Sylphiette666/stm32-rfid-smart-bin/README.md

# STM32与RFID积分式智能移动垃圾桶

嵌入式与RFID双课设的设计和实施资料。当前制作路线为**A1：单台低成本、复用已购模块和直插件，100×100mm裸PCB自行焊接**。主控为STM32F103C8T6，MCP23017成品扩展模块继续外置；一块PCB替代原PWR与IO两块洞洞板，模块按信号名接线。

## 从这里开始

1. [下载图解增强版Word手册](docs/manual/STM32%E4%B8%8ERFID%E6%99%BA%E8%83%BD%E7%A7%BB%E5%8A%A8%E5%9E%83%E5%9C%BE%E6%A1%B6_%E9%80%90%E6%AD%A5%E7%BB%84%E8%A3%85%E4%B8%8E%E8%B0%83%E8%AF%95%E5%AE%9E%E6%96%BD%E6%89%8B%E5%86%8C_%E5%9B%BE%E8%A7%A3%E5%A2%9E%E5%BC%BA%E7%89%88.docx)：保留330个步骤、33项功能；第62章为木板/PVC裁剪图，第63章和图45—49为当前A1 PCB、板外供电、模块接口及条件适配补充。第64章新增四套技能审查结论与接地加强后的调试要求。SG90与历史洞洞板图仍保留。[原版手册](docs/manual/STM32%E4%B8%8ERFID%E6%99%BA%E8%83%BD%E7%A7%BB%E5%8A%A8%E5%9E%83%E5%9C%BE%E6%A1%B6_%E9%80%90%E6%AD%A5%E7%BB%84%E8%A3%85%E4%B8%8E%E8%B0%83%E8%AF%95%E5%AE%9E%E6%96%BD%E6%89%8B%E5%86%8C.docx)保留。
2. [在线阅读全部步骤](docs/manual/ASSEMBLY.md)：按顺序检查、装配和调试，原330步不重编；图解以同名Word最新版为准。
3. [查看当前A1 PCB资料](hardware/current-low-cost/pcb-a/README.md)、[接线说明](hardware/current-low-cost/WIRING.md)、[逐针接口表](hardware/current-low-cost/pcb-a/connector-map.csv)、[BOM](hardware/current-low-cost/pcb-a/manufacturing/bom.csv)和[33项功能验收清单](docs/ACCEPTANCE.md)。裸板制造文件为[Gerber_RS274X.zip](hardware/current-low-cost/pcb-a/manufacturing/Gerber_RS274X.zip)，原理图及工程在[kicad目录](hardware/current-low-cost/pcb-a/kicad/)。
4. [查看SG90等图解与说明](docs/manual/illustrated-additions-20261010/)和[木板与PVC裁剪图解](docs/manual/cutting-diagrams-20261010/)；[旧PWR/IO洞洞板正反面与逐根焊线表](hardware/current-low-cost/perfboard/)仅作归档参考，不再作为A1 PCB施工接口。
5. [打开A1固件与调试说明](firmware/a1/README.md)：开发环境已确定为Keil，编译、下载及调试均在Keil完成，无需安装CubeMX、CubeIDE或CubeProgrammer。已提供工程和烧录文件；先按[实验室集中检查清单](firmware/a1/LAB_CHECKLIST.md)核对硬件，再逐模块上电调试。Word中旧软件路线以此说明和在线手册第37章为准。
6. 当前1号P2S继续昨天第二盘的上平台、舵机支架和喇叭圈。其余四台使用[底座带模块标牌版](hardware/mechanical/print-backup/labeled-bases-20261101/README.md)：两片底板仍可沿用，4/5号两盘精细附件更新为带标牌版，约5小时17分/5小时34分；新增任务同时开打约5小时34分完成，共387g PLA。11个待打印底座加名称，上盖和活动件保持；同名Word66.9节及图解63为当前说明。已切片，未实物试装。

本次接地加强版新增55个GND过孔，不增加元件采购或手焊任务；裸板制造检查通过，仍保留EMC及实物验证边界。详见[四套技能联合审查报告](hardware/current-low-cost/pcb-a/review/four-skills/四套技能联合审查报告.md)。

## 目录

[查看成品外观概念图](docs/appearance/README.md)（合盖与开盖两种状态，非实物照片）。

| 目录 | 内容 |
| --- | --- |
| `docs/manual/` | 原版及最新同名图解增强版Word、330步阅读版、内容源与图解生成源 |
| `docs/manual/illustrated-additions-20261010/` | 本轮SG90等新增图解及整合说明 |
| `docs/manual/cutting-diagrams-20261010/` | 木板/PVC五幅裁剪图、图源、孔位说明及检查记录 |
| `docs/planning/` | 功能成本选型、33项功能机械设计及功能数据 |
| `docs/appearance/` | 成品外观概念图及生成说明 |
| `hardware/mechanical/print-backup/` | PLA整片轻量模型、原5mm厚板备选、P2S打印方向、STEP源和几何检查 |
| `hardware/current-low-cost/` | 当前A1方案的边界、接线说明与归档入口 |
| `hardware/current-low-cost/pcb-a/` | 100×100mm裸PCB、原理图、制造Gerber、BOM和逐针接口表 |
| `hardware/current-low-cost/perfboard/` | 归档：原PWR与IO两块洞洞板正反面、孔位、逐根焊线表及外接说明 |
| `hardware/archive/pcb-v2.1/` | 旧PCF8574方案的嘉立创工程、KiCad、Gerber、BOM和贴片坐标 |
| `firmware/a1/` | A1应用固件、Keil工程、四组主机C测试、发布文件和集中调试说明 |
| `firmware/legacy/` | 保留的STM32/CMSIS基础文件 |
| `archive/` | 较早手册、采购表及折叠内胆参考图 |

## 当前状态与版本边界

- 已整理设计、采购、装配、接线、软件实施步骤和验收方法；文档步骤不代表已完成实物验证。
- 2026-10-13已实现A1应用固件，并通过编译与主机模拟测试；**没有完成实物烧录、标定和整机验收**。默认关闭电机/舵机动作，硬件型号与极性须确认；使用方式见`firmware/a1/README.md`。
- A1继续使用MCP23017成品模块与原MCU功能映射，复用已购器件；AO3400A裸管仍须焊转接板。新PCB只有JP3—JP10共8组跳帽，没有JP1/JP2。旧洞洞板接口及PCF8574 V2.1 PCB均不能混用。
- 当前电气制作基线为2026年10月12日A1 PCB补充；原330步的功能、机械装配和验收顺序保留。PCB的设计检查及制造文件不等于实物焊接、通电或33项功能验收已完成。
- 仓库内没有上传账户凭据、订单截图、渲染缓存、临时锁文件或工具依赖目录。

## 更新方式

后续每次增加图解，都加入同名图解增强版Word，更新目录并渲染检查排版，再替换本地与仓库中的同名版本；同步相关接线说明、图片和校验清单后，提交并推送到本仓库。原330个步骤保持编号。实测记录请写日期、硬件版本、固件提交号、测试条件和结果；未完成检查或实测的项目不能写成已完成。

初始归档日期：2026-10-10。文件校验值见[MANIFEST.sha256](MANIFEST.sha256)。第三方资料说明见[THIRD_PARTY.md](THIRD_PARTY.md)。
