Sylphiette666/stm32-rfid-smart-bin/hardware/current-low-cost/pcb-a/electrical-design.md

# SmartBin 方案 A：低成本直插 PCB 电气设计规范

版本：2026-10-12 A1。用户选择裸 PCB、复用已购直插件、自行焊接。本文仅定义电气连接和装配条件；原理图、PCB 的 ERC/DRC、制造文件和实物通电验收由相应阶段记录，不以本说明代替。

## 1. 架构与交付边界

将原 PWR、IO 两块 7×9 cm 独立焊盘板合并为一块目标 100×100 mm、双层、1.6 mm、1 oz 铜板。保留当前 MCP23017 成品扩展模块方案的全部 33 项功能和 29 个 STM32 GPIO 分配。不是历史 PCF8574 V2.1 PCB 的修改版。

板上保留原 44 件电气器件：32 电阻、8 电容、3 只 2N3904、1 只 SN74AHCT125N；增加 MODE、BACK、编码器 SW、蜂鸣复位偏置所需的 5 个 10 kΩ 焊位。R36/R37 互斥，最多新增实装 4 只电阻。共有 49 个电气焊位、33 组外接接口（6 组电源端子、27 组信号排针）、8 组选择/测试排针、4 个 M3 安装孔，共 94 个位号。它们都是板端自定义接口，不是任何商品模块的直插插座。

AHCT 第 3 通道改为输入永久接 PB9、使能永久接地，JP3 选择直驱 PB9 或 5 V 缓冲输出；原洞洞板的五拆六增不适用于本新 PCB。第 4 通道仍按输入接地、使能接 5 V、输出悬空处理。JP1/JP2 位号保留空缺，避免后续接口重编号。

核心板、MCP23017、RC522、FLASH、MPU6050、OLED、TB6612、DC/DC、3.3 V 稳压模块、HC05、DFPlayer、各传感器仍外置。AO3400A 是已购裸管，须先焊到转接板、核对 G/S/D 并检查无连锡，再经 J28 接入；已采购不表示已焊接完成。条件 5 V 数字输入适配和 DHT 的 BSS138 成品转换模块仍外置，不扩大本板为新的模块集成设计。

100×100 mm 是可行的布局目标：省掉两板之间的排线，较大的 5 V 数字适配电路不在本板。仍须在布局中验证 12.5 mm 电解外廓、端子操作空间、排针标签、安装孔和走线；未完成布局检查前不把板框目标写成已完成制造尺寸。

## 2. 电源、线径与电流边界

电源树：带保护 2S 18650 电池组 → 板外 5×20 保险座（3 A 初选）→ 板外总开关 → J1 BAT_SW → J2 外置降压输入；降压输出调到 5.00 V 后由 J3 回板，分别直接分到 J4 MOTOR、J5 SERVO、J6 LOGIC。J4/J5/J6 的正极同属 5V_BUS，物理上分支，不通过别的负载接口串供。地共用，但电机和舵机的大电流回流不能串经核心或信号地线。

1. 电池满电 8.4 V；正常控制在低电阈值以上使用，≤7.0 V 持续 3 s 提醒，≤6.6 V 持续 1 s 锁停，≤6.0 V 在当前有效 ADC 采样确认后立即停。恢复到 ≥7.0 V、人工确认并收到新命令才可运动。
2. 电池组持续能力至少 5 A；5 V 降压须在实际 6.6–8.4 V 输入、实际散热条件下达到 3 A 持续、至少 4 A 短时峰值。不能把广告峰值当持续能力。
3. 两只电机在 5 V 下各自堵转电流必须 ≤1 A，合计预算 2 A；SG90 瞬态预算 2 A。电机运动与开盖动作分时互锁，不能把双轮堵转和舵机卡死作为正常并发工况。逻辑、红外、照明及受控音量语音总预算 0.5 A（5 V 等效）。最重正常模式约 2.5 A，留 20% 裕量得到 3 A。若实测逻辑/音频超过预算，降低音量、限制并发或升级电源，不能只加电容。
4. 外置 3.3 V 模块按原清单至少 200 mA，但这是最低选型值而非全系统已验证值。按实物模块逐项量电流，含 ≥20% 余量必须小于其可持续能力；不够时用合格的 ≥300 mA 模块。3V3_EXT 只供外设和相应上拉，3V3_CORE 是核心自身稳压输出，只作核心参考及规定的上拉。两者不能直接并联。
5. 电池、降压主线用 20 AWG 短线；电机、舵机支路 22 AWG 短线，较长或压降偏大时用 20 AWG。电池/降压主干、电机 VM 与电机输出、舵机电源和地、喇叭电流均不能走普通杜邦线。DFPlayer 电源从 J6 用适当线径独立引出，J31 只走信号。
6. 电路板主干初始约束 3 mm、支路 2 mm 铜宽由布局设计实现，并须校核整条电流路径、过孔、热焊盘及铜厚；不要把走线宽度单一数值当无限流额定值。端子电流能力、焊接孔与接触质量同时限制能力。

J7 是外置 3.3 V 稳压模块的低电流接口：1=5V_BUS 输入给模块，2=GND，3=模块 3.3 V 输出回板。J8 的核心 5 V 从本板获得。完整装配正常使用禁止插核心 USB；若要做独立 USB 台架，先断本板电源并移除核心与本板相连的全部线束。USB 转串口仅接 J18 的 GND/RX/TX，不接转换器供电脚。SWD 直接接核心 PA13/PA14/GND；仅当调试器明确有独立 VTref 输入时按说明接核心 3V3，不并接调试器的电源输出。

## 3. 保护、默认状态和已知边界

### 3.1 三管急停

Q1/Q2/Q3 均按 2N3904 的 1=E、2=B、3=C 定义。两 NC 接点上端取总开关后的 VBAT_SW，各自通过 4.7 kΩ 驱动 Q1、Q3 基极，下拉均 100 kΩ。6.0 V 时接点闭合电流估计 (6.0−0.7)/4.7k≈1.13 mA，8.4 V 时约 1.64 mA；应核实所购接点的最小适用负载确实覆盖该电压、电流，不能把所有工业急停按钮都视为适用微电流。

正常 NC1 闭合，Q1 导通拉低 KILL_BASE，使 Q2 截止；PB5 经 R21=1 kΩ 驱动 STBY_OUT，R23=10 kΩ 下拉，理想未计驱动输入负载时 STBY≈3.0 V。按下急停或 NC1 断线后，Q1 截止，R19 从 3V3_EXT 给 Q2 基极偏置，Q2 拉低 STBY。PB13 则由 Q3 和独立 NC2 检测：正常低、按下或断线高，PB13 只上拉到 3V3_CORE。

必须保留 R21 限流和 PB5/STBY 的各自 10 kΩ 下拉，禁止另跨线 PB5→STBY。硬件验收包括强制 PB5 为高同时保持急停按下，STBY_OUT 仍小于 0.3 V；正常释放且 PB5=1 时大于 2.7 V；PB5=0 时小于 0.3 V。先架空电机进行，急停释放不得自动重启。

这套复用三管电路的 Q2 偏置依赖 3V3_EXT。若 EXT 失电、核心却仍有电并继续输出高，不能宣称具有完整的电源故障失效安全；驱动逻辑端也存在反向供电风险。正常整机供电必须同启同停，EXT 未建立或丢失时不得驱动外设信号高，整机异常使用总开关切电。本板保留现有课设接口的边界，没有把它描述成认证工业安全回路。

### 3.2 ADC、ECHO、电平与复位

电池 ADC：R1=33 kΩ、R2=10 kΩ（均1%）、C7=100 nF；BAT_ADC_DIV 经 JP9 接 PA1。8.4 V 对应约 1.953 V，输入等效电阻约 7.67 kΩ，C7 形成约 0.77 ms 时间常数。使用较长 ADC 采样时间并按实际 Vref 校准。若电池仍接通而要单独关闭/拔掉核心电源，先拔 JP9，避免从 ADC 向掉电核心注入；本电路不保证任意上电时序下完全无注入。

HC-SR04：U1 通道 2 将 PB15 TRIG 转为 5 V；ECHO_RAW 经 R25=12 kΩ 上臂、R26=20 kΩ 下臂到 PB1，5.00 V 输入约 3.125 V。PB1 不是原始 5 V ECHO，不能另跨线直连。建议两只均用 1%；5.15 V 电源且1%极端分压误差时约3.243 V，应结合实际核心VDD核查。

MCP RESET 经 R10 拉到 3V3_EXT，JP10 短接地用于临时复位，正常开路，不与核心 NRST 相连。MCU 每次启动都重新初始化 MCP 寄存器。MCP23017 当前数据手册规定 GPA7/GPB7 仅输出，本板不引出这两脚，软件设输出低。其他脚复位默认输入；启动期间 PB5 下拉和 STBY 下拉保持电机禁用，先写输出锁存器再配置方向，最后才允许运动。

## 4. 接口适配与跳帽规则

每个三针选择端子只能放一只跳帽，禁止同时短 1–2 和 2–3。初次通电先不接模块，测中心脚电压再连线。标签中的 5V_BUS 与3V3_EXT 是不同供电网；连接模块时按功能逐线对应，不能按某张商品照片直接整排套接。

| 位置 | 默认/条件 | 规则 |
|---|---|---|
| JP3 蜂鸣信号 | 默认开 | 模块兼容3.3V控制用1–2，确需5V控制用2–3；U1通道3同相，不改变有效极性。 |
| JP4 蜂鸣供电 | 默认开 | 1–2为3V3_EXT；2–3为5V_BUS，按模块额定电源。 |
| JP5 MPU供电 | 默认开 | 1–2为3V3，2–3为5V。模块VIN带稳压时可能要5V，但I2C仍必须3.3V。 |
| JP6 HC05供电 | 默认开 | 带稳压底板与裸模块不同；串口逻辑必须3.3V。 |
| JP7 DHT供电 | 默认开 | 1–2为3.3V，2–3为5V。 |
| JP8 DHT直连 | 默认开 | 仅3.3V且DATA安全分支闭合；5V分支始终开并装J23外置BSS138。 |
| JP9 ADC连接 | 默认闭合 | 正常使用闭合；核心单独断电前拔开。 |
| JP10 MCP复位 | 默认开 | 只作临时复位短接，不能长期留帽。 |

R36 默认安装为 PB9 的10 kΩ 下拉，R37 默认不装。高有效蜂鸣保留此配置；低有效蜂鸣先拆 R36 再装 R37，拉到 3V3_CORE。即便不接蜂鸣模块，也保留其中一只偏置，防 AHCT 的第3通道输入浮空。裸两脚蜂鸣器不能直接接 J30 当成带驱动三线模块。

### 4.1 I2C、SPI与编码器

I2C 同时连 MCP、OLED、MPU；地址必须实际扫描，MCP模块A0/A1/A2接地预期0x20。R8/R9为可选4.7 kΩ上拉位，默认 DNP 不代表允许总线无上拉：若所有模块均无上拉，必须装；若模块已有上拉，要核算并联等效值、总线电容和上升时间。任何上拉只到3V3_EXT，不得保留5V上拉。起步100 kHz。MPU侧INT等未使用脚按实际模块资料处理。

RC522与FLASH共享PA5/PA6/PA7，PA4与PA15分别片选，并各有10 kΩ上拉。RC522的SDA丝印在SPI工作模式表示CS；不能接PB7。FLASH的WP/HOLD仅在实际外露且缺少同轨上拉时装R13/R14。核选中/未选中时MISO释放；有始终驱动MISO的模块不能直接共总线。SPI线先控制在20 cm以内并从低速调通。所有这些模块均按确认的3.3V版本使用。

编码器CLK/DT有两种互斥配置：移除模块原上拉后安装R27/R28拉CORE；或保留模块已确认拉EXT的上拉、R27/R28 DNP。不得让同一信号同时由两个稳压轨的电阻上拉。SW由R33或模块同轨上拉/已验证MCP内部上拉提供确定高电平。MODE/BACK默认装R34/R35，各接地按下，均低有效。碰撞用两NC串联；闭盖用NO接点，只占其规定GPIO。

### 4.2 六路红外、DF BUSY和光敏

J33 的六路数字输入分别为循迹左/中/右、靠近、前方障碍、投放对射。接口没有板载5V容限转换。允许的三种情况：

1. 已验证0/3.3V推挽输出：直接接目标输入和共地。
2. 无任何5V上拉的开集/开漏：外加10 kΩ到3V3_EXT，接目标输入。
3. 5V推挽或板内已有5V上拉：外置适配，DO→10 kΩ→2N3904 B，B→100 kΩ→GND，E→GND，C→目标输入，C→10 kΩ→3V3_EXT。输出反相，软件标定有效电平必须同步。每个不满足电平的通道各自适配，不能把多个DO相互并接。

DFPlayer BUSY接MCP GPA6，也要按相同原则测量和适配。已有单路寻迹模块只能作备用或逐个台架验证，不能与成品三路DO并接。光敏默认用3.3V模拟AO接PB0；若采用5V AO，须另行设计与校准模拟分压，不能套NPN开关电路。热敏模块仅作为断开光敏后的替换实验，不额外并占PB0。

### 4.3 DHT、LED与声频

DHT3.3V直接分支：JP7=1–2、JP8闭合；PB11开漏，R29或模块已有同轨上拉有效。DHT5V分支：JP7=2–3、JP8开路，J23分别连BSS138的LV=EXT、HV=5V、GND、低压通道=PB11、高压通道=DHT_DATA_RAW。不能用单向NPN替代双向DHT数据线，也不能把5V DATA经跳帽直接接PB11。

LED支路：MCP GPA5→R3=100Ω→J28.G，R4=100kΩ将栅极拉地；J28.S接GND，J28.D接LED_NEG；5V→R5=220Ω→LED正极，LED负极→LED_NEG。按AO3400A实际G/S/D追踪转接板，不按其排针外观猜；仅驱动单颗小功率白LED，不接电机或舵机。

DFPlayer RX由PB10经R30=1kΩ输入，模块TX不接；PB11已用于DHT，固件USART3只开TX。DFPlayer的SPK1/SPK2直接接扬声器，不接地。模块旁仍需100μF+100nF本地去耦；MCP模块旁确认100nF；两只电机两端分别确认100nF抑制电容。这些远端就地件没有因为PCB已有电容而取消。

## 5. 封装与采购复用

所有R用已购1/4W轴向件，板上10.16 mm脚距，目标本体不大于6.3×2.5 mm；R1/R2/R25/R26用1%。Q1–Q3按onsemi当前资料的1E2B3C逻辑匹配TO-92宽脚距封装；其它品牌2N3904仍必须核对脚序，不能按“平面对自己”的口诀替代数据手册。

U1是SN74AHCT125N及7.62 mm DIP14座，不用74HC125。电解统一预留最大直径12.5 mm和5 mm脚距；实物脚距不符可短绝缘飞线并独立机械固定，不能让电容悬挂摇晃。5个100nF位采用径向瓷片5 mm脚距，实际弯脚不得损伤根部。

六组端子为2P、5.08 mm，目标外壳包络11.5×10.5 mm；采用可用的Phoenix同脚距库封装是几何模板，不承诺所有KF301外壳/引脚都一致。根布局需核实际孔径、脚型与外壳，端子朝板外留接线和螺丝刀空间。27组信号排针加8组跳帽排针共169针，可按长度裁切已有2.54 mm排针，留备品；杜邦线按每根功能标签接。8组选择/测试排针不等于全部装8只帽，JP10正常不留帽。

4个M3孔直径3.2 mm，中心(5,5)、(95,5)、(5,95)、(95,95)，以100×100 mm板左上为布局基准。安装柱和螺钉与铜箔保持净距，板底有绝缘与足够间隙。

## 6. 装配与分段验收

1. 不插U1、不接模块；按位号装固定电阻、二极性无关的小电容、芯片座、三极管、端子排针，最后装较高电解。逐只确认值、极性、脚序和DNP。
2. 万用表查5V/GND、VBAT/GND、EXT/GND无持续短路；CORE/EXT无直接导通；电解充电瞬间提示与持续短路区分。检查JP3–JP8当前开路、JP9闭合、JP10开路；R36装、R37空。
3. 外置降压离板调5.00V，限流接J3，先只看板上静态电流和各电源口。连接3.3V模块确认EXT在3.20–3.40V且无异常升温。
4. 插U1前核座14脚5V、7脚地。插芯片后用3.3V逻辑信号逐路检查U1输入/输出：PA0与PB15低/高转换，PB9复位偏置确定；输出不得被错误跳帽接回别的输出。
5. 核心从教学底板拆下；按照J8/J9表逐线连。完整系统核心USB禁用，仅SWD及J18三线串口调试。先固件将PB5/PWM置低，再初始化MCP输出锁存器和方向。MCP位7明确输出0，不当输入。
6. 按模块数据实测供电、DO高电平、上拉和接口脚名；完成DNP/跳帽记录后一次接一个模块。所有输入上拉、电平转换和复位元件未满足时，不因PCB有插座就通电插上。
7. 分别在6.0、7.4、8.4V电池偏置条件测双NC和PB13；强制PB5高并按急停，STBY<0.3V；正常释放PB5高时STBY>2.7V；断NC1、断NC2分别记录。急停释放后软件不得恢复旧命令。
8. 从台架5V信号经ECHO端验证PB1≈3.125V；从8.4V验证PA1≈1.95V；只给电池不断核心供电的操作前先拔JP9。未经测量不能将这些计算值写成实测。
9. 先架空单轮低PWM验证两电机方向、停机、两NC碰撞、失联和倾斜；舵机拆杆空载50Hz/1500μs定位，确认独立供电。最后才上连杆、放地。电机和舵机动作互锁。
10. 按原330步骤功能测试表逐项验证，记录最低5V、各负载电流、温升、复位/误积分、无线超时与故障恢复。3V3掉电的边界不能只靠正常急停测试就宣布消失。

## 7. 冻结数据使用方式

`circuit.json` 的 `parts` 包括所有电气件、连接器、跳帽和机械孔；`pins` 是唯一用于绘图的编号→网络映射，未接的U1.11为null；机械孔pins为空。`pin_names`用于丝印/说明，可显示PB6而实际网络为I2C_SCL；不能据文字标签重新产生孤立PB6网。`original_ref`保留旧PWR/IO电气件对应关系。所有PCB位号唯一。

`connector-map.csv`按板端自定义针号列出目标模块信号。原理图和PCB应从同一份JSON生成并比较网络；不允许一边仍是旧44件位号、另一边拿新的R序号按记忆连线。DNP是装配选择，不代表删除铜连接；互斥选项必须在采购/装配记录中明确。

下表是当前电气件清单（含可选焊位）；芯片座、跳帽、外置模块、保险和线材另计。

| 类别/值 | 焊位数 | 位号 |
|---|---:|---|
| electrolytic / 470uF/16V | 1 | C1 |
| electrolytic / 1000uF/16V | 1 | C2 |
| electrolytic / 100uF/16V | 1 | C3 |
| capacitor / 100nF | 5 | C4, C5, C6, C7, C8 |
| resistor / 33k | 1 | R1 |
| resistor / 10k | 20 | R2, R6, R7, R10, R11, R12, R13, R14, R22, R23, R24, R27, R28, R31, R32, R33, R34, R35, R36, R37 |
| resistor / 100 | 1 | R3 |
| resistor / 100k | 4 | R4, R16, R18, R20 |
| resistor / 220 | 1 | R5 |
| logic / SN74AHCT125N | 1 | U1 |
| resistor / 4.7k | 6 | R8, R9, R15, R17, R19, R29 |
| resistor / 1k | 2 | R21, R30 |
| resistor / 12k | 1 | R25 |
| resistor / 20k | 1 | R26 |
| npn / 2N3904 | 3 | Q1, Q2, Q3 |

默认DNP：R8, R9, R13, R14, R27, R28, R29, R33, R37。这些位置须按上文条件决定安装；特别是I2C、DHT不能省掉所需有效上拉。

## 8. MCU功能映射

| GPIO | 功能 | 资源/约束 |
|---|---|---|
| PA0 | 舵机PWM | TIM2_CH1；AHCT通道1 |
| PA1 | 电池电压 | ADC1_IN1；JP9可隔离 |
| PA2 | 蓝牙TX | USART2 TX→HC05 RX |
| PA3 | 蓝牙RX | USART2 RX←HC05 TX |
| PA4 | RC522片选 | SPI1 CS，模块SDA即CS |
| PA5 | 共享SCK | SPI1 SCK |
| PA6 | 共享MISO | SPI1 MISO |
| PA7 | 共享MOSI | SPI1 MOSI |
| PA8 | 左电机PWM | TIM1_CH1，20kHz |
| PA9 | 调试串口TX | USART1 TX→转换器RXD |
| PA10 | 调试串口RX | USART1 RX←转换器TXD |
| PA11 | 右电机PWM | TIM1_CH4，20kHz；禁USB |
| PA12 | 投放光束输入 | 1ms轮询；不可用EXTI12；禁USB并核核心板USB上拉 |
| PA15 | FLASH片选 | 禁JTAG保留SWD后作GPIO |
| PB0 | 光敏AO/DO | ADC1_IN8或数字输入二选一 |
| PB1 | 超声ECHO | EXTI1双边沿，12k/20k分压后 |
| PB3 | 编码器CLK | 禁JTAG保留SWD；轮询/EXTI3 |
| PB4 | 编码器DT | 禁JTAG保留SWD；轮询/EXTI4 |
| PB5 | 电机使能请求 | 经R21和Q2门控；不能直连STBY |
| PB6 | I2C SCL | I2C1默认映射、开漏 |
| PB7 | I2C SDA | I2C1默认映射、开漏 |
| PB8 | 前方避障 | 外置条件电平适配 |
| PB9 | 蜂鸣器 | GPIO/TIM4_CH4，按模块不响电平偏置 |
| PB10 | 语音TX | USART3 TX，经1k；禁USART3 RX |
| PB11 | DHT数据 | 开漏+EXT上拉；EXTI11可用 |
| PB12 | 碰撞回路 | EXTI12，两NC串联，正常低 |
| PB13 | 急停反馈 | EXTI13，正常低，按下/断线高 |
| PB14 | 闭盖反馈 | NO微动，闭盖低 |
| PB15 | 超声TRIG | 普通GPIO→AHCT通道2 |

PA13/PA14保留SWD，PB2保留BOOT1，PC13/PC14/PC15及NRST不新分配；PA15/PB3/PB4需关闭JTAG并保留SWD。TIM1两通道同频电机PWM，TIM2_CH1独立50Hz舵机；TIM4_CH4用于无源模块蜂鸣时，不占I2C所用PB6/PB7。PA12采用轮询，EXTI12仅PB12。

## 9. 功能覆盖与证据

- A1：RC522/STM32 UID识别。
- A2：RC522+FLASH 注册/删除/挂失。
- A3：RC522+对射+FLASH有效投放积分。
- A4：FLASH持久化。
- A5：RC522+OLED积分查询。
- A6：RC522 RFID读写实验。
- A7：管理员卡+菜单。
- A8：FLASH日志/排名+串口导出。
- A9：FLASH虚拟兑换。
- B1：RC522+SG90刷卡开盖。
- B2：对射投放检测。
- B3：对射+状态机防重复积分。
- B4：靠近红外+SG90便民开盖。
- B5：HC-SR04满桶检测。
- B8：菜单维护清理模式。
- C1：TB6612+双减速电机差速。
- C2：前红外避障。
- C3：三路循迹。
- C4：循迹站点识别。
- C6：HC05蓝牙手动。
- C8：MPU6050倾斜保护。
- C9：双NC碰撞停车。
- D1：OLED人机显示。
- D2：蜂鸣器提醒。
- D3：MODE/BACK按键。
- D4：编码器旋转/按下。
- D5：双NC急停。
- D6：上电自检。
- D7：ADC电量监测。
- D8：USB串口日志/配置。
- E1：DHT温湿度。
- E2：光敏+LED自动照明。
- E4：DFPlayer语音。

上述为功能所需硬件覆盖，不表示固件已经实现。记录基于当前WIRING、原两板layout.json和330步骤ASSEMBLY；已有44件保留、29IO分配、33功能、唯一位号、位7不引出和I2C别名连通已作结构检查。封装适配、ERC、PCB DRC、制造性、实物及软件测试分别记录，不相互代替。

- 当前低成本 WIRING.md：D:\Work\嵌入式课设\stm32-rfid-smart-bin\hardware\current-low-cost\WIRING.md
- 原两板结构化布局：D:\Work\嵌入式课设\stm32-rfid-smart-bin\hardware\current-low-cost\perfboard\layout.json
- 330步骤手册源：D:\Work\嵌入式课设\stm32-rfid-smart-bin\docs\manual\ASSEMBLY.md
- TI SN74AHCT125 datasheet：https://www.ti.com/lit/ds/symlink/sn74ahct125.pdf
- onsemi 2N3904 Rev3 / TO92 1E2B3C：https://www.onsemi.com/pdf/datasheet/2n3904-d.pdf
- Microchip MCP23017 DS20001952D（GPA7/GPB7仅输出）：https://ww1.microchip.com/downloads/aemDocuments/documents/APID/ProductDocuments/DataSheets/MCP23017-Data-Sheet-DS20001952.pdf
