Sylphiette666/stm32-rfid-smart-bin/hardware/current-low-cost/pcb-a/manufacturing/drill-report.txt

Drill report for SmartBin_A.kicad_pcb
Created on 2026-10-12T19:15:20

Copper Layer Stackup:
    =============================================================
    L1 :  F.Cu                      front
    L2 :  B.Cu                      back

Drill file 'SmartBin_A-PTH.drl' contains
    plated through holes:
    =============================================================
    T1  0.400mm  0.0157"  (117 holes))
    T2  0.800mm  0.0315"  (107 holes))
    T3  1.000mm  0.0394"  (169 holes))
    T4  1.200mm  0.0472"  (6 holes))
    T5  1.300mm  0.0512"  (12 holes))

    Total plated holes count 411

Drill file 'SmartBin_A-NPTH.drl' contains
    unplated through holes:
    =============================================================
    T1  3.200mm  0.1260"  (4 holes))

    Total unplated holes count 4
