Sylphiette666/stm32-rfid-smart-bin/hardware/mechanical/print-backup/mounted-20261031/checks/HARDWARE_REVIEW.md

# 新增模块固定件硬件清单

本表只计算本次新增模块夹具，不含原车架立柱、舵机及其余原装螺丝。螺钉长度均为头下长度，M3 使用普通粗牙 0.5mm 螺距。喇叭两耳的紧固方案仍需实物耳高确认。

所有M3螺钉均按ISO7380低圆头最大外径5.7mm、头高1.65mm审核，特别是9根铰链轴、22根座脚及2根降压载座螺钉，不可换成头高约3mm的圆柱头。铰链R3.4避空按此头型轴向长度设计，任意M3头型不保证能翻动。

| 规格 | 数量 | 用途 |
|---|---:|---|
| M3×6 | 4 | A1 PCB 上方固定到10mm绝缘双通柱 |
| M3×10 | 4 | 从底板下方固定 A1 绝缘柱 |
| M3×12，ISO7380低圆头，高1.65mm | 22 | 9个模块座18颗、电池座4颗 |
| M3×16，ISO7380低圆头，高1.65mm | 2 | 降压模块独立载座固定到底板 |
| M3×25 | 10 | M03/M04/M07/M08/M09，各1根拨片轴和1根簧片锚钉 |
| M3×30，ISO7380低圆头 | 13 | 9个铰链、M05轴和锚各1根、喇叭2根暂定 |
| M3×40 | 10 | M01/M02/M06、电池左锁和右锁，各轴和锚1根 |
| M2.5×8 | 2 | 5V降压模块两个真正安装孔，不加垫圈 |
| M3普通六角螺母，高2.4mm | 24 | 22个座脚、电池座脚；另2个喇叭耳下调高 |
| M3 DIN985锁紧螺母，高4mm | 35 | 9铰链、22轴/锚、2降压座、2喇叭耳上 |
| M2.5普通六角螺母，对边5mm、高2mm | 2 | 降压载座底部预埋六角窝 |
| M3平垫圈，内径3.2、外径≤6、厚约0.5mm | 124 | 配套数量，未计备用 |
| M3绝缘双通柱，柱身10mm | 4 | A1 PCB四个90×90mm孔距 |

名义合计67根螺钉，其中M3为65根；喇叭相关2根暂定。垫圈按座脚44、铰链18、轴/锚44、降压座4、A1上下8、喇叭6计算。使用0.55mm厚小垫圈时，轴/锚选定标准长度仍适用；M3×40最高轴组的余量较小，遇高于4mm的锁母应重新核算长度。

## 装配方向

- 22个座脚：低圆头在座脚上方，座脚厚2.4mm；头下1片垫圈，底板下1片垫圈和普通六角螺母。M3×12按普通高2.4mm螺母计算，不能直接换高4mm锁母。头高1.65加0.5垫圈，总凸出2.15mm，低座压框下名义仍留0.25mm。
- 降压载座两颗M3×16：低圆头在3.2mm载座上方，锁母在5mm底板下面。高圆柱头或把锁母放到载座上方会侵入PCB下方间隙。
- 11根拨片轴、11根簧片锚：头和一片垫圈在5mm底板下面，另一片垫圈和锁母在上方。轴顶部留约0.1–0.2mm转动间隙；簧片锚钉固定6×6mm方头，不能压住12mm自由弹臂。
- 簧片头上必须用外径不超过6mm的小垫圈。不要在拨片与轴座之间另加普通圆垫圈，它会盖住半径2.8mm处的定位凸点。
- 9根铰链：中央三节耳总跨23mm，两端各一片小垫圈，M3×30配锁母。只消除多余轴向窜动，保持压框自由翻动。盖已为螺头和锁母做R3.4包络避空。
- M2.5螺母先放入降压座底部六角窝，再把载座固定到底板。M2.5×8不加垫圈，名义有效吃牙约1.8–2mm；换10mm会顶到底板，不能强拧。
- A1柱下M3×10名义入柱4.5mm，柱上M3×6经1.6mm PCB和垫圈后入柱3.9mm。先确认所用双通柱两端孔深。

## 必须用实物核对的项目

数字检查使用ISO7380头Ø5.7×1.65、垫圈Ø6×0.5、锁母Ø6.4×4包络，结果见同目录 hardware_review.json；它不能替代实物试装。

1. 0.8mm角点压边是否碰到实际排针塑壳、焊点或元件；USB线尾、SWD插头、TF弹出行程、插好杜邦线后的弯线空间尚未量到。背针尖距底板的名义余量：MCU/MCP 11mm、DFPlayer 12mm、稳压模块5mm。
2. A1已知含正反面总高度28mm，但未给正反面高度分配；10mm绝缘柱是否让开全部底面焊脚仍需实物核对。
3. 喇叭耳下表面距底板顶面的高度记作E、耳厚记作t。选定垫圈和锁母下，M3×30须满足E+t≤19mm；先让耳下螺母刚好接触耳片，再锁上方，不能压弯耳片。若为垫下螺母而抬高壳体并脱离2mm高定位唇，应停止强装并测耳高。
4. 电池名义76×40×20，托槽77.2×41.2，2mm EVA后顶面距底板顶面24.4，拨片底面24.6，留0.2限位余量。拨片只挡硬塑壳端边，不能压电芯。实际外皮误差、EVA压缩和端边形状需试合。
5. 电池右端导线从中央12mm开口偏负Y半边引出；建议线束位于电池中心局部Y=-5..+1mm走廊，避开右拨片整个旋转范围。开关两拨片时全程不接触导线后再固定走线。

尚未完成实物打印、承重、振动或耐久试验。夹具几何及紧固件包络通过，只表示数字装配检查通过。

标准外形核对来源：[ISO7380 M3低圆头尺寸](https://www.accu.co.uk/socket-button-screws/8104-SSB-M3-12-A2)、[DIN985 M3锁母尺寸](https://www.accu.co.uk/hexagon-nylon-locking-nuts/495536-HNN-M3-0-5-C8-Z)、[ISO7092 M3小外径垫圈](https://www.accu.co.uk/metric-flat-washers/629061-HRDW-M3-6-0-A4-BL)。以上用于尺寸核对，不是购买或库存推荐。
