Sylphiette666/stm32-rfid-smart-bin/hardware/current-low-cost/pcb-a/review/schematic/REVIEW.md

# SmartBin A 原理图审查

日期：2026-10-12。工具：KiCad CLI 10.0.6；项目独立的 kicad-tool 扩展；固定版本 mash/kiutils 结构化对象。

## 交付内容

- 顶层索引与 5 个功能子页，共 6 页 A3 原理图。
- 94 个真实位号，包含 4 个机械孔及 DNP 条件电阻。多单元 U1 共 5 个符号实例、1 个物料位号。
- 自包含 `SmartBin_A.kicad_sym` 与相对路径 `sym-lib-table`；标准器件使用电阻、电容、BJT、缓冲门等实际符号。
- 每个元件的稳定层级 UUID 路径记录在 `schematic_paths.json`，供 PCB 关联。

## 电气一致性

- 原理图由 `circuit.json` 创建，但验证对象是 KiCad 实际导出的 XML 网表。
- 逐一比对 293 个连接引脚与 1 个明确 NC 引脚，通过；94 位号完整。
- U1.11 的显式 NC 在 XML 中仍有 KiCad 自动生成的独立 `unconnected-...` 网络，不应接任何走线。
- ERC：0 错误、0 警告。没有通过排除具体违规项来清零。
- ERC 原有默认忽略项记录在 JSON：单次全局标签、四向交点、SPICE 模型、封装过滤器。未把 ERC 当成器件参数验证、软件验证或实物验证。

## 图面检查

- 已逐页渲染并查看 PDF，放大核对 AHCT 门图形、型号与位号、连接器针号、电容极性、顶层页框标题。
- 调整了旋转电容/电阻的文字方向、AHCT 标题高度、顶层页框标题左对齐。
- 上游 `sch inspect` 在全部 6 页的文字冲突数均为 0，没有斜线。
- 自动评分仍报告 22 个 symbol-wire conflict（电源页 13、三极管页 3、AHCT 页 6）。这些是符号框估算将电容引脚端点、BJT 引脚、AHCT 多单元合并包围框计为交叠；已按实际渲染复核，并未为了评分移动/断开真实引脚连接。此项不作为 ERC 错误。
- 6 页采用同名全局网络连接；这些标签在整个工程内电气相连，不是仅作注释的文字。

## 边界

此审查覆盖原理图与输入连接表的一致性和图面。PCB 布线、铜厚载流、制造 Gerber、实际模块针序与上电测试仍由相应阶段独立验证。
