Sylphiette666/stm32-rfid-smart-bin/firmware/a1/LAB_CHECKLIST.md

# 集中借用万用表：A1固件调试记录

固件：A1-0.1.0。以下是待执行清单，空格必须由实物操作者填写；不能以软件模拟代替。

## 出发前

- [ ] 带电脑、整个固件目录、下载器、USB串口、可传数据USB线。
- [ ] 带焊好的A1板、所有外置模块、标好两端的线束、电源模块、电池、保险和开关。
- [ ] 带焊接返修工具、小螺丝刀、跳帽；打印/保存当前逐针表与本表。
- [ ] Keil打开`MDK/SmartBin_A1.uvprojx`并Rebuild成功；无需安装Cube系列工具。提前安装实际下载器驱动，按[说明](README.md#keil-下载与源码调试)设置Debug与Flash Download。
- [ ] 准备好串口终端，115200、8N1、换行。断点调试时保持DISARM并断开动力，CPU暂停不等于定时器停输出。
- [ ] 查清OLED控制器、FLASH丝印、晶振、每种模块电源和引脚资料。
- [ ] 第一次检查时电机、舵机功率支路保持断开。

## 第一次：电气和逻辑模块

断电：拔电池、所有USB及其他电源后测通断/电阻。带电只用直流电压档；红表笔应在VΩ孔，不能把电流档并接电源。

| 项目 | 记录 |
|---|---|
| VBAT/5V/3V3_EXT对地无持续短路；电容充电短响不等同短路 | ____ |
| CORE与EXT不直接短接，GND共地，线束逐针一致 | ____ |
| AO3400A转接板G/S/D、急停两组NC、碰撞与闭盖触点 | ____ |
| 降压离板调5.00V；J4/J5/J6对地；外围及核心3.3V | ____ |
| 串口TX空闲、I²C上拉、各数字输入适配后的电平 | ____ |
| 上电不动作；SWD能识别；STATUS/RAW有输出 | ____ |
| 空白FLASH初始化、管理员注册、重启后保留 | ____ |
| 每个传感器触发前后RAW值；修改config.h极性并重编译 | ____ |
| OLED显示、读卡、蓝牙文本、温湿度、光敏分别检查 | ____ |
| 电池万用表值与显示值、ADC比例校正 | ____ |
| 保存版本、照片、跳帽位置、测点读数 | ____ |

纯逻辑测试不需要ARM。逻辑电源单独供电且PA1未接有效电池分压时，低电故障是预期的，不能绕过低电互锁去跑电机。

## 两次之间

已验证且接线不变的逻辑模块可继续软件测试：注册、挂失、查询、兑换、串口导出、屏幕与蓝牙。第二次之前把机构安装到便于操作的位置，保持线束可检查。

需要改变焊点、供电、模块电平或跳帽时，先断电，回实验室复查受影响部分。不要把上次测量当成改线后的结果。

## 第二次：执行器与整机

借万用表及可调限流电源；有电子负载时一起验证降压持续带载能力。没有示波器时，电源瞬态和精确PWM时序保留“未实测”。

1. 断电复查装入外壳后的线路、焊接面、螺钉、绝缘。
2. 先读RAW，确认急停释放PB13=0、碰撞正常PB12=0、闭盖极性正确。
3. 已有管理员查询认证；清除可恢复故障。`ARM CONFIRM`只使能测试许可，不自动动作。
4. **拆舵机连杆**，`SERVO 1500`，每次±20 µs试探，再按机械步骤标定。记录安全闭盖/开盖脉宽，不先扫全范围。
5. `SET CLOSE 实测值`、`CONFIRM`，同理设置OPEN。SET会停止舵机脉冲；需要扶住盖。标定过程中LID_HELD可保存参数。
6. 平放MPU读取RAW，保存安装偏置；设置实测判满/清满距离、ADC比例。
7. 核实全部输入极性、舵机安全范围、供电后，`SET CALIBRATED 1`、`CONFIRM`。该标志是人工确认，未自动测量任何内容。
8. 架空轮子，盖闭合、超声正常、无故障，进入MANUAL；先用10%短测，再逐步标定。每100 ms发MOVE，停发后应在300 ms超时窗口停车。
9. 测试急停/碰撞/障碍/倾斜/遥控断连。恢复触发源后，CLEAR，不发新MOVE时仍应停止。
10. 校准最高PWM，使地面实测最高速度≤0.15 m/s；不从占空比推断实际速度。
11. 做刷卡投放：一次有效经过仅+1；持续挡光不结算、不强关；查询不动作；便捷模式不计分。
12. 保存账本、日志、电压、视频及未完成项。

| 实测参数 | 结果 |
|---|---|
| P_CLOSE / P_OPEN，µs | ____ / ____ |
| ADC_SCALE，千分比 | ____ |
| ROLL_ZERO / PITCH_ZERO，0.1度 | ____ / ____ |
| FULL / CLEAR，mm | ____ / ____ |
| LIGHT_ON / LIGHT_OFF，ADC原始值 | ____ / ____ |
| PWM上限 / 1m实测时间 | ____ / ____ |
| 电机动作5V / 舵机动作5V（万用表读数） | ____ / ____ |
| 瞬态波形 / PWM频率是否实测 | ____ |
| 最终固件散列 / 日期 | ____ / ____ |

不保证两次能解决所有接线或模块问题，另留一次返修机动时间。
