Sylphiette666/stm32-rfid-smart-bin/firmware/README.md

# 固件开发状态

2026-10-13已基于原STM32F103设备基础文件完成 [A1应用固件](a1/README.md)，含 [Keil工程](a1/MDK/SmartBin_A1.uvprojx)、模块驱动、积分事务/恢复、投放和运动状态机、菜单、串口及标定入口。

已实际进行编译、Keil Rebuild和四组主机C测试。源码、HEX/BIN/AXF和验证记录见 `a1/`；首次实物调试见 [实验室集中检查清单](a1/LAB_CHECKLIST.md)。**尚未烧录或验证用户实物，不能把代码完成等同于整机验收通过。**

本次交付使用已有Keil/Arm Compiler和CMSIS寄存器工程，而非手册原规划的CubeMX/HAL路线；引脚及硬件A1接口保持。软件使用方法、配置差异和已知限制以 [A1固件说明](a1/README.md)为准，物理接线仍按最新A1逐针表。旧PCF8574 V2.1引脚配置不能套用。

**开发工具确定为Keil。** 在Keil内完成编辑、编译、下载及源码调试，不要求安装CubeMX、CubeIDE或CubeProgrammer。VS Code可作为可选源码编辑器；当前已验证的工程入口是µVision，首次下载器设置见[A1固件说明](a1/README.md#keil-下载与源码调试)。

`legacy/`保留原基础文件；`a1/vendor/`保留编译所需CMSIS5子集和许可。工具运行依赖及构建缓存不提交。每次修改模块极性或硬件配置后重新编译并验证相应实物。
