Sylphiette666/stm32-rfid-smart-bin/docs/ACCEPTANCE.md

# 33项功能验收清单

以下为计划测试。请在完成真实操作后记录日期、固件版本、结果和证据。

| 编号/功能 | 最少执行步骤 | 通过判据/需保存的证据 |
| --- | --- | --- |
| A1 刷卡识别 | 有效、陌生、挂失各刷10次；连续贴卡10 s | 完整UID正确；持续卡只触发一次；串口日志 |
| A2 注册/注销/挂失 | 注册→重启→挂失→注销；容量满测试 | 状态持久且权限正确；操作前后导出表 |
| A3 投放加分 | 空会话、一次经过、一次会话多次晃动 | 仅有效会话+1；DEPOSIT日志 |
| A4 掉电保存 | 提交与快照的6检查点各断电3次 | 恢复为上次或本次完整状态；恢复对照表 |
| A5 查询 | 查询已有/陌生用户各3次 | 不开盖不改余额；前后账本一致 |
| A6 卡片读写 | 专用卡块4写/读；移卡失败 | 16字节回读一致；失败不影响账本；数据截图 |
| A7 管理权限 | 普通卡管理、管理员超时、最后管理员注销 | 非法操作被拒；恢复流程保留普通余额 |
| A8 记录/排行 | 至少3用户不同及同分，日志滚动覆盖 | 最近记录/排序与CSV一致；覆盖不改余额 |
| A9 兑换 | 余额4、5、10；连按；提交中断电 | 余额不足拒绝；一动作一次扣分；事务日志 |
| B1 刷卡开盖 | 合装后连续开关20次 | 无卡滞、复位；闭盖开关有效；视频 |
| B2 投放检测 | 浅/深物各10次、持续挡光 | 有效经过事件正确；记录颜色/手遮局限 |
| B3 去重超时 | 不投放10 s、长挡光、连刷/连投 | 单会话≤1事务；挡光不贸然关盖 |
| B4 靠近开盖 | 停车靠近/移开；移动中靠近 | 只便捷模式响应，不积分；视频 |
| B5 满桶 | 真实袋口下15 mm纸板、空/半/满、无回波 | 新阈值在袋口下判满；保留尺量/读数 |
| B8 清桶维护 | 进入维护发移动/投放请求，断电取内胆再装回 | 不运动不积分；快拆可行、恢复有检查 |
| C1 移动转向 | 架空正反，地面1 m计时，满载 | 前后左右正确，≤0.15 m/s，无复位 |
| C2 遇障停车 | 白/黑/斜目标，5次停止距离 | 可检测目标能停；漏检范围有记录 |
| C3 循迹 | 直线→缓弯→5圈→断线 | 稳定完成、丢线锁停；视频 |
| C4 定点停靠 | 起点选择1/2站；慢速跨标记 | 同标记只计一次；到目标停稳才允许开盖 |
| C6 蓝牙遥控 | 正常、松手、关闭蓝牙、错误命令 | 300 ms有效命令超时停车；重连不续跑 |
| C8 倾角报警 | 慢倾>18°，恢复<10°，数据过期 | 锁停，需确认；不把陀螺当定位 |
| C9 碰撞停车 | 左右/中部按压与断线 | 触发停，持续压住不得起步 |
| D1 OLED | 最大积分、长故障、快速切页 | 无覆盖闪烁，故障信息清楚 |
| D2 蜂鸣 | 刷卡/成功/故障/静音期间急停 | 节奏区分，停车不受阻塞 |
| D3 按键 | 短按20次、长按、按住确认 | 无重复提交，退出运动立即停 |
| D4 旋钮 | 正反各20格、快速转与按压 | 菜单不越界、不误确认 |
| D5 停止按钮 | 所有主模式及总线繁忙时按下 | 硬件撤使能、软件锁存；释放不自起 |
| D6 自检 | 断电逐一拆模块再上电 | 故障明确，关键与非关键降级正确 |
| D7 电池电压 | 万用表3点比对；电源降压模拟 | 校准合格，阈值/回差/延时有效 |
| D8 PC导出 | 导出用户和日志、取消/断线 | CSV可读，与屏幕一致，不阻塞 |
| E1 温湿度 | 连续读取、短时失效/断开 | 校验正确或明确未知；不阻塞 |
| E2 光感照明 | 遮光/恢复10次、阈值附近停留 | 2 s延时与回差有效，无反复闪烁 |
| E4 语音 | 6音轨、无卡/BUSY超时、故障打断 | 音义一致，失败不阻塞停止与记账 |
