Sylphiette666/stm32-rfid-smart-bin/archive/earlier-plans/基于STM32的RFID积分式智能移动垃圾桶_全过程实施手册_中型扩容版.docx

嵌入式系统课程设计 · 实施手册

基于STM32的RFID积分式

智能移动垃圾桶（中型扩容版）

从方案设计、SolidWorks建模到硬件搭建、固件联调与答辩交付

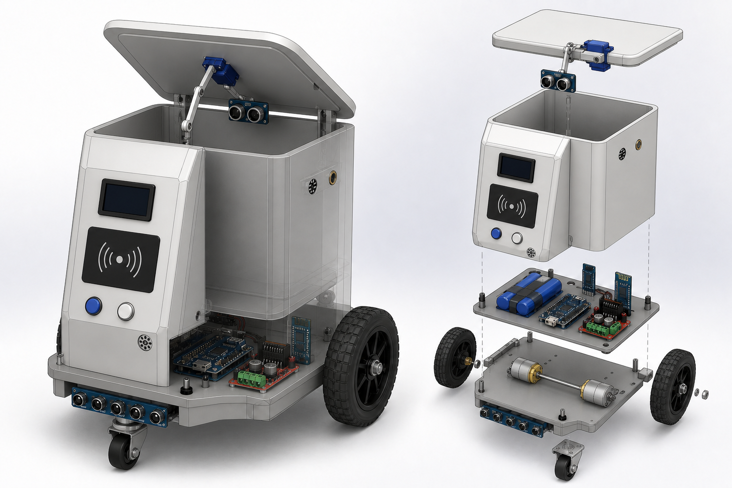
[picture p8: figure]
智能移动垃圾桶SolidWorks风格装配体概念图

中型扩容版装配体概念演示图（用于结构规划，实际尺寸以实物测量为准）

版本 V1.1 | 中型扩容尺寸基线 | 编制日期 2026年9月2日

姓名：____________ 学号：____________ 专业班级：____________

# 目录

使用提示：若目录页码未自动刷新，在Word中按 Ctrl+A 后按 F9，即可更新全部域。

# 使用说明

推荐实施路线：先做“不会移动的智能垃圾桶”，再做“可遥控的小车”，最后接入循迹、满载返回和火情优先级。每增加一个模块都必须先单独验收，再进入总系统。

本手册不是单纯的报告提纲，而是一份按执行顺序编排的工程操作指南。每个阶段均给出输入、操作、验收标准和常见故障。建议打印阶段验收表，完成一项即记录一项，避免后期无法定位问题。

- 主线功能：用户刷卡、显示积分、按键开盖、检测投放、固定积分累加。
- 移动功能：管理员蓝牙遥控；满载后切换自动循迹，抵达回收点停车。
- 安全功能：火焰与温度联合判断；发生火情立即停车、关盖并报警。
- 硬性覆盖：不少于三类传感器、两类输出控制、外部中断、串口通信、OLED显示和RFID。

序号 | 检查项目 | 记录
1 | 已明确题目、功能边界与演示流程。 | 未检/通过/整改
2 | 已完成总体框图、引脚表、电源树和BOM。 | 未检/通过/整改
3 | 已完成SolidWorks装配体、干涉检查和主要加工图。 | 未检/通过/整改
4 | 所有模块均有独立测试记录。 | 未检/通过/整改
5 | 总系统已通过异常、断电、连续运行测试。 | 未检/通过/整改
6 | 报告、源程序、视频和答辩PPT均已归档。 | 未检/通过/整改

# 1 项目任务、范围与验收目标

## 1.1 把任务书转换成工程要求

先把自然语言要求转换为可以测量和演示的验收项。后续选型、建模、接线和代码结构都围绕这些验收项展开，避免出现“功能很多但核心要求没覆盖”的情况。

任务要求 | 本方案实现 | 验收口径
STM32主控 | STM32F103C8T6；I/O不足时升级F103RCT6 | 上电稳定运行，保留SWD下载口
满载监测 | 桶盖下方HC-SR04测距并滤波 | 连续3秒低于阈值才判满
火情监测 | 火焰传感器+DS18B20温度 | 预警与正式报警分级
桶盖控制 | 按键EXTI+舵机PWM | 按键可开/关；超时自动关闭
自动循迹 | 五路红外阵列+双电机差速 | 满载后到回收点宽黑线停车
无线遥控 | HC-05通过USART1接收指令 | 管理员卡授权后才接受运动命令
RFID与积分 | RC522读取UID，Flash保存用户表 | 投放确认后每周期只加一次积分
OLED显示 | I2C OLED显示模式、容量、温度、积分 | 关键状态不依赖串口查看
输出控制 | 舵机、电机、蜂鸣器/LED | 至少两类且可独立演示
中断功能 | 按键EXTI、串口接收中断、超声波捕获 | 中断中只置标志或收数据

## 1.2 冻结第一版功能边界

范围控制：第一版不加入摄像头识别、云平台、自动充电和多桶复杂分类。这些功能会显著增加机械与软件风险，只有主线全部稳定后才作为加分项考虑。

- 必须完成：满载、火情、按键桶盖、OLED、蓝牙遥控、循迹、RFID用户/管理员、积分保存。
- 可选增强：投放口红外检测、电池电压显示、简单速度闭环、管理员清空积分。
- 明确不做：真实灭火、自动充电、视觉分类、互联网云端监控。

## 1.3 设计成功的量化标准

验收对象 | 最低通过标准
开机 | 5秒内完成自检并进入待机，OLED无乱码
刷卡 | 连续刷卡20次识别成功率不低于95%
桶盖 | 开合不卡滞，单次动作不导致主控复位
满载 | 稳定判满，不因单次手遮挡立即触发
积分 | 一次有效投放只加一次；断电重启后仍保留
蓝牙 | 10米内稳定控制；通信中断1秒内停车
循迹 | 完整路线连续运行3圈不丢线；丢线后停车
火情 | 触发后立即停止电机、关盖并持续声光报警
耐久 | 连续运行30分钟无死机、异常发热或复位

# 2 总体方案设计与系统逻辑

## 2.1 系统分层

层级 | 组成 | 输出
机械层 | 桶体、桶盖、舵机连杆、底盘、轮组、电子仓、传感器支架 | SolidWorks模型及实物结构
供电层 | 2S电池、总开关、保险/保护板、5V降压、3.3V稳压、滤波 | 稳定供电与共地
输入层 | 超声波、火焰、温度、投放红外、循迹阵列、按键、RFID | 传感器原始数据
控制层 | STM32驱动、滤波、状态机、故障处理、积分存储 | 控制决策
执行层 | 舵机、双电机、蜂鸣器、状态LED | 物理动作
交互层 | OLED、蓝牙串口、用户卡、管理员卡 | 显示、授权和人工控制

## 2.2 核心业务流程

上电自检 -> 待机显示 -> 刷用户卡 -> 显示积分 -> 按键开盖
-> 检测垃圾经过投放口 -> 关盖 -> 积分+1并保存
-> 监测满载/火情 -> 正常则返回待机
-> 满载则禁止投放并自动循迹回收
-> 火情则无条件停车、关盖、报警

管理员卡具有更高权限：刷卡后进入管理员模式，可通过蓝牙控制前进、后退、转向、停止、开关盖、切换自动循迹和清除满载标志。运动命令必须带超时保护。

## 2.3 状态机设计

状态 | 主要动作 | 退出条件
BOOT | 上电、自检、读取用户数据 | 自检通过进入IDLE；失败进入ERROR
IDLE | 周期监测、显示容量和温度 | 刷卡、满载、火情或按键触发
USER_AUTH | 显示用户积分并开放投放 | 按键开盖或超时返回
LID_OPEN | 舵机打开，等待投放脉冲 | 检测投放、关闭按键或超时
ADMIN_REMOTE | 接受蓝牙运动和维护指令 | 管理员退出、通信超时、火情
FULL | 锁定投放并提示满载 | 切换AUTO_RETURN
AUTO_RETURN | 循迹前往回收点 | 宽黑线停车或丢线报警
FIRE | 停车、关盖、声光报警 | 仅管理员确认后退出
ERROR | 安全停车并显示故障码 | 复位或排除故障

优先级：FIRE/急停 > ERROR > FULL/AUTO_RETURN > ADMIN_REMOTE > USER_AUTH > IDLE。任何状态只要检测到火情，都必须立即转入FIRE。

## 2.4 软件任务周期

周期 | 任务 | 实现要求
1 ms | 系统时基、软件计时器 | 禁止执行耗时外设访问
10 ms | 按键消抖、循迹采样、电机安全超时 | 运动控制高优先级
50 ms | 投放红外、火焰采样、状态机 | 传感器去抖
100 ms | 超声波测距、温度状态读取 | 分阶段执行，避免阻塞
200 ms | RFID轮询、蓝牙协议解析 | 不在中断中处理业务
500 ms | OLED刷新、LED心跳 | 仅内容变化或到期时刷新
事件触发 | 积分写入、报警、状态切换 | 写Flash前确认电机电源稳定

# 3 物料、工具与采购准备

## 3.1 核心BOM

类别 | 器件 | 数量 | 接口/电压 | 关键注意事项
主控 | STM32F103C8T6最小系统板 | 1 | 3.3V | 保留SWD；接口紧张可换RCT6
下载 | ST-Link V2 | 1 | SWD | 下载与在线调试
显示 | 0.96英寸OLED | 1 | I2C | 优先选3.3V兼容模块
身份 | RC522+M1卡 | 1套 | SPI | RC522只能3.3V
通信 | HC-05 | 1 | USART | 管理员遥控
满载 | HC-SR04 | 1 | Trig/Echo | Echo必须分压
火情 | 火焰传感器 | 1 | ADC | 保留模拟输出
温度 | DS18B20 | 1 | 1-Wire | 数据线加4.7k上拉
投放 | 红外对射/避障模块 | 1 | GPIO | 确认垃圾经过投放口
循迹 | 五路TCRT5000阵列 | 1 | 5路GPIO | 带可调阈值更方便
桶盖 | DS3218或MG996R大扭矩舵机 | 1 | PWM | 独立5V/5A供电，金属支架固定
驱动 | TB6612FNG | 1 | 2PWM+4方向 | 效率优于L298N
运动 | N20高扭矩减速电机，80~120rpm | 2 | 电机 | 轻质样机总质量建议不超过4kg
底盘 | 100mm轮+40~50mm万向轮+320×280mm底板 | 1套 | 机械 | 优先定制轻质底盘并实测孔位
报警 | 有源蜂鸣器+红色LED | 各1 | GPIO | 蜂鸣器经三极管驱动
输入 | 轻触按键 | 2~3 | EXTI/GPIO | 开盖、模式、急停
电源 | 2S高倍率18650电池+BMS | 1套 | 7.4V | 电芯持续放电≥10A，BMS额定10A
降压 | 5V/5A舵机电源+5V/3A逻辑电源 | 各1 | 电源 | 两路分开供电并共地
安装 | 铜柱、螺钉、端子、排针、线材 | 若干 | 机械/电气 | 使用可拆接插件
载体 | 亚克力/3D打印桶体与支架 | 按图 | 机械 | 先纸板样机再加工

## 3.2 必备工具和软件

类别 | 工具 | 用途
机械测量 | 游标卡尺、直尺、角尺 | 测量模块孔距和安装空间
装配加工 | 螺丝刀、手钻/激光切割/3D打印、锉刀 | 制作支架与开孔
焊接 | 恒温烙铁、焊锡、助焊剂、热缩管 | 制作可靠线束
测量 | 数字万用表 | 每次上电前检查短路与电压
调试 | USB-TTL、串口助手 | 查看日志和测试HC-05
开发 | STM32CubeMX+Keil MDK或STM32CubeIDE | 工程生成和编译
建模 | SolidWorks | 零件、装配体、工程图、爆炸图
可选仪器 | 示波器/逻辑分析仪/可调电源 | 定位PWM、串口和电源干扰

## 3.3 采购前必须完成的操作

1. 冻结模块型号。特别是电机、轮子、舵机、OLED、RC522和电池尺寸，避免模型与实物不一致。
2. 下载模块尺寸图。若商家没有准确图纸，先购买关键件并用卡尺实测。
3. 完成引脚预算。确认主控引脚、定时器、SPI、I2C、USART和ADC无冲突。
4. 完成电源预算。估算电机堵转和舵机峰值电流，5V降压至少留30%余量。
5. 分批采购。第一批买主控和传感器；第二批在静态功能通过后再确定机械加工件。

# 4 SolidWorks结构设计与实物装配

## 4.1 建模前的尺寸基线

尺寸原则：下表为中型扩容版布局基线，桶体标称约20L。所有安装孔、接口位置和外壳开孔必须以实际器件卡尺测量结果为准；整机采用轻质板材，总测试质量建议不超过4kg。

对象 | 建议初始尺寸 | 设计说明
整机外廓 | 约360×340×500 mm | 含轮组与闭合桶盖，仍可由一人搬运
底盘 | 320×280×5 mm | 四角圆角10~15 mm，主承力区不大面积镂空
电子安装板 | 270×220×3 mm | 与底盘间用20~25 mm铜柱
桶体外廓 | 280×230×360 mm | 壁厚约2.5~3 mm，标称容量约20L
桶盖 | 300×250×8 mm | 轻质材料，连杆与盖总质量建议≤600g
轮子 | 直径约100 mm，宽约30 mm | 与桶体保持至少10 mm间隙
前面板 | 约170×220 mm | 容纳OLED、RFID、按键、蜂鸣孔及维护空间
循迹高度 | 传感器距地5~10 mm | 设计长圆孔便于调高
电子仓净高 | 不低于45 mm | 避免电池、降压模块和接插件顶碰桶体

图4-1 中型扩容版装配体及爆炸视图概念参考

## 4.2 建立SolidWorks项目

1. 建立项目目录。创建01_Parts、02_Assembly、03_Drawings、04_STEP_STL、05_Render五个文件夹。
2. 设置单位。统一使用MMGS（毫米、克、秒），文档属性中设置尺寸精度0.1 mm。
3. 建立全局参数。用方程式统一管理底盘长宽、桶体长宽高、壁厚、孔距和间隙。
4. 确定原点。底盘中心作为总装配原点，车头方向设为X正方向，向上为Z正方向。
5. 建立命名规则。零件使用P01_Chassis、P02_Bin、P03_Lid；装配体使用A00_SmartBin。

## 4.3 逐个建立主要零件

零件 | 主要建模操作 | 完成检查
P01 底盘 | 中心矩形草图→拉伸5 mm→圆角→电机/铜柱/万向轮孔→局部减重孔 | 孔位对称，主承力区完整，轮胎不碰桶体
P02 电子板 | 矩形拉伸3 mm→主控/驱动/电池长圆孔→理线孔 | 模块可拆，不用胶永久固定
P03 桶体 | 外轮廓拉伸→抽壳2.5~3 mm→桶口圆角→前面板安装面 | 内部无尖角卡垃圾袋，侧壁增加加强筋
P04 前面板 | 斜面或竖直面→OLED窗→RFID平面→按键孔→蜂鸣器阵列孔 | RFID背后远离金属和电池
P05 桶盖 | 矩形圆角→拉伸→下沿定位边→铰链耳 | 关闭时不过度压迫舵机
P06 舵机架 | 按实测舵机尺寸建槽→耳板孔→连杆转轴孔 | 保留拆装螺钉空间
P07 超声波架 | 双圆孔→定位凸台→盖下安装孔 | 声波路径不被盖板遮挡
P08 循迹架 | 横梁→五路板固定孔→上下可调长圆孔 | 传感器面与地面平行
P09 轮/轴简模 | 按直径和轴孔简化建模 | 用于干涉和离地间隙检查
P10 电池托架 | 电池外廓+0.5~1 mm间隙→束带槽 | 可取出充电并防止滑动

## 4.4 建立装配体和运动关系

1. 固定底盘。将P01_Chassis插入A00_SmartBin并固定在装配体原点。
2. 装配电机与轮组。轴线同心、端面重合；左右轮距保持对称。
3. 装配万向轮。检查三点接地，保证整机在水平面不摇晃。
4. 装配电子板和桶体。使用距离配合模拟铜柱，检查螺丝刀操作空间。
5. 装配桶盖铰链。用同心配合和角度限位，限定关闭0°、打开约75°。
6. 装配舵机连杆。建立销轴配合并拖动验证，不得出现死点或过约束。
7. 装配外部面板。检查OLED视角、刷卡手势、按键间距和线束弯曲半径。
8. 装配传感器。超声波朝向垃圾，循迹阵列朝地，火焰/温度孔无遮挡。
9. 执行干涉检查。重点检查轮胎、桶体、舵机连杆、桶盖和线束通道。
10. 建立爆炸视图。按桶盖→桶体→电子板→底盘→轮组顺序展开，用于报告和答辩。

## 4.5 输出工程文件

- 零件工程图：标注外形、孔径、孔距、板厚、圆角和材料。
- 装配工程图：包含主视图、俯视图、轴测图、爆炸图和序号气泡。
- 加工文件：激光切割输出DXF；3D打印输出STL；跨软件交换输出STEP。
- 版本归档：每次结构变更提升版本号，不覆盖已用于加工的文件。

序号 | 检查项目 | 记录
1 | 总装配无红色报错、无欠定义的关键安装件。 | 未检/通过/整改
2 | 桶盖可在限定角度内运动且不穿模。 | 未检/通过/整改
3 | 轮胎、桶体、电子板和线束通道无干涉。 | 未检/通过/整改
4 | 所有真实器件均有可拆卸固定方式。 | 未检/通过/整改
5 | 电池、开关、下载口和USB/串口接口可在装配后访问。 | 未检/通过/整改
6 | 已导出爆炸图、关键尺寸工程图和加工文件。 | 未检/通过/整改

## 4.6 实物装配顺序

1. 先做纸板/泡沫板样机。验证总体体积、桶盖运动和刷卡位置，不急于最终加工。
2. 安装底盘运动件。装电机、轮子和万向轮，手推检查是否顺畅。
3. 安装电源与总开关。先不接主控，独立测量7.4V、5V和3.3V。
4. 安装电子板。主控与驱动之间留散热和插拔空间，线束分动力与信号两组。
5. 安装桶体和面板。确认重心不偏、RFID无遮挡、显示屏面向观察者。
6. 安装舵机与桶盖。断电手动检查连杆，再低速上电调角度。
7. 安装传感器并调位置。最后固定超声波、火焰、温度、投放和循迹模块。

# 5 电气设计、引脚分配与接线

## 5.1 电源树

2S锂电池(约7.4V，持续放电≥10A)
|-- TB6612 VM -> 左右N20高扭矩减速电机
|-- 独立5V/5A降压 -> DS3218/MG996R桶盖舵机
|-- 5V/3A逻辑降压 -> HC-SR04、开发板5V输入、HC-05
|-- 开发板3.3V -> RC522、OLED、低压传感器
所有模块GND必须共地；电机线与传感器线分开走线。

严禁：不要用STM32的3.3V引脚给舵机或电机供电；不要把HC-SR04的5V Echo直接接入STM32；不要在没有测量短路的情况下直接接电池。

- 电机侧：TB6612 VM接电池，VM附近放置470 μF电解电容和0.1 μF陶瓷电容。
- 5V侧：舵机使用独立5V/5A降压，逻辑使用5V/3A降压；舵机附近加1000 μF低ESR电容。
- 3.3V侧：RC522和OLED靠近主控，电源脚附近放0.1 μF去耦。
- 接地：优先星形接地，电机大电流回路不要经过传感器地线。
- 开关：总开关串在电池输出端；建议增加保险丝或自恢复保险。

## 5.2 推荐引脚分配（STM32F103C8T6）

模块/信号 | 引脚 | 外设 | 备注
OLED SCL/SDA | PB10/PB11 | I2C2 | 400 kHz或100 kHz
RC522 NSS/SCK/MISO/MOSI | PA4/PA5/PA6/PA7 | SPI1 | 仅3.3V
RC522 RST | PB0 | GPIO | 上电复位
HC-05 TX/RX | PA10/PA9 | USART1 | STM32 RX/TX交叉连接
舵机信号 | PA0 | TIM2_CH1 PWM | 50 Hz，1~2 ms脉宽
超声波 Echo | PA1 | TIM2_CH2输入捕获 | Echo分压至3.3V
超声波 Trig | PA2 | GPIO输出 | 10 μs脉冲
DS18B20 | PA3 | 1-Wire GPIO | 4.7k上拉至3.3V
火焰模拟量 | PB1 | ADC1_IN9 | 先确认输出不超过3.3V
投放红外 | PB5 | GPIO/EXTI | 按模块电平调整
电机PWMA/PWMB | PB6/PB7 | TIM4_CH1/CH2 | 建议20 kHz
电机方向 | PB12~PB15 | GPIO输出 | AIN1/2、BIN1/2
TB6612 STBY | PA8 | GPIO输出 | 低电平强制停机
五路循迹 | PA11/PA12/PA15/PB3/PB4 | GPIO输入 | 禁用JTAG但保留SWD
开盖/模式键 | PC13 | EXTI13 | 输入上拉
急停键 | PC14 | EXTI14 | 输入上拉
蜂鸣器 | PC15 | GPIO+三极管 | PC15不直接带负载
下载调试 | PA13/PA14 | SWDIO/SWCLK | 必须保留

调试口配置：CubeMX中将SYS Debug设置为Serial Wire，释放PA15、PB3和PB4作为循迹输入，同时保留PA13/PA14用于SWD下载。

## 5.3 各模块接线操作

1. 先接主控最小系统。只连接ST-Link、5V和GND，下载LED闪烁程序并稳定运行10分钟。
2. 接OLED。确认VCC电压和I2C地址；只显示固定字符，不接其他模块。
3. 接RC522。严格使用3.3V；SPI线尽量短，读取版本寄存器和卡UID。
4. 接HC-05。TX/RX交叉，先用串口助手确认波特率，再连接STM32。
5. 接超声波。Echo使用10k/20k分压；先测固定平面距离。
6. 接火焰和温度。单独观察原始ADC和温度值，暂不启用报警。
7. 接投放红外与按键。确认空闲电平，加入消抖和一次事件锁。
8. 接舵机。舵机单独5V供电、与主控共地；先卸下连杆调中位。
9. 接TB6612和电机。架空轮子测试方向；确认STBY默认拉低，防止上电乱跑。
10. 接循迹模块。逐路查看黑/白电平，调整每路电位器并记录极性。

## 5.4 首次上电检查

序号 | 检查项目 | 记录
1 | 断电状态下，电池正负端与GND之间不存在明显短路。 | 未检/通过/整改
2 | 降压模块空载输出为5.0V左右，极性正确。 | 未检/通过/整改
3 | 主控3.3V稳定，无异常发热。 | 未检/通过/整改
4 | RC522和OLED供电为3.3V。 | 未检/通过/整改
5 | HC-SR04 Echo已通过分压接入。 | 未检/通过/整改
6 | 舵机、电机和主控共地，但动力线与信号线分开。 | 未检/通过/整改
7 | STBY上电默认低电平，电机不会突然转动。 | 未检/通过/整改
8 | 急停按键可直接使STBY拉低或由软件立即拉低。 | 未检/通过/整改

# 6 固件工程建立与底层配置

## 6.1 CubeMX/IDE工程建立

1. 新建MCU工程。选择STM32F103C8Tx，工程名建议SmartBin_F103。
2. 配置调试。SYS Debug选择Serial Wire；RCC按开发板晶振配置HSE。
3. 配置时钟。系统时钟设为72 MHz，确认APB1外设时钟限制。
4. 配置GPIO。输出脚设置初始安全电平，尤其STBY、舵机和蜂鸣器。
5. 配置TIM2。计数分辨率1 μs、周期20 ms；CH1输出50 Hz舵机PWM，CH2输入捕获超声波Echo。
6. 配置TIM4。CH1/CH2输出约20 kHz电机PWM，初始占空比为0。
7. 配置SPI1。主机、8位、Mode 0，初始速度不宜过高。
8. 配置I2C2。连接OLED，先用100 kHz保证稳定，再视情况升到400 kHz。
9. 配置USART1。与HC-05保持一致，常用9600 8N1，开启接收中断。
10. 配置ADC1。PB1模拟输入，采样时间适当加长并做多次平均。
11. 配置EXTI。PC13、PC14及可选PB5开启外部中断，设置合理优先级。
12. 生成工程。选择仅复制必要库，勾选保留用户代码区，立即建立Git或版本备份。

## 6.2 推荐代码目录

SmartBin_F103/
Core/Inc, Core/Src CubeMX初始化与main
BSP/ board、delay、timebase
Drivers/OLED 显示驱动
Drivers/RC522 RFID驱动
Drivers/HC_SR04 超声波驱动
Drivers/DS18B20 温度驱动
Drivers/Motor TB6612与电机控制
Drivers/Servo 舵机控制
Drivers/LineSensor 循迹采样
App/app_state.c 状态机
App/app_user.c 用户和积分
App/app_safety.c 满载、火情、急停
App/app_protocol.c 蓝牙协议
Storage/user_store.c Flash数据保存
README.md 编译、接线和演示说明

## 6.3 编程原则

- 非阻塞：除上电短延时外，不使用长HAL_Delay；用毫秒时基判断任务到期。
- 中断简短：串口中断只收字节，按键中断只置事件标志，输入捕获只记录时间。
- 安全默认：任何复位、错误或通信超时都把电机PWM置0并拉低STBY。
- 模块解耦：驱动层不直接切换业务状态，状态机只通过接口读取数据和下发动作。
- 数据滤波：满载、火焰、投放和循迹都必须做去抖或连续样本确认。
- 可观察性：保留状态码、传感器原始值和故障码，OLED或串口至少能看到一种。

while (1) {
Scheduler_Run(); // 到期任务
Sensor_Service(); // 更新经过滤波的传感器状态
Safety_Service(); // 急停、火情、通信超时
AppState_Run(); // 状态机
Display_Service(); // 限频刷新OLED
}

# 7 各功能模块的开发步骤

## 7.1 OLED显示

1. 完成I2C扫描或固定地址测试。常见地址为0x3C，但必须以实物为准。
2. 显示ASCII和中文测试页面。确认字库、坐标、清屏和刷新无乱码。
3. 定义固定页面布局。第一行模式，第二行容量，第三行温度/火情，第四行UID或积分。
4. 建立脏标志。仅当内容变化或500 ms到期时刷新，避免占用大量总线时间。

验收：连续刷新10分钟不死机；传感器数值变化时显示不闪烁、不重叠。

## 7.2 按键与外部中断

1. 读取空闲电平。输入上拉时按下为低，先用LED验证。
2. 中断中记录时间和事件。不在回调函数中直接驱动舵机或刷新OLED。
3. 加入20~50 ms消抖。消抖结束后再次读取引脚确认。
4. 定义短按和长按。短按开/关盖；长按可作为退出管理员或复位满载。
5. 急停单独处理。急停事件优先拉低STBY，并写入紧急状态。

## 7.3 舵机与桶盖

1. 舵机脱离连杆上电。先输出1.5 ms中位，防止突然转动撞坏机构。
2. 测量安全端点。从中位逐步调整，记录关闭脉宽和打开脉宽。
3. 安装连杆。关闭位置不顶死，打开位置不超过机械限位。
4. 实现缓动。目标脉宽分10~20步变化，每步间隔10~20 ms，减小冲击。
5. 实现超时关闭。用户开盖后若无操作，5~8秒自动关闭。

验收：连续开合50次无卡滞、无异常发热、无主控复位。

## 7.4 超声波满载检测

1. 发送10 μs Trig。两次测量间隔建议不低于60 ms。
2. 使用TIM2输入捕获测Echo高电平。上升沿记录开始，下降沿记录结束。
3. 换算距离。距离厘米约等于高电平微秒数/58。
4. 进行异常剔除。超范围、零值和跳变过大的样本不进入平均。
5. 建立滑动平均。保留最近5~10次有效距离。
6. 设定满载条件。平均距离低于实测阈值并持续3秒才置full标志。
7. 设置解除条件。管理员清空后，距离高于解除阈值持续3秒才复位。

if (distance_avg < FULL_CM) full_counter++;
else full_counter = 0;
if (full_counter >= FULL_CONFIRM_COUNT) full_flag = true;

## 7.5 火焰与温度联合判断

1. 记录正常环境基线。分别记录室内灯光、阳光和无火源条件下的ADC。
2. 安全模拟火焰信号。使用老师允许的低风险方式，传感器与火源保持距离并准备灭火措施。
3. 读取DS18B20。检查85°C上电默认值和断线错误，不把无效值当火情。
4. 设置两级判断。单一传感器异常进入预警；持续火焰或火焰+高温进入正式报警。
5. 加入滞回。报警阈值与解除阈值分开，防止状态来回跳变。
6. 锁存正式火情。只有管理员确认且传感器恢复正常后才能解除。

安全限制：课程演示只做检测、停车、关盖和声光报警，不在装有电池的模型上进行真实燃烧或喷水灭火实验。

## 7.6 RC522身份与积分

1. 读取版本寄存器。确认SPI通信后再进行寻卡。
2. 读取并规范化UID。使用十六进制字符串记录，避免字节顺序混乱。
3. 建立卡片角色表。至少准备1张管理员卡和2张用户卡。
4. 用户刷卡。显示UID后四位和当前积分，打开30秒授权窗口。
5. 确认投放。必须检测到投放红外脉冲并完成关盖，才允许加分。
6. 一次周期只加一次。用deposit_scored锁防止物体抖动重复计分。
7. 保存数据。仅积分变化时写入Flash；保存版本号、条目数和校验值。
8. 管理员功能。可进入遥控、清除满载、查看用户列表，清零积分需二次确认。

typedef struct {
uint8_t uid[4];
uint16_t points;
uint8_t role; // 0=user, 1=admin
uint8_t valid;
} UserRecord;

## 7.7 Flash积分保存

- 存储位置：选择程序末端的独立Flash页，并在链接和代码中固定地址。
- 写入策略：整页擦除前先把当前用户表读入RAM；修改后整体写回。
- 完整性：保存magic、版本号、记录数和CRC/校验和。
- 寿命：只在积分真正变化时写入，不在主循环反复写。
- 恢复：校验失败时载入默认用户表并显示存储故障码。

## 7.8 蓝牙协议

命令 | 动作 | 安全条件
F | 前进 | 仅管理员；刷新通信超时
B | 后退 | 仅管理员；刷新通信超时
L | 左转 | 仅管理员；刷新通信超时
R | 右转 | 仅管理员；刷新通信超时
S | 停车 | 任意模式均允许
O | 打开桶盖 | 管理员或有效用户授权
C | 关闭桶盖 | 任意模式均允许
A | 切换自动循迹 | 管理员且无火情
Q | 查询状态 | 返回模式、容量、温度、积分
X | 退出管理员 | 立即停车并返回IDLE

- 接收：USART中断逐字节放入环形缓冲区，主循环解析完整命令。
- 超时：运动中超过1000 ms未收到合法命令，立即停止电机。
- 回执：每条命令返回OK、DENY、BUSY或ERROR，便于演示与调试。
- 调试：先用USB-TTL替代HC-05验证协议，再接手机蓝牙终端。

## 7.9 TB6612电机控制

1. 架空底盘。首次测试让轮子离地，STBY保持低电平。
2. 单独测试左电机。逐个验证正转、反转、刹车和停止。
3. 单独测试右电机。若方向相反，只修改方向映射，不随意交叉代码。
4. 建立统一接口。Motor_Set(left_speed, right_speed)，速度范围建议-1000~1000。
5. 加入斜坡。每10 ms限制占空比变化，降低电流冲击。
6. 测试通信超时。发送前进后停止发送，确认1秒内停车。
7. 落地低速测试。先空载使用30%占空比，确认直行方向和底盘无干涉；再逐步增加载荷但总质量不超过4kg。

## 7.10 五路循迹

1. 制作测试路线。黑色胶带宽约18~25 mm，白色底板，转弯半径不宜过小。
2. 调整传感器高度。保持5~10 mm，阵列与地面平行。
3. 逐路标定。记录黑线和白底电平，确认极性一致。
4. 先做离散控制。中心直行、左偏左修正、右偏右修正。
5. 再做加权误差。五路权重设为-2、-1、0、1、2，按误差差速。
6. 识别回收点。五路全黑持续约300 ms视为宽黑线终点。
7. 处理丢线。五路全白超过500 ms立即停车并报警，不盲目继续前进。
8. 连续三圈测试。通过后再接入满载自动切换。

# 8 应用逻辑、模式切换与安全策略

## 8.1 用户投放完整流程

1. 系统处于IDLE。若满载或火情存在，拒绝用户投放并说明原因。
2. 用户刷卡。匹配UID，OLED显示用户号和积分，进入USER_AUTH。
3. 用户按开盖键。舵机缓慢打开，清零本次投放计分锁。
4. 检测投放。红外出现有效遮挡脉冲，记录deposit_detected。
5. 关闭桶盖。用户按键或超时自动关闭。
6. 完成计分。只有已检测投放且本周期未计分时，积分+1并写入存储。
7. 显示结果。OLED显示“积分+1”和新积分2秒，再返回IDLE。

## 8.2 管理员流程

1. 管理员刷卡。识别role=admin，进入ADMIN_REMOTE并显示蓝牙状态。
2. 建立蓝牙连接。未连接时电机保持停止。
3. 遥控运动。每条运动命令刷新超时计时器。
4. 维护操作。可开盖、关盖、查看原始传感器、清除满载标志。
5. 退出。收到X、管理员再次刷卡或超时后停车并返回IDLE。

## 8.3 满载自动返回流程

1. 确认满载。超声波平均距离持续低于阈值，进入FULL。
2. 锁定投放。用户刷卡只显示“垃圾桶已满”，不打开桶盖。
3. 检查安全条件。无火情、急停释放、循迹传感器有效、电池电压正常。
4. 进入AUTO_RETURN。电机低速启动，循迹前往回收点。
5. 检测宽黑线。五路全黑持续确认后停车并拉低STBY。
6. 等待管理员。管理员刷卡，清空垃圾并确认距离恢复。
7. 复位满载。距离高于解除阈值持续确认后返回IDLE。

## 8.4 火情与故障处理

异常 | 立即动作 | 恢复条件
火情 | 立即停止、STBY低、关盖、蜂鸣器连续报警、OLED红色语义提示 | 管理员确认且传感器恢复
急停 | 立即停止、忽略运动命令 | 松开按键后管理员确认
蓝牙超时 | 1秒内停止电机 | 收到新合法命令
循迹丢线 | 停止并间歇报警 | 管理员遥控找回或复位
超声波失效 | 不自动判满，显示传感器故障 | 连续有效测量恢复
温度断线 | 进入预警，火焰传感器仍独立有效 | 温度恢复正常
Flash校验失败 | 载入默认用户表，禁止错误积分覆盖 | 重新初始化存储
低压/复位 | 上电默认停车，记录复位原因 | 排查电源后重启

# 9 分阶段联调与里程碑

联调原则：每个阶段只能引入一类新风险。若阶段验收失败，必须回退到上一个稳定版本，不在故障状态下继续叠加功能。

里程碑 | 包含内容 | 退出标准
M0 主控基线 | 主控、下载、时钟、日志、OLED | 连续运行30分钟；可重复下载
M1 静态垃圾桶 | 按键、舵机、超声波、火焰、温度、蜂鸣器 | 满载和火情逻辑独立通过
M2 RFID积分 | RC522、用户表、投放红外、Flash | 两用户一管理员；断电保持
M3 遥控底盘 | TB6612、电机、HC-05、急停 | 前后左右停止；超时停车
M4 自动循迹 | 五路阵列、终点检测、丢线保护 | 连续3圈稳定
M5 总状态机 | 用户/管理员/满载/火情优先级 | 所有状态切换符合表格
M6 完整机械 | 桶体、盖、面板、线束、重心 | 连续开合50次、移动不松动
M7 最终验收 | 异常测试、30分钟耐久、演示脚本 | 问题清单归零或有说明

## 9.1 每次联调的固定操作

1. 拍照记录接线。变更前后各拍一张，防止无法恢复。
2. 测量电压。确认7.4V、5V和3.3V正确后再插模块。
3. 加载上一个稳定固件。先确认基线仍正常。
4. 只加入一个新模块。先运行独立测试页面或测试命令。
5. 记录原始数据。保留阈值、波形、串口日志和复现步骤。
6. 通过后提交版本。文件名或Git标签标记M1、M2等里程碑。
7. 失败则隔离。拔下新模块，确认旧系统恢复，再定位供电、引脚或软件问题。

## 9.2 推荐演示路线

- 起点：待机位置，垃圾桶未满，用户卡和管理员卡准备好。
- 用户演示：刷用户卡→显示积分→按键开盖→模拟投放→积分增加。
- 管理员演示：刷管理员卡→手机蓝牙前后左右控制→通信停止后自动停车。
- 满载演示：用可移除挡板靠近超声波→持续判满→自动循迹→宽黑线停车。
- 火情演示：使用安全模拟信号→电机停止→桶盖关闭→声光报警。
- 恢复演示：管理员确认、清除模拟条件并恢复待机。

# 10 标定、测试与故障排查

## 10.1 标定项目

对象 | 标定操作 | 最终记录
超声波 | 空桶、半桶、接近满载各测20次 | FULL_CM、解除阈值、无效范围
火焰ADC | 正常灯光、阳光、模拟火源 | 预警阈值、报警阈值、持续时间
DS18B20 | 室温与参考温度计比较 | 偏差修正、高温阈值
投放红外 | 不同大小物体经过20次 | 有效脉宽、去抖时间
舵机 | 脱载调中位，再装连杆 | 关闭/打开脉宽、缓动速度
循迹 | 黑线/白底逐路读取 | 极性、权重、终点确认时间
电机 | 架空及落地直行 | 左右基础占空比、斜坡步长
蓝牙 | 不同距离及断连 | 通信超时、最大可靠距离

## 10.2 功能测试矩阵

编号 | 测试项 | 操作/输入 | 预期结果
T01 | 上电自检 | 正常供电 | 5秒内进入IDLE，电机不动
T02 | 用户刷卡 | 合法用户卡 | 显示积分并允许开盖
T03 | 非法卡 | 未登记卡 | 拒绝并提示
T04 | 重复计分 | 一次开盖多次遮挡红外 | 最多增加1分
T05 | 断电保持 | 计分后断电重启 | 积分保持
T06 | 满载抗抖 | 短暂遮挡超声波 | 不立即判满
T07 | 正式满载 | 持续遮挡超过确认时间 | 锁定投放并自动返回
T08 | 回收点 | 五路持续全黑 | 停车并进入等待管理员
T09 | 循迹丢线 | 五路全白 | 500 ms后停车报警
T10 | 管理员卡 | 合法管理员卡 | 进入蓝牙模式
T11 | 蓝牙超时 | 前进后停止发送 | 1秒内停车
T12 | 急停 | 运动中按急停 | 立即停车且命令无效
T13 | 火焰预警 | 单传感器短时异常 | 预警但不误动作或按策略处理
T14 | 正式火情 | 持续火焰/高温 | 停车、关盖、报警
T15 | 火情优先 | 蓝牙运动时触发火情 | 覆盖管理员命令
T16 | 舵机耐久 | 连续开合50次 | 不卡滞、不复位
T17 | 电机干扰 | 高频启停20次 | 主控不复位、OLED不乱
T18 | 连续运行 | 完整系统运行30分钟 | 无死机和异常发热

## 10.3 常见故障快速定位

现象 | 优先检查 | 处理方法
电机一启动主控复位 | 5V压降、共地不良、电机噪声 | 分离供电回路；加大电容；缩短电源线；降低加速斜率
RC522偶发读不到卡 | 3.3V不稳、SPI线过长、靠近金属 | 缩短信号线；增加去耦；远离电池/金属
OLED乱码或死机 | I2C时序、地址、供电干扰 | 降到100 kHz；检查上拉和刷新频率
超声波距离跳变 | 桶壁反射、安装倾斜、测量过快 | 调整朝向；增加滤波；间隔≥60 ms
火焰传感器误报 | 阳光、灯光、阈值过敏 | 遮光；重新标定；增加持续时间和温度佐证
舵机抖动 | 电源不足、PWM不稳、机构顶死 | 独立5V；加电容；重新设端点；减小连杆阻力
小车向一侧偏 | 电机差异、轮胎阻力、结构偏心 | 校正基础占空比；检查轮组；调整重心
循迹频繁丢线 | 高度不对、阈值不一、速度过快 | 逐路标定；调高度；降低速度；优化路线
Flash数据损坏 | 写入时掉电、地址错误 | 增加校验；写前停车；确认存储页与程序不重叠
蓝牙有显示但不动作 | 权限状态不对、TX/RX接反、协议不一致 | 看回执；确认管理员状态和波特率

# 11 17周实施进度安排

使用方法：下表以任务书的17周节奏编排，计划完成日期不晚于2026年12月31日。若教学周日期不同，可整体平移，但里程碑顺序不要改变。

周期 | 主要工作 | 必须产出
第1周 | 确认题目、阅读任务书、冻结主线功能 | 需求表、演示流程
第2周 | 查资料、画总体框图、确定状态机 | 方案设计稿
第3周 | 完成BOM、引脚表、电源预算和采购 | 选型表、采购单
第4周 | 主控、OLED、按键和日志基线 | M0通过
第5周 | 超声波、火焰、温度独立驱动 | 传感器原始数据
第6周 | 舵机桶盖、投放红外、蜂鸣器 | 静态桶功能
第7周 | RC522用户/管理员识别 | 卡片角色表
第8周 | 积分规则与Flash保存 | M2通过
第9周 | SolidWorks零件和第一版装配体 | 零件、装配体、爆炸图
第10周 | TB6612、电机、底盘与急停 | M3通过
第11周 | HC-05协议与管理员遥控 | 遥控和超时停车
第12周 | 五路循迹、终点和丢线处理 | M4通过
第13周 | 满载自动返回和总状态机 | M5通过
第14周 | 完整结构装配、线束整理 | M6通过
第15周 | 标定、异常测试、30分钟耐久 | 测试记录和问题清单
第16周 | 撰写报告、录制视频、制作PPT | 提交包初版
第17周 | 最终检查、演练答辩、备份提交 | M7通过并提交

## 11.1 每周固定复盘

序号 | 检查项目 | 记录
1 | 本周计划功能是否有可重复演示的视频或测试记录。 | 未检/通过/整改
2 | 接线图、引脚表和代码是否随变更同步更新。 | 未检/通过/整改
3 | 是否出现范围膨胀；新增功能是否影响主线进度。 | 未检/通过/整改
4 | 是否保留一个可运行的稳定版本。 | 未检/通过/整改
5 | 下周所需物料、加工件和场地是否已经准备。 | 未检/通过/整改
6 | 当前最大风险是否有负责人、截止时间和备选方案。 | 未检/通过/整改

# 12 报告、视频、PPT与最终提交

## 12.1 课程设计报告建议目录

1. 绪论。项目背景、需求和设计意义。
2. 总体方案。系统框图、功能划分、方案比较与最终选择。
3. 机械结构设计。SolidWorks零件、装配体、爆炸图、关键尺寸和干涉检查。
4. 硬件设计。电源、主控、传感器、驱动、显示、通信和引脚分配。
5. 软件设计。工程结构、任务调度、状态机、各模块流程图与关键代码。
6. 系统调试。模块测试、联调过程、标定数据、问题及解决方法。
7. 结果与分析。验收矩阵、实物照片、演示结果和不足。
8. 总结与展望。完成情况、个人收获和可选升级方向。
9. 附录。完整接线表、BOM、蓝牙协议、关键源代码和测试记录。

## 12.2 成果视频脚本（约4分钟）

时间 | 内容 | 画面重点
0:00~0:15 | 标题、姓名、项目目标 | 正面整机
0:15~0:45 | 展示主控、传感器、底盘和结构 | 爆炸图+实物特写
0:45~1:30 | 用户刷卡、开盖、投放、积分增加 | OLED清晰入镜
1:30~2:10 | 管理员刷卡和蓝牙遥控 | 手机命令与小车同框
2:10~2:50 | 模拟满载后自动循迹到回收点 | 完整路线连续镜头
2:50~3:25 | 模拟火情：停车、关盖、报警 | 强调安全模拟
3:25~4:00 | 总结要求覆盖、创新点和不足 | 整机与测试表

## 12.3 答辩PPT建议结构

- 第1页：题目、成员、指导教师。
- 第2页：任务要求和完成情况总览。
- 第3页：总体方案框图与状态机。
- 第4页：SolidWorks结构与爆炸图。
- 第5页：硬件框图、电源树和实物接线。
- 第6页：软件架构和调度周期。
- 第7页：RFID积分与用户/管理员流程。
- 第8页：循迹、满载返回和安全策略。
- 第9页：测试数据、故障解决和成果视频。
- 第10页：创新点、不足和改进方向。

## 12.4 最终目录与文件命名

提交包/
01_课程设计报告_学号_姓名.docx
02_源程序_SmartBin_F103.zip
03_成果视频_学号_姓名.mp4
04_答辩PPT_学号_姓名.pptx
05_SolidWorks模型与工程图.zip
06_BOM_接线表_测试记录.xlsx或pdf
README.txt

## 12.5 最终提交前检查

序号 | 检查项目 | 记录
1 | 报告中的题目、姓名、学号、专业班级信息完整且一致。 | 未检/通过/整改
2 | 报告图片清晰，图号、表号和引用对应。 | 未检/通过/整改
3 | 源程序可以在另一台电脑重新编译，没有绝对路径依赖。 | 未检/通过/整改
4 | README写明开发环境、接线、编译和演示步骤。 | 未检/通过/整改
5 | 视频声音清晰，关键OLED状态和小车动作可见。 | 未检/通过/整改
6 | PPT控制在规定时长内，已完成至少两次答辩演练。 | 未检/通过/整改
7 | SolidWorks文件包含零件、装配体、爆炸图和工程图。 | 未检/通过/整改
8 | 所有文件按老师要求命名，并在本地和网盘各备份一份。 | 未检/通过/整改

# 13 风险清单与每日执行模板

## 13.1 主要风险与预案

风险 | 等级 | 表现 | 预防 | 备选
电源不足 | 高 | 电机/舵机动作时复位 | 独立降压、加电容、斜坡控制 | 先完成电源压力测试
I/O或定时器冲突 | 高 | 模块无法同时运行 | 严格按引脚表和CubeMX检查 | 必要时升级F103RCT6
机械连杆卡死 | 中高 | 舵机堵转、烧毁 | SolidWorks限位+实物脱载调试 | 调整支点、缩短连杆或改用DS3218
循迹不稳定 | 中高 | 答辩演示失败 | 降低速度、放宽路线、逐路标定 | 保留管理员遥控兜底
RFID靠近金属失效 | 中 | 刷卡距离短 | 前面板塑料隔离、远离电池 | 调整读卡区位置
范围膨胀 | 高 | 主线未完成 | 冻结第一版功能 | 可选功能延后
数据未保存 | 中 | 断电后积分丢失 | Flash校验和断电测试 | 演示前导出默认数据
演示火源不安全 | 高 | 人员和设备风险 | 只做安全模拟和声光报警 | 使用测试按钮注入火情
文件丢失 | 中 | 无法提交或回退 | 每日备份、里程碑压缩包 | 本地+云端双备份

## 13.2 每日调试记录模板

字段 | 记录内容
日期/版本 | ____________________________
今日目标 | ____________________________________________________________
硬件变更 | ____________________________________________________________
软件变更 | ____________________________________________________________
测试条件 | ____________________________________________________________
实际结果 | ____________________________________________________________
问题复现步骤 | ____________________________________________________________
原因判断 | ____________________________________________________________
处理与验证 | ____________________________________________________________
下一步 | ____________________________________________________________

## 13.3 今天即可开始的第一批操作

1. 建立项目文件夹和版本库。把任务书、模型图、资料、代码和报告分目录保存。
2. 按BOM确认已有器件。标记已有、待购和型号不确定三类。
3. 下载模块规格资料。优先RC522、TB6612、OLED、DS3218舵机和N20电机尺寸。
4. 在CubeMX建立主控基线。完成72 MHz、SWD、LED/OLED和安全GPIO初始值。
5. 用卡尺测量关键器件。建立SolidWorks第一版底盘和桶体参数。
6. 打印本手册的M0~M2检查项。按里程碑执行，不同时连接全部模块。

完成定义：当M7验收通过，报告、源程序、视频、PPT和SolidWorks文件均可独立打开，并且整机能按演示脚本连续完成用户投放、管理员遥控、满载返回和火情保护时，本课程设计才算真正落地。

编制依据：24级嵌入式系统课程设计任务书（发出日期：2026年8月21日）。

STM32智能移动垃圾桶 全过程实施手册
