Sylphiette666/stm32-rfid-smart-bin/archive/README.md

# 历史资料

`earlier-plans/`保存较早的课设手册和中型方案采购表；`folded-pp-liner/`保存之前的折叠内胆图。它们用于追溯方案变化。

当前制作请优先阅读 `docs/manual/`。旧采购价格、旧尺寸及旧内胆方案不自动适用于2026年10月10日装配版。
