Sylphiette666/stm32-rfid-smart-bin/archive/earlier-plans/基于STM32的RFID积分式智能移动垃圾桶_全过程实施手册_双课设修订版.docx

嵌入式系统与RFID课程设计实施手册

# 基于STM32的RFID积分式

# 智能移动垃圾桶

用户积分 标签读写 移动回收 结构装配 分阶段验收

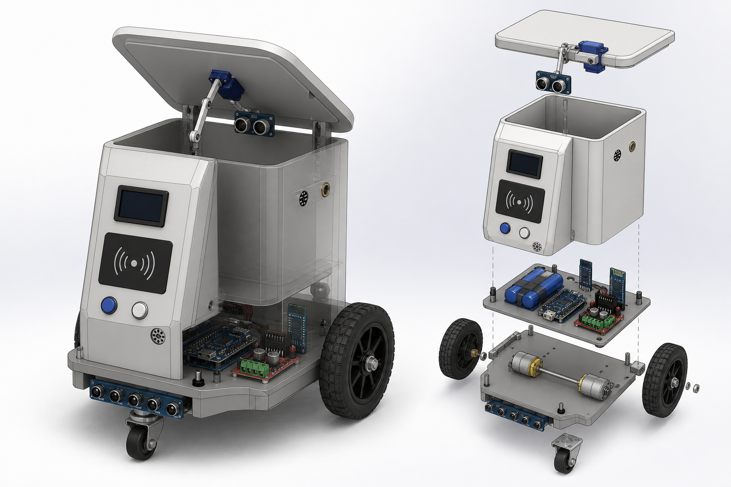
[picture p9: figure]
智能移动垃圾桶SolidWorks风格装配体概念图

装配体概念演示图（用于结构规划，实际尺寸以实物测量为准）

版本 V2.0　修订日期 2026年9月23日

姓名：____________ 学号：____________ 专业班级：____________

# 使用说明

实施顺序：先完成静态投放与积分，再调通管理员遥控，最后接入限定路线上的满载循迹回收。每个模块先独立测试，达到本章验收标准后再接入总系统。

本手册用于搭建和验证一台单桶教学样机。RFID识别投放者并关联积分；红外对射确认通道内物体经过；主控负责桶盖、报警、底盘和数据保存。积分按一次有效投放周期增加1分，不根据垃圾类别或重量计算。

- 投放主线：验证用户卡与应用数据 → 显示积分 → 按键开盖 → 确认物体通过 → 关盖到位 → 提交积分 → 显示结果。
- 移动主线：管理员授权后进行蓝牙遥控；垃圾桶满载且已在指定起点就位、路线有效时，沿预设黑线驶往回收点。离线时停留等待管理员处理。
- 故障处理：急停优先切断执行器动力，火情告警优先禁能底盘；任何关盖动作均遵守夹口检测与机构联锁。报警用于教学验证，不作为消防设备使用。
- 课程覆盖：超声波、温度、火焰和红外等传感器采集；舵机、电机和声光输出；外部中断、串口、OLED及RFID。两门课分别保留报告和实验记录，共享系统实物与基础代码。

本版将投放对射、关盖到位与夹口检测纳入基础硬件；调整舵机和超声波的定时器分配；积分使用双页提交；自动返回采用明确起点与终点。原装配概念图只表达布局，接线和尺寸以本版表格及实测结果为准。

序号 | 检查项目 | 记录
1 | 已明确题目、功能边界与演示流程。 | 未检/通过/整改
2 | 已完成总体框图、引脚表、电源树和BOM。 | 未检/通过/整改
3 | 已完成SolidWorks装配体、干涉检查和主要加工图。 | 未检/通过/整改
4 | 所有模块均有独立测试记录。 | 未检/通过/整改
5 | 总系统已通过异常、断电、连续运行测试。 | 未检/通过/整改
6 | 报告、源程序、视频和答辩PPT均已归档。 | 未检/通过/整改

# 1 项目任务 范围与验收目标

## 1.1 把任务书转换成工程要求

先把两门课程的任务要求写入验收矩阵。嵌入式部分依据同目录的《24级嵌入式系统课程设计任务书》；RFID部分按卡片协议、认证读写、身份管理和读写性能实验组织，并在开题时对照实际RFID课程任务逐项落实。

任务要求 | 本方案实现 | 验收口径
STM32主控 | STM32F103C8T6与板级可用引脚核对 | 保留SWD，程序不覆盖2 KiB账本区
满载监测 | 闭盖后超声测距与有效性判断 | 连续3秒确认；开盖和无回波不误判
火情监测 | 火焰ADC与DS18B20联合分级 | 预警、锁存、断线分开；仅安全注入演示
桶盖控制 | 按键、舵机、闭盖开关和夹口检测 | 到位后方可移动；受阻不强制关闭
自动循迹 | 五路阵列与双电机差速 | 限定起点和路线，到回收点停车
无线遥控 | HC-05与USART1 | 管理员授权，失联≤1秒禁能
RFID与积分 | 认证、应用块读写、绑定及双页账本 | 一周期最多+1；成功提交后断电保留
传感器采集 | 超声、火焰、温度、红外 | 至少三类有原始数据和标定记录
OLED与输出 | OLED、舵机、电机、声光提示 | 模式、积分、满载及故障清晰可见
中断与串口 | 按键/对射EXTI、串口接收、回波捕获 | ISR短，任务执行时间有记录

## 1.2 冻结第一版功能边界

第一版采用单桶、刷用户卡和固定积分规则，保留管理员遥控与满载循迹回收。卡片不用于识别垃圾材料；自动返回限于预先铺设且已标定的路线。

- 必做功能：满载检测、火情告警、按键开关盖、关盖到位和夹口检测、投放对射、OLED、管理员蓝牙遥控、限定路线循迹、RFID卡片认证读写、用户与管理员管理、积分掉电保存。
- 可选增强：电池电压采样、编码器速度闭环、外部日志存储、管理员导出数据或清零积分。增加前同步更新BOM、引脚表、数据格式和测试项。
- 范围外：真实灭火、自动充电、视觉分类、任意位置自主导航、云平台和真实支付。基础版采用经测试的手机蓝牙终端，不开发手机App。

## 1.3 设计成功的量化标准

验收对象 | 设计目标与通过标准
开机 | 5秒内完成自检；无有效账本进入明确维护/故障界面，执行器不误动
RFID | 在标定距离内连续20次读取至少19次成功；认证读写、未登记和注销测试通过
桶盖 | 连续开合50次；遮挡、不到位和断线可识别；未关到位不移动
满载 | 有效低距离持续3秒才确认；短遮挡、开盖、过期样本不触发返回
积分 | 空投+0；同周期最多+1；用户归属固定；提交成功后掉电保持
蓝牙 | 实测可靠距离并记录手机型号；400 ms保持超时，≤1秒禁能；Q不能维持运动
循迹 | 指定起点到回收点连续成功3次，均能停车；离线满载保持等待
火情与急停 | 测试注入告警并禁能；硬件急停独立切断动力；受阻时不强制关盖
耐久与电源 | 连续运行30分钟无死机、复位、异常温升；测量峰值及停车距离
掉电提交 | 擦备用页、数据、CRC、commit前后各至少5次故障注入，恢复完整旧/新账本

## 1.4 两门课的成果分工

课程 | 报告建议题名 | 独立验收证据
嵌入式 | 基于STM32的RFID积分式智能移动垃圾桶设计 | 传感器原始数据、定时器配置、联锁状态机、遥控与循迹、结构图和综合测试
RFID | 基于HF RFID的智能垃圾投放身份与积分管理系统设计 | 寻卡选卡、认证读写、卡片编码、登记注销、距离姿态测试和积分一致性实验

两份报告分别解释各自的设计与实验，共用硬件框图和必要接口资料。任务书要求、项目自定目标及实际测试结果分开记录；RFID实验数据不能用读取UID的截图代替。

# 2 总体方案设计与系统逻辑

## 2.1 系统分层

层级 | 组成 | 输出
机械层 | 桶体、桶盖、舵机连杆、底盘、轮组、电子仓、传感器支架 | SolidWorks模型及实物结构
供电层 | 2S保护电池、匹配充电器、逻辑与执行器分支、硬件急停、稳压与滤波 | 额定范围和实测电源记录
输入层 | 超声、火焰、温度、投放对射、夹口检测、到位开关、循迹、按键、RFID | 原始数据、有效性与时间戳
控制层 | 驱动、限时调度、联锁、身份验证、双页账本 | 状态决策和持久化结果
执行层 | 舵机、双电机、蜂鸣器、状态LED | 物理动作
交互层 | OLED、蓝牙串口、用户卡、管理员卡 | 显示、授权和人工控制

## 2.2 核心业务流程

上电自检与账本恢复 → 待机 → 用户卡验证 → 30秒开盖授权 → 按键开盖 → 有效投放 → 夹口清空 → 关盖到位 → 积分提交成功 → 显示积分并退出会话。
满载：停止接收新投放；已开始的周期先完成闭盖和结算，再检查路线条件。未就位则FULL_WAIT等待；允许返回则AUTO_RETURN，终点停车后AT_STATION等待清空。
故障：急停、火情或关盖故障均禁止底盘启动；积分存储故障禁止继续计分和建立管理员运动会话。

管理员由主控有效白名单授予权限，不能仅凭卡内自报角色。进入管理员会话时先停车并清空旧指令；允许查询、维护和满足联锁条件的遥控。退出、超时、故障或复位后撤销授权。

## 2.3 状态机设计

状态 | 主要动作 | 退出条件
BOOT | 默认禁能，自检与读取账本 | 正常→IDLE；空白→维护；损坏→STORAGE_ERROR
IDLE | 监测与显示，等待有效刷卡 | 用户→USER_AUTH；管理员→ADMIN_REMOTE
USER_AUTH | 固定用户与事务号，30秒窗口 | 按键→LID_OPENING；超时取消
LID_OPENING | 限速开盖，清空本周期检测 | 标定动作完成→LID_OPEN；异常→LID_FAULT
LID_OPEN | 等待完整通过事件，最多记一次 | 关闭请求→LID_CLOSING
LID_CLOSING | 夹口清空后闭盖，检查到位 | 有效投放→POINT_COMMIT；空投→IDLE
POINT_COMMIT | 冻结前后值，提交并验证快照 | 成功显示结果；失败→STORAGE_ERROR
ROUTE_CONFIRM | K请求后的10秒本机确认窗口 | 长按确认起点，超时/故障/运动取消
ADMIN_REMOTE | 有效会话内维护或遥控 | 退出/超时撤销授权；返回需新会话
FULL_WAIT | 禁止新投放，等待路线就绪 | 确认起点与联锁→AUTO_RETURN
AUTO_RETURN | 低速循迹，监测线路和终点 | 终点→AT_STATION；丢线→ERROR
AT_STATION | 停车锁定，等待清空 | 管理员确认且测距恢复→IDLE
FIRE | 锁存报警，底盘禁能，关盖受联锁 | 恢复条件全部满足且管理员确认
ESTOP | 硬件切断动力，不启动任何动作 | 释放并确认；重新授权才可运动
LID_FAULT | 机构或反馈异常，禁止运动与结算 | 排除问题后本地维护确认
STORAGE_ERROR | 停止业务写入和运动授权 | 导出/修复/明确重新初始化
ERROR | 禁能并显示故障原因 | 排除后确认，回IDLE且不续旧命令

急停、火情、夹口遮挡和故障采用独立标志，可同时存在。运动许可由统一函数计算，任何一个禁止条件都能关闭电机输出。满载只阻止新投放和普通移动；用户周期内先置full_pending，禁止直接从开盖状态启动循迹。FULL_WAIT保留经授权的低速找回路线操作。

统一运动许可示意：motor_enable = mode_allows_motion && lid_closed && throat_clear && !estop && !fire && !critical_fault && !point_commit。AUTO_RETURN另需route_ready与有效循迹；REMOTE另需管理员会话和新鲜方向命令。硬件急停无需等待该表达式执行。

FIRE、ESTOP和LID_FAULT仍可读取有效管理员卡用于本地维护确认，但不授予运动权限。故障恢复与运动启动是两个操作，确认后仍保持停车。

## 2.4 软件任务周期

触发或周期 | 任务 | 实现要求
硬件即时 | 急停断开执行器动力 | 独立于主循环与Flash忙状态
边沿中断 | 投放、夹口、到位、按键、回波 | 记录时间戳/电平或置标志
1 ms | 时基和软件计时 | 无耗时外设操作
≤10 ms | 安全联锁、运动看门狗、协议解析、循迹 | 限量处理；不被整屏刷新阻塞
20～50 ms | 按键消抖、火焰滤波、业务状态 | 最终周期通过最坏耗时测量确认
100 ms发起 | 超声测距 | 输入捕获；30 ms超时；仅闭盖后判满
约1 s更新 | 温度转换与读取 | 分步等待，12位最多750 ms，校验CRC
100～200 ms | RFID服务 | 每次调用有超时；忙时不更换当前用户
200～500 ms | 完成一次OLED画面更新 | 分块或异步发送，显示故障与无效值
事务事件 | 双页Flash提交 | 停止执行器且闭盖后执行，成功才提示加分

# 3 物料 工具与采购准备

## 3.1 核心BOM

类别 | 器件 | 数量 | 接口或电源 | 选型要求
主控 | STM32F103C8T6板 | 1 | 3.3 V逻辑 | 核对PC13～15板图，64 KiB Flash
下载 | ST-Link | 1 | SWD | 保留PA13/14，核对供电路径
显示 | 0.96英寸OLED | 1 | I2C 3.3 V | 上拉至3.3 V，按实物地址
RFID | RC522 | 1 | SPI 3.3 V | 兼容指定卡型，远离金属
卡片 | MIFARE Classic 1K教学卡 | ≥4 | 13.56 MHz | 2用户、1管理员、1实验备用
通信 | HC-05底板 | 1 | USART | 核对底板供电、IO及手机兼容性
满载 | HC-SR04 | 1 | 5 V Trig/Echo | Echo分压，采购件资料归档
火情 | 火焰模块 | 1 | ADC | 模拟输出不得超过VDDA
温度 | DS18B20 | 1 | 3线外部供电 | DQ上拉约4.7 kΩ至3.3 V
投放 | 红外对射 | 1组 | GPIO EXTI | 必选；通道保证物体经过
夹口 | 独立障碍检测模块 | 1组 | GPIO | 覆盖夹口，核对输出电平
盖反馈 | 关盖到位开关 | 1 | GPIO | 未到位或断线禁止移动
循迹 | 五路红外阵列 | 1 | 5路GPIO | 可逐路标定，输出兼容3.3 V
桶盖 | 与实际盖重匹配的舵机 | 1 | 独立5 V或额定电源 | 按最差力矩选择，SG90/MG90S不作默认保证
驱动 | TB6612FNG板 | 1 | VCC 3.3 V与独立VM | 核对堵转电流、散热、STBY下拉
运动 | 同规格直流减速电机 | 2 | 匹配额定电压 | 记录堵转电流与轮径
底盘 | 轮组 万向轮 底板 | 1套 | 机械 | 匹配质量、重心与路线
报警 | 有源蜂鸣器 红LED 驱动管 | 各1 | PB8控制 | LED限流，GPIO不直带大负载
按键 | 开盖/模式按键 | 1 | PC13输入 | 长短按区分，核对板载LED
急停 | 动力触点及独立辅助触点 | 1套 | 切断执行器支路 | 额定DC电压电流满足启动峰值
电池 | 匹配保护板的2S电池组与充电器 | 1套 | 满充8.4 V | 封装固定，逻辑与动力分支
稳压 | 逻辑与舵机降压模块 | 按电源树 | 5 V等 | 按连续负载和峰值核验；电机必要时另降压
电平与滤波 | 电阻 电容 保险 接插件 | 若干 | 电气 | 含Echo分压、STBY下拉与去耦
结构 | 轻质桶盖 桶体 支架 | 按图 | 机械 | 先纸板/薄壁样机，再加工

## 3.2 必备工具和软件

类别 | 工具 | 用途
机械测量 | 游标卡尺、直尺、角尺 | 测量模块孔距和安装空间
装配加工 | 螺丝刀、手钻/激光切割/3D打印、锉刀 | 制作支架与开孔
焊接 | 恒温烙铁、焊锡、助焊剂、热缩管 | 制作可靠线束
测量 | 数字万用表 | 每次上电前检查短路与电压
调试 | USB-TTL、串口助手 | 查看日志和测试HC-05
开发 | STM32CubeMX+Keil MDK或STM32CubeIDE | 工程生成和编译
建模 | SolidWorks | 零件、装配体、工程图、爆炸图
可选仪器 | 示波器/逻辑分析仪/可调电源 | 定位PWM、串口和电源干扰

## 3.3 采购前必须完成的操作

1. 先确认开发板板图与实际焊接情况，再冻结电机、驱动、舵机、卡片和电源。按第5.2节核对PC13板载LED及PC14/PC15的LSE晶振占用；不满足时先更换板型或重新分配，不能仅改CubeMX设置后照接。
2. 下载模块尺寸图。若商家没有准确图纸，先购买关键件并用卡尺实测。
3. 完成引脚与存储预算：保留SWD；舵机、回波计时、电机PWM使用独立定时器；C8按64 KiB Flash配置，最后两页留给积分账本。先生成工程、编译并核查map文件，再制作固定线束。
4. 完成电源预算：记录2S电池满充8.4 V、每路电机堵转电流、舵机动作峰值、逻辑负载及各模块额定值。DC-DC连续和峰值能力均须覆盖实测工况并留余量；不能用峰值宣传值替代持续能力。
5. 分批采购。第一批买主控和传感器；第二批在静态功能通过后再确定机械加工件。

# 4 SolidWorks结构设计与实物装配

## 4.1 建模前的尺寸基线

下表是原型布局起点，不是加工定稿。先做轻质样机、称量桶盖、测模块孔位，再冻结材料与尺寸。整机只装干燥轻质演示物，保持电池和电子仓与投放仓隔离。

舵机选型先计算盖体关于铰链的最大重力矩τ=m·g·l，再考虑连杆全行程传动比、摩擦与余量。薄壁盖必须称重验证；不能根据桶盖外形或“金属齿”名称直接指定SG90/MG90S。

对象 | 建议初始尺寸 | 设计说明
整机外廓 | 约260×220×380 mm | 控制在桌面演示可搬运范围
底盘 | 260×220×4 mm | 四角圆角8~12 mm
电子安装板 | 215×170×3 mm | 与底盘间用20 mm铜柱
桶体外廓 | 210×170×255 mm | 壁厚约2~3 mm
桶盖 | 外廓约225×185 mm 薄壁 | 厚度按材料与加强筋确定，称重后选舵机
轮子 | 直径约85 mm，宽约25 mm | 与桶体保持至少8 mm间隙
前面板 | 约130×155 mm | 容纳OLED、RFID、按键和蜂鸣孔
循迹高度 | 传感器距地5~10 mm | 设计长圆孔便于调高
电子仓净高 | 不低于35 mm | 避免电池和模块顶碰桶体

图4-1 装配体及爆炸视图概念参考

## 4.2 建立SolidWorks项目

1. 建立项目目录。创建01_Parts、02_Assembly、03_Drawings、04_STEP_STL、05_Render五个文件夹。
2. 设置单位。统一使用MMGS（毫米、克、秒），文档属性中设置尺寸精度0.1 mm。
3. 建立全局参数。用方程式统一管理底盘长宽、桶体长宽高、壁厚、孔距和间隙。
4. 确定原点。底盘中心作为总装配原点，车头方向设为X正方向，向上为Z正方向。
5. 建立命名规则。零件使用P01_Chassis、P02_Bin、P03_Lid；装配体使用A00_SmartBin。

## 4.3 逐个建立主要零件

零件 | 主要建模操作 | 完成检查
P01 底盘 | 中心矩形草图→拉伸4 mm→圆角→电机/铜柱/万向轮孔→减重孔 | 孔位对称，轮胎不碰桶体
P02 电子板 | 矩形拉伸3 mm→主控/驱动/电池长圆孔→理线孔 | 模块可拆，不用胶永久固定
P03 桶体 | 外轮廓拉伸→抽壳2~3 mm→桶口圆角→前面板安装面 | 内部无尖角卡垃圾袋
P04 前面板 | 斜面或竖直面→OLED窗→RFID平面→按键孔→蜂鸣器阵列孔 | RFID背后远离金属和电池
P05 桶盖 | 薄壁或轻质板→局部加强→定位边→铰链耳 | 有止挡/防落，质量与舵机力矩匹配
P06 舵机架 | 按实测舵机尺寸建槽→耳板孔→连杆转轴孔 | 保留拆装螺钉空间
P07 超声与反馈支架 | 定位孔→固定面→关盖开关和夹口支架 | 闭盖后声路正确，夹口检测不受桶袋遮挡
P08 循迹架 | 横梁→五路板固定孔→上下可调长圆孔 | 传感器面与地面平行
P09 轮/轴简模 | 按直径和轴孔简化建模 | 用于干涉和离地间隙检查
P10 电池托架 | 电池外廓+0.5~1 mm间隙→束带槽 | 可取出充电并防止滑动

## 4.4 建立装配体和运动关系

1. 固定底盘。将P01_Chassis插入A00_SmartBin并固定在装配体原点。
2. 装配电机与轮组。轴线同心、端面重合；左右轮距保持对称。
3. 装配万向轮。检查三点接地，保证整机在水平面不摇晃。
4. 装配电子板和桶体。使用距离配合模拟铜柱，检查螺丝刀操作空间。
5. 装配桶盖铰链。设置关闭与打开角度限位，打开约75°仅作初值；检查断电时盖体不会突然砸落，必要时使用弹簧平衡或阻尼。
6. 装配舵机连杆。计算全行程最差位置的负载力矩，避开死点；选型余量同时覆盖盖重、摩擦和连杆传动损失。舵机金属齿不等于输出力矩足够。
7. 装配外部面板。检查OLED视角、刷卡手势、按键间距和线束弯曲半径。
8. 装配传感器。超声波固定在闭盖时朝向桶内的位置；投放对射布置在受控通道，夹口检测覆盖闭合危险区域，关盖开关能被可靠触发。循迹阵列朝地，温度与火焰模块留出观测位置。
9. 执行干涉检查。重点检查轮胎、桶体、舵机连杆、桶盖和线束通道。
10. 建立爆炸视图。按桶盖→桶体→电子板→底盘→轮组顺序展开，用于报告和答辩。

## 4.5 输出工程文件

- 零件工程图：标注外形、孔径、孔距、板厚、圆角和材料。
- 装配工程图：包含主视图、俯视图、轴测图、爆炸图和序号气泡。
- 加工文件：激光切割输出DXF；3D打印输出STL；跨软件交换输出STEP。
- 版本归档：每次结构变更提升版本号，不覆盖已用于加工的文件。

序号 | 检查项目 | 记录
1 | 总装配无红色报错、无欠定义的关键安装件。 | 未检/通过/整改
2 | 桶盖可在限定角度内运动且不穿模。 | 未检/通过/整改
3 | 轮胎、桶体、电子板和线束通道无干涉。 | 未检/通过/整改
4 | 所有真实器件均有可拆卸固定方式。 | 未检/通过/整改
5 | 电池、开关、下载口和USB/串口接口可在装配后访问。 | 未检/通过/整改
6 | 已导出爆炸图、关键尺寸工程图和加工文件。 | 未检/通过/整改

## 4.6 实物装配顺序

1. 先做纸板/泡沫板样机。验证总体体积、桶盖运动和刷卡位置，不急于最终加工。
2. 安装底盘运动件。装电机、轮子和万向轮，手推检查是否顺畅。
3. 安装电源与总开关。先断开负载，测电池端电压、各降压输出和极性；电机支路按实际额定电压设置，2S满充端可能达到8.4 V。
4. 安装电子板。主控与驱动之间留散热和插拔空间，线束分动力与信号两组。
5. 安装桶体和面板。确认重心不偏、RFID无遮挡、显示屏面向观察者。
6. 安装舵机与桶盖。断电手动检查连杆，再低速上电调角度。
7. 安装传感器并调位置。最后固定超声波、火焰、温度、投放和循迹模块。

# 5 电气设计 引脚分配与接线

## 5.1 电源树

2S保护电池组（标称7.4 V，满充8.4 V）→ 总开关与匹配保险
逻辑支路 → 稳压5 V → 开发板5 V输入、HC-SR04、允许5 V输入的HC-05底板
逻辑3.3 V → STM32、RC522、OLED、TB6612 VCC及兼容低压传感器
执行器支路 → 额定合适的硬件急停开关 → 电机匹配电源 → TB6612 VM
执行器支路 → 硬件急停开关 → 独立5 V降压 → 舵机
各信号地共地，动力回流独立布线。低压电机增加匹配降压，不能默认2S直供。

接线限制：电机与舵机不从主控3.3 V引脚取电；5 V输出先做电平转换再接入不兼容的IO；USB与外部5 V是否可同时接入以开发板电源路径为准。BMS提供保护，不替代匹配的2S充电器。

- TB6612：VCC接3.3 V逻辑电源，VM接匹配电机的动力电源；在芯片供电脚附近按参考电路布置小容量去耦，驱动入口增加约470 μF储能电容。选驱动时核对堵转电流、散热和短脉冲限制。[6]
- 舵机与逻辑分别供电或至少分支布线。5 V/3 A仅为初选，需验证实际峰值和降压温升；舵机附近可加470～1000 μF电容，电容不能补偿电源长期过载。
- 3.3 V侧：核对板载稳压器余量；RC522和OLED电源附近去耦，I2C上拉到3.3 V。火焰ADC、对射、循迹阵列及HC-05信号电平逐项测量，不根据供电标注推断IO电平。
- 接地：优先星形接地，电机大电流回路不要经过传感器地线。
- 急停采用能承受执行器工作与启动电流的硬件断开方案，切断电机和舵机动力支路，保留逻辑供电以显示故障；独立辅助触点接PC14。只有GPIO按键的台架版本应称“软件停止”。急停后仍可能因惯性移动，必须测停车距离。

## 5.2 推荐引脚分配 STM32F103C8T6

模块或信号 | STM32引脚 | 外设 | 接线与条件
OLED SCL/SDA | PB10/PB11 | I2C2 | 上拉3.3 V，先100 kHz
RC522 NSS/SCK/MISO/MOSI | PA4/PA5/PA6/PA7 | SPI1 | 3.3 V供电及逻辑
RC522 RST | PB0 | GPIO输出 | 有效复位后再寻卡
HC-05 TX/RX | PA10/PA9 | USART1 RX/TX | 交叉连接，8N1
舵机信号 | PA8 | TIM1_CH1 PWM | 50 Hz，脉宽实测标定
超声波Echo | PA1 | TIM2_CH2捕获 | 10 kΩ/15 kΩ分压到约3 V
超声波Trig | PA2 | GPIO输出 | 高脉冲至少10 μs
DS18B20 DQ | PA3 | 1-Wire GPIO | 4.7 kΩ上拉3.3 V
火焰模拟量 | PB1 | ADC1_IN9 | 输出不超过VDDA
投放对射 | PB5 | EXTI5双边沿 | 记录通过脉冲，必选
电机PWMA/PWMB | PB6/PB7 | TIM4_CH1/CH2 | 20 kHz，占空比默认0
电机方向 | PB12～PB15 | GPIO输出 | AIN1/2、BIN1/2
TB6612 STBY | PA0 | GPIO输出 | 外部下拉，默认禁能
五路循迹 | PA11/PA12/PA15/PB3/PB4 | GPIO输入 | 不启USB，关闭JTAG保留SWD
蜂鸣器与报警LED | PB8 | GPIO输出 | 经驱动管与LED限流
闭盖到位 | PB9 | GPIO/EXTI9 | 断线按未到位处理
开盖/模式键 | PC13 | GPIO/EXTI13 | 输入，先核对板载LED
急停辅助触点 | PC14 | GPIO/EXTI14 | 输入，板上不得占用LSE
独立夹口检测 | PC15 | GPIO/EXTI15 | 输入，板上不得占用LSE
下载调试 | PA13/PA14 | SWDIO/SWCLK | 始终保留

板级前提：PA15/PB3/PB4需关闭JTAG、保留SWD；PA11/PA12作循迹输入时不启用USB。PC14/PC15不得连接LSE晶振及负载，PC13须核对板载LED影响；它们在本表均只作输入。表中引脚在实板不可用时，采购阶段更换更多引脚开发板并重做分配。

信号基线：STBY另加约10 kΩ下拉，上电及复位默认禁能。PB8通过合适三极管或MOSFET驱动蜂鸣器和LED；LED串限流电阻。PC13～PC15不承担驱动电流。[1]

急停接法：额定合适的常闭动力触点串入执行器正电源支路，辅助触点接PC14与GND并上拉到3.3 V，断开时锁存故障。禁止把推挽输出为高的STBY控制脚直接短路到地。若采用STBY门控，须另画门控电路并验证失效状态。

闭盖开关接PB9并上拉到3.3 V，仅到位时产生确认电平，断线按未到位处理。PC15夹口模块应在正常时持续输出有效电平，并配外部偏置，使开路或失电进入遮挡/无效状态；无效时禁止关闭和移动。逐项测试上电、断线和失电，不满足此逻辑的模块更换型号。

## 5.3 各模块接线操作

1. 先接主控最小系统。ST-Link仅连接SWD、地和正确的目标电压参考；供电只使用已核对的一路电源。下载基础程序并稳定运行10分钟，避免ST-Link、USB和外部5 V未经确认并联。
2. 接OLED。确认VCC电压和I2C地址；只显示固定字符，不接其他模块。
3. 接RC522。使用3.3 V电源和逻辑，SPI线短且有完整地线；先读版本寄存器，再验证完整UID、卡类型及应用块认证读写。[4][5]
4. 接HC-05。模块TX→PA10、模块RX←PA9；先确认所购底板供电范围、IO电平、数据模式波特率及手机终端兼容性。
5. 接超声波。Echo→10 kΩ→PA1，PA1→15 kΩ→GND；5 V输入时分压约3.0 V。用万用表或示波器确认实际高电平在PA1允许范围内，随后测固定平面距离。
6. 接火焰和温度。单独观察原始ADC和温度值，暂不启用报警。
7. 接投放对射、独立夹口检测、关盖到位和按键。确认各自正常/触发电平；优先把到位与急停辅助触点设计成断线可检测的闭合回路，并验证断线后的故障动作。
8. 接舵机。舵机单独5V供电、与主控共地；先卸下连杆调中位。
9. 接TB6612和电机。STBY由PA0控制并加外部下拉；先切断动力、验证逻辑，再架空测试轮组。STBY低表示驱动高阻禁能，不能把它等同于机械瞬时刹停。
10. 接循迹模块。逐路查看黑/白电平，调整每路电位器并记录极性。

## 5.4 首次上电检查

序号 | 检查项目 | 记录
1 | 电池正负与各电源轨无明显短路；电机电压兼容2S满充或已有降压 | 未检/通过/整改
2 | 逻辑、舵机和电机各支路电压与极性正确，峰值能力有依据 | 未检/通过/整改
3 | RC522、OLED和TB6612 VCC为3.3 V；所有输入已核对电平 | 未检/通过/整改
4 | Echo分压方向正确；模拟输入不超过VDDA | 未检/通过/整改
5 | PC13板载负载、PC14/15晶振占用已按实板检查 | 未检/通过/整改
6 | STBY外部下拉，开机/复位/下载时执行器不会误动 | 未检/通过/整改
7 | 硬件急停能独立切断执行器动力；辅助输入可锁存故障 | 未检/通过/整改
8 | 关盖到位和夹口信号已验证正常、触发与断线情况 | 未检/通过/整改
9 | USB、ST-Link与外部供电的并联路径已经确认 | 未检/通过/整改

# 6 固件工程建立与底层配置

## 6.1 CubeMX/IDE工程建立

1. 新建MCU工程。选择STM32F103C8Tx，工程名建议SmartBin_F103。
2. 配置调试。SYS Debug选择Serial Wire；RCC按开发板晶振配置HSE。
3. 配置时钟。系统72 MHz，APB1=36 MHz；当APB预分频不为1时，核对该总线定时器倍频。以下PSC/ARR仅适用于TIM1、TIM2、TIM4计数时钟均为72 MHz的配置。[1][2]
4. 配置GPIO。输出脚设置初始安全电平，尤其STBY、舵机和蜂鸣器。
5. 配置TIM1与TIM2。PA8/TIM1_CH1输出舵机PWM，PSC=71、ARR=19999；TIM2设PSC=71、ARR=65535，PA1/CH2独立捕获Echo。回波超时设为30 ms，跨回绕用无符号16位差值，超时样本标为无效。
6. 配置TIM4。PB6/PB7为CH1/CH2，PSC=0、ARR=3599，频率20 kHz；初始CCR=0且STBY保持低。TIM3预留。
7. 配置SPI1。主机、8位、Mode 0，初始速度不宜过高。
8. 配置I2C2。连接OLED，先用100 kHz保证稳定，再视情况升到400 kHz。
9. 配置USART1。与HC-05保持一致，常用9600 8N1，开启接收中断。
10. 配置ADC1。PB1模拟输入，采样时间适当加长并做多次平均。
11. 配置EXTI。PC13开盖键、PC14急停辅助输入、PB5投放对射、PB9关盖到位、PC15夹口输入按用途设置边沿；PB5双边沿记录时间戳。急停靠硬件切断动力，ISR只采集状态和置标志。
12. 生成工程。选择仅复制必要库，勾选保留用户代码区，立即建立Git或版本备份。

编译检查：保留2 KiB账本区；OLED只带本项目必要字模，避免大字库占满64 KiB。记录Flash与RAM占用和栈余量。启用独立看门狗前先测量Flash最长擦写与正常任务周期，避免写入途中被无条件复位。

## 6.2 推荐代码目录

SmartBin_F103/
Core/Inc, Core/Src CubeMX初始化与main
BSP/ board、delay、timebase
Drivers/OLED 显示驱动
Drivers/RC522 RFID驱动
Drivers/HC_SR04 超声波驱动
Drivers/DS18B20 温度驱动
Drivers/Motor TB6612与电机控制
Drivers/Servo 舵机控制
Drivers/LineSensor 循迹采样
App/app_state.c 状态机
App/app_user.c 用户和积分
App/app_safety.c 满载、火情、急停
App/app_protocol.c 蓝牙协议
Storage/user_store.c Flash数据保存
README.md 编译、接线和演示说明

## 6.3 编程原则

- 主循环采用非阻塞状态机，各服务有执行时间上限。DS18B20转换等待、OLED整屏传输、RFID超时及Flash擦写不可随意阻塞运动控制。Flash仅在执行器停稳后提交。
- 中断简短：串口中断只收字节，按键中断只置事件标志，输入捕获只记录时间。
- 安全默认：复位、故障及运动授权失效时，PWM置0、STBY低，清空运动队列和用户会话。急停释放或蓝牙重连后不自动恢复旧速度。
- 模块解耦：驱动层不直接切换业务状态，状态机只通过接口读取数据和下发动作。
- 输入有效性：每个传感器记录value、valid和last_update_ms。滤波仅使用新鲜有效样本；超声无回波、温度CRC错误、盖未关到位均不能当成正常数据。
- 可观察性：保留状态码、传感器原始值和故障码，OLED或串口至少能看到一种。

while (1) {
Safety_Service(); // 硬件状态、联锁与运动看门狗
Protocol_Service(); // 限量解析，禁止查询维持运动
Sensor_Service(); // 分步处理；不阻塞等待转换
AppState_Run(); // 用户、管理员、满载与结算
Storage_Service(); // 只在停车且盖已关到位时提交
Display_Service(); // 分块刷新，限定单次时间
}

# 7 各功能模块的开发步骤

## 7.1 OLED显示

1. 完成I2C扫描或固定地址测试。常见地址为0x3C，但必须以实物为准。
2. 显示ASCII和中文测试页面。确认字库、坐标、清屏和刷新无乱码。
3. 定义固定页面：模式与故障、满载状态或距离、有效温度、当前用户与积分。单色OLED用文字或反白提示报警，配合独立红色LED；无效读数显示“--/故障”。
4. 采用脏区域或分块刷新，100 kHz下整帧阻塞传输可能拖慢控制。每次服务仅发送小块并设置超时，记录最坏循环耗时；200～500 ms内完成一轮画面更新。

验收：连续刷新10分钟不死机；传感器数值变化时显示不闪烁、不重叠。

## 7.2 按键与外部中断

1. 读取空闲电平。输入上拉时按下为低，先用LED验证。
2. 中断中记录时间和事件。不在回调函数中直接驱动舵机或刷新OLED。
3. 加入20~50 ms消抖。消抖结束后再次读取引脚确认。
4. 按键动作按上下文解释：收到K后进入10秒ROUTE_CONFIRM提示，该状态长按只确认起点；其他普通会话中长按用于退出。短按在当前授权允许时请求开/关盖。超时、运动、故障或退出会话取消待确认请求。满载解除仍需管理员确认及有效测距恢复。
5. 使用带保持机构的硬件急停。触发后切断执行器动力，辅助输入锁存ESTOP，同时清旧电机命令、取消舵机目标并关闭PWM输出。恢复动力前先确认逻辑已进入停机状态；若主控不响应，只能保持断电检修。释放后重新核对盖状态，新授权与明确新操作才能恢复动作，必须实测无旧动作重启。

## 7.3 舵机与桶盖

1. 舵机脱离连杆上电。先输出1.5 ms中位，防止突然转动撞坏机构。
2. 测量安全端点。从中位逐步调整，记录关闭脉宽和打开脉宽。
3. 安装连杆。关闭位置不顶死，打开位置不超过机械限位。
4. 实现缓动。目标脉宽分10~20步变化，每步间隔10~20 ms，减小冲击。
5. 自动关闭只是关闭请求：等待夹口持续清空后才执行缓动；遮挡时暂停并受控退让，重新等待。超过闭盖时限仍未触发到位开关则进入LID_FAULT，禁止计分结算与移动。

验收：空载与实际盖重下连续开合50次，无卡滞、异常发热或主控复位；测试夹口遮挡、到位开关断线、动力断开及超时。仅关闭方向有到位反馈，打开位置按实测时序估计。

桶盖子状态为CLOSED、OPENING、OPEN、CLOSING、LID_FAULT。移动许可必须读取真实closed_limit，不能依据舵机目标角度。普通舵机停止PWM后的行为需验证，不能把停发脉冲当作可靠的制动。

## 7.4 超声波满载检测

1. 每100 ms发起一次测距，Trig保持高电平至少10 μs；只在闭盖到位、舵机停稳且样本有效时更新满载判定。传感器随盖运动时，开盖期间读数不代表桶内高度。
2. 使用独立TIM2输入捕获Echo上升/下降沿。上升沿保存t0，下降沿按16位模运算求差；发起后30 ms无完整回波则结束本次测量，不在while中无限等待。
3. 换算距离。距离厘米约等于高电平微秒数/58。
4. 剔除零值、超出物理测量范围和超时样本；不永久拒绝相对上次距离的大跳变，因为放入大件可能造成真实高度阶跃。
5. 使用最近5个新鲜有效样本的中值滤波。突变后的连续新样本可以建立新距离，随后按持续时间判满；记录样本时间，不将陈旧值重复计为新测量。
6. 中值距离低于FULL_CM且持续3秒时置full_pending。无效或过期样本中止连续确认，不能沿用上次距离继续累计。FULL_CM与CLEAR_CM按桶深和传感器盲区实测标定。
7. 设置解除滞回：CLEAR_CM > FULL_CM。清空后需要闭盖到位、有效距离高于CLEAR_CM持续3秒，再由管理员确认解除；等待清空状态不重复启动返回。

if (!lid_closed || !distance_valid || sample_stale) {
full_since_ms = INVALID_TIME;
} else if (distance_filtered < FULL_CM) {
if (full_since_ms == INVALID_TIME) full_since_ms = now_ms;
if (elapsed(now_ms, full_since_ms) >= 3000) full_pending = true;
} else {
full_since_ms = INVALID_TIME;
}
// 仅在收到新有效样本时更新；elapsed使用可处理时基回绕的差值。

## 7.5 火焰与温度联合判断

1. 记录正常环境基线。分别记录室内灯光、阳光和无火源条件下的ADC。
2. 用标有TEST的测试模式注入火焰ADC和温度数值，分别测试预警、持续告警和故障。测试模式默认关闭，界面全程标识；不在样机上使用明火、燃烧物、加热电池或喷水。
3. DS18B20采用三线外部供电、DQ上拉至3.3 V。启动转换后返回调度，完成后读scratchpad并校验CRC；12位转换最长750 ms。首次有效转换前的默认值不参与报警，但转换完成且CRC正确的85°C不能一概丢弃。[7]
4. 统一分级：短时火焰异常或高温进入预警；持续火焰超过T_FLAME、有效温度超过T_HIGH持续T_TEMP，或两者同时超过联合确认时间时，锁存FIRE。各阈值是模型标定参数，应在测试表中记录，不宣称消防级检测。
5. 加入滞回。报警阈值与解除阈值分开，防止状态来回跳变。
6. FIRE锁存后立即禁能底盘并撤销会话。盖关闭仍受夹口和机构状态限制，遮挡时不强行关盖；恢复需传感器连续正常、急停释放、故障排除及管理员本地确认。

传感器断线与火情分开编码。温度CRC失败或火焰输入异常需提示故障并禁止新的投放和运动，火情告警逻辑仍使用其他有效信号。已经提交的积分不回滚，未提交周期不自动补分。

## 7.6 RFID卡片认证与身份管理

1. 先验证RC522版本寄存器与SPI，再依次实现REQA/WUPA、完整防冲突选择、卡类型核对、扇区认证、数据块读写及结束本次通信。驱动必须有超时和错误码。[4][5]
2. 保存完整UID和长度。选用MIFARE Classic 1K教学卡，支持范围明确为4字节或7字节UID；库不支持的类型直接拒绝，不截取后四位作为身份。界面可显示UID末尾，但比较必须使用完整数据。
3. 准备至少2张用户卡、1张管理员卡和1张可擦写测试卡。主控绑定user_id、完整UID、发卡版本、role和enabled；权限及积分以主控账本为准，卡内声明不能直接提升权限。
4. 日常刷卡流程：选卡 → 扇区认证 → 读取块4 → 检查magic、格式、CRC与发卡版本 → 匹配主控有效绑定。通过后显示积分并建立30秒用户授权；忙碌时拒绝替换当前用户。
5. 登记流程：停车、闭盖并进入本地维护授权 → 读取UID → 使用匹配密钥认证扇区1 → 写入块4 → 读回逐字节核对 → 持久化主控绑定。卡写成功但主控保存失败时仍按未登记处理，重新登记不能直接覆盖其他用户积分。
6. 注销在主控账本中禁用绑定；补发卡更新issue_version并绑定新UID，使旧卡失效。新建用户可从0分开始，补发应保留既有积分。所有变更都经同一持久化提交流程。
7. 卡片仅保存应用身份字段，不保存权威积分。CRC用于发现数据错误，不提供防伪；普通教学卡与UID识别不应描述为不可复制或达到真实支付安全等级。
8. 首次开机确认两页均为全擦除态时进入初始化维护界面，要求本机长按确认并由操作者明确登记首张管理员卡。损坏账本进入恢复流程，禁止静默创建默认管理员或清零用户。维护过程保持执行器禁能。

typedef struct {
uint8_t uid_len; // 4或7，完整保存
uint8_t uid[7];
uint16_t user_id;
uint32_t issue_version;
uint8_t role; // 主控授权，0用户，1管理员
uint8_t enabled;
uint32_t points;
} UserRecord;
// 结构体用于RAM；存储按固定字节序逐字段编码，不能直接写sizeof结构体。

### 7.6.1 卡片应用块格式

指定MIFARE Classic 1K卡的扇区1数据块4，访问前完成该扇区认证。避开块0及扇区尾块7；密钥和访问位实验使用备用卡，先验证编码再修改，生产资料与实际卡型须一致。[5]

字节偏移 | 长度 | 字段 | 约定
0～3 | 4 | magic | ASCII SBIN
4 | 1 | format_version | 初版为1
5 | 1 | reserved | 0
6～7 | 2 | user_id | 小端 无符号整数
8～11 | 4 | issue_version | 补发递增 与主控一致
12～13 | 2 | reserved | 0
14～15 | 2 | CRC16 | 对0～13计算CRC16 CCITT-FALSE 小端存放

CRC16约定：多项式0x1021，初值0xFFFF，不反射，结果异或0x0000。使用字符串123456789时结果应为0x29B1；这是应用层校验，与卡片协议自身CRC分开。

保留错误码：无卡、选择失败、不支持卡型、认证失败、读写失败、格式错误、未登记、已注销、版本不匹配。错误密钥和坏CRC实验必须记录“拒绝访问或拒绝业务”的实际结果。

## 7.7 双页Flash积分账本

- C8按官方64 KiB Flash配置，页大小1 KiB。保留A页0x0800F800与B页0x0800FC00；程序链接范围为0x08000000～0x0800F7FF，长度62 KiB。Keil IROM长度设0xF800；GCC链接脚本FLASH LENGTH设62K。每次检查map及最终镜像边界，更换芯片必须重新计算。[1][3]
- 使用两页轮换的完整快照：保留当前有效页，擦除备用页，写页头和全部用户数据，写CRC并回读验证，最后单独写16位commit标记。commit验证成功后才切换当前页；旧页保留到下一次提交。任何时刻都不先擦唯一有效页。
- 快照记录magic、格式版本、有效负载长度、generation、last_tx_id、操作类型、目标user_id、变更前后积分、用户数量、用户表、CRC32与commit。初版最多32个用户，序列化格式见下表。积分、事务号和generation均检查溢出，溢出时拒绝提交并进入维护。
- 仅积分、登记、注销或明确管理变更才写入。写Flash前PWM=0、STBY低，盖已关到位且机构停稳。单Bank擦写可能暂停Flash取指，不能承诺软件中断在此期间即时响应；硬件急停始终独立有效。记录累计擦除次数，长期应用再设计页内日志。[3]
- 启动时分别检查两页的格式、范围、CRC和commit，只加载完整有效且generation较新的一页。不完整新页被忽略；两页无效则进入STORAGE_ERROR，不自动恢复默认积分或管理员。单页损坏时可用另一有效页恢复并提示降级，最近记录需核对。

### 7.7.1 固定页布局与提交边界

页内偏移 | 内容 | 实现约定
0～31 | 32字节页头 | magic SBK2、版本、有效长度、generation、tx_id、操作类型、user_id、前后积分、用户数
32起 | 最多32条用户记录 | 每条24字节；其余未使用位置填0xFF
1016～1019 | CRC32 | 覆盖页内0～1015；IEEE CRC32，软件读写使用同一算法
1020～1021 | 保留 | 0xFFFF
1022～1023 | commit | 擦除态0xFFFF；最终单独写0xA55A

32字节页头依次为magic[4]、schema_u16、payload_len_u16、generation_u32、last_tx_id_u32、operation_u16、user_id_u16、points_before_u32、points_after_u32、user_count_u16、reserved_u16。所有多字节字段小端存放，payload_len=user_count×24。

24字节用户记录依次为uid_len[1]、uid[7]、user_id_u16、issue_version_u32、role[1]、enabled[1]、points_u32、reserved[4]；不用的UID字节和reserved置0。CRC32采用IEEE反射多项式0xEDB88320，初值与最终异或均为0xFFFFFFFF，123456789校验结果0xCBF43926；不可直接套用参数不同的硬件CRC结果。

提交顺序：冻结新账本 → 擦备用页 → 半字对齐写0～1021的有效内容 → 回读与CRC检查 → 最后写commit → 再校验 → 切换当前页 → 显示成功。失败时保留旧账本；发现同一tx_id已提交则返回已有结果，不再次累加。

掉电验收边界：已显示成功的积分在正常介质上重启后必须保留；提交中掉电允许恢复完整旧值或完整新值，但不能出现半条记录、其他用户丢失或自动重复计分。提交前的物理投放可能尚未入账，重启不依据传感器当前状态自动补分。两页均损坏需本地维护恢复，并保留故障说明。

首次初始化只在明确的本机维护操作后建立账本和首张管理员卡；运行中损坏不得自动执行同一初始化。下载固件时避免误用全片擦除；若必须全片擦除，先导出用户数据并明确执行重新登记。

启动时next_tx_id=last_tx_id+1；每个新用户周期或管理事务取用后立即递增，取消也不重用，同一事务重试保留原号。事件必须匹配当前会话与事务号，已结束会话的迟到事件丢弃；复位清空待处理队列，不恢复未提交投放，计数器溢出进入维护。只有两页全为擦除态才按全新设备处理；非空且无有效快照按损坏账本处理。

## 7.8 蓝牙协议

命令 | 动作 | 执行条件与保持规则
F | 前进 | 有效管理员REMOTE会话，闭盖且联锁通过；刷新运动保持
B | 后退 | 同F；仅围定区域低速人工监护
L | 左转 | 同F
R | 右转 | 同F
S | 停车 | 任何移动状态都接受，取消旧速度
O | 请求开盖 | 先停车；有效授权且允许投放或维护
C | 请求关盖 | 始终经过夹口与机构联锁，不强制关盖
K | 请求标记路线就绪 | 管理员把车放到指定起点并本机长按确认；仅看见黑线不够
A | 启动循迹测试或回收 | 管理员、route_ready、闭盖且无故障
Q | 查询状态 | 返回模式、满载、有效温度与当前积分，不刷新运动保持
X | 退出管理员 | 立即禁能、清队列、撤销授权

- 接收中断只将字节写入有界环形缓冲区；主循环每10 ms以内限量解析。基础版采用单字符命令，收到异常长度或溢出时清空并停车；模式切换时丢弃旧运动字符。
- 运动保持时限初设400 ms，安全检查周期≤10 ms；手机按住方向时每100 ms重发，松开立即发S。只有当前有效会话中被接受的F/B/L/R刷新保持计时，Q、乱码和拒绝命令不刷新；实测停止输出延迟须≤1秒。
- 每条命令返回OK、DENY、BUSY或ERROR，并附状态码。通信超时后撤销运动授权并停车，再运动需要重新刷管理员卡；开盖及结算期间拒绝运动。
- 调试：先用USB-TTL替代HC-05验证协议，再接手机蓝牙终端。

## 7.9 TB6612电机控制

1. 架空底盘。首次测试让轮子离地，STBY保持低电平。
2. 单独测试左电机。逐个验证正转、反转、刹车和停止。
3. 单独测试右电机。若方向相反，只修改方向映射，不随意交叉代码。
4. 接口使用Motor_SetDuty(left, right)，输入为-1000～1000的有符号占空比指令。无编码器基础版不把该值称作已测转速；方向映射与占空比分别处理。
5. 加入斜坡。每10 ms限制占空比变化，降低电流冲击。
6. 测试看门狗：发送运动后停止重发；持续发送Q也必须超时禁能。关闭蓝牙、切换模式、触发急停后，恢复连接不得重放旧速度。记录禁能延迟和实际停车距离。
7. 在围定的低速测试区域落地调试，用最低可稳定行驶占空比起步并限制加速。原地转向和电机堵转电流需实测，基础版不具备自主避障能力。

## 7.10 五路循迹

1. 采用无交叉的单向黑线，从明确的投放起点通往回收点。胶带宽约18～25 mm仅为初值；设置宽黑终点标记，保持路线无同型横条，并在最低稳定速度下验证。
2. 调整传感器高度。保持5~10 mm，阵列与地面平行。
3. 逐路标定。记录黑线和白底电平，确认极性一致。
4. 先做离散控制。中心直行、左偏左修正、右偏右修正。
5. 再做加权误差。五路权重设为-2、-1、0、1、2，按误差差速。
6. 终点仅在AUTO_RETURN已离开起点并达到最短行驶时间后使能。全黑确认时间初设100～200 ms；黑区长度须覆盖最高演示速度乘确认时间及制动余量，最终由实测确定。
7. 全白表示丢线候选，初设100 ms连续确认后禁能并报警；确认期间限制低速。实测驶出距离，按路线宽度和速度调整阈值；不采用无边界盲目搜线。
8. 验收按同一起点到回收点连续成功3次，每次均停车、由管理员复位并重新放回起点；同时验证离线、终点误触发和丢线保护。

## 7.11 投放检测与盖状态联锁

PB5双边沿中断仅记录时间戳和电平，主循环完成状态转换。开盖后先清空稳定50 ms，再接受一次遮挡至少5 ms且恢复清空的事件；这些是标定起点，最终以演示物20次通过实验确定，需覆盖快通过与小物件。

PB9确认关盖到位，PC15确认夹口清空。闭盖与运动的许可分开判断：无到位则禁止移动；夹口遮挡则禁止继续关闭，超时进入故障。连续抖动不得产生多次积分，开盖前已遮挡或持续遮挡不视为完成投放。

# 8 应用逻辑 模式切换与安全策略

## 8.1 用户投放完整流程

1. 只有IDLE、未满载、盖已关到位、关键传感器有效且无锁存故障时，才接受用户刷卡。主控为本次授权绑定user_id和transaction_id；一个授权只能开始一次投放周期。
2. 卡片认证和绑定校验通过后进入USER_AUTH，显示当前积分。30秒内未请求开盖则退出；其他用户刷卡不能改变正在进行的积分归属。
3. 用户按键后进入LID_OPENING，再进入LID_OPEN。只在创建新周期时清零检测标志；同周期的重复按键、再次刷卡或重复开盖请求不能重置计分锁。
4. 开盖后先确认光束清空，再接受“未遮挡 → 有效遮挡 → 恢复未遮挡”的完整事件。初始已遮挡、持续堵塞和短噪声均不计；一个周期多次通过仍最多+1。该检测仅表示物体通过，不能验证材质、重量或防止人为刷分。
5. 收到关闭请求后进入LID_CLOSING，等待夹口清空、执行缓动并检查PB9到位。受阻则退让等待；到位超时进入LID_FAULT，保持底盘禁能。投放红外与夹口检测用途不同。
6. 只有检测到有效投放且关盖到位才进入POINT_COMMIT。冻结tx_id、user_id、points_before和points_after，写一次新快照。成功需commit及CRC回读通过；失败不显示成功、不接收新投放。重试先核对tx_id是否已提交，不再次执行points++。
7. 提交成功后显示“积分+1”和新积分；无投放时显示“未检测到投放”且+0。结束时清除会话，要求卡片离场后再刷。移卡判断不能只依赖HALT后的REQA无响应，应采用经验证的WUPA存在检测与连续无卡去抖。

## 8.2 管理员流程

1. 管理员卡同样需完成卡认证、应用数据检查和有效主控白名单匹配。进入ADMIN_REMOTE前结束或取消用户周期，确认闭盖，停车并清空旧蓝牙队列。
2. 蓝牙连接不等于运动授权。管理员会话空闲超时初设60秒；运动保持超时另按400 ms处理。必须在当前会话、REMOTE模式和运动联锁全部满足时接受方向命令。
3. 手机按住方向时周期发送F/B/L/R，松开发S；只有合法运动命令刷新保持时间。Q查询、非法字符、越权命令不得维持旧速度。S随时请求停车，C仍需经过防夹判断。
4. 维护只在停车状态进行：查看传感器、登记注销卡片、开关盖及清空后复位满载。清零积分是可选功能，需本机二次确认并作为管理事务持久化。
5. X退出、运动超时、会话超时、故障或复位均停车、清空接收队列并撤销授权。重新连接和急停释放不会恢复上次命令；恢复运动要重新刷管理员卡。

## 8.3 满载自动返回流程

1. 使用关盖后新鲜有效距离确认满载。若正在用户周期，置full_pending并禁止新的授权，先完成安全闭盖和本次合法结算；遇关键故障则中止待提交周期。
2. 在FULL_WAIT锁定用户投放。路线未准备好时显示“满载 请管理员就位”，保持停车；管理员仍可在联锁满足时低速遥控到指定起点。
3. 返回许可：路线已由管理员在指定起点确认就绪、循迹输入有效、已关盖到位、夹口清空、无急停/火情/关键传感器故障。基础版不含电池电压采样，软件不得宣称已经验证电量正常。
4. 条件满足后低速进入AUTO_RETURN，合法进入转换保留route_ready供本次运行使用。人工遥控、取消返回、离开AUTO_RETURN、丢线、急停、故障或复位均清除该许可；满载但未就绪则FULL_WAIT等待管理员摆回并重新确认。
5. 在终点判定使能后识别宽黑标记，PWM归零、STBY低，进入AT_STATION。到站保持停车，不因full仍为真再次出发。
6. 管理员刷卡后在停车状态下开盖清空。清空结束确认夹口清空并闭盖，再等待有效测距恢复；维护开盖不产生用户积分。
7. 管理员确认且距离高于解除阈值持续3秒后解除满载，返回IDLE并保持route_ready=false。再次自动返回前重新设置起点；不宣称自动返程回到投放点。

## 8.4 火情与故障处理

异常 | 立即动作 | 恢复条件
火情 | 禁能底盘、锁存声光报警；关盖不绕过夹口 | 信号持续恢复且故障清除，管理员本地确认
急停 | 硬件切断动力，软件锁存，不发起舵机动作 | 释放、检查、确认；新授权与新指令
蓝牙超时 | PWM=0、STBY低、清队列、撤销会话 | 重新刷管理员卡；不自动续跑
循迹丢线 | 禁能并报警，route_ready清零 | 管理员遥控或人工回起点并重新确认
超声波失效 | 提示故障，禁止新投放和自动返回 | 连续有效新样本恢复后本地确认
温度/火焰失效 | 故障提示，禁止新动作；其他有效信号继续监测 | 数据有效且稳定后确认
夹口遮挡或盖不到位 | 停止继续关闭/受控退让，禁止移动和结算 | 障碍排除、反馈正常；超时需维护
账本校验失败 | 选择另一有效页并提示降级；两页坏则锁定业务 | 导出核对，明确维护恢复；不默认归零
低压或复位 | 复位后默认禁能，清旧会话，显示原因 | 检查电源；基础版无电量自动判断
测试模式 | 屏幕持续显示TEST，禁止真实火源实验 | 退出测试并重启，确认正式阈值与状态

# 9 分阶段联调与里程碑

每个里程碑保留接线照片、固件版本、测试输入和实际结果。阶段失败先定位并修复，只有通过条件达到后才接入下一模块；所有数值标准均为设计目标，需填写实测结果。

里程碑 | 包含内容 | 退出标准
M0 主控基线 | 时钟、GPIO默认值、日志、OLED、Flash边界 | 30分钟稳定；资源与map记录完整
M1 静态桶 | 传感器、桶盖、对射、夹口、到位、报警 | 满载/火情模拟与开盖联锁通过
M2 RFID积分 | 认证读写、登记注销、一次投放、双页保存 | 2用户1管理员；错误卡、留卡、防重复和掉电通过
M3 遥控底盘 | 电机、电源、HC-05、急停、运动看门狗 | 方向正确，失联和Q流量下仍及时禁能
M4 限定循迹 | 起点标记、五路阵列、终点、丢线 | 起点到终点连续成功3次
M5 总状态机 | 用户/管理员/满载/故障联锁 | 开盖不移动，投放中满载不抢跑，到站不重启
M6 完整结构 | 桶体、轻盖、线束、重心、反馈安装 | 开合50次，移动不松动，断电盖体不砸落
M7 最终验收 | 两门课测试、30分钟耐久、演示与归档 | 实际结果、问题说明与源文件一致

## 9.1 每次联调的固定操作

1. 拍照记录接线。变更前后各拍一张，防止无法恢复。
2. 测量实际电池端电压与各稳压支路，确认在对应额定范围内；2S满充可为8.4 V，电机与舵机支路按实际选型值检查。
3. 加载上一个稳定固件。先确认基线仍正常。
4. 只加入一个新模块。先运行独立测试页面或测试命令。
5. 记录原始数据。保留阈值、波形、串口日志和复现步骤。
6. 通过后提交版本。文件名或Git标签标记M1、M2等里程碑。
7. 失败则隔离。拔下新模块，确认旧系统恢复，再定位供电、引脚或软件问题。

## 9.2 推荐演示路线

- 将整机放在指定循迹起点，检查朝向、线路、夹口与关盖到位，保持执行器禁能后再上电自检。
- 用户演示：刷用户卡→显示积分→按键开盖→模拟投放→积分增加。
- 管理员演示：刷管理员卡→手机蓝牙前后左右控制→通信停止后自动停车。
- 回收演示：管理员将车摆回指定起点并确认路线就绪，在桶内固定可移除挡板模拟满载，确认夹口清空并闭盖；有效距离持续判满后循迹到站停车。
- 通过TEST模式注入火情信号，演示底盘禁能、锁存报警，以及夹口遮挡时不强制关盖。
- 恢复演示：管理员确认、清除模拟条件并恢复待机。

# 10 标定 测试与故障排查

## 10.1 标定项目

对象 | 标定操作 | 最终记录
超声波 | 空桶、半桶、接近满载各测20次 | FULL_CM、解除阈值、无效范围
火焰ADC | 环境光基线与TEST注入 | 预警/正式阈值、确认时间、解除滞回
DS18B20 | 室温与参考温度计比较 | 偏差修正、高温阈值
投放对射 | 不同大小模型各经过并记录脉宽 | 空闲稳定时间、最短脉宽、有效率
桶盖与反馈 | 脱载标定，再装实际盖重及到位/夹口传感器 | 脉宽、动作时限、退让距离与质量
循迹 | 黑线/白底逐路读取 | 极性、权重、终点确认时间
电机 | 架空及落地直行 | 左右基础占空比、斜坡步长
蓝牙 | 指定手机距离、断连和持续Q查询 | 重发周期、保持时限、实测禁能延迟
RFID | 固定电源，距离/角度分组，各20次 | 卡型、完整UID长度、成功率、读写耗时与错误码

## 10.2 功能测试矩阵

编号 | 测试项目 | 操作或输入 | 通过标准
T01 | 开机 | 正常启动/复位/下载 | 5秒内进入明确状态，电机不误动
T02 | 合法卡 | 2用户1管理员分别刷卡 | 正确角色与积分，无用户串账
T03 | 认证读写 | 登记块4后回读；再用错误密钥 | 正常逐字节一致；错误认证拒绝
T04 | 错误卡 | 未登记、注销、坏CRC、旧版本 | 拒绝建立业务或管理员会话
T05 | UID完整性 | 不同完整UID及支持的4/7字节卡 | 不截断、不混淆；不支持类型明确拒绝
T06 | 留卡与重复事件 | 卡停留30秒；同周期开关请求和通过抖动 | 一个周期最多+1，不自动再次授权
T07 | 空投/堵塞 | 空开关盖、初始遮挡、持续遮挡 | 均+0；堵塞提示，未通过不结算
T08 | 正常通过 | 演示物20次完整通过 | 至少19次有效检测，记录原始脉宽
T09 | 用户归属 | A投放期间刷B | 不把A周期积分记给B
T10 | 关盖联锁 | 盖未到位时发送方向命令 | 拒绝运动，超时进入盖故障
T11 | 防夹 | 关盖中遮挡，包括火情注入时 | 不强制关闭，底盘保持禁能
T12 | 提交成功后掉电 | 显示成功后断电，重复10次 | 积分均保留，无重复入账
T13 | 提交中掉电 | 擦备用页、负载、CRC、commit前后各≥5次 | 仅恢复完整旧/新快照，无其他用户损坏
T14 | 存储故障 | 破坏一页或两页测试副本 | 单页可降级；双页故障不默认归零/授权
T15 | 重复事务 | 重复同tx_id及关盖完成事件 | 账本只变更一次
T16 | 满载抗抖 | 短遮挡、开盖、无回波、过期样本 | 不错误确认满载/自动启动
T17 | 满载确认 | 闭盖后有效低距离持续3秒 | 停止新投放；周期内先闭盖和结算
T18 | 离线满载 | 不在指定起点触发满载 | 保持FULL_WAIT，不盲目搜线
T19 | 循迹与终点 | 相同起点到终点重复3次 | 3次到站停车，满载未清不再次出发
T20 | 丢线 | 移开黑线或注入全白 | 按标定时限禁能，记录驶出距离
T21 | 管理员权限 | 未授权、注销、过期和重连旧命令 | 电机不启动，须重新有效授权
T22 | 运动看门狗 | 停止方向重发并持续发送Q | ≤1秒禁能，Q不维持旧速度
T23 | 硬件急停 | 运动与Flash忙期间按急停 | 独立切断动力；释放后不自动续跑
T24 | 火情分级 | TEST短异常、持续火焰、独立高温、组合 | 符合统一判定，故障与FIRE分开
T25 | 报警恢复 | 信号未恢复/急停未释放时请求清除 | 拒绝；全部条件满足后本地确认
T26 | 调度延迟 | 温度转换、OLED刷新、RFID失败同时发生 | 看门狗仍达标，记录最坏循环时间
T27 | 电源压力 | 满充条件、舵机动作、电机启停组合 | 主控无复位，电压电流温升有记录
T28 | 机械耐久 | 实际盖重连续开合50次 | 无卡滞、松动或异常温升
T29 | RFID性能 | 距离与角度分组，每组20次 | 记录成功次数和响应时间，不虚填指标
T30 | 连续运行 | 完整流程连续30分钟 | 无死机/意外复位，故障均可追溯

## 10.3 常见故障快速定位

现象 | 优先检查 | 处理方法
电机一启动主控复位 | 5V压降、共地不良、电机噪声 | 分离供电回路；加大电容；缩短电源线；降低加速斜率
RC522偶发读不到卡 | 3.3V不稳、SPI线过长、靠近金属 | 缩短信号线；增加去耦；远离电池/金属
OLED乱码或死机 | I2C时序、地址、供电干扰 | 降到100 kHz；检查上拉和刷新频率
超声波距离跳变 | 桶壁反射、安装倾斜、测量过快 | 调整朝向；增加滤波；间隔≥60 ms
火焰传感器误报 | 阳光、灯光、阈值过敏 | 遮光；重新标定；增加持续时间和温度佐证
舵机抖动 | 电源不足、PWM不稳、机构顶死 | 独立5V；加电容；重新设端点；减小连杆阻力
小车向一侧偏 | 电机差异、轮胎阻力、结构偏心 | 校正基础占空比；检查轮组；调整重心
循迹频繁丢线 | 高度不对、阈值不一、速度过快 | 逐路标定；调高度；降低速度；优化路线
Flash数据异常 | 链接边界、双页有效性、commit与CRC | 保留有效页；两页无效进入维护；不默认清零
蓝牙有显示但不动作 | 权限状态不对、TX/RX接反、协议不一致 | 看回执；确认管理员状态和波特率

# 11 17周实施进度安排

使用方法：下表以任务书的17周节奏编排，计划完成日期不晚于2026年12月31日。若教学周日期不同，可整体平移，但里程碑顺序不要改变。

课程周次 | 主要工作 | 必须产出
第1周 | 核对两门任务要求与单桶功能范围 | 需求矩阵、主线流程、实际日期表
第2周 | 总体方案、身份数据与状态机 | 系统框图、卡片/账本草案
第3周 | 电源、实板IO、盖重与BOM冻结 | 选型依据、接线图、分批采购单
第4周 | 主控、OLED、EXTI、日志与Flash边界 | M0与编译资源记录
第5周 | 超声、火焰、DS18B20分步驱动 | 原始数据与有效性记录
第6周 | 舵机、投放对射、到位、防夹、告警 | M1联锁和静态桶测试
第7周 | RFID寻卡认证、应用块读写、登记注销 | 卡格式、错误码、读写实验
第8周 | 一次投放事务、双页账本、掉电注入 | M2与一致性测试记录
第9周 | SolidWorks轻盖与反馈支架装配 | 零件、装配、爆炸图和干涉检查
第10周 | 电机、电源压力、底盘、硬件急停 | 驱动测试、峰值与停车距离
第11周 | HC-05协议、会话、保持超时 | M3及断连/Q流量测试
第12周 | 限定路线、起点与终点、丢线 | M4连续3次测试
第13周 | 满载返回与总状态机 | M5异常组合测试
第14周 | 完整结构、线束、反馈安装复核 | M6开合与移动耐久
第15周 | RFID性能、掉电、30分钟运行 | 两门课原始测试数据
第16周 | 分别撰写报告，录视频、制作PPT | 提交包初版与实际结果
第17周 | 复核任务矩阵、演练答辩、归档 | M7与最终提交包

## 11.1 每周固定复盘

序号 | 检查项目 | 记录
1 | 本周计划功能是否有可重复演示的视频或测试记录。 | 未检/通过/整改
2 | 接线图、引脚表和代码是否随变更同步更新。 | 未检/通过/整改
3 | 是否出现范围膨胀；新增功能是否影响主线进度。 | 未检/通过/整改
4 | 是否保留一个可运行的稳定版本。 | 未检/通过/整改
5 | 下周所需物料、加工件和场地是否已经准备。 | 未检/通过/整改
6 | 当前最大风险是否有负责人、截止时间和备选方案。 | 未检/通过/整改

# 12 报告 视频 PPT与最终提交

## 12.1 课程设计报告建议目录

1. 嵌入式报告题目建议为《基于STM32的RFID积分式智能移动垃圾桶设计》。绪论说明任务要求、应用流程与教学样机边界。
2. 总体方案。系统框图、功能划分、方案比较与最终选择。
3. 机械结构设计。SolidWorks零件、装配体、爆炸图、关键尺寸和干涉检查。
4. 硬件设计。电源、主控、传感器、驱动、显示、通信和引脚分配。
5. 软件设计。工程结构、任务调度、状态机、各模块流程图与关键代码。
6. 系统调试。模块测试、联调过程、标定数据、问题及解决方法。
7. 结果与分析。逐项填写实际成功次数、时间、距离和故障表现，附原始记录；未通过或尚未测试的项目如实标记，不用设计目标替代实测结果。
8. 总结与展望。完成情况、个人收获和可选升级方向。
9. 附录。接线表、物料表、协议、存储格式、测试记录与关键代码。RFID报告单独组织标签认证读写、卡片编码、身份管理和读写性能实验。

### 12.1.1 RFID报告与实验材料

RFID报告建议按需求与卡型选择、射频系统组成、寻卡选卡与认证流程、应用块编码、发卡注销、身份与积分关联、读写实验、异常处理和结论组织。解释13.56 MHz近场应用边界，不把防冲突协议等同于已实现多标签批量盘点。

保存每张测试卡的类型与匿名编号、测试距离、角度、读写次数、成功次数、响应时间、错误码和供电条件。截图仅作辅助，原始数据表与重复实验是主要证据。个人实际卡片密钥不写入公开报告。

## 12.2 成果视频脚本 约4分钟

时间 | 内容 | 画面重点
0:00~0:15 | 标题、姓名、项目目标 | 正面整机
0:15~0:45 | 展示主控、传感器、底盘和结构 | 爆炸图+实物特写
0:45～1:30 | 卡片认证、按键投放、提交后积分增加 | OLED与有效投放同框
1:30~2:10 | 管理员刷卡和蓝牙遥控 | 手机命令与小车同框
2:10～2:50 | 在指定起点模拟满载，循迹到站 | 起点确认、连续路线和停车
2:50～3:25 | TEST注入火情和夹口遮挡 | 禁能与报警，受阻不强关盖
3:25~4:00 | 总结要求覆盖、创新点和不足 | 整机与测试表

## 12.3 答辩PPT建议结构

- 第1页：题目、成员、指导教师。
- 第2页：任务要求和完成情况总览。
- 第3页：总体方案框图与状态机。
- 第4页：SolidWorks结构与爆炸图。
- 第5页：硬件框图、电源树和实物接线。
- 第6页：软件架构和调度周期。
- 第7页：卡片应用块、主控积分账本和一次投放提交流程。
- 第8页：循迹、满载返回和安全策略。
- 第9页：测试数据、故障解决和成果视频。
- 第10页：创新点、不足和改进方向。

## 12.4 最终目录与文件命名

提交包/
01_嵌入式课程设计报告_学号_姓名.docx
02_RFID课程设计报告_学号_姓名.docx
03_源程序_SmartBin_F103.zip
04_成果视频_学号_姓名.mp4
05_答辩PPT_学号_姓名.pptx
06_SolidWorks模型与工程图.zip
07_BOM_接线表_两门课测试记录/
README.txt

## 12.5 最终提交前检查

序号 | 检查项目 | 记录
1 | 两门报告题目、姓名、学号和任务要求逐项对应。 | 未检/通过/整改
2 | 报告图片清晰，图号、表号和引用对应。 | 未检/通过/整改
3 | 源程序可以在另一台电脑重新编译，没有绝对路径依赖。 | 未检/通过/整改
4 | README写明开发环境、接线、编译和演示步骤。 | 未检/通过/整改
5 | 视频声音清晰，关键OLED状态和小车动作可见。 | 未检/通过/整改
6 | PPT控制在规定时长内，已完成至少两次答辩演练。 | 未检/通过/整改
7 | SolidWorks文件包含零件、装配体、爆炸图和工程图。 | 未检/通过/整改
8 | 文件按两门课程各自要求归档，备份并核查可打开。 | 未检/通过/整改

# 13 风险清单与每日执行模板

## 13.1 主要风险与预案

风险 | 等级 | 表现 | 预防 | 备选
电源不足 | 高 | 电机/舵机动作时复位 | 独立降压、加电容、斜坡控制 | 先完成电源压力测试
IO或板级占用 | 高 | PC14/15接晶振或外设冲突 | 购前核对板图、独立定时器与map | 换更多引脚板并重做分配
桶盖负载或夹口 | 高 | 舵机过载、不到位、受阻 | 轻盖、力矩计算、到位与夹口联锁 | 重做盖/连杆并重新验收
循迹或路线条件 | 中高 | 离线无法返回、终点误触发 | 限定起点、低速、无交叉路线 | FULL_WAIT管理员就位
RFID靠近金属失效 | 中 | 刷卡距离短 | 前面板塑料隔离、远离电池 | 调整读卡区位置
范围膨胀 | 高 | 主线未完成 | 冻结第一版功能 | 可选功能延后
积分与存储 | 高 | 重复计分、掉电损坏 | 事务号、双页commit、分点掉电测试 | 保留有效页，明确维护恢复
火情演示方式 | 高 | 真实火源损坏设备 | TEST数值注入，无明火与喷水 | 退出TEST后验证正式模式
文件丢失 | 中 | 无法提交或回退 | 每日备份、里程碑压缩包 | 本地+云端双备份

## 13.2 每日调试记录模板

字段 | 记录内容
日期/版本 | ____________________________
今日目标 | ____________________________________________________________
硬件变更 | ____________________________________________________________
软件变更 | ____________________________________________________________
测试条件 | ____________________________________________________________
实际结果 | ____________________________________________________________
问题复现步骤 | ____________________________________________________________
原因判断 | ____________________________________________________________
处理与验证 | ____________________________________________________________
下一步 | ____________________________________________________________

## 13.3 今天即可开始的第一批操作

1. 建立项目文件夹和版本库。把任务书、模型图、资料、代码和报告分目录保存。
2. 按BOM确认已有器件。标记已有、待购和型号不确定三类。
3. 下载模块规格资料。优先RC522、TB6612、OLED、舵机和电机尺寸。
4. 在CubeMX建立主控基线。完成72 MHz、SWD、LED/OLED和安全GPIO初始值。
5. 用卡尺测量关键器件。建立SolidWorks第一版底盘和桶体参数。
6. 打印本手册的M0~M2检查项。按里程碑执行，不同时连接全部模块。

完成标准：M0～M7均有可复现的验收记录，两门课要求已分别映射到报告章节和证据；源程序可重建，模型与接线一致，整机能够完成投放积分、管理员遥控、限定路线回收及模拟故障处理。

课程依据：《24级嵌入式系统课程设计任务书》，2026年8月21日发出，计划完成日期2026年12月31日。第11章17周安排按课程周次执行，具体日期以课程安排为准。器件依据见第14章。

# 14 器件资料与参数依据

课程任务书决定功能范围，以下官方资料用于核对接口、存储、时序和电气边界。模块底板、接插件及采购件参数另存到项目Datasheets目录；通用模块名称不代表所有商家版本一致。

[1] STMicroelectronics STM32F103x8 STM32F103xB Datasheet。用于核对封装引脚、PC13～PC15限制、存储容量和电压。https://www.st.com/resource/en/datasheet/stm32f103c8.pdf

[2] STMicroelectronics RM0008 Reference Manual。用于核对AFIO、定时器时钟、PWM和输入捕获。https://www.st.com/resource/en/reference_manual/rm0008-stm32f103xx-advanced-armbased-32bit-mcus-stmicroelectronics.pdf

[3] STMicroelectronics PM0075 Flash Programming Manual。用于核对页擦除、半字写入及忙状态；双页事务流程为本项目设计。https://www.st.com/resource/en/programming_manual/pm0075-stm32f10xxx-flash-memory-microcontrollers-stmicroelectronics.pdf

[4] NXP MFRC522 Data Sheet。用于核对13.56 MHz、协议支持、SPI与电源。https://www.nxp.com/docs/en/data-sheet/MFRC522.pdf

[5] NXP MIFARE Classic EV1 1K Data Sheet。用于核对UID、扇区认证、16字节数据块和访问条件。https://www.nxp.com/docs/en/data-sheet/MF1S50YYX_V1.pdf

[6] Toshiba TB6612FNG Data Sheet。用于核对逻辑/动力电源、驱动真值表和电流限制。https://toshiba.semicon-storage.com/info/TB6612FNG_datasheet_en_20141001.pdf?did=10660&prodName=TB6612FNG

[7] Analog Devices DS18B20 Data Sheet。用于核对外部供电、转换时间和scratchpad CRC。https://www.analog.com/media/en/technical-documentation/data-sheets/ds18b20.pdf

资料核对日期：2026年9月23日。报告中的测试结果以实物记录为准，手册中的频率、阈值和验收次数均应在实现时复核。

STM32智能移动垃圾桶 全过程实施手册
