Sylphiette666/stm32-rfid-smart-bin/hardware/current-low-cost/pcb-a/review/schematic/index-detail.png

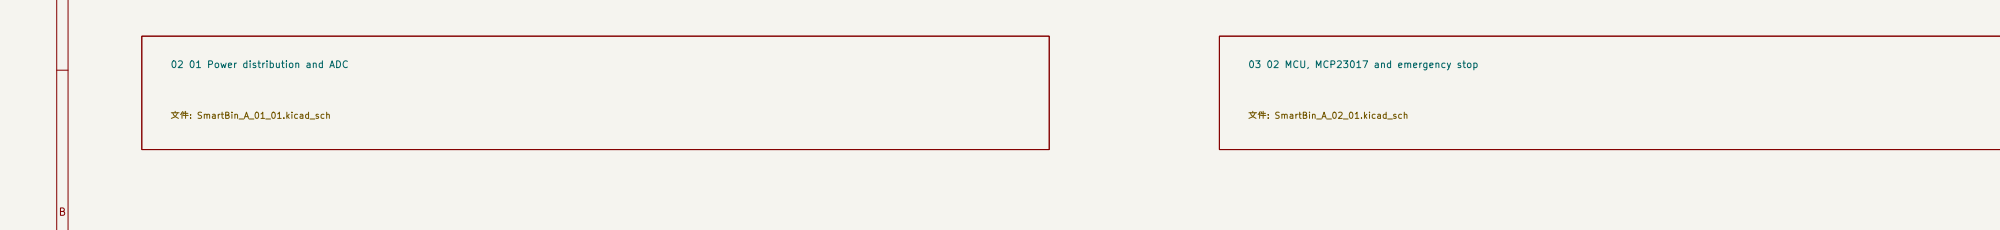
hardware/current-low-cost/pcb-a/review/schematic/index-detail.png
