Sylphiette666/stm32-rfid-smart-bin/hardware/current-low-cost/pcb-a/review/schematic/page-2.png

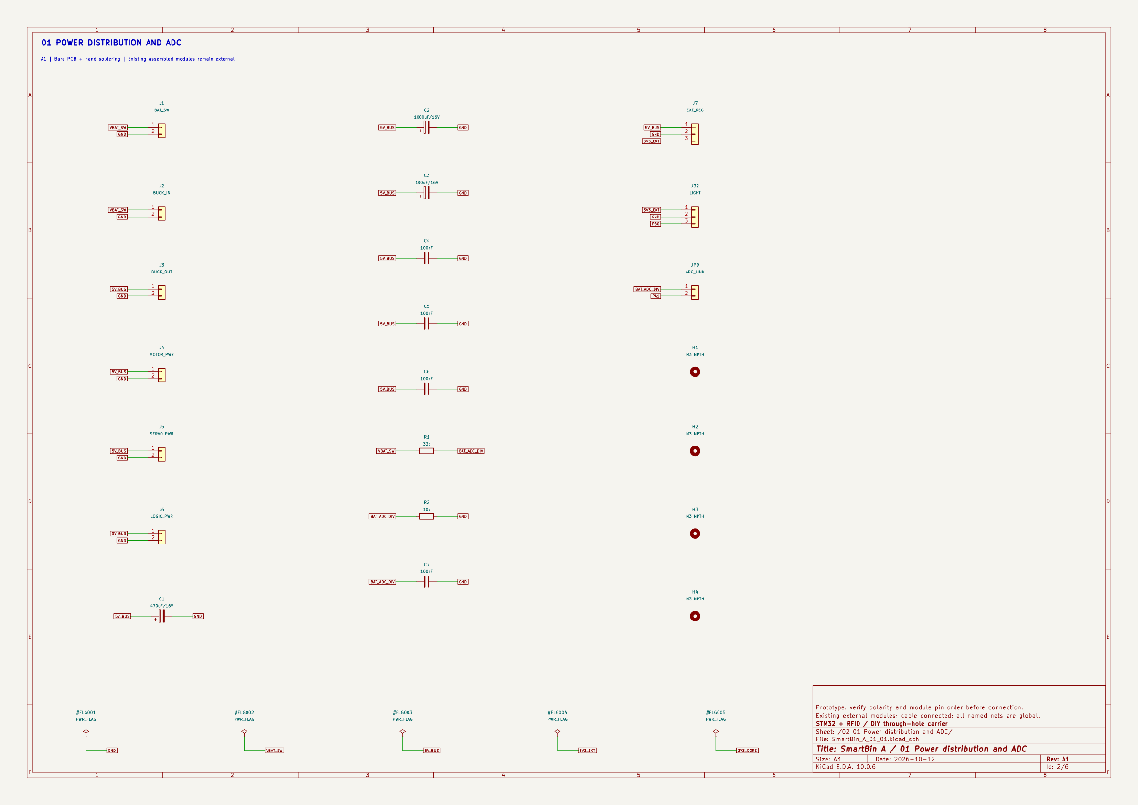
hardware/current-low-cost/pcb-a/review/schematic/page-2.png
