Sylphiette666/stm32-rfid-smart-bin/hardware/current-low-cost/pcb-a/review/schematic/page-3.png

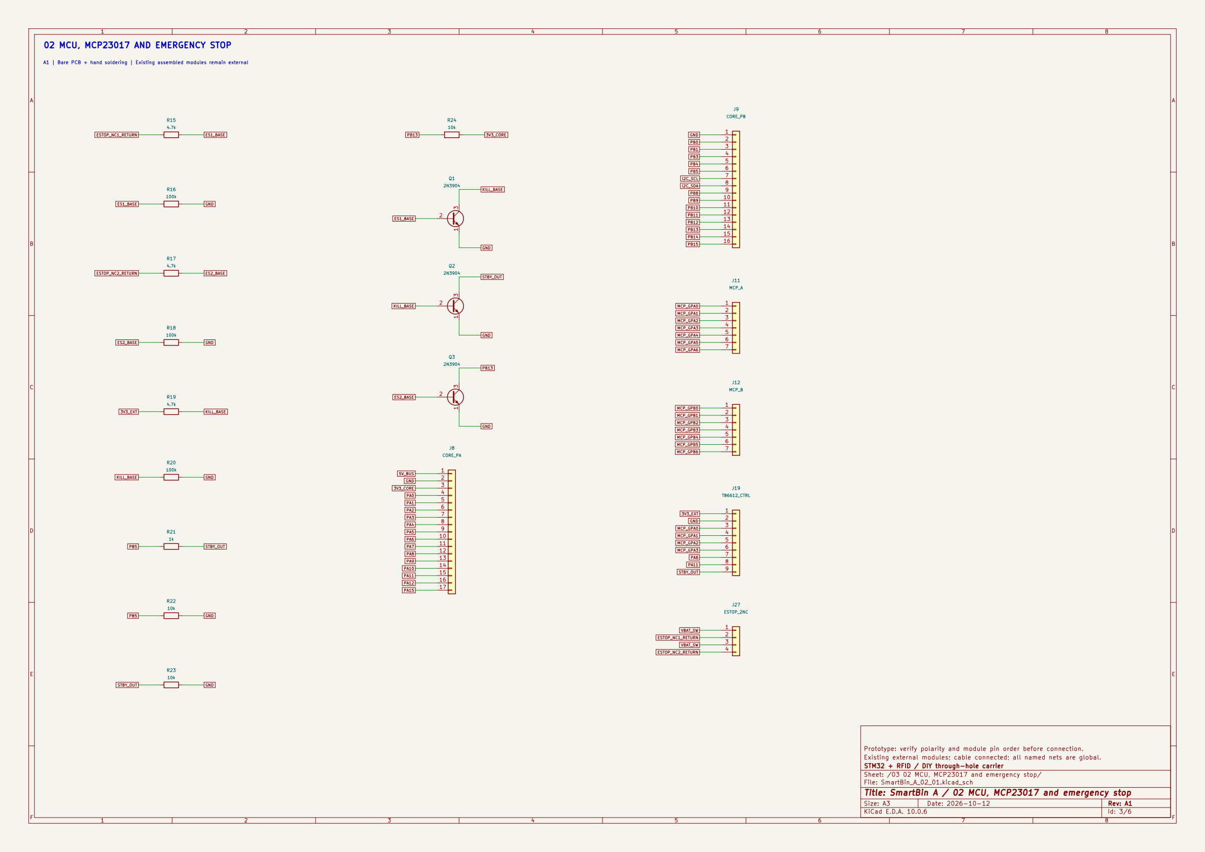
hardware/current-low-cost/pcb-a/review/schematic/page-3.png
