Sylphiette666/stm32-rfid-smart-bin/hardware/current-low-cost/pcb-b/renders/schematic-contact.png

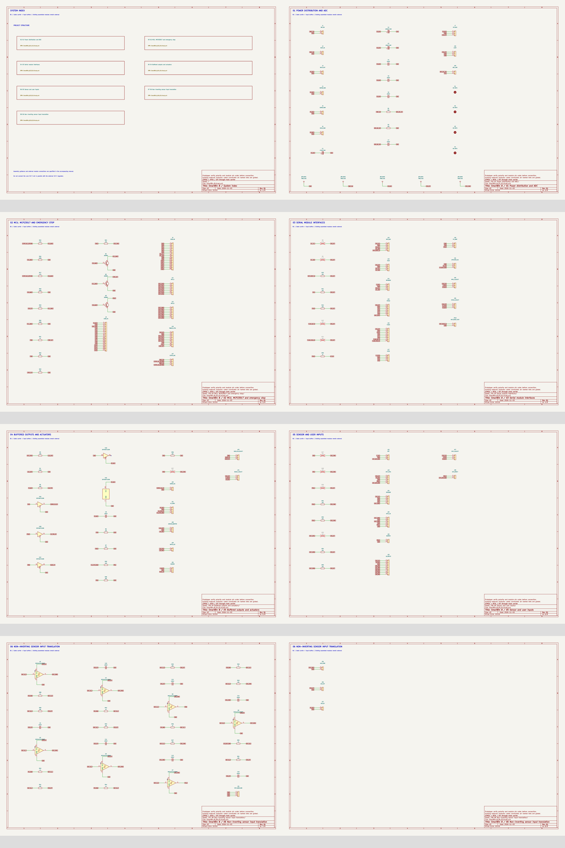
hardware/current-low-cost/pcb-b/renders/schematic-contact.png
