Sylphiette666/stm32-rfid-smart-bin/hardware/current-low-cost/pcb-b/renders/schematic-page-7.png

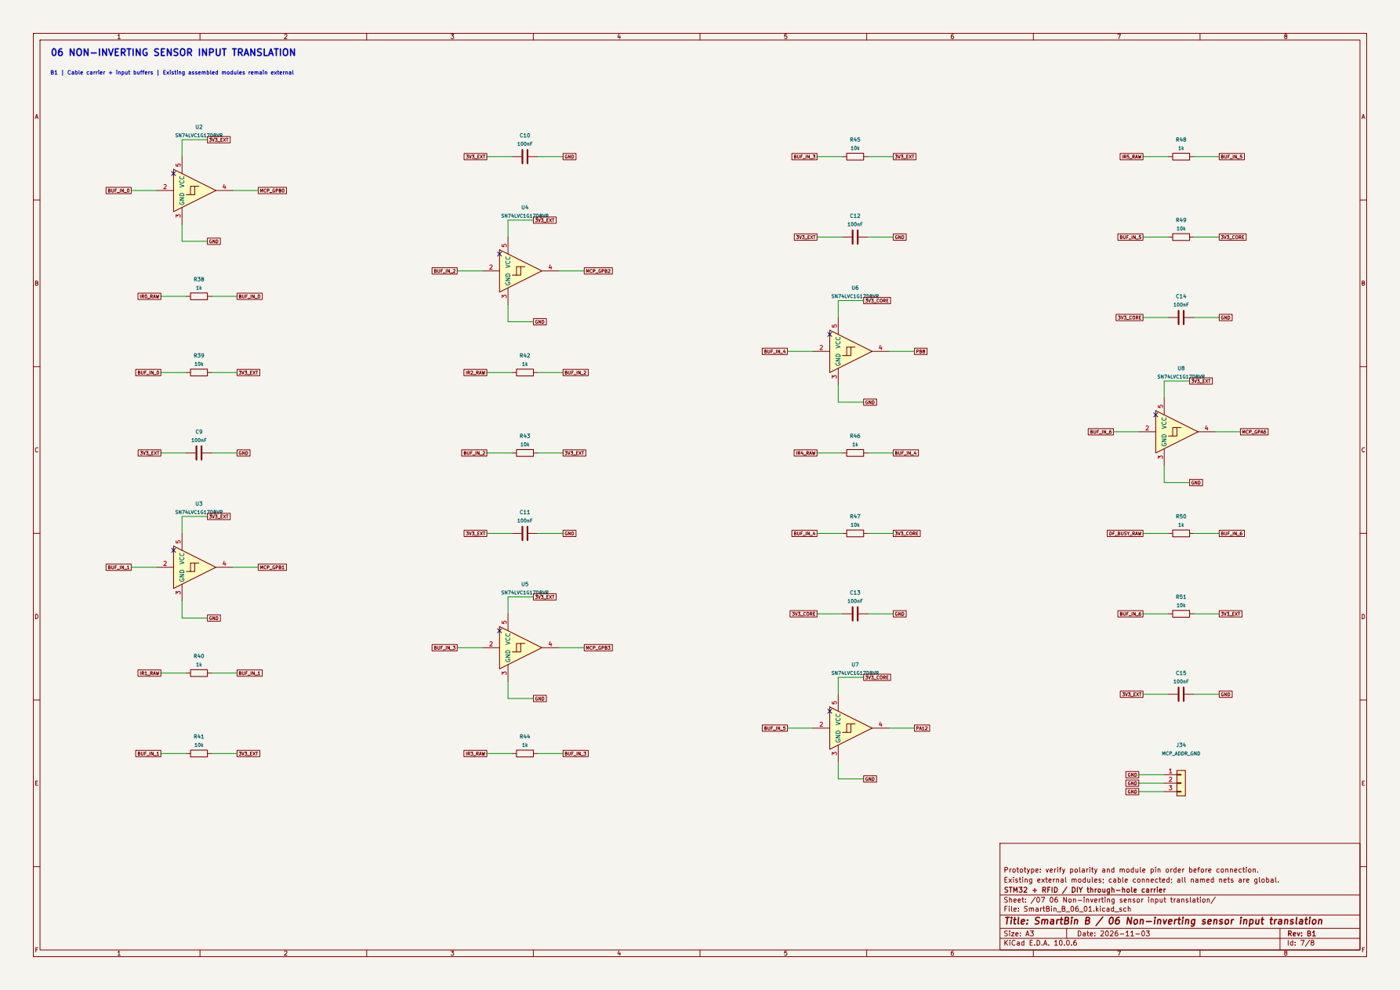
hardware/current-low-cost/pcb-b/renders/schematic-page-7.png
