Sylphiette666/stm32-rfid-smart-bin/hardware/current-low-cost/pcb-a/README.md

# SmartBin A1：复用模块的低成本手焊底板

2026-10-12。当前实施方案 A：只订裸 PCB，自己焊直插件；复用 STM32 核心板、MCP23017 成品模块、降压/稳压模块及传感器。模块按信号名用杜邦线连接，动力电源使用螺丝端子和足够线径。此板替代旧 PWR、IO 两块洞洞板，不是旧 PCF8574 V2.1 底板。

## 四套技能复查更新

本次接地加强版新增55个GND过孔，无新增BOM元件或手焊任务。制造检查通过；EMC回流/去耦仍有待实测项，不能理解为四套工具全部零告警。图解增强版新增第64章。完整证据见[四套技能联合审查报告](review/four-skills/四套技能联合审查报告.md)。

## 先使用哪些文件

| 用途 | 文件 |
| --- | --- |
| 嘉立创裸板生产上传 | `manufacturing/Gerber_RS274X.zip` |
| 下单、焊接与实物核对 | `manufacturing/order-and-assembly.md` |
| 板上器件与条件选装 | `manufacturing/bom.csv` |
| 181 个板端接口针脚定义 | `connector-map.csv` |
| 原理图阅读 | `kicad/SmartBin_A_schematic.pdf`（6 页） |
| 可编辑 KiCad 10 工程 | `kicad/SmartBin_A.kicad_pro` |
| 顶面装配/底面焊接 | `diagrams/45_pcb_top.png`、`46_pcb_bottom.png` |
| 电源、模块、条件适配 | `diagrams/47_power.png` 至 `49_conditions.png` |
| 电气解释和调试条件 | `electrical-design.md` |
| 最终数字检查 | `checks/pcb-drc.json`、`kicad/schematic-erc.json`、`review/` |

同名图解增强版 Word 已同步本方案第 63 章，并保留原 330 步编号。旧洞洞板图标记为历史参照，连接本 PCB 时以 A1 的 J/JP 位号和逐针表为准。成品模块物理针序必须按实物核对，不能照抄本板的针序。

板边“PIN 1 = SQUARE PAD”用于 J/JP 接口；电解电容按“＋”标记识别正脚，不能仅凭丝印轮廓判断极性。库文件归属 KiCad 社区，许可和设计例外见 `kicad/KICAD_LIBRARY_LICENSE.md`；本地收录的库集合保持该许可。

## 裸板下单参数

- 100 × 100 mm，2 层 FR-4，厚 1.6 mm，外层 1 oz 铜，绿色阻焊、白色丝印；常规喷锡表面即可。
- 普通过孔 0.8 mm 焊盘 / 0.4 mm 钻孔；4 个 M3 安装孔为 3.2 mm 非金属化孔，孔中心距 90 × 90 mm。
- 原理图与 PCB 检查：ERC 0 错误、0 警告；PCB DRC 0 违规、0 未连接、0 原理图一致性差异（按随包规则和报告列出的检查项）。
- 生产包为 7 个 RS-274X 图层文件＋PTH/NPTH 两个 Excellon 钻孔文件，不含其他旧版 Gerber。
- 本次不用 SMT、钢网或贴片坐标文件。只装 1 台；裸 PCB 的最小订购片数、运费、优惠及报价以实际下单界面为准，不能套用此前的“SMT 至少 2 片”。多出的裸板保留作备件。

已购模块、工具不再计入新增成本；新增裸板、运费及少量耗材预算可先按约 **20–60 元**预留。这是预算范围，不是实时工厂报价，是否享有打板券、需补哪些排针和端子会改变实付金额。

## 本版设计边界

- 电池受保护的 2S 电源先经过外部保险丝和总开关，再进 J1；J3 仅接调好的 5 V 降压输出。J1/J2 的电池电压不能接入 J3/J4/J5/J6。
- 5 V 主干与地回路 3 mm、主要电机/舵机分支 2 mm。电机、舵机动作按原设计分时执行；导线、电池、降压模块和散热仍须按手册实測验收，不能把线宽视为整机连续带载认证。
- 低压信号区采用 0.20 mm 最小铜间距；常规信号 0.30 mm，少量局部信号 0.25 mm；铜到板边规则 0.50 mm。这一组合用于压缩到常规 100 mm 板幅，所有最终连通和间距以随包 DRC 为证据。
- 3V3_CORE 与 3V3_EXT 分开；组装接线后不得再并接核心板 USB 电源。模块供电与逻辑电平按条件表配置，5 V 数字输出不能直接进入未适配的 3.3 V 接口。
- U1 用 SN74AHCT125N 的 DIP-14 插座，芯片插入插座；裸 AO3400A 仍需在外部转接板上焊接。MCP23017、AO3400A 和 BSS138 模块不集成在本板上。
- DNP 是“按模块条件选择安装”，不是把所有功能取消。R36/R37 等偏置不可同时装；各跳帽用第 63 章条件表确认。
- J1–J6 库封装是 Phoenix MKDS 5.08 mm；购买通用 KF301 前必须核对脚距、引脚厚度、外形及进线方向。C1–C3 预留直径 12.5 mm、脚距 5.0 mm；已购实物不匹配时应按手册处理，不能硬压装配。
- 紧急停机接口保留原方案的驱动禁止和软件锁存功能；它不切断所有电源，不能作为机械或人身安全装置。

这是已完成数字检查的首版教学原型，尚未实际焊接、通电或运行测试。

## 编辑与复导出

直接打开 KiCad 工程即可编辑，所有使用的封装已复制到工程本地 `footprints/`；3D 模型使用 KiCad 标准安装库。`source/` 是设计辅助脚本，不是需要烧入 STM32 的固件；脚本依赖 KiCad 10 Python/CLI、kicad-tool/kiutils 等工具，路径需按本机调整，运行环境不随包分发。

源 PCB 是最终版本。重新运行 `build` 会覆盖现有布线，仅供在副本中重建设计使用。任何电气/封装/走线修改后都应重新进行 ERC、DRC、原理图一致性和图像检查，并重新导出整个制造包，不能混用不同版本图层。

工艺参数参考：[嘉立创工艺能力](https://www.jlc.com/portal/vtechnology.html)、[嘉立创文件服务说明](https://www.jlc.com/portal/1/serviceGuide)。KiCad 导出使用[官方 CLI](https://docs.kicad.org/10.0/en/cli/cli.html)。
