Sylphiette666/stm32-rfid-smart-bin/hardware/current-low-cost/perfboard/IO_元件孔位及接口表.csv

位号 | 规格/用途 | 引脚 | 孔位 | 网络 | 装配说明
JCORE | 核心板信号入口 | 1 | A2 | GND | 本图自定义17针排针，不是核心板整排针序。逐根按GPIO名连接。
JCORE | 核心板信号入口 | 2 | A3 | 3V3_CORE | 本图自定义17针排针，不是核心板整排针序。逐根按GPIO名连接。
JCORE | 核心板信号入口 | 3 | A4 | PA0 | 本图自定义17针排针，不是核心板整排针序。逐根按GPIO名连接。
JCORE | 核心板信号入口 | 4 | A5 | PB15 | 本图自定义17针排针，不是核心板整排针序。逐根按GPIO名连接。
JCORE | 核心板信号入口 | 5 | A6 | PB5 | 本图自定义17针排针，不是核心板整排针序。逐根按GPIO名连接。
JCORE | 核心板信号入口 | 6 | A7 | PB13 | 本图自定义17针排针，不是核心板整排针序。逐根按GPIO名连接。
JCORE | 核心板信号入口 | 7 | A8 | SCL | 本图自定义17针排针，不是核心板整排针序。逐根按GPIO名连接。
JCORE | 核心板信号入口 | 8 | A9 | SDA | 本图自定义17针排针，不是核心板整排针序。逐根按GPIO名连接。
JCORE | 核心板信号入口 | 9 | A10 | PA4 | 本图自定义17针排针，不是核心板整排针序。逐根按GPIO名连接。
JCORE | 核心板信号入口 | 10 | A11 | PA15 | 本图自定义17针排针，不是核心板整排针序。逐根按GPIO名连接。
JCORE | 核心板信号入口 | 11 | A12 | PB10 | 本图自定义17针排针，不是核心板整排针序。逐根按GPIO名连接。
JCORE | 核心板信号入口 | 12 | A13 | PB11 | 本图自定义17针排针，不是核心板整排针序。逐根按GPIO名连接。
JCORE | 核心板信号入口 | 13 | A14 | PB3 | 本图自定义17针排针，不是核心板整排针序。逐根按GPIO名连接。
JCORE | 核心板信号入口 | 14 | A15 | PB4 | 本图自定义17针排针，不是核心板整排针序。逐根按GPIO名连接。
JCORE | 核心板信号入口 | 15 | A16 | PB1 | 本图自定义17针排针，不是核心板整排针序。逐根按GPIO名连接。
JCORE | 核心板信号入口 | 16 | A17 | PB12 | 本图自定义17针排针，不是核心板整排针序。逐根按GPIO名连接。
JCORE | 核心板信号入口 | 17 | A18 | PB14 | 本图自定义17针排针，不是核心板整排针序。逐根按GPIO名连接。
JPWR | 接 PWR JP8 | 1 | A21 | 5V_LOGIC
JPWR | 接 PWR JP8 | 2 | A22 | 3V3_EXT
JPWR | 接 PWR JP8 | 3 | A23 | VBAT_SW
JPWR | 接 PWR JP8 | 4 | A24 | GND
JSW | 碰撞 / 闭盖开关 | 1 | A27 | PB12
JSW | 碰撞 / 闭盖开关 | 2 | A28 | GND
JSW | 碰撞 / 闭盖开关 | 3 | A29 | PB14
JSW | 碰撞 / 闭盖开关 | 4 | A30 | GND
JMCP | MCP23017 模块 | 1 | X2 | 3V3_EXT | 模块外置。按丝印连接；地址A0/A1/A2在模块侧接GND，模块已有复位上拉可不装R5。
JMCP | MCP23017 模块 | 2 | X3 | GND | 模块外置。按丝印连接；地址A0/A1/A2在模块侧接GND，模块已有复位上拉可不装R5。
JMCP | MCP23017 模块 | 3 | X4 | SCL | 模块外置。按丝印连接；地址A0/A1/A2在模块侧接GND，模块已有复位上拉可不装R5。
JMCP | MCP23017 模块 | 4 | X5 | SDA | 模块外置。按丝印连接；地址A0/A1/A2在模块侧接GND，模块已有复位上拉可不装R5。
JMCP | MCP23017 模块 | 5 | X6 | MCP_RESET | 模块外置。按丝印连接；地址A0/A1/A2在模块侧接GND，模块已有复位上拉可不装R5。
JACT | 舵机 / 超声 / 驱动 | 1 | X9 | SERVO_SIG_5V | 此口只走信号和参考地；电机和舵机功率地不经此口回流。
JACT | 舵机 / 超声 / 驱动 | 2 | X10 | GND | 此口只走信号和参考地；电机和舵机功率地不经此口回流。
JACT | 舵机 / 超声 / 驱动 | 3 | X11 | US_TRIG_5V | 此口只走信号和参考地；电机和舵机功率地不经此口回流。
JACT | 舵机 / 超声 / 驱动 | 4 | X12 | ECHO_RAW | 此口只走信号和参考地；电机和舵机功率地不经此口回流。
JACT | 舵机 / 超声 / 驱动 | 5 | X13 | STBY_OUT | 此口只走信号和参考地；电机和舵机功率地不经此口回流。
JES | 急停双 NC 触点 | 1 | X16 | VBAT_SW | 第1-2针去NC1两个端子；第3-4针去NC2两个端子。不能接GPIO或LED触点。
JES | 急停双 NC 触点 | 2 | X17 | NC1_RETURN | 第1-2针去NC1两个端子；第3-4针去NC2两个端子。不能接GPIO或LED触点。
JES | 急停双 NC 触点 | 3 | X18 | VBAT_SW | 第1-2针去NC1两个端子；第3-4针去NC2两个端子。不能接GPIO或LED触点。
JES | 急停双 NC 触点 | 4 | X19 | NC2_RETURN | 第1-2针去NC1两个端子；第3-4针去NC2两个端子。不能接GPIO或LED触点。
JAUX | 外设信号出口 | 1 | X22 | DF_RX | 每个针按名称接对应模块，不是同一个模块的8针接口。
JAUX | 外设信号出口 | 2 | X23 | PB11 | 每个针按名称接对应模块，不是同一个模块的8针接口。
JAUX | 外设信号出口 | 3 | X24 | PB3 | 每个针按名称接对应模块，不是同一个模块的8针接口。
JAUX | 外设信号出口 | 4 | X25 | PB4 | 每个针按名称接对应模块，不是同一个模块的8针接口。
JAUX | 外设信号出口 | 5 | X26 | PA4 | 每个针按名称接对应模块，不是同一个模块的8针接口。
JAUX | 外设信号出口 | 6 | X27 | PA15 | 每个针按名称接对应模块，不是同一个模块的8针接口。
JAUX | 外设信号出口 | 7 | X28 | WP_N | 每个针按名称接对应模块，不是同一个模块的8针接口。
JAUX | 外设信号出口 | 8 | X29 | HOLD_N | 每个针按名称接对应模块，不是同一个模块的8针接口。
U1 | SN74AHCT125N | 1 | D4 | GND | DIP14座；缺口朝第1行。不要换成74HC125。8、11脚输出留空。
U1 | SN74AHCT125N | 2 | D5 | PA0 | DIP14座；缺口朝第1行。不要换成74HC125。8、11脚输出留空。
U1 | SN74AHCT125N | 3 | D6 | SERVO_SIG_5V | DIP14座；缺口朝第1行。不要换成74HC125。8、11脚输出留空。
U1 | SN74AHCT125N | 4 | D7 | GND | DIP14座；缺口朝第1行。不要换成74HC125。8、11脚输出留空。
U1 | SN74AHCT125N | 5 | D8 | PB15 | DIP14座；缺口朝第1行。不要换成74HC125。8、11脚输出留空。
U1 | SN74AHCT125N | 6 | D9 | US_TRIG_5V | DIP14座；缺口朝第1行。不要换成74HC125。8、11脚输出留空。
U1 | SN74AHCT125N | 7 | D10 | GND | DIP14座；缺口朝第1行。不要换成74HC125。8、11脚输出留空。
U1 | SN74AHCT125N | 8 | G10 | NC_U1_8 | DIP14座；缺口朝第1行。不要换成74HC125。8、11脚输出留空。
U1 | SN74AHCT125N | 9 | G9 | GND | DIP14座；缺口朝第1行。不要换成74HC125。8、11脚输出留空。
U1 | SN74AHCT125N | 10 | G8 | 5V_LOGIC | DIP14座；缺口朝第1行。不要换成74HC125。8、11脚输出留空。
U1 | SN74AHCT125N | 11 | G7 | NC_U1_11 | DIP14座；缺口朝第1行。不要换成74HC125。8、11脚输出留空。
U1 | SN74AHCT125N | 12 | G6 | GND | DIP14座；缺口朝第1行。不要换成74HC125。8、11脚输出留空。
U1 | SN74AHCT125N | 13 | G5 | 5V_LOGIC | DIP14座；缺口朝第1行。不要换成74HC125。8、11脚输出留空。
U1 | SN74AHCT125N | 14 | G4 | 5V_LOGIC | DIP14座；缺口朝第1行。不要换成74HC125。8、11脚输出留空。
C1 | 100nF | 1 | I3 | 5V_LOGIC
C1 | 100nF | 2 | I5 | GND
R1 | 10k | 1 | C12 | PA0
R1 | 10k | 2 | G12 | GND
R2 | 10k | 1 | C14 | PB15
R2 | 10k | 2 | G14 | GND
Q1 | 2N3904 | E | K5 | GND | 本图定义左E/中B/右C；实际厂家脚序必须核对。引脚套管弯折到孔位，不能仅按平面朝向猜。
Q1 | 2N3904 | B | L5 | ES1_BASE | 本图定义左E/中B/右C；实际厂家脚序必须核对。引脚套管弯折到孔位，不能仅按平面朝向猜。
Q1 | 2N3904 | C | M5 | KILL_BASE | 本图定义左E/中B/右C；实际厂家脚序必须核对。引脚套管弯折到孔位，不能仅按平面朝向猜。
Q2 | 2N3904 | E | K9 | GND | 本图定义左E/中B/右C；实际厂家脚序必须核对。引脚套管弯折到孔位，不能仅按平面朝向猜。
Q2 | 2N3904 | B | L9 | KILL_BASE | 本图定义左E/中B/右C；实际厂家脚序必须核对。引脚套管弯折到孔位，不能仅按平面朝向猜。
Q2 | 2N3904 | C | M9 | STBY_OUT | 本图定义左E/中B/右C；实际厂家脚序必须核对。引脚套管弯折到孔位，不能仅按平面朝向猜。
Q3 | 2N3904 | E | K13 | GND | 本图定义左E/中B/右C；实际厂家脚序必须核对。引脚套管弯折到孔位，不能仅按平面朝向猜。
Q3 | 2N3904 | B | L13 | ES2_BASE | 本图定义左E/中B/右C；实际厂家脚序必须核对。引脚套管弯折到孔位，不能仅按平面朝向猜。
Q3 | 2N3904 | C | M13 | PB13 | 本图定义左E/中B/右C；实际厂家脚序必须核对。引脚套管弯折到孔位，不能仅按平面朝向猜。
R3 | 4.7k | 1 | C17 | SCL | 条件装：总线只保留一组适合的等效上拉，模块自带上拉须计入。
R3 | 4.7k | 2 | G17 | 3V3_EXT | 条件装：总线只保留一组适合的等效上拉，模块自带上拉须计入。
R4 | 4.7k | 1 | C19 | SDA | 条件装：总线只保留一组适合的等效上拉，模块自带上拉须计入。
R4 | 4.7k | 2 | G19 | 3V3_EXT | 条件装：总线只保留一组适合的等效上拉，模块自带上拉须计入。
R5 | 10k | 1 | C21 | MCP_RESET | 条件装：MCP模块已有RESET上拉则核对后可不重复。
R5 | 10k | 2 | G21 | 3V3_EXT | 条件装：MCP模块已有RESET上拉则核对后可不重复。
R6 | 10k | 1 | C23 | PA4
R6 | 10k | 2 | G23 | 3V3_EXT
R7 | 10k | 1 | C25 | PA15
R7 | 10k | 2 | G25 | 3V3_EXT
R8 | 10k | 1 | C27 | WP_N | 条件装：仅FLASH有引出WP#/HOLD#且缺少适当上拉时装；否则针和电阻都留空。
R8 | 10k | 2 | G27 | 3V3_EXT | 条件装：仅FLASH有引出WP#/HOLD#且缺少适当上拉时装；否则针和电阻都留空。
R9 | 10k | 1 | C29 | HOLD_N | 条件装：仅FLASH有引出WP#/HOLD#且缺少适当上拉时装；否则针和电阻都留空。
R9 | 10k | 2 | G29 | 3V3_EXT | 条件装：仅FLASH有引出WP#/HOLD#且缺少适当上拉时装；否则针和电阻都留空。
R10 | 4.7k | 1 | K3 | NC1_RETURN
R10 | 4.7k | 2 | O3 | ES1_BASE
R11 | 100k | 1 | K7 | ES1_BASE
R11 | 100k | 2 | O7 | GND
R12 | 4.7k | 1 | K11 | NC2_RETURN
R12 | 4.7k | 2 | O11 | ES2_BASE
R13 | 100k | 1 | K15 | ES2_BASE
R13 | 100k | 2 | O15 | GND
R14 | 4.7k | 1 | Q5 | 3V3_EXT
R14 | 4.7k | 2 | U5 | KILL_BASE
R15 | 100k | 1 | Q9 | KILL_BASE
R15 | 100k | 2 | U9 | GND
R16 | 1k | 1 | Q13 | PB5
R16 | 1k | 2 | U13 | STBY_OUT
R17 | 10k | 1 | Q17 | PB5
R17 | 10k | 2 | U17 | GND
R18 | 10k | 1 | Q21 | STBY_OUT
R18 | 10k | 2 | U21 | GND
R19 | 10k | 1 | K19 | 3V3_CORE
R19 | 10k | 2 | O19 | PB13
R20 | 12k | 1 | K17 | ECHO_RAW
R20 | 12k | 2 | O17 | PB1
R21 | 20k | 1 | K21 | PB1
R21 | 20k | 2 | O21 | GND
R22 | 10k | 1 | K23 | PB3 | 编码器CLK/DT已有到EXT上拉时，不得再与CORE上拉混接；先取消模块该上拉或不装本电阻并验证。
R22 | 10k | 2 | O23 | 3V3_CORE | 编码器CLK/DT已有到EXT上拉时，不得再与CORE上拉混接；先取消模块该上拉或不装本电阻并验证。
R23 | 10k | 1 | K25 | PB4 | 编码器CLK/DT已有到EXT上拉时，不得再与CORE上拉混接；先取消模块该上拉或不装本电阻并验证。
R23 | 10k | 2 | O25 | 3V3_CORE | 编码器CLK/DT已有到EXT上拉时，不得再与CORE上拉混接；先取消模块该上拉或不装本电阻并验证。
R24 | 4.7k | 1 | K27 | PB11 | 3.3V DHT分支；5V DHT使用外置BSS138双向模块。已有上拉须计入。
R24 | 4.7k | 2 | O27 | 3V3_EXT | 3.3V DHT分支；5V DHT使用外置BSS138双向模块。已有上拉须计入。
R25 | 1k | 1 | K29 | PB10
R25 | 1k | 2 | O29 | DF_RX
R26 | 10k | 1 | Q25 | PB12
R26 | 10k | 2 | U25 | 3V3_CORE
R27 | 10k | 1 | Q29 | PB14
R27 | 10k | 2 | U29 | 3V3_CORE
