Sylphiette666/stm32-rfid-smart-bin/hardware/current-low-cost/perfboard/IO_逐根焊线表.csv

焊线编号 | 网络 | 起点孔 | 起点元件脚 | 终点孔 | 终点元件脚 | 线规 | 勾选
IO-W001 | GND | A2 | JCORE.1 | D4 | U1.1 | 26AWG
IO-W002 | GND | A24 | JPWR.4 | A28 | JSW.2 | 26AWG
IO-W003 | GND | A24 | JPWR.4 | G14 | R2.2 | 26AWG
IO-W004 | GND | A28 | JSW.2 | A30 | JSW.4 | 26AWG
IO-W005 | GND | D10 | U1.7 | G9 | U1.9 | 26AWG
IO-W006 | GND | D4 | U1.1 | D7 | U1.4 | 26AWG
IO-W007 | GND | D7 | U1.4 | D10 | U1.7 | 26AWG
IO-W008 | GND | G12 | R1.2 | G14 | R2.2 | 26AWG
IO-W009 | GND | G6 | U1.12 | I5 | C1.2 | 26AWG
IO-W010 | GND | G9 | U1.9 | G12 | R1.2 | 26AWG
IO-W011 | GND | G9 | U1.9 | G6 | U1.12 | 26AWG
IO-W012 | GND | I5 | C1.2 | K5 | Q1.E | 26AWG
IO-W013 | GND | K13 | Q3.E | O15 | R13.2 | 26AWG
IO-W014 | GND | K5 | Q1.E | K9 | Q2.E | 26AWG
IO-W015 | GND | K5 | Q1.E | O7 | R11.2 | 26AWG
IO-W016 | GND | K9 | Q2.E | K13 | Q3.E | 26AWG
IO-W017 | GND | O15 | R13.2 | O21 | R21.2 | 26AWG
IO-W018 | GND | O7 | R11.2 | U9 | R15.2 | 26AWG
IO-W019 | GND | U17 | R17.2 | U21 | R18.2 | 26AWG
IO-W020 | GND | U21 | R18.2 | O21 | R21.2 | 26AWG
IO-W021 | GND | X10 | JACT.2 | U9 | R15.2 | 26AWG
IO-W022 | GND | X3 | JMCP.2 | X10 | JACT.2 | 26AWG
IO-W023 | 3V3_CORE | A3 | JCORE.2 | K19 | R19.1 | 26AWG
IO-W024 | 3V3_CORE | K19 | R19.1 | O23 | R22.2 | 26AWG
IO-W025 | 3V3_CORE | O23 | R22.2 | O25 | R23.2 | 26AWG
IO-W026 | 3V3_CORE | O25 | R23.2 | U25 | R26.2 | 26AWG
IO-W027 | 3V3_CORE | U25 | R26.2 | U29 | R27.2 | 26AWG
IO-W028 | 3V3_EXT | A22 | JPWR.2 | G21 | R5.2 | 26AWG
IO-W029 | 3V3_EXT | G17 | R3.2 | G19 | R4.2 | 26AWG
IO-W030 | 3V3_EXT | G17 | R3.2 | Q5 | R14.1 | 26AWG
IO-W031 | 3V3_EXT | G19 | R4.2 | G21 | R5.2 | 26AWG
IO-W032 | 3V3_EXT | G21 | R5.2 | G23 | R6.2 | 26AWG
IO-W033 | 3V3_EXT | G23 | R6.2 | G25 | R7.2 | 26AWG
IO-W034 | 3V3_EXT | G25 | R7.2 | G27 | R8.2 | 26AWG
IO-W035 | 3V3_EXT | G27 | R8.2 | G29 | R9.2 | 26AWG
IO-W036 | 3V3_EXT | G27 | R8.2 | O27 | R24.2 | 26AWG
IO-W037 | 3V3_EXT | X2 | JMCP.1 | Q5 | R14.1 | 26AWG
IO-W038 | 5V_LOGIC | A21 | JPWR.1 | G8 | U1.10 | 26AWG
IO-W039 | 5V_LOGIC | G4 | U1.14 | I3 | C1.1 | 26AWG
IO-W040 | 5V_LOGIC | G5 | U1.13 | G4 | U1.14 | 26AWG
IO-W041 | 5V_LOGIC | G8 | U1.10 | G5 | U1.13 | 26AWG
IO-W042 | VBAT_SW | A23 | JPWR.3 | X18 | JES.3 | 26AWG
IO-W043 | VBAT_SW | X16 | JES.1 | X18 | JES.3 | 26AWG
IO-W044 | DF_RX | X22 | JAUX.1 | O29 | R25.2 | 26AWG
IO-W045 | ECHO_RAW | X12 | JACT.4 | K17 | R20.1 | 26AWG
IO-W046 | ES1_BASE | L5 | Q1.B | K7 | R11.1 | 26AWG
IO-W047 | ES1_BASE | L5 | Q1.B | O3 | R10.2 | 26AWG
IO-W048 | ES2_BASE | L13 | Q3.B | K15 | R13.1 | 26AWG
IO-W049 | ES2_BASE | L13 | Q3.B | O11 | R12.2 | 26AWG
IO-W050 | HOLD_N | X29 | JAUX.8 | C29 | R9.1 | 26AWG
IO-W051 | KILL_BASE | L9 | Q2.B | Q9 | R15.1 | 26AWG
IO-W052 | KILL_BASE | M5 | Q1.C | L9 | Q2.B | 26AWG
IO-W053 | KILL_BASE | M5 | Q1.C | U5 | R14.2 | 26AWG
IO-W054 | MCP_RESET | X6 | JMCP.5 | C21 | R5.1 | 26AWG
IO-W055 | NC1_RETURN | X17 | JES.2 | K3 | R10.1 | 26AWG
IO-W056 | NC2_RETURN | X19 | JES.4 | K11 | R12.1 | 26AWG
IO-W057 | PA0 | A4 | JCORE.3 | D5 | U1.2 | 26AWG
IO-W058 | PA0 | D5 | U1.2 | C12 | R1.1 | 26AWG
IO-W059 | PA15 | A11 | JCORE.10 | C25 | R7.1 | 26AWG
IO-W060 | PA15 | X27 | JAUX.6 | C25 | R7.1 | 26AWG
IO-W061 | PA4 | A10 | JCORE.9 | C23 | R6.1 | 26AWG
IO-W062 | PA4 | X26 | JAUX.5 | C23 | R6.1 | 26AWG
IO-W063 | PB1 | A16 | JCORE.15 | K21 | R21.1 | 26AWG
IO-W064 | PB1 | O17 | R20.2 | K21 | R21.1 | 26AWG
IO-W065 | PB10 | A12 | JCORE.11 | K29 | R25.1 | 26AWG
IO-W066 | PB11 | A13 | JCORE.12 | K27 | R24.1 | 26AWG
IO-W067 | PB11 | X23 | JAUX.2 | K27 | R24.1 | 26AWG
IO-W068 | PB12 | A17 | JCORE.16 | A27 | JSW.1 | 26AWG
IO-W069 | PB12 | A27 | JSW.1 | Q25 | R26.1 | 26AWG
IO-W070 | PB13 | A7 | JCORE.6 | M13 | Q3.C | 26AWG
IO-W071 | PB13 | M13 | Q3.C | O19 | R19.2 | 26AWG
IO-W072 | PB14 | A18 | JCORE.17 | A29 | JSW.3 | 26AWG
IO-W073 | PB14 | A29 | JSW.3 | Q29 | R27.1 | 26AWG
IO-W074 | PB15 | A5 | JCORE.4 | D8 | U1.5 | 26AWG
IO-W075 | PB15 | D8 | U1.5 | C14 | R2.1 | 26AWG
IO-W076 | PB3 | A14 | JCORE.13 | K23 | R22.1 | 26AWG
IO-W077 | PB3 | X24 | JAUX.3 | K23 | R22.1 | 26AWG
IO-W078 | PB4 | A15 | JCORE.14 | K25 | R23.1 | 26AWG
IO-W079 | PB4 | X25 | JAUX.4 | K25 | R23.1 | 26AWG
IO-W080 | PB5 | A6 | JCORE.5 | Q13 | R16.1 | 26AWG
IO-W081 | PB5 | Q13 | R16.1 | Q17 | R17.1 | 26AWG
IO-W082 | SCL | A8 | JCORE.7 | C17 | R3.1 | 26AWG
IO-W083 | SCL | A8 | JCORE.7 | X4 | JMCP.3 | 26AWG
IO-W084 | SDA | A9 | JCORE.8 | C19 | R4.1 | 26AWG
IO-W085 | SDA | A9 | JCORE.8 | X5 | JMCP.4 | 26AWG
IO-W086 | SERVO_SIG_5V | X9 | JACT.1 | D6 | U1.3 | 26AWG
IO-W087 | STBY_OUT | M9 | Q2.C | U13 | R16.2 | 26AWG
IO-W088 | STBY_OUT | U13 | R16.2 | Q21 | R18.1 | 26AWG
IO-W089 | STBY_OUT | X13 | JACT.5 | U13 | R16.2 | 26AWG
IO-W090 | US_TRIG_5V | X11 | JACT.3 | D9 | U1.6 | 26AWG
IO-W091 | WP_N | X28 | JAUX.7 | C27 | R8.1 | 26AWG
