Sylphiette666/stm32-rfid-smart-bin/hardware/current-low-cost/perfboard/PWR_元件孔位及接口表.csv

位号 | 规格/用途 | 引脚 | 孔位 | 网络 | 装配说明
JP1 | 开关后电池输入 | + | B3 | VBAT_SW | KF301-2P，脚距5.08mm。仅适用实际引脚可穿孔的器件；功率线焊在端子针脚上并做机械固定。
JP1 | 开关后电池输入 | - | D3 | GND | KF301-2P，脚距5.08mm。仅适用实际引脚可穿孔的器件；功率线焊在端子针脚上并做机械固定。
JP2 | 去降压 IN | + | J3 | VBAT_SW | KF301-2P，脚距5.08mm。仅适用实际引脚可穿孔的器件；功率线焊在端子针脚上并做机械固定。
JP2 | 去降压 IN | - | L3 | GND | KF301-2P，脚距5.08mm。仅适用实际引脚可穿孔的器件；功率线焊在端子针脚上并做机械固定。
JP3 | 接降压 OUT | + | R3 | 5V_BUS | KF301-2P，脚距5.08mm。仅适用实际引脚可穿孔的器件；功率线焊在端子针脚上并做机械固定。
JP3 | 接降压 OUT | - | T3 | GND | KF301-2P，脚距5.08mm。仅适用实际引脚可穿孔的器件；功率线焊在端子针脚上并做机械固定。
JP4 | 电机 5V 支路 | + | B12 | 5V_BUS | KF301-2P，脚距5.08mm。仅适用实际引脚可穿孔的器件；功率线焊在端子针脚上并做机械固定。
JP4 | 电机 5V 支路 | - | D12 | GND | KF301-2P，脚距5.08mm。仅适用实际引脚可穿孔的器件；功率线焊在端子针脚上并做机械固定。
JP5 | 舵机 5V 支路 | + | J12 | 5V_BUS | KF301-2P，脚距5.08mm。仅适用实际引脚可穿孔的器件；功率线焊在端子针脚上并做机械固定。
JP5 | 舵机 5V 支路 | - | L12 | GND | KF301-2P，脚距5.08mm。仅适用实际引脚可穿孔的器件；功率线焊在端子针脚上并做机械固定。
JP6 | 逻辑 5V 支路 | + | R12 | 5V_BUS | KF301-2P，脚距5.08mm。仅适用实际引脚可穿孔的器件；功率线焊在端子针脚上并做机械固定。
JP6 | 逻辑 5V 支路 | - | T12 | GND | KF301-2P，脚距5.08mm。仅适用实际引脚可穿孔的器件；功率线焊在端子针脚上并做机械固定。
CP1 | 470uF/16V | + | B17 | 5V_BUS | 正极接5V，带负号条纹的负极接GND；图示脚距5.08mm，实际不符时在邻近空孔调位并同步更新连线。直径不超过10mm。
CP1 | 470uF/16V | - | D17 | GND | 正极接5V，带负号条纹的负极接GND；图示脚距5.08mm，实际不符时在邻近空孔调位并同步更新连线。直径不超过10mm。
CP4 | 100nF | 1 | B21 | 5V_BUS
CP4 | 100nF | 2 | D21 | GND
CP2 | 1000uF/16V | + | J17 | 5V_BUS | 正极接5V，带负号条纹的负极接GND；图示脚距5.08mm，实际不符时在邻近空孔调位并同步更新连线。直径不超过10mm。
CP2 | 1000uF/16V | - | L17 | GND | 正极接5V，带负号条纹的负极接GND；图示脚距5.08mm，实际不符时在邻近空孔调位并同步更新连线。直径不超过10mm。
CP5 | 100nF | 1 | J21 | 5V_BUS
CP5 | 100nF | 2 | L21 | GND
CP3 | 100uF/16V | + | R17 | 5V_BUS | 正极接5V，带负号条纹的负极接GND；图示脚距5.08mm，实际不符时在邻近空孔调位并同步更新连线。直径不超过10mm。
CP3 | 100uF/16V | - | T17 | GND | 正极接5V，带负号条纹的负极接GND；图示脚距5.08mm，实际不符时在邻近空孔调位并同步更新连线。直径不超过10mm。
CP6 | 100nF | 1 | R21 | 5V_BUS
CP6 | 100nF | 2 | T21 | GND
BUS+ | 0.8mm 铜线汇流排 | 1 | V3 | 5V_BUS | 焊接面用一根连续直径约0.8mm镀锡实心铜线覆盖V3至V9，仅V3/V5/V7/V9固定焊接；支路线搭焊在铜线上，不与元件腿挤入同孔。完工绝缘罩住。
BUS+ | 0.8mm 铜线汇流排 | 2 | V5 | 5V_BUS | 焊接面用一根连续直径约0.8mm镀锡实心铜线覆盖V3至V9，仅V3/V5/V7/V9固定焊接；支路线搭焊在铜线上，不与元件腿挤入同孔。完工绝缘罩住。
BUS+ | 0.8mm 铜线汇流排 | 3 | V7 | 5V_BUS | 焊接面用一根连续直径约0.8mm镀锡实心铜线覆盖V3至V9，仅V3/V5/V7/V9固定焊接；支路线搭焊在铜线上，不与元件腿挤入同孔。完工绝缘罩住。
BUS+ | 0.8mm 铜线汇流排 | 4 | V9 | 5V_BUS | 焊接面用一根连续直径约0.8mm镀锡实心铜线覆盖V3至V9，仅V3/V5/V7/V9固定焊接；支路线搭焊在铜线上，不与元件腿挤入同孔。完工绝缘罩住。
BUS- | 0.8mm 铜线汇流排 | 1 | X3 | GND | 焊接面用一根连续直径约0.8mm镀锡实心铜线覆盖X3至X11，仅列出节点固定焊接；与V列汇流排保持绝缘间隔，线交叉处必须有绝缘层。
BUS- | 0.8mm 铜线汇流排 | 2 | X5 | GND | 焊接面用一根连续直径约0.8mm镀锡实心铜线覆盖X3至X11，仅列出节点固定焊接；与V列汇流排保持绝缘间隔，线交叉处必须有绝缘层。
BUS- | 0.8mm 铜线汇流排 | 3 | X7 | GND | 焊接面用一根连续直径约0.8mm镀锡实心铜线覆盖X3至X11，仅列出节点固定焊接；与V列汇流排保持绝缘间隔，线交叉处必须有绝缘层。
BUS- | 0.8mm 铜线汇流排 | 4 | X9 | GND | 焊接面用一根连续直径约0.8mm镀锡实心铜线覆盖X3至X11，仅列出节点固定焊接；与V列汇流排保持绝缘间隔，线交叉处必须有绝缘层。
BUS- | 0.8mm 铜线汇流排 | 5 | X11 | GND | 焊接面用一根连续直径约0.8mm镀锡实心铜线覆盖X3至X11，仅列出节点固定焊接；与V列汇流排保持绝缘间隔，线交叉处必须有绝缘层。
JP7 | 外置3.3V模块 OUT | 1 | R7 | 3V3_EXT | 不是稳压器；这里接外置稳压模块输出。其输入接JP6。
JP7 | 外置3.3V模块 OUT | 2 | S7 | GND | 不是稳压器；这里接外置稳压模块输出。其输入接JP6。
JP8 | 去 IO JPWR | 1 | X23 | 5V_BUS
JP8 | 去 IO JPWR | 2 | X24 | 3V3_EXT
JP8 | 去 IO JPWR | 3 | X25 | VBAT_SW
JP8 | 去 IO JPWR | 4 | X26 | GND
JP9 | 去核心 PA1 / GND | 1 | R28 | BAT_ADC
JP9 | 去核心 PA1 / GND | 2 | R29 | GND
JP10 | 灯控制输入 | 1 | B24 | MCP_GPA5
JP10 | 灯控制输入 | 2 | B25 | GND
JP11 | AO3400A 的 G / S / D | 1 | J27 | LED_GATE | 这是自定义线束端子，不是任意SOT23转接板的直插脚位；万用表追踪后接G、S、D。
JP11 | AO3400A 的 G / S / D | 2 | J28 | GND | 这是自定义线束端子，不是任意SOT23转接板的直插脚位；万用表追踪后接G、S、D。
JP11 | AO3400A 的 G / S / D | 3 | J29 | LED_NEG | 这是自定义线束端子，不是任意SOT23转接板的直插脚位；万用表追踪后接G、S、D。
JP12 | 白色LED A / K | 1 | B28 | LED_POS
JP12 | 白色LED A / K | 2 | B29 | LED_NEG
RP1 | 33k 1% | 1 | L23 | VBAT_SW
RP1 | 33k 1% | 2 | P23 | BAT_ADC
RP2 | 10k 1% | 1 | L26 | BAT_ADC
RP2 | 10k 1% | 2 | P26 | GND
CP7 | 100nF | 1 | L28 | BAT_ADC
CP7 | 100nF | 2 | N28 | GND
RP3 | 100R | 1 | D24 | MCP_GPA5
RP3 | 100R | 2 | H24 | LED_GATE
RP4 | 100k | 1 | F26 | LED_GATE
RP4 | 100k | 2 | F30 | GND
RP5 | 220R | 1 | L30 | 5V_BUS
RP5 | 220R | 2 | P30 | LED_POS
