Sylphiette666/stm32-rfid-smart-bin/hardware/current-low-cost/perfboard/PWR_逐根焊线表.csv

焊线编号 | 网络 | 起点孔 | 起点元件脚 | 终点孔 | 终点元件脚 | 线规 | 勾选
PWR-W001 | 5V_BUS | V3 | BUS+.1 | V5 | BUS+.2 | 0.8mm汇流铜线
PWR-W002 | 5V_BUS | V5 | BUS+.2 | V7 | BUS+.3 | 0.8mm汇流铜线
PWR-W003 | 5V_BUS | V7 | BUS+.3 | V9 | BUS+.4 | 0.8mm汇流铜线
PWR-W004 | GND | X3 | BUS-.1 | X5 | BUS-.2 | 0.8mm汇流铜线
PWR-W005 | GND | X5 | BUS-.2 | X7 | BUS-.3 | 0.8mm汇流铜线
PWR-W006 | GND | X7 | BUS-.3 | X9 | BUS-.4 | 0.8mm汇流铜线
PWR-W007 | GND | X9 | BUS-.4 | X11 | BUS-.5 | 0.8mm汇流铜线
PWR-W008 | 5V_BUS | R3 | JP3.+ | V3 | BUS+.1 | 20AWG
PWR-W009 | 5V_BUS | V5 | BUS+.2 | B12 | JP4.+ | 20AWG
PWR-W010 | 5V_BUS | V7 | BUS+.3 | J12 | JP5.+ | 20AWG
PWR-W011 | 5V_BUS | V9 | BUS+.4 | R12 | JP6.+ | 20AWG
PWR-W012 | GND | D3 | JP1.- | L3 | JP2.- | 20AWG
PWR-W013 | GND | T3 | JP3.- | X3 | BUS-.1 | 20AWG
PWR-W014 | GND | X11 | BUS-.5 | D3 | JP1.- | 20AWG
PWR-W015 | GND | X5 | BUS-.2 | D12 | JP4.- | 20AWG
PWR-W016 | GND | X7 | BUS-.3 | L12 | JP5.- | 20AWG
PWR-W017 | GND | X9 | BUS-.4 | T12 | JP6.- | 20AWG
PWR-W018 | VBAT_SW | B3 | JP1.+ | J3 | JP2.+ | 20AWG
PWR-W019 | GND | B25 | JP10.2 | F30 | RP4.2 | 26AWG
PWR-W020 | GND | D12 | JP4.- | D17 | CP1.- | 22AWG
PWR-W021 | GND | D17 | CP1.- | D21 | CP4.2 | 26AWG
PWR-W022 | GND | J28 | JP11.2 | F30 | RP4.2 | 26AWG
PWR-W023 | GND | J28 | JP11.2 | N28 | CP7.2 | 26AWG
PWR-W024 | GND | L12 | JP5.- | L17 | CP2.- | 22AWG
PWR-W025 | GND | L17 | CP2.- | L21 | CP5.2 | 26AWG
PWR-W026 | GND | P26 | RP2.2 | N28 | CP7.2 | 26AWG
PWR-W027 | GND | R29 | JP9.2 | N28 | CP7.2 | 26AWG
PWR-W028 | GND | T12 | JP6.- | S7 | JP7.2 | 26AWG
PWR-W029 | GND | T12 | JP6.- | T17 | CP3.- | 22AWG
PWR-W030 | GND | T17 | CP3.- | T21 | CP6.2 | 26AWG
PWR-W031 | GND | T21 | CP6.2 | P26 | RP2.2 | 26AWG
PWR-W032 | GND | X26 | JP8.4 | P26 | RP2.2 | 26AWG
PWR-W033 | 3V3_EXT | R7 | JP7.1 | X24 | JP8.2 | 26AWG
PWR-W034 | 5V_BUS | B12 | JP4.+ | B17 | CP1.+ | 22AWG
PWR-W035 | 5V_BUS | B17 | CP1.+ | B21 | CP4.1 | 26AWG
PWR-W036 | 5V_BUS | J12 | JP5.+ | J17 | CP2.+ | 22AWG
PWR-W037 | 5V_BUS | J17 | CP2.+ | J21 | CP5.1 | 26AWG
PWR-W038 | 5V_BUS | R12 | JP6.+ | R17 | CP3.+ | 22AWG
PWR-W039 | 5V_BUS | R17 | CP3.+ | R21 | CP6.1 | 26AWG
PWR-W040 | 5V_BUS | R21 | CP6.1 | L30 | RP5.1 | 26AWG
PWR-W041 | 5V_BUS | R21 | CP6.1 | X23 | JP8.1 | 26AWG
PWR-W042 | VBAT_SW | J3 | JP2.+ | L23 | RP1.1 | 26AWG
PWR-W043 | VBAT_SW | X25 | JP8.3 | L23 | RP1.1 | 26AWG
PWR-W044 | BAT_ADC | L26 | RP2.1 | L28 | CP7.1 | 26AWG
PWR-W045 | BAT_ADC | P23 | RP1.2 | L26 | RP2.1 | 26AWG
PWR-W046 | BAT_ADC | R28 | JP9.1 | L28 | CP7.1 | 26AWG
PWR-W047 | LED_GATE | H24 | RP3.2 | F26 | RP4.1 | 26AWG
PWR-W048 | LED_GATE | J27 | JP11.1 | F26 | RP4.1 | 26AWG
PWR-W049 | LED_NEG | J29 | JP11.3 | B29 | JP12.2 | 26AWG
PWR-W050 | LED_POS | B28 | JP12.1 | P30 | RP5.2 | 26AWG
PWR-W051 | MCP_GPA5 | B24 | JP10.1 | D24 | RP3.1 | 26AWG
