Sylphiette666/stm32-rfid-smart-bin/hardware/current-low-cost/pcb-a/review/bom-lint-normalized.csv

Designator | Quantity | Value | Footprint | MPN | Manufacturer | Supplier | Supplier_PN | DNP | Notes
C1 | 1 | 470uF/16V | Capacitor_THT:CP_Radial_D12.5mm_P5.00mm |  |  | 复用已购器件 |  | NO | 靠近J4；若驱动距板较远，驱动VM端仍补就地电容。 安装包络D12.5mm、P5.00mm；1正2负；已有件小于包络可整形，超出需重新确认。
C2 | 1 | 1000uF/16V | Capacitor_THT:CP_Radial_D12.5mm_P5.00mm |  |  | 复用已购器件 |  | NO | 靠近J5；尺寸暂按直径12.5mm、脚距5mm预留，实物不匹配时短绝缘飞线并机械固定。 安装包络D12.5mm、P5.00mm；1正2负；已有件小于包络可整形，超出需重新确认。
C3 | 1 | 100uF/16V | Capacitor_THT:CP_Radial_D12.5mm_P5.00mm |  |  | 复用已购器件 |  | NO | 靠近J6逻辑支路；DFPlayer模块附近仍需其本地100uF。 安装包络D12.5mm、P5.00mm；1正2负；已有件小于包络可整形，超出需重新确认。
C4 | 1 | 100nF | Capacitor_THT:C_Disc_D5.0mm_W2.5mm_P5.00mm |  |  | 复用已购器件 |  | NO | 对应J4支路去耦；实物瓷片脚距按实测核对。 复用100nF瓷片，耐压至少16V，核5mm脚距及本体尺寸。
C5 | 1 | 100nF | Capacitor_THT:C_Disc_D5.0mm_W2.5mm_P5.00mm |  |  | 复用已购器件 |  | NO | 对应J5支路去耦；实物瓷片脚距按实测核对。 复用100nF瓷片，耐压至少16V，核5mm脚距及本体尺寸。
C6 | 1 | 100nF | Capacitor_THT:C_Disc_D5.0mm_W2.5mm_P5.00mm |  |  | 复用已购器件 |  | NO | 对应J6支路去耦；实物瓷片脚距按实测核对。 复用100nF瓷片，耐压至少16V，核5mm脚距及本体尺寸。
C7 | 1 | 100nF | Capacitor_THT:C_Disc_D5.0mm_W2.5mm_P5.00mm |  |  | 复用已购器件 |  | NO | 靠近R1/R2与JP9；ADC慢信号滤波。 复用100nF瓷片，耐压至少16V，核5mm脚距及本体尺寸。
C8 | 1 | 100nF | Capacitor_THT:C_Disc_D5.0mm_W2.5mm_P5.00mm |  |  | 复用已购器件 |  | NO | 紧邻U1第14/7脚，尽量短回路。 复用100nF瓷片，耐压至少16V，核5mm脚距及本体尺寸。
H1 | 1 | M3 NPTH | MountingHole:MountingHole_3.2mm_M3 |  |  | 复用已购器件 |  | YES | 3.2mm非金属化安装孔，不采购孔件；M3绝缘立柱、螺钉和垫圈另按结构备齐。
J1 | 1 | BAT_SW | TerminalBlock_Phoenix:TerminalBlock_Phoenix_MKDS-1,5-2-5.08_1x02_P5.08mm_Horizontal |  |  | 复用已购器件 |  | NO | 电池保护板输出正极经外置保险座和总开关后进入1脚；2脚为电池负极。禁止接未经保险的裸电池。 板孔距5.08mm、钻孔1.3mm；Phoenix库几何包络约11.22×11.125mm。已有KF301必须另核外壳、脚形、进线朝向，不能仅凭名称认定兼容。
J2 | 1 | BUCK_IN | TerminalBlock_Phoenix:TerminalBlock_Phoenix_MKDS-1,5-2-5.08_1x02_P5.08mm_Horizontal |  |  | 复用已购器件 |  | NO | 外置非隔离5V降压输入；20AWG短线。 板孔距5.08mm、钻孔1.3mm；Phoenix库几何包络约11.22×11.125mm。已有KF301必须另核外壳、脚形、进线朝向，不能仅凭名称认定兼容。
J3 | 1 | BUCK_OUT | TerminalBlock_Phoenix:TerminalBlock_Phoenix_MKDS-1,5-2-5.08_1x02_P5.08mm_Horizontal |  |  | 复用已购器件 |  | NO | 外置降压输出，接入板上星形中心。电池满电8.4V不能接此口。 板孔距5.08mm、钻孔1.3mm；Phoenix库几何包络约11.22×11.125mm。已有KF301必须另核外壳、脚形、进线朝向，不能仅凭名称认定兼容。
J4 | 1 | MOTOR_PWR | TerminalBlock_Phoenix:TerminalBlock_Phoenix_MKDS-1,5-2-5.08_1x02_P5.08mm_Horizontal |  |  | 复用已购器件 |  | NO | 电机主电流支路；22AWG短线，长线/偏大电流用20AWG。 板孔距5.08mm、钻孔1.3mm；Phoenix库几何包络约11.22×11.125mm。已有KF301必须另核外壳、脚形、进线朝向，不能仅凭名称认定兼容。
J5 | 1 | SERVO_PWR | TerminalBlock_Phoenix:TerminalBlock_Phoenix_MKDS-1,5-2-5.08_1x02_P5.08mm_Horizontal |  |  | 复用已购器件 |  | NO | 舵机主电流仅走本支路；原3芯舵机延长线在配电处分离电源与信号。 板孔距5.08mm、钻孔1.3mm；Phoenix库几何包络约11.22×11.125mm。已有KF301必须另核外壳、脚形、进线朝向，不能仅凭名称认定兼容。
J6 | 1 | LOGIC_PWR | TerminalBlock_Phoenix:TerminalBlock_Phoenix_MKDS-1,5-2-5.08_1x02_P5.08mm_Horizontal |  |  | 复用已购器件 |  | NO | 逻辑5V支路；可给DFPlayer和3.3V稳压输入等可靠分线，不把多根线强塞一只端子。 板孔距5.08mm、钻孔1.3mm；Phoenix库几何包络约11.22×11.125mm。已有KF301必须另核外壳、脚形、进线朝向，不能仅凭名称认定兼容。
J7 | 1 | EXT_REG | Connector_PinHeader_2.54mm:PinHeader_1x03_P2.54mm_Vertical |  |  | 复用已购器件 |  | NO | 外置3.3V稳压模块低电流接口；确认额定输出及GND；本口3脚是模块输出进入本板，不是核心3V3。
J8 | 1 | CORE_PA | Connector_PinHeader_2.54mm:PinHeader_1x17_P2.54mm_Vertical |  |  | 复用已购器件 |  | NO | 自定义17针线束；按核心丝印逐线连接，不能整排直插；正常系统核心由本板1脚供5V，禁止同时插核心USB；若做独立USB台架，先断本板电源并拔下与核心相连的全部线束，再另行测试。
J9 | 1 | CORE_PB | Connector_PinHeader_2.54mm:PinHeader_1x16_P2.54mm_Vertical |  |  | 复用已购器件 |  | NO | 自定义16针线束；PB2/BOOT1不接；PA13/PA14在核心直接接SWD并始终保留。
J10 | 1 | MCP_BUS | Connector_PinHeader_2.54mm:PinHeader_1x05_P2.54mm_Vertical |  |  | 复用已购器件 |  | NO | 成品MCP23017模块五线；A0/A1/A2在模块侧接地；INTA/INTB不用；RESET不接核心NRST。
J11 | 1 | MCP_A | Connector_PinHeader_2.54mm:PinHeader_1x07_P2.54mm_Vertical |  |  | 复用已购器件 |  | NO | 逐线接模块GPA0至GPA6；GPA7不外接、软件设输出0。
J12 | 1 | MCP_B | Connector_PinHeader_2.54mm:PinHeader_1x07_P2.54mm_Vertical |  |  | 复用已购器件 |  | NO | 逐线接模块GPB0至GPB6；GPB7不外接、软件设输出0。
J13 | 1 | OLED | Connector_PinHeader_2.54mm:PinHeader_1x04_P2.54mm_Vertical |  |  | 复用已购器件 |  | NO | 仅用于已确认3.3V供电I2C OLED；I2C拉3V3_EXT。
J14 | 1 | MPU6050 | Connector_PinHeader_2.54mm:PinHeader_1x04_P2.54mm_Vertical |  |  | 复用已购器件 |  | NO | JP5选择模块实际VIN电压；不能因芯片3.3V就默认板VIN也3.3V；任何模块内5V总线上拉必须处理。
J15 | 1 | RC522 | Connector_PinHeader_2.54mm:PinHeader_1x07_P2.54mm_Vertical |  |  | 复用已购器件 |  | NO | RC522仅3.3V；商品排针SDA在SPI模式为CS，不接I2C；IRQ不接。
J16 | 1 | FLASH | Connector_PinHeader_2.54mm:PinHeader_1x08_P2.54mm_Vertical |  |  | 复用已购器件 |  | NO | 按实际3.3V SPI NOR芯片核对；不存在的WP/HOLD外露脚不接，不能套商品针序。
J17 | 1 | HC05 | Connector_PinHeader_2.54mm:PinHeader_1x04_P2.54mm_Vertical |  |  | 复用已购器件 |  | NO | JP6供电选择按模块规格；UART输入输出均须3.3V逻辑。
J18 | 1 | PC_UART | Connector_PinHeader_2.54mm:PinHeader_1x03_P2.54mm_Vertical |  |  | 复用已购器件 |  | NO | 3.3V逻辑USB转串口；本接口不提供电源，转换器VCC/5V/3V3脚不接。
J19 | 1 | TB6612_CTRL | Connector_PinHeader_2.54mm:PinHeader_1x09_P2.54mm_Vertical |  |  | 复用已购器件 |  | NO | 本口仅逻辑；VM和动力地走J4；AO1/AO2/BO1/BO2在驱动模块直接接电机粗线。
J20 | 1 | SERVO_SIG | Connector_PinHeader_2.54mm:PinHeader_1x02_P2.54mm_Vertical |  |  | 复用已购器件 |  | NO | 1脚是PWM逻辑输出，不是舵机正电源；SG90主电源走J5，主地也直接回J5。
J21 | 1 | HC_SR04 | Connector_PinHeader_2.54mm:PinHeader_1x04_P2.54mm_Vertical |  |  | 复用已购器件 |  | NO | ECHO已经由板上12k/20k分压至PB1；不得从模块ECHO再另跨线到核心。
J22 | 1 | DHT | Connector_PinHeader_2.54mm:PinHeader_1x03_P2.54mm_Vertical |  |  | 复用已购器件 |  | NO | 3.3V分支JP7=1-2且JP8闭合；5V分支JP7=2-3、JP8断开，外置BSS138经J23转换；严禁5V分支短接JP8。
J23 | 1 | DHT_LEVEL | Connector_PinHeader_2.54mm:PinHeader_1x05_P2.54mm_Vertical |  |  | 复用已购器件 |  | NO | 仅5V DHT分支使用外置BSS138双向开漏转换；3.3V分支保持空。转换模块GND全部共地。
J24 | 1 | ENCODER | Connector_PinHeader_2.54mm:PinHeader_1x05_P2.54mm_Vertical |  |  | 复用已购器件 |  | NO | 仅3.3V编码器模块；CLK/DT的CORE上拉与模块EXT上拉二选一；SW上拉同样核对。
J25 | 1 | KEYS_LID | Connector_PinHeader_2.54mm:PinHeader_1x06_P2.54mm_Vertical |  |  | 复用已购器件 |  | NO | 三组接地开关：MODE、BACK轻触NO；闭盖用NO微动。轻触4脚同组导通须实测。
J26 | 1 | BUMPER | Connector_PinHeader_2.54mm:PinHeader_1x02_P2.54mm_Vertical |  |  | 复用已购器件 |  | NO | 外置左右微动NC串联，任一个碰撞或断线为高；不用NO端。
J27 | 1 | ESTOP_2NC | Connector_PinHeader_2.54mm:PinHeader_1x04_P2.54mm_Vertical |  |  | 复用已购器件 |  | NO | 急停必须两组独立NC；开关闭合正常通，按下断。此口含最高8.4V，不能插传感器/MCU；禁止插跳帽伪装急停。
J28 | 1 | AO3400_ADAPTER | Connector_PinHeader_2.54mm:PinHeader_1x03_P2.54mm_Vertical |  |  | 复用已购器件 |  | NO | AO3400A是已购裸管，先焊到转接板并核对G/S/D，再外接本接口；不能照商品排针顺序。
J29 | 1 | WHITE_LED | Connector_PinHeader_2.54mm:PinHeader_1x02_P2.54mm_Vertical |  |  | 复用已购器件 |  | NO | 单颗小功率白LED正负端，板上220Ω串联限流；不能换成灯带。
J30 | 1 | BUZZER | Connector_PinHeader_2.54mm:PinHeader_1x03_P2.54mm_Vertical |  |  | 复用已购器件 |  | NO | 仅带驱动三线蜂鸣模块；核供电和有效电平再选JP3/4与R36/37。
J31 | 1 | DFPLAYER_SIG | Connector_PinHeader_2.54mm:PinHeader_1x03_P2.54mm_Vertical |  |  | 复用已购器件 |  | NO | 仅信号口。DFPlayer VCC和电源GND以独立适当线径从J6引；喇叭接模块SPK1/2而非GND；模块TX不接。BUSY必须为<=3.3V或先外置适配。
J32 | 1 | LIGHT | Connector_PinHeader_2.54mm:PinHeader_1x03_P2.54mm_Vertical |  |  | 复用已购器件 |  | NO | 默认3.3V光敏AO。若仅DO改软件模式；若5V模拟AO需外置分压校准，禁止用NPN代替模拟采样。热敏为台架替换，不能与光敏并接。
J33 | 1 | IR_INPUTS | Connector_PinHeader_2.54mm:PinHeader_1x09_P2.54mm_Vertical |  |  | 复用已购器件 |  | NO | 自定义供电/信号汇集口；六路输入必须经外置条件适配后<=3.3V。3V3与5V是两根可用电源，绝不能同时接模块同一VCC。
JP3 | 1 | BUZZ_SIG_SELECT | Connector_PinHeader_2.54mm:PinHeader_1x03_P2.54mm_Vertical |  |  | 复用已购器件 |  | NO | 3.3V可驱动模块选1-2；仅确需5V控制时2-3；通道3始终使能；两输出不可并接。 排针应焊接；DNP不表示跳帽状态。JP3—JP8默认不加帽，JP9加帽，JP10不加帽。
JP4 | 1 | BUZZ_V_SELECT | Connector_PinHeader_2.54mm:PinHeader_1x03_P2.54mm_Vertical |  |  | 复用已购器件 |  | NO | 按模块VCC选3.3V或5V，只能一帽；未确认前保持开路。 排针应焊接；DNP不表示跳帽状态。JP3—JP8默认不加帽，JP9加帽，JP10不加帽。
JP5 | 1 | MPU_V_SELECT | Connector_PinHeader_2.54mm:PinHeader_1x03_P2.54mm_Vertical |  |  | 复用已购器件 |  | NO | 核模块VIN/稳压压差后选择；无论VIN如何SCL/SDA均只拉EXT3.3V。 排针应焊接；DNP不表示跳帽状态。JP3—JP8默认不加帽，JP9加帽，JP10不加帽。
JP6 | 1 | HC05_V_SELECT | Connector_PinHeader_2.54mm:PinHeader_1x03_P2.54mm_Vertical |  |  | 复用已购器件 |  | NO | 带稳压底板通常VIN5V，裸核心通常3.3V；必须核对实物。 排针应焊接；DNP不表示跳帽状态。JP3—JP8默认不加帽，JP9加帽，JP10不加帽。
JP7 | 1 | DHT_V_SELECT | Connector_PinHeader_2.54mm:PinHeader_1x03_P2.54mm_Vertical |  |  | 复用已购器件 |  | NO | 3.3V模块1-2；5V模块2-3，同时JP8必须开路并装外置BSS138。 排针应焊接；DNP不表示跳帽状态。JP3—JP8默认不加帽，JP9加帽，JP10不加帽。
JP8 | 1 | DHT_DIRECT | Connector_PinHeader_2.54mm:PinHeader_1x02_P2.54mm_Vertical |  |  | 复用已购器件 |  | NO | 仅3.3V供电且已确认DATA安全时闭合；与5V DHT分支互斥。 排针应焊接；DNP不表示跳帽状态。JP3—JP8默认不加帽，JP9加帽，JP10不加帽。
JP9 | 1 | ADC_LINK | Connector_PinHeader_2.54mm:PinHeader_1x02_P2.54mm_Vertical |  |  | 复用已购器件 |  | NO | 正常装帽；电池仍接通而单独关闭/拔掉核心电源前拔帽，防ADC向掉电核心注入。 排针应焊接；DNP不表示跳帽状态。JP3—JP8默认不加帽，JP9加帽，JP10不加帽。
JP10 | 1 | MCP_RESET_TEST | Connector_PinHeader_2.54mm:PinHeader_1x02_P2.54mm_Vertical |  |  | 复用已购器件 |  | NO | 复位测试短接点，正常禁止长期留帽；不是核心NRST。 排针应焊接；DNP不表示跳帽状态。JP3—JP8默认不加帽，JP9加帽，JP10不加帽。
Q1 | 1 | 2N3904 | Package_TO_SOT_THT:TO-92_Inline_Wide | 2N3904 | 脚序依据onsemi；已有品牌待核 | 复用已购器件 |  | NO | 按onsemi 2N3904 Rev3 TO-92资料定义1=E,2=B,3=C；已购其它品牌必须核数据手册/实测，不按外壳平面猜脚。
R1 | 1 | 33k | Resistor_THT:R_Axial_DIN0207_L6.3mm_D2.5mm_P10.16mm_Horizontal |  |  | 复用已购器件 |  | NO | 1%；与R2构成分压，8.4V约1.953V。 复用1/4W轴向件；R1/R2/R25/R26采用1%，其余按原清单。
R2 | 1 | 10k | Resistor_THT:R_Axial_DIN0207_L6.3mm_D2.5mm_P10.16mm_Horizontal |  |  | 复用已购器件 |  | NO | 1%；ADC分压下臂。 复用1/4W轴向件；R1/R2/R25/R26采用1%，其余按原清单。
R3 | 1 | 100 | Resistor_THT:R_Axial_DIN0207_L6.3mm_D2.5mm_P10.16mm_Horizontal |  |  | 复用已购器件 |  | NO | 栅极串联，不可拿来作为LED限流。 复用1/4W轴向件；R1/R2/R25/R26采用1%，其余按原清单。
R4 | 1 | 100k | Resistor_THT:R_Axial_DIN0207_L6.3mm_D2.5mm_P10.16mm_Horizontal |  |  | 复用已购器件 |  | NO | G-S默认下拉，复位关灯。 复用1/4W轴向件；R1/R2/R25/R26采用1%，其余按原清单。
R5 | 1 | 220 | Resistor_THT:R_Axial_DIN0207_L6.3mm_D2.5mm_P10.16mm_Horizontal |  |  | 复用已购器件 |  | NO | 仅适用本方案单颗小功率白LED，目标几mA至约10mA。 复用1/4W轴向件；R1/R2/R25/R26采用1%，其余按原清单。
R6 | 1 | 10k | Resistor_THT:R_Axial_DIN0207_L6.3mm_D2.5mm_P10.16mm_Horizontal |  |  | 复用已购器件 |  | NO | 上电PWM输入下拉。 复用1/4W轴向件；R1/R2/R25/R26采用1%，其余按原清单。
R7 | 1 | 10k | Resistor_THT:R_Axial_DIN0207_L6.3mm_D2.5mm_P10.16mm_Horizontal |  |  | 复用已购器件 |  | NO | 上电TRIG输入下拉。 复用1/4W轴向件；R1/R2/R25/R26采用1%，其余按原清单。
R8 | 1 | 4.7k | Resistor_THT:R_Axial_DIN0207_L6.3mm_D2.5mm_P10.16mm_Horizontal |  |  | 复用已购器件 |  | YES | 条件上拉：只保留合适的等效上拉；模块已带上拉时核算并可DNP。 复用1/4W轴向件；R1/R2/R25/R26采用1%，其余按原清单。
R9 | 1 | 4.7k | Resistor_THT:R_Axial_DIN0207_L6.3mm_D2.5mm_P10.16mm_Horizontal |  |  | 复用已购器件 |  | YES | 条件上拉：两总线空闲电压只能为3V3_EXT，不允许5V上拉。 复用1/4W轴向件；R1/R2/R25/R26采用1%，其余按原清单。
R10 | 1 | 10k | Resistor_THT:R_Axial_DIN0207_L6.3mm_D2.5mm_P10.16mm_Horizontal |  |  | 复用已购器件 |  | NO | 模块已有复位上拉时可以DNP；不可连接核心NRST。 复用1/4W轴向件；R1/R2/R25/R26采用1%，其余按原清单。
R11 | 1 | 10k | Resistor_THT:R_Axial_DIN0207_L6.3mm_D2.5mm_P10.16mm_Horizontal |  |  | 复用已购器件 |  | NO | RC522 CS默认高；同轨已有适宜上拉时可以DNP。 复用1/4W轴向件；R1/R2/R25/R26采用1%，其余按原清单。
R12 | 1 | 10k | Resistor_THT:R_Axial_DIN0207_L6.3mm_D2.5mm_P10.16mm_Horizontal |  |  | 复用已购器件 |  | NO | FLASH CS默认高；同轨已有适宜上拉时可以DNP。 复用1/4W轴向件；R1/R2/R25/R26采用1%，其余按原清单。
R13 | 1 | 10k | Resistor_THT:R_Axial_DIN0207_L6.3mm_D2.5mm_P10.16mm_Horizontal |  |  | 复用已购器件 |  | YES | 仅FLASH有对应外露脚且模块没有同轨上拉时安装；4/6针模块可以不接该引脚。 复用1/4W轴向件；R1/R2/R25/R26采用1%，其余按原清单。
R14 | 1 | 10k | Resistor_THT:R_Axial_DIN0207_L6.3mm_D2.5mm_P10.16mm_Horizontal |  |  | 复用已购器件 |  | YES | 仅FLASH有对应外露脚且模块没有同轨上拉时安装；具体/WP、/HOLD或IO2/IO3按芯片资料。 复用1/4W轴向件；R1/R2/R25/R26采用1%，其余按原清单。
R15 | 1 | 4.7k | Resistor_THT:R_Axial_DIN0207_L6.3mm_D2.5mm_P10.16mm_Horizontal |  |  | 复用已购器件 |  | NO | 原3管急停；6.0V时接点电流约1.13mA。 复用1/4W轴向件；R1/R2/R25/R26采用1%，其余按原清单。
R16 | 1 | 100k | Resistor_THT:R_Axial_DIN0207_L6.3mm_D2.5mm_P10.16mm_Horizontal |  |  | 复用已购器件 |  | NO | 复用1/4W轴向件；R1/R2/R25/R26采用1%，其余按原清单。
R17 | 1 | 4.7k | Resistor_THT:R_Axial_DIN0207_L6.3mm_D2.5mm_P10.16mm_Horizontal |  |  | 复用已购器件 |  | NO | 双NC彼此独立，一路门控，一路状态。 复用1/4W轴向件；R1/R2/R25/R26采用1%，其余按原清单。
R19 | 1 | 4.7k | Resistor_THT:R_Axial_DIN0207_L6.3mm_D2.5mm_P10.16mm_Horizontal |  |  | 复用已购器件 |  | NO | EXT有效且NC1断开时使Q2导通；EXT掉电时不能声称仍有完整硬件急停保证。 复用1/4W轴向件；R1/R2/R25/R26采用1%，其余按原清单。
R21 | 1 | 1k | Resistor_THT:R_Axial_DIN0207_L6.3mm_D2.5mm_P10.16mm_Horizontal |  |  | 复用已购器件 |  | NO | 限制PB5高而Q2钳低时电流；不得再以导线跨过该电阻。 复用1/4W轴向件；R1/R2/R25/R26采用1%，其余按原清单。
R22 | 1 | 10k | Resistor_THT:R_Axial_DIN0207_L6.3mm_D2.5mm_P10.16mm_Horizontal |  |  | 复用已购器件 |  | NO | 复用1/4W轴向件；R1/R2/R25/R26采用1%，其余按原清单。
R24 | 1 | 10k | Resistor_THT:R_Axial_DIN0207_L6.3mm_D2.5mm_P10.16mm_Horizontal |  |  | 复用已购器件 |  | NO | 急停反馈上拉只用CORE；正常0，按下或NC2断线1。 复用1/4W轴向件；R1/R2/R25/R26采用1%，其余按原清单。
R25 | 1 | 12k | Resistor_THT:R_Axial_DIN0207_L6.3mm_D2.5mm_P10.16mm_Horizontal |  |  | 复用已购器件 |  | NO | ECHO分压上臂，建议1%；不是12k到地。 复用1/4W轴向件；R1/R2/R25/R26采用1%，其余按原清单。
R26 | 1 | 20k | Resistor_THT:R_Axial_DIN0207_L6.3mm_D2.5mm_P10.16mm_Horizontal |  |  | 复用已购器件 |  | NO | ECHO分压下臂，建议1%；5.0V输入约3.125V。 复用1/4W轴向件；R1/R2/R25/R26采用1%，其余按原清单。
R27 | 1 | 10k | Resistor_THT:R_Axial_DIN0207_L6.3mm_D2.5mm_P10.16mm_Horizontal |  |  | 复用已购器件 |  | YES | 与模块已有EXT上拉二选一；若保留EXT上拉，本电阻DNP，避免两稳压轨经两上拉相连。 复用1/4W轴向件；R1/R2/R25/R26采用1%，其余按原清单。
R28 | 1 | 10k | Resistor_THT:R_Axial_DIN0207_L6.3mm_D2.5mm_P10.16mm_Horizontal |  |  | 复用已购器件 |  | YES | 与R27相同；不能只改其中一根编码相。 复用1/4W轴向件；R1/R2/R25/R26采用1%，其余按原清单。
R29 | 1 | 4.7k | Resistor_THT:R_Axial_DIN0207_L6.3mm_D2.5mm_P10.16mm_Horizontal |  |  | 复用已购器件 |  | YES | DHT低压侧开漏上拉；模块/BSS138已有合适同轨上拉时DNP。 复用1/4W轴向件；R1/R2/R25/R26采用1%，其余按原清单。
R30 | 1 | 1k | Resistor_THT:R_Axial_DIN0207_L6.3mm_D2.5mm_P10.16mm_Horizontal |  |  | 复用已购器件 |  | NO | 仅USART3 TX，模块TX不接PB11。 复用1/4W轴向件；R1/R2/R25/R26采用1%，其余按原清单。
R31 | 1 | 10k | Resistor_THT:R_Axial_DIN0207_L6.3mm_D2.5mm_P10.16mm_Horizontal |  |  | 复用已购器件 |  | NO | 碰撞两NC串联接地；任一个断开为高。 复用1/4W轴向件；R1/R2/R25/R26采用1%，其余按原清单。
R32 | 1 | 10k | Resistor_THT:R_Axial_DIN0207_L6.3mm_D2.5mm_P10.16mm_Horizontal |  |  | 复用已购器件 |  | NO | 闭盖NO接地，闭盖=0；未闭合/断线=1。 复用1/4W轴向件；R1/R2/R25/R26采用1%，其余按原清单。
R33 | 1 | 10k | Resistor_THT:R_Axial_DIN0207_L6.3mm_D2.5mm_P10.16mm_Horizontal |  |  | 复用已购器件 |  | YES | 编码器SW外部上拉；模块已有同轨上拉或已验证MCP内部上拉时DNP。 复用1/4W轴向件；R1/R2/R25/R26采用1%，其余按原清单。
R34 | 1 | 10k | Resistor_THT:R_Axial_DIN0207_L6.3mm_D2.5mm_P10.16mm_Horizontal |  |  | 复用已购器件 |  | NO | MODE低有效；推荐安装，已验证内部上拉时可DNP。 复用1/4W轴向件；R1/R2/R25/R26采用1%，其余按原清单。
R35 | 1 | 10k | Resistor_THT:R_Axial_DIN0207_L6.3mm_D2.5mm_P10.16mm_Horizontal |  |  | 复用已购器件 |  | NO | BACK低有效；推荐安装，已验证内部上拉时可DNP。 复用1/4W轴向件；R1/R2/R25/R26采用1%，其余按原清单。
R36 | 1 | 10k | Resistor_THT:R_Axial_DIN0207_L6.3mm_D2.5mm_P10.16mm_Horizontal |  |  | 复用已购器件 |  | NO | 默认安装使AHCT输入确定；高有效蜂鸣保留。低有效模块先拆R36再装R37，不能两者均不装后运行。 复用1/4W轴向件；R1/R2/R25/R26采用1%，其余按原清单。
R37 | 1 | 10k | Resistor_THT:R_Axial_DIN0207_L6.3mm_D2.5mm_P10.16mm_Horizontal |  |  | 复用已购器件 |  | YES | 低有效蜂鸣模块选择本上拉，R36必须DNP；绝不可上拉5V。 复用1/4W轴向件；R1/R2/R25/R26采用1%，其余按原清单。
U1 | 1 | SN74AHCT125N | Package_DIP:DIP-14_W7.62mm_Socket | SN74AHCT125N | Texas Instruments（核实物） | 复用已购器件 |  | NO | DIP14+7.62mm芯片座；N为PDIP。第3通道永久使能，输入PB9有默认偏置，输出通过JP3选择；第4通道固定禁用，11脚不接。不得替换成74HC125。 本行只计1颗芯片。先焊下列U1_SOCKET插座，再插本芯片，不能把座与芯片作为两颗AHCT。
U1_SOCKET | 1 | DIP14插座 7.62mm | 与U1共用14孔；本项不是独立PCB位号 |  |  | 复用已购插座 |  | NO | 采购补充项：只需1只DIP14座，行距7.62mm、针距2.54mm。U1芯片另在U1行计1颗。不要生成第二个芯片贴装位。
