Sylphiette666/stm32-rfid-smart-bin/hardware/mechanical/print-backup/wall-panels-20261102/source/parts_by_plate.csv

plate | part | quantity | stl | step
1 | W01_FRONT | 1 | parts/W01_FRONT.stl | step/W01_FRONT.step
1 | PANEL_COVER | 1 | parts/PANEL_COVER.stl | step/PANEL_COVER.step
1 | ENCODER_PIN_HOOD | 1 | parts/ENCODER_PIN_HOOD.stl | step/ENCODER_PIN_HOOD.step
1 | BUTTON_CARRIER | 2 | parts/BUTTON_CARRIER.stl | step/BUTTON_CARRIER.step
1 | RFID_EDGE_RAIL | 2 | parts/RFID_EDGE_RAIL.stl | step/RFID_EDGE_RAIL.step
1 | RFID_RETAINER | 2 | parts/RFID_RETAINER.stl | step/RFID_RETAINER.step
1 | SHIM_1 | 3 | parts/SHIM_1.stl | step/SHIM_1.step
1 | SHIM_2 | 3 | parts/SHIM_2.stl | step/SHIM_2.step
2 | W02_REAR | 1 | parts/W02_REAR.stl | step/W02_REAR.step
2 | CORNER_ANGLE | 4 | parts/CORNER_ANGLE.stl | step/CORNER_ANGLE.step
2 | ULTRASONIC_BEAM | 1 | parts/ULTRASONIC_BEAM.stl | step/ULTRASONIC_BEAM.step
2 | POWER_POD | 1 | parts/POWER_POD.stl | step/POWER_POD.step
2 | POWER_INSERT | 1 | parts/POWER_INSERT.stl | step/POWER_INSERT.step
2 | LIGHT_CRADLE | 1 | parts/LIGHT_CRADLE.stl | step/LIGHT_CRADLE.step
2 | LID_SWITCH_PLATE | 1 | parts/LID_SWITCH_PLATE.stl | step/LID_SWITCH_PLATE.step
2 | BEAM_SEAT | 2 | parts/BEAM_SEAT.stl | step/BEAM_SEAT.step
2 | DHT_SEAT | 1 | parts/DHT_SEAT.stl | step/DHT_SEAT.step
2 | DHT_GUARD | 1 | parts/DHT_GUARD.stl | step/DHT_GUARD.step
2 | BUTTON_RETAINER | 1 | parts/BUTTON_RETAINER.stl | step/BUTTON_RETAINER.step
2 | LED_INSERT | 1 | parts/LED_INSERT.stl | step/LED_INSERT.step
2 | LID_TOUCH_TAB | 1 | parts/LID_TOUCH_TAB.stl | step/LID_TOUCH_TAB.step
2 | BUTTON_SPACER | 2 | parts/BUTTON_SPACER.stl | step/BUTTON_SPACER.step
3 | W03_LEFT | 1 | parts/W03_LEFT.stl | step/W03_LEFT.step
3 | CORNER_ANGLE | 2 | parts/CORNER_ANGLE.stl | step/CORNER_ANGLE.step
3 | BEAM_LEDGE | 2 | parts/BEAM_LEDGE.stl | step/BEAM_LEDGE.step
3 | BUTTON_RETAINER | 1 | parts/BUTTON_RETAINER.stl | step/BUTTON_RETAINER.step
3 | LID_SOFTSTOP_SEAT | 2 | parts/LID_SOFTSTOP_SEAT.stl | step/LID_SOFTSTOP_SEAT.step
3 | APPROACH_EDGE_BAR | 2 | parts/APPROACH_EDGE_BAR.stl | step/APPROACH_EDGE_BAR.step
3 | LIGHT_EDGE_BAR | 2 | parts/LIGHT_EDGE_BAR.stl | step/LIGHT_EDGE_BAR.step
3 | ULTRASONIC_RETAINER | 2 | parts/ULTRASONIC_RETAINER.stl | step/ULTRASONIC_RETAINER.step
3 | CABLE_SADDLE | 4 | parts/CABLE_SADDLE.stl | step/CABLE_SADDLE.step
3 | CABLE_CAP | 4 | parts/CABLE_CAP.stl | step/CABLE_CAP.step
3 | BEAM_RETAINER | 2 | parts/BEAM_RETAINER.stl | step/BEAM_RETAINER.step
3 | BUTTON_SPACER | 2 | parts/BUTTON_SPACER.stl | step/BUTTON_SPACER.step
4 | W04_RIGHT | 1 | parts/W04_RIGHT.stl | step/W04_RIGHT.step
4 | CORNER_ANGLE | 2 | parts/CORNER_ANGLE.stl | step/CORNER_ANGLE.step
4 | APPROACH_SHELF | 1 | parts/APPROACH_SHELF.stl | step/APPROACH_SHELF.step
