Sylphiette666/stm32-rfid-smart-bin/hardware/mechanical/print-backup/fasteners-20261105/fasteners.csv

分类 | 规格 | 头型/类型 | 数量 | 用途/位置 | 依据 | 状态
A 主体与结构
 | M3×6 | 低圆头/内六角 | 4 | 四根60 mm立柱上端拧入上平台 | 手册68章2393段 | 待定：按柱孔深，可用M3×6~×10
 | M3×10 | 低圆头 | 4 | 四根60 mm立柱下端（底板下方） | 手册68章2393段 + 旧采购清单 | 按图
 | M3×35 | 通螺栓/低圆头 | 4 | B1 PCB 四孔(115,65)/(205,65)/(115,155)/(205,155)，一体20 mm柱 | 手册68章2400段 | 按图：先确认螺柱贯通孔深
 | M2.5×16 | 机螺钉 | 2 | 5V降压模块两真实安装孔，底板下方配M2.5螺母 | 手册68章2401段 | 候选长度，装配核对突出量
 | M3×30 | 螺柱/机螺钉 | 2 | 喇叭两安装耳（可调螺母托住） | 手册68章2401段 | 耳高未实测，按实物定垫圈
B 模块压框、拨片与电池锁（9个模块沿用原套件）
 | M3×30 | M3 低圆头（ISO7380，头Ø5.7×1.65） | 9 | 9个模块翻盖铰链金属轴 | HARDWARE_REVIEW + 手册68章2400段 | 按图：铰链避空只认低圆头
 | M3×25 | M3 低圆头（ISO7380，头Ø5.7×1.65） | 10 | M03/M04/M07/M08/M09 各1根拨片轴+1根簧片锚钉 | HARDWARE_REVIEW | 按图
 | M3×40 | M3 低圆头（ISO7380，头Ø5.7×1.65） | 6 | M01/M02/M06 各1根拨片轴+1根簧片锚钉 | HARDWARE_REVIEW | 按图：锁母≤4 mm 高
 | M3×30 | M3 低圆头（ISO7380，头Ø5.7×1.65） | 2 | M05（3.3V稳压）拨片轴+簧片锚钉 | HARDWARE_REVIEW | 按图
 | M3×40 | M3 低圆头（ISO7380，头Ø5.7×1.65） | 4 | 电池左/右锁片各1轴+1锚 | HARDWARE_REVIEW | 按图
 | M3×12 | M3 低圆头（ISO7380，头Ø5.7×1.65） | 4 | 电池托脚（一体版托架已并入底板，可能不再需要） | HARDWARE_REVIEW（旧版） | 待定：一体版可取消
C 走行与底盘
 | M3×60 | 通螺栓/低圆头 | 2 | 万向轮 (240,90)/(240,130) 贯穿；一体座41 mm + H4垫块4 mm | 手册68章2402段(M3×55) + caster-spacer-20261105 | 候选：无垫块时M3×55，装后核对露牙
 | M3×55 | 通螺栓/低圆头 | 2 | 循迹模块 (185,80.25)/(185,139.75) 贯穿，安装面Z=−43.4 | 手册68章2402段 | 候选：按金属片厚+1.6 mm板核对
 | 原配电机横栓 | 原厂 | 4 | 两侧电机固定（原配T形片+原配横向螺栓） | 手册68章2399段 | 复用，不新增
D 可拆附件
 | M3×16 | M3 低圆头（ISO7380，头Ø5.7×1.65） | 3 | 筒壁压脚 C1/C2/C3 固定端（三个原立柱孔） | wall-clamps-fine-20261103 | 按图
 | M3×20 | M3 低圆头（ISO7380，头Ø5.7×1.65） | 1 | 筒壁压脚 C4 共用P04舵机托片孔 | wall-clamp-preview-20261103 | 按图
 | M3×8 | 机螺钉 | 4 | 四只压脚调压螺丝（头必须悬空） | wall-clamps-fine-20261103 | 按图
 | M3×20 | M3 低圆头（ISO7380，头Ø5.7×1.65） | 2 | 光敏L压条两根（双槽10×3.4） | sensor-retainers-fix-20261103 | 按图：槽可调29.4~42.6
 | M3×25 | M3 低圆头（ISO7380，头Ø5.7×1.65） | 4 | 两端红外对射IR压盖，每端2颗 | sensor-retainers-fix-20261103 | 按图
 | M3×10~12 | 机螺钉 | 4 | 可拆操作面板原四颗 | 手册68章图68-1 | 待核对原面板孔与旧螺丝长度
 | M2.5×8~12 | 机螺钉 | 10 | 活动盖：铰链连接座4、连杆臂2、开关支脚2、触片2 | lid-fine-20261103 | 8~12 mm按叠层试配
 | M2×8 | 沉头（头径≤4 mm） | 4 | 铰链连接座底部沉头槽，头不得凸出底面 | lid-fine-20261103 | 普通圆头不能替代
 | M2 球头 | 原配 | 0 | 航模M2双球头可调拉杆 | lid-fine-20261103 | 复用原配，长度按实物
螺母/垫圈/柱 | M3 DIN985 防松锁母（高约4 mm） |  | 41 | 模块铰链9+拨片轴/锚20? → 见明细：铰链9、轴/锚18、电池锁4、B1 4、万向轮2、循迹2、喇叭上2 |  | 按图
螺母/垫圈/柱 | M3 普通六角螺母（高2.4 mm、对边5.5） |  | 20 | 电池托脚4、喇叭耳下2、压脚4、光敏2、红外4、面板4 |  | 按图/待定
螺母/垫圈/柱 | M2.5 普通螺母（对边5、高2） |  | 12 | 降压模块2、活动盖10 |  | 按图
螺母/垫圈/柱 | M2 螺母 + 平垫 |  | 8 | 活动盖连杆、触片、球头 |  | 按图
螺母/垫圈/柱 | M3 平垫，内径3.2/外径≤6/厚0.5 |  | 90 | 模块座、铰链、轴/锚、B1上下、万向轮/循迹、喇叭 |  | 含备用
螺母/垫圈/柱 | M2.2×5×0.3 平垫 |  | 20 | M2 连杆与小支架 |  | 含备用
螺母/垫圈/柱 | M3 双通尼龙柱 60 mm |  | 4 | 上下平台四角连接（整根，不拼接两根30） |  | 按图
