Sylphiette666/stm32-rfid-smart-bin/archive/earlier-plans/方案一_中型扩容版_STM32_RFID积分式智能移动垃圾桶_硬件采购BOM清单_最终交付.docx

嵌入式系统课程设计 · 采购与装配资料

方案一硬件采购 BOM 清单

基于 STM32 的 RFID 积分式智能移动垃圾桶（中型扩容版）

适用阶段：方案设计、采购、装配、联调和答辩交付

主控基线：STM32F103C8T6；资源不足时升级 STM32F103RCT6

尺寸基线：桶体约280×230×360mm；整机约360×340×500mm

BOM版本：V1.1

编制日期：2026年9月2日

填写信息：姓名：____________ 学号：____________ 专业班级：____________

清单范围：共收录 132 条采购项目，覆盖整机安装物料、备件、线材耗材、机械结构和不装车的制作工具。数量栏为课程样机的推荐采购量，已对部分易损模块预留备件。

优先原则：先购买主控、传感器、显示和下载工具，完成静态垃圾桶；再购买底盘、电机和循迹部件；最后加工扩容桶体与支架。整机总测试质量建议不超过4kg，型号未实测前不要批量加工孔位。

安全红线：2S电池只能使用8.4V CC/CV充电器和2S保护板；HC-SR04 Echo必须降到约3.3V；RC522只能使用3.3V；大扭矩舵机必须由独立5V/5A降压供电，电机和舵机均不得由STM32引脚供电。

目录

使用方法：在采购前逐行确认型号和接口；到货后按第13章验收，不合格模块不要直接接入整机。

# 1 采购使用说明与等级定义

本清单按照“先独立模块、后静态整机、再移动底盘、最后总联调”的实施路线编制。表中数量是推荐采购量，不等同于最终装车数量；标注两件的模块通常包含一件备用。

## 1.1 采购等级

- 必需：第一版样机实现任务书要求不可缺少的器件。
- 推荐：明显提高稳定性、安全性或维护效率，建议一并采购。
- 可选：不影响基本功能，可在主线稳定后增加。
- 升级：当负载、接口或资源超过基础型号能力时替换使用。
- 备件：容易损坏、运输或调试风险较高，建议随项目保留。

## 1.2 下单前必须确认

1. 电机额定电压、减速比、输出轴直径和轮子接口必须匹配。
2. 扩容桶盖使用DS3218或MG996R大扭矩舵机，桶盖和连杆总重量建议不超过600g。
3. 所有5V传感器输出都要确认是否可直接进入STM32；不确定时使用分压或电平转换。
4. 同一2S电池组内只使用同品牌、同容量、同批次且状态一致的电芯。
5. SolidWorks开孔和支架尺寸以收到的实物卡尺测量值为准。

# 2 主控、下载与笔记本调试硬件

完成程序开发、下载、串口日志与笔记本蓝牙调试所需的基础硬件。

编号 | 硬件/材料 | 推荐规格或型号 | 数量 | 级别 | 用途与采购注意事项
A01 | STM32主控板 | STM32F103C8T6最小系统板，带SWD接口 | 2块 | 必需 | 1块装车、1块备用；购买后先做LED和串口最小系统测试。
A02 | 备用升级主控 | STM32F103RCT6核心板 | 1块 | 升级 | 仅当C8T6的GPIO、定时器或Flash不足时启用，不必与C8T6同时装车。
A03 | 下载器 | ST-Link V2，支持SWD | 1个 | 必需 | 用于程序下载和在线调试；确认有3.3V、GND、SWDIO、SWCLK。
A04 | SWD连接线 | 4芯杜邦线或SWD专用线 | 1套 | 必需 | 线长尽量小于20cm，避免下载不稳定。
A05 | USB数据线 | 与ST-Link、主控板接口匹配，可传数据 | 2根 | 必需 | 不要购买只能充电的线；建议一根备用。
A06 | USB转串口 | CP2102、CH340或FT232，3.3V/5V可选 | 1个 | 推荐 | 用于有线日志、蓝牙模块AT配置和串口故障隔离。
A07 | USB蓝牙适配器 | 支持经典蓝牙与SPP虚拟串口 | 1个 | 可选 | 笔记本无蓝牙或内置蓝牙无法生成COM端口时使用；不要买BLE-only适配器。

# 3 显示、RFID身份识别与蓝牙通信

用户刷卡、积分显示、管理员授权和无线遥控所需模块。

编号 | 硬件/材料 | 推荐规格或型号 | 数量 | 级别 | 用途与采购注意事项
B01 | OLED显示屏 | 0.96英寸，128×64，SSD1306，I2C | 2块 | 必需 | 1块使用、1块备用；优先选3.3V兼容版本，先确认I2C地址。
B02 | RFID读卡器 | MFRC522模块，13.56MHz | 2块 | 必需 | 严格使用3.3V供电；SPI线尽量短，并远离电机和电池。
B03 | 管理员卡 | M1/S50，13.56MHz | 2张 | 必需 | 登记为管理员角色；第二张作为遗失备用。
B04 | 用户卡 | M1/S50，13.56MHz | 3~5张 | 必需 | 模拟多个积分用户，卡片编号和UID应建立登记表。
B05 | 蓝牙模块 | HC-05，带ZS-040底板 | 2块 | 必需 | 1块使用、1块备用；经典蓝牙SPP，常用9600 8N1。
B06 | 蓝牙排针/插座 | 2.54mm排针排母或4P插接端子 | 2套 | 推荐 | 使HC-05可拆卸，便于AT配置和替换。

# 4 满载、火情、投放与循迹传感器

传感器先独立采集原始值，再进行去抖、滤波和状态机联调。

编号 | 硬件/材料 | 推荐规格或型号 | 数量 | 级别 | 用途与采购注意事项
C01 | 超声波模块 | HC-SR04 | 2个 | 必需 | 用于测量桶内剩余距离；Echo为5V，必须分压到约3.3V。
C02 | 火焰传感器 | 带AO/DO的红外火焰检测模块 | 2个 | 必需 | 建议读取AO并保留DO；演示只做安全模拟，不在电池模型上点火。
C03 | 温度传感器 | DS18B20，普通或防水探头版 | 2个 | 必需 | 数据线接4.7kΩ上拉；用于与火焰信号联合判断。
C04 | 投放检测 | 红外对射/遮挡传感器，一发一收 | 2套 | 必需 | 安装于投放口，检测垃圾经过；优先于易受颜色影响的反射式模块。
C05 | 五路循迹模块 | 五路TCRT5000阵列，阈值可调 | 2块 | 必需 | 确认可在3.3V逻辑下稳定输出；安装高度约5~10mm。
C06 | 电池电压检测 | 0~25V采样模块或自制电阻分压 | 1套 | 推荐 | 用于低电量提示；分压最大输出不得超过3.3V。
C07 | 碰撞微动开关 | 常开/常闭微动限位开关 | 2个 | 可选 | 安装在车头两侧，作为循迹和蓝牙遥控的物理碰撞保护。
C08 | 传感器延长线 | 3P/4P JST-XH线束，20~40cm | 6套 | 推荐 | 提前统一接口定义，避免VCC与GND插反。

# 5 电机、底盘与运动机构

中型扩容版按轻质空载/轻载样机设计，总测试质量建议不超过4kg；运动部分应先架空测试，再以低占空比落地。

编号 | 硬件/材料 | 推荐规格或型号 | 数量 | 级别 | 用途与采购注意事项
D01 | 直流减速电机 | N20高扭矩金属减速电机，6~7.4V，80~120rpm | 2个 | 必需 | 左右驱动；总质量超过4kg或实测电流超限时改用25GA电机及大电流驱动。
D02 | 备用减速电机 | 与D01完全相同 | 1个 | 备件 | 防止齿轮、电刷或减速箱损坏后无法继续联调。
D03 | 电机驱动板 | TB6612FNG双路驱动模块 | 2块 | 必需 | 1块使用、1块备用；必须先实测运行与堵转电流，单路持续电流不得超过模块能力。
D04 | 主驱动轮 | 直径80~100mm、宽25~35mm，与电机轴匹配 | 2个 | 必需 | 扩容版优先100mm橡胶轮；左右轮直径、轮宽和材质一致。
D05 | 万向轮 | 40~50mm承重万向轮 | 1~2个 | 必需 | 推荐前方一个，与两个驱动轮形成三点支撑并保证约25mm离地间隙。
D06 | 电机固定架 | 与N20电机匹配的金属支架 | 2套 | 必需 | 孔位应与底盘匹配，防止电机松动造成循迹偏差。
D07 | 轮毂/联轴器 | 匹配电机D轴或圆轴 | 2个 | 必需 | 轮子不能仅靠摩擦松配，必须有可靠锁紧。
D08 | 物理急停 | 自锁蘑菇头开关，DC 10A以上 | 1个 | 推荐 | 建议串联在电机VM支路，同时由软件拉低TB6612 STBY。
D09 | 循迹路线胶带 | 哑光黑色，宽18~25mm | 2卷 | 必需 | 亮面胶带可能反光；预留一卷用于重铺路线。
D10 | 循迹白色底板 | PVC、KT板或白色亚克力 | 1块 | 必需 | 建议演示区域不少于1.5m×1.5m，表面平整无反光。
D11 | 电机抑制电容 | 0.1µF陶瓷电容，50V | 6个 | 推荐 | 每个电机端子附近并联，降低电刷噪声和主控复位概率。

# 6 桶盖执行、报警与人工输入

扩容桶盖必须使用大扭矩金属齿轮舵机，舵机5V电源与逻辑5V分路并共地。

编号 | 硬件/材料 | 推荐规格或型号 | 数量 | 级别 | 用途与采购注意事项
E01 | 大扭矩桶盖舵机 | DS3218（推荐）或MG996R，金属齿轮 | 2个 | 必需 | 1个使用、1个备用；安装连杆前先空载调中位和安全端点。
E02 | 轻型调试舵机 | MG90S金属齿轮舵机 | 1个 | 可选 | 仅用于桌面验证PWM程序，不作为扩容版桶盖的最终执行器。
E03 | 舵机摇臂 | 与所选舵机花键匹配 | 2套 | 必需 | 通常随舵机附送，备用螺钉不得缺失。
E04 | 舵机连杆 | M2推拉杆、钢丝连杆或球头连杆 | 1套 | 必需 | 应可调长度，运动中不得顶死或过约束。
E05 | 桶盖合页 | 50~70mm金属合页 | 2个 | 必需 | 两只合页轴线同心，安装后桶盖不得侧向窜动。
E06 | 有源蜂鸣器 | 5V有源蜂鸣器 | 2个 | 必需 | 使用三极管驱动，不能让STM32引脚直接承担负载电流。
E07 | 红色LED | 5mm高亮红色 | 5个 | 必需 | 报警、火情和故障指示；每只串联330Ω~1kΩ。
E08 | 绿色LED | 5mm绿色 | 3个 | 推荐 | 正常运行、待机和电源状态指示。
E09 | 面板按钮 | 大号瞬时按钮，常开 | 2个 | 必需 | 分别用于开盖/确认和模式操作。
E10 | 轻触按键 | 6×6mm或12×12mm | 10个 | 推荐 | 用于复位、调试、模式和备用输入。
E11 | 按键帽 | 与面板按键匹配 | 4~6个 | 推荐 | 用颜色或文字区分开盖、模式和急停。

# 7 电池、充电与分路供电

电池、电机、舵机和逻辑电源是整机稳定性的核心，建议一次性按下表配齐。

编号 | 硬件/材料 | 推荐规格或型号 | 数量 | 级别 | 用途与采购注意事项
F01 | 18650锂电池 | 同品牌同批次，3000mAh以上，持续放电≥10A | 2节 | 必需 | 组成2S1P约7.4V；禁止混用新旧、不同容量或破损电芯。
F02 | 备用电池组 | 参数与主电池组一致 | 1组 | 可选 | 长时间演示时替换使用，不与主电池并联。
F03 | 2S电池盒 | 带引线并可机械固定 | 1个 | 必需 | 不建议直接在裸电芯正负极长时间焊接。
F04 | 2S保护板/BMS | 2S 10A，带均衡 | 2块 | 必需 | 1块使用、1块备用；负责过充、过放、过流和短路保护。
F05 | 2S锂电充电器 | 8.4V CC/CV，1~2A | 1个 | 必需 | 不能使用单节TP4056给2S电池充电。
F06 | 逻辑5V降压模块 | 输入7.4V，输出5V，持续3A以上 | 2个 | 必需 | 给开发板5V输入、HC-05和5V传感器供电；1个使用、1个备用。
F07 | 舵机独立5V降压 | 5V/5A，带散热 | 1个 | 必需 | 专供DS3218或MG996R；与逻辑电源共地，但不得由开发板5V脚反向供电。
F08 | 电机降压模块 | 可调6V，持续3A以上 | 1个 | 推荐 | 电机额定6V时使用；若电机支持7.4V可直接接VM支路。
F09 | 3.3V稳压模块 | 3.3V/1A低纹波降压或LDO | 1个 | 可选 | RC522、OLED较多或板载稳压发热时使用。
F10 | 1000µF电解电容 | 10V或16V，低ESR | 2个 | 必需 | 放在舵机5V电源附近，缓解启动压降。
F11 | 470µF电解电容 | 16V | 4个 | 必需 | 安装在TB6612 VM和5V降压输出附近。
F12 | 100µF电解电容 | 16V | 5个 | 推荐 | 各电源分支和模块组附近滤波。
F13 | 0.1µF陶瓷电容 | 50V | 20个 | 必需 | 电源去耦、电机抑制和模块旁路。
F14 | 主保险丝 | 5~8A片式或管式 | 3个 | 必需 | 串联在电池输出端，最终额定值仍须结合实测堵转电流确定。
F15 | 保险丝座 | 与F14匹配 | 1个 | 必需 | 安装在电池和总开关之间，便于更换。
F16 | 总电源开关 | DC 10A以上 | 1个 | 必需 | 安装在外壳可快速触及的位置。
F17 | 充电插座 | DC 5.5×2.1mm或XT30 | 1套 | 必需 | 机械防呆并清楚标识极性。
F18 | 电源分配板 | 洞洞板、铜排或接线端子板 | 1块 | 必需 | 分出电池、VM、5V、3.3V和GND母线。
F19 | 防火充电袋 | 锂电池防火袋 | 1个 | 推荐 | 电池组充电、运输和暂存时使用。

# 8 电平转换与基础电子元件

以下元件用于5V/3.3V兼容、报警驱动、上拉、分压和滤波。

编号 | 硬件/材料 | 推荐规格或型号 | 数量 | 级别 | 用途与采购注意事项
G01 | 1kΩ电阻 | 1/4W，1%或5% | 20个 | 必需 | 三极管基极、限流及与2kΩ组成超声波Echo分压。
G02 | 2kΩ/2.2kΩ电阻 | 1/4W | 20个 | 必需 | HC-SR04 Echo分压的下臂电阻。
G03 | 4.7kΩ电阻 | 1/4W | 10个 | 必需 | DS18B20数据线上拉，也可用于I2C上拉。
G04 | 10kΩ电阻 | 1/4W | 20个 | 必需 | 按键、三极管和MOSFET的上拉/下拉及电压采样。
G05 | 330Ω电阻 | 1/4W | 20个 | 必需 | LED限流。
G06 | 常用电阻包 | 10Ω~1MΩ多阻值套装 | 1盒 | 推荐 | 调试阈值、分压和接口时备用。
G07 | NPN三极管 | S8050、SS8050或2N2222 | 10个 | 必需 | 驱动蜂鸣器和较大电流LED。
G08 | 逻辑级MOSFET模块 | 3.3V门极可完全导通 | 2个 | 可选 | 用于升级大电流蜂鸣器、灯带或其他负载。
G09 | 肖特基二极管 | 1N5819 | 10个 | 推荐 | 反接、隔离和瞬态保护。
G10 | 普通二极管 | 1N4148、1N4007 | 各10个 | 推荐 | 信号保护和感性负载续流。
G11 | 双向电平转换 | 4路，3.3V/5V | 2块 | 推荐 | 处理不确定的5V数字输出，尤其循迹和红外模块。
G12 | 面包板 | 830孔 | 1块 | 推荐 | 只用于前期独立模块测试，不建议作为最终装车连接。
G13 | 洞洞板 | 7×9cm或更大 | 3~5块 | 必需 | 制作稳定电源分配和接口板。
G14 | 排针排母 | 2.54mm直针、弯针和母座 | 各5排 | 必需 | 使模块、主控和调试接口可拆卸。
G15 | 螺钉接线端子 | 2P、3P，5.08mm | 各10个 | 推荐 | 电源、电机和大电流线使用。

# 9 线材、插接件与焊接耗材

正式装车后应把松散杜邦线替换为焊接或带锁扣的插接端子。

编号 | 硬件/材料 | 推荐规格或型号 | 数量 | 级别 | 用途与采购注意事项
H01 | 杜邦线 | 公公、公母、母母 | 各1盒 | 必需 | 用于桌面联调；信号线尽量短。
H02 | 信号软线 | 24~26AWG多股线 | 5~10m | 必需 | 传感器、按键、I2C、SPI和串口。
H03 | 电源硅胶线 | 18~20AWG，红黑各一卷 | 各3~5m | 必需 | 电池、电机、舵机和电源母线。
H04 | JST-XH插头 | 2P、3P、4P、5P公母套装 | 若干 | 必需 | 模块可拆卸连接；统一VCC/GND针序并贴标签。
H05 | XT30插头 | 公母成套 | 2~3套 | 推荐 | 电池主电源和可拆卸高电流连接。
H06 | 压线端子 | 冷压端头/线鼻子 | 1盒 | 推荐 | 接线端子中的多股线先压接，避免散丝短路。
H07 | 热缩管 | 多直径套装 | 1盒 | 必需 | 焊点、端子和线束绝缘。
H08 | 尼龙扎带 | 100mm、150mm | 各1包 | 必需 | 动力线和信号线分组固定。
H09 | 编织网管/缠绕管 | 直径6~12mm | 2~3m | 推荐 | 保护电机线和跨机构活动线束。
H10 | 焊锡丝 | 0.6~0.8mm | 1卷 | 必需 | 推荐使用质量稳定的含松香焊锡。
H11 | 助焊剂 | 中性免洗型 | 1盒 | 推荐 | 提高洞洞板和端子焊接可靠性。
H12 | 绝缘胶带 | 阻燃PVC | 2卷 | 必需 | 临时绝缘；不可替代热缩管处理长期焊点。
H13 | 铜箔胶带 | 带导电胶 | 1卷 | 可选 | 局部屏蔽、接地和电磁干扰定位。
H14 | 线缆标签 | 可书写或打印式 | 1包 | 推荐 | 标记端口、线束方向和电压等级。
H15 | 电缆固定座 | 自粘扎带座 | 20个 | 推荐 | 避免运动时线束接触车轮和舵机连杆。
H16 | 橡胶护线圈 | 匹配外壳过线孔 | 10个 | 推荐 | 防止亚克力或金属孔边割伤导线。
H17 | 备用保险丝 | 与主保险丝同规格 | 2个 | 备件 | 单独标记并随车携带。

# 10 桶体、安装板与紧固结构

中型扩容版桶体约20L；尺寸以实物测量为准，先做纸板或泡沫板样机，再加工最终结构。

编号 | 硬件/材料 | 推荐规格或型号 | 数量 | 级别 | 用途与采购注意事项
I01 | 底盘板 | 约320×280×5mm，亚克力/铝板/夹板 | 1块 | 必需 | 为电机、万向轮和电子安装板预留孔位，主承力区不得开大减重孔。
I02 | 电子安装板 | 约270×220×3mm | 1块 | 必需 | 与底盘间使用20~25mm铜柱，留出插拔、散热和走线空间。
I03 | 垃圾桶体 | 约280×230×360mm，轻质PVC/亚克力/3D打印 | 1套 | 必需 | 标称容量约20L；内壁无尖角，能够放置垃圾袋并方便拆卸。
I04 | 桶盖 | 约300×250×8mm，轻质夹芯/PVC材料 | 1块 | 必需 | 配DS3218或MG996R；含连杆后的总重量建议不超过600g。
I05 | 前面板 | 约170×220mm | 1块 | 必需 | 容纳OLED、RFID、按钮、蜂鸣器和状态灯，并保留维护拆装空间。
I06 | 超声波支架 | 双圆孔，角度可调 | 1个 | 必需 | 安装在桶盖下方，声路不得被边框遮挡。
I07 | 循迹支架 | 五路阵列匹配，长圆孔可调高 | 1个 | 必需 | 保证传感器面与地面平行。
I08 | 火焰/温度支架 | 隔热、可拆卸 | 1套 | 推荐 | 远离电机和降压模块热源，避免误判。
I09 | 舵机支架 | 与DS3218或MG996R匹配的金属支架 | 1套 | 必需 | 安装后仍可拆卸舵机和调整中位，支架不得依赖热熔胶承力。
I10 | 电池固定架 | 与2S电池盒匹配 | 1套 | 必需 | 允许取出充电，并防止运动时滑动。
I11 | M3铜柱 | 10/15/20mm混合 | 20~30个 | 必需 | 安装主控、电源板和电子安装板。
I12 | M3螺钉螺母 | M3×6、M3×10、M3×16 | 各20套 | 必需 | 搭配平垫和弹垫使用。
I13 | M2螺钉螺母 | 适配舵机和小模块 | 20套 | 推荐 | 避免用热熔胶永久固定需要维护的模块。
I14 | 平垫/弹垫 | M2、M3 | 各20个 | 推荐 | 保护亚克力并减少运动松动。
I15 | 磁吸或卡扣 | 小型 | 1~2套 | 可选 | 桶盖或维护盖的定位和闭合。
I16 | 橡胶减震垫 | M3或自粘式 | 8~12个 | 推荐 | 降低电机振动传递到传感器和桶体。
I17 | 螺纹防松胶 | 中低强度 | 1瓶 | 推荐 | 只用于金属螺纹，避免高强度胶导致无法维护。
I18 | 垃圾袋 | 20L左右，与桶体容积匹配 | 1包 | 必需 | 检查袋口不会遮挡超声波和投放红外。

# 11 制作、测量与安全工具（不装车）

以下工具用于加工、焊接、测量和故障定位，已有实验室设备可不重复购买。

编号 | 硬件/材料 | 推荐规格或型号 | 数量 | 级别 | 用途与采购注意事项
J01 | 数字万用表 | 具备直流电压、电阻、通断和电流档 | 1台 | 必需 | 每次上电前检查短路和各路电压。
J02 | 可调直流电源 | 0~30V，3~5A，限流可调 | 1台 | 推荐 | 模块独立调试和堵转电流测试。
J03 | 恒温焊台 | 温度可调，细烙铁头 | 1套 | 必需 | 洞洞板、端子和线束焊接。
J04 | 吸锡器/吸锡带 | 手动吸锡器和铜编织带 | 1套 | 推荐 | 返修焊点和更换模块。
J05 | 斜口钳/尖嘴钳 | 电子制作规格 | 各1把 | 必需 | 剪线、折弯引脚和夹持小件。
J06 | 剥线钳 | 适配18~26AWG | 1把 | 必需 | 避免刀具划伤多股线。
J07 | 端子压线钳 | 适配JST和冷压端头 | 1把 | 推荐 | 制作可靠插接线束。
J08 | 螺丝刀套装 | 十字、一字、内六角 | 1套 | 必需 | 覆盖M2/M3和端子螺钉。
J09 | 游标卡尺 | 0~150mm，0.1mm或更高精度 | 1把 | 必需 | 建模前测量模块、轴径、孔距和板厚。
J10 | 热风枪 | 低温档可控 | 1把 | 推荐 | 收缩热缩管；避免直吹电池。
J11 | 热熔胶枪 | 小型 | 1把 | 推荐 | 用于应力释放和临时固定，不用于主承力连接。
J12 | 手电钻 | 可调速 | 1把 | 推荐 | 底盘、支架和前面板开孔。
J13 | 钻头套装 | 2~6mm | 1套 | 推荐 | 匹配M2/M3螺钉和传感器孔位。
J14 | 锉刀/砂纸/美工刀 | 小型锉、400~1000目砂纸 | 1套 | 必需 | 修孔、倒角和样板加工。
J15 | 逻辑分析仪 | 8路24MHz或以上 | 1个 | 可选 | 检查SPI、I2C、UART、PWM和超声波Echo。
J16 | 示波器 | 20MHz以上 | 1台 | 可选 | 定位电源跌落、PWM和电机干扰。
J17 | 3D打印/激光切割 | 自有设备或委托加工 | 1项 | 推荐 | 制作桶体、安装板和传感器支架。
J18 | 防静电手环 | 带接地线 | 1条 | 推荐 | 焊接和插拔STM32、RC522时使用。
J19 | 护目镜 | 透明防冲击 | 1副 | 必需 | 钻孔、切割和焊接时佩戴。
J20 | 小型灭火器 | 适合实验室的合规灭火器 | 1具 | 推荐 | 仅作为场地安全设备；模型演示不得进行真实燃烧。

# 12 建议下单批次

为降低返工风险，建议将采购拆成四批。上一批完成独立验收后再决定下一批的最终型号。

批次 | 目标 | 主要采购内容 | 进入下一批的条件
第1批 | 主控与静态功能 | STM32、ST-Link、USB-TTL、OLED、RC522与卡片、HC-05、超声波、火焰、温度、投放红外、按键、蜂鸣器 | 完成M0~M2独立模块测试
第2批 | 供电与移动底盘 | 2S电池/BMS/充电器、降压模块、TB6612、电机、轮子、万向轮、急停、五路循迹 | 完成架空电机、蓝牙停车和循迹三圈
第3批 | 机械结构 | 底盘板、桶体、桶盖、前面板、舵机、连杆、合页、支架、铜柱和紧固件 | 完成干涉检查和连续开合50次
第4批 | 稳定性与备份 | 备用主控/模块、电容、电平转换、线束、插接件、防护材料和测量工具 | 完成异常测试和30分钟耐久

# 13 到货验收与首次上电检查

每件关键器件到货后立即拍照、记录型号并独立测试。不要等全部装车后才发现单个模块损坏或电压不兼容。

1. 核对外包装、型号、数量、接口、电压和配套线材。
2. 用万用表检查电池、充电器和降压模块极性，空载调整输出电压。
3. 主控只连接ST-Link，下载LED闪烁程序并稳定运行10分钟。
4. OLED只显示固定文字；RC522读取版本寄存器和至少三张卡UID。
5. USB-TTL先回环测试，再测试HC-05的波特率与双向收发。
6. 超声波、火焰、温度、投放红外和循迹模块分别记录原始值与阈值。
7. 舵机脱离连杆，以1.5ms中位上电，再测量安全开闭端点。
8. TB6612先保持STBY低，架空轮子后逐个测试左右电机正反转。
9. 堵转或快速换向时监测5V、3.3V和主控是否复位。
10. 确认保险丝、总开关和急停能够真实切断电机支路。
11. 所有模块通过独立测试后再固定到桶体，并更新接线表和BOM状态。

通过标准：所有必需项目型号明确、供电极性正确、可独立运行且有测试记录；任何发热、异味、异常压降或接口电压不明的模块都不得进入整机联调。

# 14 关键兼容性与安全红线

电池：2S电池使用8.4V CC/CV充电器和2S BMS，不混用新旧电芯，不在无人看守时充电。

逻辑电平：STM32 GPIO为3.3V逻辑。HC-SR04 Echo及任何5V数字输出必须先分压或转换。

大电流负载：电机、舵机、蜂鸣器等负载使用独立电源或驱动器，所有模块共地但动力线与信号线分开布置。

机械安全：首次电机测试架空车轮；首次舵机测试断开连杆；装配后急停开关必须在一伸手即可触及的位置。

火情演示：只使用测试按钮、受控红外信号或教师批准的低风险方式注入火情状态，不在装有锂电池的模型上进行真实燃烧。

清单结束 · 实际采购型号与机械尺寸均以到货实物测量和教师要求为准。

STM32 智能移动垃圾桶 硬件采购 BOM
