Sylphiette666/stm32-rfid-smart-bin/docs/manual/illustrated-source/figures/s01_debug_order.png

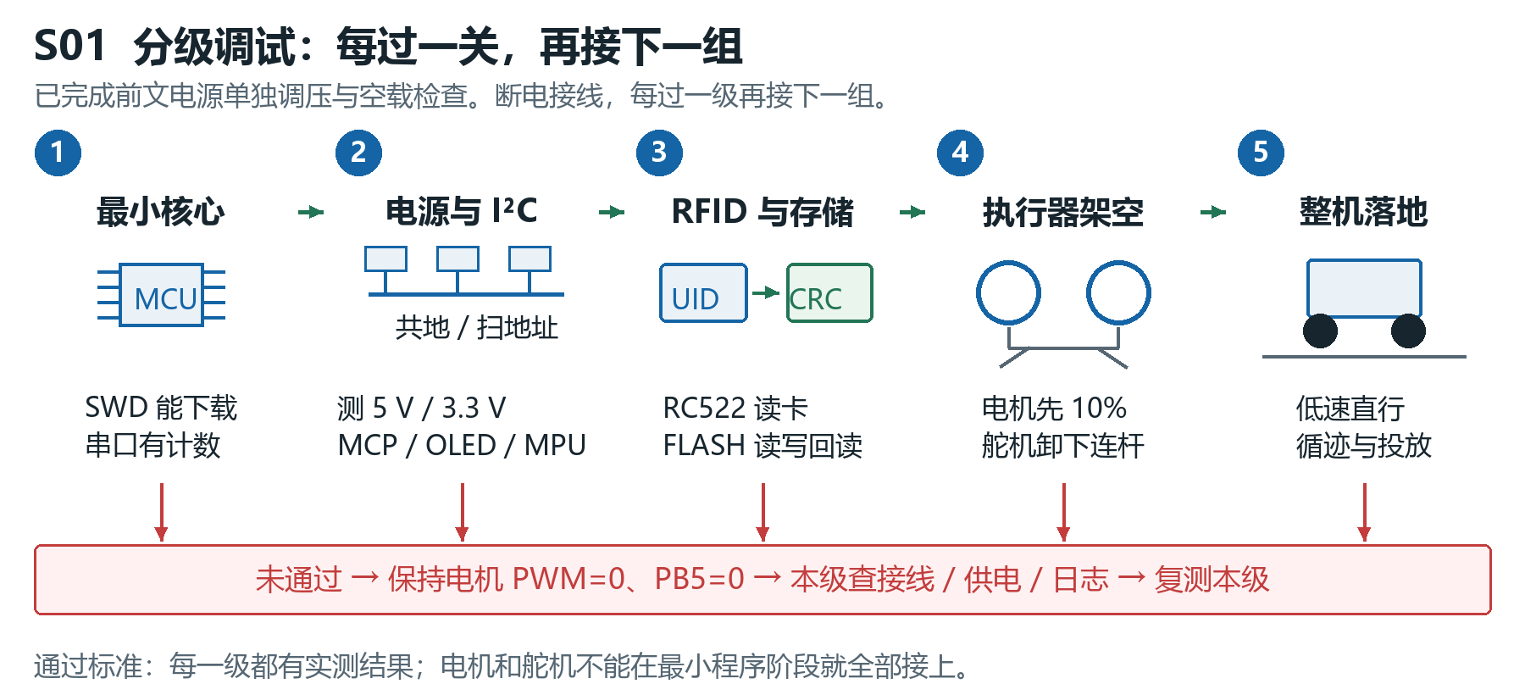
docs/manual/illustrated-source/figures/s01_debug_order.png
