Sylphiette666/stm32-rfid-smart-bin/hardware/current-low-cost/pcb-a/diagrams/45_pcb_top.png

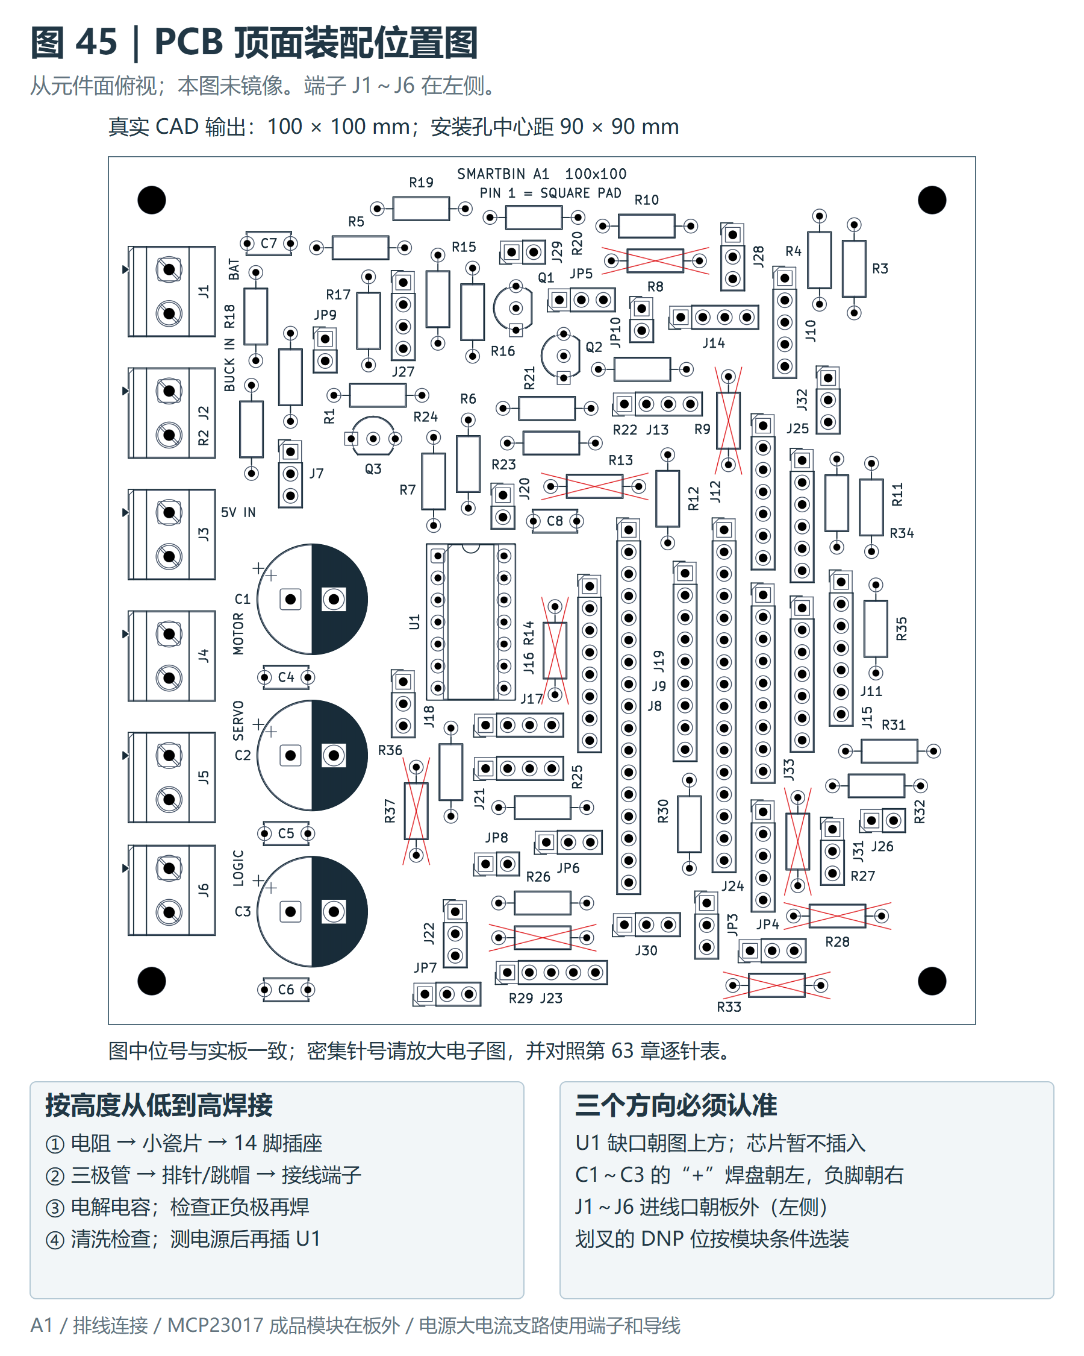
hardware/current-low-cost/pcb-a/diagrams/45_pcb_top.png
