Sylphiette666/stm32-rfid-smart-bin/hardware/current-low-cost/pcb-a/diagrams/46_pcb_bottom.png

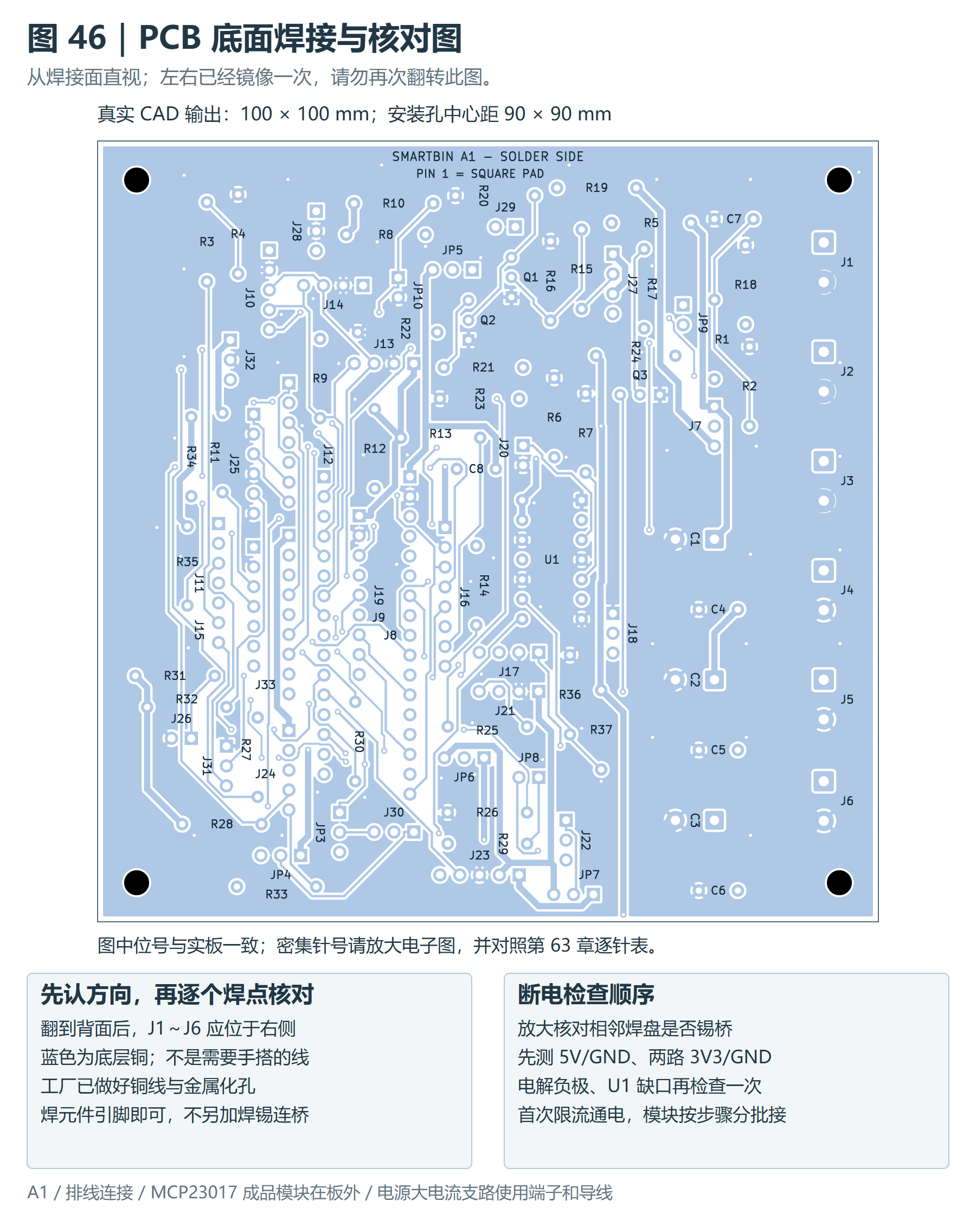
hardware/current-low-cost/pcb-a/diagrams/46_pcb_bottom.png
