Sylphiette666/stm32-rfid-smart-bin/hardware/current-low-cost/pcb-a/diagrams/47_power.png

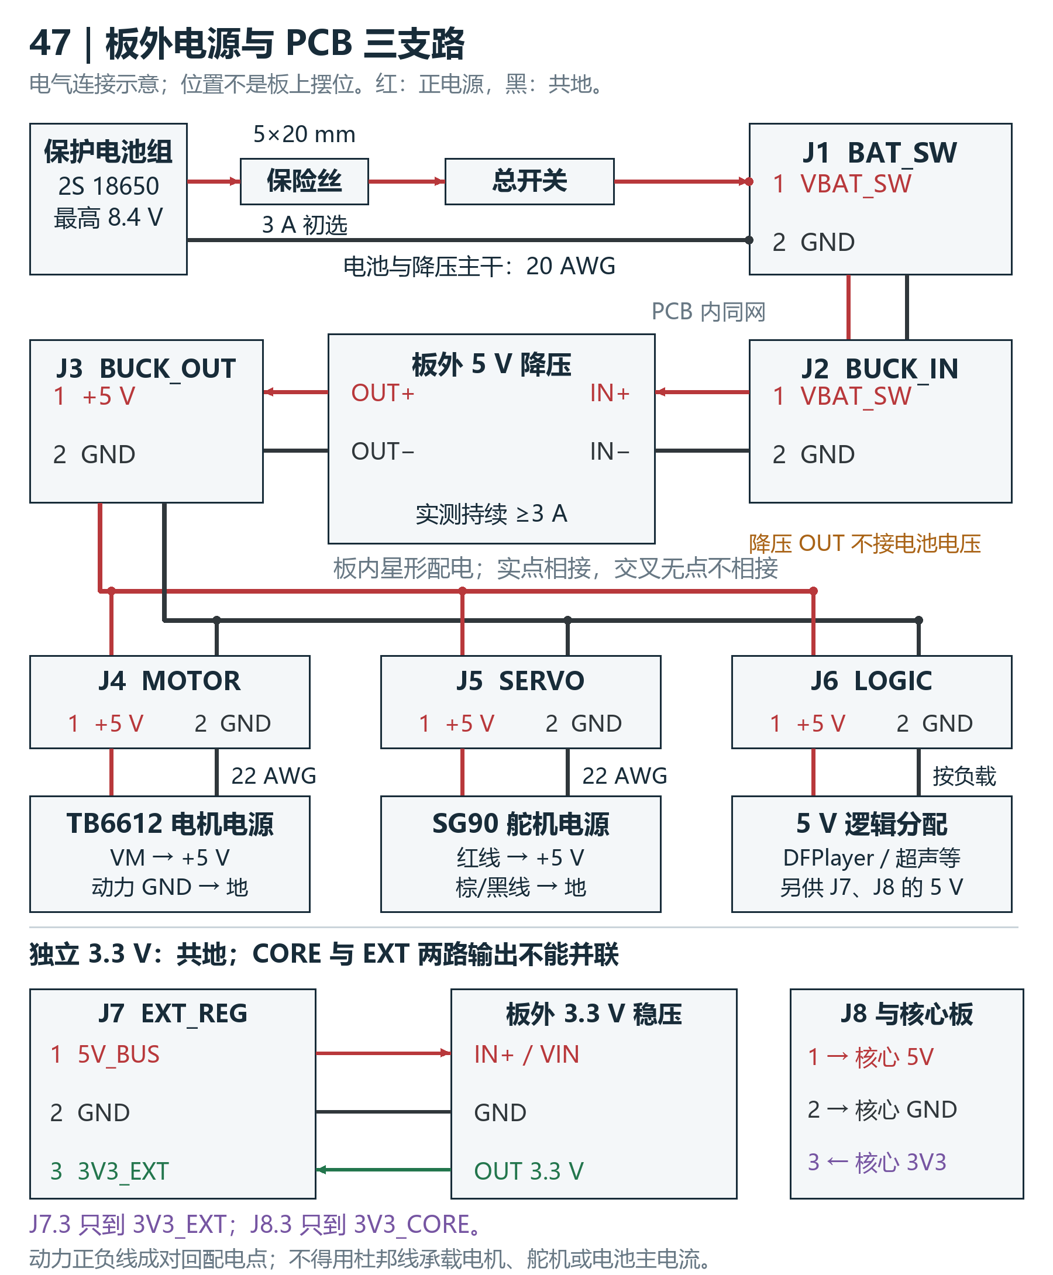
hardware/current-low-cost/pcb-a/diagrams/47_power.png
