Sylphiette666/stm32-rfid-smart-bin/hardware/current-low-cost/pcb-a/diagrams/48_modules.png

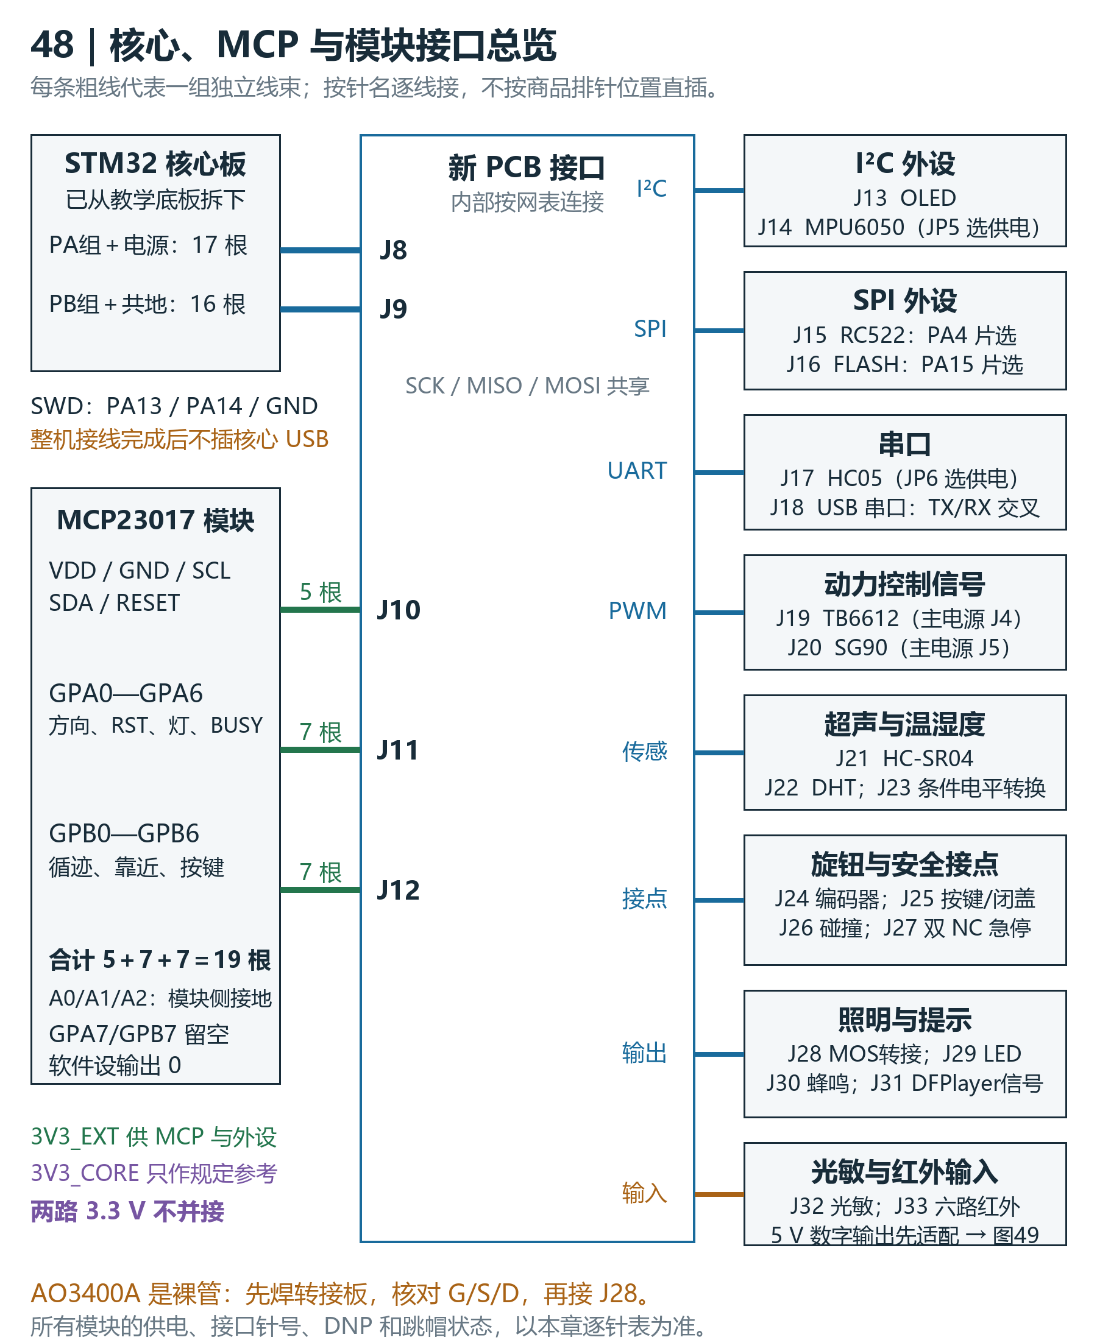
hardware/current-low-cost/pcb-a/diagrams/48_modules.png
