Sylphiette666/stm32-rfid-smart-bin/hardware/current-low-cost/pcb-a/diagrams/49_conditions.png

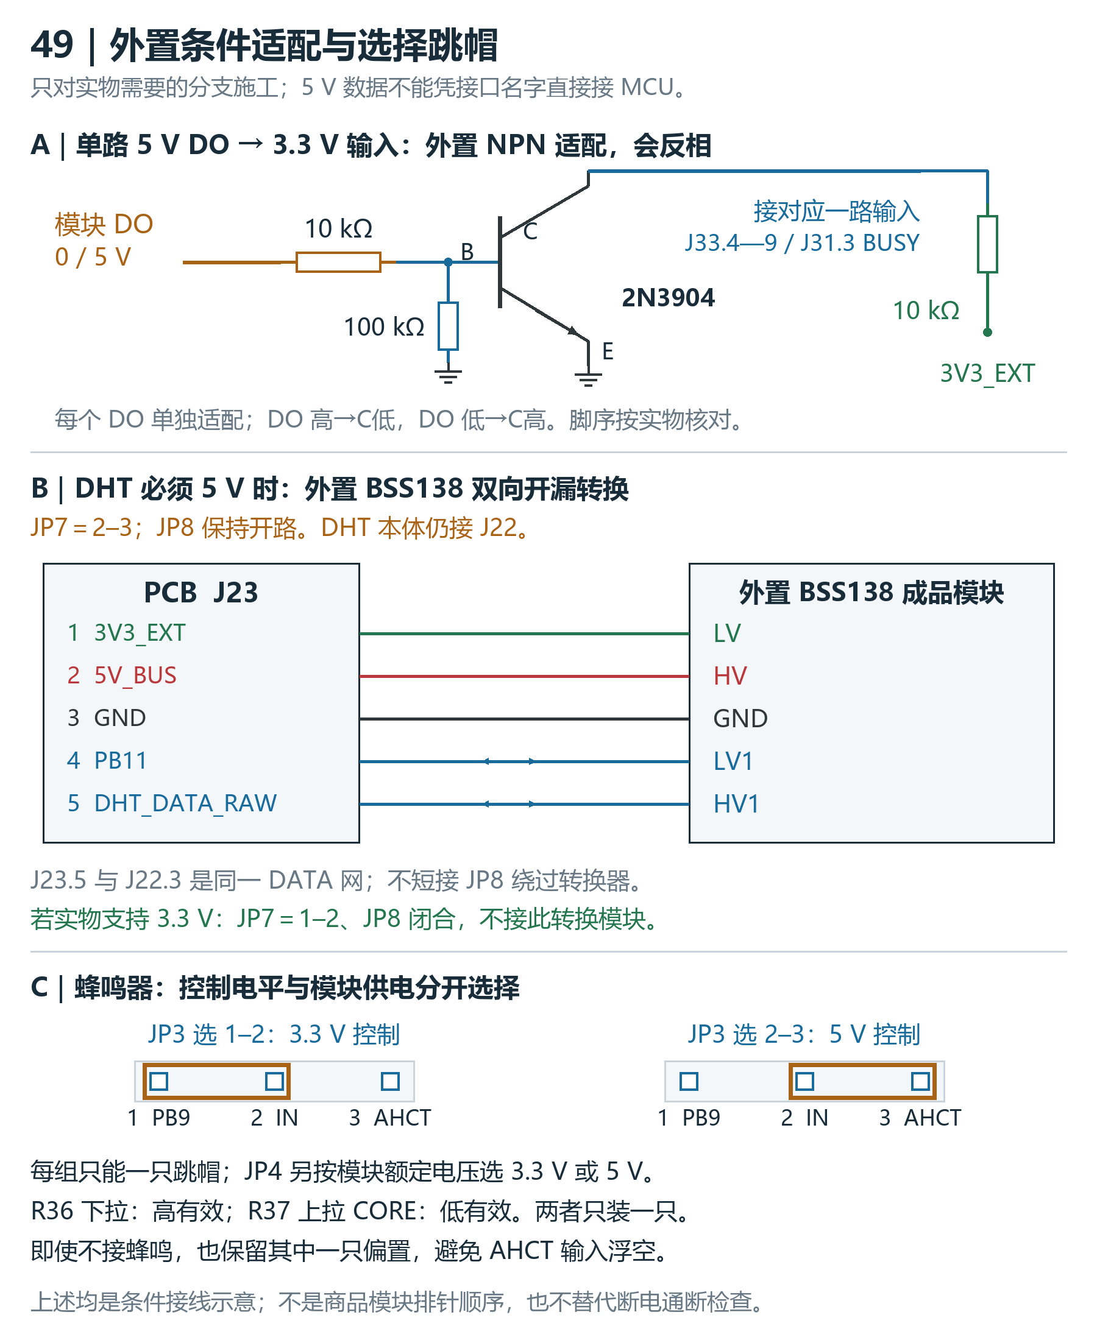
hardware/current-low-cost/pcb-a/diagrams/49_conditions.png
