Sylphiette666/stm32-rfid-smart-bin/hardware/current-low-cost/pcb-a/review/bom-preview.png

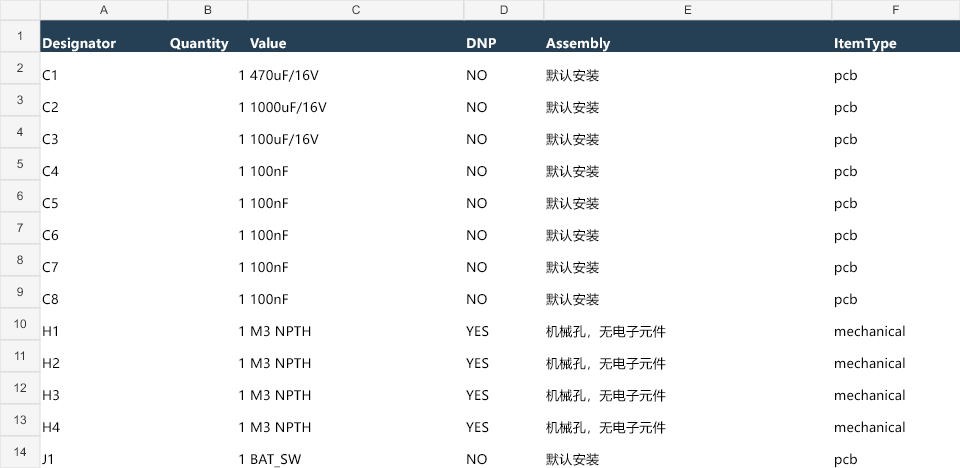
hardware/current-low-cost/pcb-a/review/bom-preview.png
