Sylphiette666/stm32-rfid-smart-bin/hardware/current-low-cost/pcb-a/review/cam-bottom.png

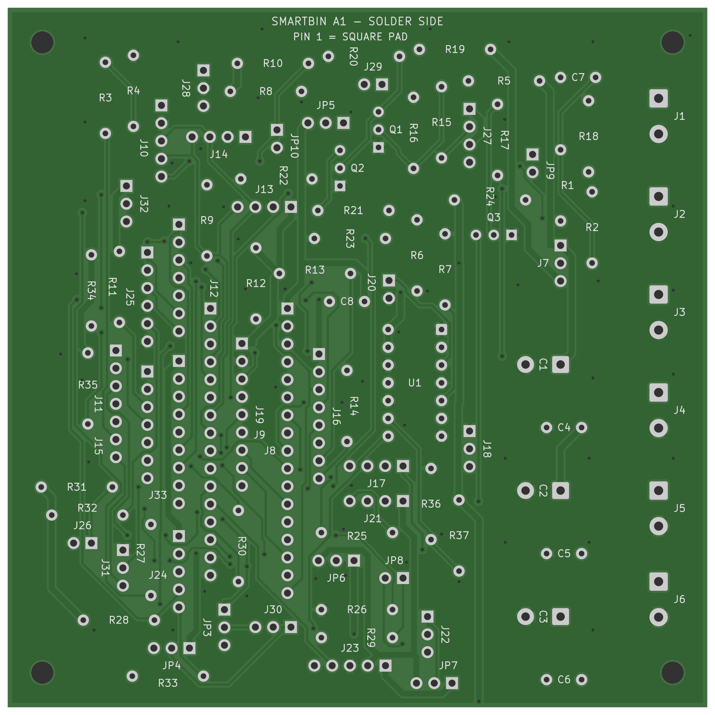
hardware/current-low-cost/pcb-a/review/cam-bottom.png
