Sylphiette666/stm32-rfid-smart-bin/hardware/current-low-cost/pcb-a/review/cam-top.png

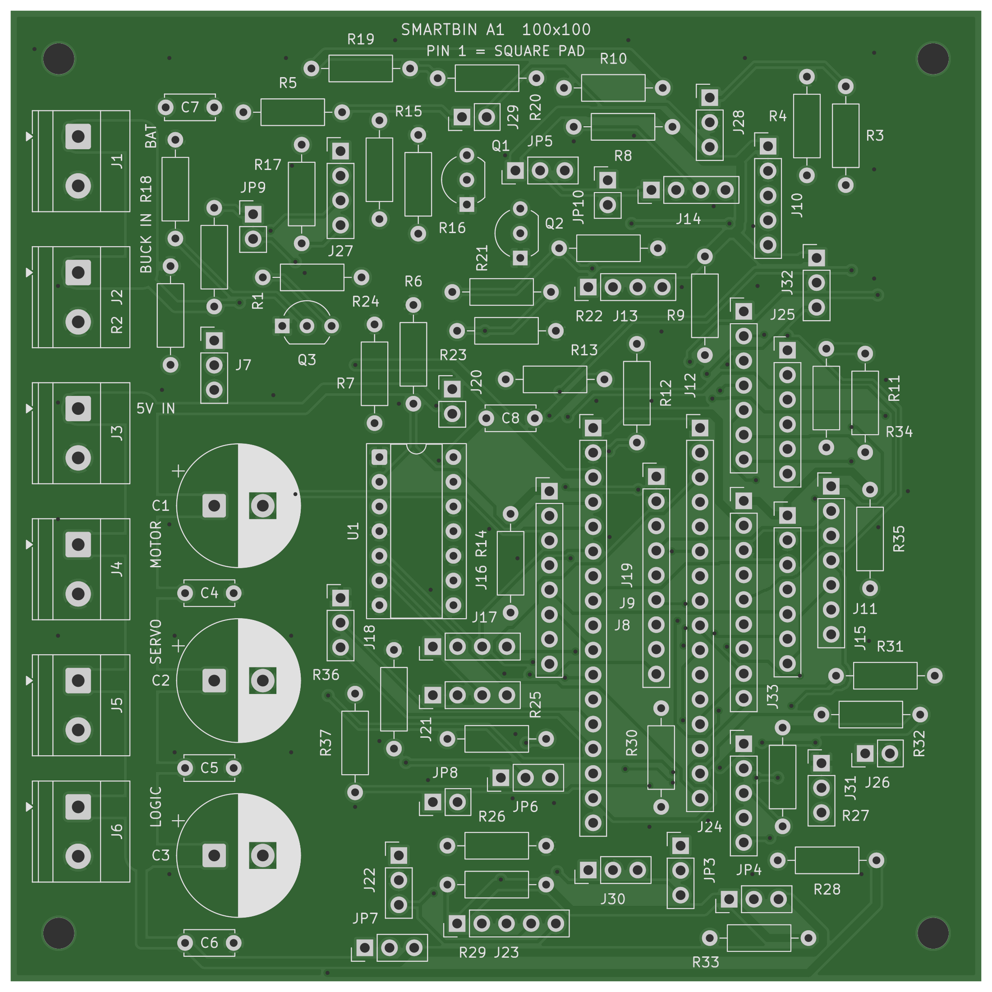
hardware/current-low-cost/pcb-a/review/cam-top.png
