Sylphiette666/stm32-rfid-smart-bin/hardware/current-low-cost/perfboard/IO_front.png

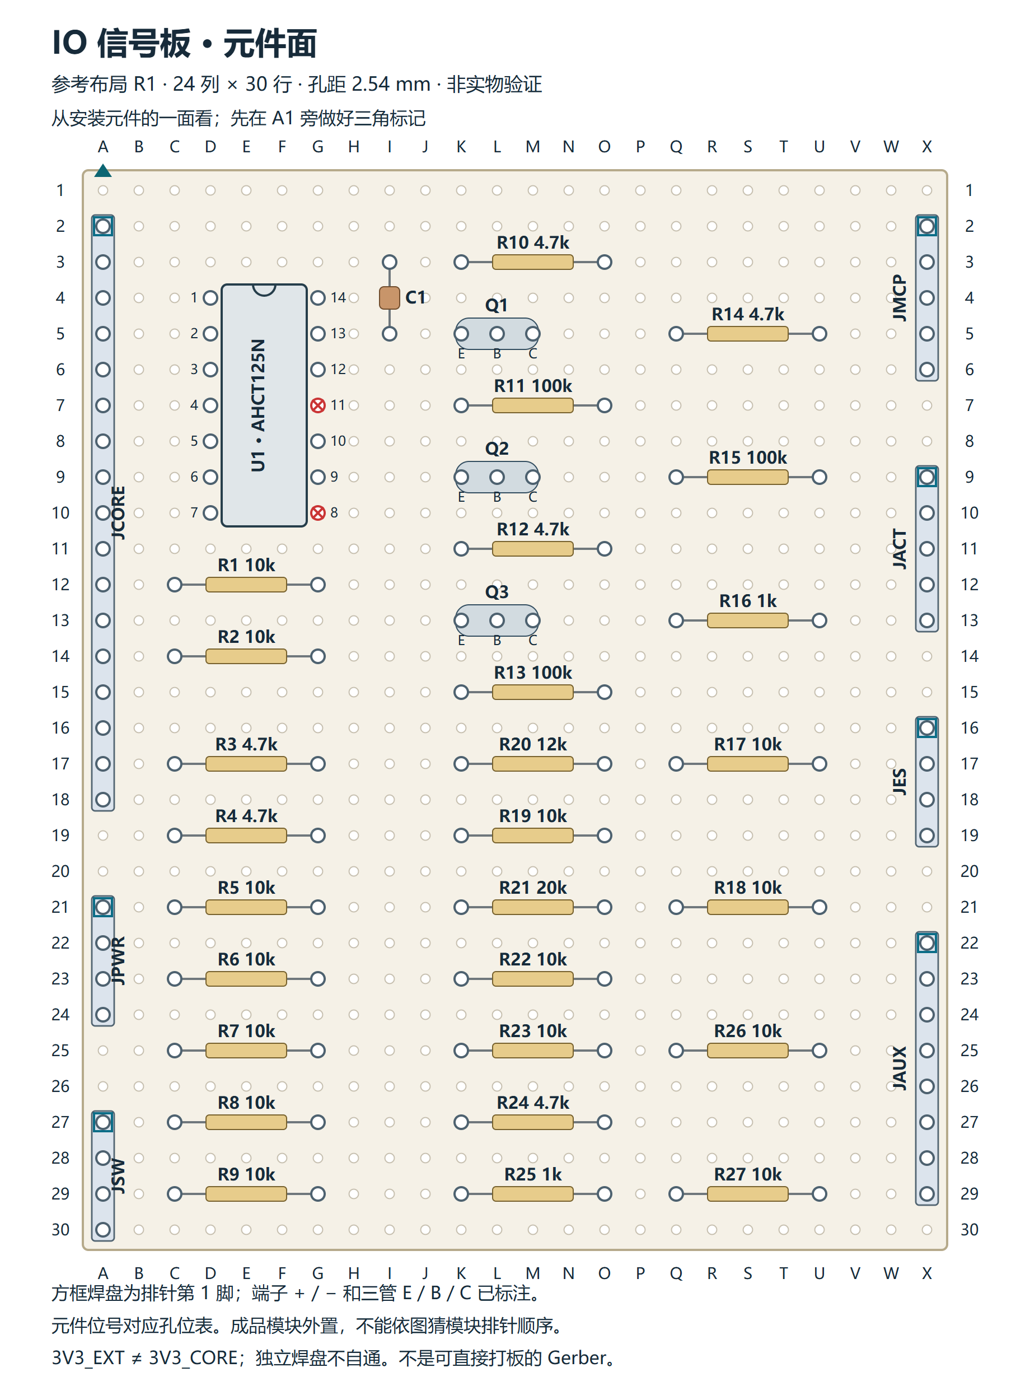
hardware/current-low-cost/perfboard/IO_front.png
