Sylphiette666/stm32-rfid-smart-bin/hardware/current-low-cost/perfboard/PWR_back.png

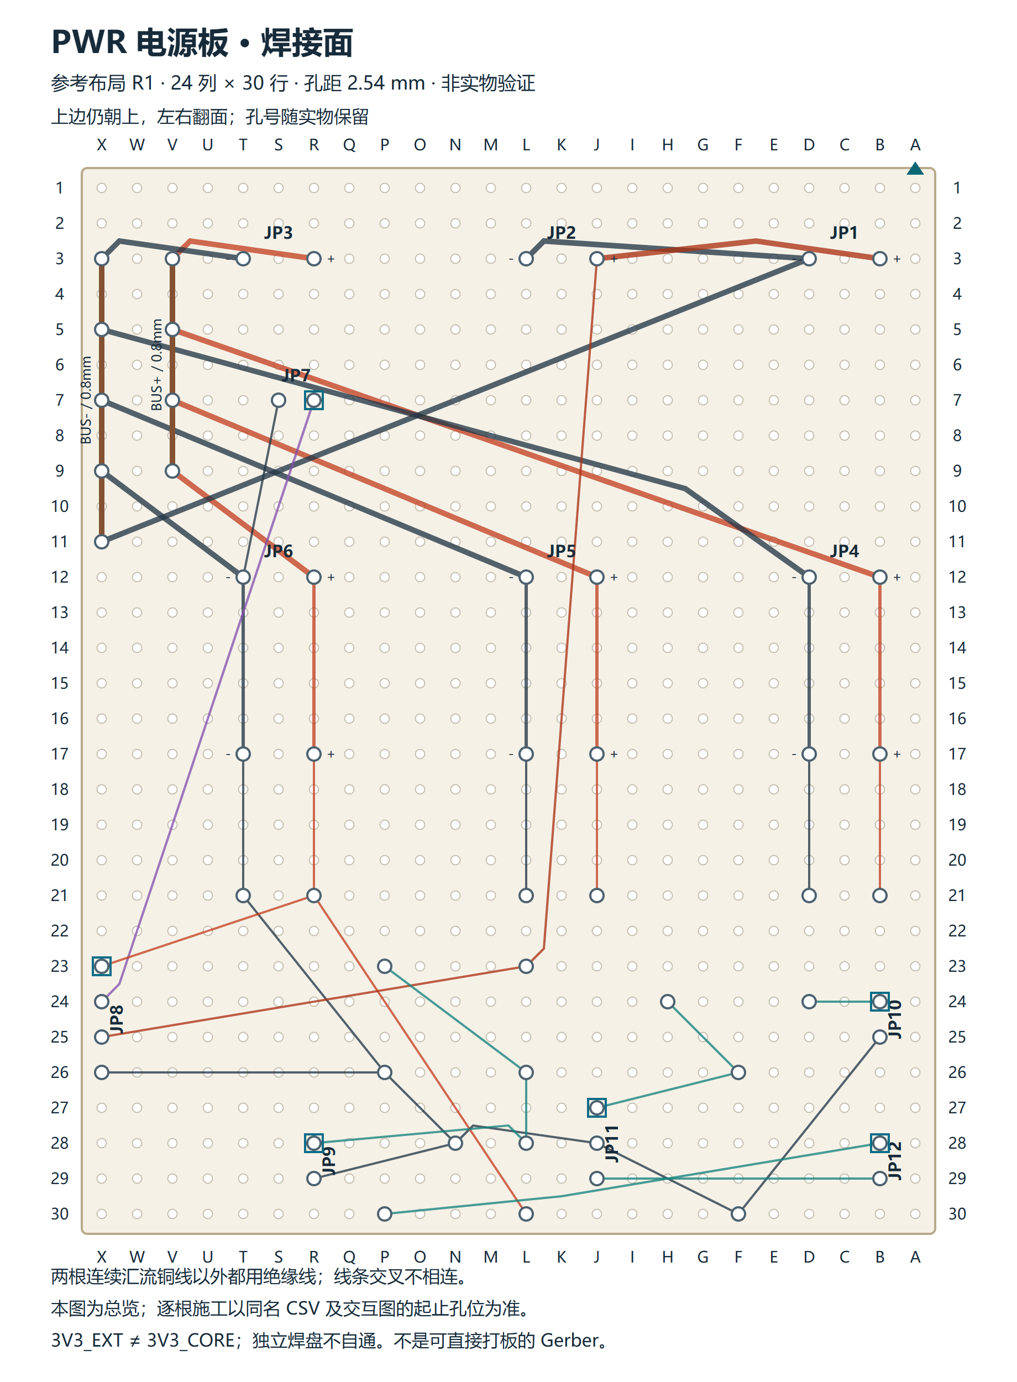
hardware/current-low-cost/perfboard/PWR_back.png
