Sylphiette666/stm32-rfid-smart-bin/hardware/mechanical/print-backup/lid-fine-20261103/preview/02_lid_parts.png

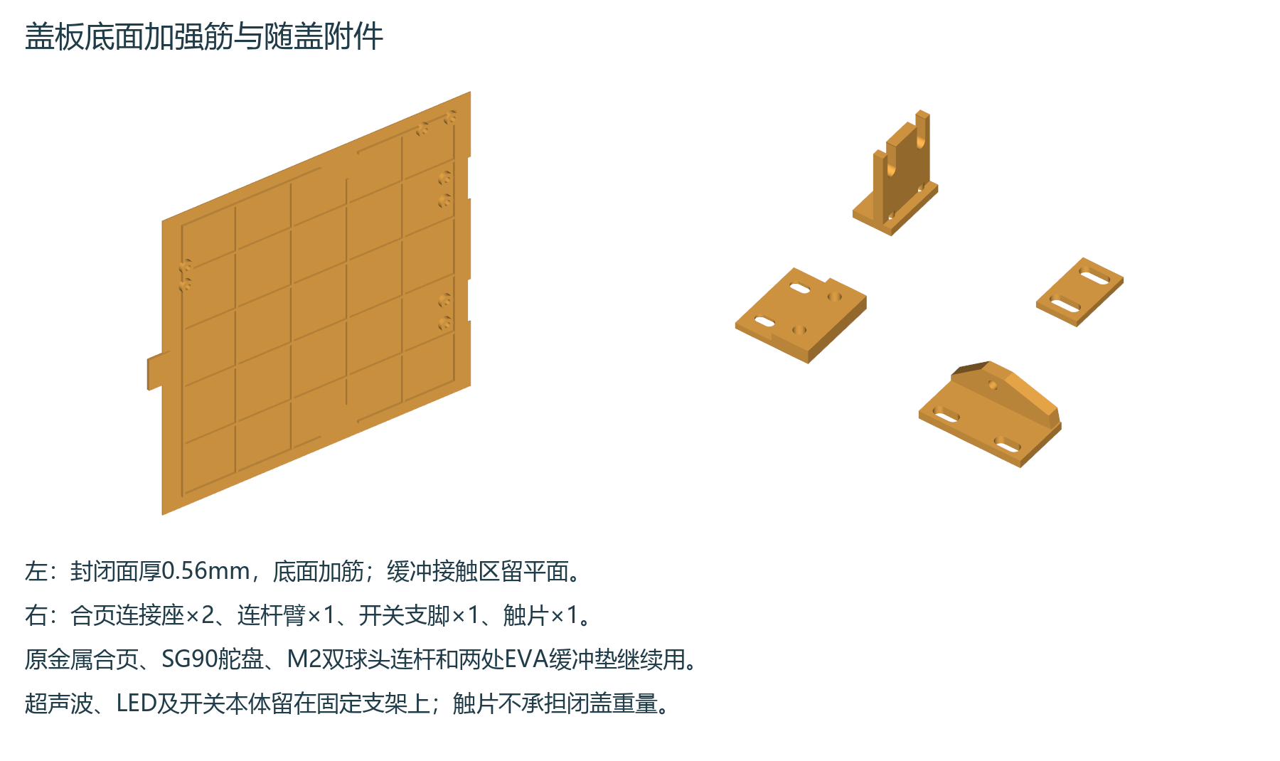
hardware/mechanical/print-backup/lid-fine-20261103/preview/02_lid_parts.png
