Sylphiette666/stm32-rfid-smart-bin/hardware/mechanical/print-backup/caster-riser-20261103/step/CASTER_FRAME_ASSEMBLY.step

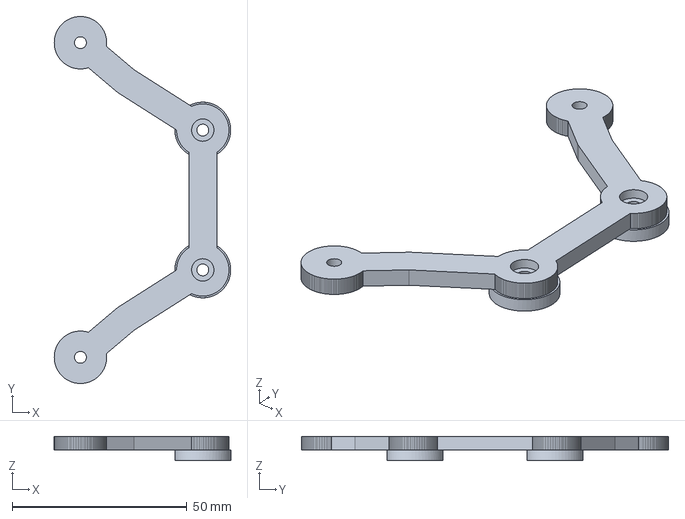
[picture p44: CAD file, 2026-11-03]
hardware/mechanical/print-backup/caster-riser-20261103/step/CASTER_FRAME_ASSEMBLY.step
50.5 x 105.0 x 7.00 mm
