Sylphiette666/stm32-rfid-smart-bin/hardware/mechanical/print-backup/flat-split-20261101/source/assembly_bridge1.stl

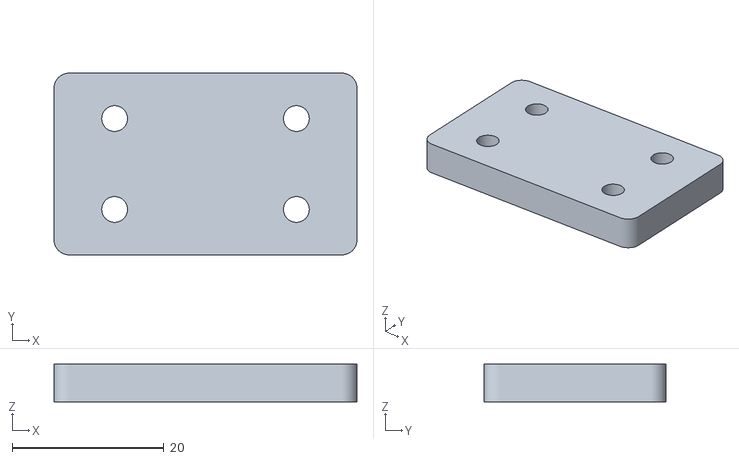
[picture p45: CAD file, 2026-11-01]
hardware/mechanical/print-backup/flat-split-20261101/source/assembly_bridge1.stl
40.0 x 24.0 x 5.00
