Sylphiette666/stm32-rfid-smart-bin/hardware/mechanical/print-backup/lid-fine-20261103/step/T01_HINGE_FIT_COUPON_ASSEMBLY.step

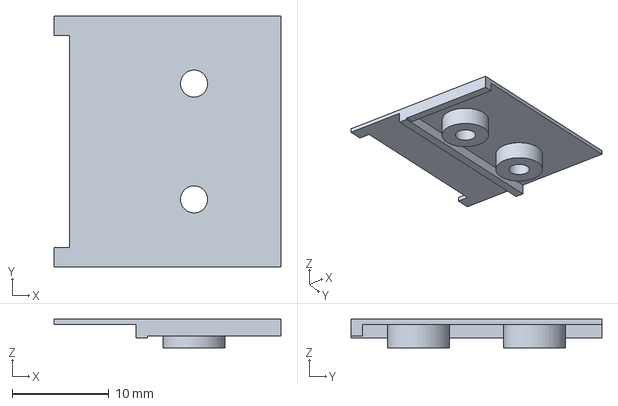
[picture p46: CAD file, 2026-11-03]
hardware/mechanical/print-backup/lid-fine-20261103/step/T01_HINGE_FIT_COUPON_ASSEMBLY.step
23.5 x 26.0 x 2.96 mm
