Sylphiette666/stm32-rfid-smart-bin/hardware/mechanical/print-backup/motor-existing-holes-light-20261103/step/D06_CARRIER_LEFT_ASSEMBLY.step

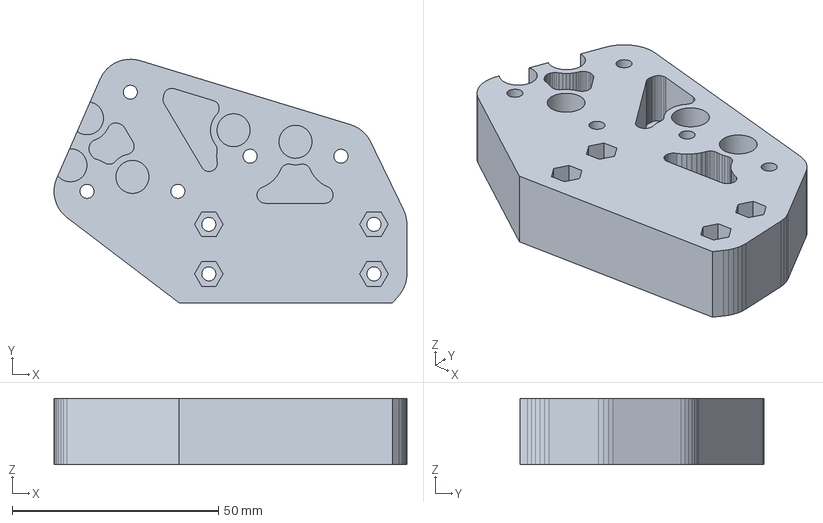
[picture p47: CAD file, 2026-11-02]
hardware/mechanical/print-backup/motor-existing-holes-light-20261103/step/D06_CARRIER_LEFT_ASSEMBLY.step
85.5 x 59.0 x 16.0 mm
