Sylphiette666/stm32-rfid-smart-bin/hardware/mechanical/print-backup/sensor-retainers-fix-20261103/step/LIGHT_REPAIR_ASSEMBLY.step

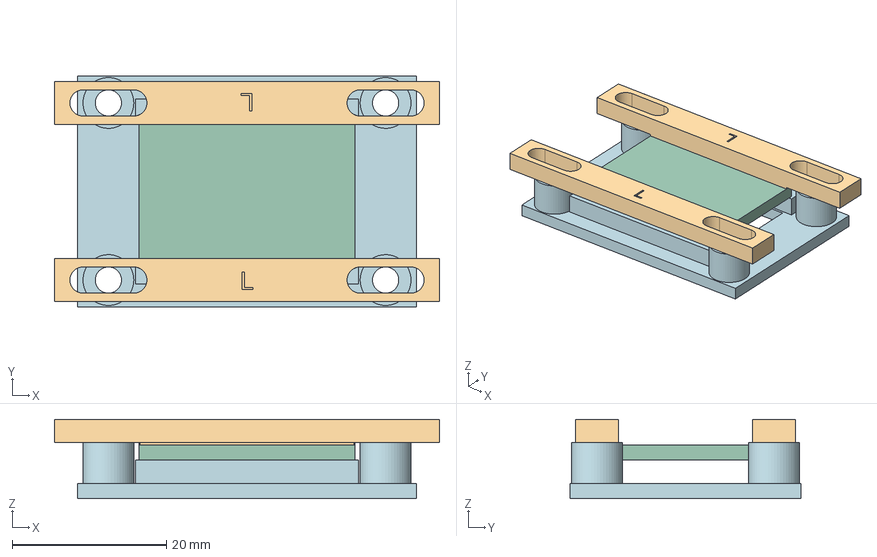
[picture p48: CAD file, 2026-11-03]
hardware/mechanical/print-backup/sensor-retainers-fix-20261103/step/LIGHT_REPAIR_ASSEMBLY.step
50.0 x 30.0 x 10.3 mm
RETAIN_OLD_LIGHT_CRADLE
NEW_LOWER_BAR
NEW_UPPER_BAR
PCB_ENVELOPE_ONLY
