Sylphiette666/stm32-rfid-smart-bin/hardware/mechanical/print-backup/step/ASSEMBLY_VIEW_ONLY.step

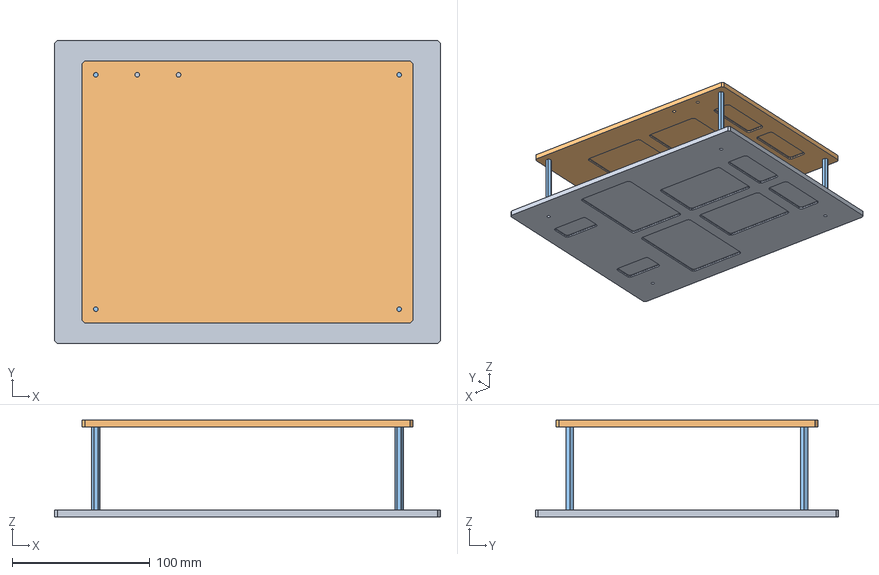
[picture p49: CAD file, 2026-10-30]
hardware/mechanical/print-backup/step/ASSEMBLY_VIEW_ONLY.step
280.0 x 220.0 x 70.0 mm
