Sylphiette666/stm32-rfid-smart-bin/hardware/mechanical/print-backup/stl/full/P02_full.stl

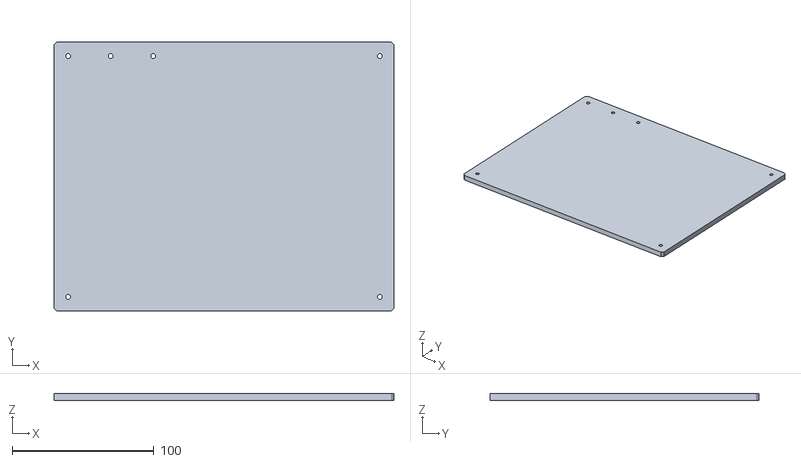
[picture p50: CAD file, 2026-10-30]
hardware/mechanical/print-backup/stl/full/P02_full.stl
240.0 x 190.0 x 5.00
