Sylphiette666/stm32-rfid-smart-bin/hardware/mechanical/print-backup/tracker-mount-20261103/step/TRACKER_FRAME_ASSEMBLY.step

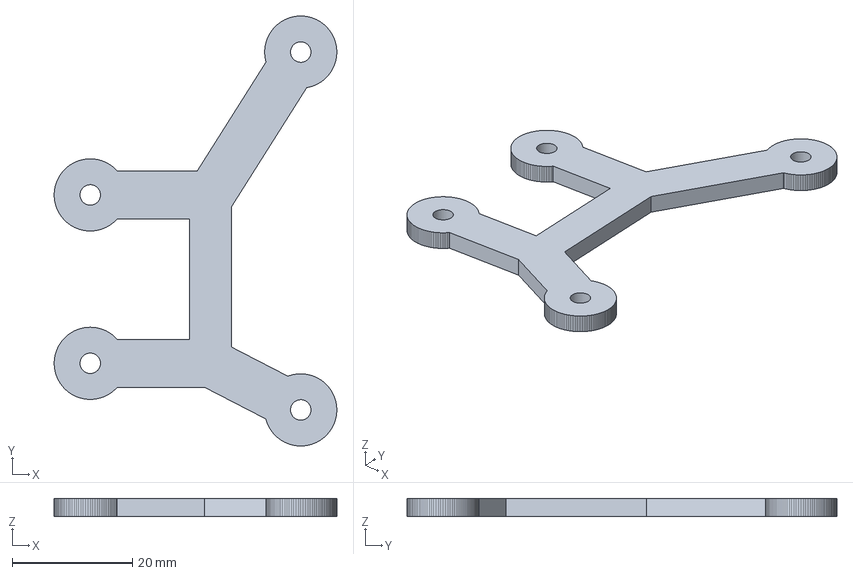
[picture p51: CAD file, 2026-11-03]
hardware/mechanical/print-backup/tracker-mount-20261103/step/TRACKER_FRAME_ASSEMBLY.step
47.0 x 71.5 x 3.00 mm
