Sylphiette666/stm32-rfid-smart-bin/hardware/mechanical/print-backup/wall-clamps-fine-20261103/step/C3_RIGHT_FRONT_ASSEMBLY.step

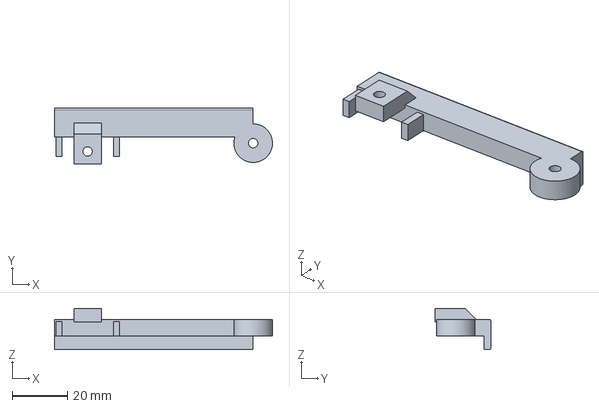
[picture p52: CAD file, 2026-11-03]
hardware/mechanical/print-backup/wall-clamps-fine-20261103/step/C3_RIGHT_FRONT_ASSEMBLY.step
79.0 x 20.2 x 15.0 mm
