Sylphiette666/stm32-rfid-smart-bin/hardware/mechanical/print-backup/flat-split-20261101/source/assembly_rear.stl

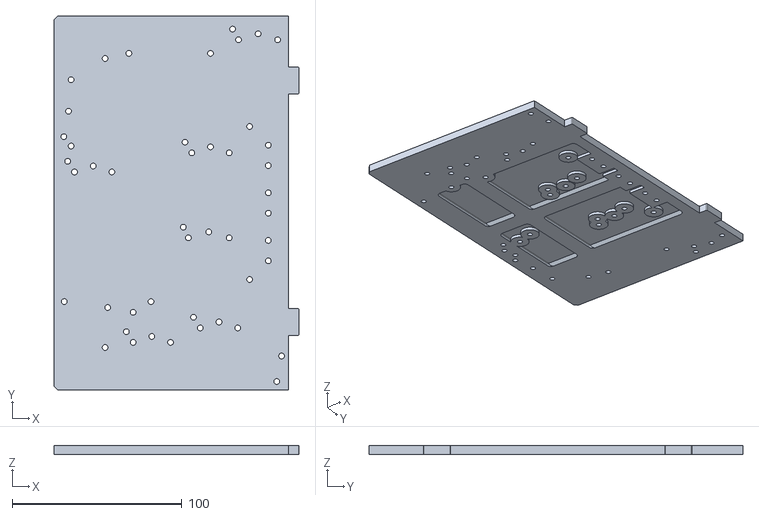
[picture p53: CAD file, 2026-11-01]
hardware/mechanical/print-backup/flat-split-20261101/source/assembly_rear.stl
144.0 x 220.0 x 5.00
