Sylphiette666/stm32-rfid-smart-bin/hardware/mechanical/print-backup/motor-existing-holes-20261102/step/D06_SEAT_LEFT_ASSEMBLY.step

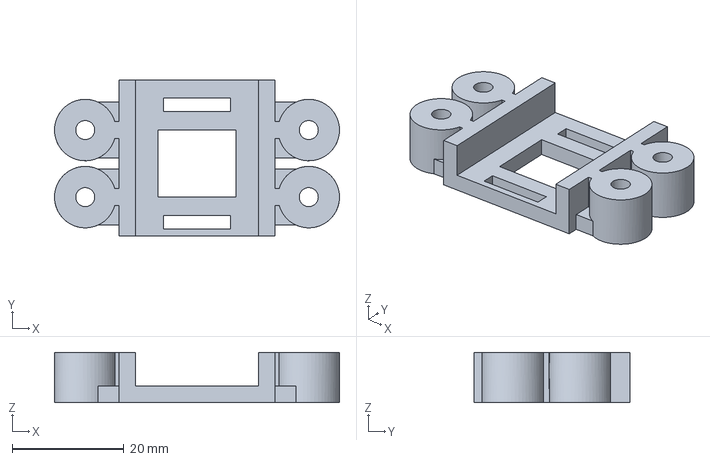
[picture p54: CAD file, 2026-11-02]
hardware/mechanical/print-backup/motor-existing-holes-20261102/step/D06_SEAT_LEFT_ASSEMBLY.step
51.0 x 28.0 x 9.00 mm
