Sylphiette666/stm32-rfid-smart-bin/hardware/mechanical/print-backup/sensor-retainers-fix-20261103/step/BEAM_CUP_V2_ASSEMBLY.step

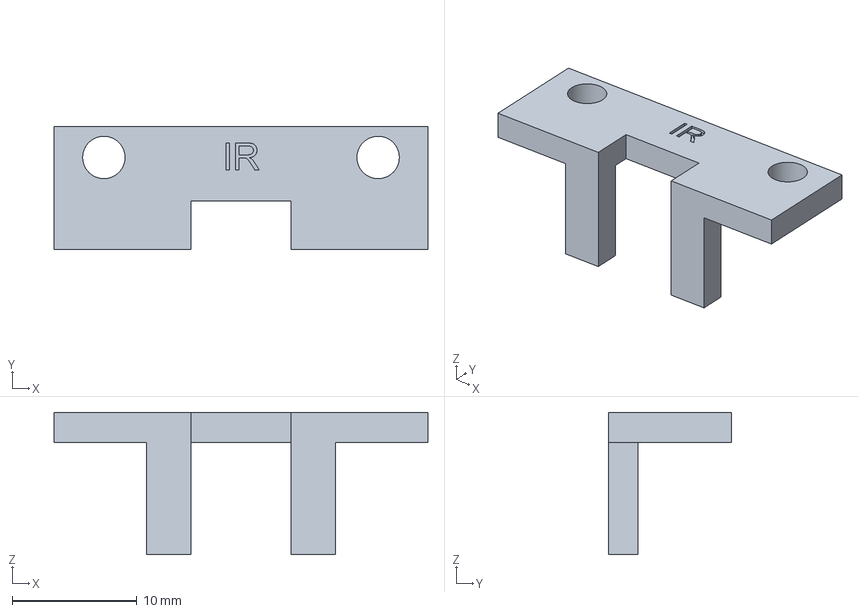
[picture p56: CAD file, 2026-11-03]
hardware/mechanical/print-backup/sensor-retainers-fix-20261103/step/BEAM_CUP_V2_ASSEMBLY.step
30.0 x 9.90 x 11.4 mm
