Sylphiette666/stm32-rfid-smart-bin/hardware/mechanical/print-backup/stl/full/P01_full.stl

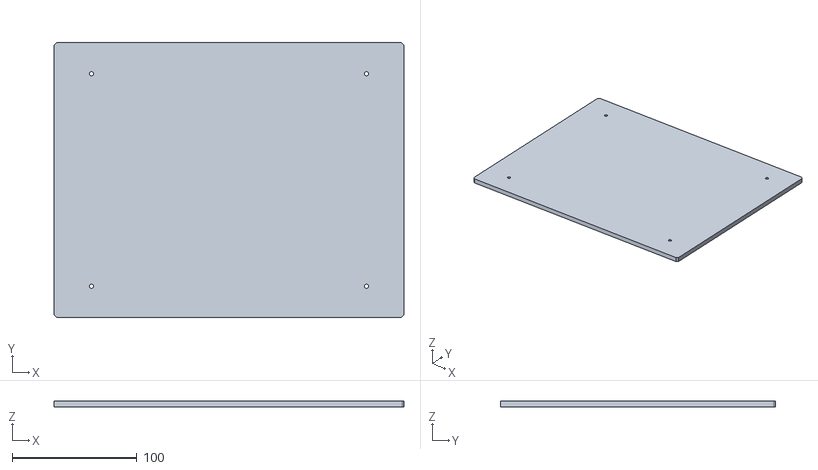
[picture p57: CAD file, 2026-10-30]
hardware/mechanical/print-backup/stl/full/P01_full.stl
280.0 x 220.0 x 5.00
