Sylphiette666/stm32-rfid-smart-bin/hardware/mechanical/print-backup/integrated-pla-20261104/step/ASSEMBLY_REFERENCE.step

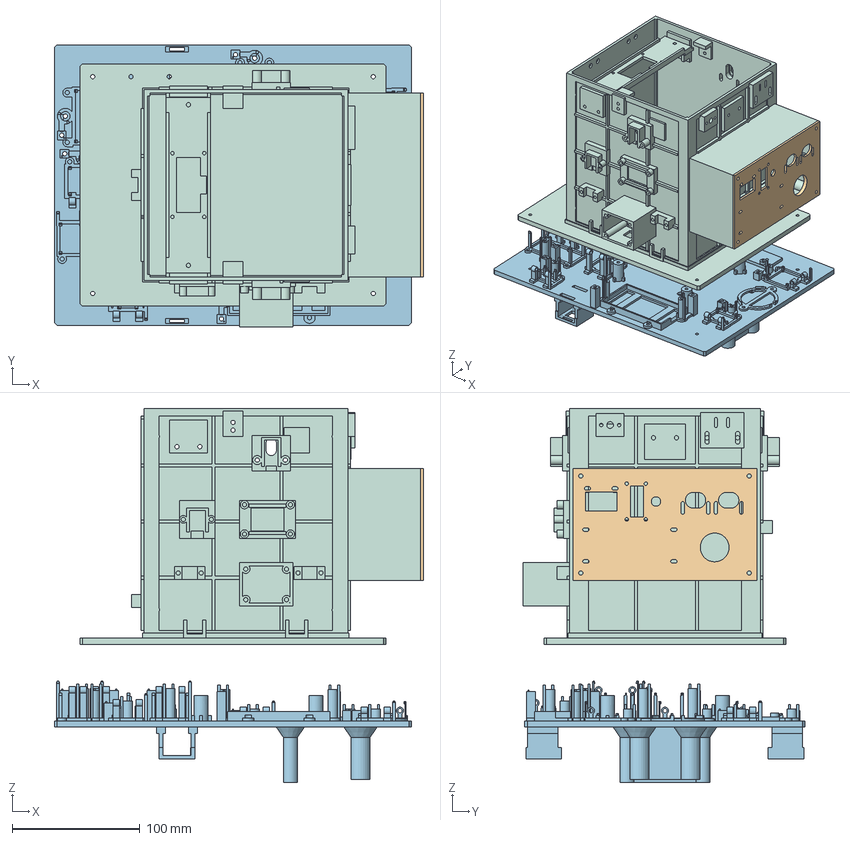
[picture p58: CAD file, 2026-11-03]
hardware/mechanical/print-backup/integrated-pla-20261104/step/ASSEMBLY_REFERENCE.step
289.4 x 221.5 x 293.4 mm
LOWER_H41_B1
UPPER_INTEGRATED
PANEL_REMOVABLE_REFERENCE
