Sylphiette666/stm32-rfid-smart-bin/hardware/mechanical/print-backup/lid-fine-20261103/step/L03_LINK_ARM_ASSEMBLY.step

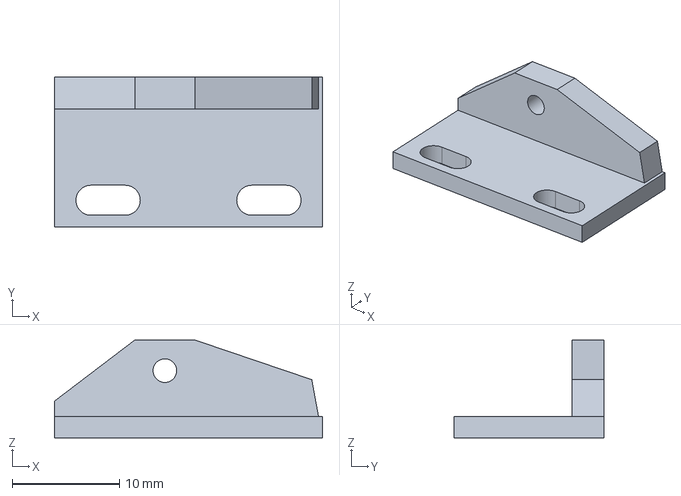
[picture p59: CAD file, 2026-11-03]
hardware/mechanical/print-backup/lid-fine-20261103/step/L03_LINK_ARM_ASSEMBLY.step
25.0 x 14.0 x 9.14 mm
