Sylphiette666/stm32-rfid-smart-bin/hardware/mechanical/print-backup/motor-existing-holes-20261102/step/D06_SEAT_RIGHT_ASSEMBLY.step

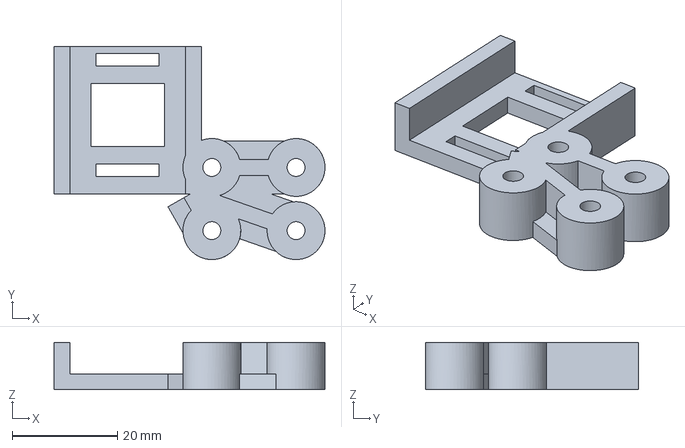
[picture p60: CAD file, 2026-11-02]
hardware/mechanical/print-backup/motor-existing-holes-20261102/step/D06_SEAT_RIGHT_ASSEMBLY.step
51.5 x 40.5 x 9.00 mm
