Sylphiette666/stm32-rfid-smart-bin/hardware/mechanical/print-backup/motor-existing-holes-light-20261103/step/D06_CARRIER_RIGHT_ASSEMBLY.step

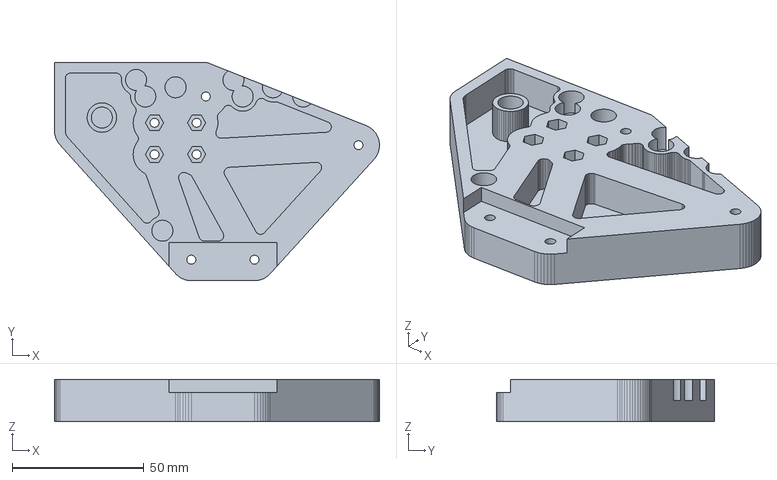
[picture p61: CAD file, 2026-11-02]
hardware/mechanical/print-backup/motor-existing-holes-light-20261103/step/D06_CARRIER_RIGHT_ASSEMBLY.step
123.5 x 83.0 x 16.0 mm
