Sylphiette666/stm32-rfid-smart-bin/hardware/mechanical/print-backup/flat-split-20261101/step/P01_ASSEMBLY_VIEW_ONLY.step

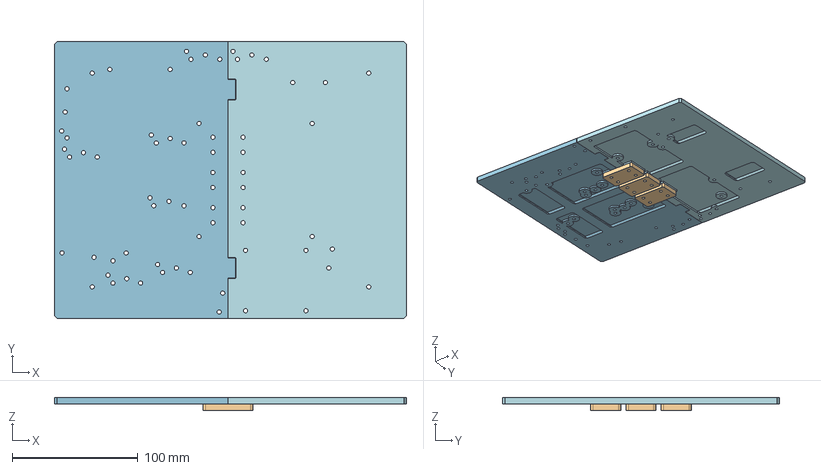
[picture p62: CAD file, 2026-11-01]
hardware/mechanical/print-backup/flat-split-20261101/step/P01_ASSEMBLY_VIEW_ONLY.step
280.0 x 220.0 x 10.0 mm
P01_REAR_HALF
P01_FRONT_HALF
BRIDGE_1
BRIDGE_2
BRIDGE_3
