Sylphiette666/stm32-rfid-smart-bin/hardware/mechanical/print-backup/lid-fine-20261103/step/L04_SWITCH_FOOT_ASSEMBLY.step

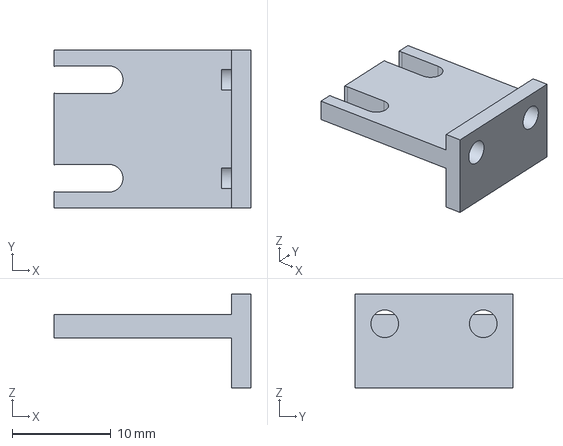
[picture p63: CAD file, 2026-11-03]
hardware/mechanical/print-backup/lid-fine-20261103/step/L04_SWITCH_FOOT_ASSEMBLY.step
20.0 x 16.0 x 9.50 mm
