Sylphiette666/stm32-rfid-smart-bin/hardware/mechanical/print-backup/sensor-retainers-fix-20261103/step/LIGHT_BAR_V2_ASSEMBLY.step

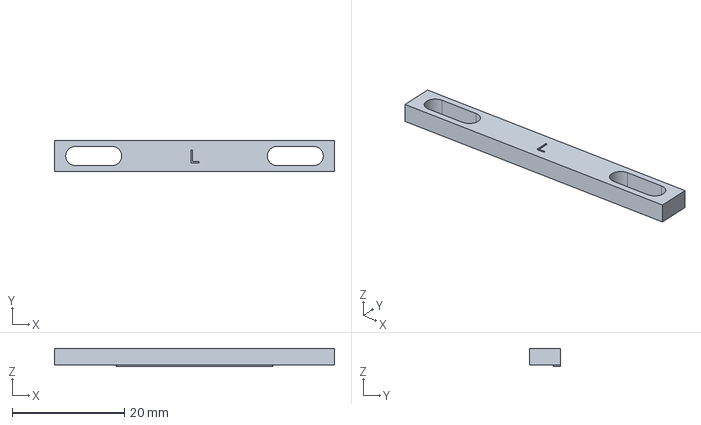
[picture p65: CAD file, 2026-11-03]
hardware/mechanical/print-backup/sensor-retainers-fix-20261103/step/LIGHT_BAR_V2_ASSEMBLY.step
50.0 x 5.60 x 3.30 mm
