Sylphiette666/stm32-rfid-smart-bin/hardware/mechanical/print-backup/sensor-retainers-fix-20261103/step/BEAM_REPAIR_ASSEMBLY.step

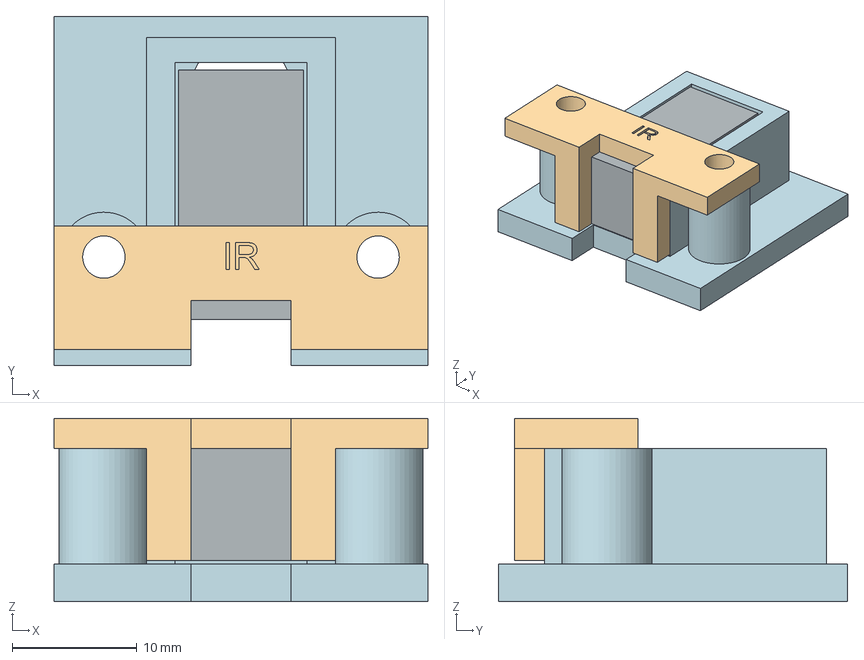
[picture p66: CAD file, 2026-11-03]
hardware/mechanical/print-backup/sensor-retainers-fix-20261103/step/BEAM_REPAIR_ASSEMBLY.step
30.0 x 28.0 x 14.7 mm
RETAIN_OLD_BEAM_SEAT
NEW_FORK_CUP
SENSOR_ENVELOPE_ONLY
