Sylphiette666/stm32-rfid-smart-bin/hardware/mechanical/print-backup/wall-clamp-preview-20261103/step/WALL_CLAMPS_ASSEMBLY_PREVIEW.step

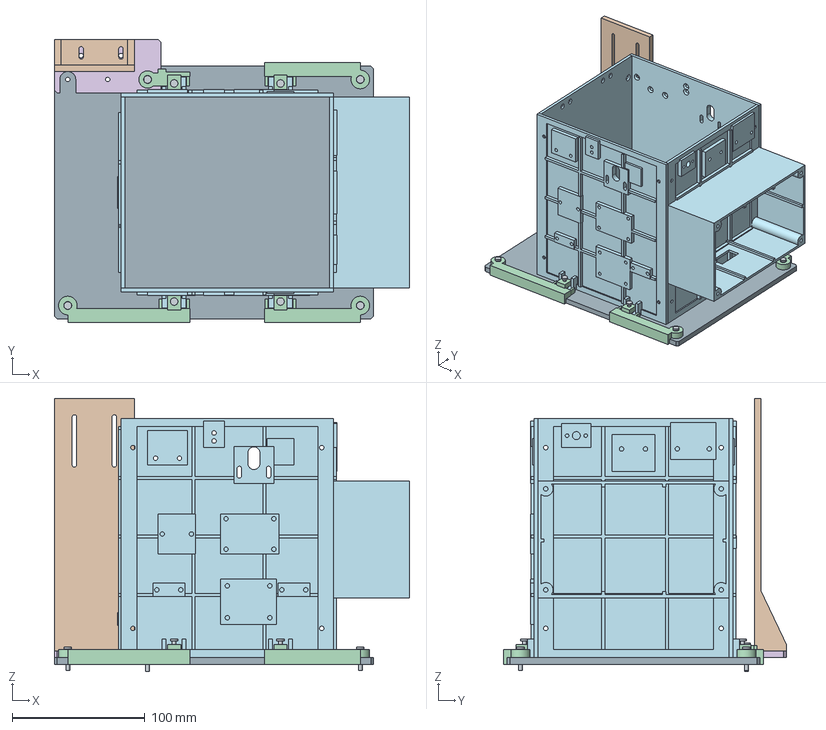
[picture p67: CAD file, 2026-11-03]
hardware/mechanical/print-backup/wall-clamp-preview-20261103/step/WALL_CLAMPS_ASSEMBLY_PREVIEW.step
267.0 x 212.7 x 205.5 mm
EXISTING_P02
EXISTING_P04_TRAY
EXISTING_P03_STAND
W01_FRONT
W02_REAR
W03_LEFT
W04_RIGHT
C1_LEFT_REAR
C1_LEFT_REAR_PRESSURE_PAD
C1_LEFT_REAR_HARDWARE_0
C1_LEFT_REAR_HARDWARE_1
C1_LEFT_REAR_HARDWARE_2
C1_LEFT_REAR_HARDWARE_3
C2_LEFT_FRONT
C2_LEFT_FRONT_PRESSURE_PAD
C2_LEFT_FRONT_HARDWARE_0
C2_LEFT_FRONT_HARDWARE_1
C2_LEFT_FRONT_HARDWARE_2
C2_LEFT_FRONT_HARDWARE_3
C3_RIGHT_FRONT
C3_RIGHT_FRONT_PRESSURE_PAD
C3_RIGHT_FRONT_HARDWARE_0
C3_RIGHT_FRONT_HARDWARE_1
C3_RIGHT_FRONT_HARDWARE_2
C3_RIGHT_FRONT_HARDWARE_3
C4_RIGHT_REAR
C4_RIGHT_REAR_PRESSURE_PAD
C4_RIGHT_REAR_HARDWARE_0
C4_RIGHT_REAR_HARDWARE_1
C4_RIGHT_REAR_HARDWARE_2
C4_RIGHT_REAR_HARDWARE_3
