Sylphiette666/stm32-rfid-smart-bin/hardware/mechanical/print-backup/wall-clamps-fine-20261103/step/C4_RIGHT_REAR_ASSEMBLY.step

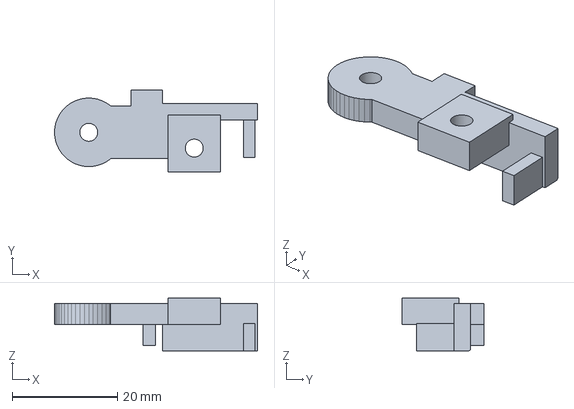
[picture p69: CAD file, 2026-11-03]
hardware/mechanical/print-backup/wall-clamps-fine-20261103/step/C4_RIGHT_REAR_ASSEMBLY.step
38.5 x 15.5 x 10.0 mm
