Sylphiette666/stm32-rfid-smart-bin/hardware/mechanical/print-backup/lid-fine-20261103/step/L02_HINGE_SHOE_ASSEMBLY.step

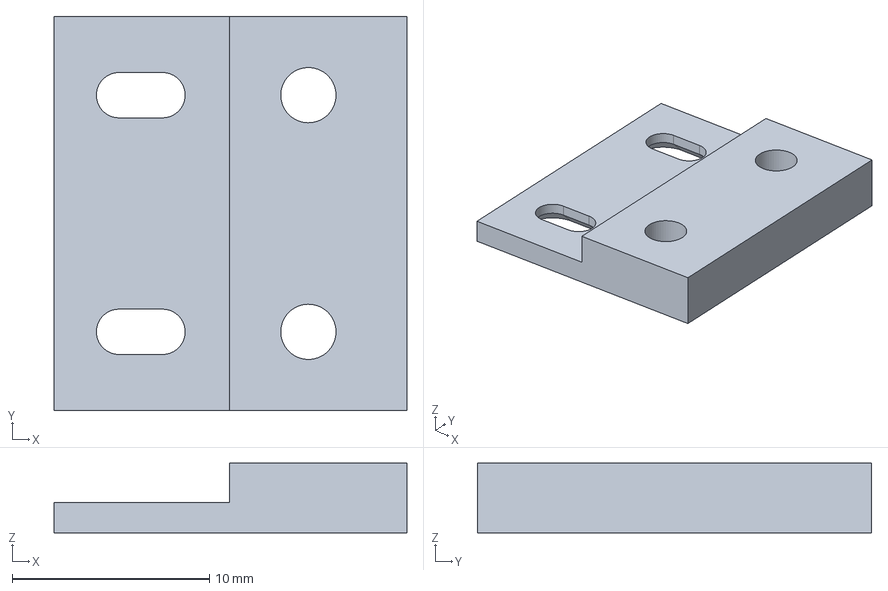
[picture p70: CAD file, 2026-11-03]
hardware/mechanical/print-backup/lid-fine-20261103/step/L02_HINGE_SHOE_ASSEMBLY.step
17.9 x 20.0 x 3.54 mm
