Sylphiette666/stm32-rfid-smart-bin/hardware/mechanical/print-backup/lid-fine-20261103/step/L01_LIGHT_LID_ASSEMBLY.step

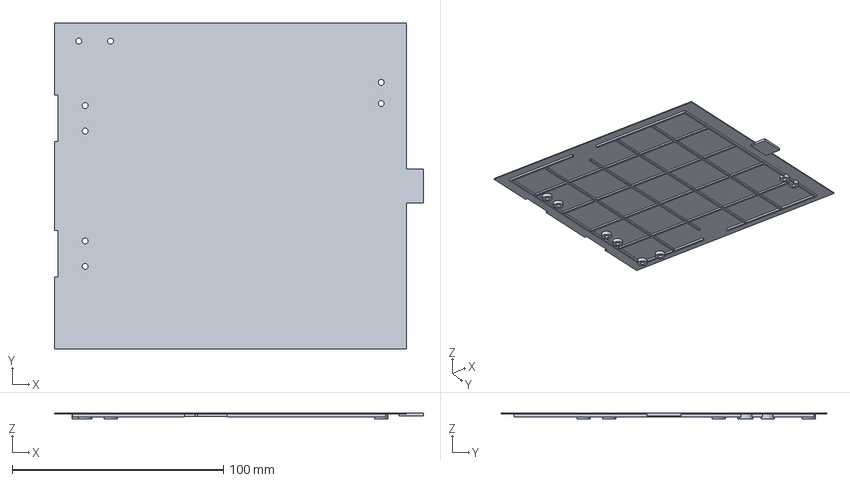
[picture p71: CAD file, 2026-11-03]
hardware/mechanical/print-backup/lid-fine-20261103/step/L01_LIGHT_LID_ASSEMBLY.step
174.5 x 154.0 x 2.96 mm
