Sylphiette666/stm32-rfid-smart-bin/hardware/mechanical/print-backup/wall-clamps-fine-20261103/step/WALL_CLAMPS_PRINT_DESIGN_ASSEMBLY.step

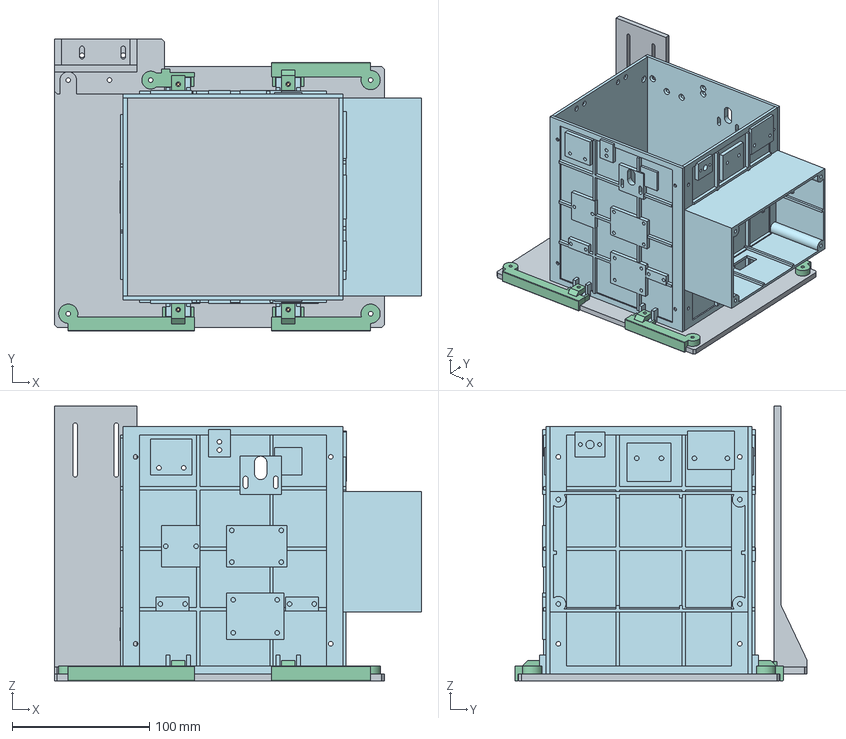
[picture p72: CAD file, 2026-11-03]
hardware/mechanical/print-backup/wall-clamps-fine-20261103/step/WALL_CLAMPS_PRINT_DESIGN_ASSEMBLY.step
267.0 x 212.7 x 200.0 mm
P02
P04
P03
W01_FRONT
W02_REAR
W03_LEFT
W04_RIGHT
C1_LEFT_REAR
C1_LEFT_REAR_PAD
C2_LEFT_FRONT
C2_LEFT_FRONT_PAD
C3_RIGHT_FRONT
C3_RIGHT_FRONT_PAD
C4_RIGHT_REAR
C4_RIGHT_REAR_PAD
