Sylphiette666/stm32-rfid-smart-bin/hardware/mechanical/print-backup/mounted-20261031/step/ASSEMBLY_VIEW_ONLY.step

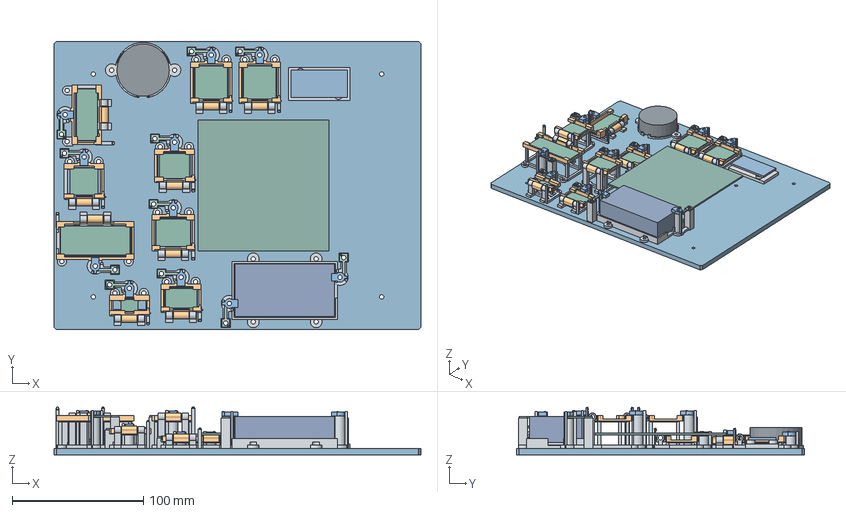
[picture p73: CAD file, 2026-10-31]
hardware/mechanical/print-backup/mounted-20261031/step/ASSEMBLY_VIEW_ONLY.step
280.0 x 220.0 x 36.4 mm
P01_mounted_base
M01_body
M01_lid
M01_keeper
M01_detent
M01_PCB
M02_body
M02_lid
M02_keeper
M02_detent
M02_PCB
M03_body
M03_lid
M03_keeper
M03_detent
M03_PCB
M04_body
M04_lid
M04_keeper
M04_detent
M04_PCB
M05_body
M05_lid
M05_keeper
M05_detent
M05_PCB
M06_body
M06_lid
M06_keeper
M06_detent
M06_PCB
M07_body
M07_lid
M07_keeper
M07_detent
M07_PCB
M08_body
M08_lid
M08_keeper
M08_detent
M08_PCB
M09_body
M09_lid
M09_keeper
M09_detent
M09_PCB
A1_PCB
P06_BUCK_cradle
BUCK_PCB
P07_SPEAKER_cradle
SPK_body
BAT_L_keeper
BAT_L_detent
BAT_R_keeper
BAT_R_detent
P05_BATTERY_cradle
BAT_body
