Sylphiette666/stm32-rfid-smart-bin/hardware/mechanical/print-backup/lid-fine-20261103/step/L05_SWITCH_TONGUE_ASSEMBLY.step

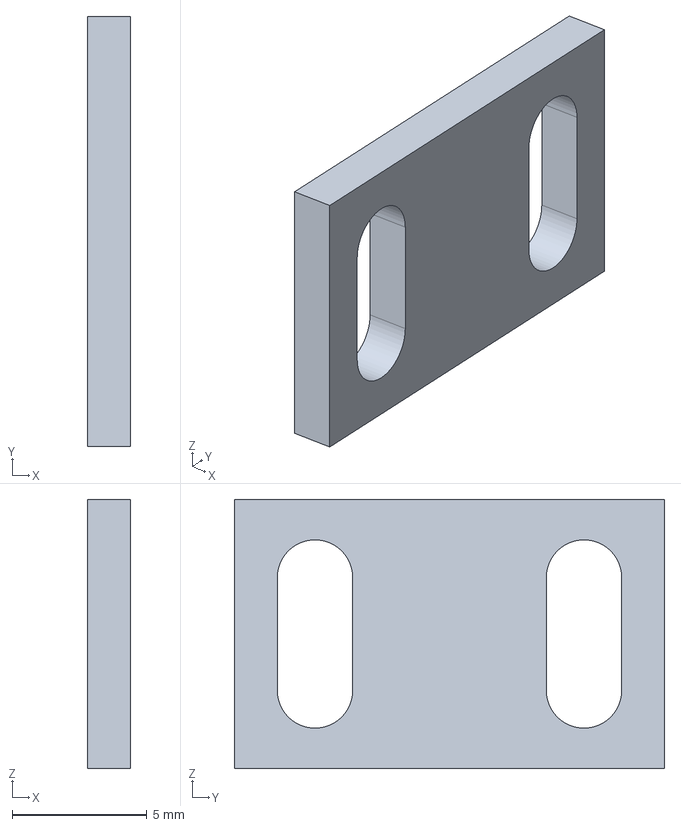
[picture p74: CAD file, 2026-11-03]
hardware/mechanical/print-backup/lid-fine-20261103/step/L05_SWITCH_TONGUE_ASSEMBLY.step
1.60 x 16.0 x 10.0 mm
