Sylphiette666/stm32-rfid-smart-bin/hardware/mechanical/print-backup/lid-fine-20261103/step/LID_CLOSED_REFERENCE_ASSEMBLY.step

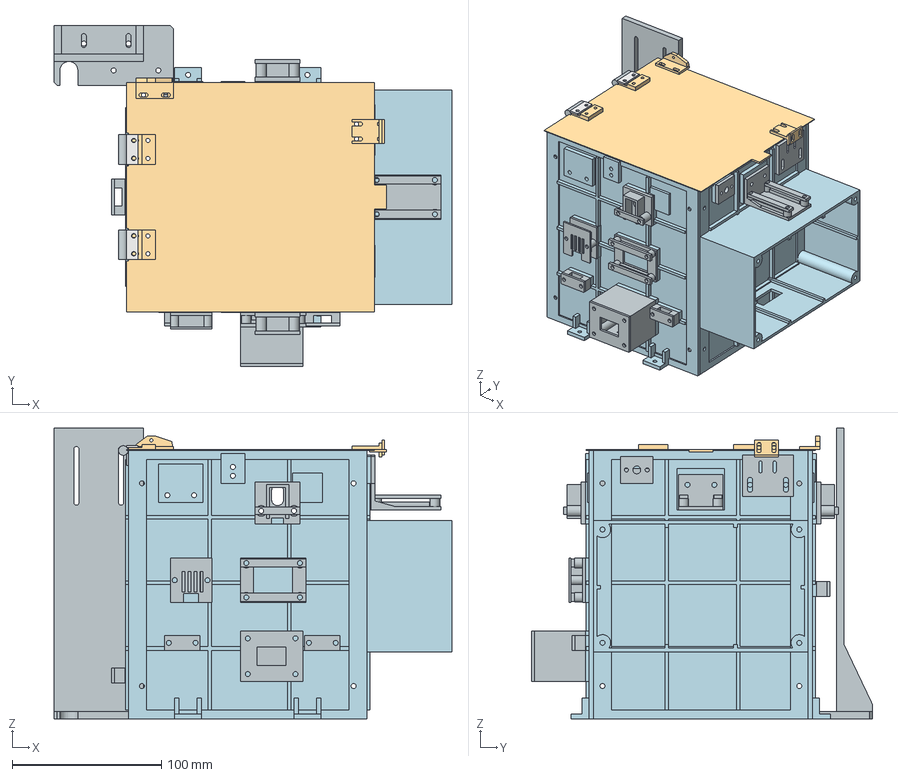
[picture p75: CAD file, 2026-11-03]
hardware/mechanical/print-backup/lid-fine-20261103/step/LID_CLOSED_REFERENCE_ASSEMBLY.step
267.0 x 228.5 x 195.0 mm
W01_FRONT
W02_REAR
W03_LEFT
W04_RIGHT
BEAM_SEAT_0
BEAM_RETAINER_1
BEAM_SEAT_2
BEAM_RETAINER_3
LIGHT_CRADLE_4
LIGHT_EDGE_BAR_5
LIGHT_EDGE_BAR_6
DHT_SEAT_7
DHT_GUARD_8
APPROACH_SHELF_9
APPROACH_EDGE_BAR_10
APPROACH_EDGE_BAR_11
POWER_POD_12
POWER_INSERT_13
BEAM_LEDGE_14
BEAM_LEDGE_15
ULTRASONIC_BEAM_16
ULTRASONIC_RETAINER_17
ULTRASONIC_RETAINER_18
LID_SWITCH_PLATE_19
LID_SOFTSTOP_SEAT_20
LID_SOFTSTOP_SEAT_21
LED_INSERT_22
CABLE_SADDLE_23
CABLE_CAP_24
CABLE_SADDLE_25
CABLE_CAP_26
CABLE_SADDLE_27
CABLE_CAP_28
CABLE_SADDLE_29
CABLE_CAP_30
P03_SERVO_STAND
P04_SERVO_TRAY
NOMINAL_HINGE_FIXED_53
NOMINAL_KNUCKLE_53
NOMINAL_HINGE_FIXED_117
NOMINAL_KNUCKLE_117
REUSE_EVA_23
REUSE_EVA_155
LID
HINGE_SHOE_A
HINGE_SHOE_B
LINK_ARM
SWITCH_FOOT
SWITCH_TONGUE
NOMINAL_MOVING_LEAF_53
NOMINAL_MOVING_LEAF_117
