Sylphiette666/stm32-rfid-smart-bin/hardware/current-low-cost/pcb-b/mechanical/SmartBin_B.step

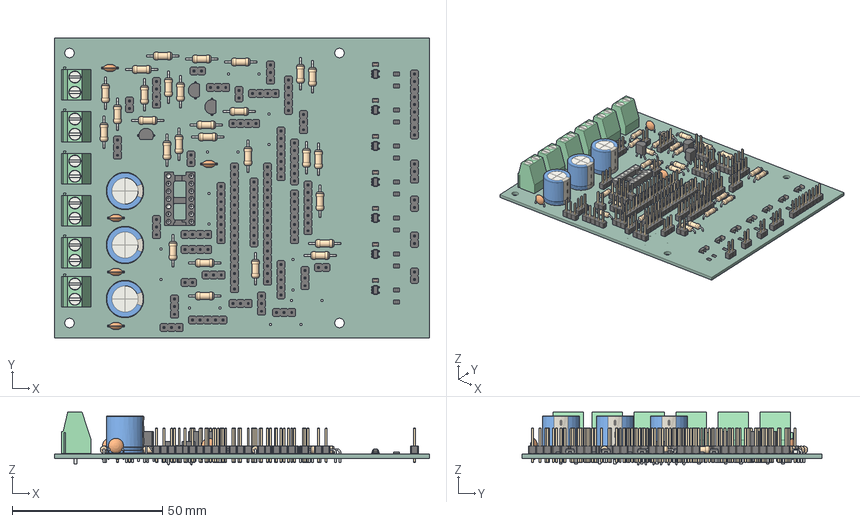
[picture p76: CAD file, 2026-11-03]
hardware/current-low-cost/pcb-b/mechanical/SmartBin_B.step
125.0 x 100.0 x 17.6 mm
PinHeader_1x03_P254mm_Vertical x 13
PinHeader_1x07_P254mm_Vertical x 3
R_0805_2012Metric x 14
C_Disc_D50mm_W25mm_P500mm x 5
C_0805_2012Metric x 7
R_Axial_DIN0207_L63mm_D25mm_P1016mm_Horizontal x 28
PinHeader_1x08_P254mm_Vertical
PinHeader_1x02_P254mm_Vertical x 9
TerminalBlock_Phoenix_MKDS-1,5-2-5.08_1x02_P5.08mm_Horizontal x 6
PinHeader_1x04_P254mm_Vertical x 5
SOT-23-5 x 7
CP_Radial_D125mm_P500mm x 3
PinHeader_1x06_P254mm_Vertical
PinHeader_1x09_P254mm_Vertical x 2
TO-92_Inline_Wide x 3
PinHeader_1x05_P254mm_Vertical x 3
PinHeader_1x17_P254mm_Vertical
PinHeader_1x16_P254mm_Vertical
DIP_14_W762mm_Socket
SmartBin_B_PCB
