Sylphiette666/stm32-rfid-smart-bin/hardware/mechanical/print-backup/3mf/combined/P2S_ALL4_PLA_0p4_READY.3mf

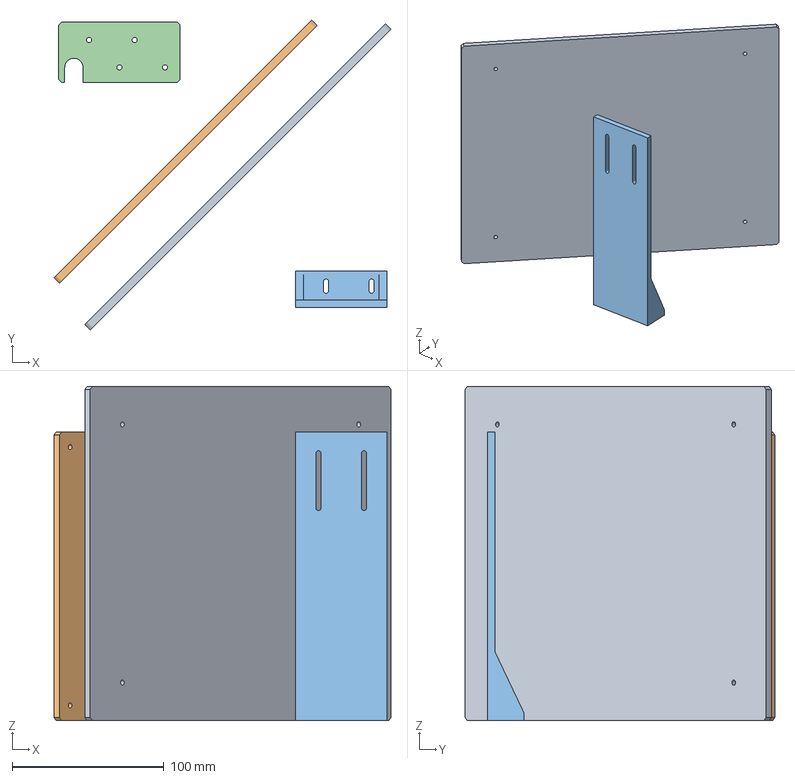
[picture p77: CAD file, 2026-10-30]
hardware/mechanical/print-backup/3mf/combined/P2S_ALL4_PLA_0p4_READY.3mf
221.8 x 203.8 x 220.0 mm
P01_base
P02_upper
P03_stand
P04_tray
