Sylphiette666/stm32-rfid-smart-bin/hardware/mechanical/print-backup/3mf/P2S/C01_upright_hole_test.3mf

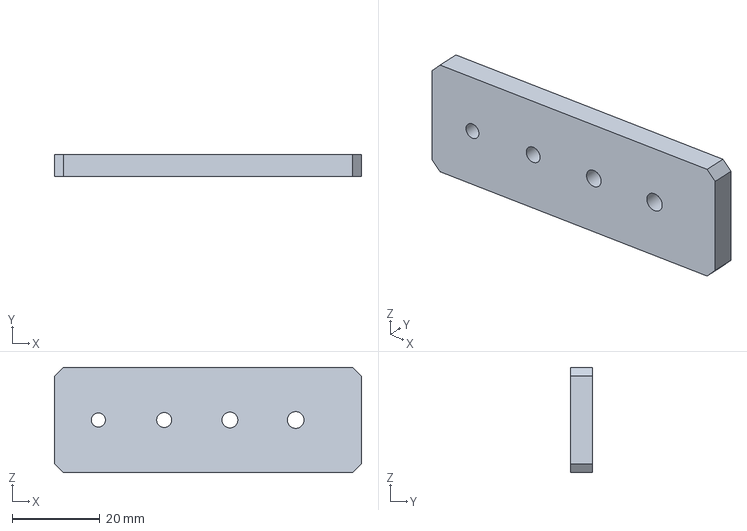
[picture p78: CAD file, 2026-10-30]
hardware/mechanical/print-backup/3mf/P2S/C01_upright_hole_test.3mf
70.0 x 5.00 x 24.0 mm
