Sylphiette666/stm32-rfid-smart-bin/hardware/mechanical/print-backup/3mf/split/P01_front_minusY.3mf

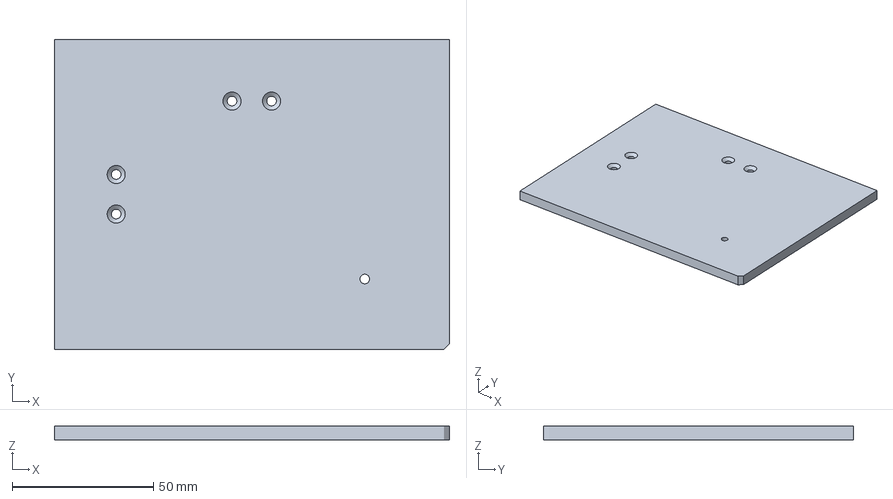
[picture p79: CAD file, 2026-10-30]
hardware/mechanical/print-backup/3mf/split/P01_front_minusY.3mf
139.9 x 109.8 x 5.00 mm
