Sylphiette666/stm32-rfid-smart-bin/hardware/mechanical/print-backup/accessories-fine-20261101/geometry/PLATE_1_GEOMETRY.3mf

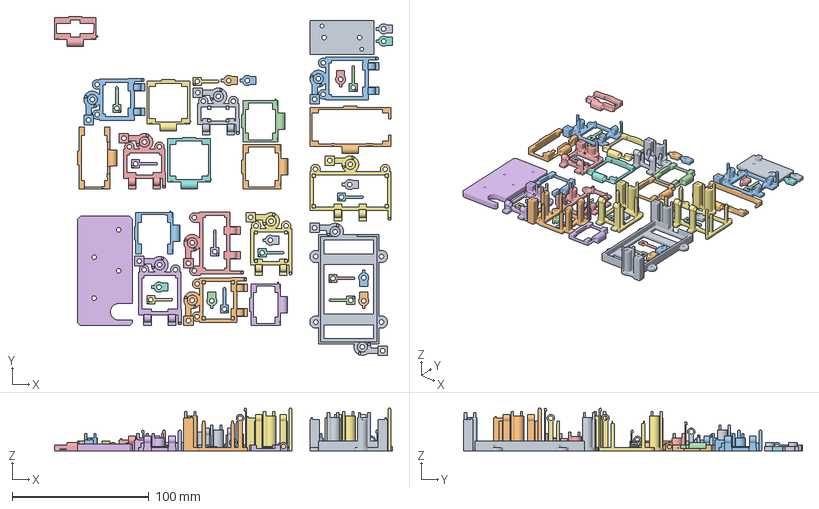
[picture p80: CAD file, 2026-11-01]
hardware/mechanical/print-backup/accessories-fine-20261101/geometry/PLATE_1_GEOMETRY.3mf
247.6 x 248.3 x 31.4 mm
P05_BATTERY_cradle
BAT_L_keeper
BAT_R_keeper
BAT_L_detent
BAT_R_detent
P04_TRAY
M01_body
M01_detent
M01_keeper
M01_lid
M04_body
M04_detent
M04_keeper
M08_body
M08_detent
M08_keeper
P06_BUCK_cradle
M02_body
M02_detent
M02_keeper
M07_body
M07_detent
M06_body
M06_detent
M06_keeper
M07_lid
M03_body
M03_detent
M09_body
M09_detent
M04_lid
M08_lid
M05_body
M02_lid
M06_lid
M03_lid
M05_lid
M09_lid
M05_detent
M03_keeper
M05_keeper
M07_keeper
M09_keeper
