Sylphiette666/stm32-rfid-smart-bin/hardware/mechanical/print-backup/accessories-plate-20261105/geometry/accessories_31.3mf

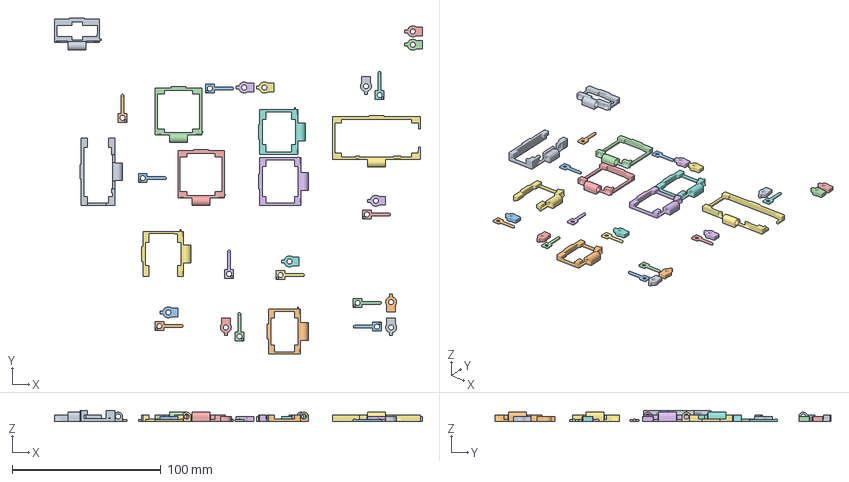
[picture p81: CAD file, 2026-11-05]
hardware/mechanical/print-backup/accessories-plate-20261105/geometry/accessories_31.3mf
247.6 x 226.3 x 7.20 mm
BAT_L_keeper
BAT_R_keeper
BAT_L_detent
BAT_R_detent
M01_detent
M01_keeper
M01_lid
M04_detent
M04_keeper
M08_detent
M08_keeper
M02_detent
M02_keeper
M07_detent
M06_detent
M06_keeper
M07_lid
M03_detent
M09_detent
M04_lid
M08_lid
M02_lid
M06_lid
M03_lid
M05_lid
M09_lid
M05_detent
M03_keeper
M05_keeper
M07_keeper
M09_keeper
