Sylphiette666/stm32-rfid-smart-bin/hardware/mechanical/print-backup/body-after-accessories-20261101/geometry/PLATE_2_GEOMETRY.3mf

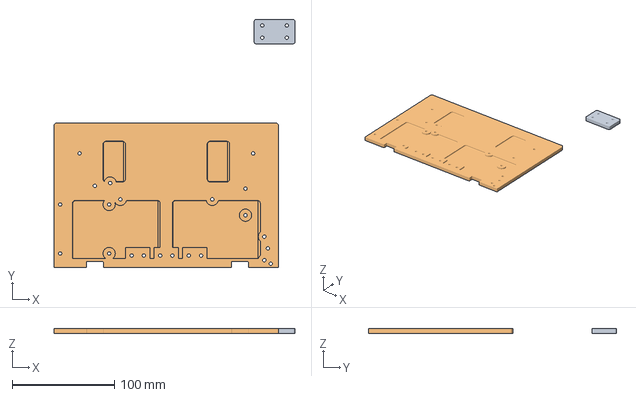
[picture p82: CAD file, 2026-11-01]
hardware/mechanical/print-backup/body-after-accessories-20261101/geometry/PLATE_2_GEOMETRY.3mf
236.0 x 243.1 x 5.00 mm
JOIN_BRIDGE_1
P01_FRONT_HALF
