Sylphiette666/stm32-rfid-smart-bin/hardware/mechanical/print-backup/caster-riser-20261103/parts/CASTER_COLUMN_41_PRINT.stl

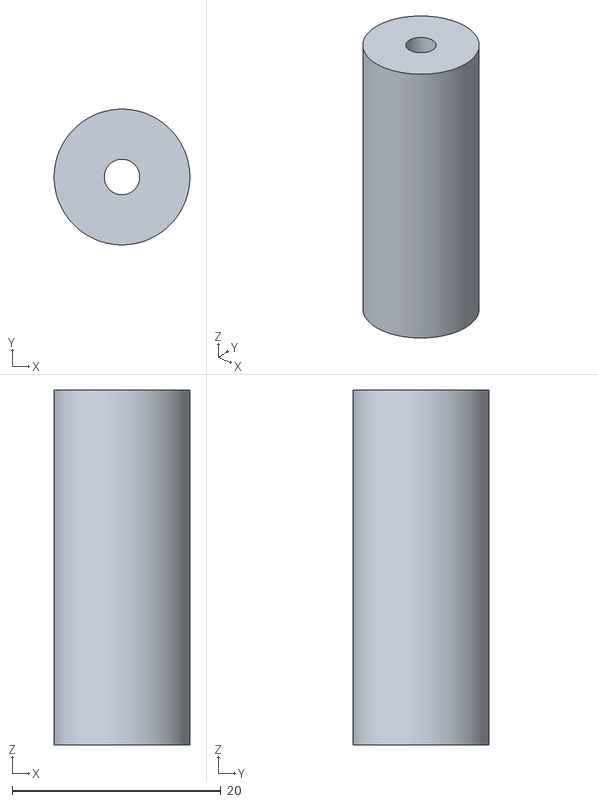
[picture p84: CAD file, 2026-11-03]
hardware/mechanical/print-backup/caster-riser-20261103/parts/CASTER_COLUMN_41_PRINT.stl
13.0 x 13.0 x 34.0
