Sylphiette666/stm32-rfid-smart-bin/hardware/mechanical/print-backup/caster-spacer-20261105/projects/P2S_CASTER_SPACER_H5_PETG.3mf

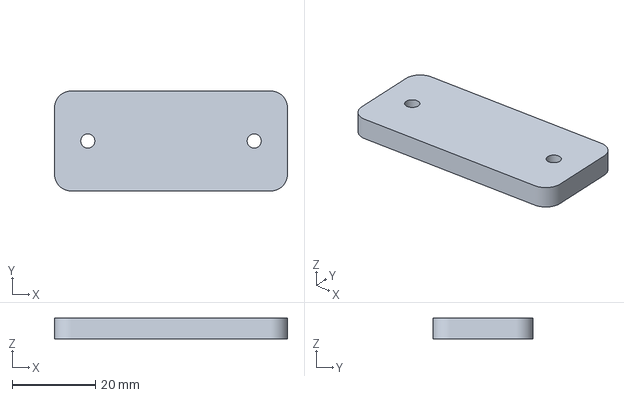
[picture p85: CAD file, 2026-11-05]
hardware/mechanical/print-backup/caster-spacer-20261105/projects/P2S_CASTER_SPACER_H5_PETG.3mf
56.0 x 24.0 x 5.00 mm
