Sylphiette666/stm32-rfid-smart-bin/hardware/mechanical/print-backup/caster-tracker-plate-20261103/CASTER_H41_TRACKER_ALL_GEOMETRY.3mf

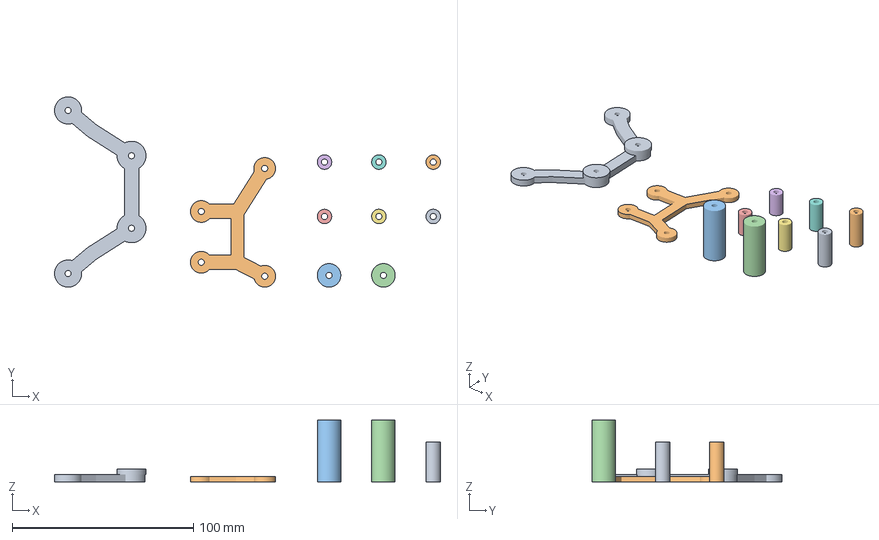
[picture p86: CAD file, 2026-11-03]
hardware/mechanical/print-backup/caster-tracker-plate-20261103/CASTER_H41_TRACKER_ALL_GEOMETRY.3mf
213.0 x 105.0 x 34.0 mm
CASTER_FRAME
TRACKER_FRAME
CASTER_COLUMN_A_H41
CASTER_COLUMN_B_H41
TRACKER_SPACER_14_A
TRACKER_SPACER_14_B
TRACKER_SPACER_18_A
TRACKER_SPACER_18_B
TRACKER_SPACER_22_A
TRACKER_SPACER_22_B
