Sylphiette666/stm32-rfid-smart-bin/hardware/mechanical/print-backup/easy-support-20261104/projects/P2S_PANEL_COVER_PLA_EASYSUPPORT_0.28.3mf

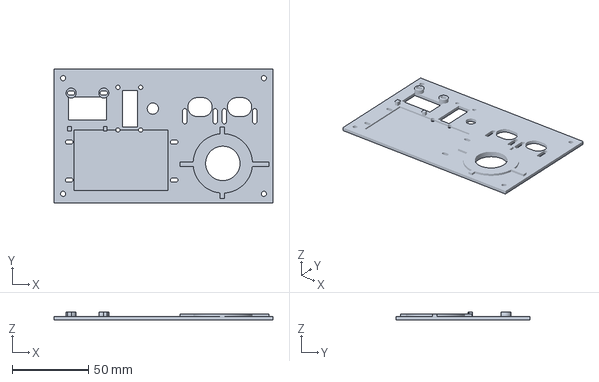
[picture p87: CAD file, 2026-11-04]
hardware/mechanical/print-backup/easy-support-20261104/projects/P2S_PANEL_COVER_PLA_EASYSUPPORT_0.28.3mf
144.0 x 88.0 x 5.40 mm
