Sylphiette666/stm32-rfid-smart-bin/hardware/mechanical/print-backup/flat-split-20261101/geometry/M01_body_bed2.stl

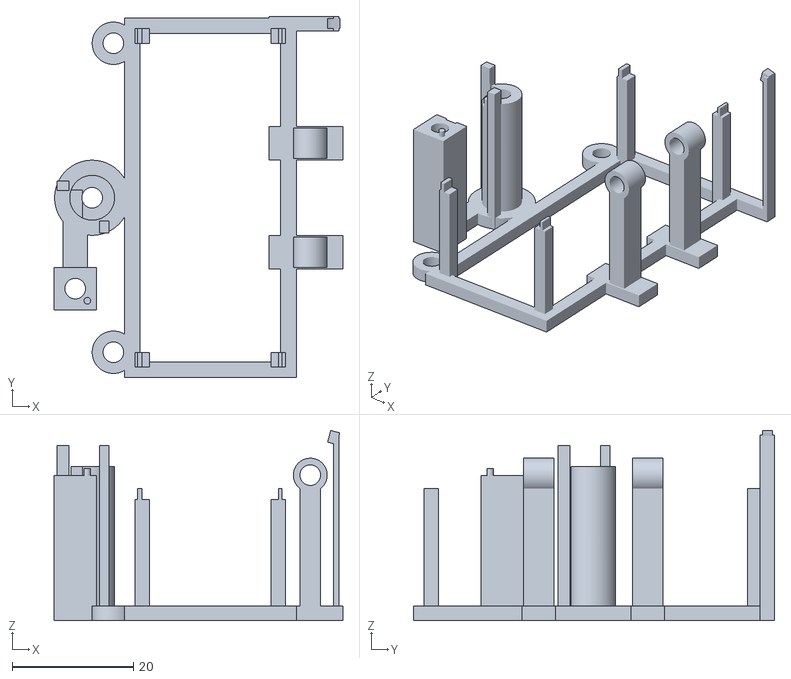
[picture p88: CAD file, 2026-11-01]
hardware/mechanical/print-backup/flat-split-20261101/geometry/M01_body_bed2.stl
47.7 x 59.7 x 31.4
