Sylphiette666/stm32-rfid-smart-bin/hardware/mechanical/print-backup/flat-split-20261101/parts/M09_keeper.stl

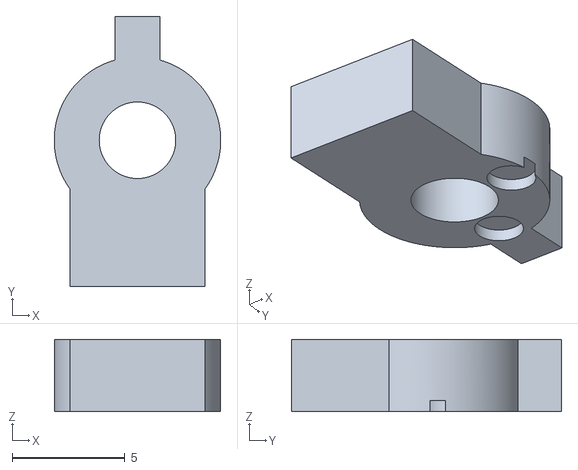
[picture p89: CAD file, 2026-11-01]
hardware/mechanical/print-backup/flat-split-20261101/parts/M09_keeper.stl
7.40 x 12.0 x 3.20
