Sylphiette666/stm32-rfid-smart-bin/hardware/mechanical/print-backup/flat-split-20261101/projects/P2S_FLAT_SPLIT_PLATE_2.3mf

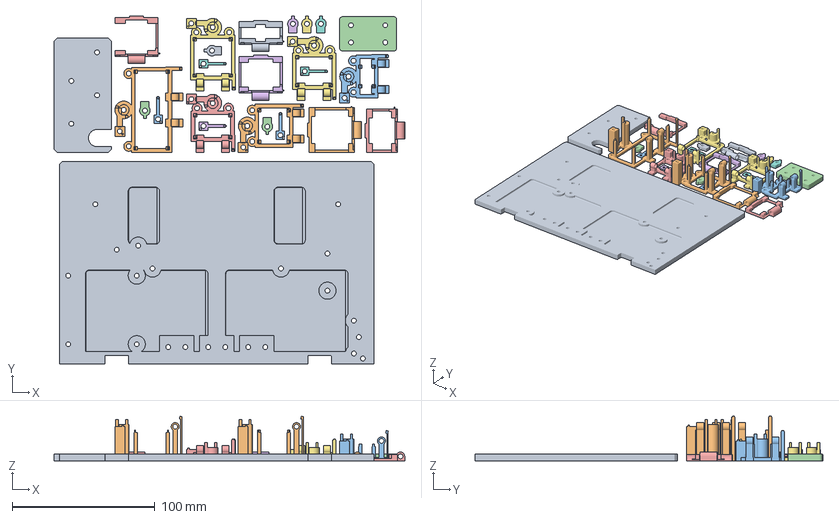
[picture p90: CAD file, 2026-11-01]
hardware/mechanical/print-backup/flat-split-20261101/projects/P2S_FLAT_SPLIT_PLATE_2.3mf
245.5 x 243.6 x 31.4 mm
P04_TRAY
M01_body
M01_detent
M01_keeper
M09_body
M09_detent
M04_body
M04_detent
M04_keeper
M06_body
M06_detent
M06_keeper
M06_lid
M03_lid
M03_body
M03_detent
M05_lid
M04_lid
M05_body
JOIN_BRIDGE_1
M09_lid
M07_keeper
M09_keeper
M03_keeper
P01_FRONT_HALF
