Sylphiette666/stm32-rfid-smart-bin/hardware/mechanical/print-backup/flat-split-20261101/step/P05_BATTERY_cradle.step

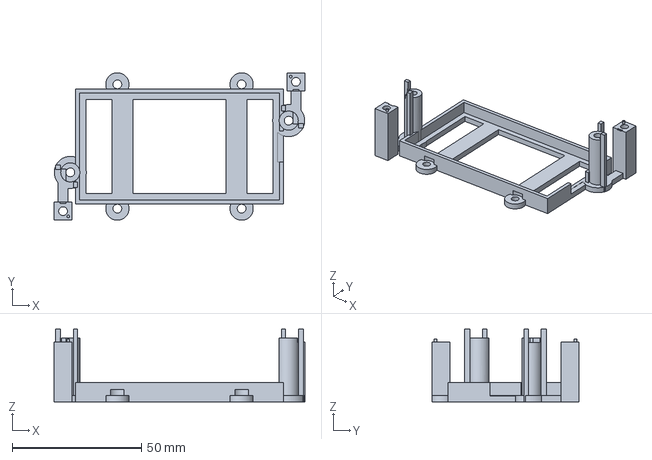
[picture p91: CAD file, 2026-11-01]
hardware/mechanical/print-backup/flat-split-20261101/step/P05_BATTERY_cradle.step
97.0 x 57.0 x 28.1 mm
