Sylphiette666/stm32-rfid-smart-bin/hardware/mechanical/print-backup/integrated-pla-20261104/projects/P2S_UPPER_INTEGRATED_PLA_008.3mf

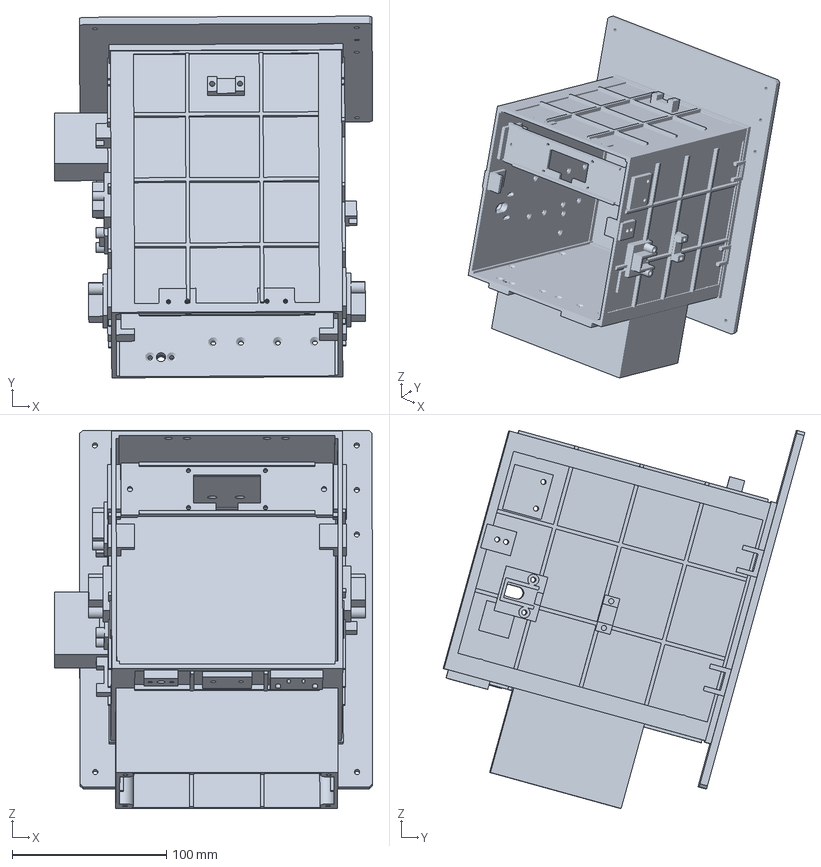
[picture p92: CAD file, 2026-11-03]
hardware/mechanical/print-backup/integrated-pla-20261104/projects/P2S_UPPER_INTEGRATED_PLA_008.3mf
206.5 x 234.9 x 245.4 mm
