Sylphiette666/stm32-rfid-smart-bin/hardware/mechanical/print-backup/integrated-pla-20261104/step/PANEL_REMOVABLE_REFERENCE.step

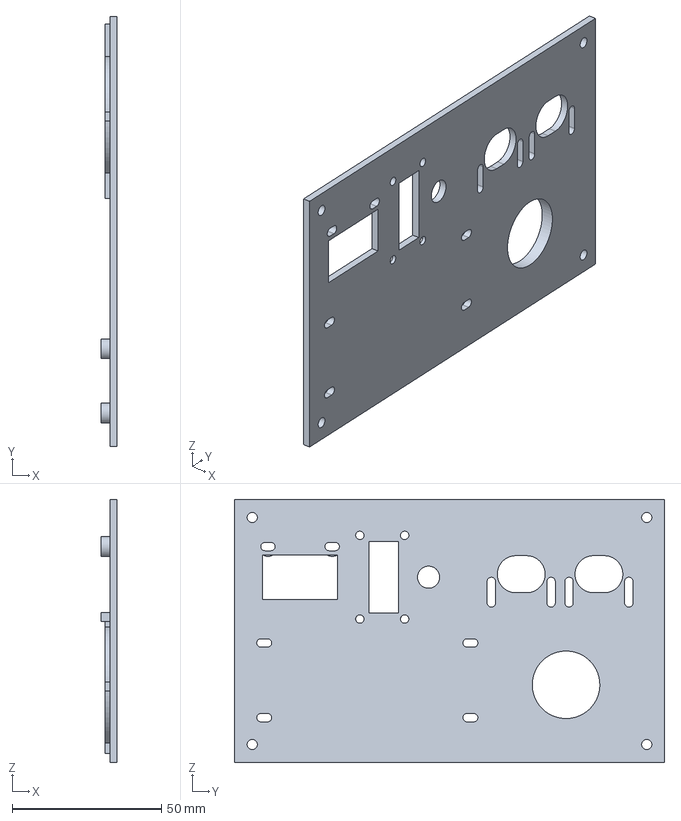
[picture p93: CAD file, 2026-11-03]
hardware/mechanical/print-backup/integrated-pla-20261104/step/PANEL_REMOVABLE_REFERENCE.step
5.40 x 144.0 x 88.0 mm
