Sylphiette666/stm32-rfid-smart-bin/hardware/mechanical/print-backup/integrated-pla-fast-20261104/projects/P2S_LOWER_H41_B1_PLA_FAST_CANDIDATE.3mf

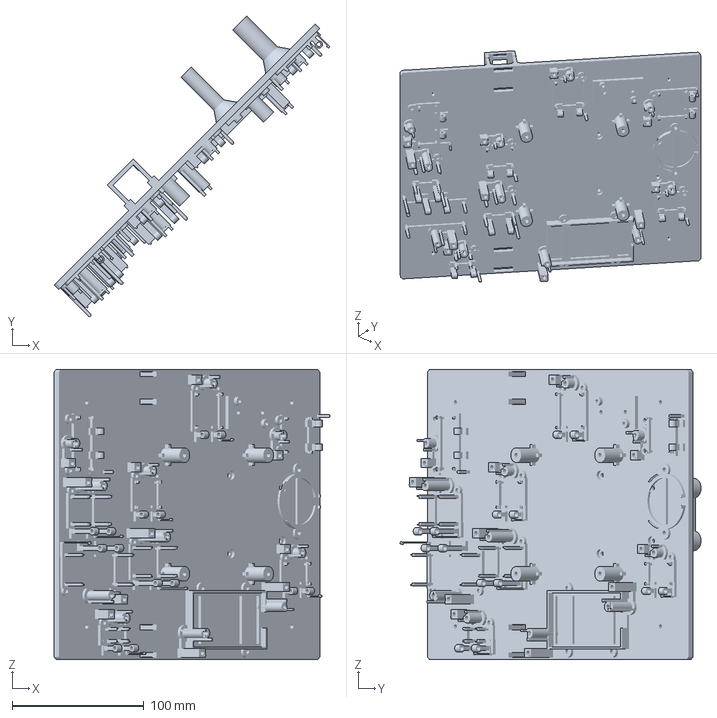
[picture p94: CAD file, 2026-11-03]
hardware/mechanical/print-backup/integrated-pla-fast-20261104/projects/P2S_LOWER_H41_B1_PLA_FAST_CANDIDATE.3mf
209.2 x 228.3 x 220.0 mm
