Sylphiette666/stm32-rfid-smart-bin/hardware/mechanical/print-backup/integrated-pla-fast-20261104/source/r4_geometry/UPPER_INTEGRATED.3mf

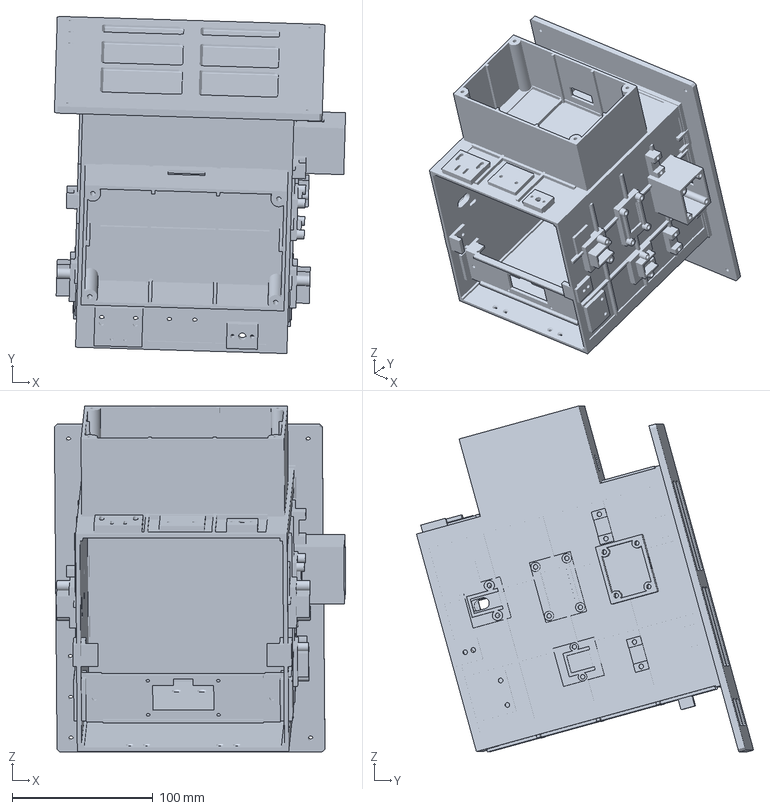
[picture p95: CAD file, 2026-11-03]
hardware/mechanical/print-backup/integrated-pla-fast-20261104/source/r4_geometry/UPPER_INTEGRATED.3mf
206.6 x 239.1 x 245.4 mm
