Sylphiette666/stm32-rfid-smart-bin/hardware/mechanical/print-backup/labeled-bases-20261101/step/M02_body.step

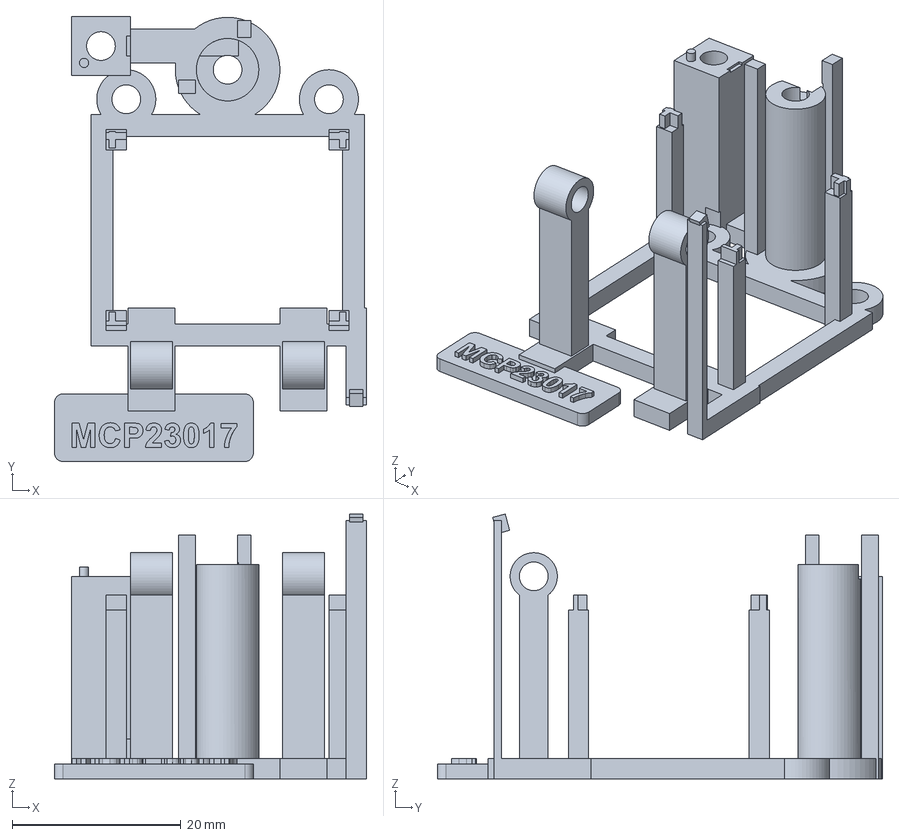
[picture p96: CAD file, 2026-11-01]
hardware/mechanical/print-backup/labeled-bases-20261101/step/M02_body.step
37.0 x 52.7 x 31.4 mm
