Sylphiette666/stm32-rfid-smart-bin/hardware/mechanical/print-backup/lid-fine-20261103/P2S_HINGE_TRIAL_FINE_012.3mf

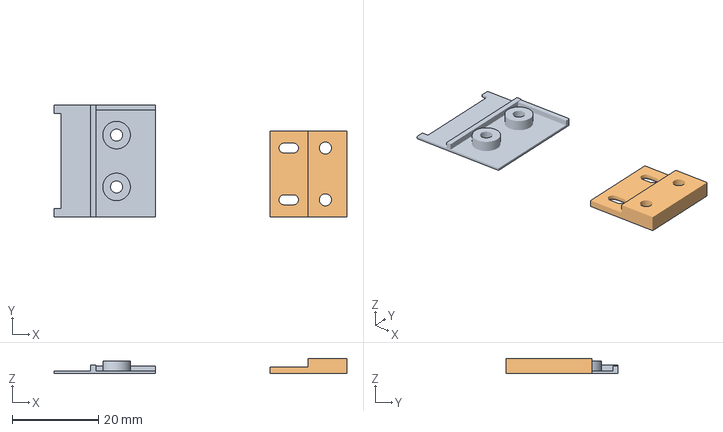
[picture p97: CAD file, 2026-11-03]
hardware/mechanical/print-backup/lid-fine-20261103/P2S_HINGE_TRIAL_FINE_012.3mf
67.9 x 26.0 x 3.54 mm
T01_HINGE_FIT_COUPON_1
L02_HINGE_SHOE_1
