Sylphiette666/stm32-rfid-smart-bin/hardware/mechanical/print-backup/lid-petg-final-20261103/P2S_LID_PETG_FINAL_008.3mf

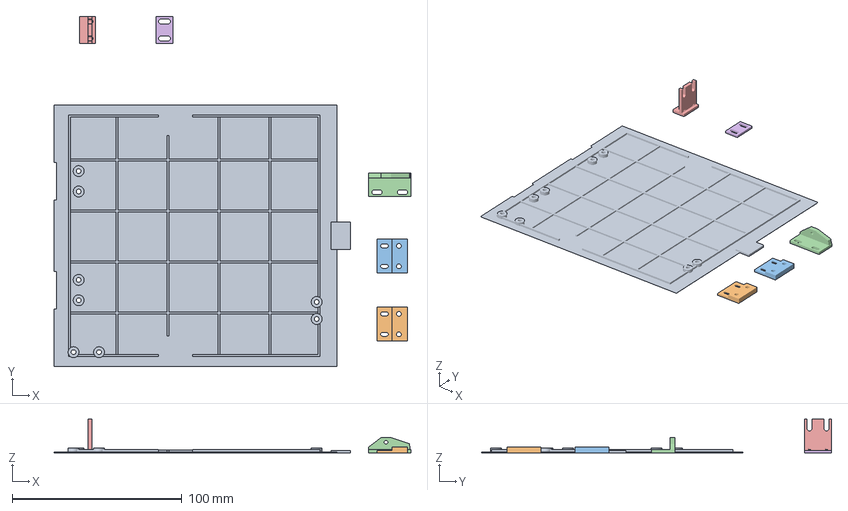
[picture p98: CAD file, 2026-11-03]
hardware/mechanical/print-backup/lid-petg-final-20261103/P2S_LID_PETG_FINAL_008.3mf
210.0 x 206.0 x 20.0 mm
L01_LIGHT_LID_1
L02_HINGE_SHOE_1
L02_HINGE_SHOE_2
L03_LINK_ARM_1
L04_SWITCH_FOOT_1
L05_SWITCH_TONGUE_1
