Sylphiette666/stm32-rfid-smart-bin/hardware/mechanical/print-backup/motor-adapter-20261101/fine-016/P2S_D06_ADAPTER_PAIR_FINE_016.3mf

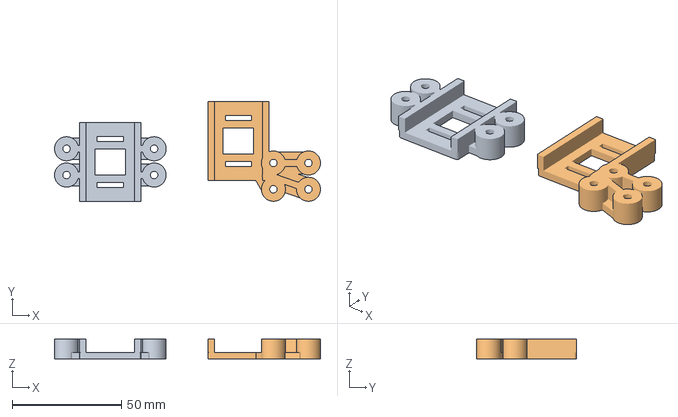
[picture p99: CAD file, 2026-11-01]
hardware/mechanical/print-backup/motor-adapter-20261101/fine-016/P2S_D06_ADAPTER_PAIR_FINE_016.3mf
121.5 x 45.5 x 9.00 mm
D06_ADAPTER_LEFT
D06_ADAPTER_RIGHT
