Sylphiette666/stm32-rfid-smart-bin/hardware/mechanical/print-backup/motor-adapter-clearance-20261102/P2S_D06_CLEARANCE_TRIAL_PAIR_028.3mf

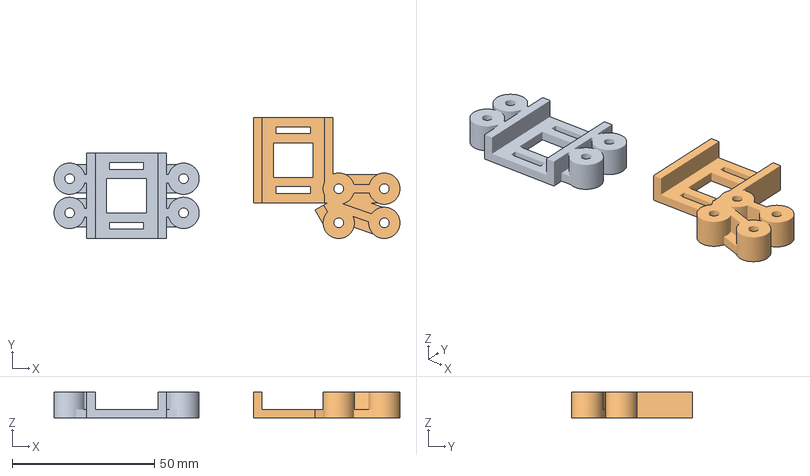
[picture p100: CAD file, 2026-11-02]
hardware/mechanical/print-backup/motor-adapter-clearance-20261102/P2S_D06_CLEARANCE_TRIAL_PAIR_028.3mf
121.5 x 42.5 x 9.00 mm
D06_ADAPTER_LEFT
D06_ADAPTER_RIGHT
