Sylphiette666/stm32-rfid-smart-bin/hardware/mechanical/print-backup/motor-adapter-clearance2-20261102/P2S_D06_CLEARANCE2_QUICK_PAIR_028.3mf

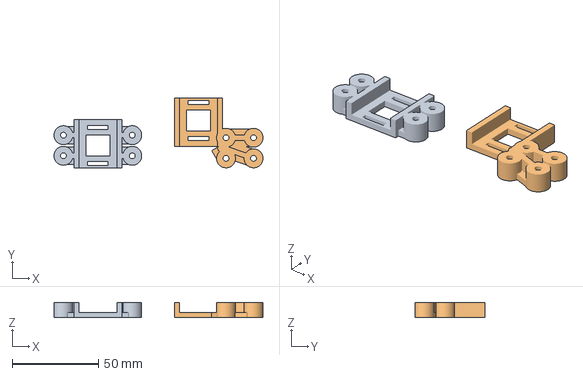
[picture p101: CAD file, 2026-11-02]
hardware/mechanical/print-backup/motor-adapter-clearance2-20261102/P2S_D06_CLEARANCE2_QUICK_PAIR_028.3mf
121.5 x 40.5 x 9.00 mm
D06_ADAPTER_LEFT
D06_ADAPTER_RIGHT
