Sylphiette666/stm32-rfid-smart-bin/hardware/mechanical/print-backup/motor-existing-holes-light-20261103/P2S_D06_EXISTING_HOLES_LIGHT_016.3mf

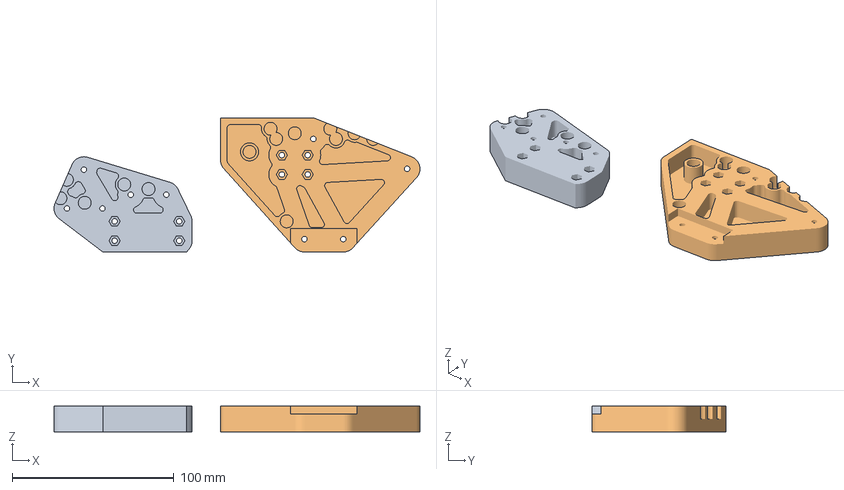
[picture p103: CAD file, 2026-11-02]
hardware/mechanical/print-backup/motor-existing-holes-light-20261103/P2S_D06_EXISTING_HOLES_LIGHT_016.3mf
226.5 x 83.0 x 16.0 mm
D06_CARRIER_LEFT
D06_CARRIER_RIGHT
