Sylphiette666/stm32-rfid-smart-bin/hardware/mechanical/print-backup/motor-fit-20261101/fast/all_three/P2S_D06_FIT_ABC_FAST_028.3mf

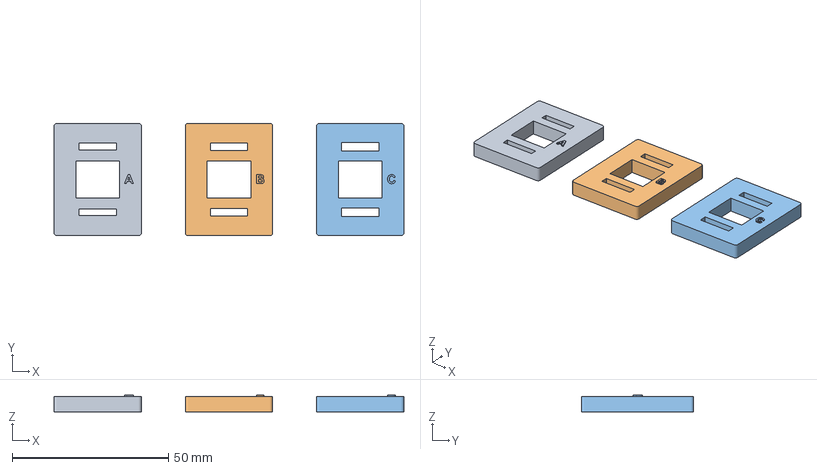
[picture p104: CAD file, 2026-11-01]
hardware/mechanical/print-backup/motor-fit-20261101/fast/all_three/P2S_D06_FIT_ABC_FAST_028.3mf
112.0 x 36.0 x 5.40 mm
FIT_A_slot_12x2.2
FIT_B_slot_12x2.4
FIT_C_slot_12x2.6
