Sylphiette666/stm32-rfid-smart-bin/hardware/mechanical/print-backup/motor-fit-20261101/fast/b_only/thin3/P2S_D06_FIT_B_THICKNESS_3MM_FAST.3mf

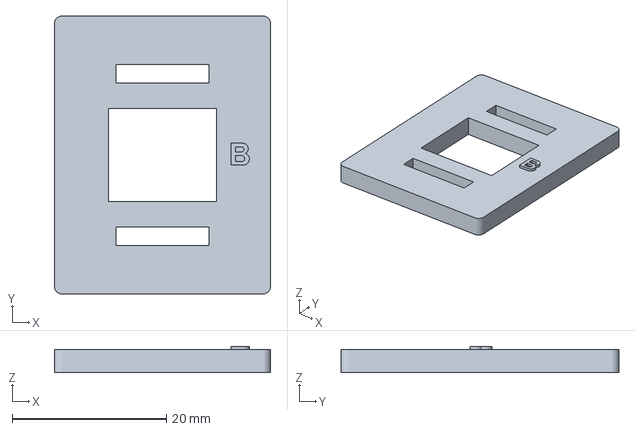
[picture p106: CAD file, 2026-11-01]
hardware/mechanical/print-backup/motor-fit-20261101/fast/b_only/thin3/P2S_D06_FIT_B_THICKNESS_3MM_FAST.3mf
28.0 x 36.0 x 3.40 mm
