Sylphiette666/stm32-rfid-smart-bin/hardware/mechanical/print-backup/mounted-20261031/parts/M08_body.stl

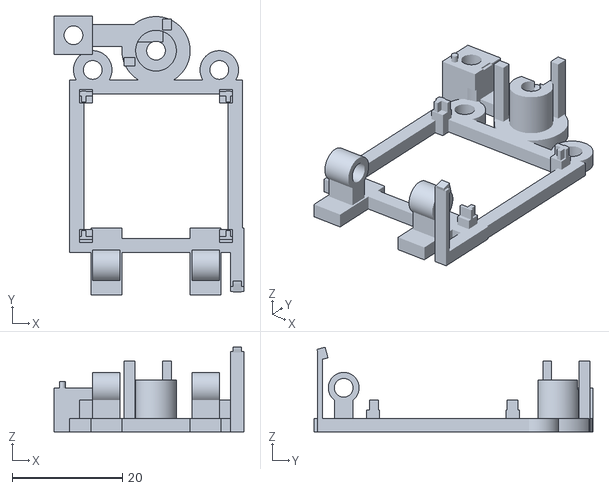
[picture p108: CAD file, 2026-10-31]
hardware/mechanical/print-backup/mounted-20261031/parts/M08_body.stl
34.5 x 50.7 x 15.4
