Sylphiette666/stm32-rfid-smart-bin/hardware/mechanical/print-backup/mounted-20261031/step/M08_detent.step

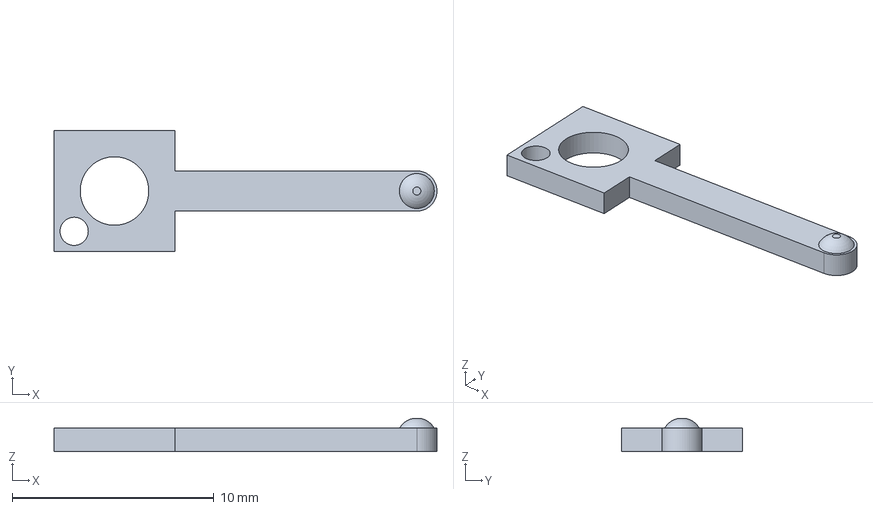
[picture p110: CAD file, 2026-10-31]
hardware/mechanical/print-backup/mounted-20261031/step/M08_detent.step
19.0 x 6.00 x 1.64 mm
