Sylphiette666/stm32-rfid-smart-bin/hardware/mechanical/print-backup/sensor-retainers-fix-20261103/P2S_LIGHT_BARS_IR_CUPS_FIX_FINE_012.3mf

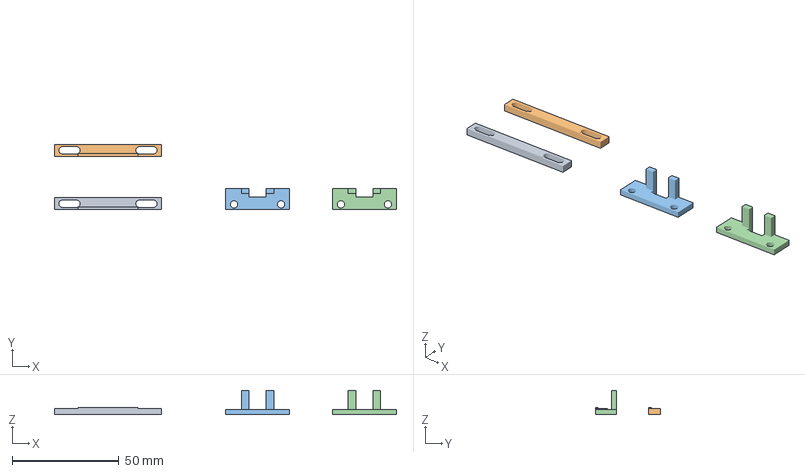
[picture p111: CAD file, 2026-11-03]
hardware/mechanical/print-backup/sensor-retainers-fix-20261103/P2S_LIGHT_BARS_IR_CUPS_FIX_FINE_012.3mf
160.0 x 30.6 x 11.4 mm
LIGHT_BAR_V2_1
LIGHT_BAR_V2_2
BEAM_CUP_V2_1
BEAM_CUP_V2_2
