Sylphiette666/stm32-rfid-smart-bin/hardware/mechanical/print-backup/stl/design/P02_light.stl

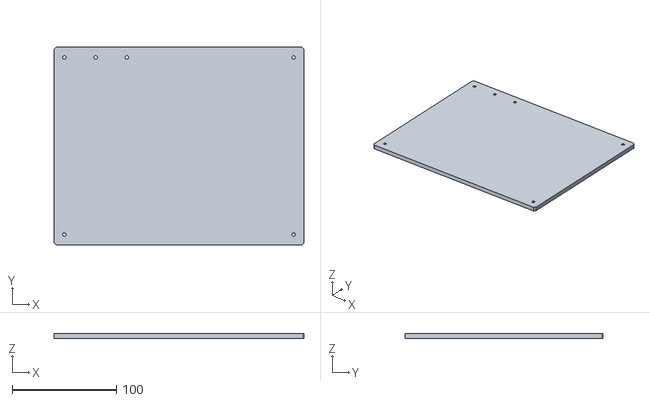
[picture p112: CAD file, 2026-10-30]
hardware/mechanical/print-backup/stl/design/P02_light.stl
240.0 x 190.0 x 5.00
