Sylphiette666/stm32-rfid-smart-bin/hardware/mechanical/print-backup/tracker-mount-20261103/P2S_TRACKER_LIGHT_FINE_012.3mf

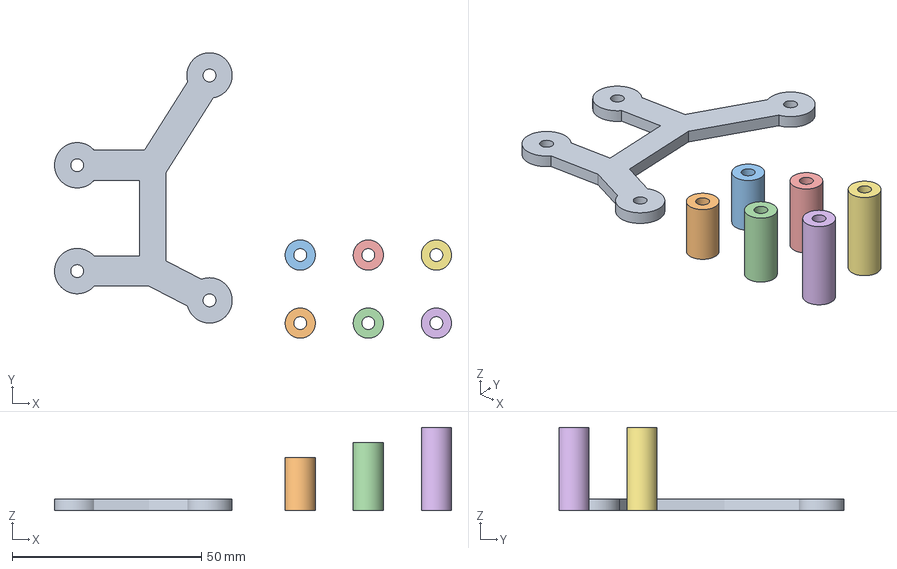
[picture p113: CAD file, 2026-11-03]
hardware/mechanical/print-backup/tracker-mount-20261103/P2S_TRACKER_LIGHT_FINE_012.3mf
105.0 x 75.5 x 22.0 mm
TRACKER_FRAME_PRINT
SPACER_14_PRINT x 2
SPACER_18_PRINT x 2
SPACER_22_PRINT x 2
