Sylphiette666/stm32-rfid-smart-bin/hardware/mechanical/print-backup/tracker-mount-20261103/parts/SPACER_22_PRINT.stl

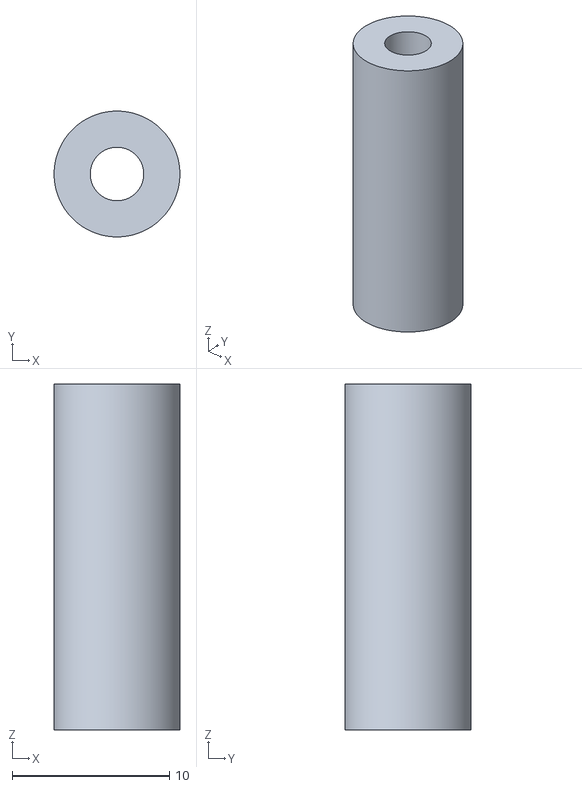
[picture p114: CAD file, 2026-11-03]
hardware/mechanical/print-backup/tracker-mount-20261103/parts/SPACER_22_PRINT.stl
8.00 x 8.00 x 22.0
