Sylphiette666/stm32-rfid-smart-bin/hardware/mechanical/print-backup/wall-clamps-fine-20261103/P2S_WALL_CLAMPS_AND_PADS_FINE_012.3mf

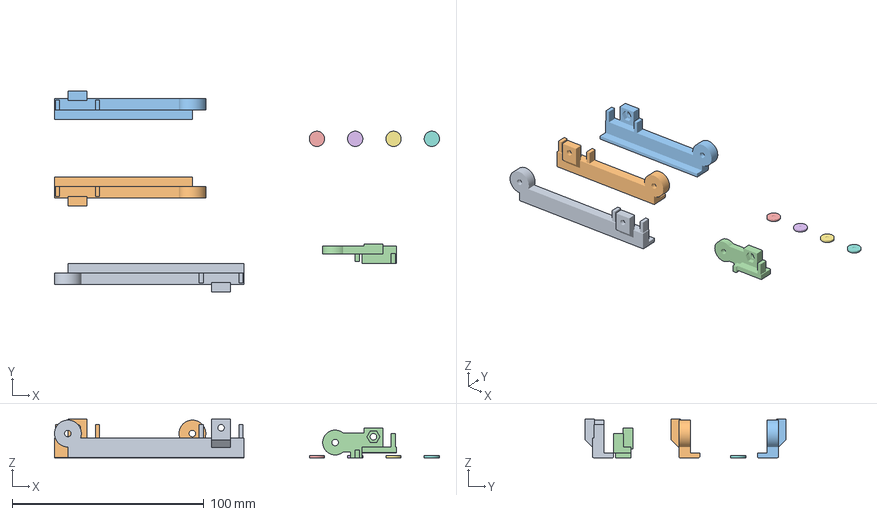
[picture p115: CAD file, 2026-11-03]
hardware/mechanical/print-backup/wall-clamps-fine-20261103/P2S_WALL_CLAMPS_AND_PADS_FINE_012.3mf
201.0 x 105.0 x 20.2 mm
C1_LEFT_REAR
C2_LEFT_FRONT
C3_RIGHT_FRONT
C4_RIGHT_REAR
PRESSURE_PAD_1
PRESSURE_PAD_2
PRESSURE_PAD_3
PRESSURE_PAD_4
