Sylphiette666/stm32-rfid-smart-bin/hardware/mechanical/print-backup/wall-panels-20261102/projects/P2S_WALL_04_RIGHT.3mf

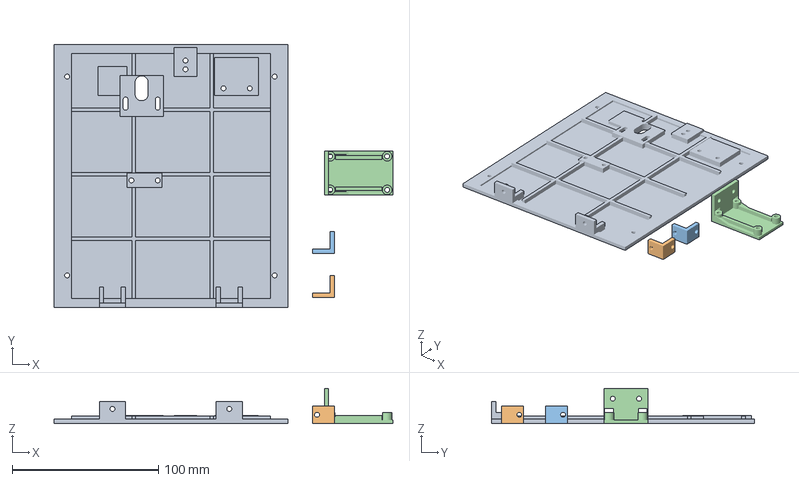
[picture p116: CAD file, 2026-11-02]
hardware/mechanical/print-backup/wall-panels-20261102/projects/P2S_WALL_04_RIGHT.3mf
232.0 x 180.0 x 24.0 mm
W04_RIGHT_1
CORNER_ANGLE_1
CORNER_ANGLE_2
APPROACH_SHELF_1
