Sylphiette666/stm32-rfid-smart-bin/hardware/mechanical/print-backup/wall-panels-20261102/step/W02_REAR.step

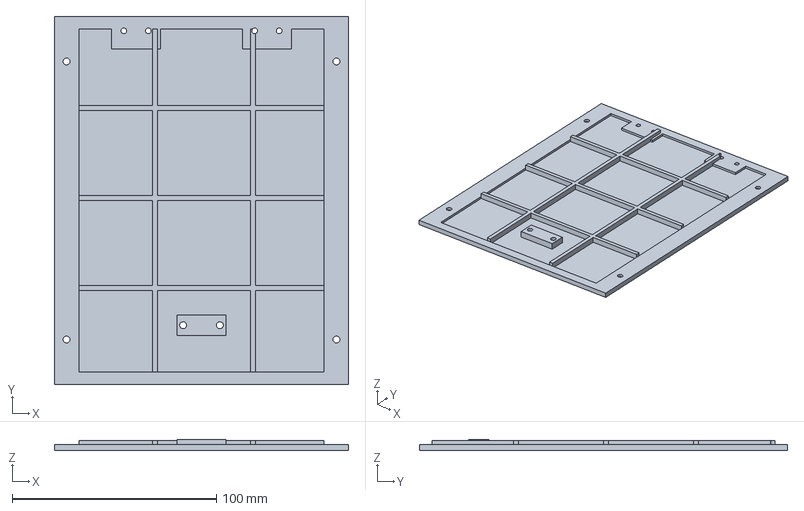
[picture p117: CAD file, 2026-11-02]
hardware/mechanical/print-backup/wall-panels-20261102/step/W02_REAR.step
144.0 x 180.0 x 5.50 mm
