Sylphiette666/stm32-rfid-smart-bin/hardware/mechanical/print-backup/wall-panels-fine-20261102/projects/P2S_WALL_01_FRONT_CONTROLS_FINE_016.3mf

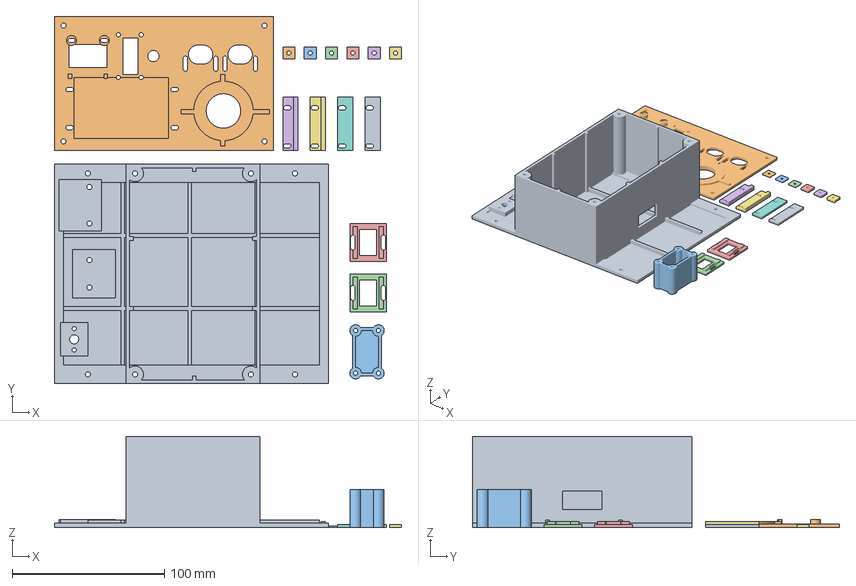
[picture p118: CAD file, 2026-11-02]
hardware/mechanical/print-backup/wall-panels-fine-20261102/projects/P2S_WALL_01_FRONT_CONTROLS_FINE_016.3mf
228.0 x 241.0 x 60.0 mm
W01_FRONT_1
PANEL_COVER_1
ENCODER_PIN_HOOD_1
BUTTON_CARRIER_1
BUTTON_CARRIER_2
RFID_EDGE_RAIL_1
RFID_EDGE_RAIL_2
RFID_RETAINER_3
RFID_RETAINER_4
SHIM_1_1
SHIM_1_2
SHIM_1_3
SHIM_2_4
SHIM_2_5
SHIM_2_6
