Sylphiette666/stm32-rfid-smart-bin/hardware/mechanical/print-backup/3mf/P2S/P03_stand_back_down.3mf

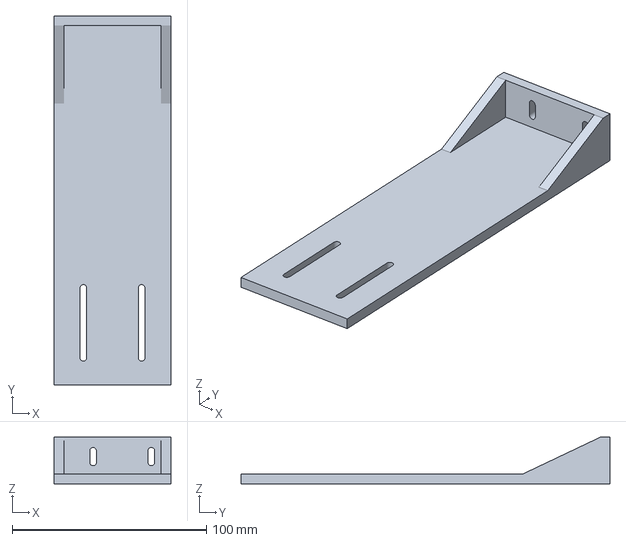
[picture p119: CAD file, 2026-10-30]
hardware/mechanical/print-backup/3mf/P2S/P03_stand_back_down.3mf
60.0 x 190.0 x 24.0 mm
