Sylphiette666/stm32-rfid-smart-bin/hardware/mechanical/print-backup/3mf/reference/P01_solid5_upright45.3mf

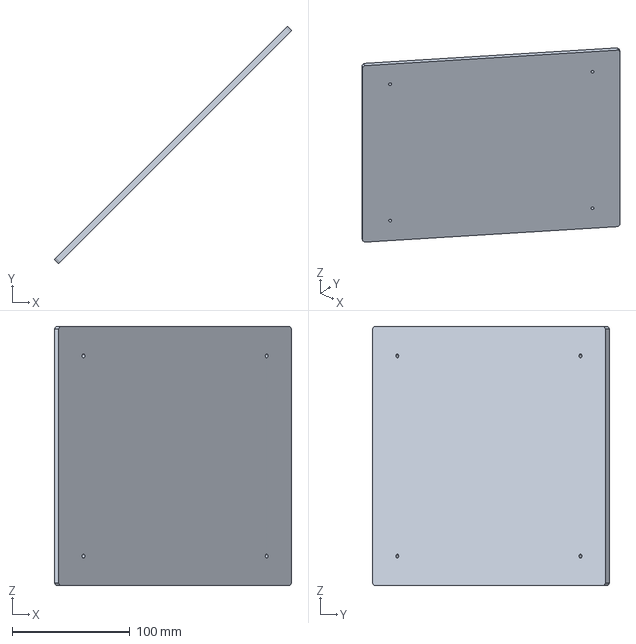
[picture p120: CAD file, 2026-10-30]
hardware/mechanical/print-backup/3mf/reference/P01_solid5_upright45.3mf
201.5 x 201.5 x 220.0 mm
