Sylphiette666/stm32-rfid-smart-bin/hardware/mechanical/print-backup/3mf/split/P02_rear.3mf

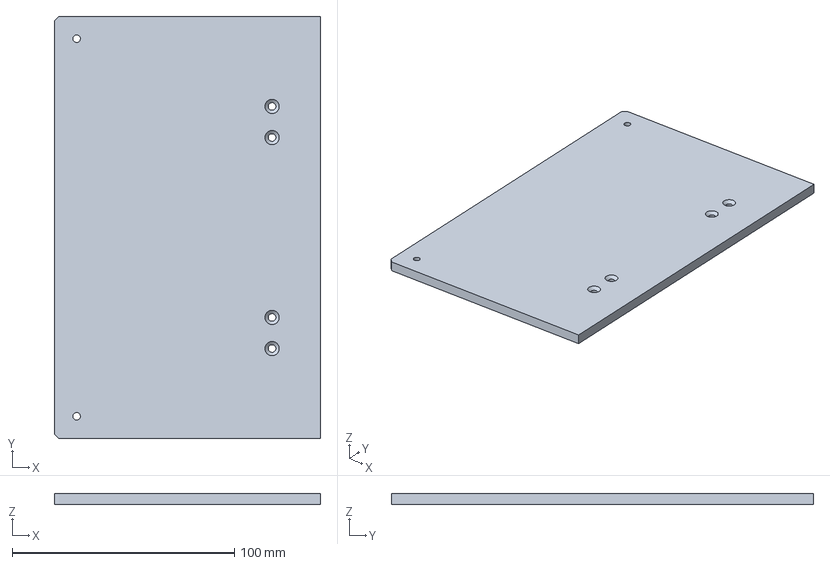
[picture p121: CAD file, 2026-10-30]
hardware/mechanical/print-backup/3mf/split/P02_rear.3mf
119.8 x 190.0 x 5.00 mm
