Sylphiette666/stm32-rfid-smart-bin/hardware/mechanical/print-backup/body-after-accessories-20261101/projects/P2S_BODY_AFTER_ACCESSORIES_PLATE_1.3mf

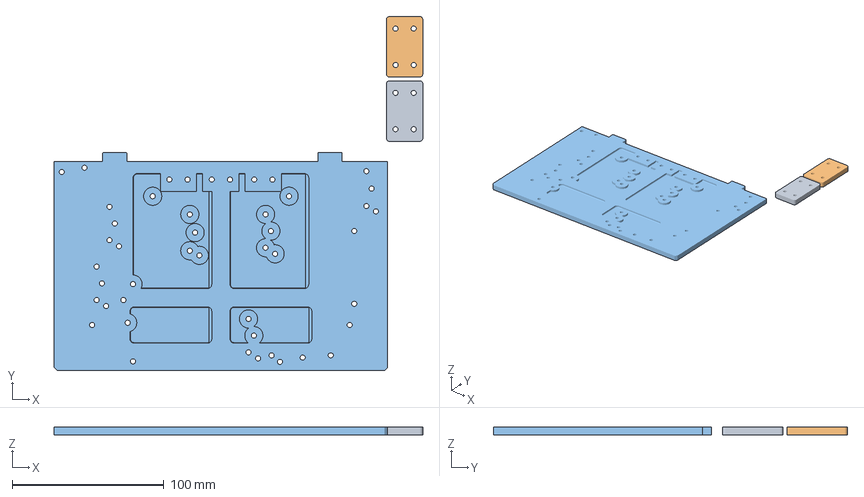
[picture p122: CAD file, 2026-11-01]
hardware/mechanical/print-backup/body-after-accessories-20261101/projects/P2S_BODY_AFTER_ACCESSORIES_PLATE_1.3mf
243.2 x 233.6 x 5.00 mm
JOIN_BRIDGE_2
JOIN_BRIDGE_3
P01_REAR_HALF
