Sylphiette666/stm32-rfid-smart-bin/hardware/mechanical/print-backup/caster-riser-20261103/CASTER_RISER_H41_GEOMETRY.3mf

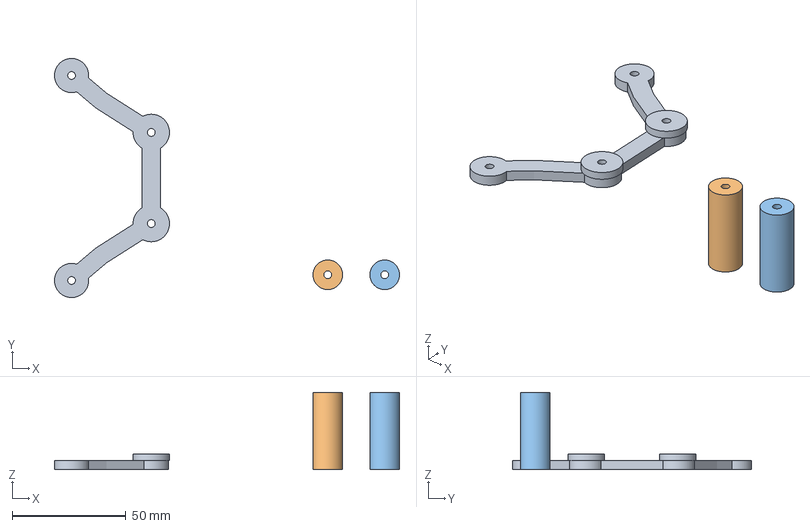
[picture p123: CAD file, 2026-11-03]
hardware/mechanical/print-backup/caster-riser-20261103/CASTER_RISER_H41_GEOMETRY.3mf
151.5 x 105.0 x 34.0 mm
CASTER_FRAME
COLUMN_A
COLUMN_B
