Sylphiette666/stm32-rfid-smart-bin/hardware/mechanical/print-backup/caster-riser-20261103/step/CASTER_COLUMN_40.step

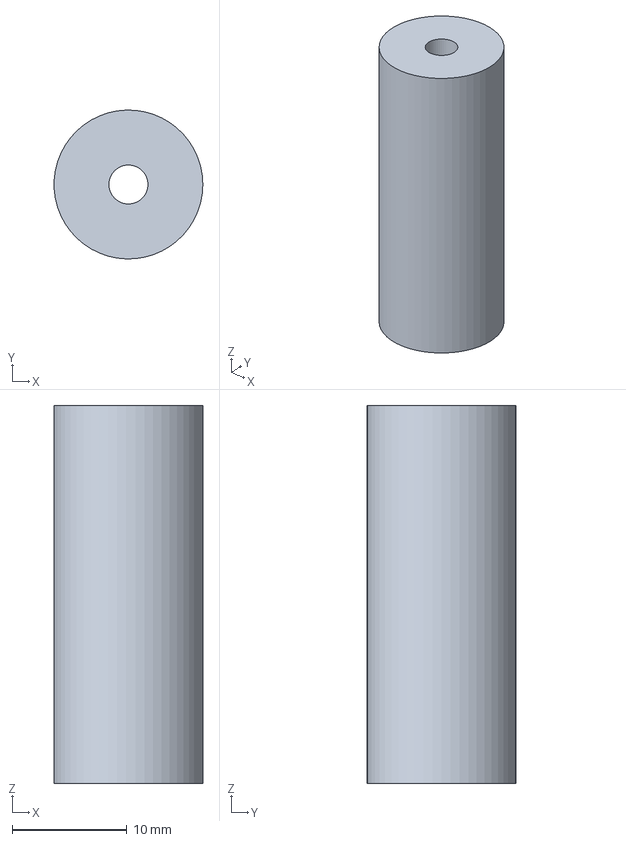
[picture p125: CAD file, 2026-11-03]
hardware/mechanical/print-backup/caster-riser-20261103/step/CASTER_COLUMN_40.step
13.0 x 13.0 x 33.0 mm
