Sylphiette666/stm32-rfid-smart-bin/hardware/mechanical/print-backup/caster-spacer-20261105/projects/P2S_CASTER_SPACER_H4_PETG.3mf

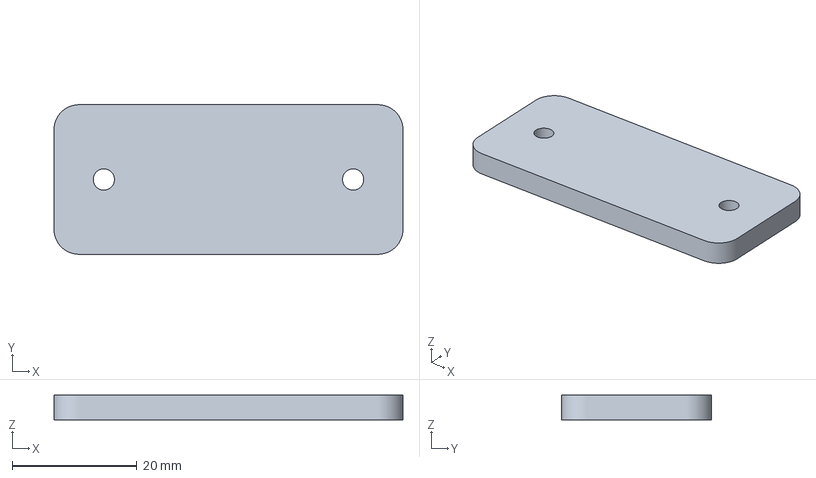
[picture p126: CAD file, 2026-11-05]
hardware/mechanical/print-backup/caster-spacer-20261105/projects/P2S_CASTER_SPACER_H4_PETG.3mf
56.0 x 24.0 x 4.00 mm
