Sylphiette666/stm32-rfid-smart-bin/hardware/mechanical/print-backup/flat-split-20261101/parts/M07_body.stl

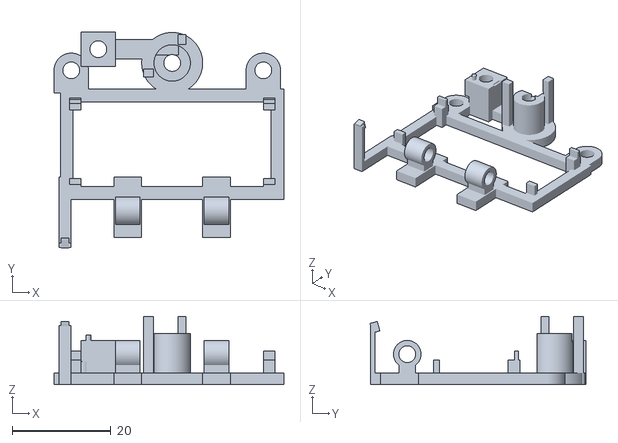
[picture p127: CAD file, 2026-11-01]
hardware/mechanical/print-backup/flat-split-20261101/parts/M07_body.stl
46.7 x 43.9 x 13.9
