Sylphiette666/stm32-rfid-smart-bin/hardware/mechanical/print-backup/flat-split-20261101/projects/P2S_FLAT_SPLIT_PLATE_3.3mf

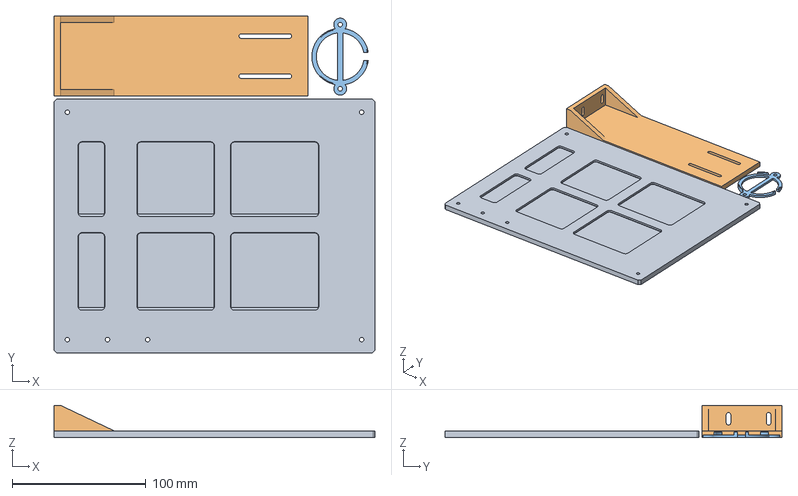
[picture p128: CAD file, 2026-11-01]
hardware/mechanical/print-backup/flat-split-20261101/projects/P2S_FLAT_SPLIT_PLATE_3.3mf
240.0 x 252.0 x 24.0 mm
P02_UPPER
P03_STAND
P07_SPEAKER_cradle
