Sylphiette666/stm32-rfid-smart-bin/hardware/mechanical/print-backup/flat-split-20261101/step/M06_body.step

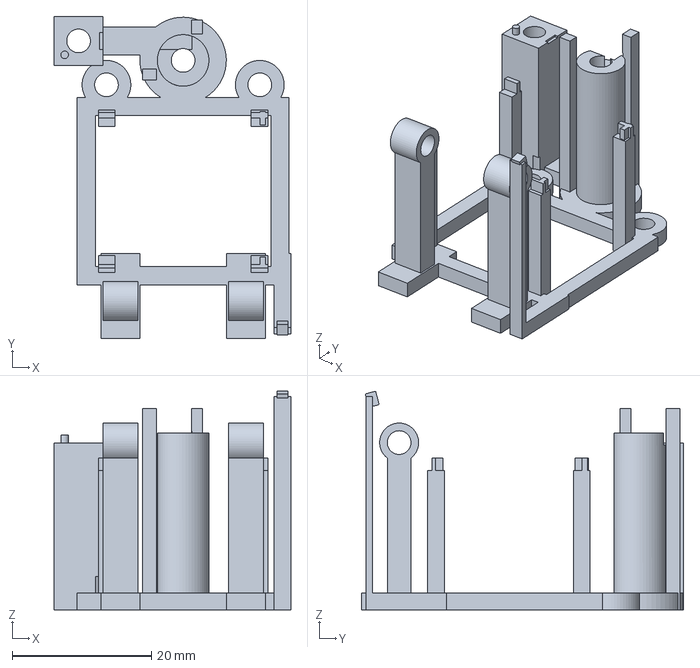
[picture p129: CAD file, 2026-11-01]
hardware/mechanical/print-backup/flat-split-20261101/step/M06_body.step
34.0 x 46.2 x 31.4 mm
