Sylphiette666/stm32-rfid-smart-bin/hardware/mechanical/print-backup/integrated-pla-20261104/step/LOWER_H41_B1.step

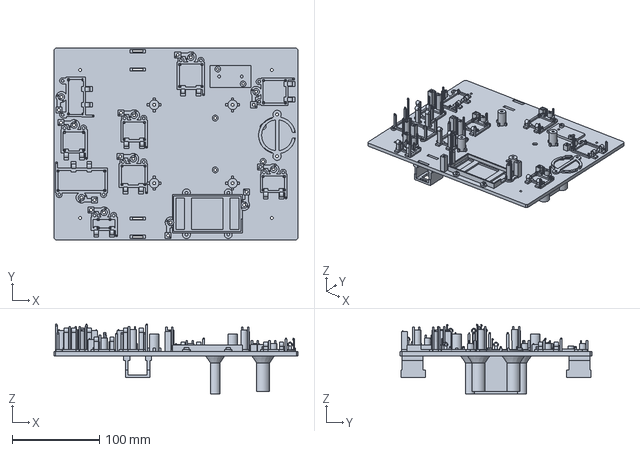
[picture p130: CAD file, 2026-11-03]
hardware/mechanical/print-backup/integrated-pla-20261104/step/LOWER_H41_B1.step
280.0 x 220.0 x 79.8 mm
