Sylphiette666/stm32-rfid-smart-bin/hardware/mechanical/print-backup/labeled-bases-20261101/geometry/PLATE_4_GEOMETRY.3mf

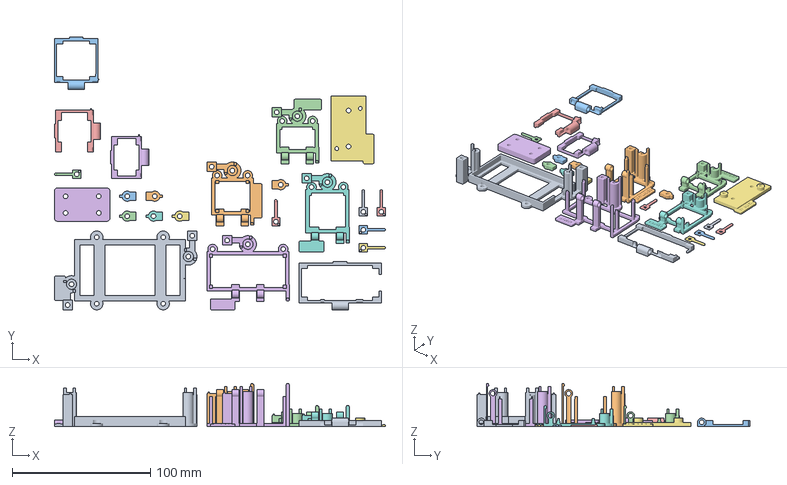
[picture p131: CAD file, 2026-11-01]
hardware/mechanical/print-backup/labeled-bases-20261101/geometry/PLATE_4_GEOMETRY.3mf
239.1 x 197.0 x 31.4 mm
P05_BATTERY_cradle
BAT_L_keeper
BAT_R_keeper
BAT_L_detent
BAT_R_detent
M01_body
M01_detent
M01_keeper
M01_lid
M06_body
M06_detent
M06_keeper
M06_lid
JOIN_BRIDGE_1
P06_BUCK_cradle
M04_body
M04_detent
M04_keeper
M04_lid
M09_body
M09_detent
M09_lid
M09_keeper
