Sylphiette666/stm32-rfid-smart-bin/hardware/mechanical/print-backup/labeled-bases-20261101/step/M05_body.step

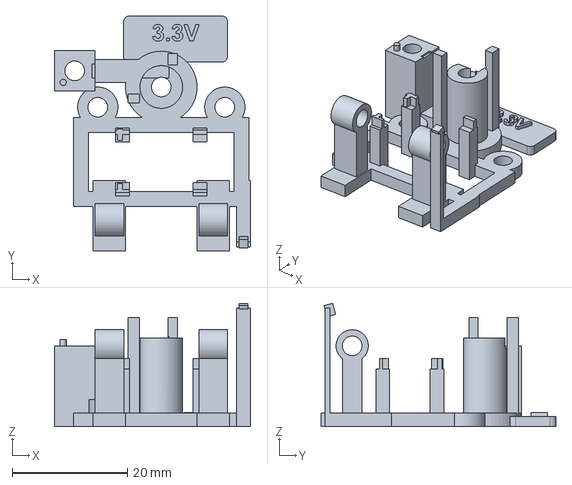
[picture p132: CAD file, 2026-11-01]
hardware/mechanical/print-backup/labeled-bases-20261101/step/M05_body.step
34.0 x 40.7 x 21.4 mm
