Sylphiette666/stm32-rfid-smart-bin/hardware/mechanical/print-backup/motor-adapter-clearance-20261102/quick-fit/P2S_D06_RIGHT_QUICK_FIT_028.3mf

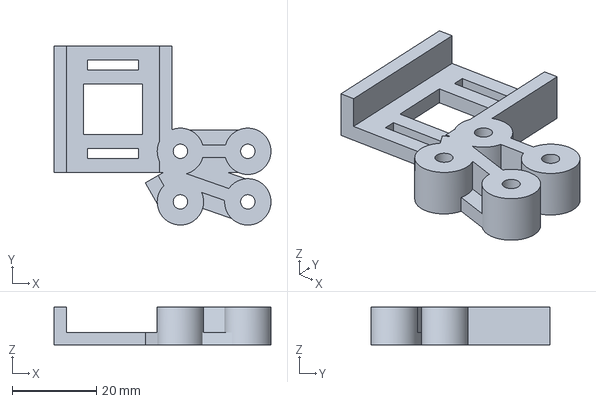
[picture p133: CAD file, 2026-11-02]
hardware/mechanical/print-backup/motor-adapter-clearance-20261102/quick-fit/P2S_D06_RIGHT_QUICK_FIT_028.3mf
51.5 x 42.5 x 9.00 mm
