Sylphiette666/stm32-rfid-smart-bin/hardware/mechanical/print-backup/motor-fit-20261101/fast/all_three/step/FIT_A.step

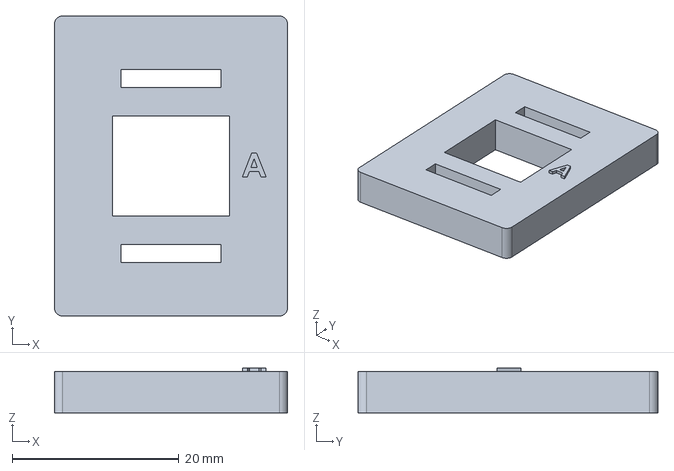
[picture p134: CAD file, 2026-11-01]
hardware/mechanical/print-backup/motor-fit-20261101/fast/all_three/step/FIT_A.step
28.0 x 36.0 x 5.40 mm
