Sylphiette666/stm32-rfid-smart-bin/hardware/mechanical/print-backup/tracker-mount-20261103/step/SPACER_18.step

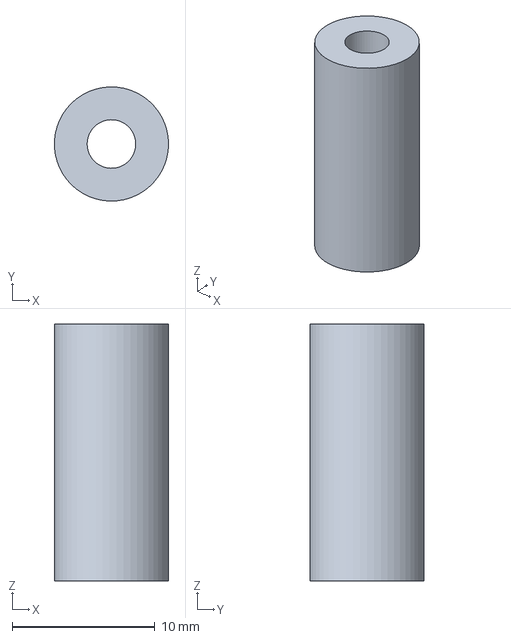
[picture p135: CAD file, 2026-11-03]
hardware/mechanical/print-backup/tracker-mount-20261103/step/SPACER_18.step
7.99 x 8.00 x 18.0 mm
