Sylphiette666/stm32-rfid-smart-bin/hardware/mechanical/print-backup/wall-clamp-preview-20261103/qa_meshes/C1_LEFT_REAR.stl

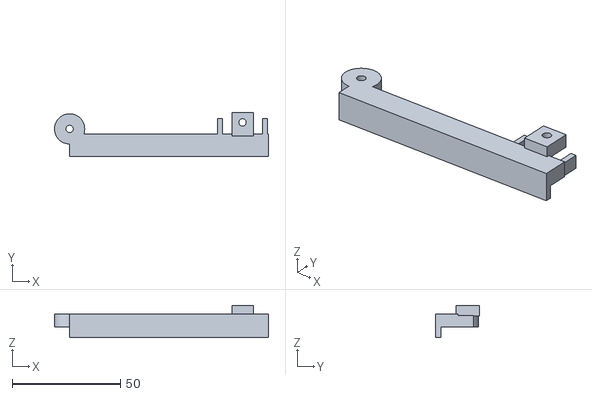
[picture p136: CAD file, 2026-11-03]
hardware/mechanical/print-backup/wall-clamp-preview-20261103/qa_meshes/C1_LEFT_REAR.stl
99.0 x 20.2 x 15.0
