Sylphiette666/stm32-rfid-smart-bin/hardware/mechanical/print-backup/wall-panels-20261102/projects/P2S_WALL_02_REAR.3mf

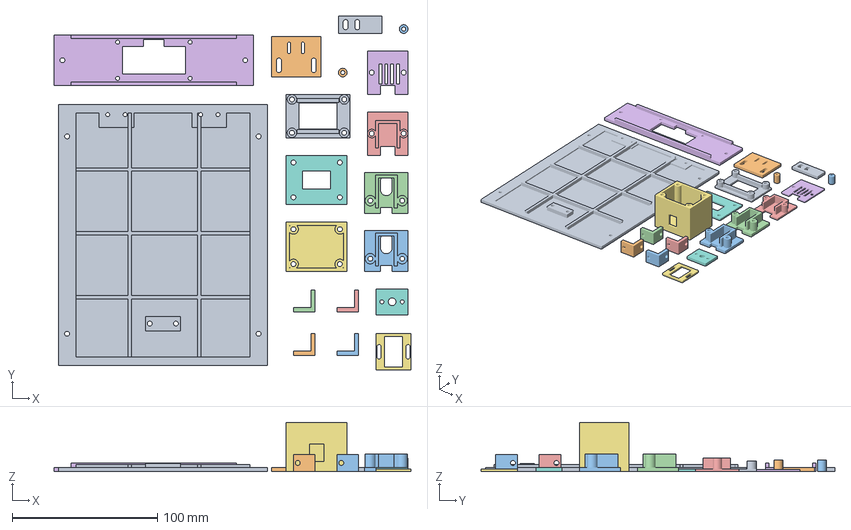
[picture p137: CAD file, 2026-11-02]
hardware/mechanical/print-backup/wall-panels-20261102/projects/P2S_WALL_02_REAR.3mf
246.0 x 244.0 x 34.0 mm
W02_REAR_1
CORNER_ANGLE_1
CORNER_ANGLE_2
CORNER_ANGLE_3
CORNER_ANGLE_4
ULTRASONIC_BEAM_1
POWER_POD_1
POWER_INSERT_1
LIGHT_CRADLE_1
LID_SWITCH_PLATE_1
BEAM_SEAT_1
BEAM_SEAT_2
DHT_SEAT_1
DHT_GUARD_1
BUTTON_RETAINER_1
LED_INSERT_1
LID_TOUCH_TAB_1
BUTTON_SPACER_1
BUTTON_SPACER_2
