Sylphiette666/stm32-rfid-smart-bin/hardware/mechanical/print-backup/wall-panels-20261102/step/CABLE_CAP.step

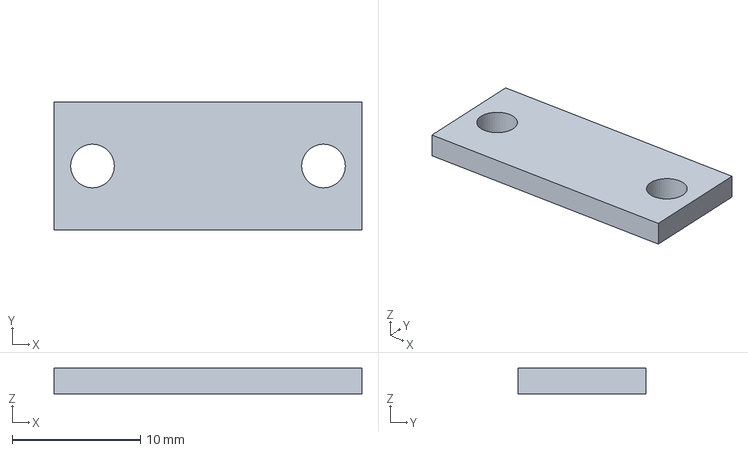
[picture p138: CAD file, 2026-11-02]
hardware/mechanical/print-backup/wall-panels-20261102/step/CABLE_CAP.step
24.0 x 10.0 x 2.00 mm
