Sylphiette666/stm32-rfid-smart-bin/hardware/mechanical/print-backup/wall-panels-fine-20261102/projects/P2S_WALL_03_LEFT_FINE_016.3mf

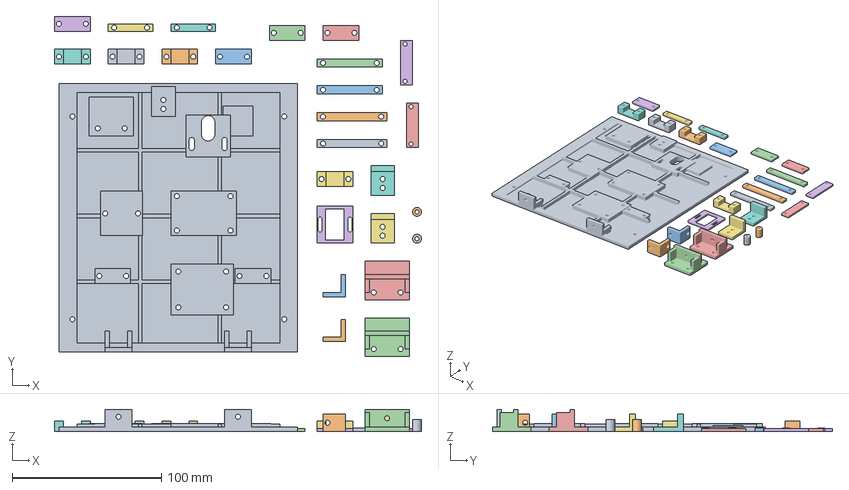
[picture p139: CAD file, 2026-11-02]
hardware/mechanical/print-backup/wall-panels-fine-20261102/projects/P2S_WALL_03_LEFT_FINE_016.3mf
246.0 x 228.0 x 15.0 mm
W03_LEFT_1
CORNER_ANGLE_1
CORNER_ANGLE_2
BEAM_LEDGE_1
BEAM_LEDGE_2
BUTTON_RETAINER_2
LID_SOFTSTOP_SEAT_1
LID_SOFTSTOP_SEAT_2
APPROACH_EDGE_BAR_1
APPROACH_EDGE_BAR_2
LIGHT_EDGE_BAR_1
LIGHT_EDGE_BAR_2
ULTRASONIC_RETAINER_1
ULTRASONIC_RETAINER_2
CABLE_SADDLE_1
CABLE_SADDLE_2
CABLE_SADDLE_3
CABLE_SADDLE_4
CABLE_CAP_1
CABLE_CAP_2
CABLE_CAP_3
CABLE_CAP_4
BEAM_RETAINER_1
BEAM_RETAINER_2
BUTTON_SPACER_3
BUTTON_SPACER_4
