Sylphiette666/stm32-rfid-smart-bin/(list of files, cad)

Other CAD files:
hardware/mechanical/print-backup/wall-clamps-fine-20261103/step/C2_LEFT_FRONT_ASSEMBLY.step
hardware/mechanical/print-backup/flat-split-20261101/source/assembly_bridge2.stl
hardware/mechanical/print-backup/flat-split-20261101/source/assembly_front.stl
hardware/mechanical/print-backup/flat-split-20261101/source/assembly_bridge3.stl
hardware/mechanical/print-backup/step/P01_full.step
hardware/mechanical/print-backup/step/P02_full.step
hardware/mechanical/print-backup/3mf/reference/P02_solid5_flat.3mf
hardware/mechanical/print-backup/accessories-fine-20261101/projects/P2S_ORIGINAL_PLATE1_NO_BASE_FINE_016.3mf
hardware/mechanical/print-backup/accessories-plate-20261105/projects/P2S_MODULE_ACCESSORIES_31PCS_PLA_20261105.3mf
hardware/mechanical/print-backup/body-after-accessories-20261101/projects/P2S_BODY_AFTER_ACCESSORIES_PLATE_2.3mf
hardware/mechanical/print-backup/labeled-bases-20261101/geometry/PLATE_1_GEOMETRY.3mf
hardware/mechanical/print-backup/labeled-bases-20261101/projects/P2S_PRINTER_02_BASE_REAR.3mf
hardware/mechanical/print-backup/lid-petg-final-20261103/parts/L02_HINGE_SHOE_PRINT.stl
hardware/mechanical/print-backup/motor-adapter-20261101/P2S_D06_ADAPTER_PAIR_028.3mf
hardware/mechanical/print-backup/motor-adapter-clearance-20261102/quick-fit/P2S_D06_PAIR_QUICK_FIT_028.3mf
hardware/mechanical/print-backup/motor-adapter-clearance2-20261102/step/D06_ADAPTER_LEFT.step
hardware/mechanical/print-backup/motor-adapter-clearance2-final-20261102/P2S_D06_CLEARANCE2_FINAL_PAIR_016.3mf
hardware/mechanical/print-backup/motor-existing-holes-light-20261103/parts/D06_CARRIER_RIGHT_PRINT.stl
hardware/mechanical/print-backup/motor-fit-20261101/fast/b_only/P2S_D06_FIT_B_ONLY_FAST_028.3mf
hardware/mechanical/print-backup/motor-fit-20261101/fast/b_only/step/FIT_B.step
hardware/mechanical/print-backup/motor-fit-20261101/fast/b_only/thin3/plain/step/FIT_B.step
hardware/mechanical/print-backup/motor-fit-20261101/fast/b_only/thin3/step/FIT_B.step
hardware/mechanical/print-backup/motor-fit-20261101/P2S_D06_FIT_TEST_016.3mf
hardware/mechanical/print-backup/mounted-20261031/geometry/M06_keeper_bed1.stl
hardware/mechanical/print-backup/parallel-four-p2s-20261101/projects/P2S_PRINTER_03_BASE_FRONT.3mf
hardware/mechanical/print-backup/r3d-petg-fast-20261104/projects/P2S_PANEL_COVER_R3D_PETG_FAST_CANDIDATE.3mf
hardware/mechanical/print-backup/wall-clamp-preview-20261103/qa_meshes/C4_RIGHT_REAR.stl
hardware/mechanical/print-backup/wall-clamp-preview-20261103/step/C3_RIGHT_FRONT_CONCEPT.step
hardware/mechanical/print-backup/wall-panels-20261102/parts/PANEL_COVER.stl
hardware/mechanical/print-backup/3mf/combined/P2S_ALL4_BY_LAYER.3mf
hardware/mechanical/print-backup/caster-tracker-plate-20261103/P2S_CASTER_H41_TRACKER_ALL_012.3mf
hardware/mechanical/print-backup/easy-support-20261104/projects/P2S_LOWER_H41_B1_PLA_EASYSUPPORT_0.28.3mf
hardware/mechanical/print-backup/flat-split-20261101/geometry/PLATE_2_GEOMETRY.3mf
hardware/mechanical/print-backup/integrated-pla-20261104/projects/P2S_PANEL_COVER_PLA_008.3mf
hardware/mechanical/print-backup/integrated-pla-fast-20261104/projects/P2S_PANEL_COVER_PLA_FAST_CANDIDATE.3mf
hardware/mechanical/print-backup/labeled-bases-20261101/projects/P2S_PRINTER_05_LABELED_CLAMPS_B.3mf
hardware/mechanical/print-backup/lid-fine-20261103/P2S_LID_FINE_012.3mf
hardware/mechanical/print-backup/lid-fine-20261103/step/T01_HINGE_FIT_COUPON_PRINT.step
hardware/mechanical/print-backup/lid-petg-final-20261103/P2S_HINGE_TRIAL_PETG_FINAL_008.3mf
hardware/mechanical/print-backup/lid-petg-final-20261103/parts/L04_SWITCH_FOOT_PRINT.stl
hardware/mechanical/print-backup/motor-adapter-clearance2-20261102/step/D06_ADAPTER_RIGHT.step
hardware/mechanical/print-backup/motor-existing-holes-light-20261103/parts/D06_CARRIER_LEFT_PRINT.stl
hardware/mechanical/print-backup/mounted-20261031/geometry/M09_detent_bed1.stl
hardware/mechanical/print-backup/mounted-20261031/parts/P01_MOUNTED_BASE_DESIGN.stl
hardware/mechanical/print-backup/mounted-20261031/projects/P2S_MOUNTED_PLATE_2.3mf
hardware/mechanical/print-backup/mounted-20261031/step/M04_keeper.step
hardware/mechanical/print-backup/parallel-four-p2s-20261101/projects/P2S_PRINTER_02_BASE_REAR.3mf
hardware/mechanical/print-backup/r3d-petg-fast-20261104/projects/P2S_LOWER_H41_B1_R3D_PETG_FAST_CANDIDATE.3mf
hardware/mechanical/print-backup/step/P02_light.step
hardware/mechanical/print-backup/stl/combined/P01_base.stl
hardware/mechanical/print-backup/stl/design/P03_servo_adjustable_stand.stl
hardware/mechanical/print-backup/tracker-mount-20261103/parts/TRACKER_FRAME_PRINT.stl
hardware/mechanical/print-backup/tracker-mount-20261103/TRACKER_LIGHT_GEOMETRY.3mf
hardware/mechanical/print-backup/wall-clamp-preview-20261103/step/C1_LEFT_REAR_CONCEPT.step
hardware/mechanical/print-backup/3mf/P2S/P01_light_upright45.3mf
hardware/mechanical/print-backup/3mf/P2S/P01_upright45.3mf
hardware/mechanical/print-backup/3mf/P2S/P02_flat.3mf
hardware/mechanical/print-backup/3mf/P2S/P02_light_face_down.3mf
hardware/mechanical/print-backup/3mf/P2S/P04_tray_flat.3mf
hardware/mechanical/print-backup/3mf/split/C01_hole_test.3mf
hardware/mechanical/print-backup/3mf/split/J01_joiner_print_6.3mf
hardware/mechanical/print-backup/3mf/split/P01_front_plusY.3mf
hardware/mechanical/print-backup/3mf/split/P01_rear_minusY.3mf
hardware/mechanical/print-backup/3mf/split/P01_rear_plusY.3mf
hardware/mechanical/print-backup/3mf/split/P02_front.3mf
hardware/mechanical/print-backup/body-after-accessories-20261101/geometry/PLATE_1_GEOMETRY.3mf
hardware/mechanical/print-backup/body-after-accessories-20261101/geometry/PLATE_3_GEOMETRY.3mf
hardware/mechanical/print-backup/body-after-accessories-20261101/projects/P2S_BODY_AFTER_ACCESSORIES_PLATE_3.3mf
hardware/mechanical/print-backup/caster-riser-20261103/CASTER_RISER_H35_GEOMETRY.3mf
hardware/mechanical/print-backup/caster-riser-20261103/CASTER_RISER_H40_GEOMETRY.3mf
hardware/mechanical/print-backup/caster-riser-20261103/P2S_CASTER_RISER_H35_LIGHT_016.3mf
hardware/mechanical/print-backup/caster-riser-20261103/P2S_CASTER_RISER_H40_LIGHT_016.3mf
hardware/mechanical/print-backup/caster-riser-20261103/P2S_CASTER_RISER_H41_LIGHT_016.3mf
hardware/mechanical/print-backup/caster-riser-20261103/P2S_CASTER_RISER_H45_LIGHT_016.3mf
hardware/mechanical/print-backup/caster-riser-20261103/parts/CASTER_COLUMN_40_PRINT.stl
hardware/mechanical/print-backup/caster-riser-20261103/parts/CASTER_COLUMN_45_PRINT.stl
hardware/mechanical/print-backup/caster-riser-20261103/parts/CASTER_FRAME_PRINT.stl
hardware/mechanical/print-backup/caster-riser-20261103/step/CASTER_COLUMN_35.step
hardware/mechanical/print-backup/caster-riser-20261103/step/CASTER_COLUMN_41.step
hardware/mechanical/print-backup/caster-riser-20261103/step/CASTER_COLUMN_45.step
hardware/mechanical/print-backup/caster-spacer-20261105/projects/P2S_CASTER_SPACER_H3_PETG.3mf
hardware/mechanical/print-backup/easy-support-20261104/projects/P2S_LOWER_H41_B1_R3D_PETG_EASYSUPPORT_0.28.3mf
hardware/mechanical/print-backup/easy-support-20261104/projects/P2S_UPPER_INTEGRATED_PLA_EASYSUPPORT_0.28.3mf
hardware/mechanical/print-backup/easy-support-20261104/projects/P2S_UPPER_INTEGRATED_R3D_PETG_EASYSUPPORT_0.28.3mf
hardware/mechanical/print-backup/flat-split-20261101/geometry/BAT_L_detent_bed1.stl
hardware/mechanical/print-backup/flat-split-20261101/geometry/BAT_L_keeper_bed1.stl
hardware/mechanical/print-backup/flat-split-20261101/geometry/BAT_R_detent_bed1.stl
hardware/mechanical/print-backup/flat-split-20261101/geometry/BAT_R_keeper_bed1.stl
hardware/mechanical/print-backup/flat-split-20261101/geometry/JOIN_BRIDGE_1_bed2.stl
hardware/mechanical/print-backup/flat-split-20261101/geometry/JOIN_BRIDGE_2_bed1.stl
hardware/mechanical/print-backup/flat-split-20261101/geometry/JOIN_BRIDGE_3_bed1.stl
hardware/mechanical/print-backup/flat-split-20261101/geometry/M01_detent_bed2.stl
hardware/mechanical/print-backup/flat-split-20261101/geometry/M01_keeper_bed2.stl
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
