Sylphiette666/stm32-rfid-smart-bin/docs/manual/four-skills-review-20261012/README.md

# 四套技能审查后的同名手册更新

当前手册增加第64章，200页；原330步骤、64张既有表格内容全部保留，替换PCB实际底面图。FINAL_QA.json记录当前同名Word哈希和渲染检查：196页正文与已审版本像素一致，5/179/199/200页逐页查看。首次新增表格超出版心的问题已修正；发布的是修复后版本。

同级pcb-a-update-20261012保存改版前198页手册的历史构建证据。这里的脚本是增量构建方法，需原198页基线，不应对当前200页文件再次执行。

详细电气与制造报告位于hardware/current-low-cost/pcb-a/review/four-skills。未关闭的EMC布局风险和实物验收项目已写入手册，不表示整机验证全部通过。
