Sylphiette666/stm32-rfid-smart-bin/hardware/mechanical/print-backup/accessories-plate-20261105/README.md

# 智能移动垃圾桶 · 模块附件打印盘（31 件，PLA / 0.16 mm）

日期 2026-11-05 · 打印机 Bambu Lab P2S（0.4 mm 喷嘴，纹理 PEI 板）· 切片器 Bambu Studio 02.08.02.61（CLI 02.08.02.61）

## 为什么要有这一盘

一体结构版本里，9 个模块卡座、电池座、降压/喇叭座都已经和上下主体一起打印，**你能在旧盘上找到的

`M01_body … M09_body`、`P01_BASE_WITH_CRADLE`、`P04_TRAY`、`P05_BATTERY_cradle`、`P06_BUCK_cradle` 全部作废**。
真正还需要单独打印的只有 31 件小附件：9 套「压框 + 定位簧片 + 刚性拨片」和电池左右两套「簧片 + 锁片」。
直接打旧的一体盘会白花约 200 g 料和几小时；本盘只含这 31 件。

## 文件

| 文件 | 说明 |
| --- | --- |
| `projects/P2S_MODULE_ACCESSORIES_31PCS_PLA_20261105.3mf` | 可直接送印的工程（31 个对象，已排好，无 gcode） |
| `preview/accessories_31_plate.png` | 盘面预览 |
| `checks/accessories_plate_checks.json` | 切片结果与校验（层数、无支撑、时间、耗材） |
| `checks/plate_parts.json` | 31 件的对象名与中文对应 |
| `checks/accessories_plate_slicing.json` | 切片器原始 result.json 摘要 |
| `checks/SHA256.json` | 全部文件校验值 |
| `source/build_accessory_plate.py` | 生成脚本（从旧盘抽取 31 件 → 0.16 mm 切片 → 导出工程） |
| `geometry/accessories_31.3mf` | 抽件后的中间几何（不含切片设置，供追溯） |

## 打印结果（切片估算，未实物验证）

| 项目 | 数值 |
| --- | --- |
| 预计时间 | **1小时40分44秒**（gcode 头 1h 40m 43s） |
| 耗材 | **16.93 g**（PLA，含 4 mm brim） |
| 层数 | 45 层（首层 0.2 mm + 44×0.16 mm，最高 Z 7.24 mm） |
| 支撑 | 无（全部平放，gcode 内 0 条支撑特征） |
| 墙/填充 | 4 圈墙、顶 6 层 / 底 4 层、30% gyroid |
| 底板附着 | 每件 4 mm 外沿 brim，31 个 brim |

## 打印注意

1. **不要旋转、不要自动摆放**。这些簧片/拨片是 1.64 / 3.2 mm 的薄件，当前姿态是之前在整盘上验证过的平放姿态；改成竖放会显著降低层间强度。
2. 0.16 mm 层高是给薄簧片留的：1.64 mm 的簧片有 10 层左右，弯折时不容易沿层断开；用 0.28 mm 只有 6 层，簧片会更脆。
3. brim 是 4 mm 外沿，拆的时候沿盘面平推，不要向上掰，避免簧片尖端被带起。
4. 这一盘不含铰链轴、螺钉。压框/拨片装好后按装配指南 B 阶段：先试合 → 金属 M3×30 轴穿铰链 → 装簧片与锚钉（M3×25/30/40 按模块高度选）→ 装刚性拨片，锁母留 0.1–0.2 mm 轴向间隙。
5. 定位簧片只负责定位，不要靠它承受开合力；受力件是刚性拨片 + 金属轴。

## 已验证 / 未验证

- 已验证：31 个对象与原始盘上的网格、姿态一致（只删除了 13 个作废对象）；切片 rc=0、无 warning、gcode 45 层、0 条支撑、31 个 brim、16.93 g；工程文件内 layer_height 0.16 / PLA / P2S / 纹理 PEI 均正确，且不含 gcode。
- 未验证：实物打印与装配手感。薄簧片的实际弹性、拆 brim 时的崩边风险，需要打完装一次才能确认；如出现簧片过软/过硬，可在 0.16 mm 基础上改 0.12 mm 或把簧片单独 100% 实心补打。
