Sylphiette666/stm32-rfid-smart-bin/hardware/mechanical/print-backup/caster-spacer-20261105/README.md

# 万向轮增高垫块（R3D PETG，H3 / H4 / H5）

2026-11-05。适用对象：PLA 一体下半主体（`integrated-pla-20261104`，万向轮座安装面 Z=−41）与 D05 万向轮；不是 `caster-riser-20261103` 独立增高支架。打印机拓竹 P2S、0.4 mm 喷嘴、纹理 PEI、R3D PETG。

## 结论：用 H4（4 mm）

- 用户实测：**底板上平面 → 驱动轮/地面接触 ≈ 70 mm**。
- 设计高度链：底板 5 mm + 一体万向轮座 41 mm + D05 万向轮实测总高 20 mm = **名义 66 mm**（原手册记录 66.19 mm，名义取 66）。
- 差值约 4 mm：现在万向轮比驱动轮短约 4 mm，车体前部靠驱动轮支撑而前倾。
- 垫块厚度 **t = 实测上平面高度 − 66 mm**（量底板下表面则 t = 实测下表面高度 − 61 mm）。所以约 70 mm 对应 H4；若精确量到 69 / 71 mm 附近，改用 H3 / H5。
- 若装好后仍有一轮悬空，用 0.2–0.5 mm 平垫叠在垫块与万向轮安装片之间微调；不要靠强行拧螺钉把车架压平。

## 三个版本的切片估计（PETG，0.2 mm 层高）

| 型号 | 净厚度 | 打印工程 | 耗时 | PETG 含支撑 |
|---|---:|---|---:|---:|
| H3 | 3.0 mm | [P2S_CASTER_SPACER_H3_PETG.3mf](projects/P2S_CASTER_SPACER_H3_PETG.3mf) | 19分28秒 | 4.45 g |
| **H4（主选）** | **4.0 mm** | **[P2S_CASTER_SPACER_H4_PETG.3mf](projects/P2S_CASTER_SPACER_H4_PETG.3mf)** | **22分47秒** | **5.44 g** |
| H5 | 5.0 mm | [P2S_CASTER_SPACER_H5_PETG.3mf](projects/P2S_CASTER_SPACER_H5_PETG.3mf) | 26分11秒 | 6.45 g |

打印参数：0.2 mm 层高、首层 0.2、6 墙、45% gyroid、顶/底 5 层、无支撑、5 mm 外侧 brim、外墙 80 / 内墙与填充 150 mm/s，加速度 4000。PETG 温度 250 ℃、纹理 PEI 60 ℃、体积流量上限 12 mm³/s、流量比 0.95（R3D 官网建议值的保守取法；R3D 没有 Bambu Studio 官方配置）。三件都是工程文件，没有预制 G-code。

## 结构与接口

- 外形 **56 × 24 mm，四角 R4**；两个 **Φ3.4** 通孔，孔距 **40 mm**，对应一体座已有一对万向轮孔 (240,90)/(240,130)，孔位不改。
- 安装时长边沿两孔连线方向（车身 Y 向）放好、把孔对正即可；垫块上下两面相同，不区分正反。
- 上表面同时压在两个 **Ø15 承压柱**和中间 3 mm 连接筋的同一平面（Z=−41）；下表面贴 D05 万向轮的安装片上表面。
- 平放打印（厚度方向为 Z），无需支撑；孔为竖直通孔，0.2 mm 层高下 Φ3.4 的 M3 间隙足够。
- 选 PETG 的理由：垫块受螺钉预紧和落地冲击，PETG 韧性好、不易脆裂；但 PETG 在 PEI 板上偏粘，建议薄涂胶水做脱模剂，冷却后再取件。

## 装配步骤

1. 断电、抬车（或侧放），拆下万向轮两颗连接螺钉。
2. 把垫块对正放在万向轮安装片上，孔距 40 mm 对正；也可先把螺钉穿过底板、垫块再对万向轮。
3. 螺钉从底板**上面**沉孔穿下（一体座为 Φ3.4 通孔，顶部 Φ6.8 沉孔）；螺钉要比第68章候选长度再长 t：一体座候选为 M3×55（手册68章2402段，贯穿41 mm座+5 mm底板），加 H4 垫块后约需 M3×60；以试装为准，锁母至少啮合 2–3 扣，螺钉端不得碰滚轮、不得先于轮胎触地。
4. 对角均匀拧到“贴合、不压溃”即可；PETG 有蠕变，不要大力过拧。转动万向轮一整圈，确认不刮垫块、轮胎、线束和循迹架。
5. 平桌检查：两驱动轮 + 万向轮**三点同时着地**、车体基本水平、手推不翘动。仍有一轮悬空就换 H3/H5 或加 0.2–0.5 mm 平垫。
6. 装车后复测循迹探头离地（名义 8 mm）和最低点离地；整车姿态可能因垫块厚度变化。

## 文件与声明

- `projects/`：三个 P2S 工程 3MF（无 G-code，保留参数，可重新切片）。
- `checks/`：每件切片记录与几何检查；`SHA256.json` 为包内文件清单。
- `source/build_spacer.py`：几何、切片与导出脚本（Bambu Studio CLI 离线切片）。
- 高度依据是用户口述“约 70 mm”和已有设计高度链；**未做实物装配、强度或疲劳验证**。装车后必须实测三点着地与水平度。
- 相关：`integrated-pla-20261104`（H41 一体座）、`caster-riser-20261103`（独立 H41 支架，另一个结构）、`r3d-petg-fast-20261104`（R3D PETG 参数来源）。
