Sylphiette666/stm32-rfid-smart-bin/hardware/mechanical/print-backup/r3d-petg-fast-20261104/README.md

# 智能垃圾桶三件套 — R3D PETG 树形支撑 0.28 mm 最快打印候选

日期：2026-11-04　打印机：Bambu Lab P2S（0.4 mm 喷嘴，纹理 PEI 板）　材料：R3D PETG（1.75 mm）

## 结论

- 三件全部使用 **0.28 mm 层高**（0.4 喷嘴可稳定挤出的上限），PETG 参数按 R3D 官方建议区间取保守值。
- 切片估算合计 **约 48小时17分49秒（1195.3 g）**；面板盖与下半主体均在 24 小时内，**上半集成主体约 33小时25分55秒 仍超 24 小时**（几何体量决定，层高无法弥补）。
- 本包只含 PETG 版本；**PLA 版本（0.28 mm，整套约 47 小时 38 分 / 1203.9 g）保持不变**，见 `integrated-pla-fast-20261104`。

## 为什么选 0.28 mm

| 件 | 0.28 mm | 0.24 mm | 0.20 mm |
|---|---|---|---|
| 下半主体 H41/B1 | 13.89 h / 371.3 g | 15.21 h / 375.4 g | 17.99 h / 389.2 g |
| 上半集成主体 | 33.43 h / 797.2 g | 37.15 h / 816.4 g | 44.13 h / 826.7 g |
| 可拆操作面板 | 0.97 h / 26.8 g | 1.00 h / 26.5 g | 1.04 h / 25.1 g |

- 降到 0.24 mm：每件都更慢，全套约多 5小时3分50秒、多约 22.9 g；降到 0.20 mm：全套约多 14小时51分48秒、多约 45.7 g。
- 0.28 mm 是 0.4 喷嘴约 70% 喷嘴直径的上限；再往上（0.32+）层间结合与表面质量明显下降，不建议用于承力结构件。PETG 层间结合本身较好，0.28 mm 可用于结构件；如需最高 Z 向强度可选 0.24/0.20（包内 `checks/r3d_petg_candidates.json` 保留全部候选数据）。
- 与 PLA 版 0.28 mm（折合 47小时37分36秒、1203.9 g）相比：PETG 版约慢 40 分钟、轻约 8.6 g（PETG 流量比 0.95、实际密度更高，重量接近）。

## 采用的参数

| 参数 | 值 |
|---|---|
| 层高 / 首层 | 0.28 mm / 0.20 mm |
| 喷嘴温度（普通/首层） | 250 ℃ / 250 ℃ |
| 热床（纹理 PEI） | 60 ℃ |
| 流量比 / 最大体积流量 | 0.95 / 12 mm³/s（两条保守取值） |
| 风扇（最小/最大/悬垂） | 10 % / 40 % / 40 %（首 3 层关闭） |
| 墙 / 填充 | 3 道 / 10 % gyroid（面板 15 %） |
| 顶底壳层 | 3 / 3 层（0.84 mm） |
| 速度（外墙/内墙） | 120 / 230 mm/s（沿用已验证快速参数） |
| 支撑（两主体） | 树形 auto slim，阈值 35°，枝径 3，Z 间隙 0.28；面板无支撑 |
| 摆放 | 与 PLA 版相同（UPPER 使用 r4 旋转矩阵，几何孔位不变） |
| 干燥 | 60–65 ℃ / 4–8 小时（R3D 官方建议，打印前必须干燥） |

参数来源与假设：R3D 官方 PETG 页面给出喷嘴 230–260 ℃、热床 40–60 ℃、风扇 5–40 %、速度上限 300 mm/s、干燥 60–65 ℃ / 4–8 h；Bambu Studio 没有 R3D 官方配置，本包以 Bambu Generic PETG 为基础、取区间内偏保守值（250 ℃ / 60 ℃ / 12 mm³/s / 风扇 10–40 % / 流量 0.95）。首次实打建议先用小件校准流量与温度。

## 各件结果（0.28 mm）

| 件 | 打印时间（预测） | 耗材（含支撑，g） | 三角面数 |
|---|---|---|---|
| 下半主体 H41/B1 | 13.89 小时（13小时53分40秒） | 371.3 g | 414824 |
| 上半集成主体 | 33.43 小时（33小时25分55秒） | 797.2 g | 308868 |
| 可拆操作面板 | 0.97 小时（58分14秒） | 26.8 g | 25456 |

合计：**48小时17分49秒 / 1195.3 g**。面板盖 0.28 mm 比 0.20 mm 快约 4分2秒、多约 1.7 g——面板是外观件，若更在意外观可单独用 0.24/0.20 mm 打（本包未改）。

## 打印注意（PETG）

1. 打印前干燥：60–65 ℃ / 4–8 h；受潮会明显拉丝、发雾。
2. 纹理 PEI 板 + 60 ℃；PETG 粘板很强，建议薄涂固体胶作脱模剂，冷却后再取件。
3. PETG 冷却要弱（10–40 %），悬垂/桥接可能比 PLA 略差；首件先检查支撑接触面。
4. 0.28 mm + PETG 的层纹较明显；需要表面质量时改用 0.24 mm。
5. 拆支撑时带手套，PETG 支撑接触点较硬，可用剪钳沿枝干剪断。

## 包内文件

- `projects/`：三份可直接打开的 PETG 工程 3MF（Bambu Studio 02.08.02.61）
- `checks/`：三件切片/导出校验（含 3MF 内嵌参数逐项断言）、层高候选、选择与发布记录、决定依据
- `preview/`：各件首层/刀路预览 PNG
- `source/`：候选切片脚本、导出/打包脚本、R3D PETG 材料配置
- `SHA256.json`：全部文件校验和

## 声明

- 时间为 Bambu Studio 切片预测，未实物打印；PETG 附着、支撑手感、强度需实机验证。
- 上半件约 33.4 小时，单件 24 小时目标未达，不得宣称"24 小时达标版"。
- 原模型几何/孔位未改：UPPER 沿用 r4 旋转矩阵，三件 `geometry.3mf` 与 PLA 版逐字节一致（见各 checks 记录）。
