Sylphiette666/stm32-rfid-smart-bin/hardware/mechanical/print-backup/wall-panels-fine-20261102/README.md

> 2026-11-03附件修复：光敏旧底座继续用，改装可调L压条；红外对射旧夹座继续用，直压条改为带下托的IR压盖。[只需重打四件的修复工程](../sensor-retainers-fix-20261103/README.md)。本目录整盘文件保留历史；新打印这两类附件采用修复工程，其他零件保持。

# 筒壁精细版：四盘平放，0.16 mm

这是原四盘筒壁的打印参数升级版。四盘全部改为0.16 mm层高；模型尺寸、孔位、附件数量及摆放与原版逐字节一致。使用P2S、0.4 mm喷嘴、PLA和纹理PEI板。

| 盘号 | 打印工程 | 切片预计时间 | PLA |
|---|---|---|---|
| 1：前壁及操作面板 | [P2S_WALL_01_FRONT_CONTROLS_FINE_016.3mf](projects/P2S_WALL_01_FRONT_CONTROLS_FINE_016.3mf) | 9小时24分26秒 | 201.8 g |
| 2：后壁及附件 | [P2S_WALL_02_REAR_FINE_016.3mf](projects/P2S_WALL_02_REAR_FINE_016.3mf) | 6小时23分29秒 | 129.6 g |
| 3：左壁及附件 | [P2S_WALL_03_LEFT_FINE_016.3mf](projects/P2S_WALL_03_LEFT_FINE_016.3mf) | 5小时28分8秒 | 110.1 g |
| 4：右壁及附件 | [P2S_WALL_04_RIGHT_FINE_016.3mf](projects/P2S_WALL_04_RIGHT_FINE_016.3mf) | 3小时45分38秒 | 87.6 g |

四台同时打印，预计最长约9小时24分，总耗材约529.1 g；原普通版最长约7小时20分。实际时间以本机重新切片结果为准。

## 已保存的参数

- 层高0.16 mm；首层0.20 mm。
- 外墙60 mm/s；顶面80 mm/s；内墙150 mm/s。
- 墙层3；15%螺旋体填充；顶底各6层，避免降低层高时壳体随之变薄。
- 外侧裙边2 mm，间隙0.1 mm；需要处自动树状支撑，支撑上下Z间距0.16 mm。
- 树状支撑其余参数沿用原版GitHub来源，见[原始来源记录](../wall-panels-20261102/source/github_support_source.json)。

在Bambu Studio中将3MF作为工程打开，保留项目参数、100%比例及现有摆放，再点击“切片单盘”。这些文件是可编辑工程，未向打印机发送任务。请按实际PLA选择耗材槽位。

本次主要改善层纹和外表面，不代表所有孔径配合误差都会自动消除。装配方法及孔位沿用[原筒壁说明](../wall-panels-20261102/README.md)和同名图解手册66.11节；精细版的打印参数、耗时以本页为准。旧普通版文件保留。

## 校验范围

四个工程的模型及摆放与原版完全相同；原生工程与实测切片使用的模型一致。实际首层15/19/26/4件齐全，所有层的挤出路径在平台内，四张首层检查图已人工查看。checks/settings_diff.json记录全部参数差异。preview内是切片质量核查图，不是新增装配图；本次没有改动Word装配说明。实物打印、元件配合及整机承载尚未由本次参数修改验证。
