Sylphiette666/stm32-rfid-smart-bin/hardware/mechanical/print-backup/motor-adapter-clearance2-final-20261102/README.md

# 左右电机安装支架连接件：最终精细打印版

打印 [P2S_D06_CLEARANCE2_FINAL_PAIR_016.3mf](P2S_D06_CLEARANCE2_FINAL_PAIR_016.3mf)，一盘含左右各一件。P2S、0.4 mm喷嘴、PLA、纹理PEI板，预计1小时9分25秒，约14.78 g。

本版直接沿用用户已确认尺寸合适的clearance2左右件，原生工程内所有模型与试配版逐字节一致。轮子侧槽外壁保持1.3 mm、内侧3.3 mm、穿槽本体宽28 mm、贴电机承托厚3 mm、槽12×2.4 mm、槽中心距21 mm、宽头腔6 mm，孔位和无字贴合面保持。

## 已保存的打印参数

| 参数 | 最终版 |
|---|---|
| 层高 / 首层 | 0.16 / 0.20 mm |
| 墙层 | 4 |
| 填充 | 40%直线 |
| 顶 / 底壳层数 | 各7层 |
| 外墙 / 内墙速度 | 40 / 80 mm/s |
| 顶面速度 | 60 mm/s |
| 外侧裙边 | 2 mm，间隙0.1 mm |
| 支撑 | 关闭，按现有朝向平放 |

作为工程打开3MF，保留项目参数、100%比例和左右两件的摆放，按实际PLA选槽位，重新切片后打印。不要套用旧快速试配配置。拆除外侧裙边后装配；旧试配版保留。其他零件参数不受本次修改影响。

已完成CLI切片、原生工程与受测切片模型比对、与已试配版模型比对、全部挤出路径床内检查、首层两件齐全检查及首层目视检查。未发送打印任务。用户确认的是尺寸配合；1.3 mm薄边的实物承载、耐久性尚未验证，精细参数不能替代载荷测试。

装配继续沿用原安装方法，本次未新增或修改装配图解，Word装配手册不变。preview为打印路径核查图。
