Sylphiette666/stm32-rfid-smart-bin/hardware/mechanical/print-backup/motor-adapter-clearance2-20261102/README.md

# 电机转接座：轮子侧再退让2mm，快速试配第二版

打印 `P2S_D06_CLEARANCE2_QUICK_PAIR_028.3mf`，内含左、右转接座各一件。P2S、0.4mm、PLA，100%比例，按项目原朝向平放。切片估时31分34秒，约9.78g。作为项目打开，重新切片后打印。

这次只进一步缩减照片中靠轮子的槽外壁：左件负Y边、右件正Y边各退让2mm，轮子侧剩余材料由3.3降为1.3mm；朝桶内的另一侧仍为3.3mm。穿槽本体宽度从30改为28mm。1.3mm是塑料材料宽度，不是已测得的轮胎间隙。

两槽12×2.4mm、槽中心距21mm、贴电机承托厚度3mm、宽头腔6mm和四个螺丝耳保持。贴合面无字。原文件保留，此目录为新版。

配置为0.28mm层高、首层0.20mm、2墙、15%直线填充、顶底3层，无支撑、无防翘边，仅用于尺寸试配。1.3mm薄边尚未进行承载验证，不据此直接确认最终承重结构。若轮子装到正常深度仍摩擦，应改安装位置/避让结构，不能靠少插轮轴解决。

检查包括：左右两件有效单实体及封闭网格；槽空腔、槽周保留区域、完整螺丝耳与上一版STEP布尔对照；CLI切片成功且无警告；原生项目几何与受测切片一致；实际首层两件均存在、全路径在床内，圆弧按0.05mm采样检查。已查看网格及首层检查图。没有做实物试装或载荷试验。

本轮是模型及参数修订，未新增装配图解。其他零件使用原有正常质量配置。
