Sylphiette666/stm32-rfid-smart-bin/hardware/mechanical/print-backup/parallel-four-p2s-20261101/README.md

# 四台空闲P2S并行打印剩余主体

**本方案不适用于当前任务。用户已澄清正在打印昨天第二盘（上平台、舵机支架、喇叭圈），请改用[正确的四台补打清单](../parallel-after-old-plate2-20261101/README.md)。下文仅保留“43件附件盘正在打印”这一不同情形的记录。**

1号机继续当前43件附件精细盘，不用停止。下面四份工程分别给另外四台P2S，每份只打印一次；2至5号是便于分工的标签，不是设备序列号。无需等1号机结束。

| 机器 | 打印文件 | 内容 | 件数 | 预计时间 | PLA |
| --- | --- | --- | ---: | --- | ---: |
| 2号 | [P2S_PRINTER_02_BASE_REAR.3mf](projects/P2S_PRINTER_02_BASE_REAR.3mf) | 底板后半片 | 1 | 4小时32分22秒 | 141.8 g |
| 3号 | [P2S_PRINTER_03_BASE_FRONT.3mf](projects/P2S_PRINTER_03_BASE_FRONT.3mf) | 底板前半片 | 1 | 4小时16分18秒 | 141.3 g |
| 4号 | [P2S_PRINTER_04_UPPER.3mf](projects/P2S_PRINTER_04_UPPER.3mf) | 完整上平台 | 1 | 5小时45分1秒 | 205.5 g |
| 5号 | [P2S_PRINTER_05_STAND_SPEAKER_BRIDGES.3mf](projects/P2S_PRINTER_05_STAND_SPEAKER_BRIDGES.3mf) | 舵机支架＋喇叭圈＋3块连接片 | 5 | 2小时54分4秒 | 80.1 g |

四台同时启动，新增任务约 **5小时45分1秒** 全部完成，不必把四台耗时相加；建议先启动时间最长的上平台。整套何时完成，还要取决于1号机附件盘的剩余时间。四台共约568.7 g PLA。

四份分别作为项目打开，检查所选机器是对应的空闲P2S、0.4 mm喷嘴、PLA和纹理PEI板，然后保持工程参数重新切片，逐台发送。不要把四个文件合并成一盘。保持100%比例、原朝向和排布、逐层打印、标准100%速度；开启调平，检查首层后再离开。

主体保持0.24 mm层高、首层0.20 mm、4墙、30% gyroid、顶底7层/最小1.6 mm、外墙60/内墙100 mm/s。大板居中平放，所有工程的外侧防翘边增为5 mm、间隙0；自动支撑和擦料塔关闭。Generic PLA喷嘴220℃、纹理PEI 60℃，实际耗材和板型必须一致。保留喷嘴缠料检测关闭，相机炒面检测可开。正在打印的附件工程仍是0.16 mm，不能用本版参数覆盖它。

本版只重新分盘和移动XY位置，零件网格形状、尺寸和打印朝向不变。底板仍按已允许的原尺寸拼接方案，用两个平放半片和三块连接片组装；上平台整片平放。四台8件加正在打印的43件正好51件，没有重复附件。后续不要再打印旧body-after-accessories三盘或flat-split全量三盘。

底板连接五金和装配见[原尺寸拼接说明](../flat-split-20261101/README.md#底板如何拼接)：新增12颗M3×16低圆头螺钉、24片外径≤6 mm且厚0.5 mm垫圈、12颗高4 mm M3防松螺母。先拼接，再装PCB；夹具五金另计。

四项实际切片返回0且无警告；原生工程与受测模型一致、不含G-code。已核对8件直接贴床，首层模型和防翘边均在床内，43件附件未重复。尚未实物打印、承重或寿命验证。
