Sylphiette666/stm32-rfid-smart-bin/hardware/mechanical/print-backup/accessories-fine-20261101/README.md

# 现在可打印：原第一盘附件精细版（已去掉底板）

打开 [P2S_ORIGINAL_PLATE1_NO_BASE_FINE_016.3mf](projects/P2S_ORIGINAL_PLATE1_NO_BASE_FINE_016.3mf)，选择作为项目打开，保留原排布、100%比例和逐层打印。

来源为mounted-20261031两盘版的第一盘。只移除了P01_BASE_WITH_CRADLE，即底板及全部相连斜撑；余下43件的网格、摆放和比例与原第一盘一致。保留舵机托片与模块夹具；不含上平台、舵机支架、喇叭圈，以及后来新增的三块底板拼接连接片。

参数已经保存：P2S 0.4 mm，Generic PLA，层高0.16 mm/首层0.20 mm，外墙40/内墙80 mm/s，4墙，30% gyroid，顶底10层/最小1.6 mm。3 mm外侧防翘边、间隙0，自动支撑和擦料塔关闭，逐层打印；保留喷嘴缠料检测关闭，相机炒面检测可开。纹理PEI 60℃、喷嘴220℃；按实际耗材和板型核对，标准100%速度。没有改变孔径、卡座尺寸或XY补偿；更细层高改善层向细节，不保证实际孔径公差。

实际P2S CLI切片：9小时17分42秒，约84.3 g PLA，43件，返回0、无警告。实际首层43件都在床内；原生项目与受测几何一致，不含G-code。尚未进行实物打印验证。

工程只有一盘，重新切片后发送。打印这些附件后，后续底板拼接任务应使用“主体补打”工程，避免把同样的附件再打印一遍。
