Sylphiette666/stm32-rfid-smart-bin/hardware/mechanical/print-backup/motor-adapter-20261101/fine-016/README.md

# 电机座精细打印版

打印 P2S_D06_ADAPTER_PAIR_FINE_016.3mf，作为项目打开，保持100%尺寸和现有朝向，重新切片。两件同盘预计1小时16分6秒，16.93g PLA。层高0.16mm、首层0.20mm，外墙40mm/s、内墙80mm/s、顶面60mm/s；4墙、40%填充、顶底7层。无需支撑。

模型、孔槽、3mm配合面、6mm宽头空间和安装方式与原版完全一致，只调整打印精细度；不代表尺寸精度或强度已实测。原0.28mm版约46分30秒，新版多约30分钟。

安装仍看上级目录README及手册66.10。无需新增电子元件；两座需要8颗M3×20低圆头螺栓、16片外径不超过6mm厚0.5mm垫圈、8颗约4mm高M3锁紧螺母；已有符合规格的可以复用。电机位置和离地高度会改变，需完整轮组试摆确认，再决定底板孔位和万向轮垫高。尚未承重或行驶验证。
