Sylphiette666/stm32-rfid-smart-bin/hardware/current-low-cost/WIRING.md

# 当前低成本方案接线表

对应2026年10月12日A1：复用已购直插件与外置MCP23017成品模块，100×100mm双层裸PCB自行焊接，替代原PWR/IO两块洞洞板。完整图解以[同名Word最新版](../../docs/manual/STM32与RFID智能移动垃圾桶_逐步组装与调试实施手册_图解增强版.docx)第63章、图45—49为准，原330步骤不重编；上电次序见[组装手册](../../docs/manual/ASSEMBLY.md)。

接口的每一针以[A1逐针表](pcb-a/connector-map.csv)和[原理图](pcb-a/kicad/)为准，器件位号以[A1 BOM](pcb-a/manufacturing/bom.csv)为准；下表的MCU功能保持原分配。旧[PWR/IO孔位及142条焊线](perfboard/)仅归档，不在新PCB上照抄。所有商品模块按信号名核线，不能整排按自定义接口盲插。

## A1接口索引与跳帽

| PCB接口 | 用途 | 接线要点 |
| --- | --- | --- |
| J1—J6 | BAT_SW、BUCK_IN、BUCK_OUT、MOTOR、SERVO、LOGIC | 六组大电流端子，1脚正端、2脚GND；保险、总开关、降压在板外。 |
| J7 / J8 / J9 | 外设3.3V稳压 / 核心PA组17针 / 核心PB组16针 | J7为IN/GND/OUT；J8包含核心5V、GND、3V3参考，J9含共地。 |
| J10 / J11 / J12 | MCP总线5针 / GPA0—6 / GPB0—6 | 合计19线；A7/B7不接且软件输出0。 |
| J13—J18 | OLED、MPU、RC522、FLASH、HC-05、电脑串口 | RC522与FLASH共SPI三线但独立片选；USB串口VCC不接。 |
| J19 / J20 / J21 | TB6612控制 / 舵机信号 / HC-SR04 | 动力电源另走J4/J5；J20的地不承担舵机主电流。 |
| J22 / J23 | DHT接口 / 外置双向电平转换 | 5V DHT必须开JP8并经外置BSS138适配。 |
| J24—J27 | 编码器 / MODE、BACK、闭盖 / 碰撞 / 双NC急停 | J27带VBAT_SW，不能作为普通GPIO按钮接口。 |
| J28 / J29 / J30 | AO裸管焊转接后G/S/D / LED / 蜂鸣模块 | AO适配板物理针序须实测；蜂鸣供电与输入分别选择。 |
| J31 / J32 / J33 | DFPlayer信号 / 光敏 / 红外输入汇总 | DFPlayer电源另从J6取；5V DO需模块外电平处理。 |

| 跳帽 | 默认及可选状态 | 禁止情况 |
| --- | --- | --- |
| JP3 BUZZ_SIG | 默认开；1—2=PB9直通，2—3=AHCT的5V缓冲 | 不能同时短两组，也不能外部并联PB9与缓冲输出。 |
| JP4 BUZZ_VCC / JP5 MPU_VCC / JP6 HC05_VCC / JP7 DHT_VCC | 默认开；各自1—2为3V3_EXT、2—3为5V，按实物供电额定选择 | 不知道模块供电额定值时不放帽；不可把两电源短接。 |
| JP8 DHT_DIRECT | 默认开；仅3.3V DHT分支可闭合 | 5V DHT使用J23+BSS138，JP8保持开路。 |
| JP9 ADC_LINK | 正常使用闭合；分离核心电源而电池仍有电时先断开 | 两针是分压输出/PA1，绝不是旧洞洞板ADC/GND接口。 |
| JP10 MCP_RESET | 正常开路；短时接地复位后移走 | 不永久装帽，不接核心NRST。 |

只有以上8组JP3—JP10，没有JP1/JP2。DNP表示此位置先不装；R8/R9、R13/R14、R27/R28、R29、R33按模块已有上拉选择，避免重复或跨两路3.3V互馈。蜂鸣偏置R36默认装、R37默认不装，实际高/低有效只能保留其中一只。

## 电气装配总则：先做可测的小系统

| 线束/支路 | 推荐线材 | 落地要求 |
| --- | --- | --- |
| 电池→保险→总开关→降压输入；5 V 主干 | 20 AWG 多股铜线，短距离；已有 18 AWG 可用 | 不走面包板或细杜邦线；正负成对走线；尽量靠近底板。 |
| 单电机、舵机支路 | 22 AWG 短线；较长或电流偏大用 20 AWG | 电源和地一起从配电点分出，不串经核心板。 |
| 传感器和逻辑信号 | 26 AWG 或套装杜邦线 | 首版 I²C/SPI 线尽量 ≤20 cm，固定后留维修余量，不拉紧。 |
| SG90 延长线 | JR 3P 2.54 mm 公对母 30 cm，22 AWG | 通断测试确认三根线直通，电源/地/信号不交叉。 |
| 端子 | KF301-2P，5.08 mm 孔距，侧面进线 | 先确认已购端子脚距与A1封装及壳体外形相容；螺丝一字或十字不改变电气功能。 |

## A1 PCB电源区：电池、保险、开关、降压与去耦

| 节点 | 接到哪里 | 实测目标/备注 |
| --- | --- | --- |
| BAT+ | 电池正极→5×20 保险座→总开关输入 | 保险座尽量靠近电池。F1 先装 3 A；最终需结合启动电流及保险曲线确认。 |
| VBAT_SW | 总开关输出→降压 IN+；另引细线到电压采样和急停接点偏置 | 总开关闭合时等于电池电压；关闭时消失。 |
| BAT−/GND | 电池负极→降压 IN−、OUT−和地汇流端 | 使用常见非隔离降压板时为共地；先按模块资料核对。 |
| 5V_BUS | 降压 OUT+→三条独立 5 V 支路 | 空载调 5.00 V；本项目带载验收目标 4.85–5.15 V。 |
| 5V_MOTOR | 5V_BUS→TB6612 VM | 驱动附近 470 μF/16 V 低阻电解＋100 nF。 |
| 5V_SERVO | 5V_BUS→SG90 红线 | 接口附近 1000 μF/16 V 低阻电解＋100 nF。 |
| 5V_LOGIC | 5V_BUS→核心板 5V、语音/超声等 | 入口 100 μF/16 V＋100 nF，分配给独立 3.3 V 稳压模块。 |
| 3V3_EXT | 3.3 V 模块输出→外设 3.3 V 母线 | 目标 3.20–3.40 V；能力至少 200 mA；实际总负载另测。 |
| 3V3_CORE | 核心板自带稳压输出 | 只作核心板参考和少数 MCU 输入上拉；不与 3V3_EXT 直接相连。 |

A1用J1 BAT_SW、J2 BUCK_IN、J3 BUCK_OUT、J4 MOTOR_PWR、J5 SERVO_PWR、J6 LOGIC_PWR六组5.08mm大电流端子。电池正极经板外保险和总开关进入J1，J2接板外降压输入；已调好5.00V的降压输出接J3，J4/J5/J6分别去电机、舵机、逻辑支路。每组1脚为标识正端、2脚为GND，接线前仍核PCB丝印及新CSV。J7仅接外置3.3V稳压模块IN/GND/OUT，不能承担动力电流。PCB铜箔已完成配电，不再焊旧洞洞板V3/X3等汇流线。板外电池和降压主干用20AWG，电机/舵机短支路用22AWG，较长或电流偏大用20AWG；不得使用细杜邦线或面包板承担电池、电机、舵机主电流。

5V_MOTOR、5V_SERVO、5V_LOGIC是5V_BUS的三条用途分支，电气同网；动力回流直接回配电区。3V3_EXT和3V3_CORE为不同稳压输出，不并联。PCB设计采用0.20mm间距、0.30mm常规/局部0.25mm信号、0.8/0.4mm过孔、3mm主干和2mm电源分支；实物仍须做分级带载、压降及温升验收。

## STM32 核心板、SWD 与电脑串口：建立最小系统

| MCU 端口 | 本版连接 | 配置/保留条件 |
| --- | --- | --- |
| PA0 / PA1 | SG90 信号经 AHCT 缓冲 / 电池 ADC | TIM2_CH1；ADC1_IN1，模拟输入。 |
| PA2 / PA3 | HC-05 RX / TX | USART2；本机 TX 接对方 RX。 |
| PA4 / PA5 / PA6 / PA7 | RC522 CS / SPI SCK / MISO / MOSI | SPI1 默认映射；FLASH 共享后三根。 |
| PA8 / PA11 | TB6612 PWMA / PWMB | TIM1_CH1/CH4，20 kHz；禁止 USB。 |
| PA9 / PA10 | 电脑串口 RX / TX | USART1，115200；不用硬件流控。 |
| PA12 / PA15 | 对射输出 / FLASH CS | PA12 每 1 ms 轮询，不能占 EXTI12；PA15 释放 JTAG。 |
| PA13 / PA14 | SWDIO / SWCLK | 永远保留下载。 |
| PB0 / PB1 | 光敏 AO/DO / 超声 ECHO 分压 | ADC1_IN8 或普通输入；PB1 EXTI1 双边沿。 |
| PB2 / PB3 / PB4 | BOOT1 保留 / 编码器 CLK / DT | PB3/4 释放 JTAG，GPIO 轮询或 EXTI3/4。 |
| PB5 / PB6 / PB7 | 电机使能请求 / I²C SCL / SDA | PB5 经本章急停门控；I²C1 默认脚。 |
| PB8 / PB9 | 前方障碍 DO / 蜂鸣器 IN | PB8 输入；PB9 GPIO 或 TIM4_CH4。 |
| PB10 / PB11 | DFPlayer RX / DHT11 DATA | USART3 只开 TX；不得启用 USART3 RX。 |
| PB12 / PB13 / PB14 / PB15 | 碰撞回路 / 急停反馈 / 闭盖 / 超声 TRIG | PB12 EXTI12；PB13 EXTI13；PB14 输入；PB15 普通推挽经 AHCT。 |
| PC13 / PC14 / PC15 / NRST | 保留 LED/晶振/复位 | 不再分配外设，NRST 不从另一路 3.3 V 强上拉。 |

A1 PCB的J8（CORE_PA，17针）与J9（CORE_PB，16针）是本项目自定义线束接口，不是核心板商品排针次序，不能整排直插。J8.1接核心5V、J8.2接GND、J8.3接核心3V3参考；J9.1也接GND，其他针逐项按新connector-map.csv接同名MCU端口。PA1已由PCB采样电路经JP9接到J8.5，SPI三线也已纳入J8；SWD仍直接接核心PA13、PA14和GND。J8.3的3V3_CORE不得与3V3_EXT相连。整机正常运行禁止插核心USB；要做核心独立USB台架测试，先断电并拆掉本PCB与核心之间的全部线束。旧洞洞板JCORE无5V的说明不适用于A1。

## A1信号区：MCP23017、I²C 上拉与 OLED

本次继续复用已焊好的MCP23017成品模块，模块外置。A1的J10五线接3V3_EXT、GND、SCL、SDA、RESET；J11七线分别接GPA0—GPA6，J12七线分别接GPB0—GPB6，共19根线。必须按商品模块信号名逐根接线，不能把PCB针序当作模块排针顺序。A0/A1/A2在模块侧接地，INTA/INTB不接；GPA7、GPB7留空且软件配置输出0，不再用作输入。RESET仅经R10上拉3V3_EXT，JP10为临时接地复位点，平时开路；不并接核心NRST。PCB已将14路功能线分配到相应接口，不再按旧JMCP方案逐根跨接模块输出。

| MCP23017 端子 | 接线 | 说明 |
| --- | --- | --- |
| VDD / GND | 3V3_EXT / GND | 引脚附近 100 nF；模块已有去耦也需确认。 |
| SCL / SDA | PB6 / PB7 | SCL、SDA 各一组有效上拉至 3V3_EXT。 |
| A0 / A1 / A2 | 全部 GND | 7 位地址 0x20。 |
| RESET | 10 kΩ 上拉 3V3_EXT；另留一只复位短接点到 GND | 本版不直接并到核心 NRST，避免两路稳压经上拉互馈；每次 MCU 开机重新写寄存器。 |
| INTA / INTB | 暂不接 | 本版扩展输入使用定时轮询。 |
| GPA0 / GPA1 / GPA2 / GPA3 | AIN1 / AIN2 / BIN1 / BIN2 | 输出初值全低。 |
| GPA4 / GPA5 / GPA6 / GPA7 | RC522 RST / 灯 MOS G / DFPlayer BUSY / 留空 | GPA6 为输入；GPA7 输出 0。 |
| GPB0 / GPB1 / GPB2 / GPB3 | 循迹左 / 中 / 右 / 靠近 DO | 都为输入，电平先适配。 |
| GPB4 / GPB5 / GPB6 / GPB7 | 编码器 SW / MODE / BACK / 留空 | 前三路按下接地；GPB7 输出 0。 |

## 输入电平适配：完成传感器后再接 MCU

A1只集成已经确定的通用电路。实际为5V数字DO的NPN适配仍在模块侧或独立绝缘小接线片完成，不能直接插到J33输入；DHT的5V分支用外置BSS138开漏双向适配，5V模拟AO不套用数字NPN。PCB已有MODE/BACK的R34/R35上拉、编码器SW可选R33以及蜂鸣R36/R37偏置；MCP、DFPlayer远端去耦仍在各模块附近核实，不能用远处板上电容替代。

| 实物输出情况 | 明确接法 | 软件记录 |
| --- | --- | --- |
| 3.3 V 供电且 DO 电平为 0/3.3 V | DO 可直接进指定输入，必要时串 1 kΩ保护；共地 | 记录触发为高或低，统一归一为 triggered=true。 |
| 开集电极/开漏，板上没有接到5V的上拉 | DO→输入；10 kΩ 从 DO 上拉到 3V3_EXT | 记录传感器导通时代表遮挡还是畅通。 |
| 模块需5V且DO高电平/板上上拉为5V | DO→10 kΩ→2N3904 B；B→100 kΩ→GND；E→GND；C→目标输入；C以10 kΩ拉3V3_EXT | 这个适配会反相；模块DO高→MCU输入低。模块DO低→MCU输入高。 |
| HC-SR04 ECHO | 固定12 kΩ串联上臂、20 kΩ接地的分压 | 保持脉宽极性，不使用上行反相电路。 |
| 模拟AO信号 | 优先3.3V供电且AO≤3.3V；5VAO按量程另分压并校准 | 禁止把模拟AO接入上述开关三极管后再声称测模拟量。 |

## 编码器上拉

确认编码器模块可用3.3V，接A1的J24：VCC→3V3_EXT、GND→GND、CLK→PB3、DT→PB4、SW→GPB4。CLK/DT上拉只选一种：移除模块已有上拉后装PCB的R27/R28各10kΩ到3V3_CORE；或保留已确认拉3V3_EXT的模块上拉、不装R27/R28。两者不能同时装，以免两路稳压经上拉互馈；空闲和旋转电平必须实测。SW可装R33=10kΩ到3V3_EXT，若模块已有等效上拉则不重复。旧洞洞板的R22/R23位号不再用于这里。

## 急停按钮：2S 偏置＋三管硬件钳位

| 新增件 | 数量 | 用途 |
| --- | --- | --- |
| 2N3904 TO-92 NPN三极管 | 3只，另备1只可选 | QES1接收NC1、QES2钳位STBY、QES3接收NC2；按实际厂家脚图辨E/B/C。 |
| 4.7 kΩ，1/4 W | 3只 | R_ES1/R_ES2为两接点基极限流；R_ES3为QES2基极上拉。 |
| 100 kΩ，1/4 W | 3只 | QES1、QES2、QES3各一只B-E下拉。 |
| 1 kΩ，1/4 W | 1只 | PB5→STBY限流，允许QES2硬件拉低。 |
| 10 kΩ，1/4 W | 3只 | STBY下拉、PB5下拉、PB13上拉核心3V3。 |
| 2NC保持型红蘑菇急停按钮 | 1只 | 两常闭触点独立；按下保持、旋转释放，触点规格有依据。 |
| A1 J27和PCB急停区标签 | 1组 | 分开标识VBAT_SW、3V3_EXT、3V3_CORE，避免把电池电压接到GPIO。 |

| 接线节点 | 必须焊到的点 | 正常/按下的结果 |
| --- | --- | --- |
| NC1上端 | VBAT_SW | 总开关后电池电压，不能接5V或GPIO。 |
| NC1下端 | R_ES1 4.7k→QES1 B | QES1 B另经100k到GND，QES1 E→GND。 |
| KILL_BASE | QES1 C、QES2 B；R_ES3 4.7k到3V3_EXT；100k到GND | NC1闭合→低→QES2关；NC1断开→约0.7V→QES2开。 |
| STBY_OUT | QES2 C、TB6612 STBY、10k到GND；PB5经1k到此点 | QES2 E→GND。正常跟随PB5；急停钳低。 |
| PB5端 | PB5→1k→STBY_OUT；PB5另10k到GND | 复位时默认低；不能绕过1k直连STBY_OUT。 |
| NC2上端 | VBAT_SW | 与NC1为不同独立触点。 |
| NC2下端 | R_ES2 4.7k→QES3 B | QES3 B另100k到GND；QES3 E→GND。 |
| ESTOP_SENSE | QES3 C→PB13；10k上拉3V3_CORE | 正常=0；按下/断线=1。 |
| 共地 | QES1/2/3 E、电池地、驱动地、核心地 | 这不是隔离接口，所有地按规定汇合。 |

A1的Q1/Q2/Q3分别对应原说明QES1/QES2/QES3；限流、偏置按R15—R24及原理图定位。接点电池偏置按6.0—8.4V设计，仍需核已购2NC触点的最小负载。此硬件钳位依赖3V3_EXT：若外设3.3V消失而MCU仍有电且PB5为高，不能宣称已保证硬件失效安全。正常启动/失联应使PB5与PWM为0，异常时用总开关切电；本课设不声明工业安全等级。

## SN74AHCT125N：统一装好舵机与超声触发电平缓冲

| DIP-14 引脚 | 接线 | 作用 |
| --- | --- | --- |
| 14 VCC / 7 GND | 5V_LOGIC / GND；14和7附近并100nF | 5V供电，TTL兼容输入。 |
| 1 /OE1 / 2 A1 / 3 Y1 | GND / PA0 / SG90信号线 | 通道1把3.3V舵机PWM转5V。 |
| 4 /OE2 / 5 A2 / 6 Y2 | GND / PB15 / HC-SR04 TRIG | 通道2把触发脉冲转5V。 |
| 9 A3 / 10 /OE3 / 8 Y3 | PB9 / GND / BUZZ_5V至JP3.3 | A1第三通道固定启用；是否接蜂鸣器由JP3选择，不另改铜线。 |
| 12 A4 / 13 /OE4 / 11 Y4 | GND / 5V_BUS / 不接 | 仅第四通道禁用，输出不接地。 |
| PA0 / PB15 输入端 | 各加10kΩ到GND，若已有同等下拉不重复 | MCU复位时避免缓冲器输入悬空。 |

A1三线蜂鸣模块接J30；JP4先按模块额定电压选择VCC。已确认兼容3.3V控制时，JP3短接1—2；需要5V控制时，JP3短接2—3。不能两处同时短接，也不能把两种控制输出并联。U1第9脚已固定接PB9、第10脚已接GND；A1没有JP1、JP2，不执行旧洞洞板“五拆六增”。PB9偏置只装一只：高有效装R36=10kΩ下拉、R37不装；低有效改为R36不装、R37=10kΩ上拉3V3_CORE。即使暂不接蜂鸣器，也保留一种偏置，避免AHCT输入悬空。先验收上电、复位和软件关闭时不响。

### 归档：旧洞洞板AHCT通道3改线（A1不执行）

仅对旧双洞洞板，三线蜂鸣模块明确需要5V控制输入时，按历史图解Word第61.8节启用AHCT通道3；拔电池、USB和调试器供电，断开外部模块并取下AHCT芯片后再改接。必须清除第9脚G9和第10脚G8的全部原连线，不能只拆各一根线。裸两脚蜂鸣器仍需另加已核电流能力的驱动级，不能直接接GPIO。

五拆：拆除IO-W005（D10→G9）、IO-W010（G9→G12）、IO-W011（G9→G6）、IO-W038（A21→G8）、IO-W041（G8→G5）。前3条是GND，后2条是5V_LOGIC；G9/G8原来兼作分线节点，不能只断开芯片腿而留下不明支线。

六增的前3条用于恢复旁路供电：D10→G12、D10→G6恢复GND；A21→G5恢复5V_LOGIC。这3条必须补回，以免R1下拉、未用第4通道输入和芯片供电支路断开。

六增的后3条用于通道3：G8→D10（第10脚/OE3接GND）、G9→核心PB9（第9脚A3输入）、G10→蜂鸣模块IN（第8脚Y3输出）。全部使用绝缘线，只有端点焊接；PB9继续按模块不响电平设置约10kΩ偏置，高有效下拉GND、低有效上拉3V3_CORE，不把PB9上拉到5V。

改后先不插AHCT、不接外部模块：核G9与原GND、5V_LOGIC无直连，G8仅并入GND，G5/G4仍通A21，G12/G6仍通D10，5V对地无持续短路；再插芯片，限流上电测PB9低/高与8脚输出，确认复位不响。默认四幅板图及142条连线记录保持原版；采用此选配者须在自己的施工记录划销上述5条并登记新增6条，不再逐条照默认图复接。逻辑连通检查不代替实焊通电验收。

## TB6612、轮电机与SG90：先架空，再装机械负载

A1的SG90接线：红线从J5的5V正端取电，棕/黑线直接回J5的GND；橙/黄/白信号线按实物确认后接J20.1 SERVO_SIG_5V（U1第3脚Y1）。J20.2只提供信号地参考，不能承担舵机主电流。PA0只进AHCT第2脚，不另直连舵机信号。先拆连杆空载50Hz、1500μs验证，再继续原标定步骤。旧IO的JACT/X9孔位不适用于A1。

| 驱动端子 | 目标线 | 说明 |
| --- | --- | --- |
| VM / VCC / GND | 5V_MOTOR / 3V3_EXT / GND | VM是电机电源；VCC是逻辑电源。 |
| AIN1 / AIN2 / BIN1 / BIN2 | GPA0 / GPA1 / GPA2 / GPA3 | 方向输出全部低为上电初值。 |
| PWMA / PWMB | PA8 / PA11 | 20kHz硬件PWM。 |
| STBY | 急停接口STBY_OUT | 不直接再跨一根PB5跳线。 |
| AO1/AO2 | 左电机两端 | 镜像安装后的正反方向通过测试确定。 |
| BO1/BO2 | 右电机两端 | 与左电机分开成对走线。 |
| 每只电机端子 | 100nF跨两电机端 | 陶瓷电容短脚焊，避开转轴与齿轮。 |

## 照明MOS、蜂鸣器与DFPlayer语音

A1 PCB已集成R3=100Ω栅极串联、R4=100kΩ栅极下拉、R5=220Ω LED限流。MCP的GPA5经J11.6进入板内，AO3400A转接板的G/S/D分别接J28.1/J28.2/J28.3，LED正/负分别接J29.1/J29.2。已购AO3400A是SOT-23裸管，须先焊到已有转接板，断电追踪转接板每个焊盘到G/S/D的导通后再接线并独立绝缘固定，不假定转接板排针顺序。旧PWR的RP3/RP4/RP5及JP10/JP11/JP12只用于归档图。

| 元件 | 逐端连接 | 说明 |
| --- | --- | --- |
| AO3400A 1脚G | GPA5→100Ω→G；G→100kΩ→GND | 栅极下拉确保复位关灯。 |
| AO3400A 2脚S / 3脚D | S→GND；D→LED负极 | 脚号据AOS原厂SOT-23资料；转接板排针次序需导通追踪。 |
| LED正极 | 5V_LOGIC→220Ω→LED正极 | 白LED目标几mA至约10mA，必须有串联限流。 |
| 蜂鸣模块VCC/GND/IN | 按模块额定电压供电；GND共地；IN→PB9或条件缓冲输出 | 先核有源/无源、是否自带晶体管、有效电平。 |
| DFPlayer VCC/GND | 5V_LOGIC / GND | 附近加100μF和100nF，避免播放电流使系统复位。 |
| DFPlayer RX | PB10→1kΩ→RX | USART3仅TX，9600 8N1，模块TX暂不接。 |
| DFPlayer BUSY | GPA6，测到为3.3V或开集输出后连接 | 若板输出5V则按NPN适配并在软件反相；不默认所有兼容板一致。 |
| DFPlayer SPK1/SPK2 | 分别接同一只扬声器两端 | 桥接输出，两端均不能接GND；首版8Ω/1W扬声器、小音量。 |

## A1电池ADC

A1 PCB使用R1=33kΩ、R2=10kΩ、C7=100nF：VBAT_SW→R1→BAT_ADC_DIV，该节点经R2和C7分别到GND；R1/R2用1%。JP9闭合后，BAT_ADC_DIV送PA1（J8.5），8.4V电池时约1.95V。新JP9是两针采样断开跳帽，两针分别为分压输出与PA1，不是旧PWR的ADC/GND两针接口。电池仍接通而要单独关闭或拆核心电源时，先拔JP9，避免经PA1反向灌电；恢复前断电核线。电气比例和采样算法不变，线束远离电机线。

## 已有备用模块的安排：不增加隐蔽接线

| 现有配件 | 本机安排 | 需要实验时如何使用 |
| --- | --- | --- |
| 大型教学底板、数码管、点阵、矩阵键盘 | 保存原状，不与成品核心同时连线 | 把核心拔回教学板前，先断开成品所有排线和电池；回到教学实验程序。 |
| 单路红外寻迹模块 | 备用、黑白反射标定样件 | 单模块台架时可临时占GPB0测试，完成后断电换回三路循迹左通道；成品不能同时并接两个DO输出。 |
| 热敏传感器模块 | 备用温度实验，不作为主温湿度计 | 实验时断开光敏PB0后，确认3.3V供电和AO范围再接PB0；要显示温度须按实际NTC阻值/β值校准，成品恢复光敏。 |
| 套装直流风扇电机＋扇叶 | 备用驱动实验，不替代减速轮电机 | 如演示驱动，卸下扇叶或加护罩，断电换下某一路轮电机后接该路短时台架测试；不与轮电机并联。 |
| 面包板和长杜邦线 | 用于低电流信号原型 | 电机/舵机/电池主电流不通过它；调通后按A1 PCB接口收束。 |
| ARM仿真器、USB线 | 下载和调试复用 | 仿真器接SWD；核心USB不用；电脑串口板由其USB线连接电脑。 |

## 最终接线验收、线束收束与全机带载检查

| 最终测点 | 正常预期 | 实测填写 |
| --- | --- | --- |
| 5V_BUS/5V_SERVO/5V_MOTOR | 约5V，项目带载目标4.85–5.15V | ____ V / ____ V / ____ V |
| 3V3_EXT / 3V3_CORE | 约3.3V，二者不直接并联 | ____ V / ____ V |
| PB5=0时STBY_OUT | <0.3V | ____ V |
| 急停释放且PB5=1时STBY_OUT | 典型约3.0V，验收>2.7V | ____ V |
| 急停保持按下且PB5=1时STBY_OUT | <0.3V | ____ V |
| PB13正常/按下 | 低/核心3.3V | ____ V / ____ V |
| PA1在电池8.4V时 | 约1.95V | ____ V |
| US_ECHO节点 | 5V输入时约3.125V | ____ V |
| I²C空闲SCL/SDA | 均约3.3V | ____ V / ____ V |
| 满载运行30min | 记录故障与温升，不预填通过 | 记录文件：____________ |
