Sylphiette666/stm32-rfid-smart-bin/hardware/mechanical/print-backup/checks/bambu_cli_notes.txt

[2026-10-30 17:46:12.608543] [0x0000abe0] [trace]   Initializing StaticPrintConfigs
[2026-10-30 17:46:12.618530] [0x0000abe0] [warning] cli mode, Current BambuStudio Version 02.08.02.61
[2026-10-30 17:46:13.500848] [0x0000abe0] [warning] no filament colors found in projects
[2026-10-30 17:46:15.866686] [0x00003058] [warning] tree support default to organic support
[2026-10-30 17:46:15.866686] [0x0000abe0] [warning] tree support default to organic support
[2026-10-30 17:46:15.866686] [0x0000aa24] [warning] tree support default to organic support
[2026-10-30 17:46:15.866686] [0x00006214] [warning] tree support default to organic support
[2026-10-30 17:46:19.799868] [0x0000abe0] [error]   Invalid T command (T65535).
