Sylphiette666/stm32-rfid-smart-bin/hardware/current-low-cost/pcb-a/review/07-final-manufacturing-review.md

# SmartBin_A A1 最终独立制造审阅

结论：**数字制造检查通过，文件层面未发现短路、漏连或钻孔错配；四套技能复查仍保留地回流和去耦布局限制，见 `four-skills/四套技能联合审查报告.md`。** 本结论针对下列冻结文件，属于设计及制造数据审查，不代表实物已装配、已通电或 33 项功能已由固件全部实现。

| 文件 | SHA-256 |
|---|---|
| `kicad/SmartBin_A.kicad_pcb` | `a7423fc37ea90df6079c1efc811024454c0423cb86c682edda9411fff4a9531a` |
| `manufacturing/Gerber_RS274X.zip` | `fe6e2326e9f386d1d61bb4a39691f18acd81a0e23232bfc711ad509c4ede470a` |

审查日期：2026-10-12。KiCad 10.0.6。独立原生 API 只读检查未保存、重填或改动 PCB；另用 gerbonara 1.6.3 直接解析最终压缩包，并查看输出的双面 CAM 图。

## 1. 网表和保护电路

- 94 位号、值、封装以及全部电气焊盘网络与 `circuit.json` 完全匹配。U1.11 明确未接，四个安装孔不属于电气端点。BOM 含 94 板上位置及 1 行 U1_SOCKET 附件；芯片和插座各一只，没有把插座列成第二颗芯片。
- 最终 `checks/pcb-drc.json` 采用本次接地加强版重新运行的报告，违规、未连接和原理图一致性问题均为 0。未使用豁免警告通过验收。工程所忽略的庭院缺失、走线端点未居中过孔、调谐参数、封装过滤和封装类型提示见该报告；独立实物包络、孔距及走线核对补充了其局限。
- 急停 Q1/Q2 的硬件 STBY 钳位、Q3 的辅助反馈、上电偏置、AHCT 未用路固定电平及输出悬空、R36/R37 唯一偏置、两路 3.3V 域分离，沿冻结电气定义保持正确。完整电气审计见 `02-structured-audit.json` 与 `03-electrical-review.md`。
- 接口板仍要求使用外部保险、总开关、合适的 2S 电池保护、稳压模块和正确的模块电平适配。EXT 电源失效的边界、急停后的故障锁存，以及 STBY 停机并非主动刹车，均沿用手册约束；本版不是经过安全认证的急停系统。

## 2. 铜层、电源路径和间距

| 项目 | 独立核对结果 |
|---|---|
| 板框 | 中心线 100×100mm、闭合 4 边；Gerber 包含 0.1mm 描边时外包络 100.1×100.1mm |
| 叠层 | 2 层铜、1.6mm 板厚；下单铜厚 1oz |
| 动力走线 | 原规划 33 段逐段以共线区间并集核对，全部完整保留且不低于原宽度；干线 3mm、支线 2mm |
| 信号和逻辑支路 | 0.25/0.30mm 信号，部分 0.5/0.8mm 逻辑电源线；未把全网最细逻辑分支误作动力干线 |
| 铜到板边 | 保守最小 0.5185mm；双面 GND 区边界距边 0.7mm |
| 过孔 | 117 个（新增55个GND过孔），外径 0.8mm、钻孔 0.4mm |
| 导通 | 最终 DRC 0 未连；所有动力路径不依赖一根细信号线或单个换层过孔 |

实际顶层、底层铜图中，左侧 VBAT/5V 粗铜与 GND 回路保持连续；未发现动力干支路被自动布线替换或缩成细颈。逻辑端点的小支线不承担电机和舵机主电流。八个设置为不直接接灌铜的 GND 焊盘为 J7.2、J17.2、J25.2、J25.6、J30.2、J24.2、J9.1、J22.2，均为逻辑接口；它们已有显式走线，无动力端子受到此设置影响。

C1/C4、C2/C5、C3/C6 位于各动力/逻辑供电连接器附近，C8 位于 U1 VCC 附近并使用 0.8mm 本地供电线。C7 的电池 ADC 滤波网络连接正确。外部模块线长和实际开关噪声仍须通电测试。

0.20mm 设计间距、0.25mm 最小信号宽度、0.8/0.4mm 过孔和上述板边距离，处于嘉立创普通双面板公布的制造能力范围内；这不是对载流量或温升的实测保证。[嘉立创 PCB 工艺能力，2026-10-12 核对](https://www.jlc.com/portal/1/serviceGuide)

## 3. 封装、孔和手焊可实现性

- J1–J6 均旋转 -90°，3D 中进线口朝左板边；库几何为 Phoenix MKDS，孔距 5.08mm、钻孔 1.3mm、包络约 11.22×11.125mm。名为 KF301 的现有端子必须量实物外形、引脚及工具空间，不要求更换为 Phoenix 品牌。
- C1–C3 均留出 D12.5/P5 外形；DIP14 插座、轴向电阻、TO-92 和 2.54mm 排针按名义包络没有明显相撞，手焊空间可用。TO-92 必须按所购件 E/B/C 脚序确认，不能只看平面。
- 钻孔逐个匹配：411 个 PTH（其中 117 个过孔）以及 4 个 3.2mm NPTH。位置在 Excellon 0.001mm 输出精度内一一对应，直径和镀孔分类完全一致，未发现漏孔或额外孔。
- 最小孔边距：元件孔对元件孔 1.54mm、元件孔对过孔 0.80mm、过孔对过孔约 0.6748mm。安装孔中心相对板边为 5/95mm，中心距 90×90mm。
- 33 个板端连接器是功能分配，不承诺任一现成模块的原生排列与之相同；仍须按接口表逐根接线。

## 4. 最终 CAM 和丝印

最终 ZIP 只含 9 个制造文件：双面铜、双面阻焊、双面丝印、板框、PTH、NPTH。ZIP 内每个文件与已核验散件逐字节一致。各 Gerber 有 RS-274-X 的坐标、单位、光圈声明，没有 `%TF/%TA/%TD` 等 X2 指令；`G04 #@!` 行属于兼容注释。早先散件采用 X2 的问题已经重导关闭。[嘉立创下单文件要求](https://www.jlc.com/portal/2/serviceGuide)

独立解析生成并实际查看了：

- `cam-top.png`：实际制造文件的正面阻焊/丝印合成图。
- `cam-bottom.png`：实际制造文件的镜像焊接面图，底面文字可正常读取。
- `cam-top-copper.png`、`cam-bottom-copper.png`：实际铜层与孔叠合；这两张按同一板坐标观察，用于审查，不替代镜像焊接面接线图。
- 原生 `board-3d.png` 与最终装配图：用于器件方向和名义外形检查。

孔与焊盘、阻焊开窗、板框相互对齐；没有漏层、意外空白层、错位或缩放。正反面位号可读，U1 缺口及电解正极标记清楚。板边“PIN 1 = SQUARE PAD”的解释在装配说明中限定为 J/JP 接口；电解电容按“+”装配，不能把负极丝印内的方形留白当成正极。

通用 Gerber 检查脚本结果为 PASS：9 文件、2 铜层、0 错误、0 警告。gerbonara 的附加提示已分类：KiCad 钻孔文件在头后使用 G90、RoundRect 宏携带未使用的尾参数、以及未提供锡膏层。它们未导致解析失败或图形差异；本版为 THT 手焊裸板，不要求锡膏层或钢网。

## 5. 验收边界

`release-evidence.json` 共 32 项检查通过、0 失败、0 待定，状态 `DIGITAL_FAB_CHECKS_PASSED`。下单只上传 `Gerber_RS274X.zip`；不选择 PCBA/SMT。板厂下单页面仍需核对其层识别和生产稿。

仍待实物完成：已有器件尺寸和针序、焊接质量、供电极性/限流上电、急停动作和复位锁存、电机堵转电流、舵机负载、电源跌落/温升、RFID 和各模块功能，以及配套固件。这些不是本次数字检查已经完成的项目。

## 本次接地加强补充

2026-10-12新增55个GND过孔，未变更BOM、接口或原走线。此文件仅验收制造数据；EMC工具仍有45条error级启发式项，热及生命周期工具缺少数据，均不能据此声称全项目通过。完整分类及待实测条件见四套技能联合报告。
