Sylphiette666/stm32-rfid-smart-bin/docs/manual/pcb-a-update-20261012/artifact.md

# Retained manual PCB A1 update

Reference: before.docx, SHA256 f7d0c5ce51f904e58d40f9733fe5b030d29f31db53e26faf53ad6d21b3713187. Source 175 pages, 330 numbered steps, 52 inline images, 51 tables. Preserve all step headings exactly. Authorized changes adopt SmartBin_A A1 bare PCB in place of the two perfboards, retain mechanical design, archive chapter 61 clearly, update current wiring prose/tables, append chapter 63 with figures 45–49 and exact interfaces derived from frozen circuit.json and connector-map.csv. Unrelated pictures, tables, numbering and sections are preserve-only. Changes to table cells and prose are explicitly audited.

Retain source Letter 21.59×27.94 cm, margins 1.7004 cm top/bottom and 1.7992 cm left/right. New body is Microsoft YaHei 10.5 pt, black, line spacing 1.15; captions 9.5 pt; diagrams 17.5 cm wide. Reuse Heading 1/2/3 styles in black. Tables light-gray borders, pale-blue header, repeated header, no split rows. New material should use prose steps for procedures and tables only for repeated values/interfaces.

Frozen electrical source: ../a-design/circuit.json and connector-map.csv. Board 100×100 mm, 2 layers, 1.6 mm, 1 oz, four M3 3.2 mm NPTH holes at (5,5), (95,5), (5,95), (95,95) measured from top-left. Manufacturing tests pending until root supplies final evidence. No fabricated/powered claims. AO3400A bare part must be soldered to the purchased adapter before use.

Append pictures only from final diagram manifest. Never deliver placeholder pictures. Refresh TOC in independent Word COM instance restricted to staging. Do not touch user Word sessions. Packaged render must first be attempted/logged; if bundled LibreOffice is unavailable, use isolated Word helper and bundled pypdfium2. Render every page, compare with reviewed baseline and inspect changed/new page PNGs. Verify steps, preserved media, exact interface counts, current/archived warnings, and no unfilled slots before replacement. Canonical and repo replacement belongs to root after SHA check.
