Sylphiette666/stm32-rfid-smart-bin/hardware/mechanical/print-backup/body-after-accessories-20261101/README.md

# 附件精细盘打印后：只补打剩余主体

先完成[43件附件精细盘](../accessories-fine-20261101/README.md)后，再使用以下三份工程，避免重复打印卡座和托片。剩余8件为底板两半、3块连接片、上平台、舵机支架、喇叭圈。

| 盘 | 文件 | 件数 | 预计时间 | PLA |
| --- | --- | --- | --- | --- |
| 1 | [P2S_BODY_AFTER_ACCESSORIES_PLATE_1.3mf](projects/P2S_BODY_AFTER_ACCESSORIES_PLATE_1.3mf) | 3 | 4小时53分56秒 | 150.9 g |
| 2 | [P2S_BODY_AFTER_ACCESSORIES_PLATE_2.3mf](projects/P2S_BODY_AFTER_ACCESSORIES_PLATE_2.3mf) | 2 | 4小时25分20秒 | 145.7 g |
| 3 | [P2S_BODY_AFTER_ACCESSORIES_PLATE_3.3mf](projects/P2S_BODY_AFTER_ACCESSORIES_PLATE_3.3mf) | 3 | 7小时45分16秒 | 269.4 g |

主体共约17小时5分、566 g；加附件精细盘，四次任务合计约26小时22分、650 g，人工换板另计。作为项目打开，保留原位置、100%比例与逐层打印。主体0.24 mm层高、首层0.20、4墙、30% gyroid、顶底7层；前两盘2 mm防翘边、第三盘1 mm，间隙0；自动支撑关。保留喷嘴缠料检测关闭，相机炒面检测可开。

底板仍为原280×220尺寸，两片平放打印后用三块连接片和12套M3×16螺钉固定；新增五金及装配图见[拼接说明](../flat-split-20261101/README.md#底板如何拼接)。切片检查通过，未实物打印或承重验证。
