Sylphiette666/stm32-rfid-smart-bin/hardware/mechanical/print-backup/wall-panels-20261102/interface_coordinates.pdf

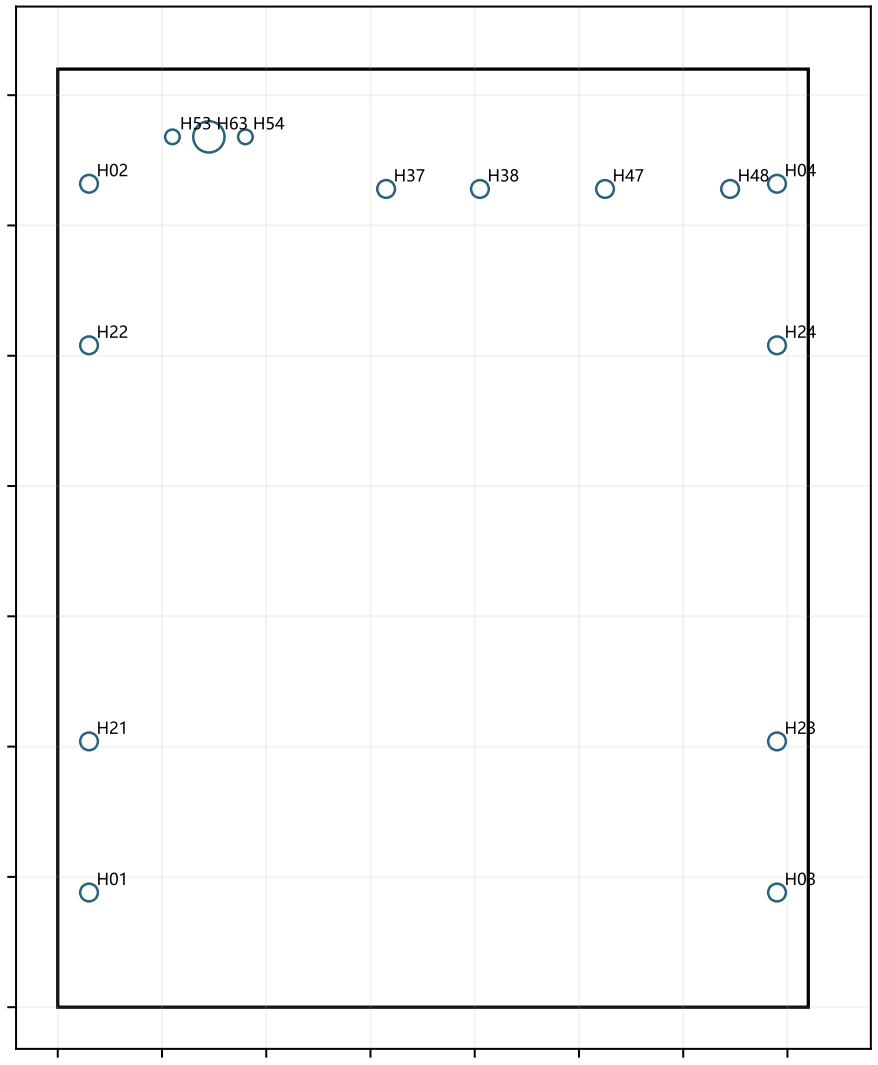
[picture p187: figure]

0 | 20 | 40 | 60 | 80 | 100 | 120 | 140
| | | | u / mm

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
## v / mm

孔号 | 中心 u,v | 孔径/槽宽×长 | 用途
H01 | 6, 22 | 3.4 | 角码
H02 | 6, 158 | 3.4 | 角码
H03 | 138, 22 | 3.4 | 角码
H04 | 138, 158 | 3.4 | 角码
H21 | 6, 51 | 3.4 | 操作腔长螺栓
H22 | 6, 127 | 3.4 | 操作腔长螺栓
H23 | 138, 51 | 3.4 | 操作腔长螺栓
H24 | 138, 127 | 3.4 | 操作腔长螺栓
H37 | 63, 157 | 3.4 | 安装座
H38 | 81, 157 | 3.4 | 安装座
H47 | 105, 157 | 3.4 | 安装座
H48 | 129, 157 | 3.4 | 安装座
H53 | 22, 167 | 2.8 | 安装座
H54 | 36, 167 | 2.8 | 安装座
H63 | 29, 167 | 6 | LED光孔

## 前壁 安装孔坐标与窗口

壁板按模型外侧视图；面板按模型背面视图。原点为对应零件左下角；槽端为半圆，图中矩形仅示范围。

### 操作腔：u0–144，v45–133，外深60；下方过线口u59–85、外伸z12–24，穿过腔下壁。

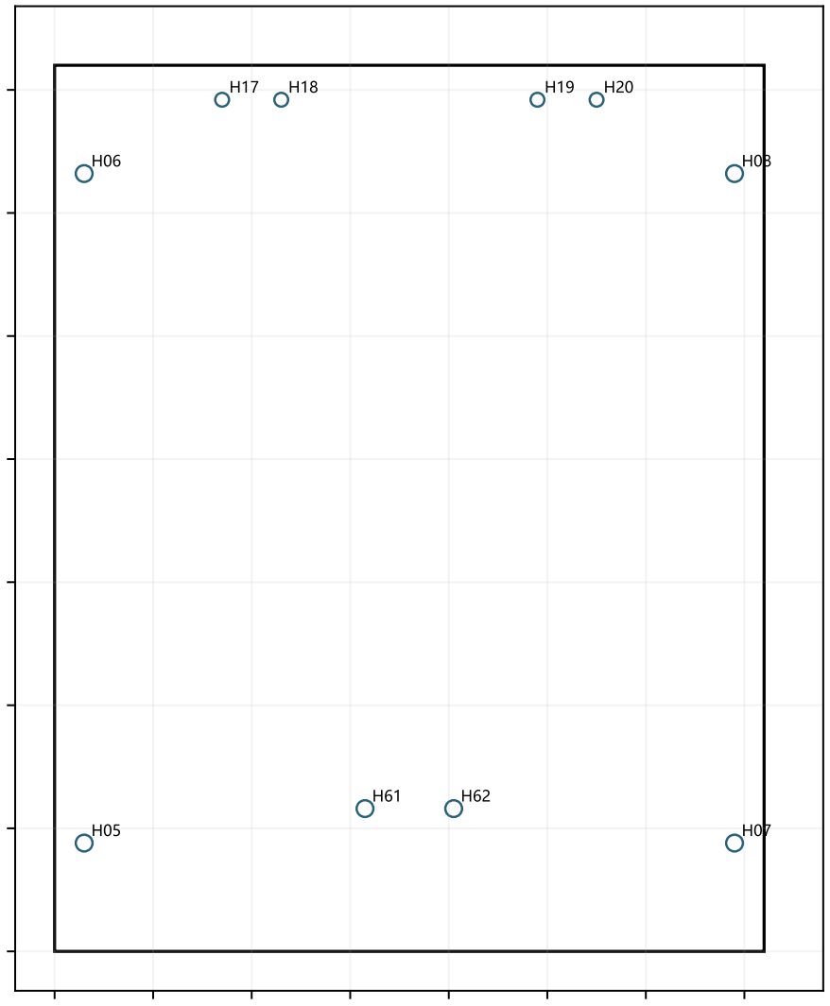
[picture p188: figure]

0 | 20 | 40 | 60 | 80 | 100 | 120 | 140
| | | | u / mm

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
## v / mm

孔号 | 中心 u,v | 孔径/槽宽×长 | 用途
H05 | 6, 22 | 3.4 | 角码
H06 | 6, 158 | 3.4 | 角码
H07 | 138, 22 | 3.4 | 角码
H08 | 138, 158 | 3.4 | 角码
H17 | 34, 173 | 2.8 | 合页
H18 | 46, 173 | 2.8 | 合页
H19 | 98, 173 | 2.8 | 合页
H20 | 110, 173 | 2.8 | 合页
H61 | 63, 29 | 3.4 | 安装座
H62 | 81, 29 | 3.4 | 安装座

## 后壁 安装孔坐标与窗口

壁板按模型外侧视图；面板按模型背面视图。原点为对应零件左下角；槽端为半圆，图中矩形仅示范围。

175

## 左壁 非舵机侧 安装孔坐标与窗口

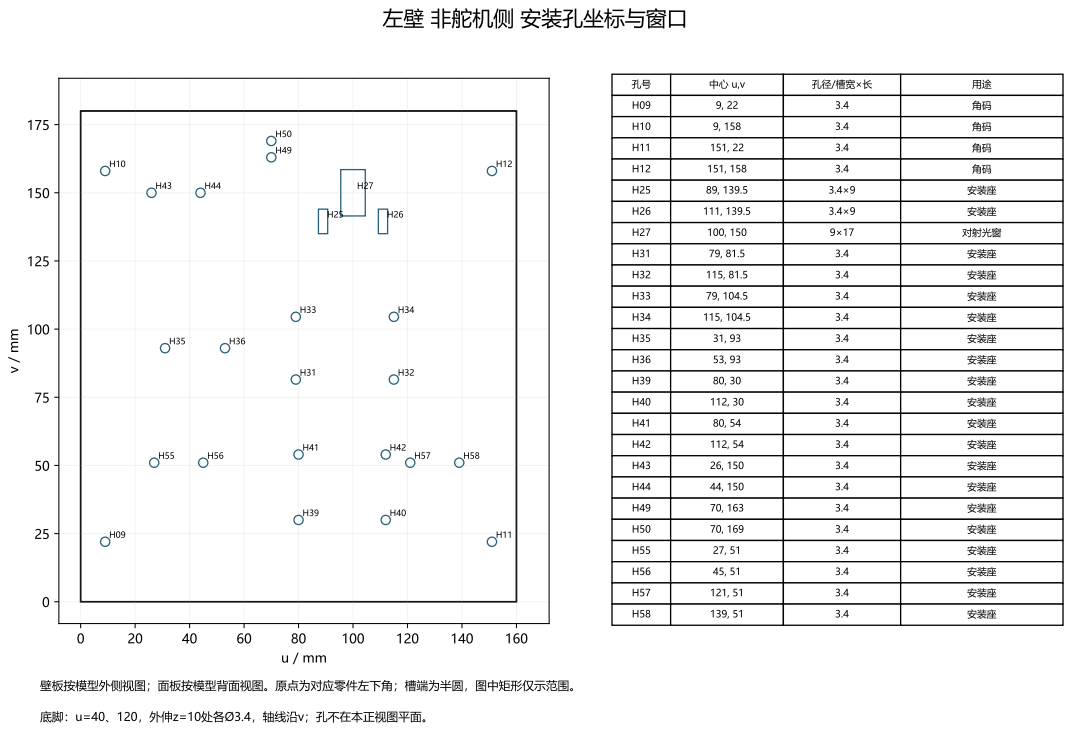
[picture p189: page 3]
安装座; 对射光窗

壁板按模型外侧视图；面板按模型背面视图。原点为对应零件左下角；槽端为半圆，图中矩形仅示范围。

底脚：u=40、120，外伸z=10处各Ø3.4，轴线沿v；孔不在本正视图平面。

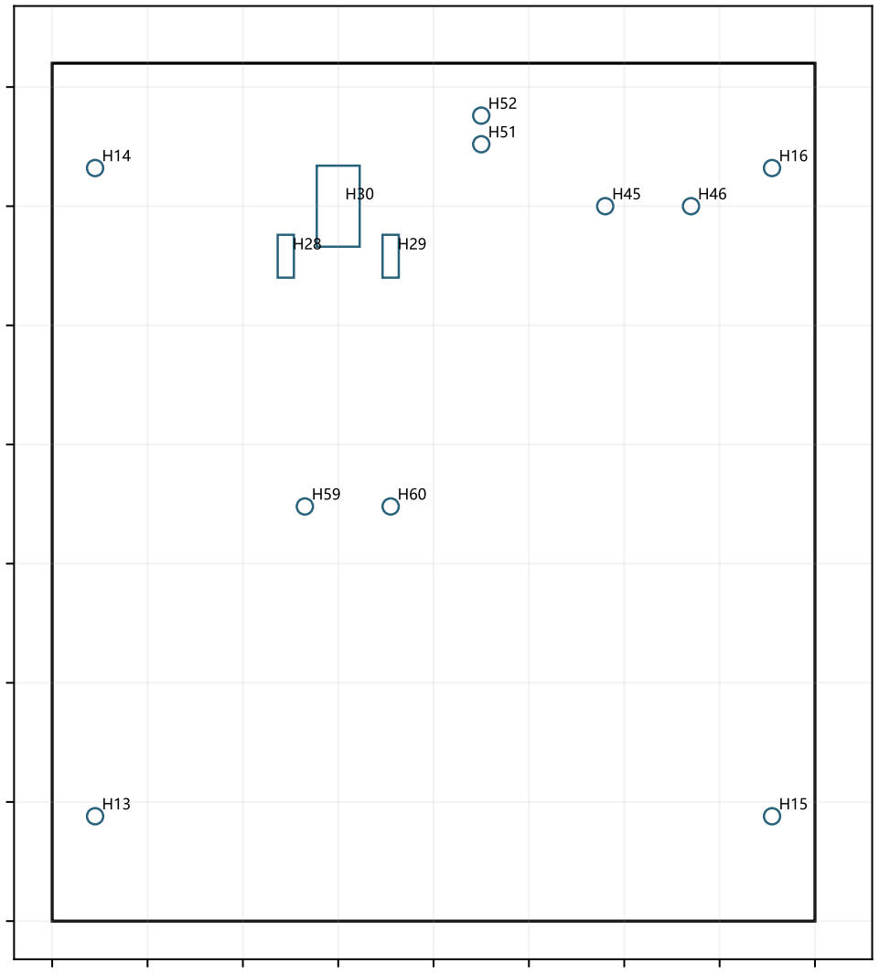
[picture p190: figure]

0 | 20 | 40 | 60 | 80 | 100 | 120 | 140 | 160
| | | | u / mm

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
## v / mm

孔号 | 中心 u,v | 孔径/槽宽×长 | 用途
H13 | 9, 22 | 3.4 | 角码
H14 | 9, 158 | 3.4 | 角码
H15 | 151, 22 | 3.4 | 角码
H16 | 151, 158 | 3.4 | 角码
H28 | 49, 139.5 | 3.4×9 | 安装座
H29 | 71, 139.5 | 3.4×9 | 安装座
H30 | 60, 150 | 9×17 | 对射光窗
H45 | 116, 150 | 3.4 | 安装座
H46 | 134, 150 | 3.4 | 安装座
H51 | 90, 163 | 3.4 | 安装座
H52 | 90, 169 | 3.4 | 安装座
H59 | 53, 87 | 3.4 | 安装座
H60 | 71, 87 | 3.4 | 安装座

## 右壁 舵机侧 安装孔坐标与窗口

壁板按模型外侧视图；面板按模型背面视图。原点为对应零件左下角；槽端为半圆，图中矩形仅示范围。

### 底脚：u=40、120，外伸z=10处各Ø3.4，轴线沿v；孔不在本正视图平面。

0 | 20 | 40 | 60 | 80 | 100 | 120 | 140
| | | | u / mm

0

20

40

60

80

100

## v / mm

H65 | | | | | | H67
H68 玻璃窗 | H69 | H72 H74 排针窗 | H70 | H75 | | H78
H82 | | H71 H73 | | H76 H84 | H77 H79 | H80
| 1.2mm膜 | | | | H85
H81 H64 | | | | H83 | | H66
孔号 | 中心 u,v | 孔径/槽宽×长 | 用途
H64 | 6, 6 | 3.4 | 盖板固定
H65 | 6, 82 | 3.4 | 盖板固定
H66 | 138, 6 | 3.4 | 盖板固定
H67 | 138, 82 | 3.4 | 盖板固定
H68 | 11.25, 72.25 | 2.8×4.8 | OLED
H69 | 32.75, 72.25 | 2.8×4.8 | OLED
H70 | 65, 62 | 7.4 | 编码器套筒
H71 | 42, 48 | 2.8 | 排针罩
H72 | 42, 76 | 2.8 | 排针罩
H73 | 57, 48 | 2.8 | 排针罩
H74 | 57, 76 | 2.8 | 排针罩
H75 | 96, 63 | 12.4×16 | 按键帽
H76 | 86, 57 | 2.8×10 | 按键夹座
H77 | 106, 57 | 2.8×10 | 按键夹座
H78 | 122, 63 | 12.4×16 | 按键帽
H79 | 112, 57 | 2.8×10 | 按键夹座
H80 | 132, 57 | 2.8×10 | 按键夹座
H81 | 10, 15 | 2.8×5 | RFID边夹
H82 | 10, 40 | 2.8×5 | RFID边夹
H83 | 79, 15 | 2.8×5 | RFID边夹
H84 | 79, 40 | 2.8×5 | RFID边夹
H85 | 111, 26 | 22.6 | 急停

## 可拆操作面板 安装孔坐标与窗口

壁板按模型外侧视图；面板按模型背面视图。原点为对应零件左下角；槽端为半圆，图中矩形仅示范围。

矩形窗：玻璃左下(9.5,54.5)，25×15；排针左下(45,50)，10×24；刷卡膜左下(13,8)，62×40。
