Sylphiette666/stm32-rfid-smart-bin/hardware/current-low-cost/pcb-b/diagrams/servo/servo_wiring_A4.pdf

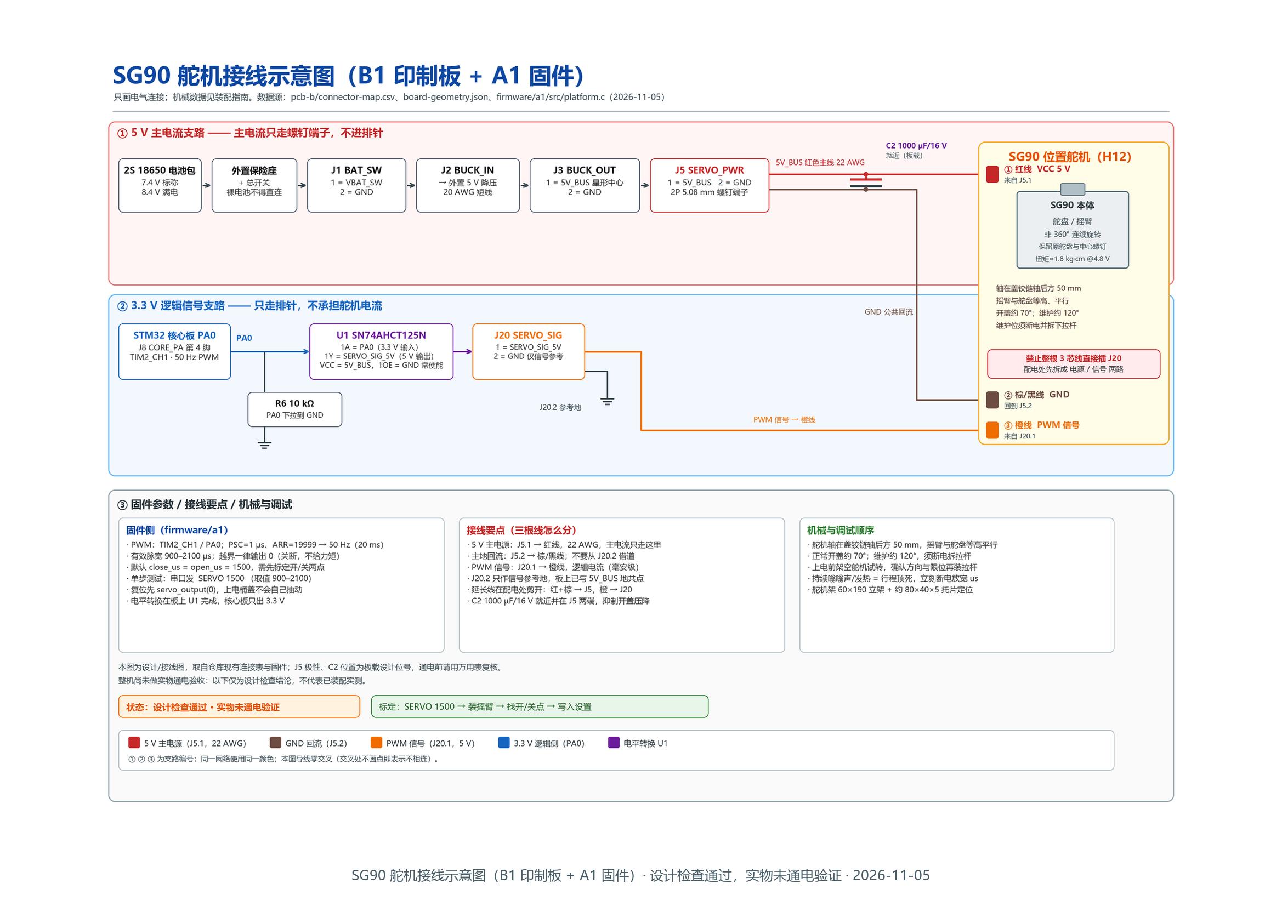
[picture p191: page 1]
