Sylphiette666/stm32-rfid-smart-bin/hardware/mechanical/print-backup/motor-existing-holes-light-20261103/source/pocket_bounds.csv

part | pocket | X_min_mm | yb_min_mm | X_max_mm | yb_max_mm | depth_mm | remaining_floor_mm | corner_round_mm
LEFT | LP1 | 87.67776162674268 | 25.1 | 106.10917787857707 | 34.59898874645565 | 11 | 5 | 2
LEFT | LP2 | 64.91879932244535 | 32.784601501302994 | 78.50922075983631 | 52.92700971838448 | 11 | 5 | 2
LEFT | LP3 | 46.94089663300188 | 34.557886614665215 | 57.92397879657521 | 44.56141104299929 | 11 | 5 | 2
RIGHT | RP1 | 135.32991004112887 | 190.14649163943687 | 179.209928207518 | 205.31234513800788 | 11 | 5 | 2
RIGHT | RP2 | 138.47998977379487 | 153.60528688657678 | 175.51977120774967 | 180.97517588121383 | 11 | 5 | 2
RIGHT | RP3 | 121.152990283821 | 151.1 | 138.31740936377142 | 177.14558271062236 | 11 | 5 | 2
RIGHT | RP4 | 78.1 | 157.88776477513179 | 113.69934956888646 | 214.9 | 11 | 5 | 2
