Sylphiette666/stm32-rfid-smart-bin/hardware/mechanical/print-backup/motor-existing-holes-light-20261103/source/pocket_contours.csv

part | pocket | ring | vertex | X_mm | yb_mm
LEFT | LP1 | 0 | 0 | 88.9720782682271 | 28.965864449367473
LEFT | LP1 | 0 | 1 | 88.97112347132718 | 28.968169532992555
LEFT | LP1 | 0 | 2 | 89.16441747500177 | 29.048234530839967
LEFT | LP1 | 0 | 3 | 89.98550772196275 | 29.453151430487686
LEFT | LP1 | 0 | 4 | 90.10999601683831 | 29.52502478104505
LEFT | LP1 | 0 | 5 | 90.87120946183539 | 30.033651343889055
LEFT | LP1 | 0 | 6 | 90.98525138732062 | 30.121158791074954
LEFT | LP1 | 0 | 7 | 91.67356345726157 | 30.724792275606994
LEFT | LP1 | 0 | 8 | 91.77520772439297 | 30.82643654273841
LEFT | LP1 | 0 | 9 | 92.3788412089251 | 31.514748612679465
LEFT | LP1 | 0 | 10 | 92.46634865611094 | 31.628790538164612
LEFT | LP1 | 0 | 11 | 92.97497521895497 | 32.39000398316171
LEFT | LP1 | 0 | 12 | 93.04684856951225 | 32.51449227803713
LEFT | LP1 | 0 | 13 | 93.45176546916001 | 33.335582524998195
LEFT | LP1 | 0 | 14 | 93.46368367169025 | 33.36435561118579
LEFT | LP1 | 0 | 15 | 93.64850351210772 | 33.71012921249483
LEFT | LP1 | 0 | 16 | 93.89722917433971 | 34.013202308828724
LEFT | LP1 | 0 | 17 | 94.2003022706736 | 34.26192797106073
LEFT | LP1 | 0 | 18 | 94.54607587198264 | 34.44674781147822
LEFT | LP1 | 0 | 19 | 94.92126209268055 | 34.56055930726211
LEFT | LP1 | 0 | 20 | 95.31144273671282 | 34.59898874645565
LEFT | LP1 | 0 | 21 | 95.70162338074508 | 34.56055930726212
LEFT | LP1 | 0 | 22 | 96.19838173934143 | 34.46174792613809
LEFT | LP1 | 0 | 23 | 96.34089866750104 | 34.44298521659739
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
RIGHT | RP4 | 1 | 92 | 95.34930588931373 | 193.51703469461725
RIGHT | RP4 | 1 | 93 | 95.4633478147986 | 193.60454214180288
RIGHT | RP4 | 1 | 94 | 95.90579650429534 | 193.9925592285735
RIGHT | RP4 | 1 | 95 | 96.00744077142673 | 194.09420349570487
