Sylphiette666/stm32-rfid-smart-bin/hardware/mechanical/print-backup/parallel-after-old-plate2-20261101/README.md

# 当前正确分工：昨天第二盘继续，其余四台打印底板与精细附件

**附件4/5号已更新为[底座带标牌版](../labeled-bases-20261101/README.md)。本页两片底板仍可用；附件请用新版，避免重复打印。**

1号机正在打印的是昨天的P2S_MOUNTED_PLATE_2.3mf，内容为完整上平台、舵机支架、喇叭圈，共3件。继续此任务，不用停止。本目录四份新任务排除了这三件。

刚才parallel-four-p2s-20261101按“精细附件盘正在打印”安排，不适用于实际状态，请勿用于本次；也不要再打印43件附件合盘或旧主体三盘，否则会重复。

| 机器 | 文件 | 内容 | 件数 | 预计时间 | PLA |
| --- | --- | --- | ---: | --- | ---: |
| 2号 | [P2S_PRINTER_02_BASE_REAR.3mf](projects/P2S_PRINTER_02_BASE_REAR.3mf) | 底板后半片 | 1 | 4小时32分22秒 | 141.8 g |
| 3号 | [P2S_PRINTER_03_BASE_FRONT.3mf](projects/P2S_PRINTER_03_BASE_FRONT.3mf) | 底板前半片 | 1 | 4小时16分18秒 | 141.3 g |
| 4号 | [P2S_PRINTER_04_FINE_CLAMPS_A.3mf](projects/P2S_PRINTER_04_FINE_CLAMPS_A.3mf) | 精细附件A（含托片、2块连接片） | 23 | 5小时6分3秒 | 52.3 g |
| 5号 | [P2S_PRINTER_05_FINE_CLAMPS_B.3mf](projects/P2S_PRINTER_05_FINE_CLAMPS_B.3mf) | 精细附件B（含电池托架、1块连接片） | 23 | 5小时18分21秒 | 46.9 g |

四台同时开打，新增48件约 **5小时18分21秒** 完成，PLA合计382.3 g。整套完成时间还取决于1号机昨天第二盘的剩余时间。2至5号为分工标签，不是设备序列号。

每份文件各打印一次。分别作为项目打开，保持工程参数、100%比例、原排布与逐层打印，重新切片后选择对应的空闲P2S发送。喷嘴0.4 mm、PLA、纹理PEI，标准100%速度；清洁板面、调平并检查首层。不要将四份合并为一盘。

2/3号底板：平放，层高0.24 mm、首层0.20 mm、4墙、30% gyroid、顶底7层/最小1.6 mm，外墙60/内墙100 mm/s，5 mm外侧防翘边。

4/5号附件：层高0.16 mm、首层0.20 mm、4墙、30% gyroid、顶底10层/最小1.6 mm，外墙40/内墙80 mm/s，3 mm外侧防翘边。原卡座、压框、拨片、簧片、托片尺寸和摆放均保留，同一模块夹具保持在同一盘；只新增放入3块底板连接片。层高改善层向细节，不保证孔径公差，不要整体缩放。

所有新任务自动支撑及擦料塔关闭，防翘边间隙0，保留喷嘴缠料检测关闭；相机炒面检测可开。Generic PLA喷嘴220℃、纹理PEI 60℃，实际板型/耗材需一致。正在打印的昨天第二盘不改参数。

底板保持原280×220外形，两片平放打印后拼接；上平台正在以整片打印。新增12颗M3×16低圆头螺钉、24片外径≤6 mm且厚0.5 mm垫圈、12颗高4 mm M3防松螺母；原夹具五金另计。装配见[底板拼接说明](../flat-split-20261101/README.md#底板如何拼接)和同名手册66.1、66.2。

4号机夹具组：M02、M03、M05、M07、M08，另有托片和2块连接片。5号机：M01、M04、M06、M09、电池托架及双锁片、降压托架、1块连接片。详细对象清单见checks/packing.json。按原模块安装图识别，先去防翘边，再分离套排小件。

正在打印的3件＋新增48件正好覆盖整套51件，无重复或遗漏。四项实际切片均返回0且无警告，首层对象1/1/23/23件与防翘边均在床内；原生3MF与受测模型一致，不含G-code。尚未实物打印、承重或寿命验证。
