Sylphiette666/stm32-rfid-smart-bin/docs/manual/four-skills-review-20261012/page-179.png

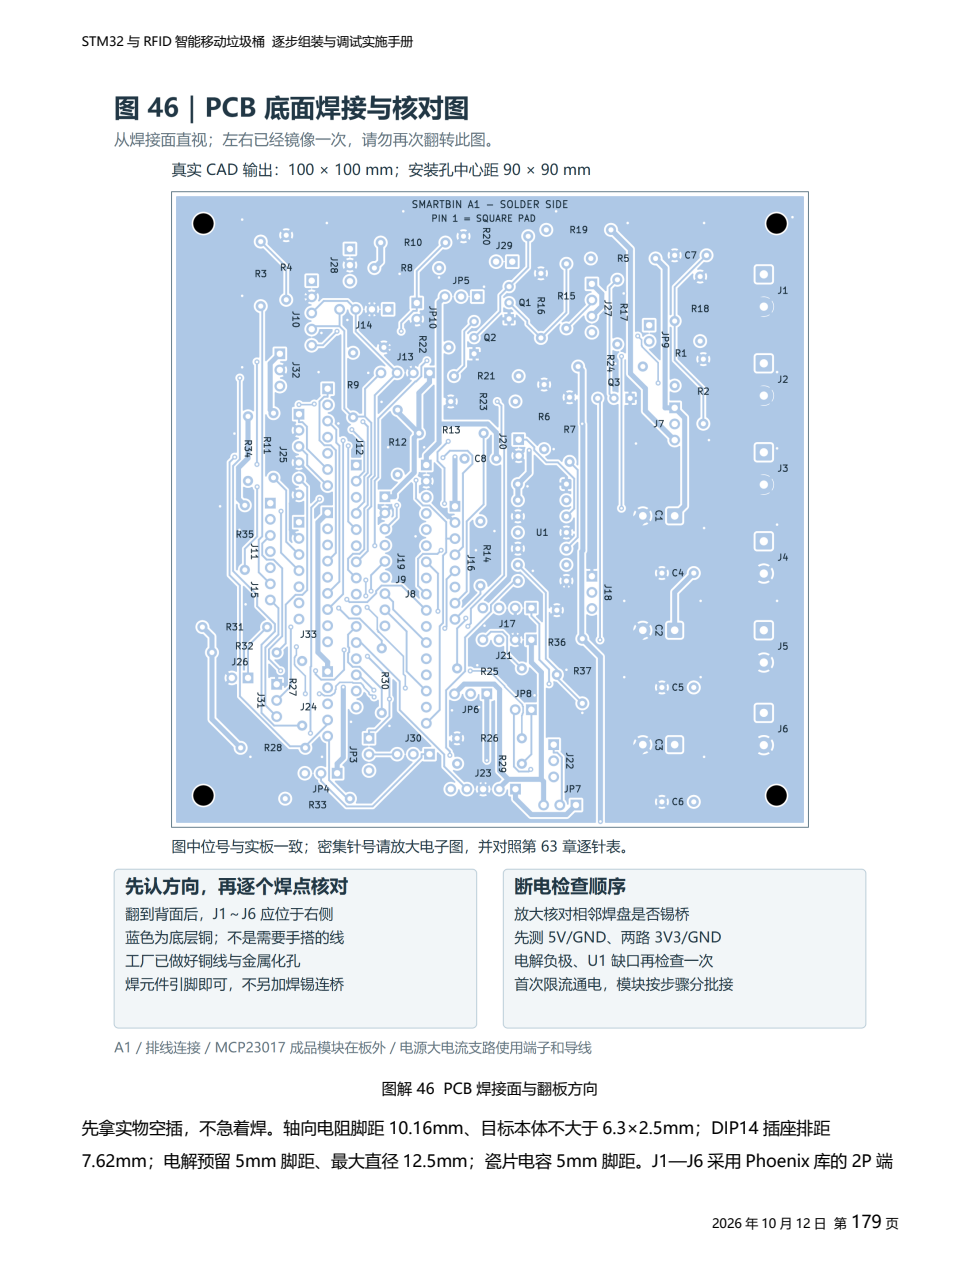
docs/manual/four-skills-review-20261012/page-179.png
