Sylphiette666/stm32-rfid-smart-bin/docs/manual/four-skills-review-20261012/page-200.png

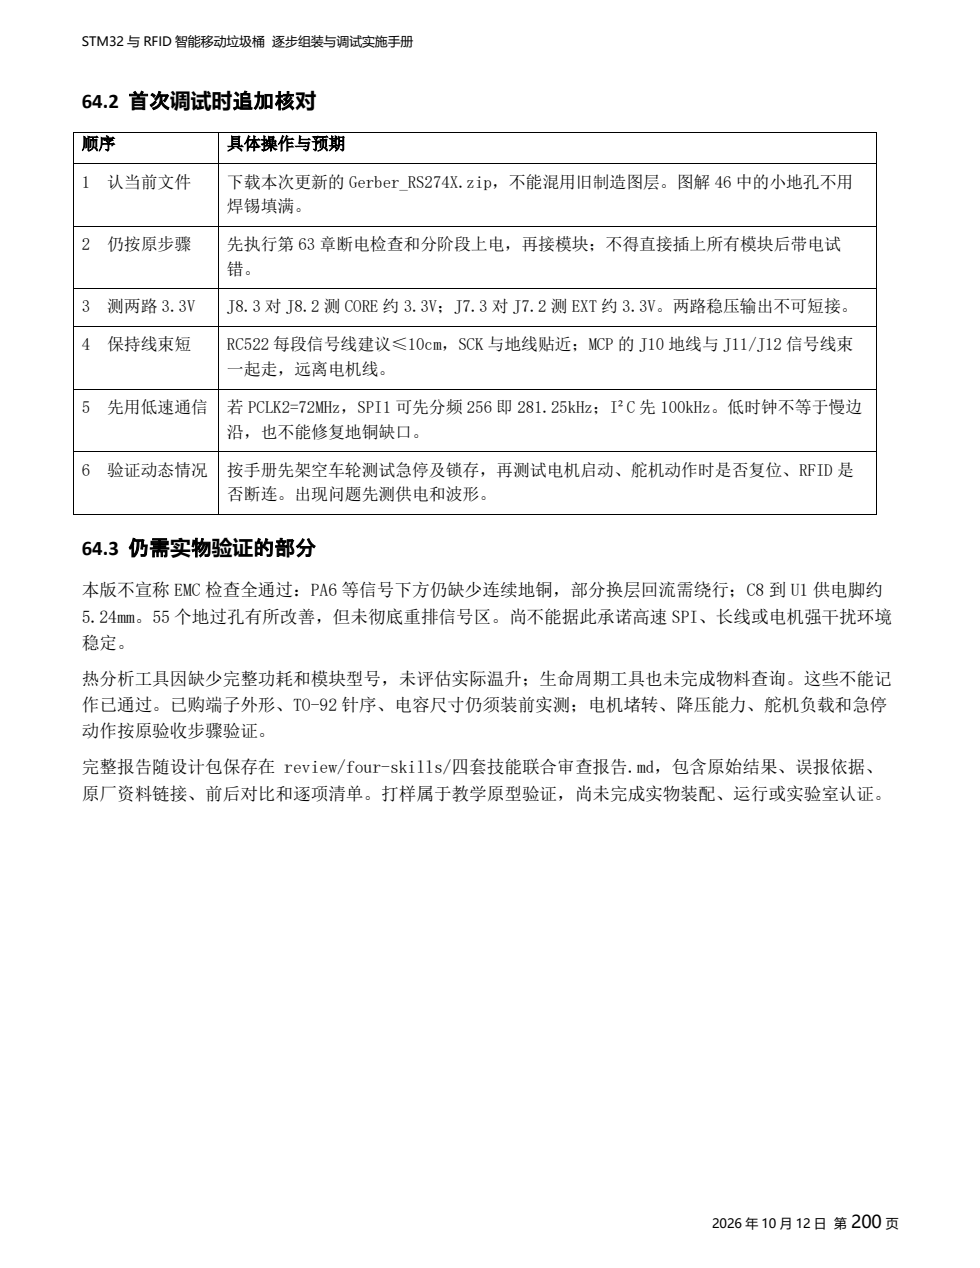
docs/manual/four-skills-review-20261012/page-200.png
