Sylphiette666/stm32-rfid-smart-bin/docs/manual/illustrated-additions-20261010/perfboard-print/IO_back_print.png

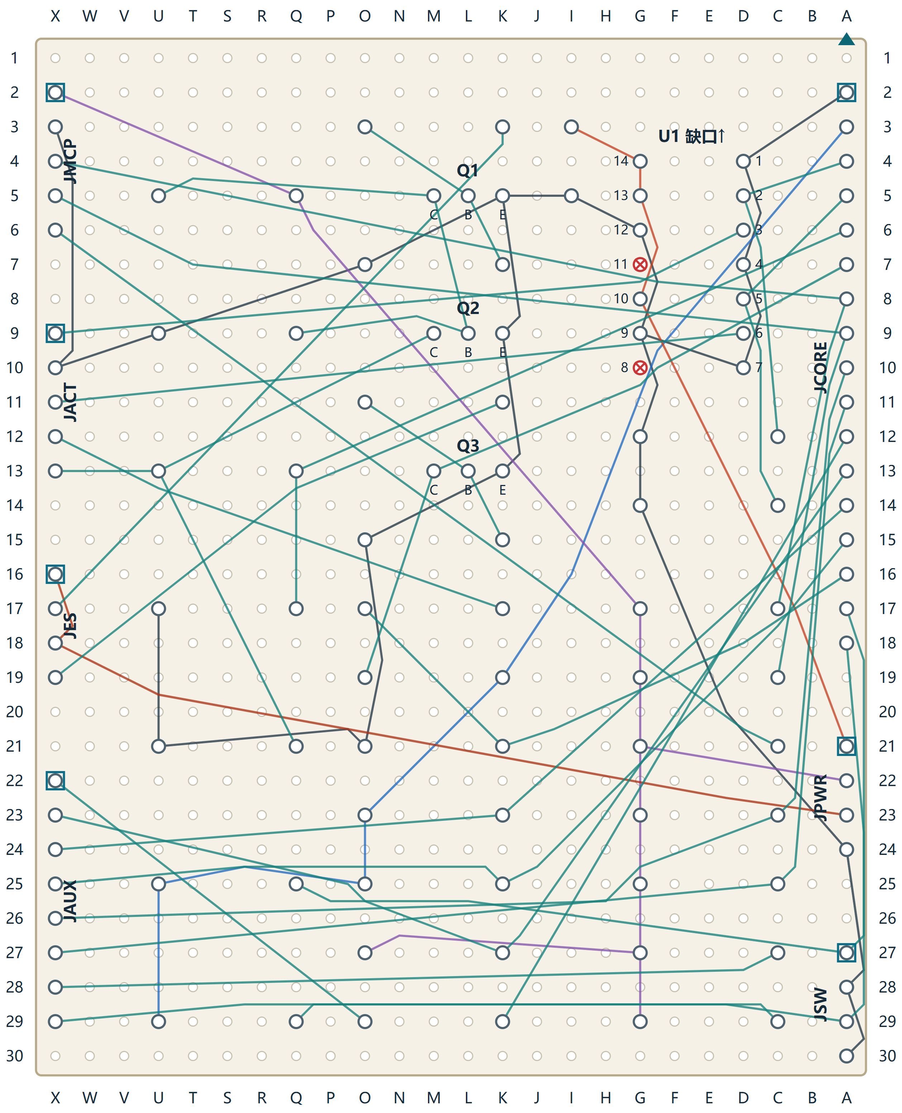
docs/manual/illustrated-additions-20261010/perfboard-print/IO_back_print.png
