Sylphiette666/stm32-rfid-smart-bin/docs/manual/illustrated-additions-20261010/sg90/sg90_01_closed_0.png

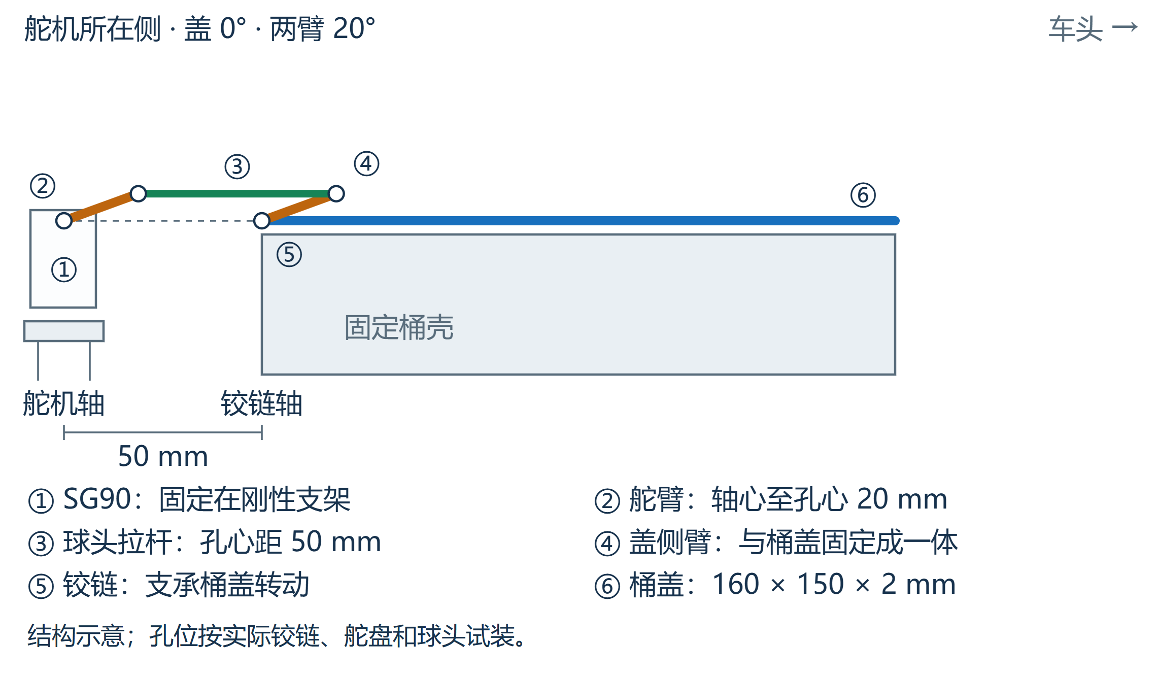
docs/manual/illustrated-additions-20261010/sg90/sg90_01_closed_0.png
