Sylphiette666/stm32-rfid-smart-bin/docs/manual/illustrated-additions-20261010/sg90/sg90_02_mid_35.png

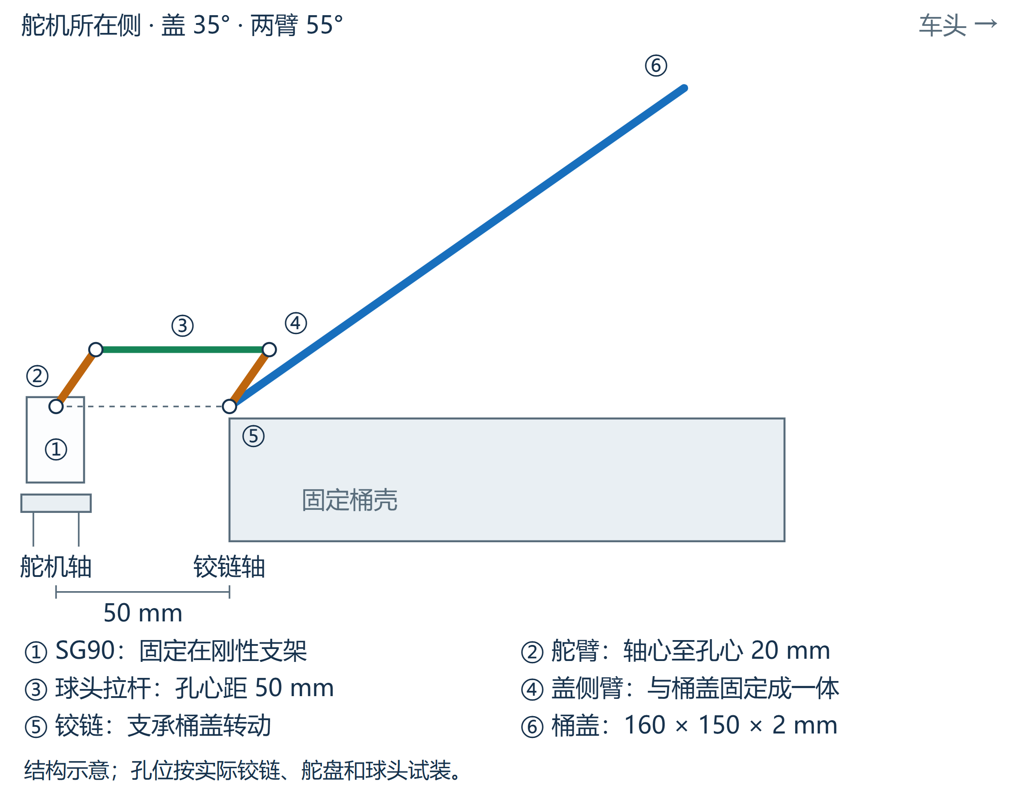
docs/manual/illustrated-additions-20261010/sg90/sg90_02_mid_35.png
