Sylphiette666/stm32-rfid-smart-bin/docs/manual/illustrated-additions-20261010/sg90/sg90_03_open_70.png

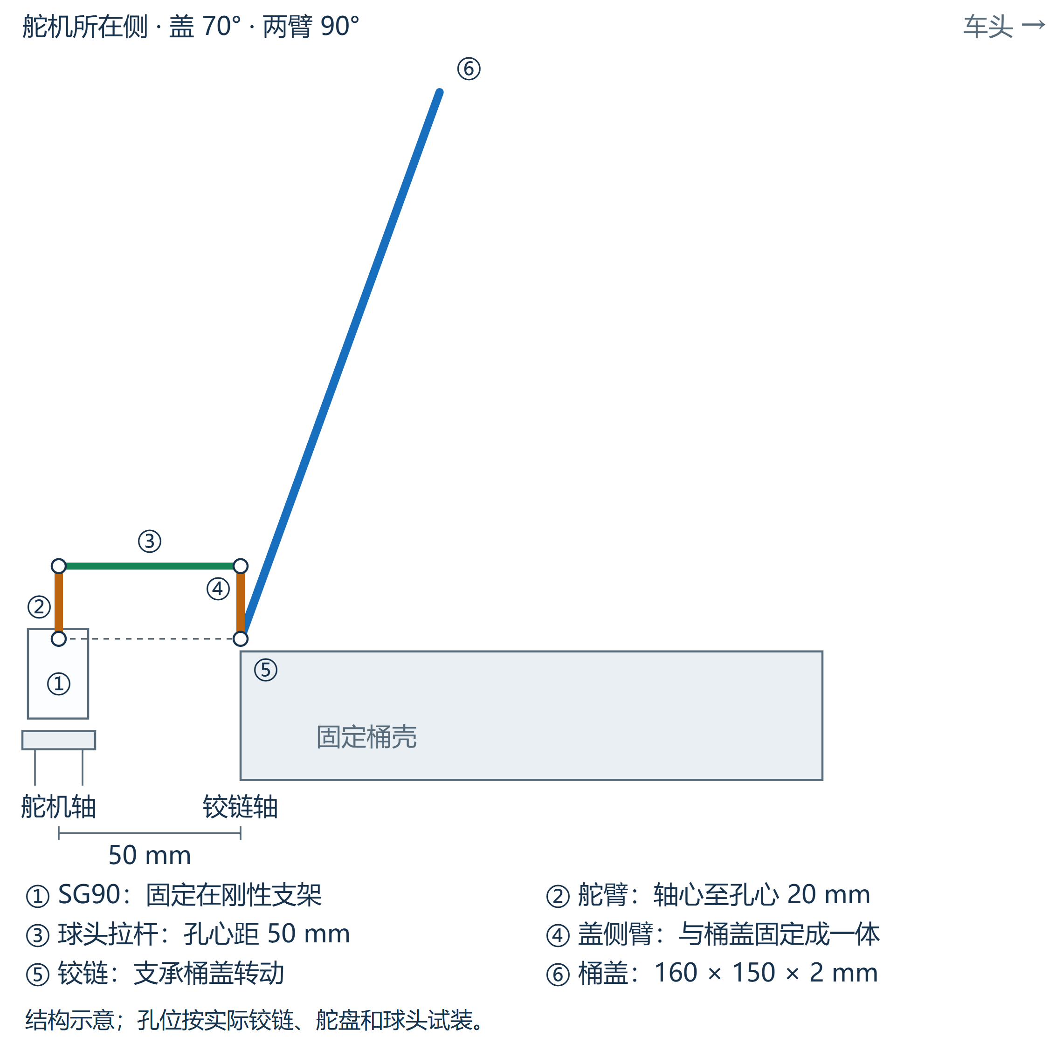
docs/manual/illustrated-additions-20261010/sg90/sg90_03_open_70.png
