Sylphiette666/stm32-rfid-smart-bin/docs/manual/illustrated-additions-20261010/sg90/sg90_04_lid_bracket.png

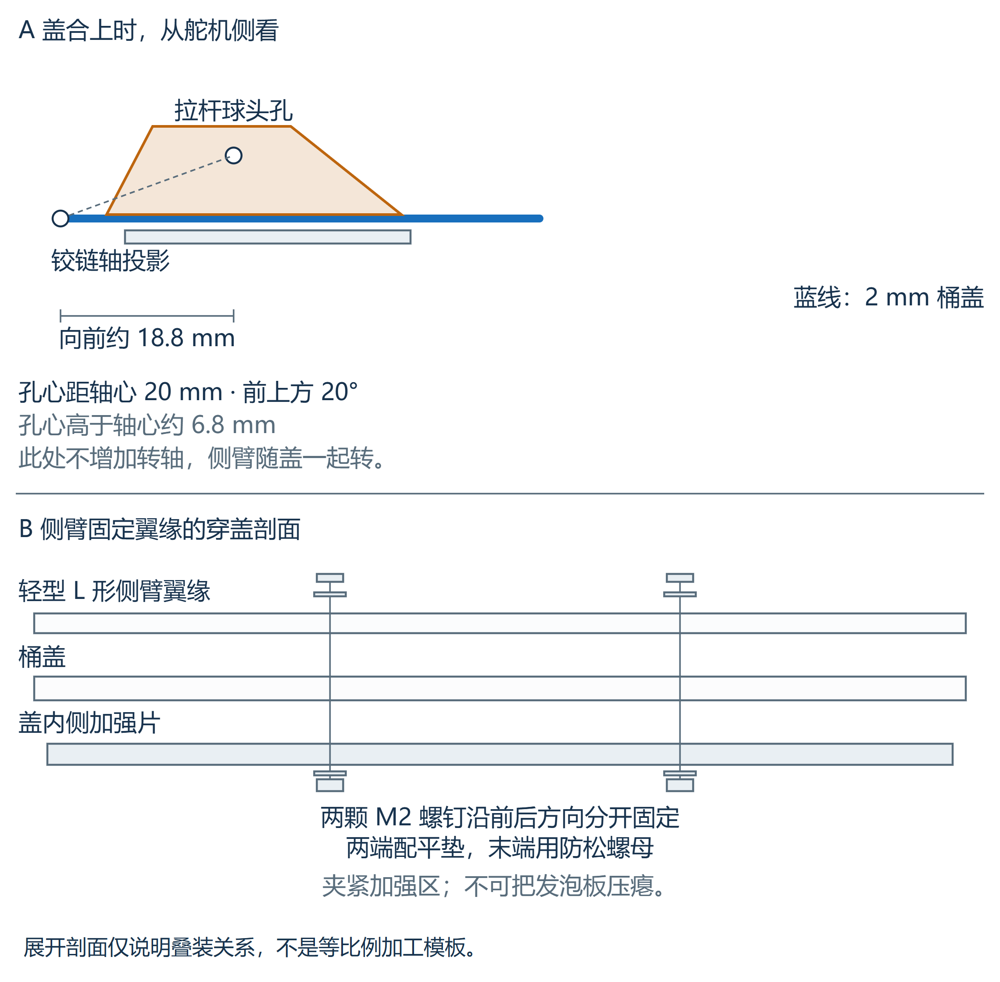
docs/manual/illustrated-additions-20261010/sg90/sg90_04_lid_bracket.png
