Sylphiette666/stm32-rfid-smart-bin/docs/manual/illustrated-source/figures/e01_swd_uart.png

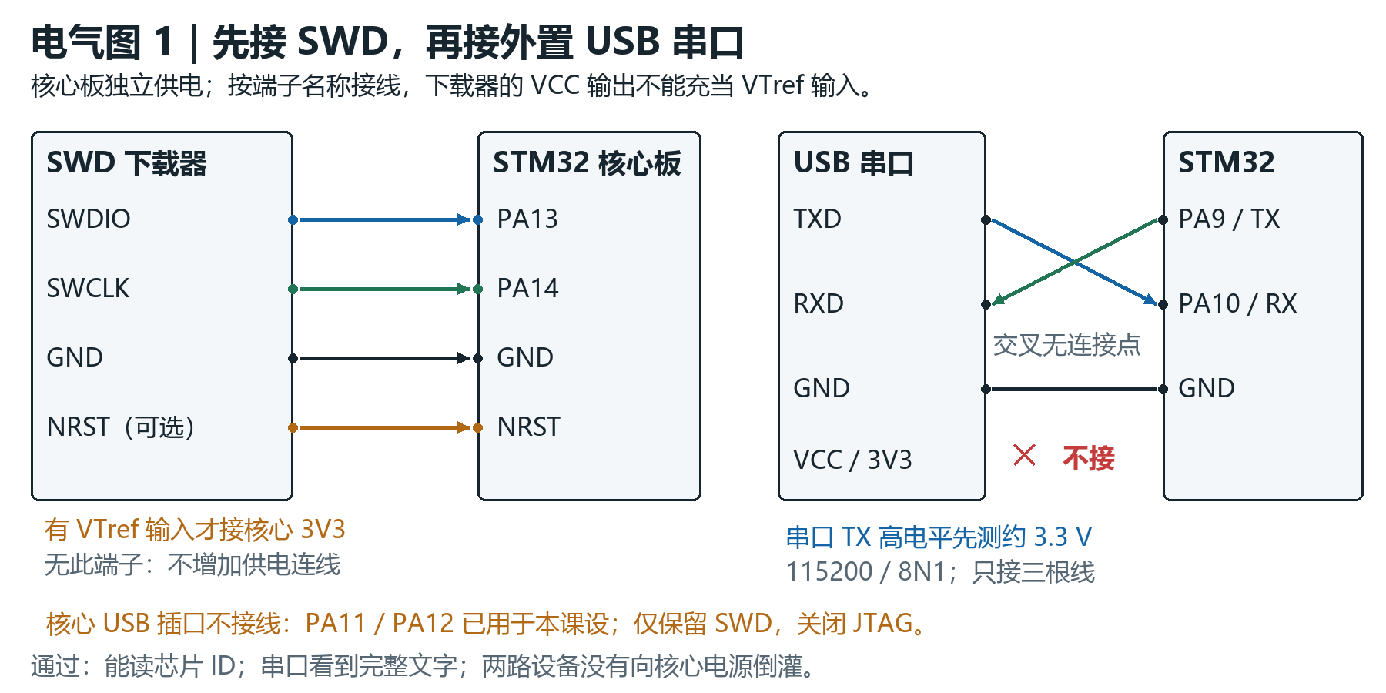
docs/manual/illustrated-source/figures/e01_swd_uart.png
