Sylphiette666/stm32-rfid-smart-bin/docs/manual/illustrated-source/figures/e02_i2c.png

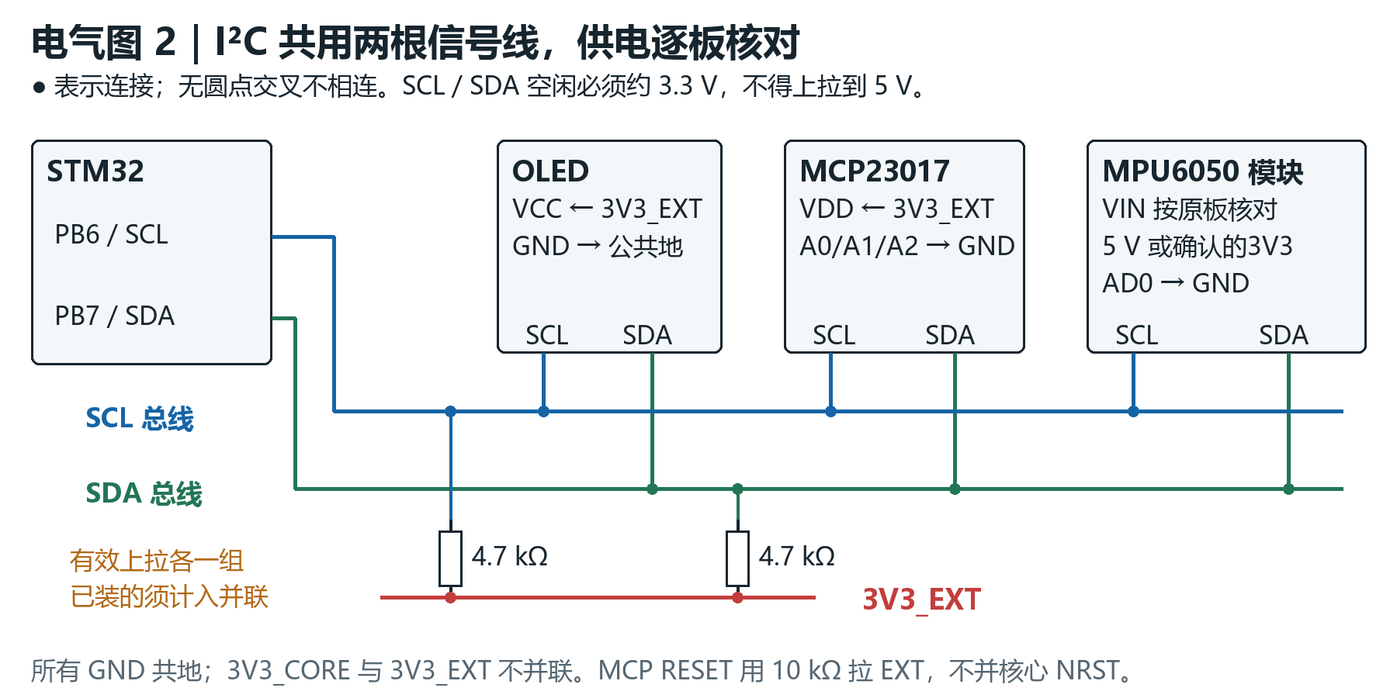
docs/manual/illustrated-source/figures/e02_i2c.png
