Sylphiette666/stm32-rfid-smart-bin/docs/manual/illustrated-source/figures/e03_spi.png

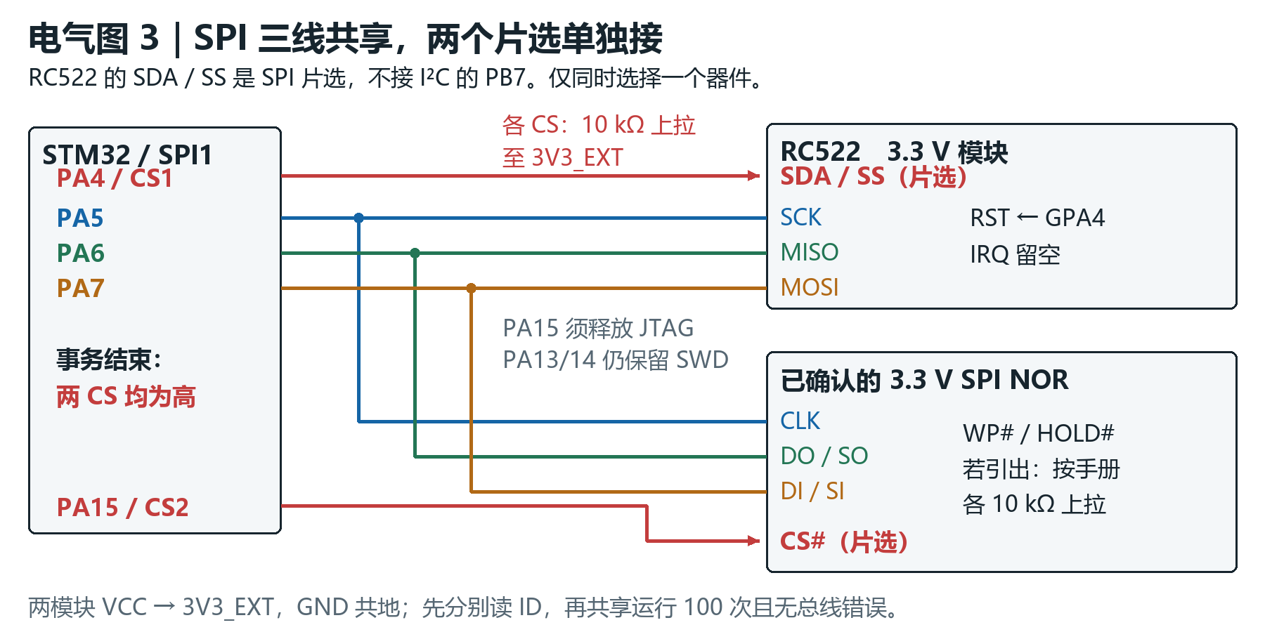
docs/manual/illustrated-source/figures/e03_spi.png
