Sylphiette666/stm32-rfid-smart-bin/docs/manual/illustrated-source/figures/e04_ultrasonic.png

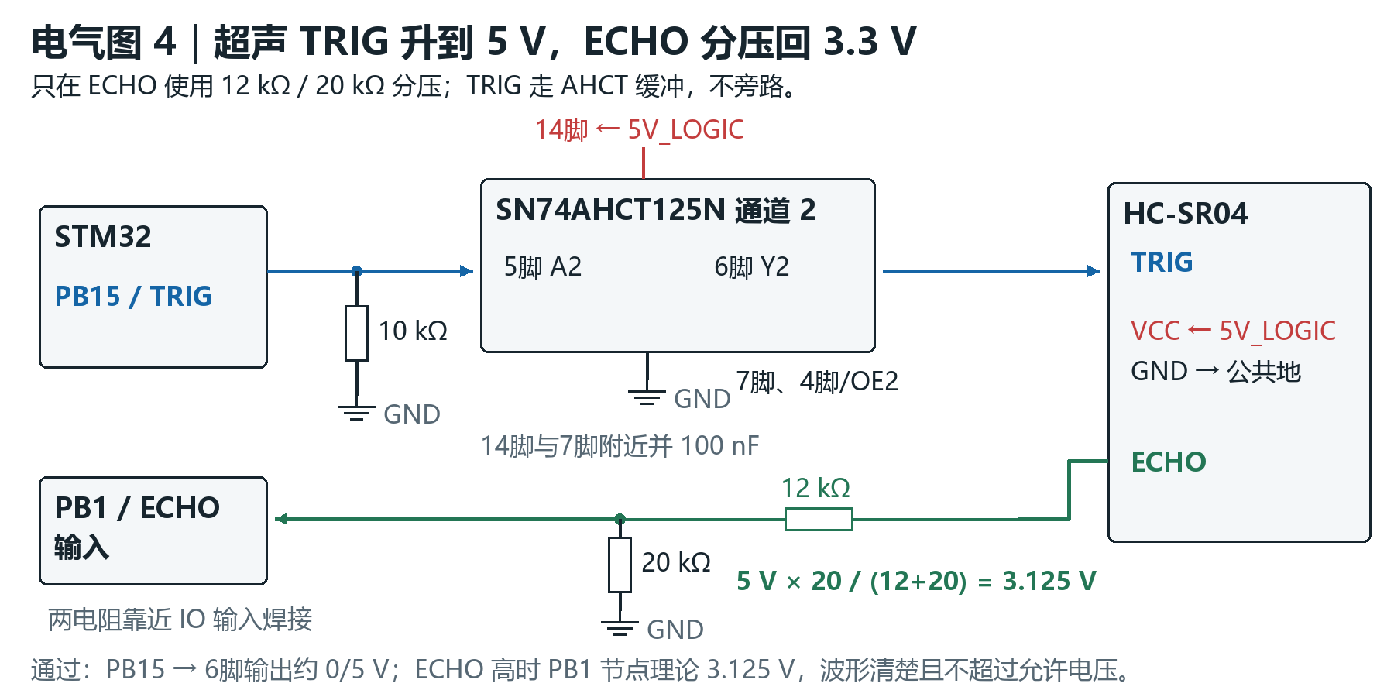
docs/manual/illustrated-source/figures/e04_ultrasonic.png
