Sylphiette666/stm32-rfid-smart-bin/docs/manual/illustrated-source/figures/e05a_switches.png

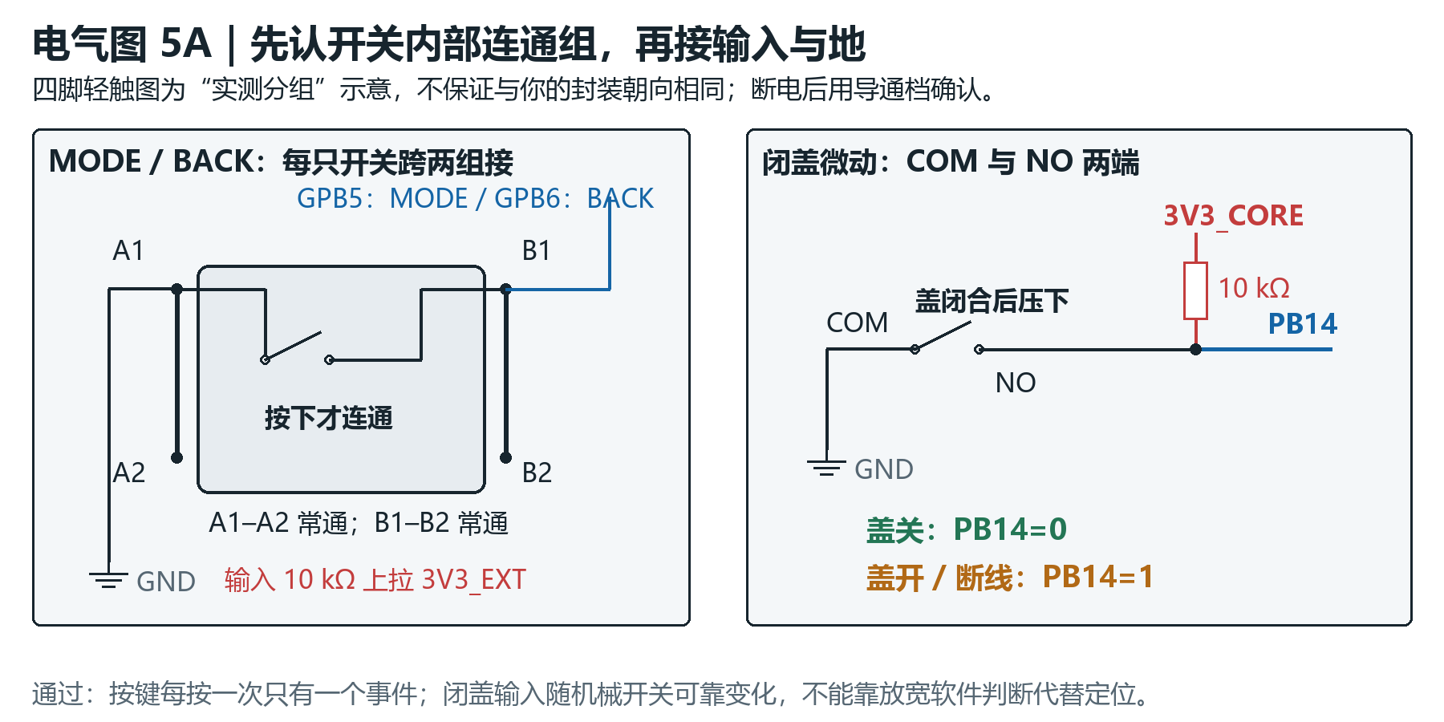
docs/manual/illustrated-source/figures/e05a_switches.png
