Sylphiette666/stm32-rfid-smart-bin/docs/manual/illustrated-source/figures/e05b_encoder.png

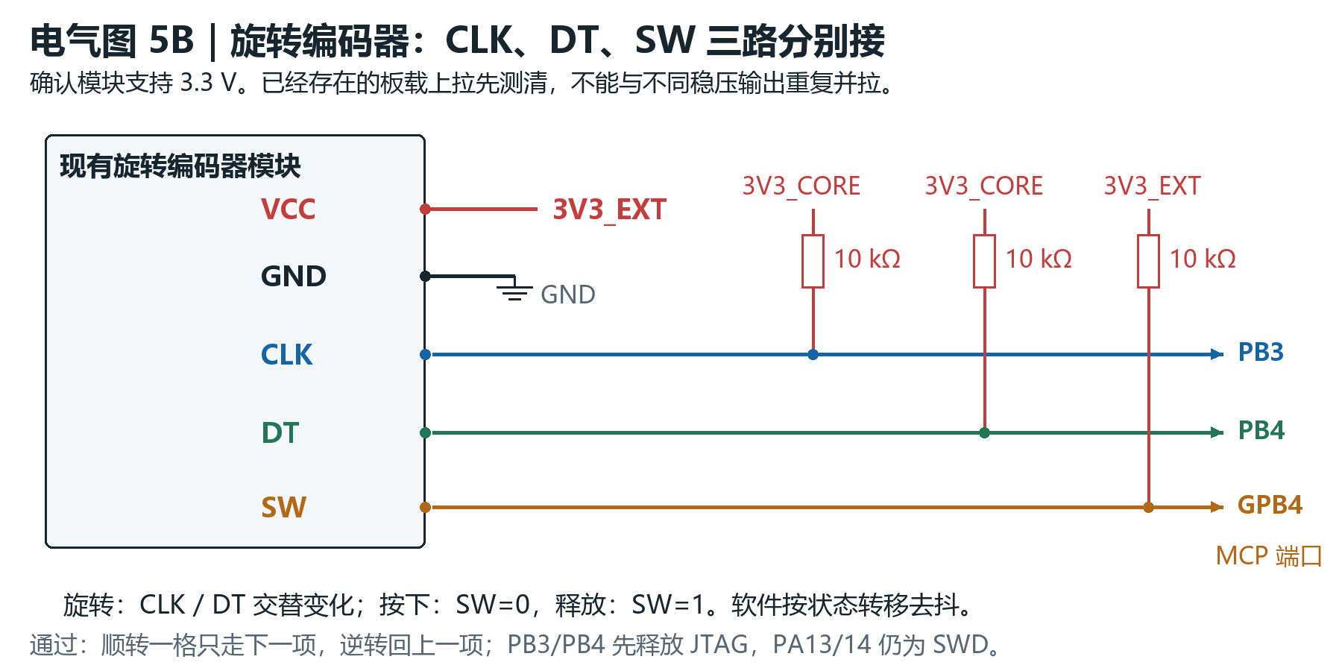
docs/manual/illustrated-source/figures/e05b_encoder.png
