Sylphiette666/stm32-rfid-smart-bin/docs/manual/illustrated-source/figures/e06a_estop_clamp.png

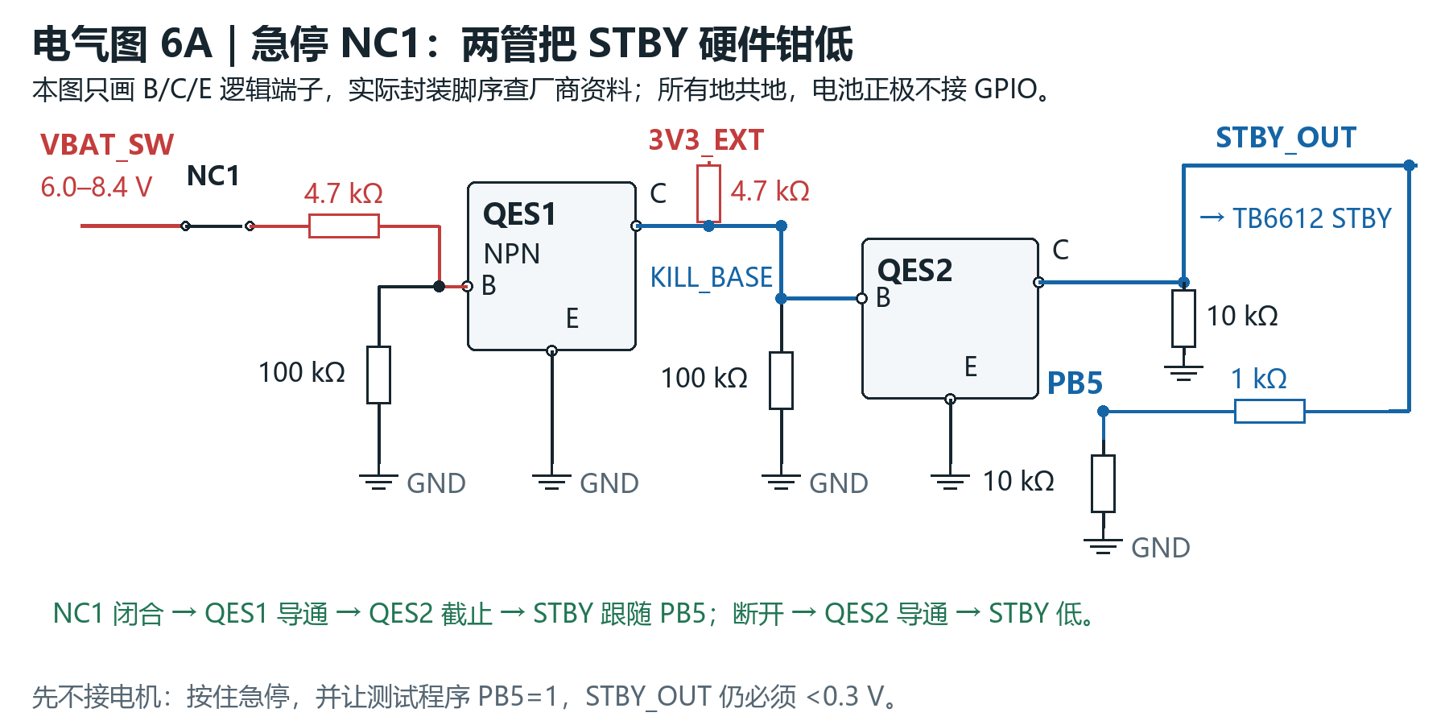
docs/manual/illustrated-source/figures/e06a_estop_clamp.png
