Sylphiette666/stm32-rfid-smart-bin/docs/manual/illustrated-source/figures/e06b_estop_sense.png

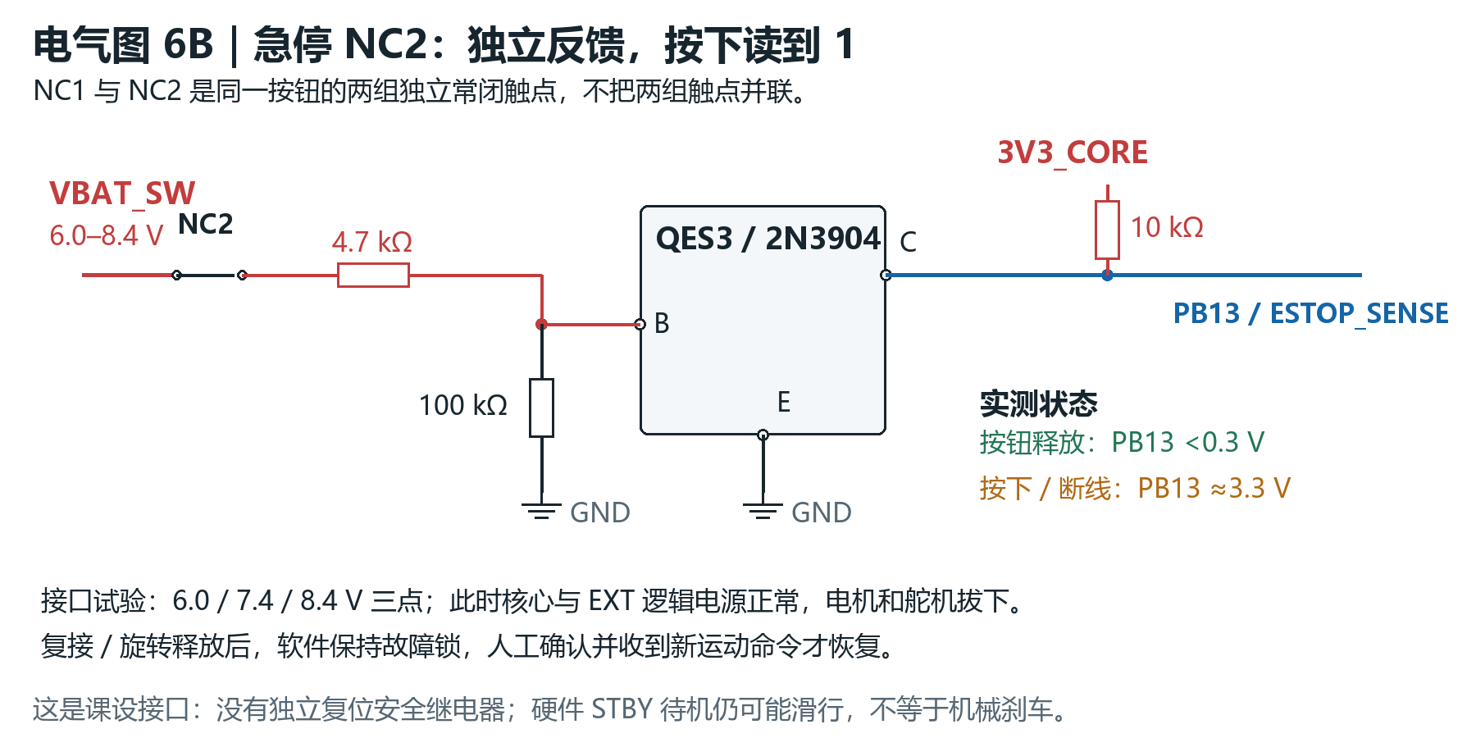
docs/manual/illustrated-source/figures/e06b_estop_sense.png
