Sylphiette666/stm32-rfid-smart-bin/docs/manual/illustrated-source/figures/e07_motor_servo.png

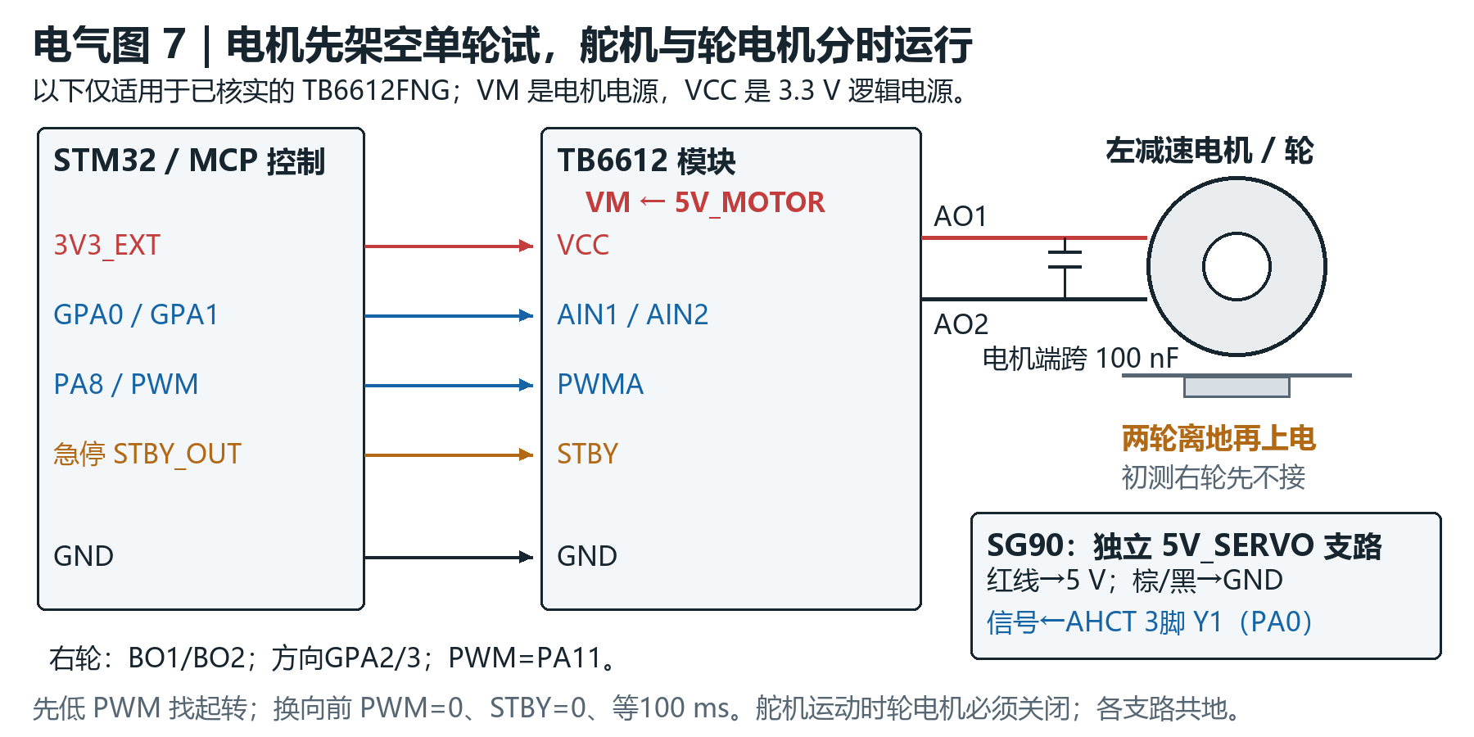
docs/manual/illustrated-source/figures/e07_motor_servo.png
