Sylphiette666/stm32-rfid-smart-bin/docs/manual/illustrated-source/figures/e08_mos_cap.png

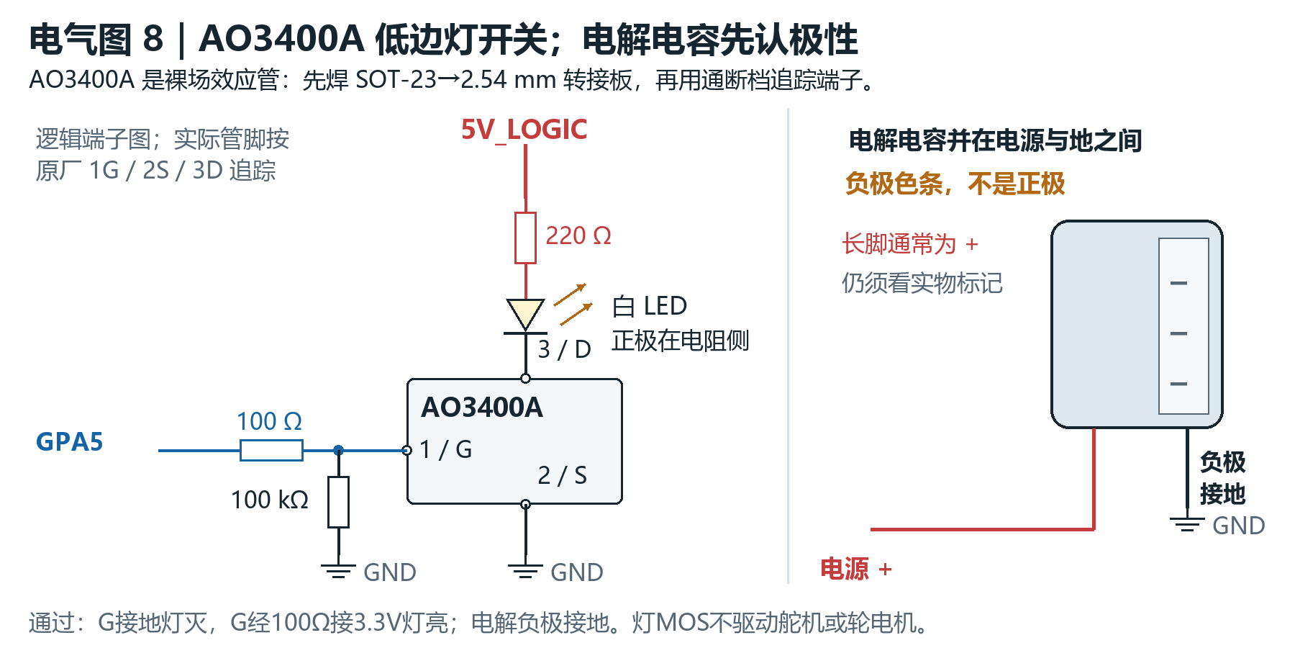
docs/manual/illustrated-source/figures/e08_mos_cap.png
