Sylphiette666/stm32-rfid-smart-bin/docs/manual/illustrated-source/figures/g01_multimeter.png

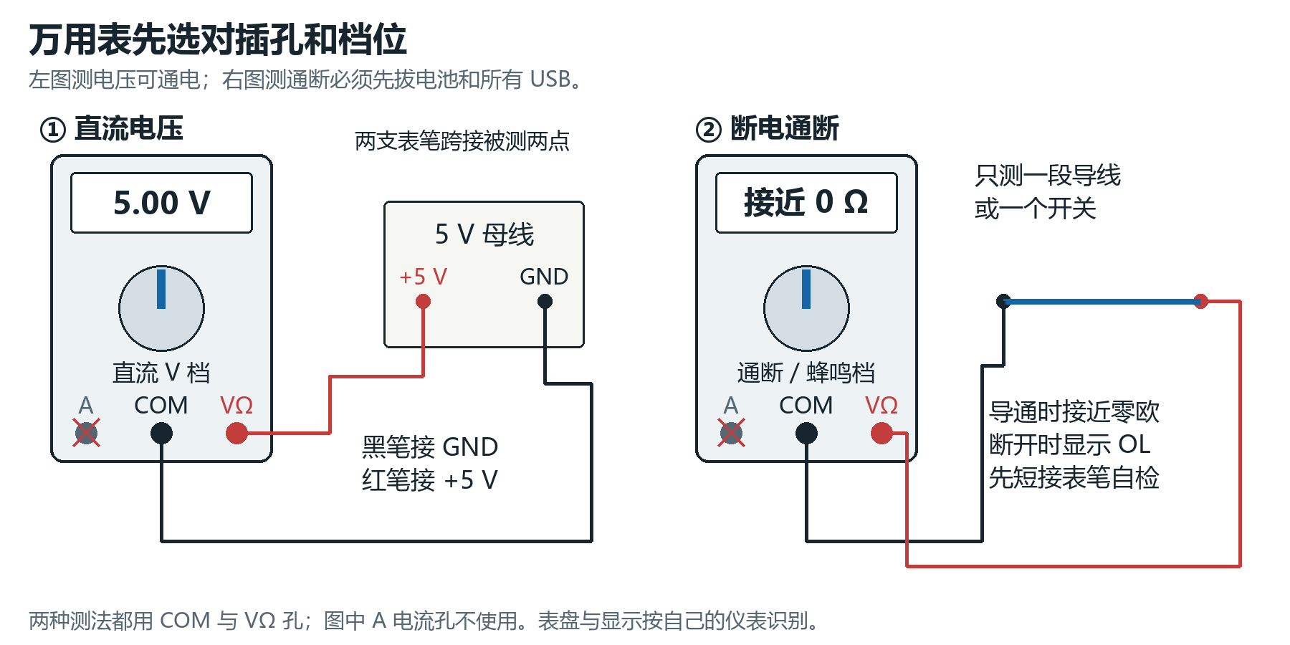
docs/manual/illustrated-source/figures/g01_multimeter.png
