Sylphiette666/stm32-rfid-smart-bin/docs/manual/illustrated-source/figures/g02_wire_terminal.png

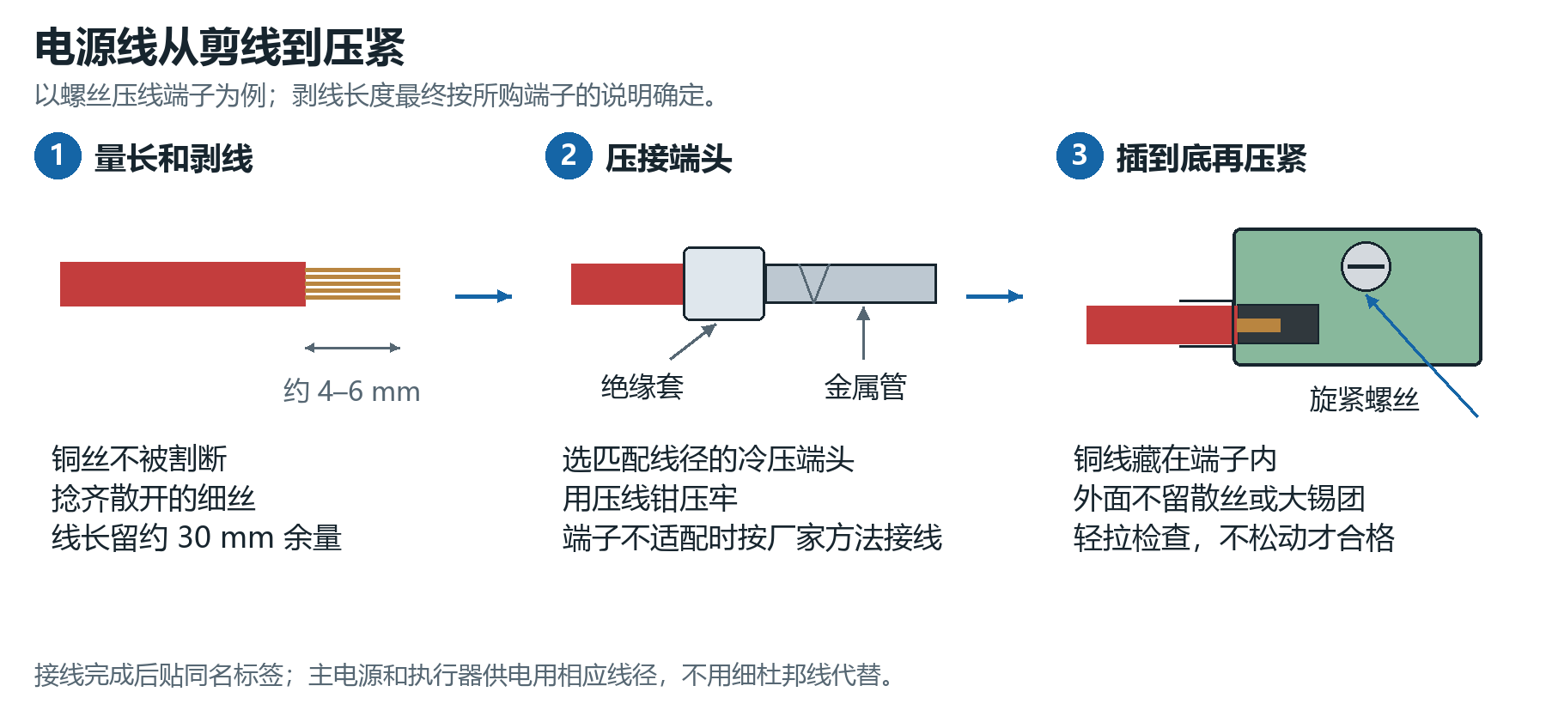
docs/manual/illustrated-source/figures/g02_wire_terminal.png
