Sylphiette666/stm32-rfid-smart-bin/docs/manual/illustrated-source/figures/g03_perfboard.png

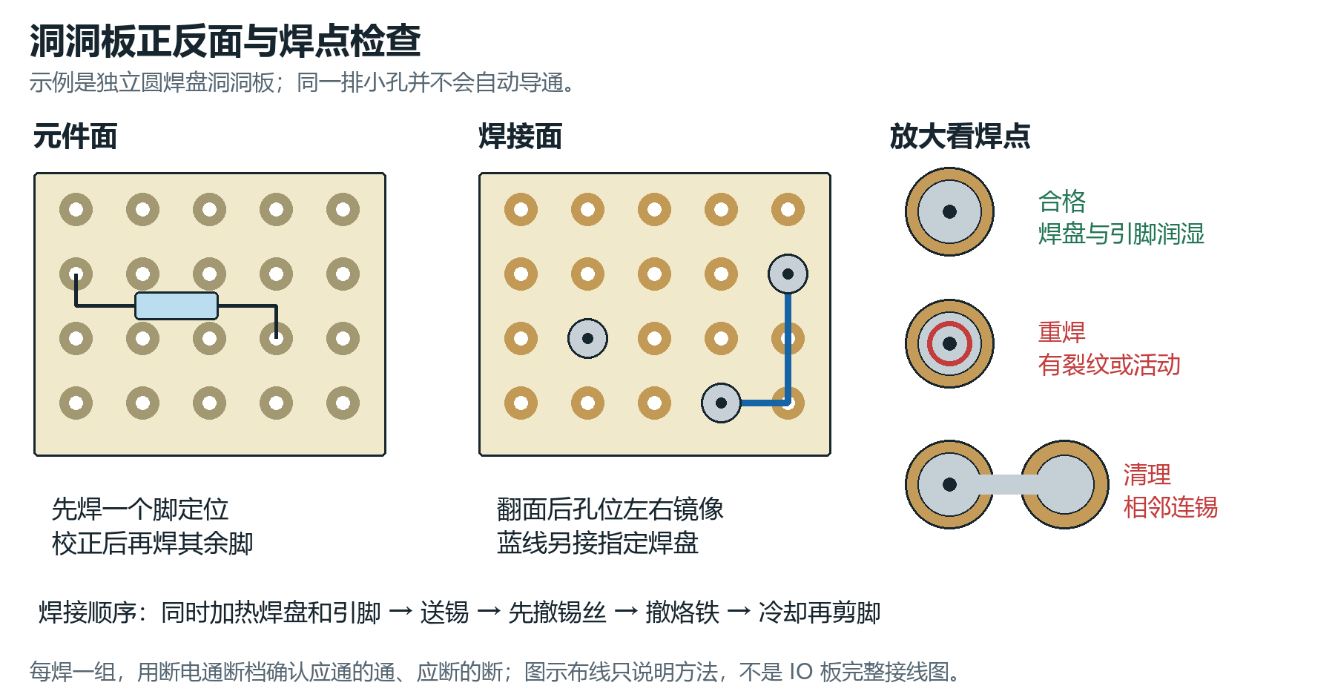
docs/manual/illustrated-source/figures/g03_perfboard.png
