Sylphiette666/stm32-rfid-smart-bin/docs/manual/illustrated-source/figures/g04_voltage_first.png

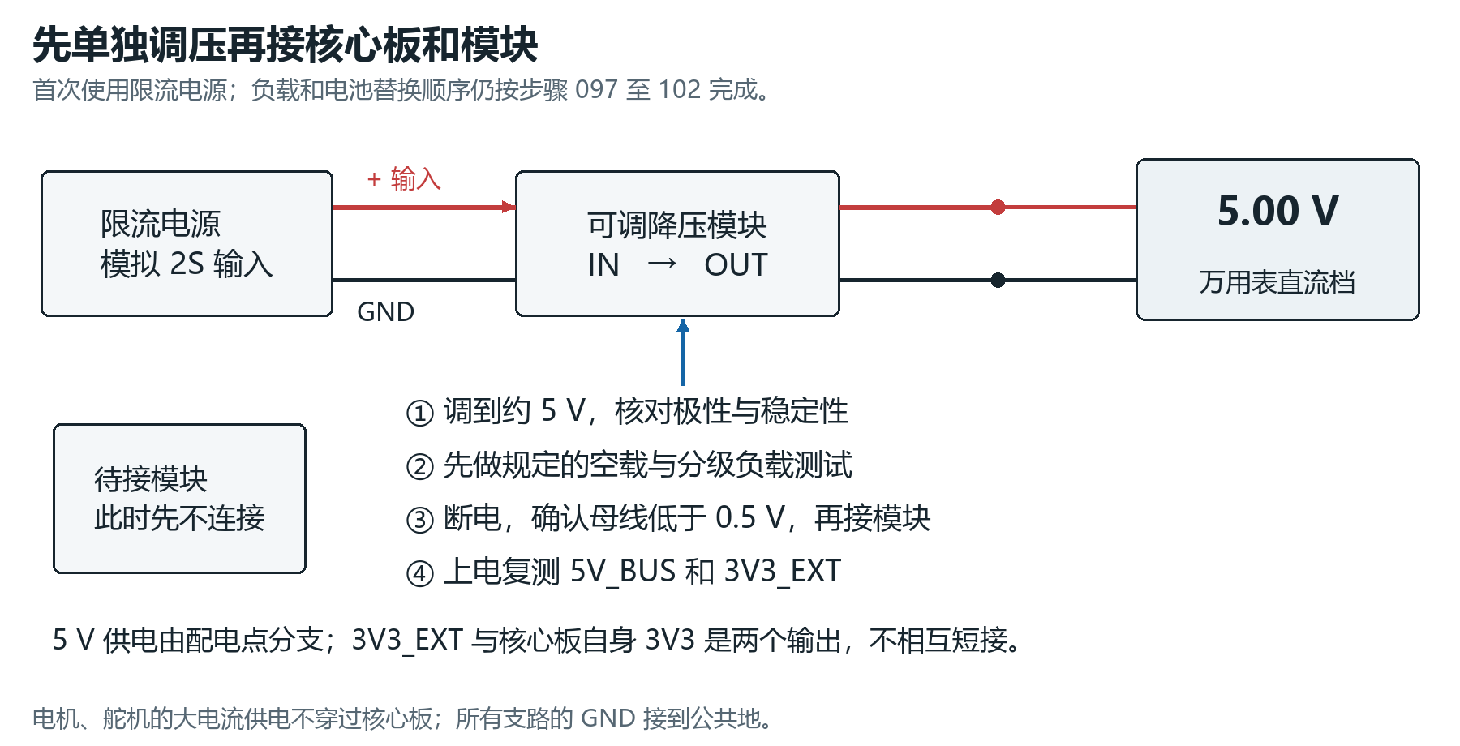
docs/manual/illustrated-source/figures/g04_voltage_first.png
