Sylphiette666/stm32-rfid-smart-bin/docs/manual/illustrated-source/figures/mech01_standoff_stack.png

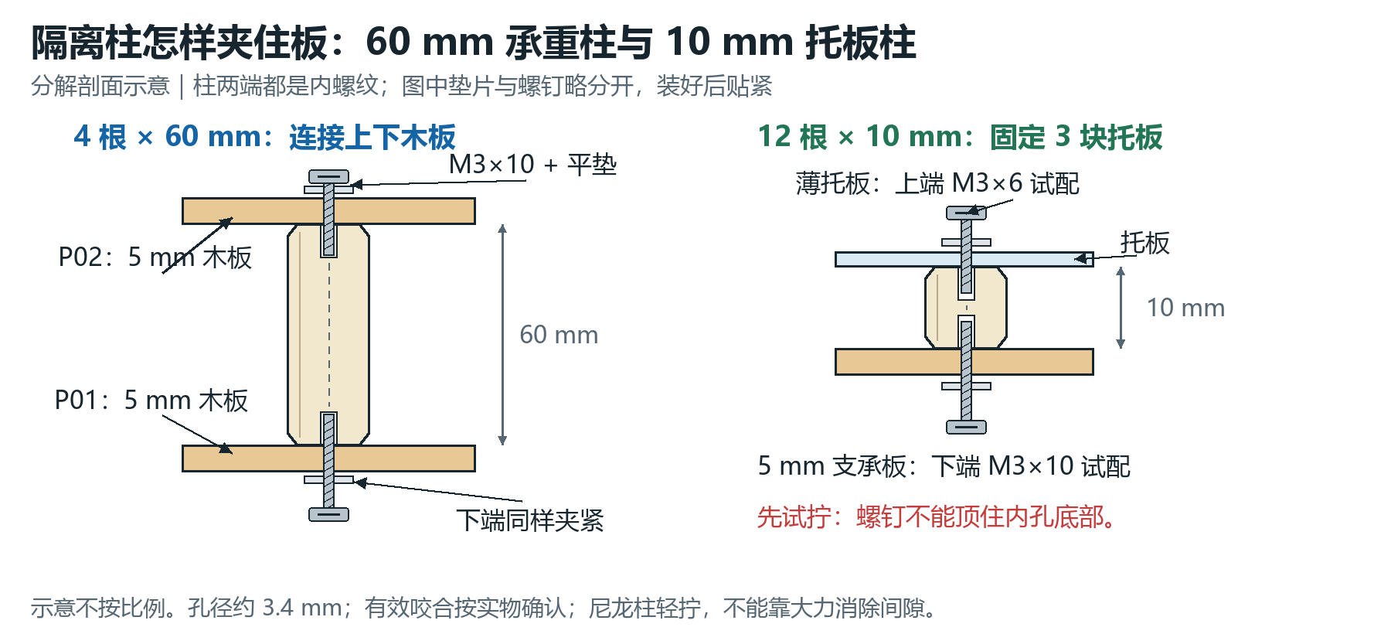
docs/manual/illustrated-source/figures/mech01_standoff_stack.png
