Sylphiette666/stm32-rfid-smart-bin/docs/manual/illustrated-source/figures/mech02_wheel_level.png

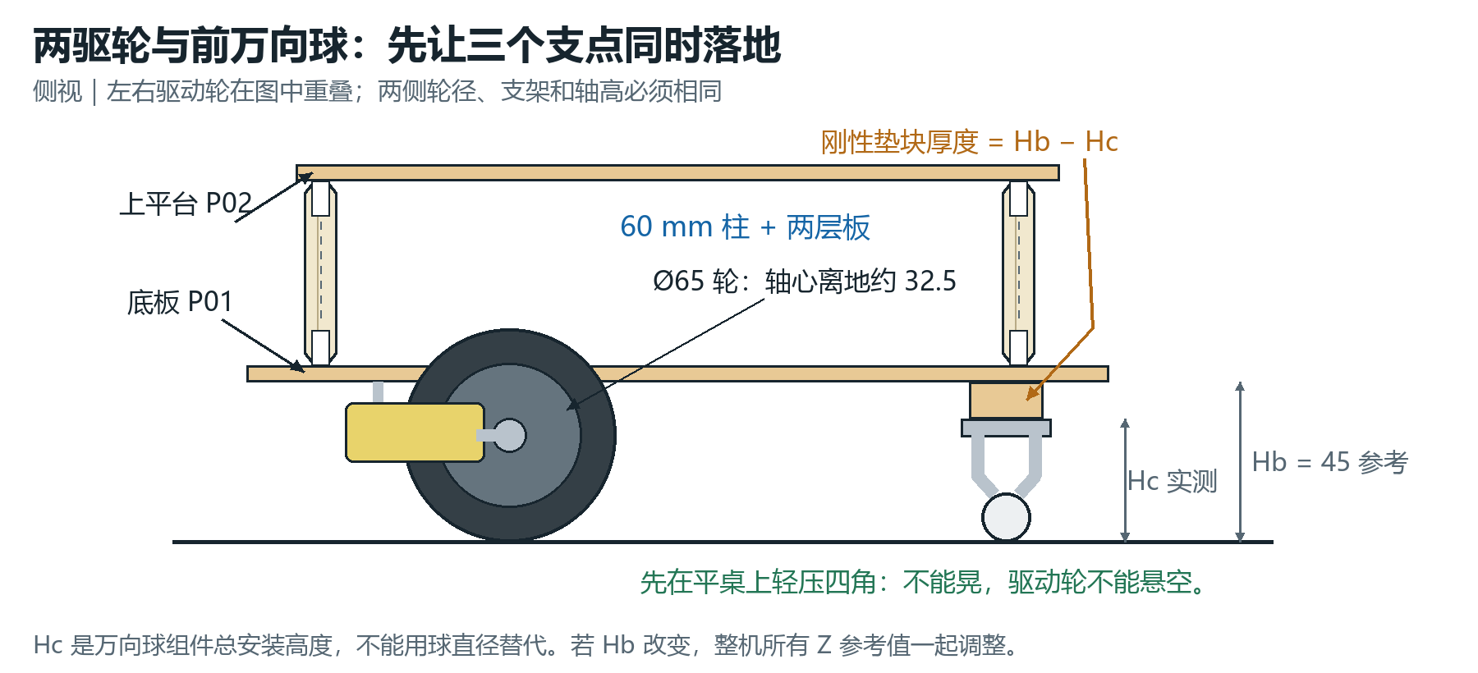
docs/manual/illustrated-source/figures/mech02_wheel_level.png
