Sylphiette666/stm32-rfid-smart-bin/docs/manual/illustrated-source/figures/mech03_pvc_shell.png

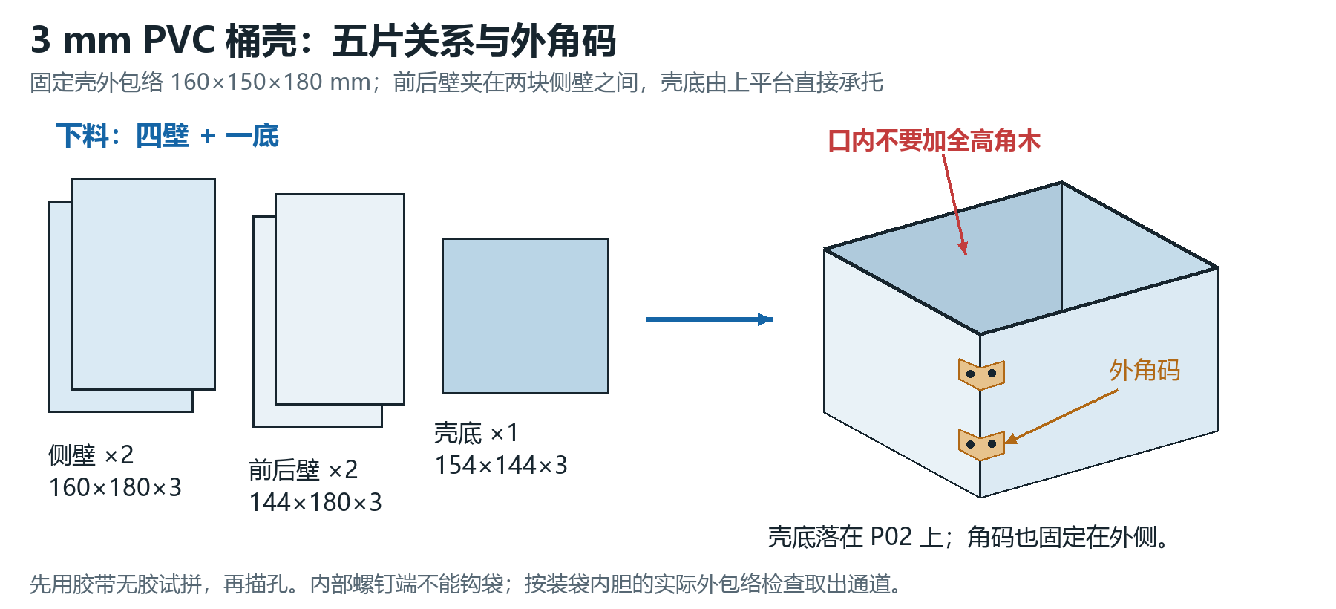
docs/manual/illustrated-source/figures/mech03_pvc_shell.png
