Sylphiette666/stm32-rfid-smart-bin/docs/manual/illustrated-source/figures/mech04_pp_ties_bag_clearance.png

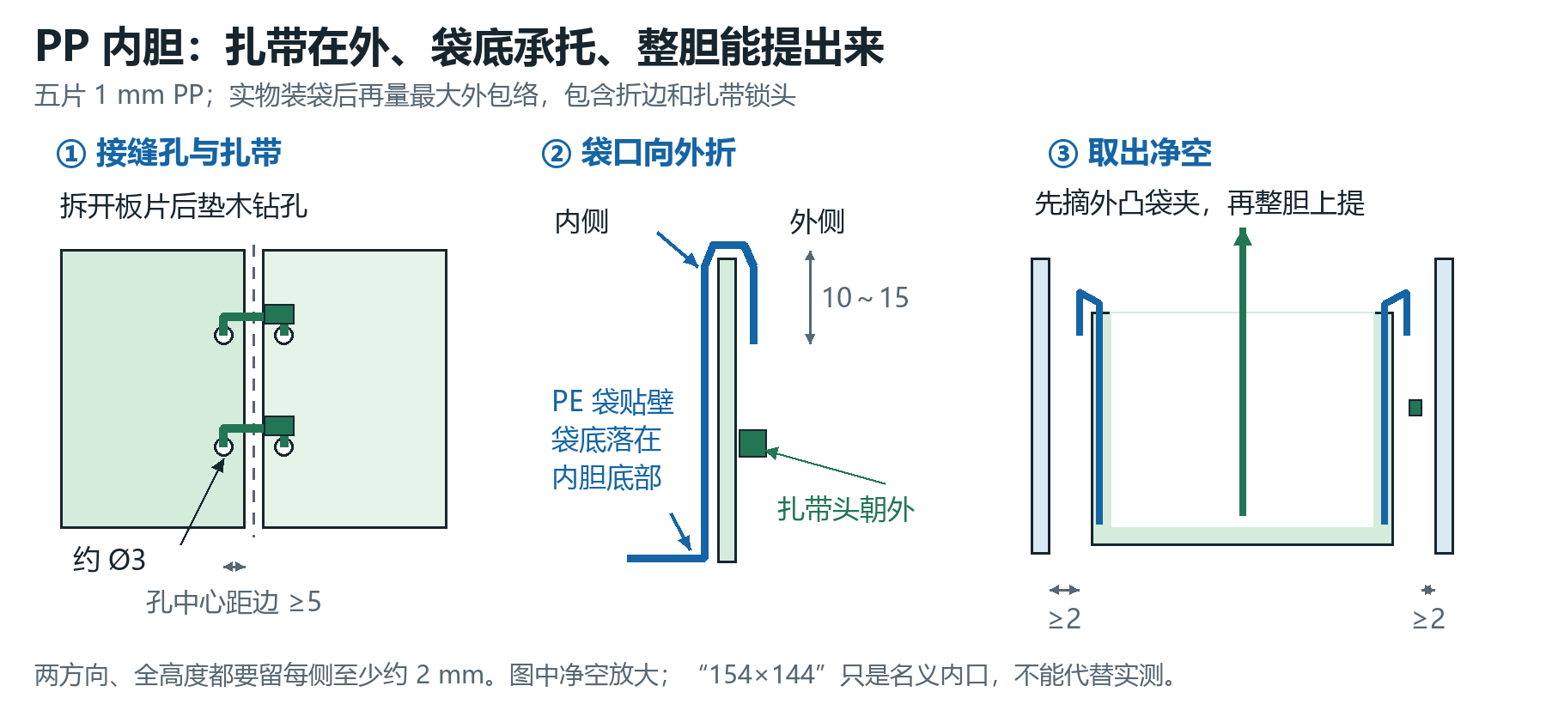
docs/manual/illustrated-source/figures/mech04_pp_ties_bag_clearance.png
