Sylphiette666/stm32-rfid-smart-bin/docs/manual/illustrated-source/figures/mech05_lid_weight.png

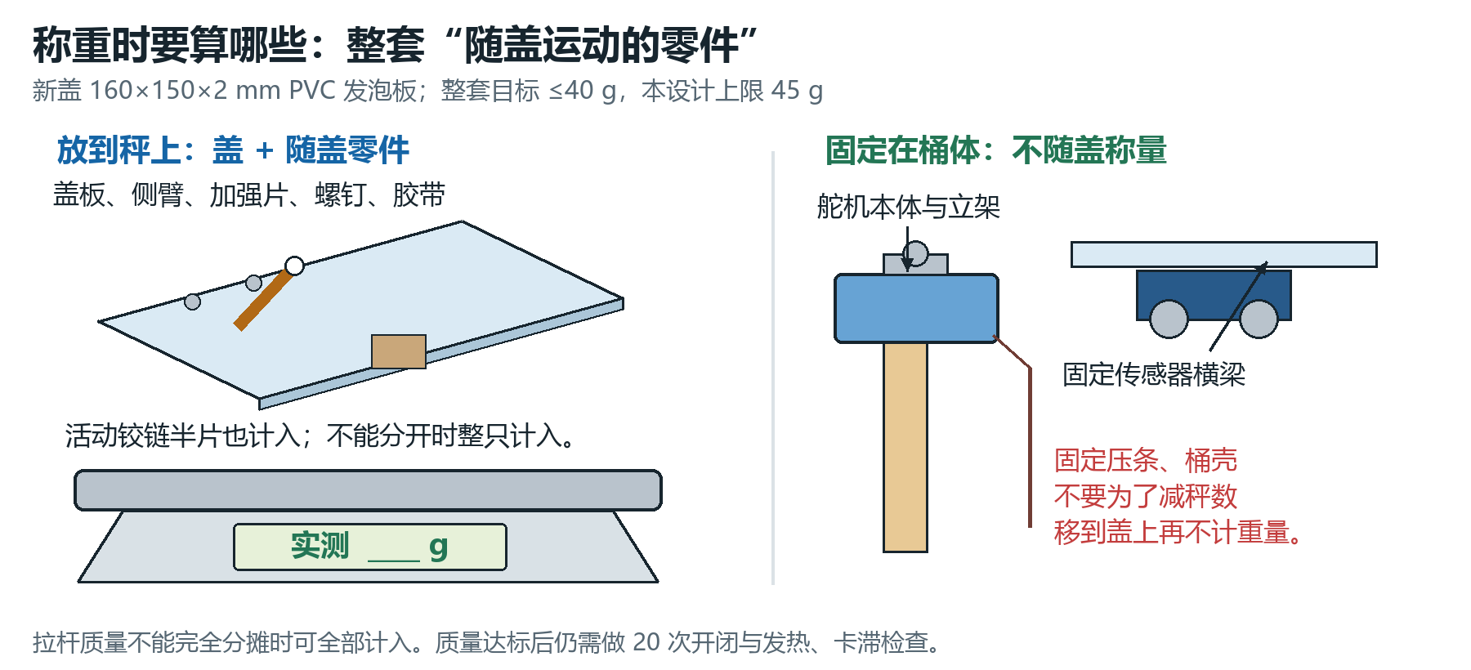
docs/manual/illustrated-source/figures/mech05_lid_weight.png
