Sylphiette666/stm32-rfid-smart-bin/docs/manual/illustrated-source/figures/mech06_linkage_joint.png

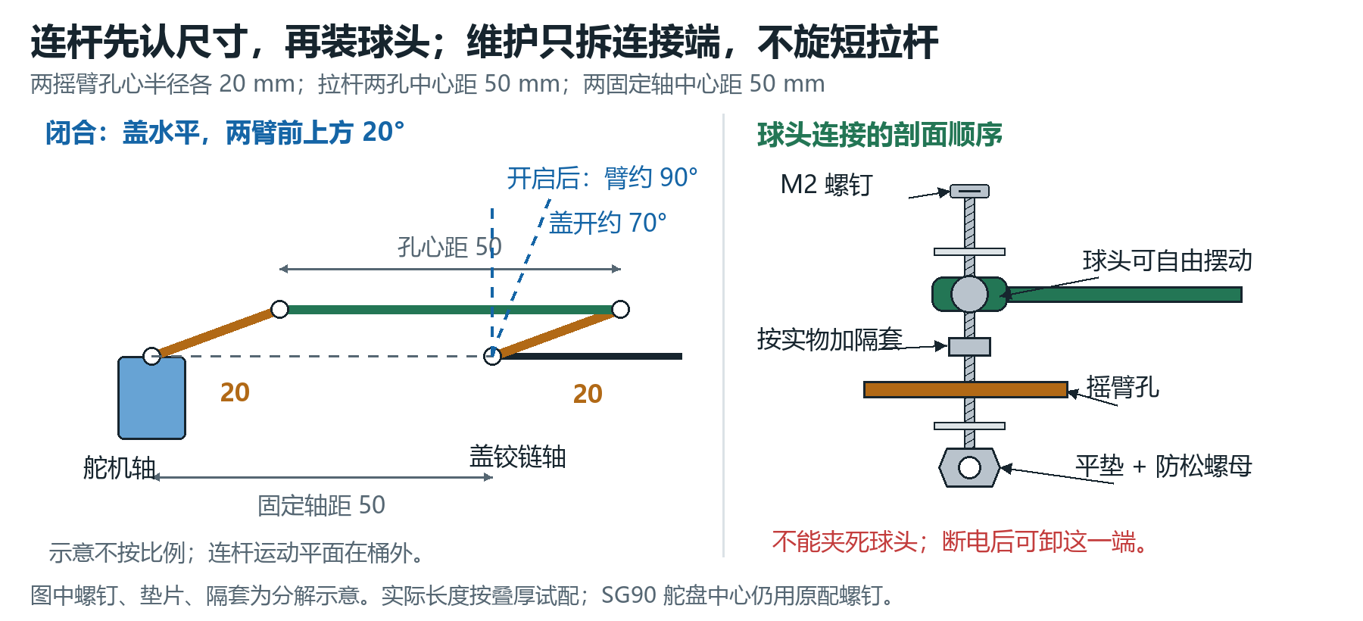
docs/manual/illustrated-source/figures/mech06_linkage_joint.png
