Sylphiette666/stm32-rfid-smart-bin/docs/manual/illustrated-source/figures/mech07_sensor_height.png

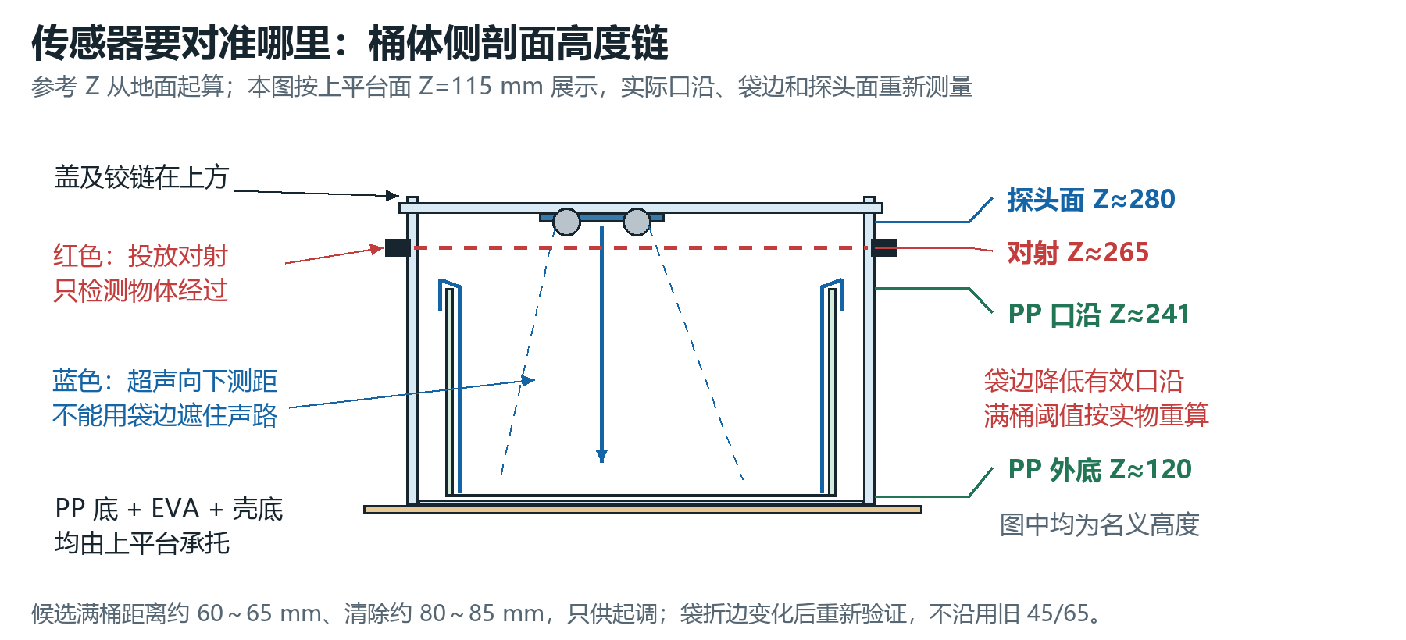
docs/manual/illustrated-source/figures/mech07_sensor_height.png
