Sylphiette666/stm32-rfid-smart-bin/docs/manual/illustrated-source/figures/mech08_maintenance_four_steps.png

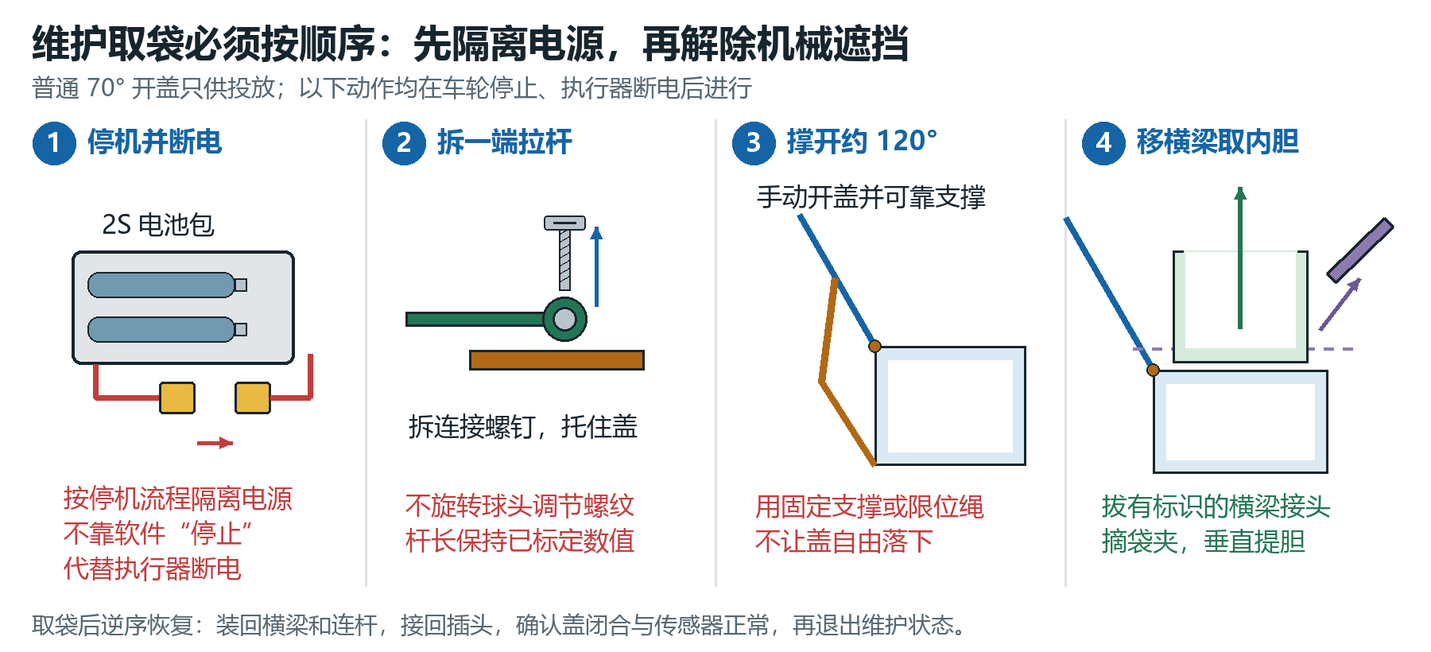
docs/manual/illustrated-source/figures/mech08_maintenance_four_steps.png
