Sylphiette666/stm32-rfid-smart-bin/docs/manual/illustrated-source/figures/s02_pwm_compare.png

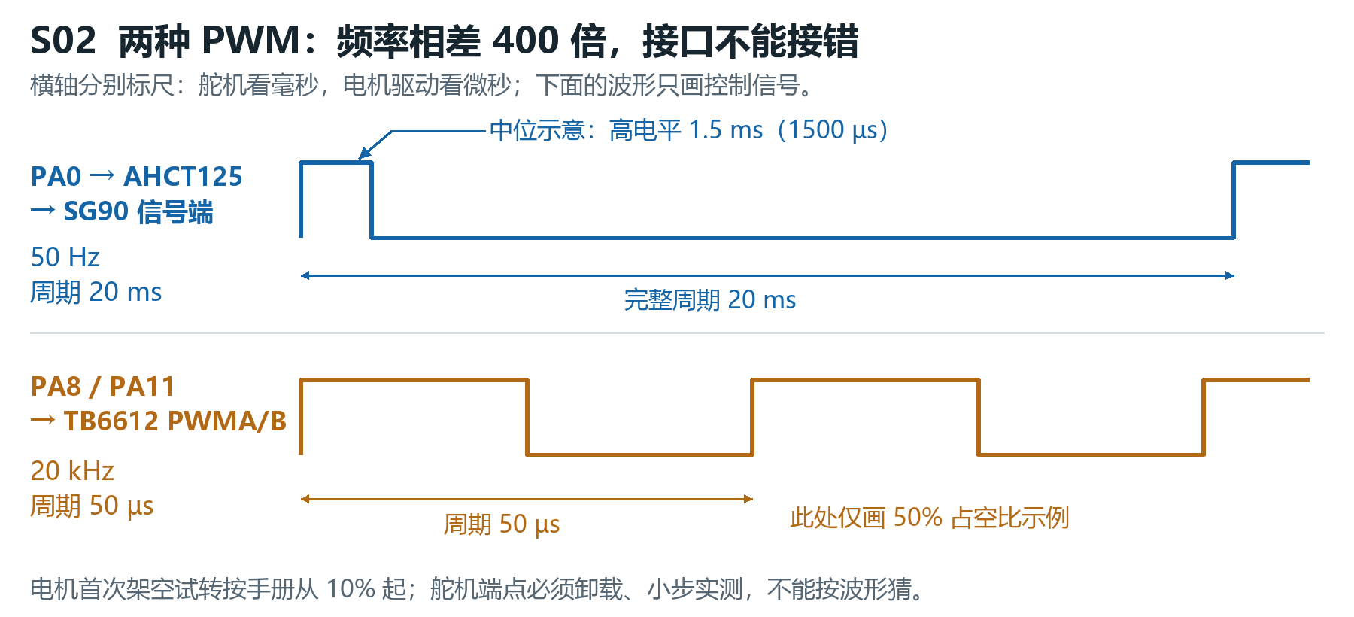
docs/manual/illustrated-source/figures/s02_pwm_compare.png
