Sylphiette666/stm32-rfid-smart-bin/docs/manual/illustrated-source/figures/s03_rfid_session.png

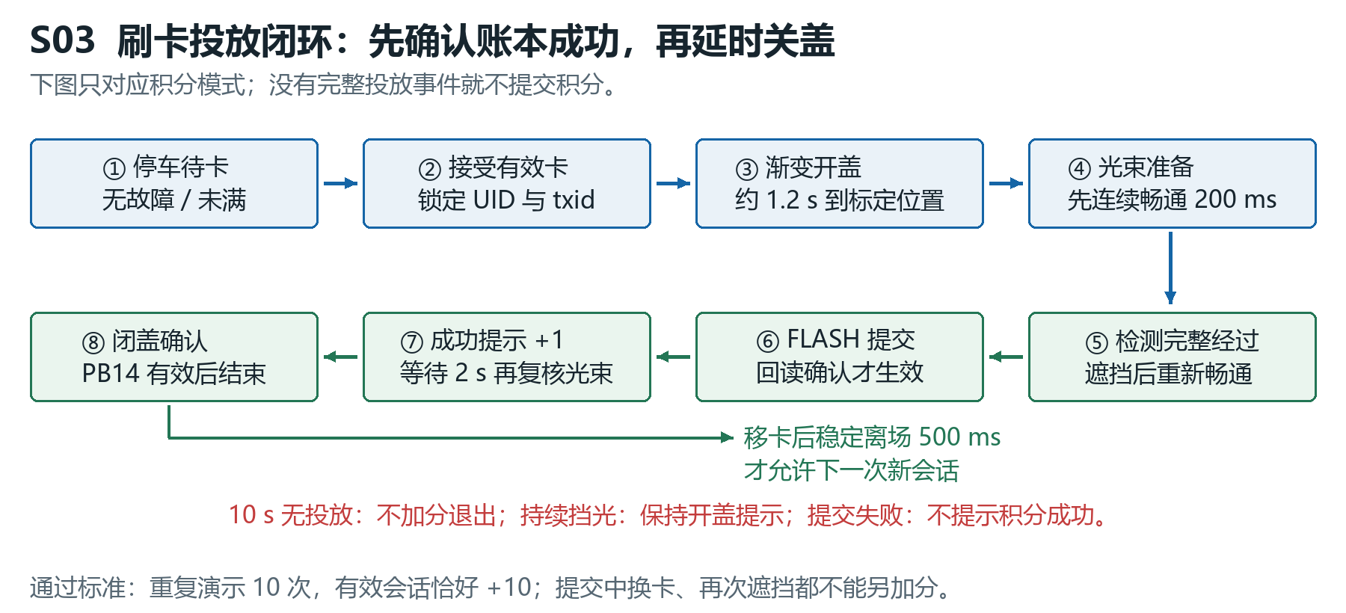
docs/manual/illustrated-source/figures/s03_rfid_session.png
