Sylphiette666/stm32-rfid-smart-bin/docs/manual/illustrated-source/figures/s04_deposit_timing.png

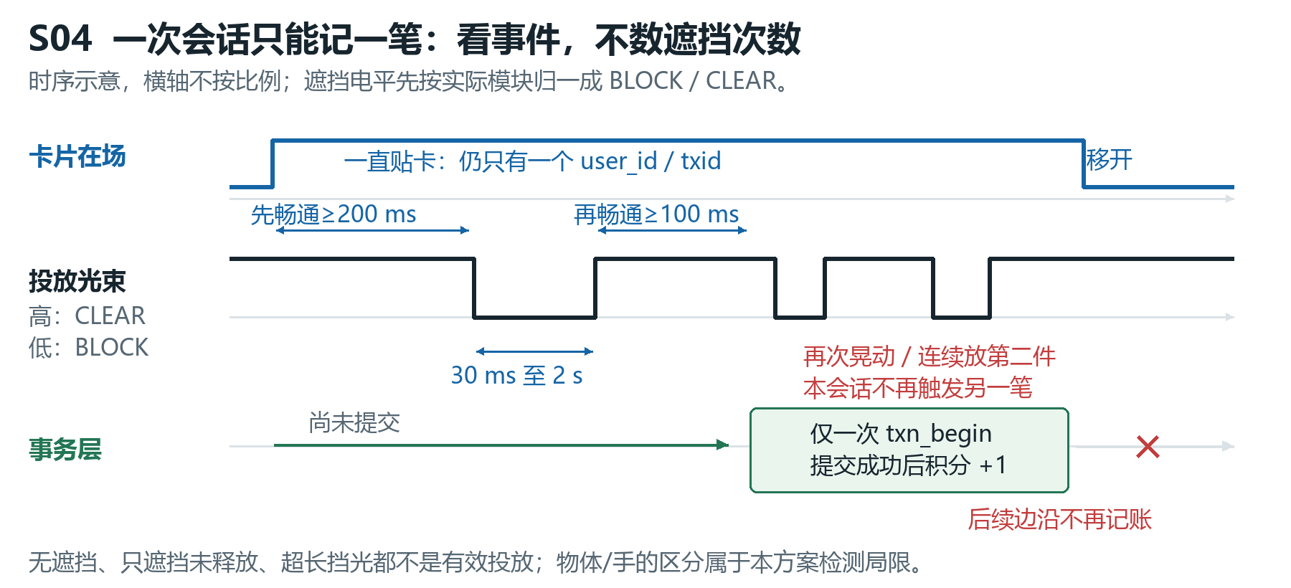
docs/manual/illustrated-source/figures/s04_deposit_timing.png
