Sylphiette666/stm32-rfid-smart-bin/docs/manual/illustrated-source/figures/s06_stop_latch.png

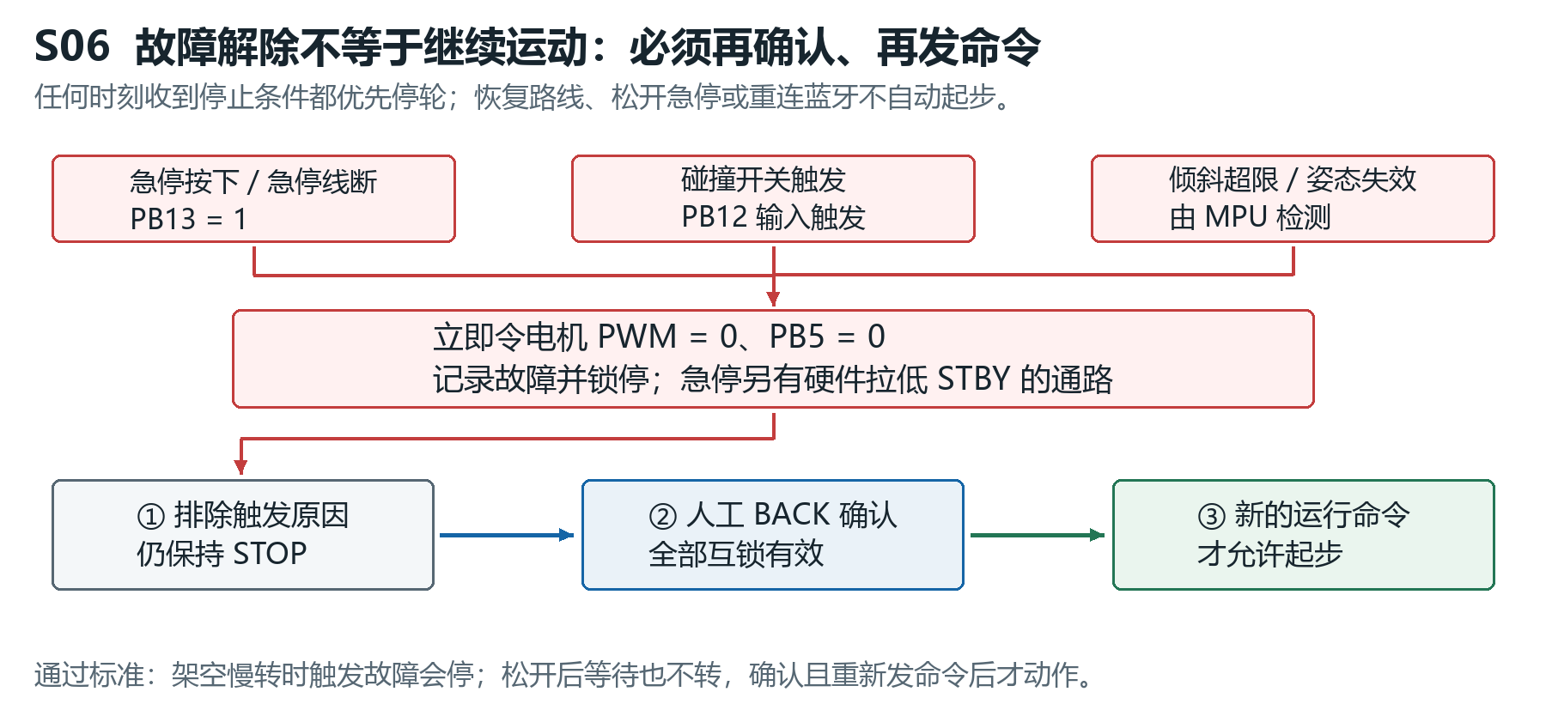
docs/manual/illustrated-source/figures/s06_stop_latch.png
