Sylphiette666/stm32-rfid-smart-bin/docs/manual/illustrated-source/figures/s07_line_stations.png

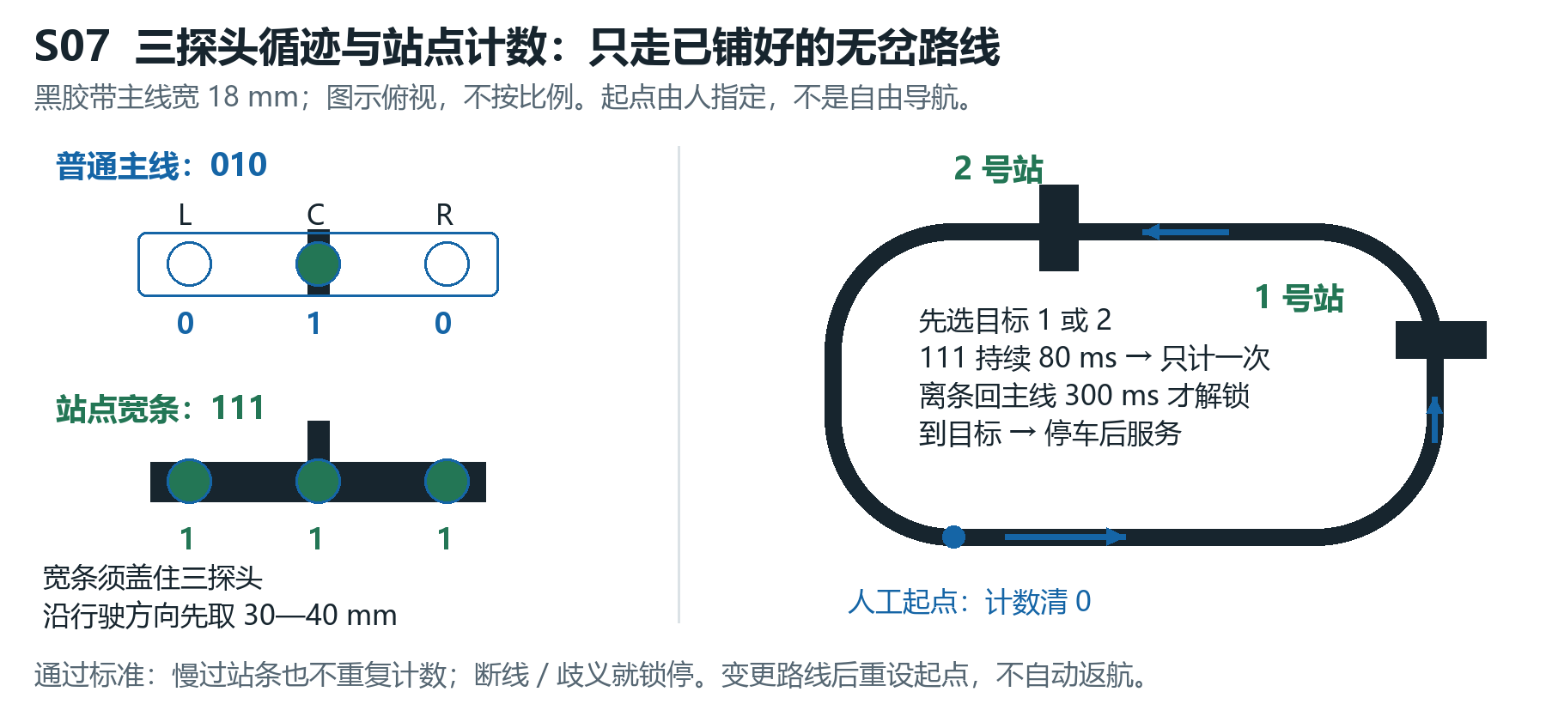
docs/manual/illustrated-source/figures/s07_line_stations.png
