Sylphiette666/stm32-rfid-smart-bin/docs/manual/illustrated-source/figures/s08_flash_recovery.png

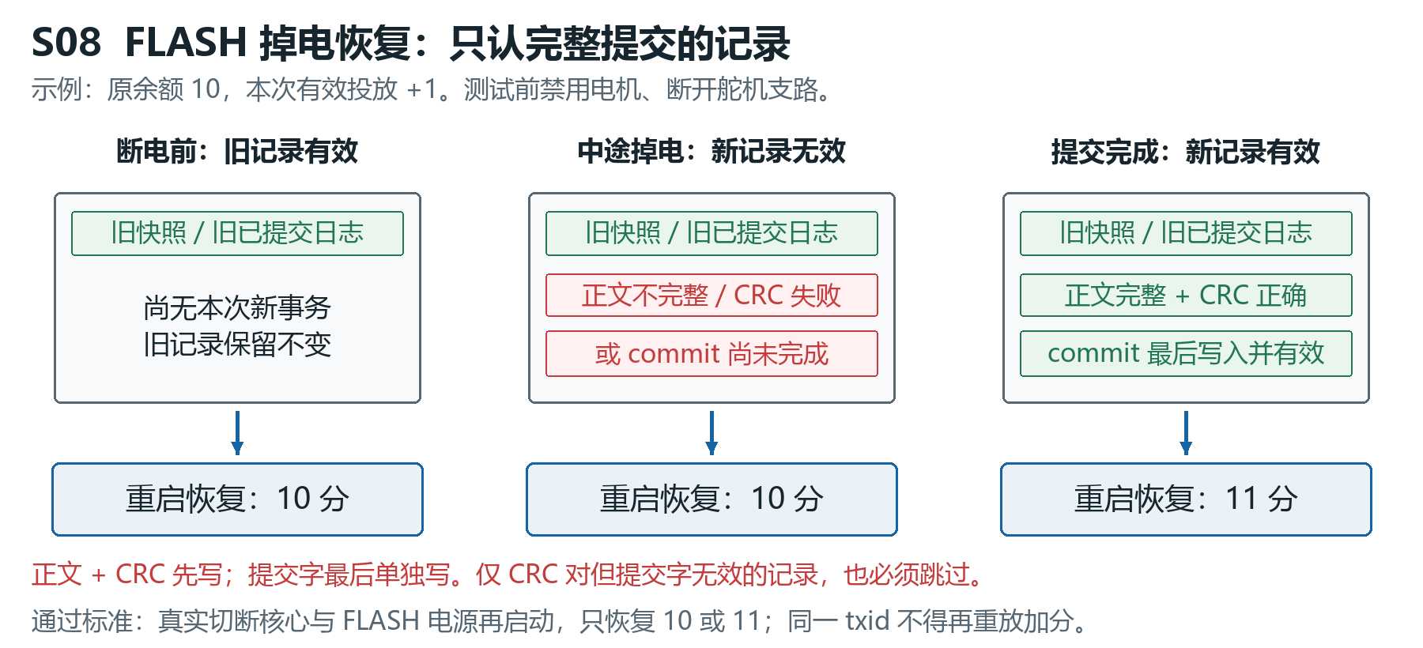
docs/manual/illustrated-source/figures/s08_flash_recovery.png
