Sylphiette666/stm32-rfid-smart-bin/docs/manual/pcb-a-update-20261012/contact-169-180.png

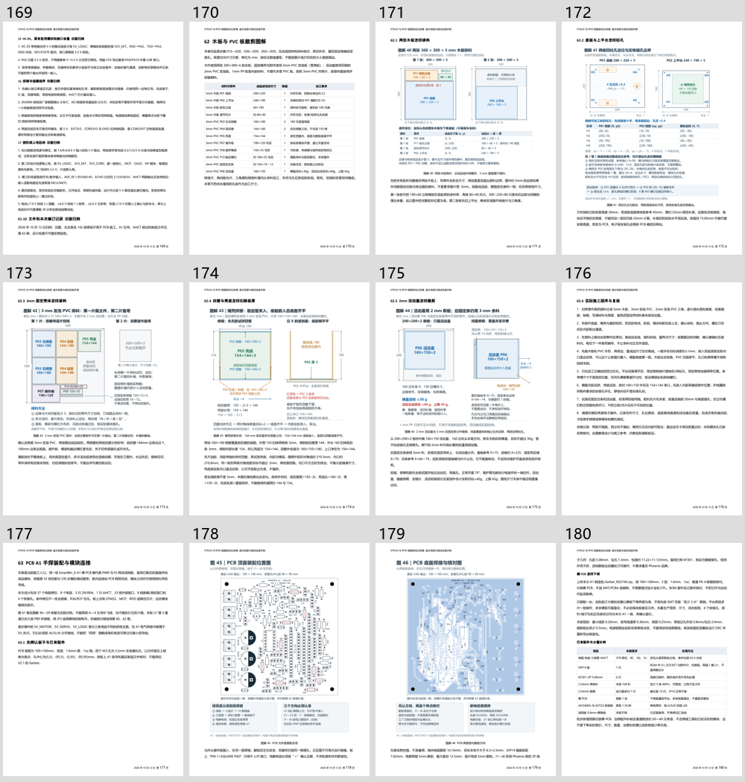
docs/manual/pcb-a-update-20261012/contact-169-180.png
