Sylphiette666/stm32-rfid-smart-bin/docs/manual/pcb-a-update-20261012/contact-193-198.png

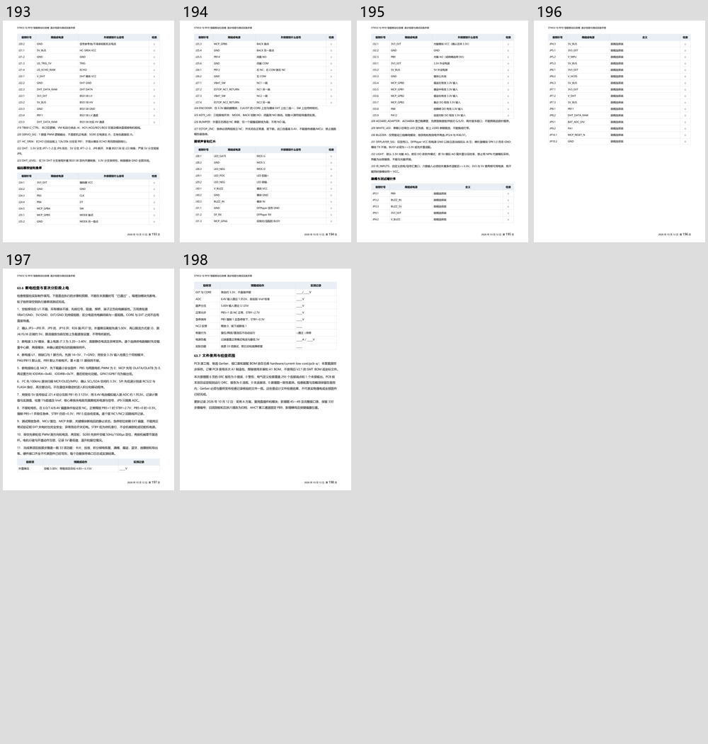
docs/manual/pcb-a-update-20261012/contact-193-198.png
