Sylphiette666/stm32-rfid-smart-bin/docs/manual/pcb-b-update-20261103/final-page-259.png

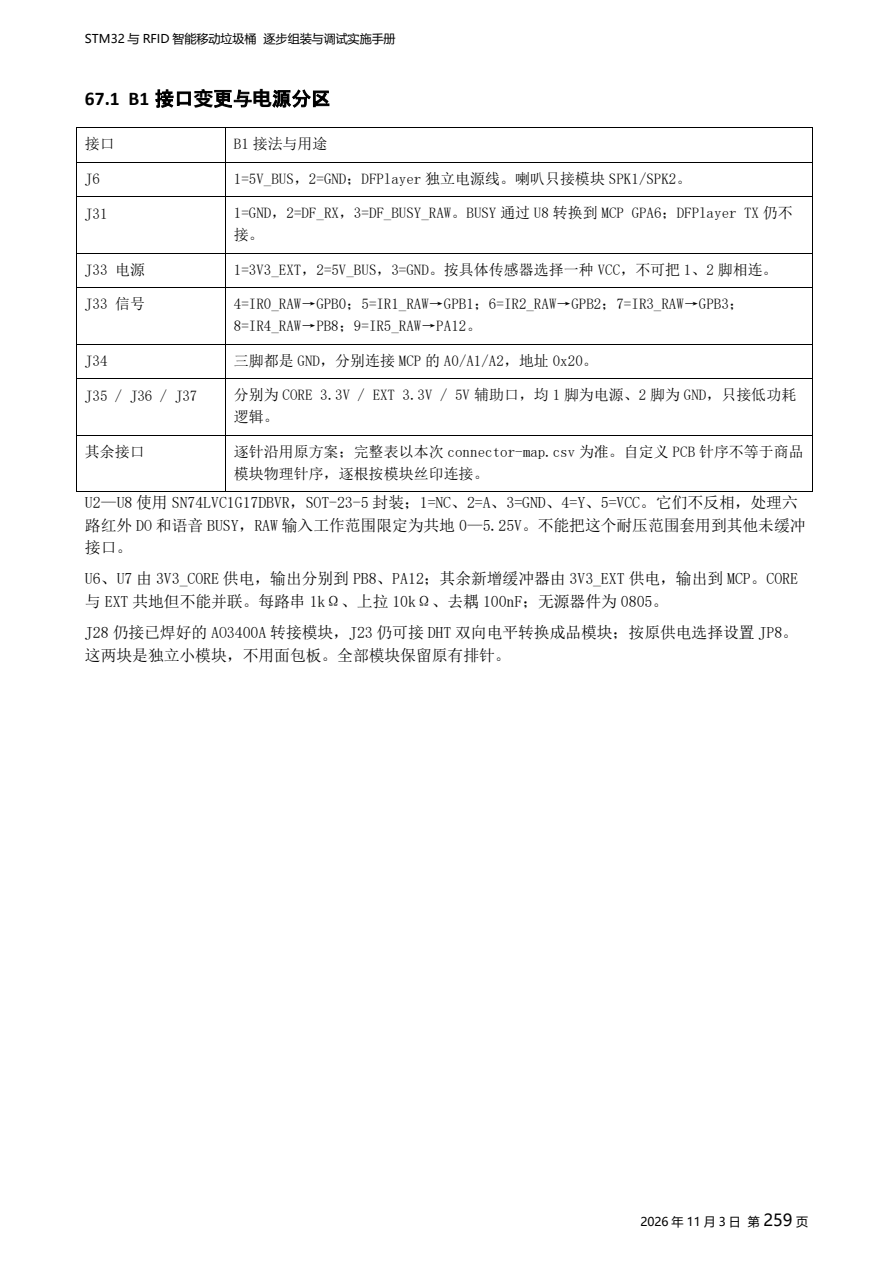
docs/manual/pcb-b-update-20261103/final-page-259.png
