Sylphiette666/stm32-rfid-smart-bin/hardware/current-low-cost/pcb-a/review/board-assembly-top.png

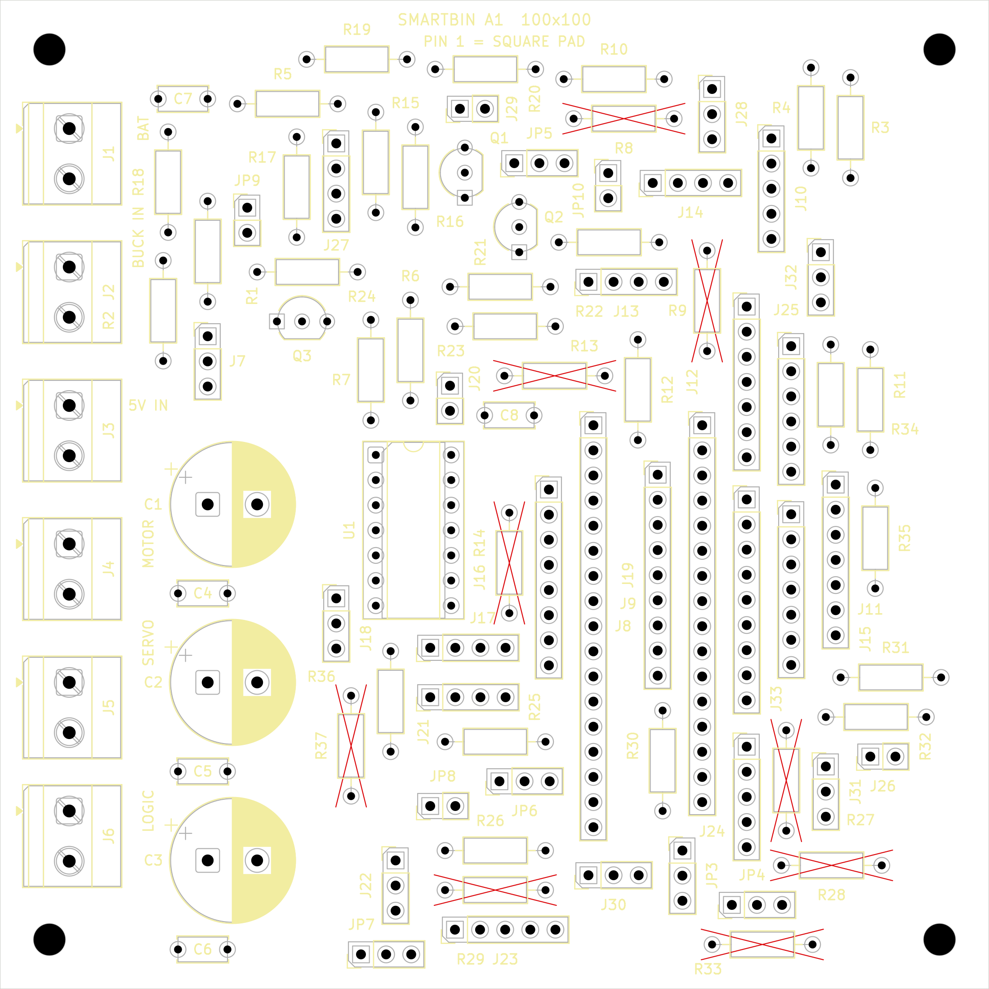
hardware/current-low-cost/pcb-a/review/board-assembly-top.png
