Sylphiette666/stm32-rfid-smart-bin/hardware/current-low-cost/pcb-a/review/board-bottom-solder.png

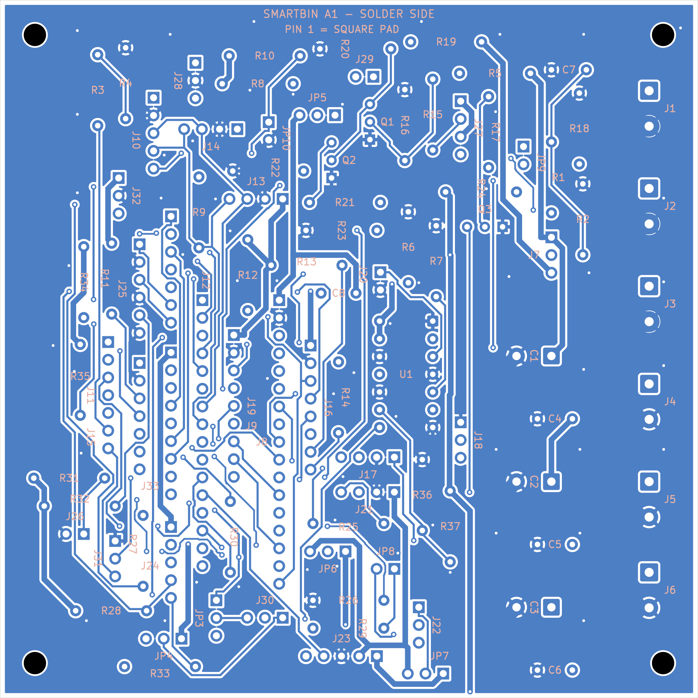
hardware/current-low-cost/pcb-a/review/board-bottom-solder.png
