Sylphiette666/stm32-rfid-smart-bin/hardware/current-low-cost/pcb-b/diagrams/servo/servo_wiring.png

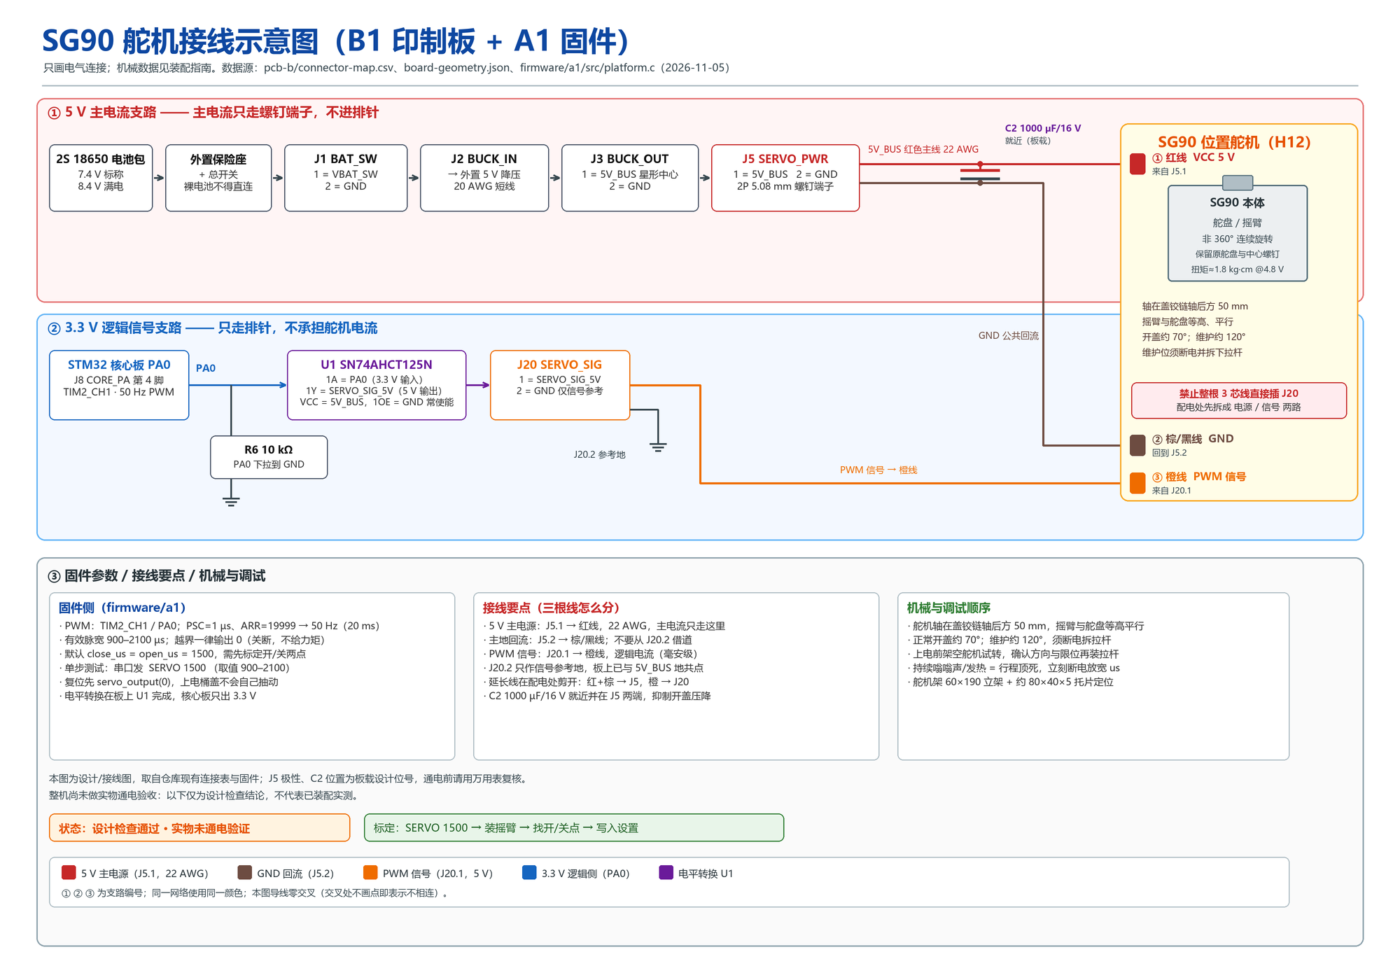
hardware/current-low-cost/pcb-b/diagrams/servo/servo_wiring.png
