Sylphiette666/stm32-rfid-smart-bin/hardware/mechanical/print-backup/accessories-plate-20261105/preview/accessories_31_plate.png

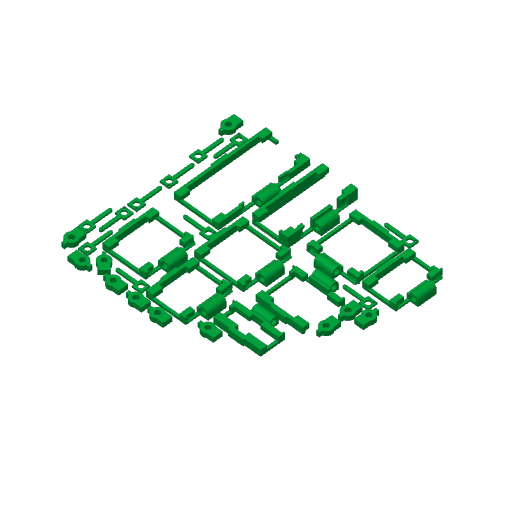
hardware/mechanical/print-backup/accessories-plate-20261105/preview/accessories_31_plate.png
