Sylphiette666/stm32-rfid-smart-bin/hardware/mechanical/print-backup/body-after-accessories-20261101/preview/07_plate1_bed.png

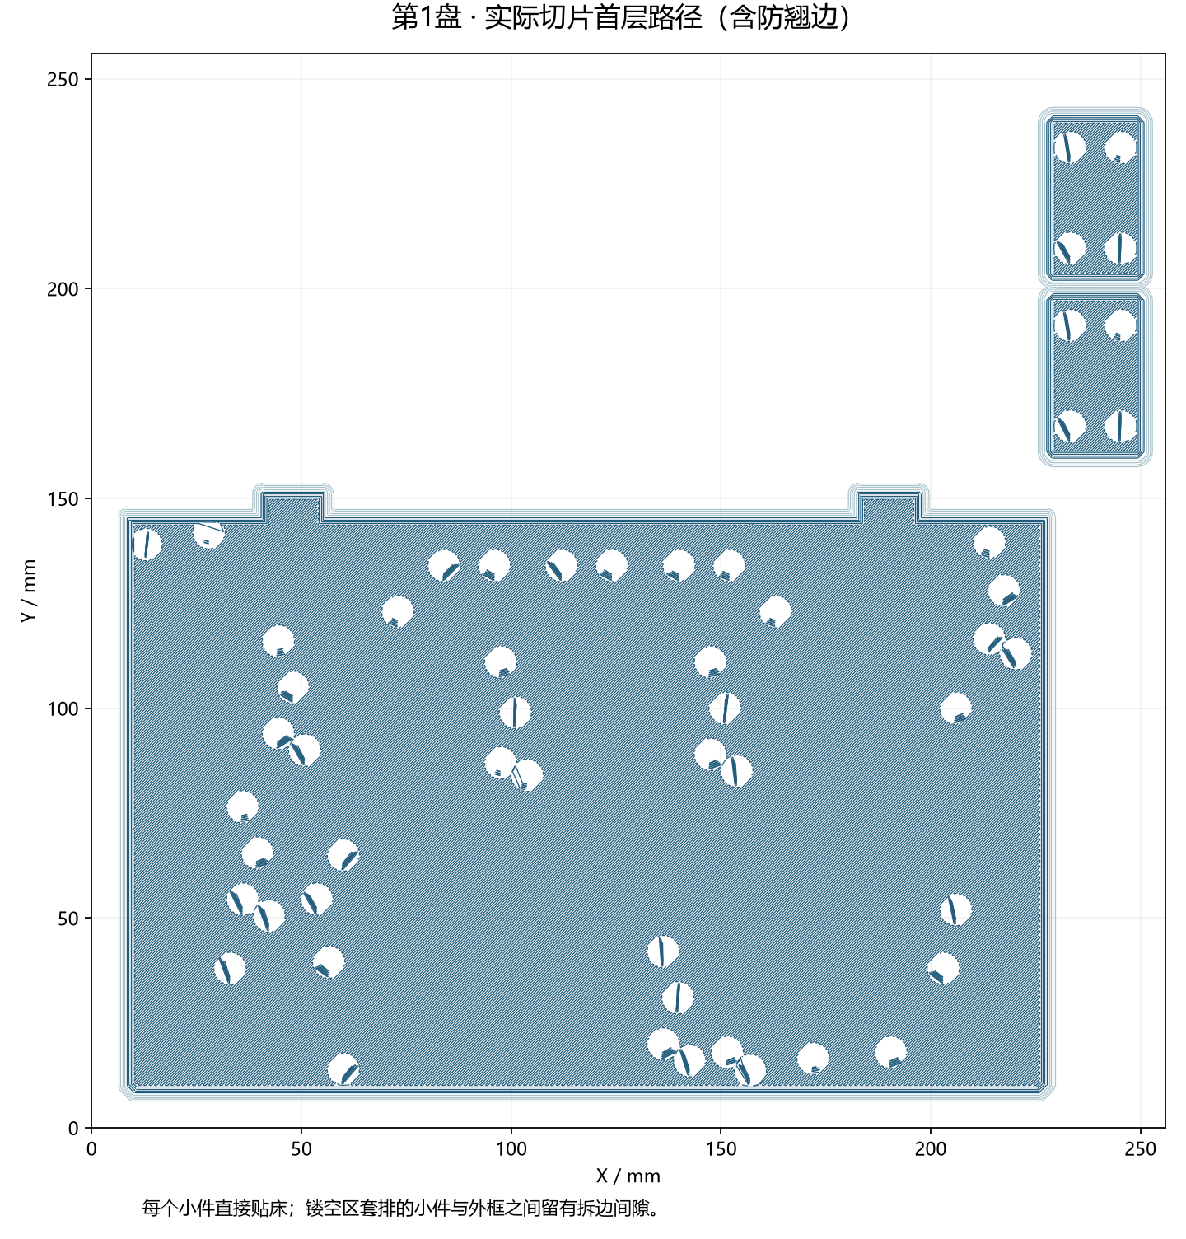
hardware/mechanical/print-backup/body-after-accessories-20261101/preview/07_plate1_bed.png
