Sylphiette666/stm32-rfid-smart-bin/hardware/mechanical/print-backup/caster-spacer-20261105/preview/H4_top.png

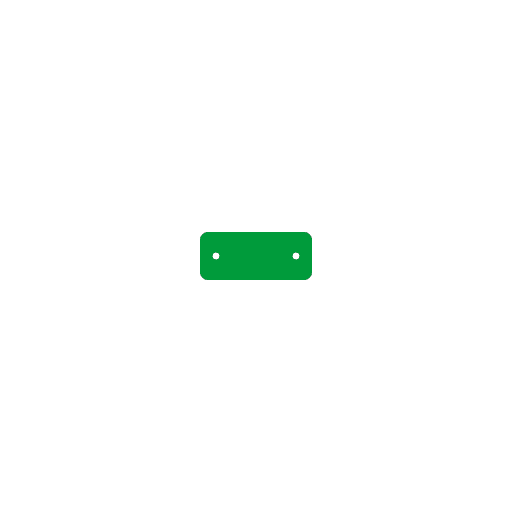
hardware/mechanical/print-backup/caster-spacer-20261105/preview/H4_top.png
