Sylphiette666/stm32-rfid-smart-bin/hardware/mechanical/print-backup/flat-split-20261101/preview/10_plate3_bed.png

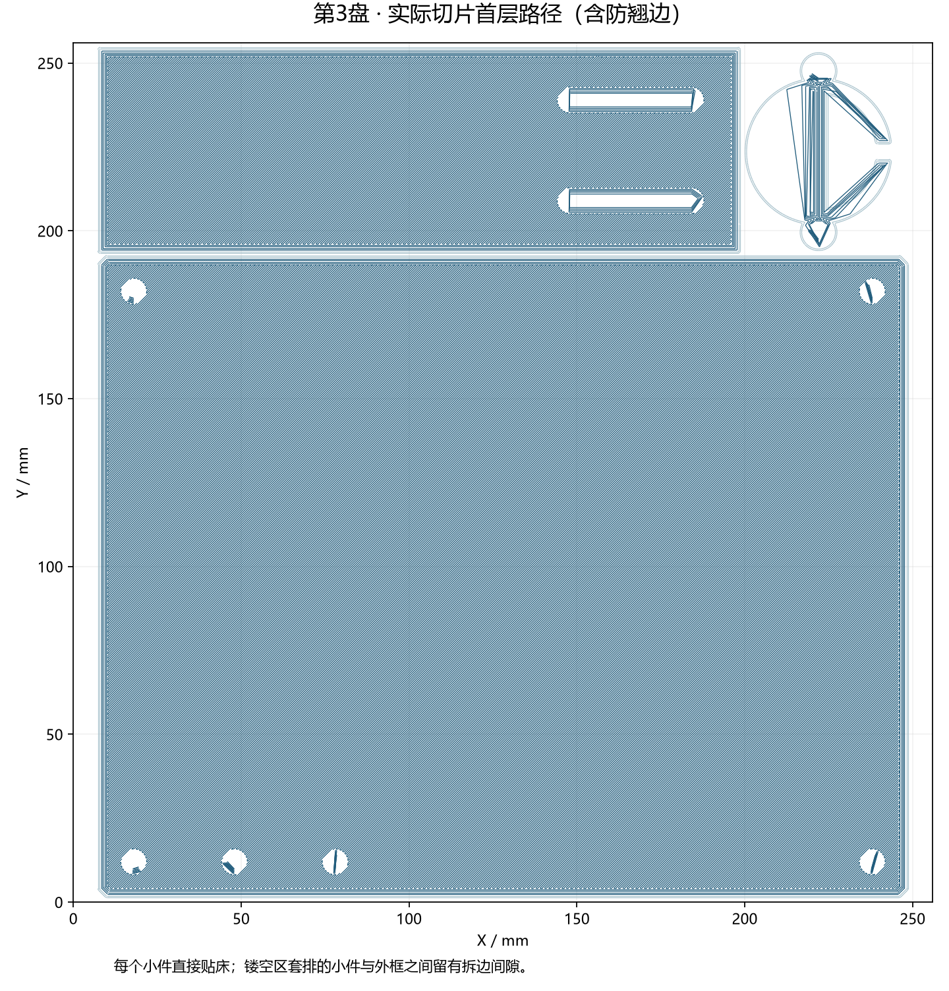
hardware/mechanical/print-backup/flat-split-20261101/preview/10_plate3_bed.png
