Sylphiette666/stm32-rfid-smart-bin/hardware/mechanical/print-backup/integrated-pla-20261104/preview/first_layer_UPPER_INTEGRATED.png

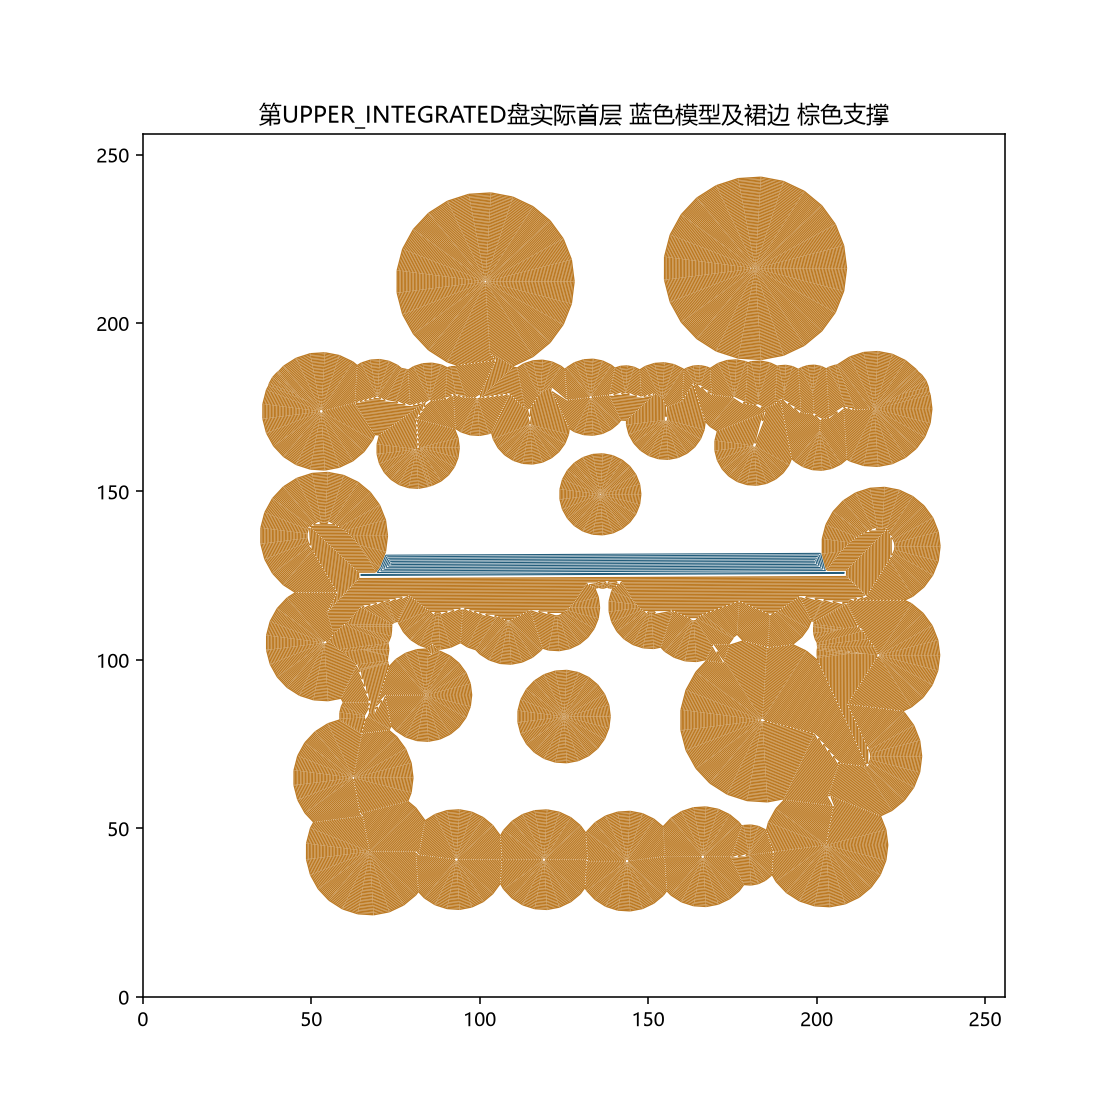
hardware/mechanical/print-backup/integrated-pla-20261104/preview/first_layer_UPPER_INTEGRATED.png
