Sylphiette666/stm32-rfid-smart-bin/hardware/mechanical/print-backup/integrated-pla-20261104/preview/LOWER_H41_B1_print_orientation.png

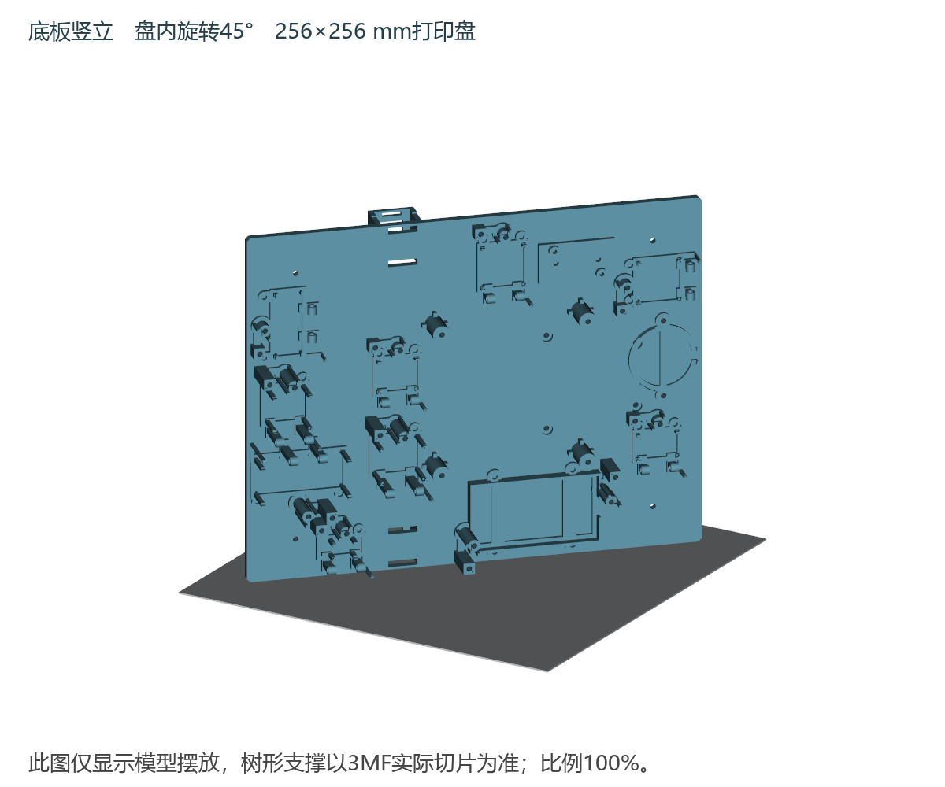
hardware/mechanical/print-backup/integrated-pla-20261104/preview/LOWER_H41_B1_print_orientation.png
