Sylphiette666/stm32-rfid-smart-bin/hardware/mechanical/print-backup/integrated-pla-20261104/preview/UPPER_INTEGRATED_bottom.png

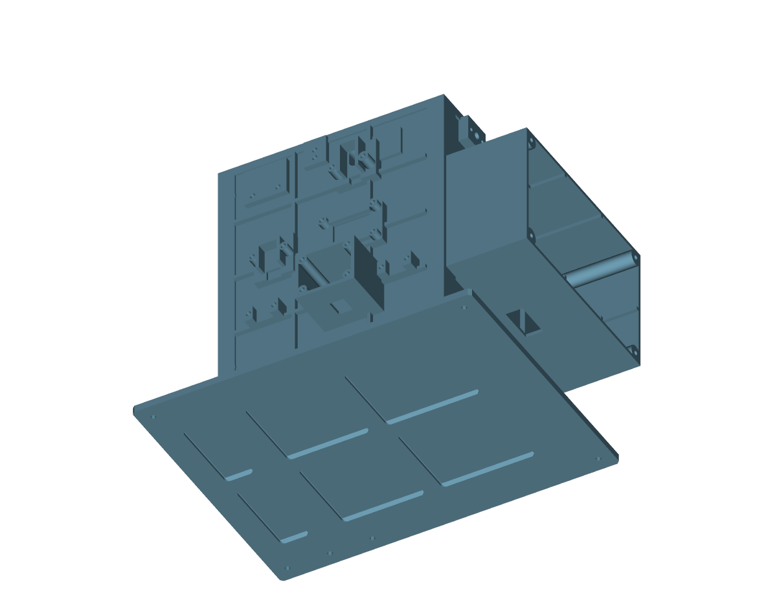
hardware/mechanical/print-backup/integrated-pla-20261104/preview/UPPER_INTEGRATED_bottom.png
