Sylphiette666/stm32-rfid-smart-bin/hardware/mechanical/print-backup/labeled-bases-20261101/preview/M05_body.png

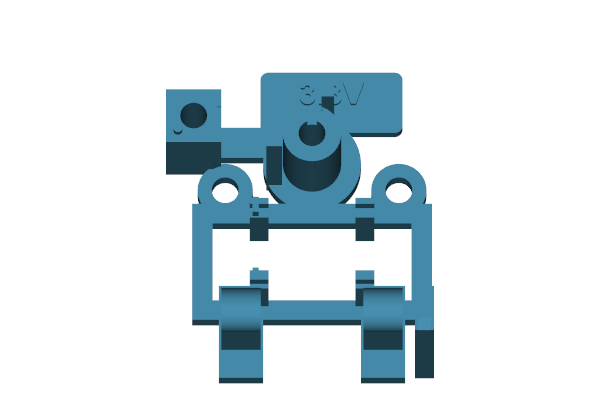
hardware/mechanical/print-backup/labeled-bases-20261101/preview/M05_body.png
