Sylphiette666/stm32-rfid-smart-bin/hardware/mechanical/print-backup/labeled-bases-20261101/preview/M06_body.png

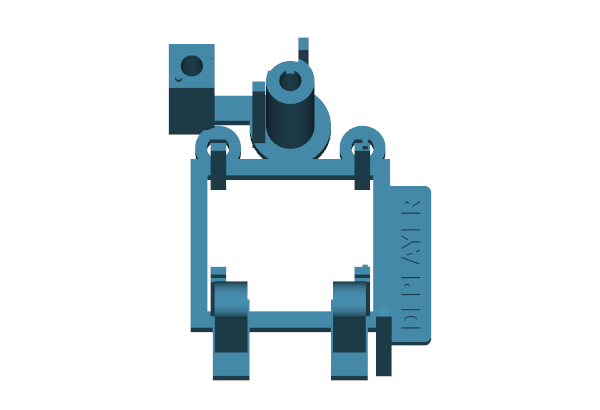
hardware/mechanical/print-backup/labeled-bases-20261101/preview/M06_body.png
