Sylphiette666/stm32-rfid-smart-bin/hardware/mechanical/print-backup/labeled-bases-20261101/preview/P05_BATTERY_cradle.png

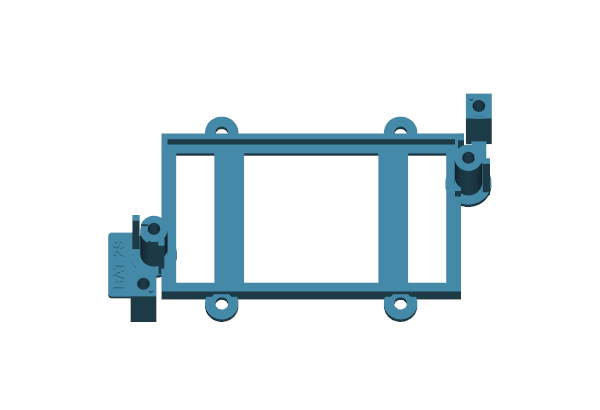
hardware/mechanical/print-backup/labeled-bases-20261101/preview/P05_BATTERY_cradle.png
