Sylphiette666/stm32-rfid-smart-bin/hardware/mechanical/print-backup/lid-fine-20261103/preview/05_actual_first_layers.png

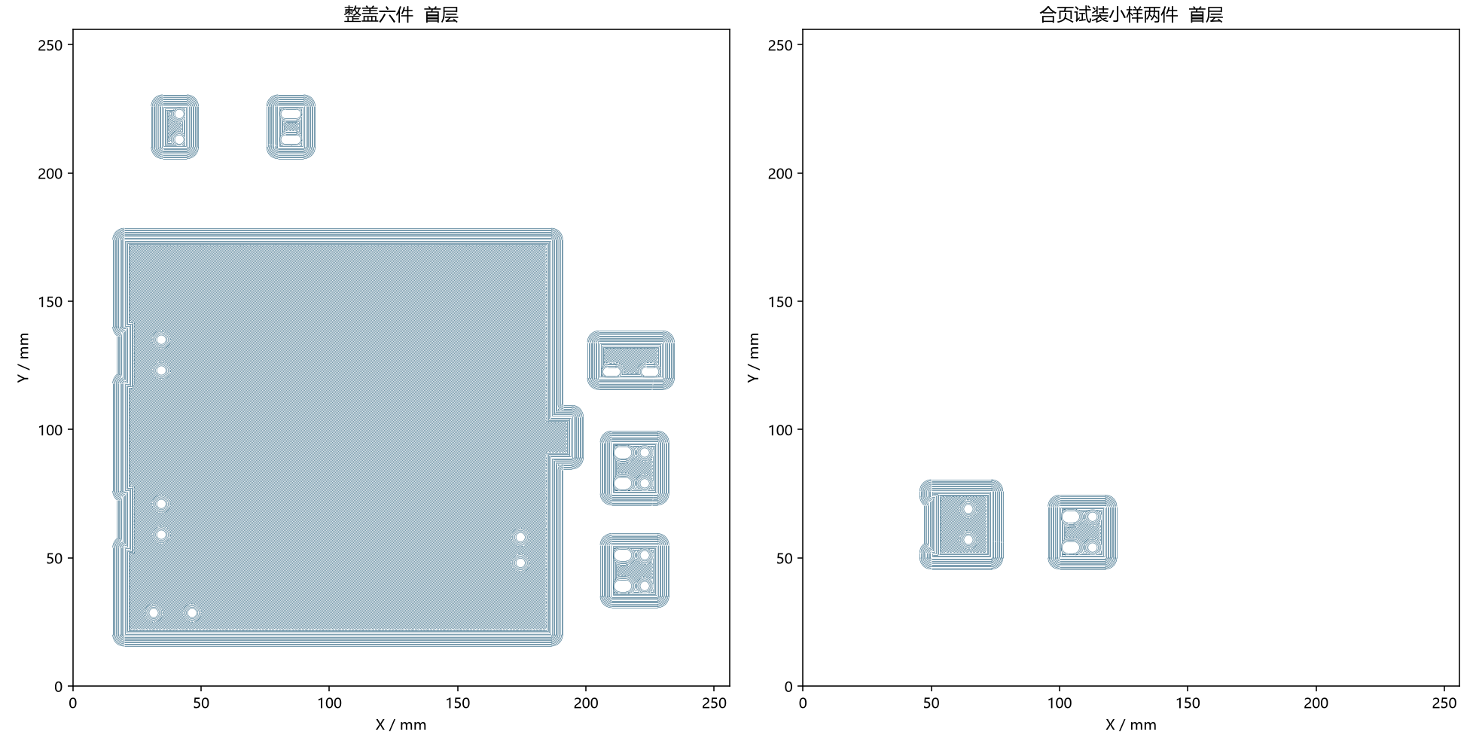
hardware/mechanical/print-backup/lid-fine-20261103/preview/05_actual_first_layers.png
