Sylphiette666/stm32-rfid-smart-bin/hardware/mechanical/print-backup/lid-fine-20261103/preview/closed.png

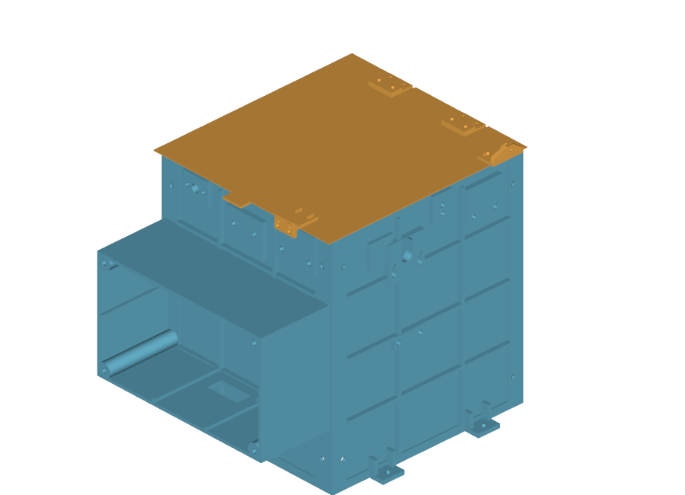
hardware/mechanical/print-backup/lid-fine-20261103/preview/closed.png
