Sylphiette666/stm32-rfid-smart-bin/hardware/mechanical/print-backup/motor-adapter-20261101/preview/RIGHT.png

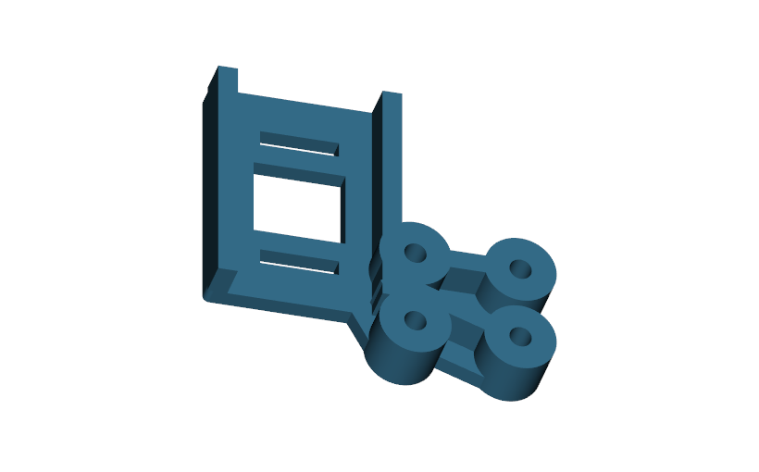
hardware/mechanical/print-backup/motor-adapter-20261101/preview/RIGHT.png
