Sylphiette666/stm32-rfid-smart-bin/hardware/mechanical/print-backup/motor-adapter-clearance2-20261102/preview/mesh_check.png

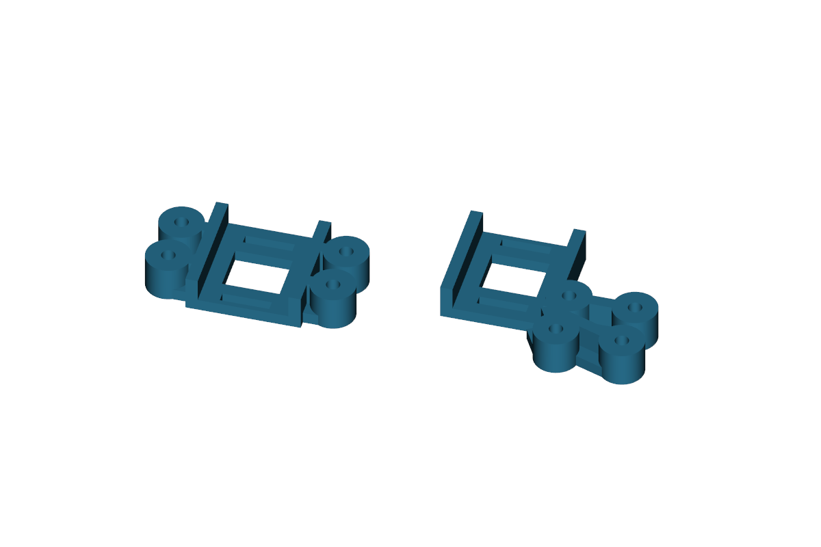
hardware/mechanical/print-backup/motor-adapter-clearance2-20261102/preview/mesh_check.png
