Sylphiette666/stm32-rfid-smart-bin/hardware/mechanical/print-backup/motor-existing-holes-20261102/checks/LEFT_RIGHT.png

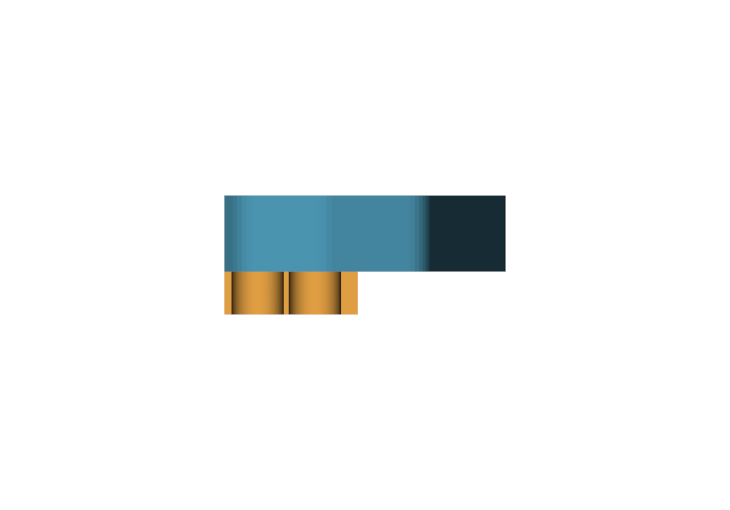
hardware/mechanical/print-backup/motor-existing-holes-20261102/checks/LEFT_RIGHT.png
