Sylphiette666/stm32-rfid-smart-bin/hardware/mechanical/print-backup/motor-existing-holes-20261102/preview/04_actual_first_layer.png

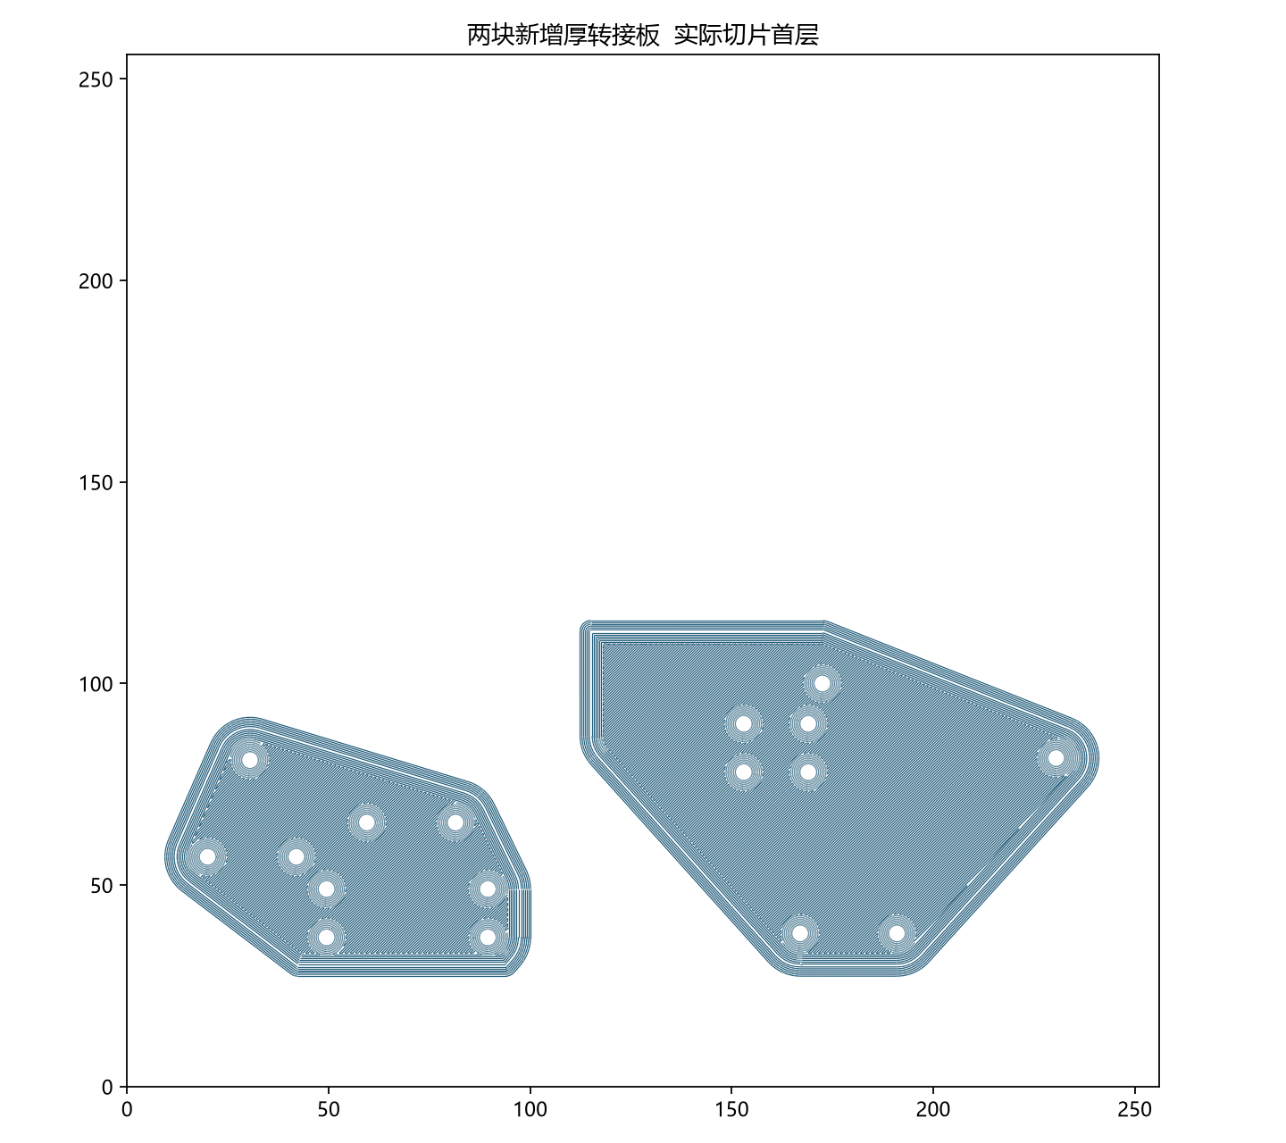
hardware/mechanical/print-backup/motor-existing-holes-20261102/preview/04_actual_first_layer.png
