Sylphiette666/stm32-rfid-smart-bin/hardware/mechanical/print-backup/motor-existing-holes-20261102/preview/RIGHT_stack.png

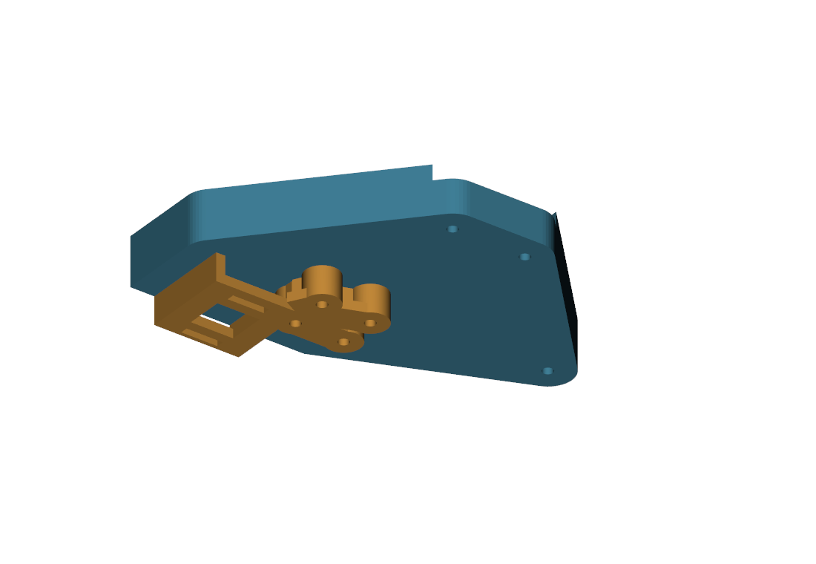
hardware/mechanical/print-backup/motor-existing-holes-20261102/preview/RIGHT_stack.png
