Sylphiette666/stm32-rfid-smart-bin/hardware/mechanical/print-backup/motor-existing-holes-light-20261103/checks/RIGHT_TOP.png

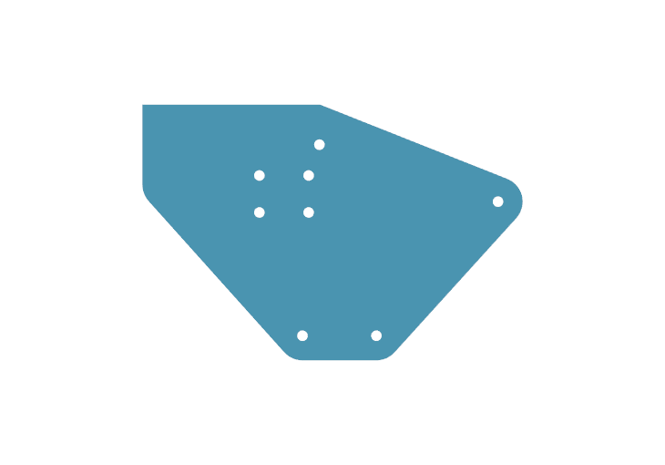
hardware/mechanical/print-backup/motor-existing-holes-light-20261103/checks/RIGHT_TOP.png
