Sylphiette666/stm32-rfid-smart-bin/hardware/mechanical/print-backup/motor-existing-holes-light-20261103/preview/RIGHT_pocket_dimensions.png

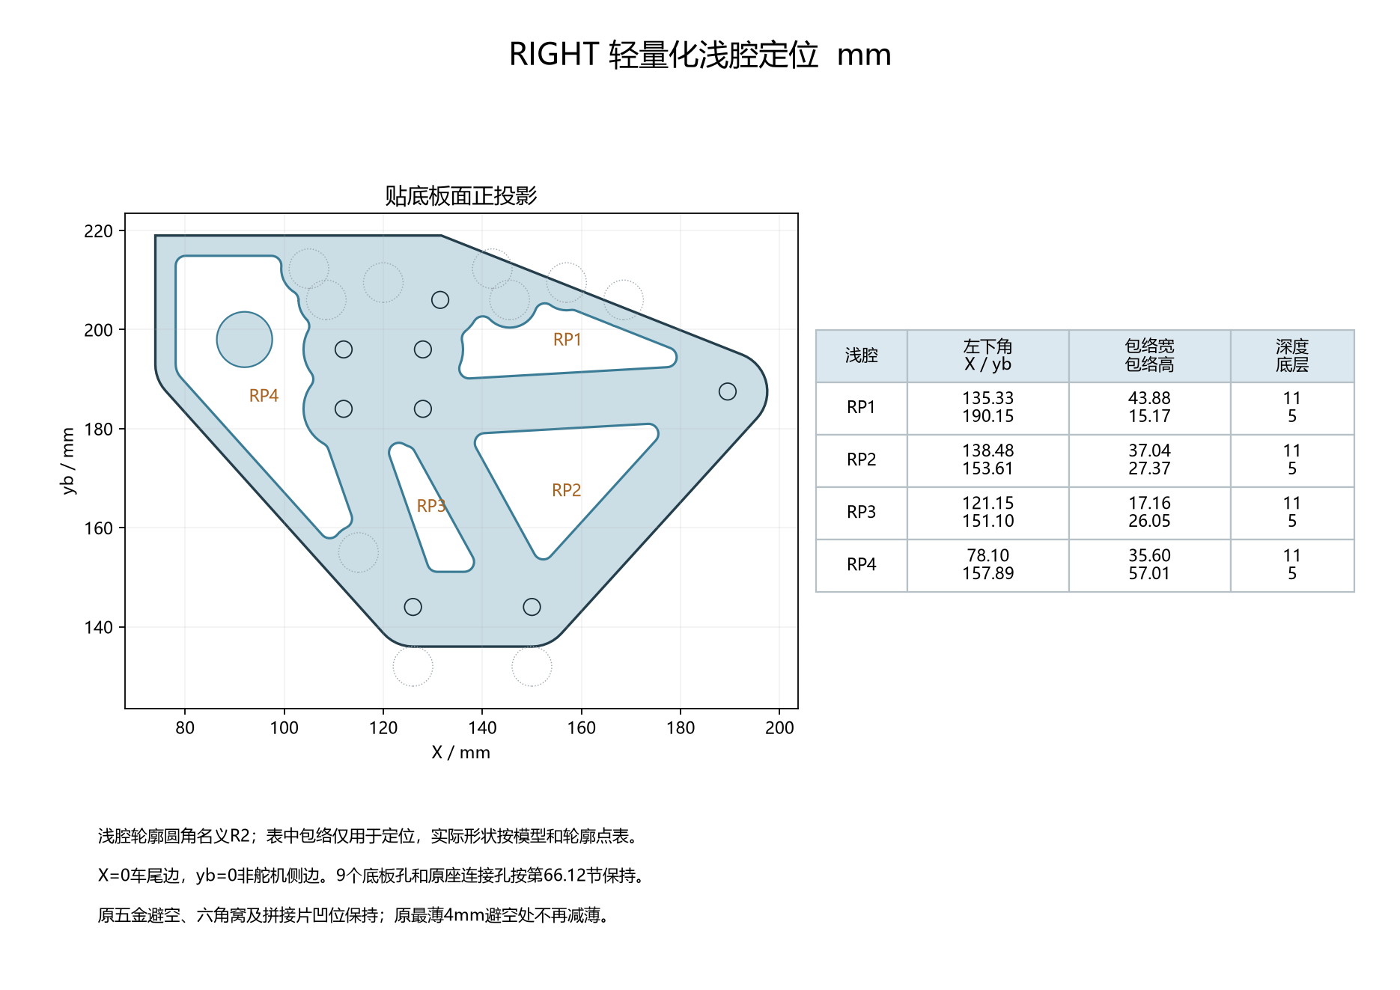
hardware/mechanical/print-backup/motor-existing-holes-light-20261103/preview/RIGHT_pocket_dimensions.png
