Sylphiette666/stm32-rfid-smart-bin/hardware/mechanical/print-backup/mounted-20261031/preview/02_base_3d.png

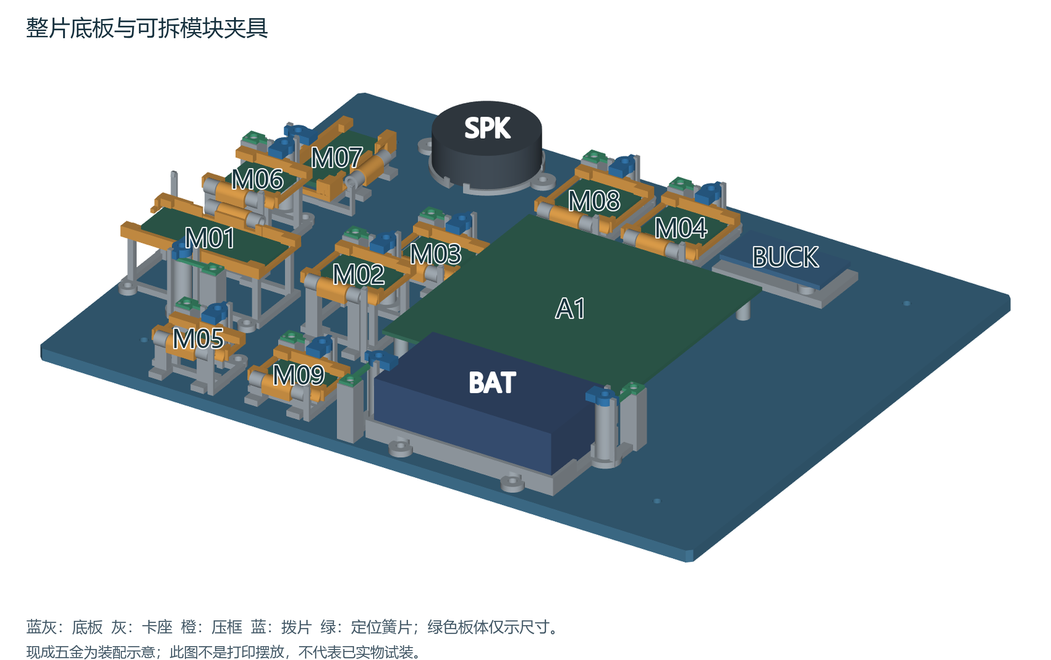
hardware/mechanical/print-backup/mounted-20261031/preview/02_base_3d.png
