Sylphiette666/stm32-rfid-smart-bin/hardware/mechanical/print-backup/mounted-20261031/preview/04_battery_speaker.png

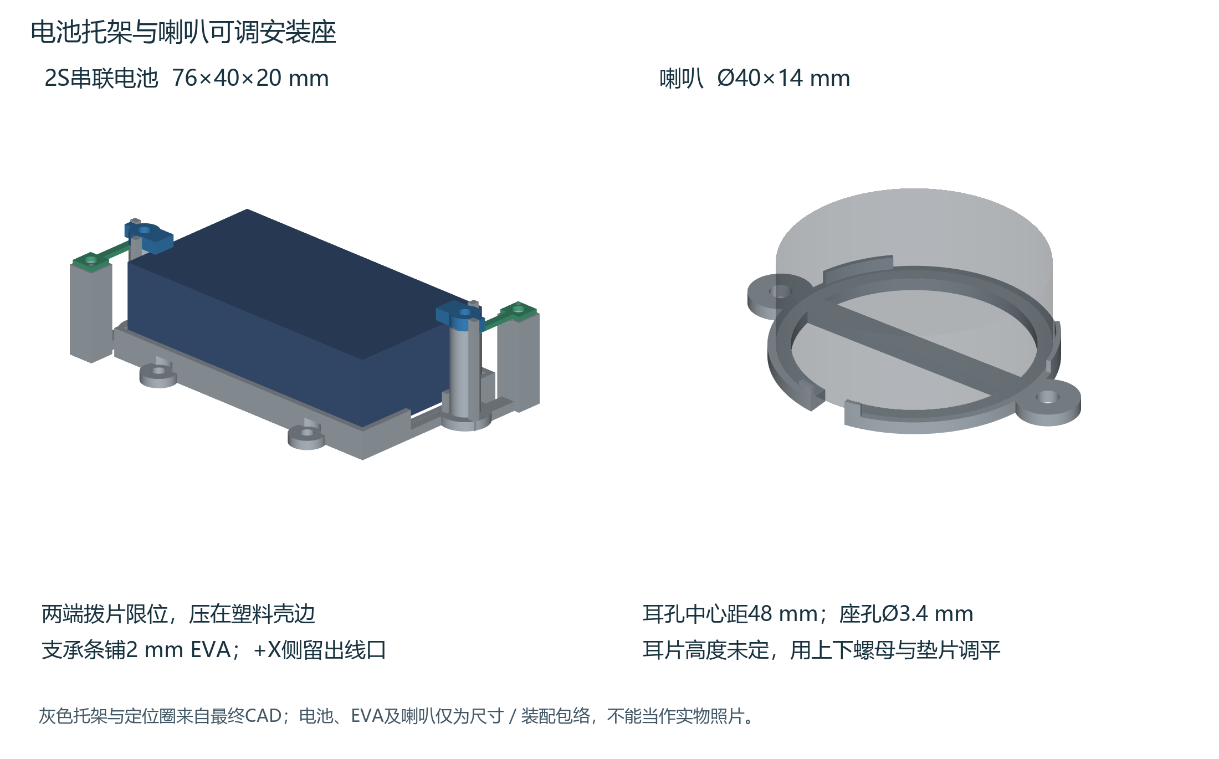
hardware/mechanical/print-backup/mounted-20261031/preview/04_battery_speaker.png
