Sylphiette666/stm32-rfid-smart-bin/hardware/mechanical/print-backup/mounted-20261031/preview/07_plate1_bed.png

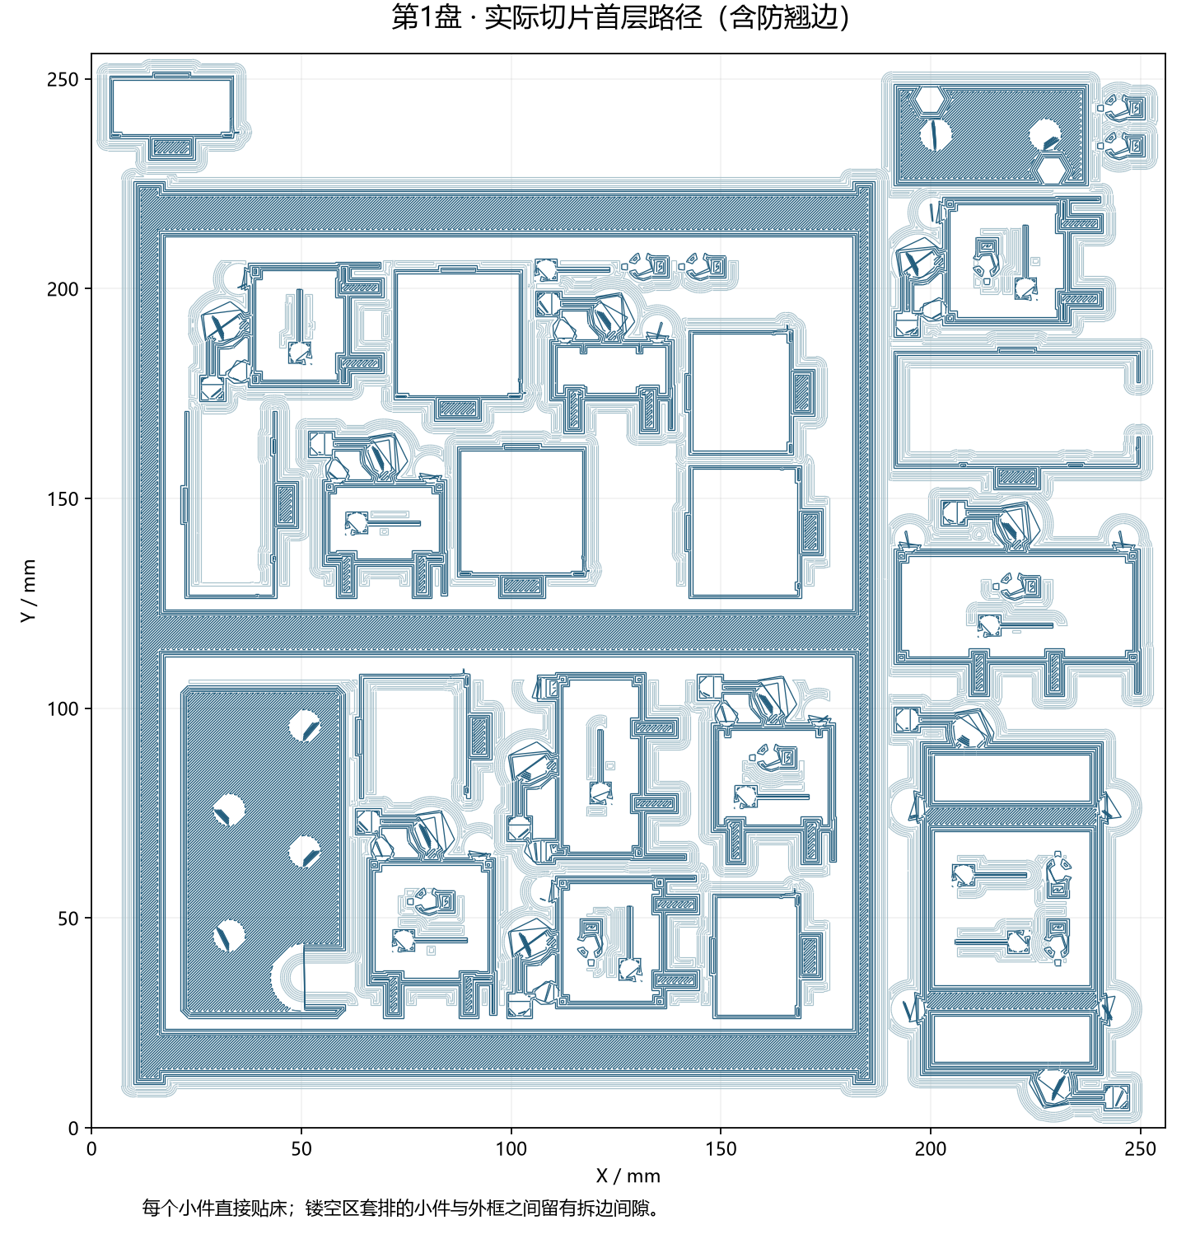
hardware/mechanical/print-backup/mounted-20261031/preview/07_plate1_bed.png
