Sylphiette666/stm32-rfid-smart-bin/hardware/mechanical/print-backup/preview/02_assembly.png

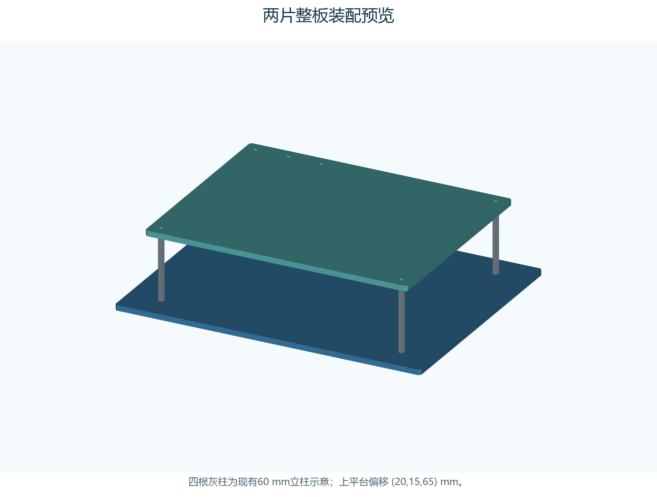
hardware/mechanical/print-backup/preview/02_assembly.png
