Sylphiette666/stm32-rfid-smart-bin/hardware/mechanical/print-backup/r3d-petg-fast-20261104/preview/UPPER_INTEGRATED_L28_plate.png

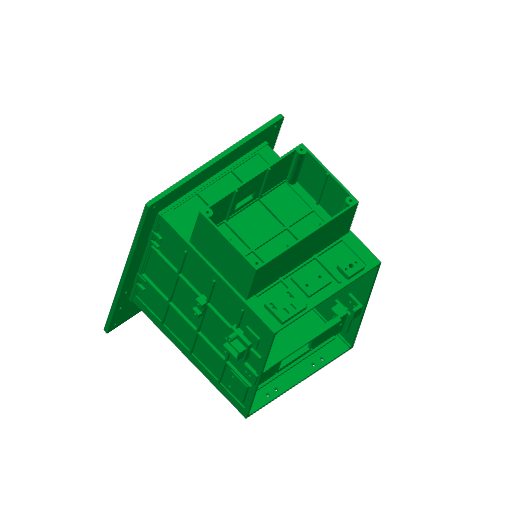
hardware/mechanical/print-backup/r3d-petg-fast-20261104/preview/UPPER_INTEGRATED_L28_plate.png
