Sylphiette666/stm32-rfid-smart-bin/hardware/mechanical/print-backup/wall-clamp-preview-20261103/preview/02_pressure_clamp_detail.png

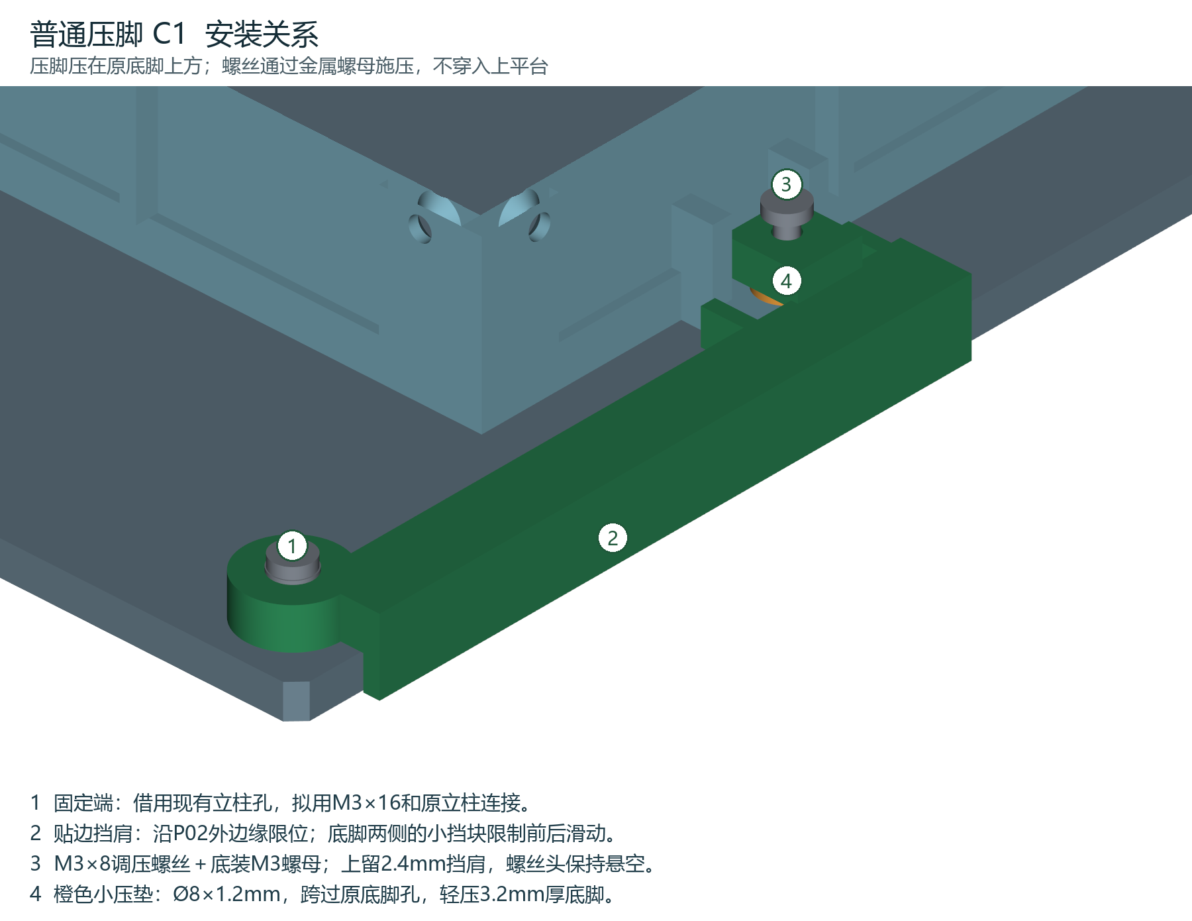
hardware/mechanical/print-backup/wall-clamp-preview-20261103/preview/02_pressure_clamp_detail.png
