Sylphiette666/stm32-rfid-smart-bin/hardware/mechanical/print-backup/wall-clamp-preview-20261103/preview/03_servo_side_detail.png

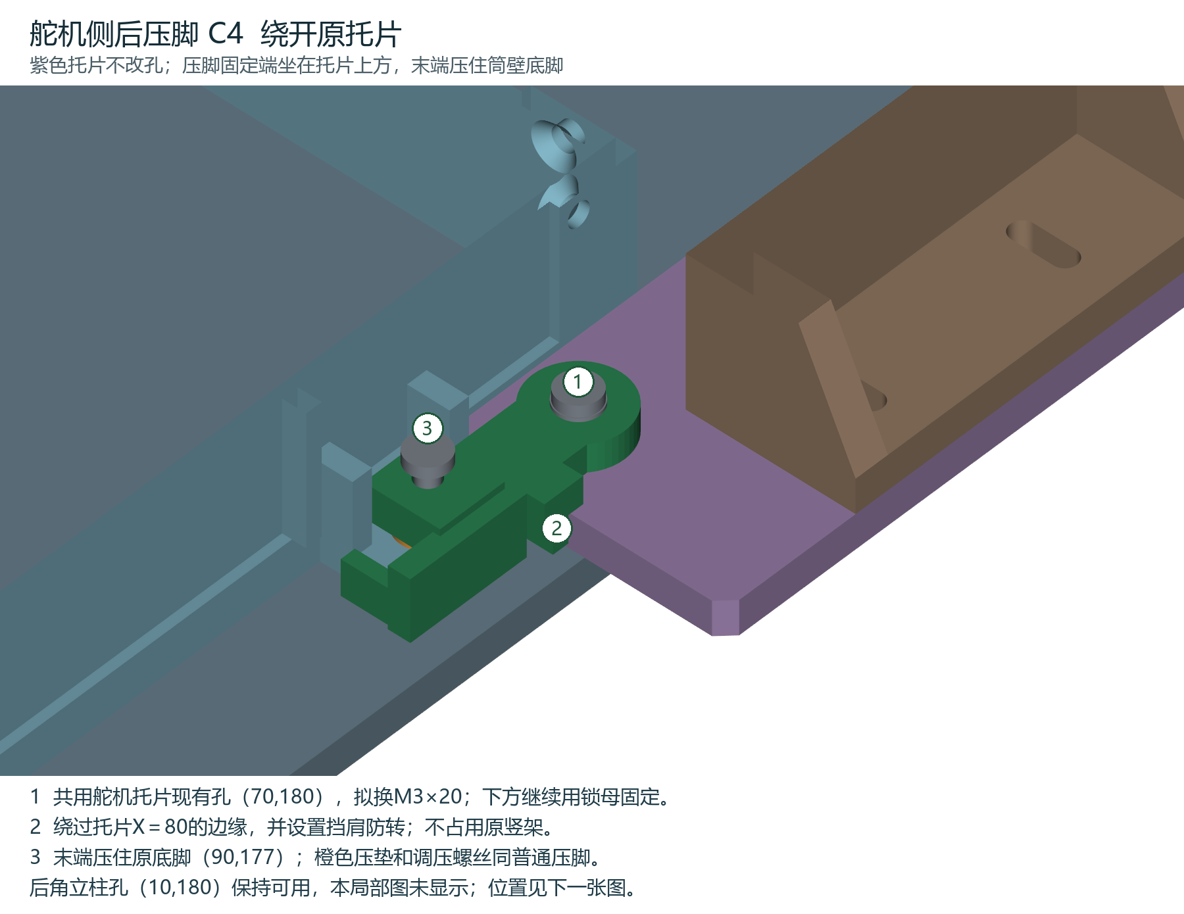
hardware/mechanical/print-backup/wall-clamp-preview-20261103/preview/03_servo_side_detail.png
