Sylphiette666/stm32-rfid-smart-bin/hardware/mechanical/print-backup/wall-clamp-preview-20261103/preview/raw_servo.png

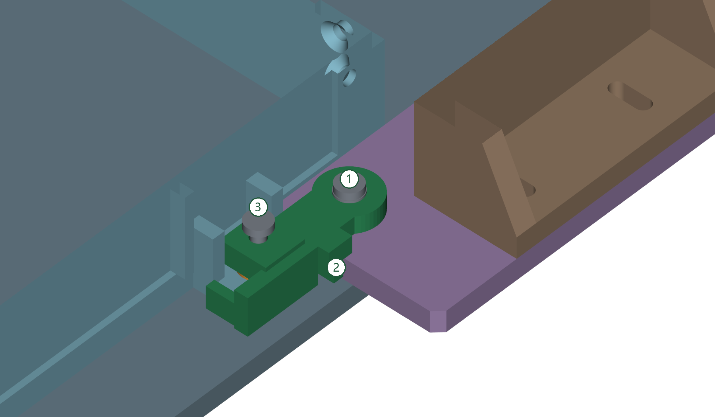
hardware/mechanical/print-backup/wall-clamp-preview-20261103/preview/raw_servo.png
