Sylphiette666/stm32-rfid-smart-bin/hardware/mechanical/print-backup/wall-clamps-fine-20261103/preview/03_actual_first_layer.png

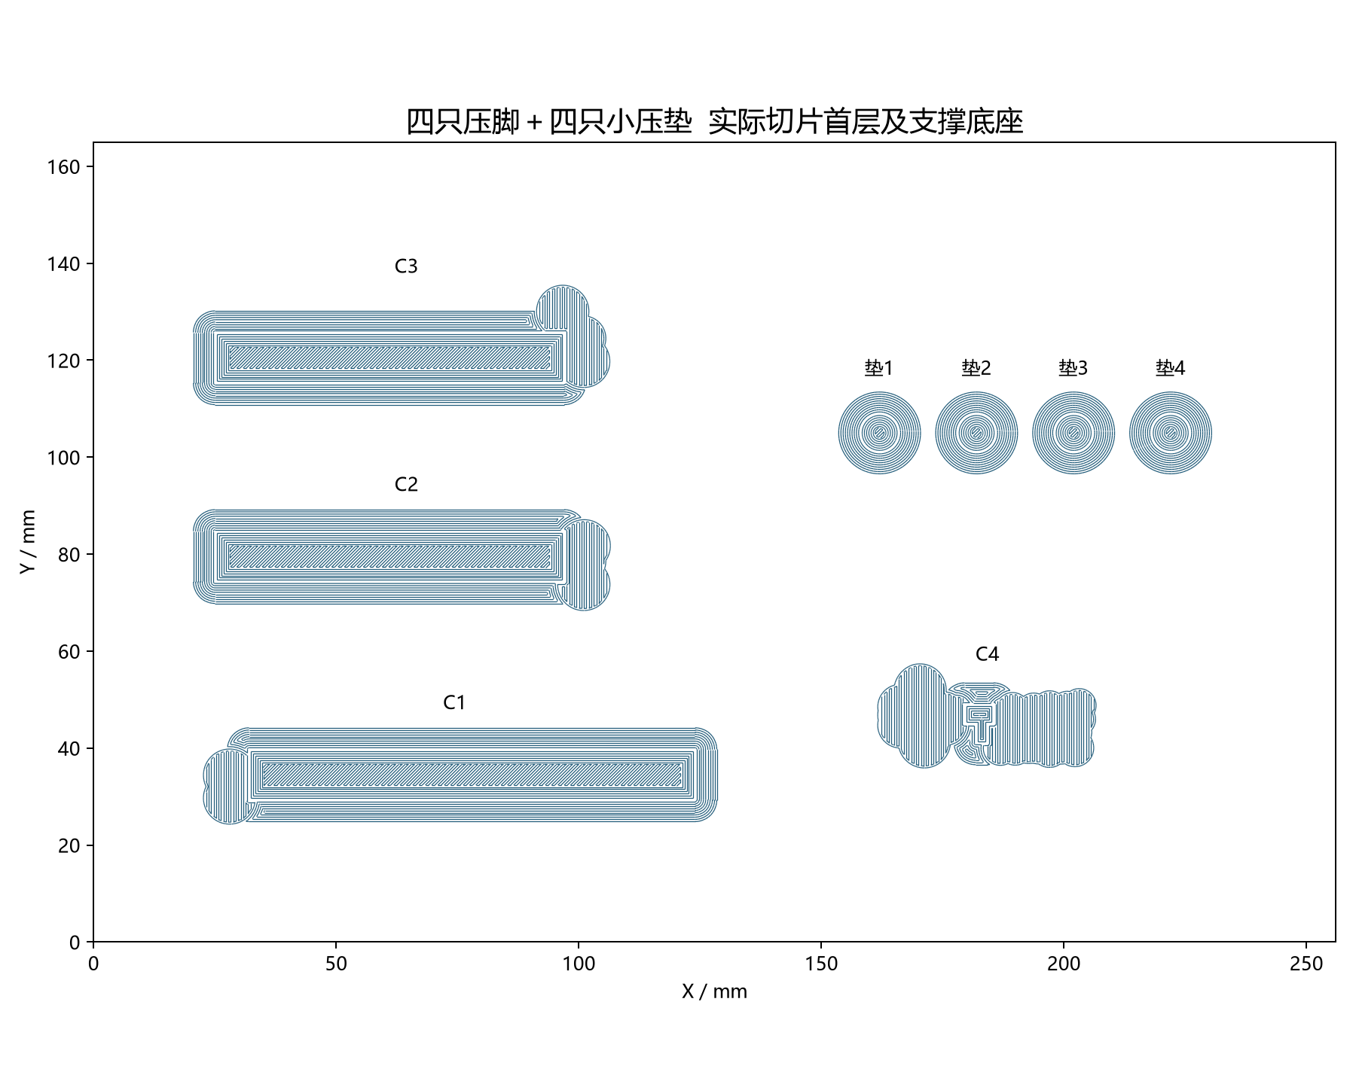
hardware/mechanical/print-backup/wall-clamps-fine-20261103/preview/03_actual_first_layer.png
