Sylphiette666/stm32-rfid-smart-bin/hardware/mechanical/print-backup/wall-clamps-fine-20261103/preview/04_actual_support_review.png

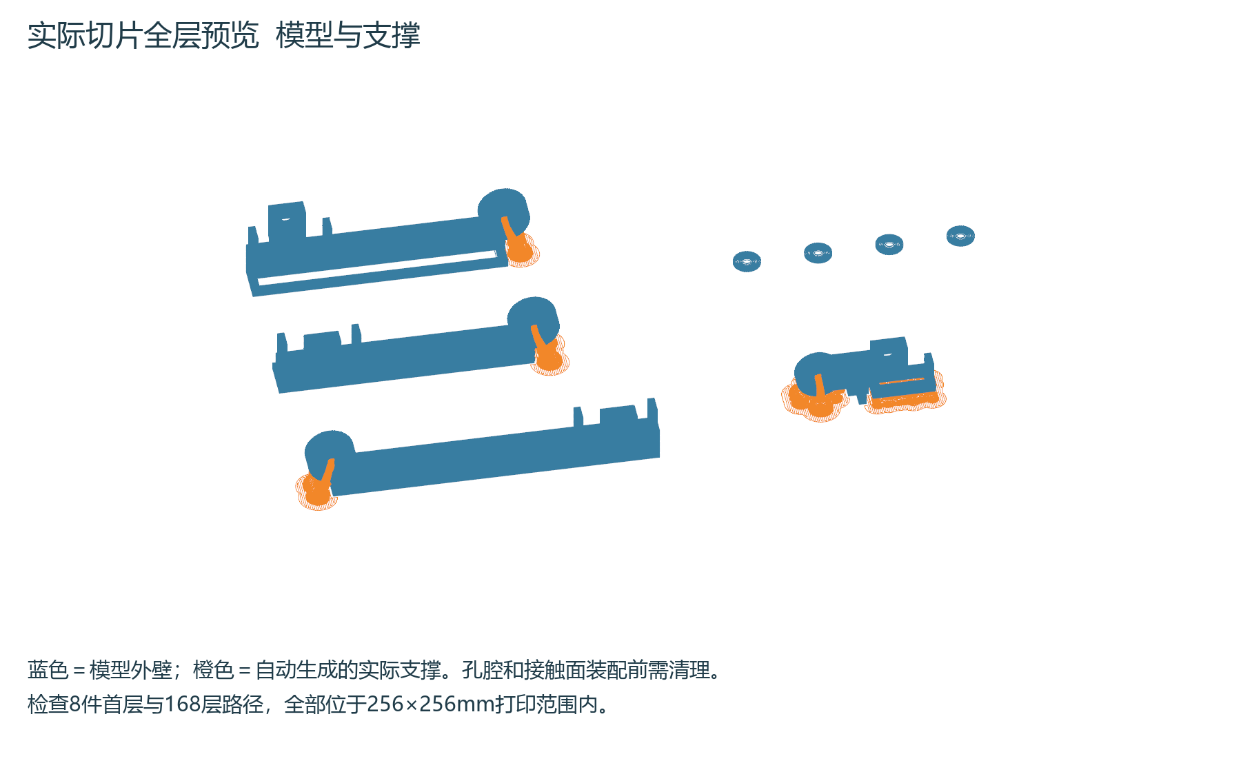
hardware/mechanical/print-backup/wall-clamps-fine-20261103/preview/04_actual_support_review.png
