Sylphiette666/stm32-rfid-smart-bin/hardware/mechanical/print-backup/wall-clamps-fine-20261103/preview/raw_support.png

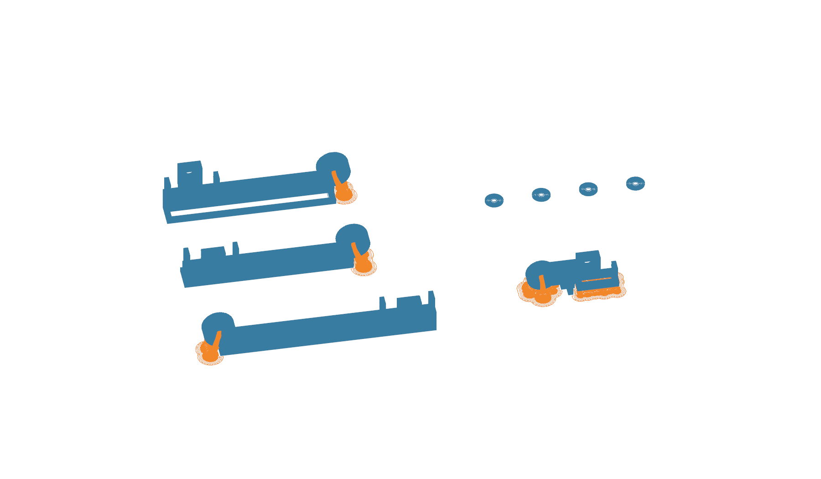
hardware/mechanical/print-backup/wall-clamps-fine-20261103/preview/raw_support.png
