Sylphiette666/stm32-rfid-smart-bin/hardware/mechanical/print-backup/wall-panels-20261102/preview/complete_assembly_front.png

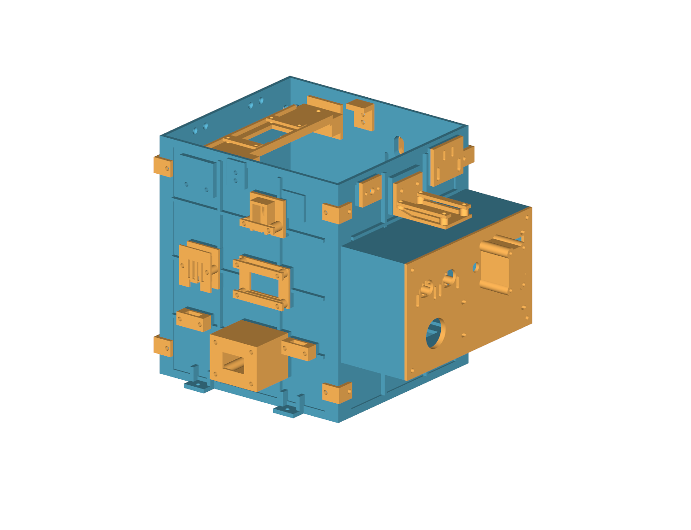
hardware/mechanical/print-backup/wall-panels-20261102/preview/complete_assembly_front.png
