Sylphiette666/stm32-rfid-smart-bin/hardware/mechanical/print-backup/wall-panels-20261102/preview/coordinates_PANEL_COVER.png

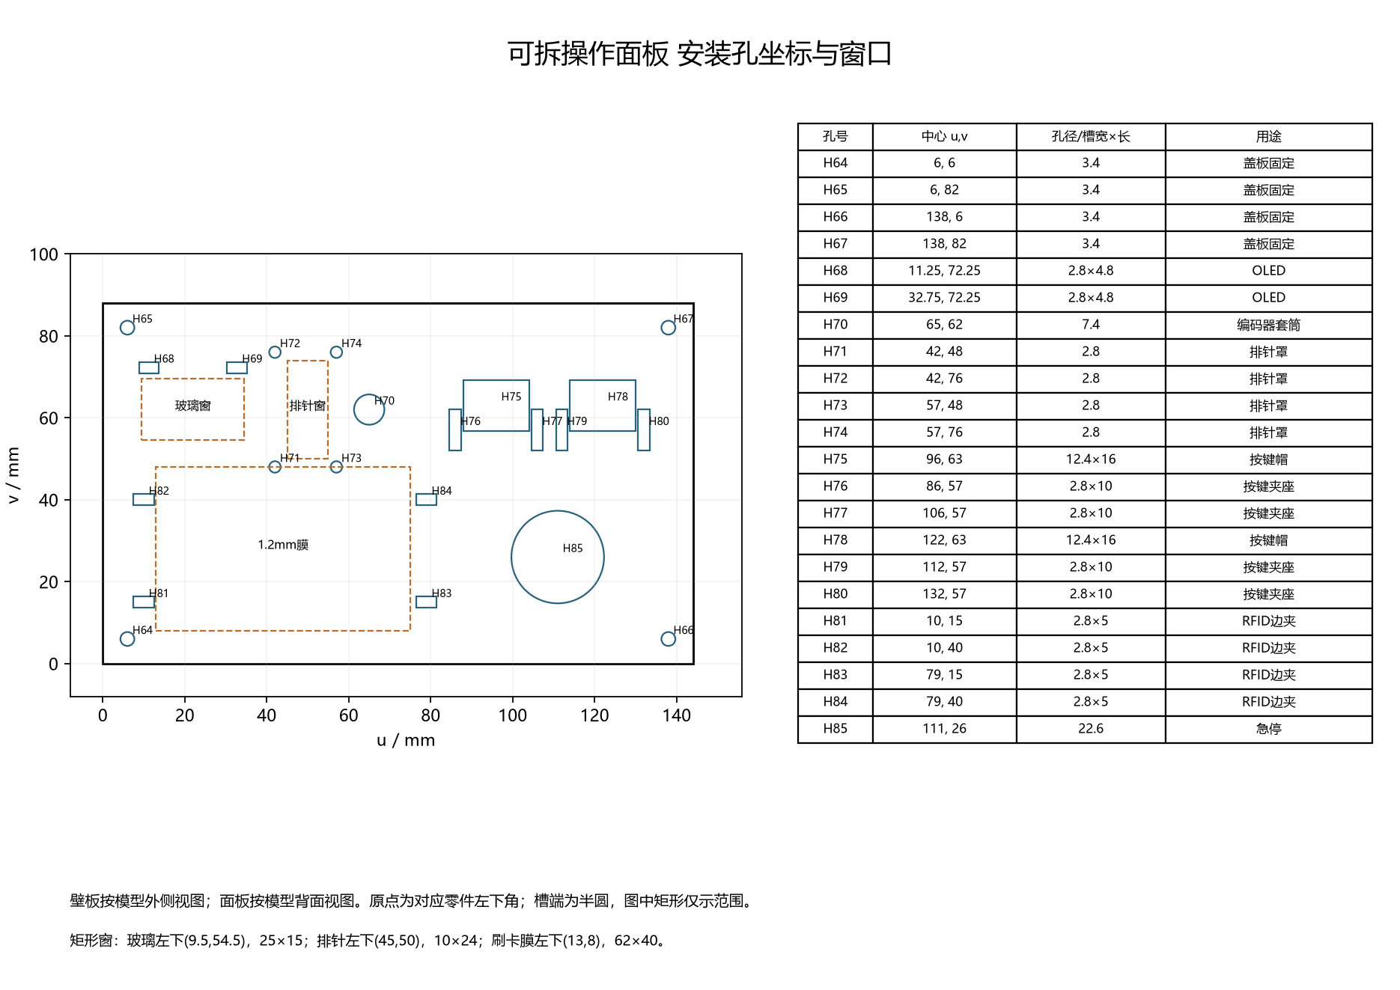
hardware/mechanical/print-backup/wall-panels-20261102/preview/coordinates_PANEL_COVER.png
