Sylphiette666/stm32-rfid-smart-bin/hardware/mechanical/print-backup/wall-panels-20261102/preview/coordinates_W02_REAR.png

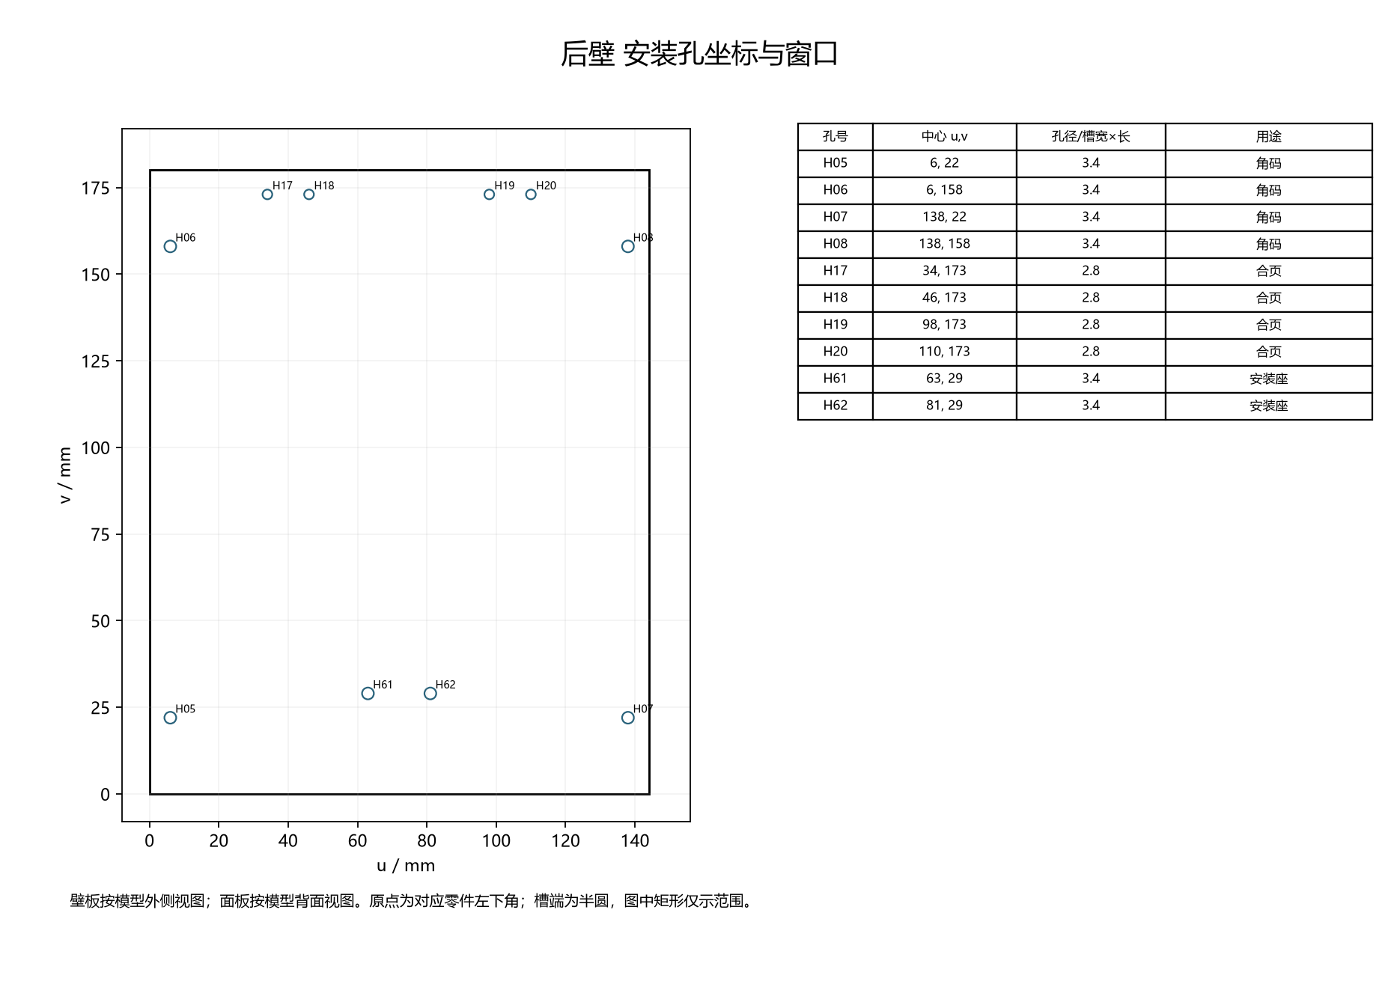
hardware/mechanical/print-backup/wall-panels-20261102/preview/coordinates_W02_REAR.png
