Sylphiette666/stm32-rfid-smart-bin/hardware/mechanical/print-backup/wall-panels-20261102/preview/first_layer_1.png

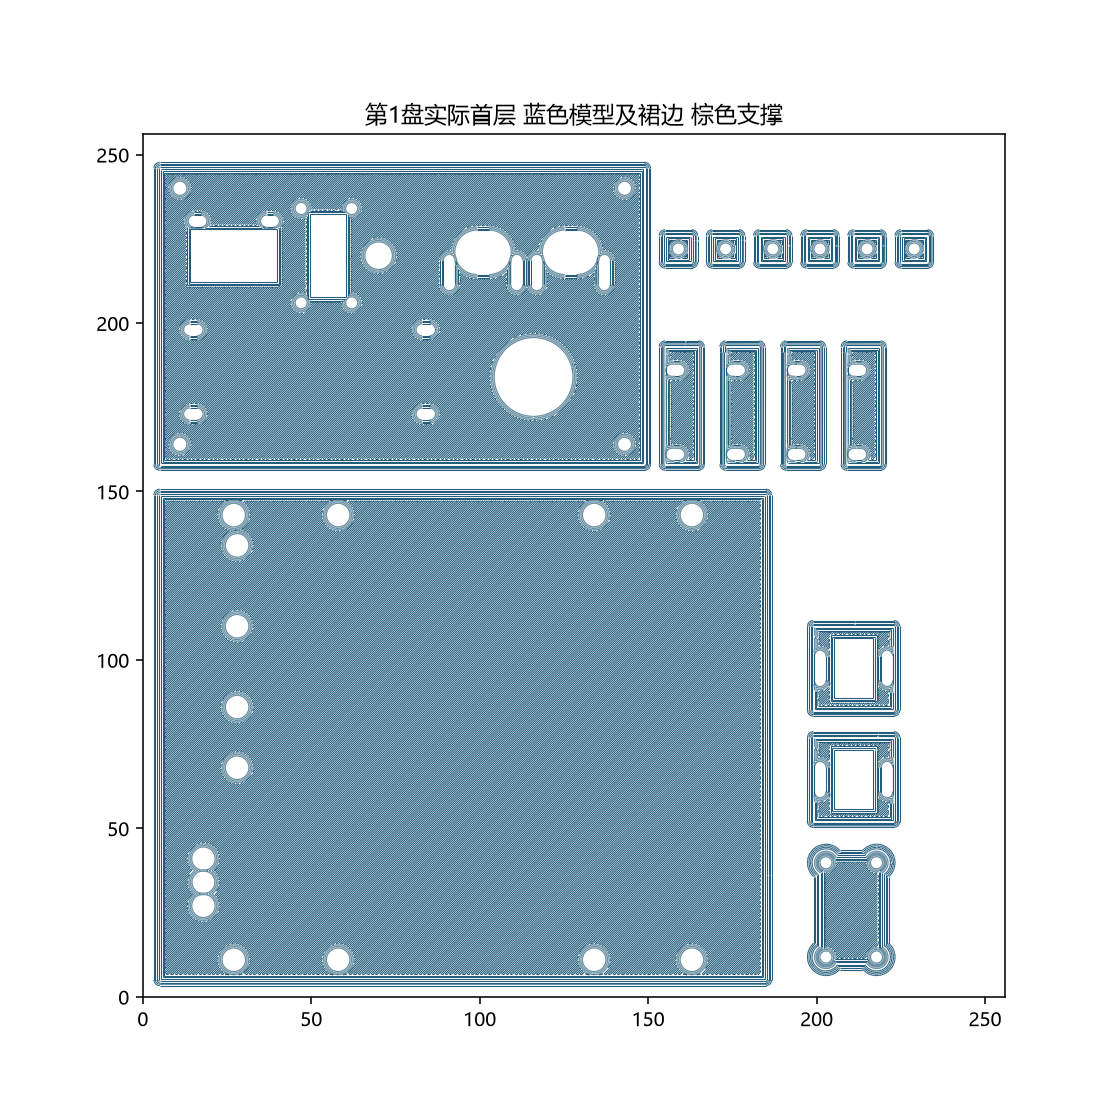
hardware/mechanical/print-backup/wall-panels-20261102/preview/first_layer_1.png
