Sylphiette666/stm32-rfid-smart-bin/docs/manual/illustrated-source/figures/s05_full_calibration.png

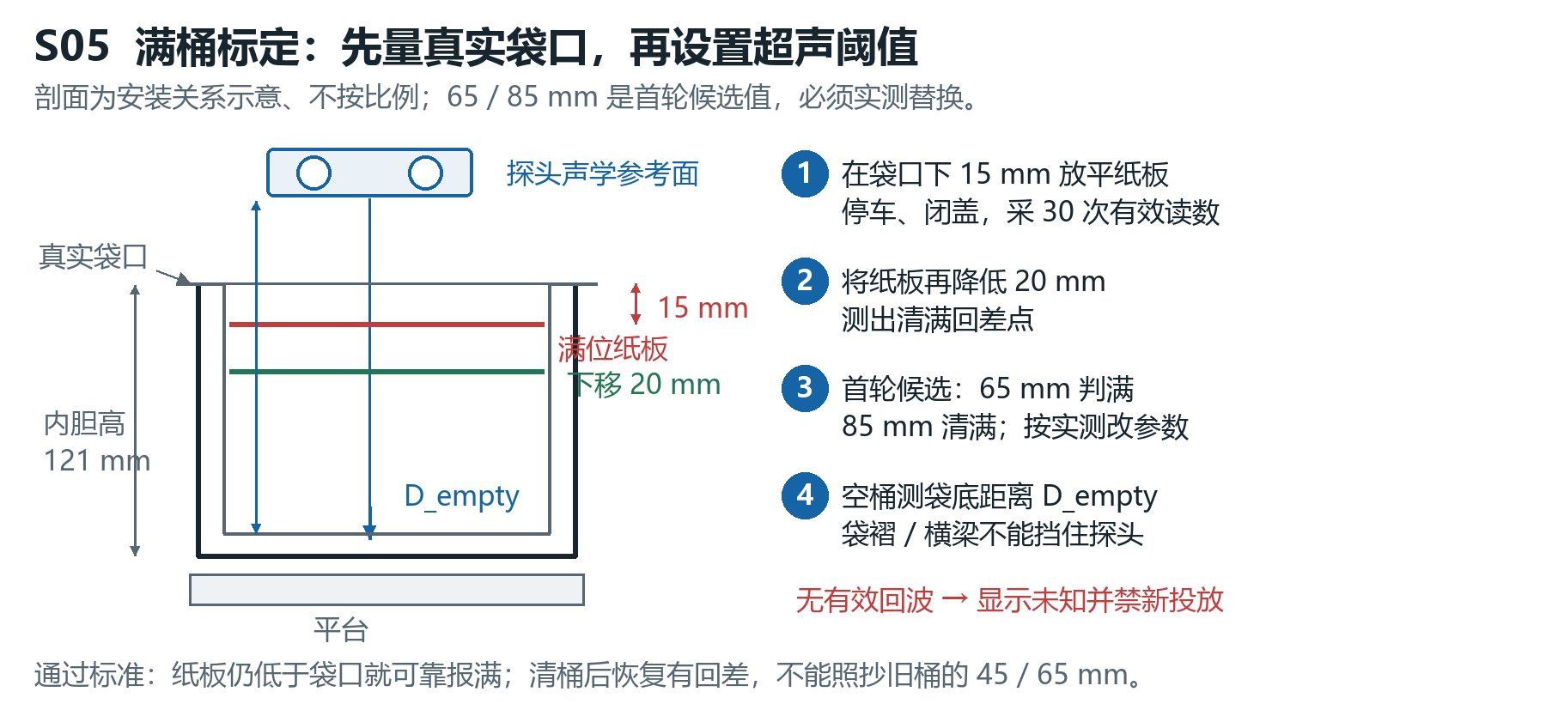
docs/manual/illustrated-source/figures/s05_full_calibration.png
