Sylphiette666/stm32-rfid-smart-bin/hardware/mechanical/print-backup/sensor-retainers-fix-20261103/preview/qa_BEAM_CUP_V2_four_views.png

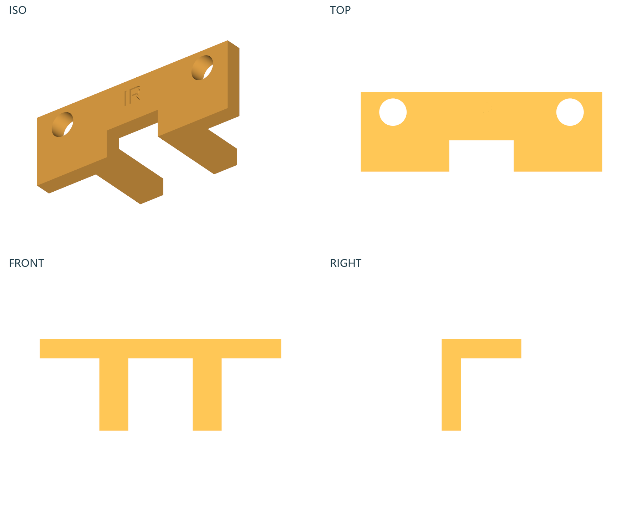
hardware/mechanical/print-backup/sensor-retainers-fix-20261103/preview/qa_BEAM_CUP_V2_four_views.png
