Sylphiette666/stm32-rfid-smart-bin/hardware/mechanical/print-backup/sensor-retainers-fix-20261103/preview/qa_BEAM_CUP_V2_TOP.png

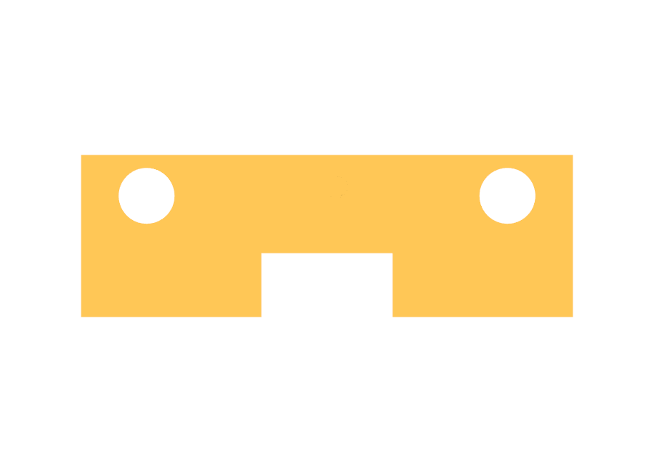
hardware/mechanical/print-backup/sensor-retainers-fix-20261103/preview/qa_BEAM_CUP_V2_TOP.png
