Sylphiette666/stm32-rfid-smart-bin/hardware/mechanical/print-backup/sensor-retainers-fix-20261103/preview/qa_LIGHT_BAR_V2_FRONT.png

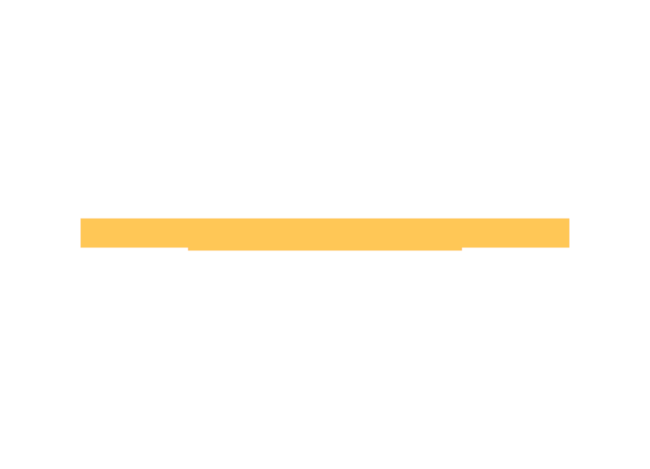
hardware/mechanical/print-backup/sensor-retainers-fix-20261103/preview/qa_LIGHT_BAR_V2_FRONT.png
