Sylphiette666/stm32-rfid-smart-bin/hardware/mechanical/print-backup/wall-clamps-fine-20261103/preview/qa_C2_LEFT_FRONT_TOP.png

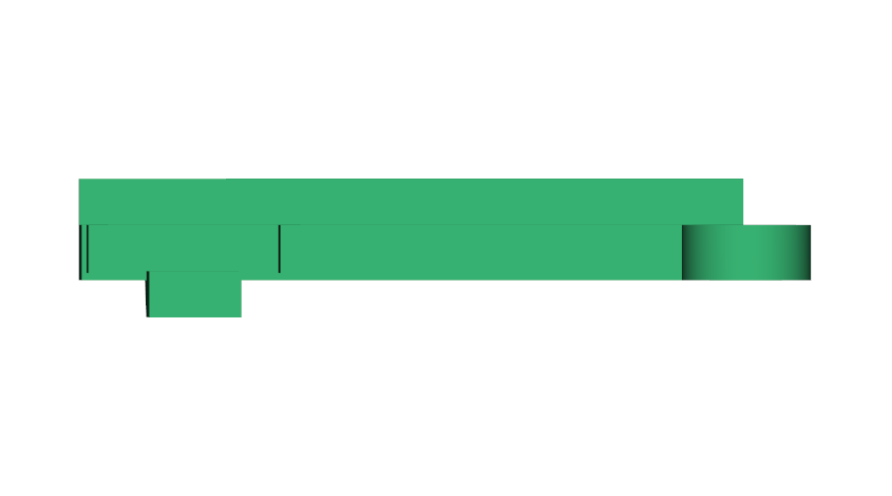
hardware/mechanical/print-backup/wall-clamps-fine-20261103/preview/qa_C2_LEFT_FRONT_TOP.png
