Sylphiette666/stm32-rfid-smart-bin/hardware/mechanical/print-backup/wall-clamps-fine-20261103/preview/qa_C3_RIGHT_FRONT_ISO.png

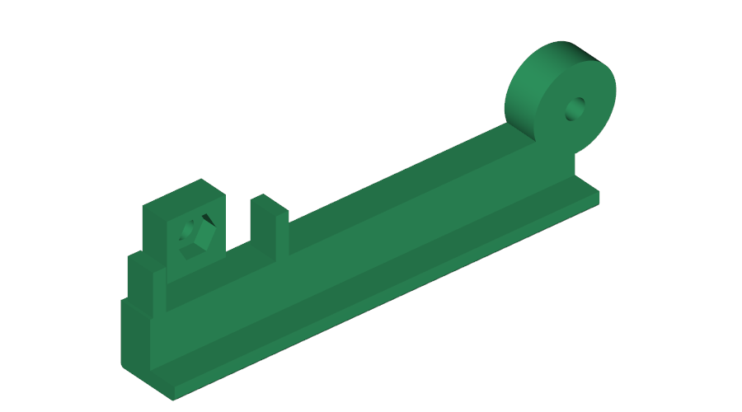
hardware/mechanical/print-backup/wall-clamps-fine-20261103/preview/qa_C3_RIGHT_FRONT_ISO.png
