Sylphiette666/stm32-rfid-smart-bin/hardware/mechanical/print-backup/wall-clamps-fine-20261103/preview/qa_C4_RIGHT_REAR_FRONT.png

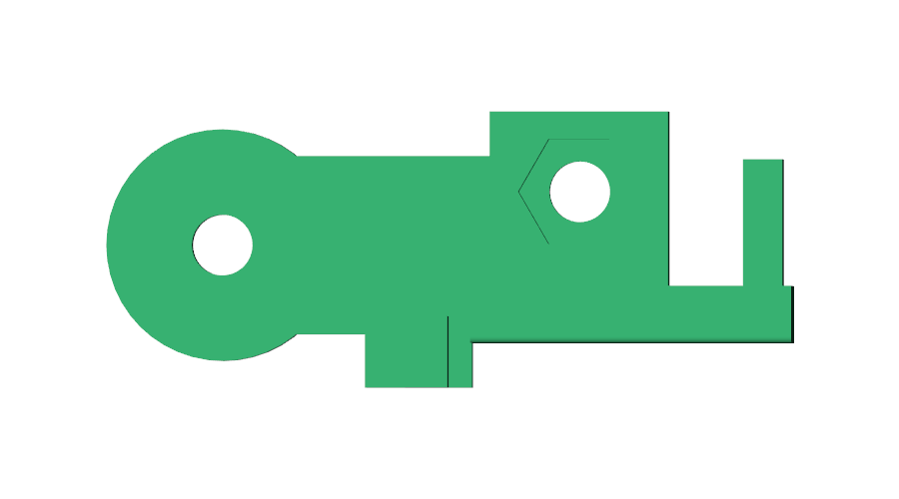
hardware/mechanical/print-backup/wall-clamps-fine-20261103/preview/qa_C4_RIGHT_REAR_FRONT.png
