Sylphiette666/stm32-rfid-smart-bin/hardware/current-low-cost/perfboard/外置模块接线与调试说明.txt

这两块板怎样分工
1. PWR 与 IO 各使用一块 7×9 cm、2.54 mm 独立焊盘洞洞板。PWR 本次布置电源端子、滤波、电池 ADC 分压及照明 MOS 接口；IO 放缓冲、急停逻辑和信号汇总，电气网络不因换板改变。
2. 核心板、MCP23017 成品扩展模块、TB6612 驱动、降压及各传感器模块均外置固定。图中的接口是我们定义的板侧接口；请按信号名称逐根接模块丝印，不能按表格次序猜模块排针左右顺序。
3. 外置模块的供电范围、引脚顺序、已有上拉及芯片版本仍以实物资料和测量为准；模块上的 VCC 标签不能单独证明可接 3.3 V 或 5 V。

两板图以外仍须接好的线和小元件
1. 本次孔位图仅固定板上通用电路；下面这些工作在外置模块、绝缘小接线片或线束侧完成，不能因图上没有焊位便省略。
2. MODE、BACK及编码器SW分别需要到3V3_EXT的约10 kΩ上拉，或使用原手册允许且已验证的MCP内部上拉；PB9蜂鸣控制另有按有效极性选择的10 kΩ偏置。三路普通按键与蜂鸣的电阻不在当前两板孔位清单内。
3. 每个实际5 V数字输出的NPN适配、需要5 V的DHT双向BSS138适配，以及MCP/DFPlayer的就近去耦均在模块侧补齐。5 V模拟光敏量不套用数字NPN。
4. SPI的SCK/MISO/MOSI直接在核心与RC522/FLASH线束分接；MCP的GPA0至GPA6和GPB0至GPB6按功能直接接外部模块/按键，其中GPA5去PWR灯输入。MCP的五线板侧接口只负责电源、I²C及复位，并未包含这14条功能线。
5. PA8/PA11到电机PWM、PA2/PA3到HC-05、PA9/PA10到电脑串口、PB8到前障碍、PA12到投放以及PB0到光敏，均按文字净表连接，不是未使用引脚。PA13/PA14的SWD直接保留到核心。
6. 电源分支到外置模块时连电源和GND两根；信号排针上的GND只作参考与小电流回路，电机/舵机功率回流直接回PWR。

电源与两路 3.3 V
1. 成品带保护 2S 电池正极依次经过 3 A 初选保险、总开关到 BAT_SW；BAT_SW→BUCK_IN→外置降压输入，降压输出返回 BUCK_OUT。满电 8.4 V 不能进入 5 V 支路。
2. 降压先单独调至 5.00 V。MOTOR、SERVO、LOGIC 从同一配电点分别引出正线和回流线；它们是独立走线支路，不是三组隔离电源。电机、舵机电流不经过 IO 板、核心板或普通杜邦电源线。
3. 外置 3.3 V 稳压以 5V_LOGIC 供电，输出 3V3_EXT，仅经小电流排针供外设；3V3_CORE 来自核心板，供规定输入上拉。两路 3.3 V 不直接相连，公共 GND 相连。
4. 本次孔位图的电池、5 V 输入与星形配电主干按 20 AWG 绝缘线施工；外接短电机/舵机支路可用 22 AWG。电容支线按图标示的 22/26 AWG 施工，不以细焊锡桥替代粗铜线。1000 μF 靠舵机电源接口、470 μF 靠驱动电源接口、100 μF 靠逻辑/DFPlayer入口；电容若离实际负载很远，不能仅凭 PWR 板已有电容便省掉负载端去耦。

PWR 两根连续汇流铜线的具体施工
1. PWR 焊接面增加两根直径 0.8 mm 镀锡实心铜线：正汇流线沿 V 列，从 V3 连续到 V9，在 V3/V5/V7/V9 固定；负汇流线沿 X 列，从 X3 连续到 X11，在 X3/X5/X7/X9/X11 固定。所有孔号始终使用元件面定义的编号，焊接面左右镜像，不重新编号。
2. 清单中的 PWR W001～W003 表示一根连续正汇流线的三段，W004～W007 表示一根连续负汇流线的四段；实际只做两根铜线，不要剪成七根短线。铜线贴焊接面固定；仅在指定焊盘和支路线端处焊接，不把相邻焊盘任意锡连。
3. BUCK_OUT 的 R3 正端只焊一根 20 AWG 绝缘线到 V3，T3 负端只焊一根 20 AWG 到 X3。MOTOR、SERVO、LOGIC 的正支路分别由 V5/V7/V9 引出，负支路分别回 X5/X7/X9；X11 单独回电池 GND。把支路线的剥皮端搭焊到对应汇流节点，不把多根粗线挤入同一个洞洞板孔。
4. 汇流线以外的每条跨接线均使用绝缘线，仅两端剥皮焊接。与汇流铜线交叉的导线须保留完整绝缘，必要时加热缩管或垫绝缘片；交叉位置不是电连接。完成导通、对地短路及拉力检查后，再用可靠绝缘罩或绝缘材料覆盖两根裸汇流线。
5. CP1/CP2/CP3 电解电容的引脚排在第 17 行，CP4/CP5/CP6 的 100 nF 电容排在第 21 行。电解正脚接支路正极、负脚接 GND；先核实实际直径、脚距及端子壳体空间，再折脚装入，不能让壳体挤压绝缘线或把相邻焊点顶在一起。

核心板、下载器和电脑串口
1. 核心板脱离教学大底板后，5V_LOGIC 接核心 5 V 输入，GND 共地。只禁用 JTAG，保留 SWD，释放 PA15、PB3、PB4。
2. SWDIO→PA13、SWCLK→PA14、GND→GND，可选 NRST。只有真正的 VTref 输入才按下载器说明接 3V3_CORE，不把下载器电源输出并入本机稳压。
3. 电脑 USB 串口 TXD→PA10、RXD→PA9、GND共地，供电脚均不接；先确认 TX 高电平约 3.3 V。核心 USB 数据口不用，PA11/PA12 已用于电机 PWM 和投放检测。
4. 通电调试时先建立本机逻辑供电，再接外部通信；单独断开核心电源时，先断串口 TX、ADC 采样线及其他可能向未供电核心送电的信号。

MCP23017、OLED 与 MPU6050
1. PB6=SCL、PB7=SDA，共享至 MCP、OLED、MPU，公共 GND；两根线的有效上拉各约 4.7 kΩ，均拉 3V3_EXT。已有模块上拉要计入，不能每块模块再无条件叠加一组。
2. MCP 使用 3.3 V 逻辑供电，A0/A1/A2 按模块标识接地，地址 0x20；RESET 以约 10 kΩ 拉 3V3_EXT，测试点可短到 GND，不能与核心 NRST 并接。INTA/INTB留空；GPA7/GPB7设置为输出0且不接外线。
3. MCP 的 GPA0/1/2/3→电机 AIN1/AIN2/BIN1/BIN2，GPA4→RC522 RST，GPA5→PWR 的灯控制，GPA6←语音 BUSY；GPB0/1/2←循迹左/中/右，GPB3←靠近，GPB4←编码器按键，GPB5/6←MODE/BACK。
4. OLED须确认是支持3.3 V的I²C版本。MPU的VIN按其原稳压路径接5 V或已确认的3.3 V节点；无论VIN怎样供电，SCL/SDA都不得被拉到5 V。MCP模块和AHCT芯片各自附近需100 nF去耦。

RC522 与 FLASH 的 SPI
1. PA5→两模块 SCK/CLK，PA6←两模块 MISO/DO/SO，PA7→两模块 MOSI/DI/SI；共用这三线及 GND。
2. PA4只接RC522 SDA/SS，PA15只接FLASH CS；两路片选各约10 kΩ上拉3V3_EXT。RC522上标SDA的脚在本方案中是SPI片选，不接PB7。
3. RC522和已确认的3.3 V SPI NOR FLASH供电均为3V3_EXT；RC522 RST接GPA4，IRQ留空。FLASH WP#/HOLD#若引出且未已有合适上拉，按实际芯片资料处理。
4. 首版总线线束尽量不超过20 cm，配地线，远离电机线；分别读ID通过后才共享使用，任意时刻只拉低一个片选。

所有数字传感器先确定输入适配方式
1. 循迹L/C/R→GPB0/1/2，靠近→GPB3，前方障碍→PB8，投放对射→PA12，DFPlayer BUSY→GPA6；光敏仅有DO时才另使用PB0数字输入。
2. 确认输出只有0/3.3 V时，可接目标输入，必要时串1 kΩ；确认是无5 V板载上拉的开集/开漏输出时，可用10 kΩ上拉3V3_EXT后接目标输入。
3. 需要5 V供电且输出高电平或板载上拉为5 V时，每路用：DO→10 kΩ→2N3904 B，B→100 kΩ→GND，E→GND，C→目标输入，C→10 kΩ→3V3_EXT。这个电路反相，软件必须记录输入极性。
4. 每路只选一种路径，不能同时接直通跳线和NPN适配。先不接MCU/MCP测输出，目标低电平应低于0.3 V、高电平约3.3 V；不要把ECHO分压普遍套到弱上拉数字模块。
5. PA12还要检查核心板USB已有上拉及拉低能力；投放采用普通输入轮询，不占PB12使用的EXTI12。

编码器、模式按键、碰撞和闭盖
1. 编码器确认支持3.3 V后，VCC→3V3_EXT，CLK→PB3，DT→PB4，SW→GPB4，GND共地。CLK/DT各10 kΩ拉3V3_CORE，SW约10 kΩ拉3V3_EXT；已有模块上拉不能把两路稳压经另一组电阻互接。
2. MODE、BACK分别接GPB5、GPB6，另一端GND，各约10 kΩ拉3V3_EXT。四脚轻触开关先测内部连通组，只跨按下才导通的两组接线。
3. 两只碰撞微动用NC串联：GND→左COM，左NC→右COM，右NC→PB12；PB12约10 kΩ拉3V3_CORE。正常0，碰撞或断线1。
4. 闭盖微动用COM/NO：COM接地，NO接PB14，PB14约10 kΩ拉3V3_CORE。机械完全闭盖压下时才读0，开盖或断线读1。

急停两组NC与三个三极管
1. 急停两组NC独立：VBAT_SW分别经过NC1/NC2和各自4.7 kΩ到QES1/QES3的B；三只2N3904的E接GND，各B以100 kΩ下拉。
2. QES1的C接QES2的B形成KILL_BASE，KILL_BASE经4.7 kΩ拉3V3_EXT。QES2的C形成STBY_OUT；PB5经1 kΩ到STBY_OUT，PB5和STBY_OUT分别10 kΩ下拉GND。
3. QES3的C接PB13，PB13以10 kΩ拉3V3_CORE。正常释放PB13低；按下或反馈线断开PB13高。电池电压只到接点偏置电阻，不直接到GPIO。
4. 先拔电机和舵机，以6.0/7.4/8.4 V逐点检查；按住急停并让测试固件PB5=1，STBY_OUT仍须低于0.3 V。恢复接点后仍须人工确认与新运动命令，不能自动行走。
5. 该电路需要核心和EXT逻辑电源正常；EXT失电不应允许MCU持续输出驱动高电平。STBY是待机去驱动而非机械制动，不能将其等同工业安全继电器。

AHCT缓冲、舵机与HC-SR04
1. SN74AHCT125N的14脚接5V_LOGIC、7脚接地并近接100 nF。1/4脚使能端接地；PA0→2脚、3脚→SG90信号；PB15→5脚、6脚→HC-SR04 TRIG。PA0/PB15各10 kΩ下拉。
2. 未用通道默认10/13脚接5V，9/12脚接地，8/11脚输出留空。采用蜂鸣5V缓冲分支时必须清除第9/10脚的全部原连线，再按本说明“PWR照明MOS、蜂鸣器与语音”及图解Word第61.8节执行五拆六增；原节点兼作分线，必须补回旁路，不能把PB9短接到GND或把5V短接到地。
3. HC-SR04 VCC为5V_LOGIC，ECHO经12 kΩ到PB1节点，节点再经20 kΩ到地；5 V输入理论约3.125 V，不互换上下臂，不在节点加大滤波电容。
4. SG90红线从PWR独立SERVO支路取5 V，棕/黑接地，信号来自AHCT的3脚；不把舵机供电穿过IO信号排针。先去掉摇臂空载验证，再装连杆；开盖运动与轮电机分时互锁。

轮电机和TB6612
1. 已核实TB6612驱动：VM取PWR的MOTOR支路，VCC取3V3_EXT，GND共地；GPA0/1/2/3接AIN1/AIN2/BIN1/BIN2，PA8/PA11接PWMA/PWMB，STBY只接STBY_OUT。
2. AO1/AO2到左电机，BO1/BO2到右电机；每只电机两端跨100 nF，电源成对走线，方向用架空测试确定，不能调换VM与GND。
3. 先架空只接一轮，低PWM起转，再接另一轮；换向先PWM=0、STBY=0并等待约100 ms。核对实际堵转电流与驱动能力，原套装风扇电机不当车轮电机。

DHT11、光敏与PWR板电池ADC
1. 额定支持3.3 V的DHT：VCC→3V3_EXT，DATA→PB11并以4.7 kΩ拉3V3_EXT，GND共地；如模块已有上拉计入总值。PB11以开漏方式拉低和释放。
2. 额定需5 V的DHT不能使用上述单向NPN适配；采用确认支持开漏双向信号的BSS138模块，HV→5 V、LV→3V3_EXT、共地，DHT DATA接HV通道，PB11接对应LV通道，并核两侧上拉。
3. 已确认3.3 V光敏模块的AO接PB0模拟输入；只有DO则改走数字适配分支，AO和DO不并接。实际5 V模拟输出需重新确定模拟分压与标定，不能通过开关NPN测模拟量。
4. PWR电池分压保持VBAT_SW→33 kΩ→BAT_ADC，BAT_ADC→10 kΩ与100 nF并联到GND，再接PA1。8.4 V时约1.953 V；采样线与地线成对并远离大电流铜线。建议使用可拔的ADC信号连接，单独断核心电源前先拔该线。

PWR照明MOS、蜂鸣器与语音
1. 照明控制来自GPA5，经100 Ω到AO3400A的G；G经100 kΩ接地，S接地，D接白LED负极；5V_LOGIC经220 Ω到LED正极。PWR必须与IO共地，GPA5线只带栅极信号。
2. AO3400A原器件1G/2S/3D；转接板排针顺序要导通实测，不能按模块图片猜。它只驱动小LED，不承担舵机或轮电机供电。
3. 蜂鸣三线模块确认3.3 V控制兼容后IN接PB9，电源按额定。PB9以10 kΩ偏置到不响电平：高有效下拉地、低有效上拉3V3_CORE；两者不能同时装。
4. 仅当三线蜂鸣模块明确需要5V控制输入时，按最新图解Word第61.8节启用AHCT通道3；拔电池、USB和调试器供电，断开外部模块并取下AHCT芯片后再改接。必须清除第9脚G9和第10脚G8的全部原连线，不能只拆各一根线。裸两脚蜂鸣器仍需另加已核电流能力的驱动级，不能直接接GPIO。
5. 五拆：拆除IO-W005（D10→G9）、IO-W010（G9→G12）、IO-W011（G9→G6）、IO-W038（A21→G8）、IO-W041（G8→G5）。前3条是GND，后2条是5V_LOGIC；G9/G8原来兼作分线节点，不能只断开芯片腿而留下不明支线。
6. 六增的前3条用于恢复旁路供电：D10→G12、D10→G6恢复GND；A21→G5恢复5V_LOGIC。这3条必须补回，以免R1下拉、未用第4通道输入和芯片供电支路断开。
7. 六增的后3条用于通道3：G8→D10（第10脚/OE3接GND）、G9→核心PB9（第9脚A3输入）、G10→蜂鸣模块IN（第8脚Y3输出）。全部使用绝缘线，只有端点焊接；PB9继续按模块不响电平设置约10kΩ偏置，高有效下拉GND、低有效上拉3V3_CORE，不把PB9上拉到5V。
8. 改后先不插AHCT、不接外部模块：核G9与原GND、5V_LOGIC无直连，G8仅并入GND，G5/G4仍通A21，G12/G6仍通D10，5V对地无持续短路；再插芯片，限流上电测PB9低/高与8脚输出，确认复位不响。默认四幅板图及142条连线记录保持原版；采用此选配者须在自己的施工记录划销上述5条并登记新增6条，不再逐条照默认图复接。逻辑连通检查不代替实焊通电验收。
9. DFPlayer VCC→5V_LOGIC，PB10经1 kΩ到RX，TX不用；BUSY按数字输入适配到GPA6。模块附近并100 μF和100 nF；喇叭跨SPK1/SPK2，两端都不接GND。

HC-05、原有备用模块和接口余量
1. HC-05带明确支持5 V的稳压底板才接5V_LOGIC；裸模块按其额定接3V3_EXT。RXD→PA2，TXD→PA3，GND共地，KEY/STATE留空。串口逻辑按3.3 V核验。
2. PA2已是3.3 V信号，不再随意串5→3.3 V分压把它降低。电脑CSV导出复用PA9/PA10外置USB串口。
3. 现有单路循迹、热敏模块、风扇电机和教学大底板作为独立实验备件；如临时替代通道，应断电拆原模块并记录，不能把两个输出并到同一输入。

焊接与镜像顺序
1. 先确认独立焊盘及孔距，按元件面标基准角和孔号；翻到焊接面按图左右镜像，仍使用同一实物孔号。先放端子、IC座、低矮电阻，再放电容和转接板；AHCT芯片最后插入。
2. 2N3904按到货厂家脚图确认E/B/C，AO转接按导通追踪G/S/D；未知实物不要按外壳平面方向强套。每焊完一小电路就按同网节点检查。
3. 跨越其他网络使用绝缘导线，交叉不代表连接；连接点才焊在同网焊盘。电源粗线单独固定，裸露焊点与板下螺钉/底板保持绝缘距离。
4. 两面完成后先不接任何模块，查5 V、EXT3V3、CORE3V3与GND无持续短路，查CORE/EXT没有直接连通，查所有原设计留空输出没有被误接地。

按阶段上电验收
1. 先只接限流电源与降压，测7.4/8.4/6.6 V输入时的5 V输出，再按原手册完成0.2/1/2/3 A分级与短峰值负载测试；没有实测不能把模块宣传峰值当持续额定。
2. 第二阶段只给逻辑上电，测5V_LOGIC、3V3_EXT、3V3_CORE；逐一接核心、MCP、OLED、SPI模块，每增加模块先断电。I²C空闲约3.3 V，片选默认高。
3. 第三阶段逐路测开关/数字输入、ADC约1.95V@8.4V、ECHO分压约3.125V@5V、AHCT两路输出及急停钳位；输入适配电路应先测再接MCU/MCP。
4. 最后接驱动、架空轮组及空载舵机，分开验证，再装机械负载；运行中记录5 V最低值及复位情况。发现异常先断电并回退到上一通过阶段。
5. 电池≤7.0 V持续3 s提醒，≤6.6 V持续1 s锁停，≤6.0 V立即停；恢复≥7.0 V仍需人工确认与新命令。单次上电成功不代替满载30分钟及断线故障试验。
