Sylphiette666/stm32-rfid-smart-bin/docs/manual/STM32与RFID智能移动垃圾桶_逐步组装与调试实施手册_图解增强版.docx

# STM32与RFID 积分式智能移动垃圾桶

逐步组装与调试实施手册 图解增强版

单台制作 复用现有模块 全部33项中等及以下功能

装配版本 2026 年 11 月 4 日 PCB B1及PLA一体结构

保留原版330个步骤和既有图解。电气施工先读第67章B1 PCB，机械结构读第68章，快速树形支撑和24小时目标的实际结果读第69章。旧版工程保留参考。

从配件核对、板材加工、机构试装到逐根接线、程序实现、整机验收，本册按制作顺序给出可执行步骤。先检查再上电，先做单项测试再合装，每个阶段均保留实测记录。

本册采用 | 制作时关注
核心板加PCB B1 | STM32F103C8T6与MCP23017成品模块；裸PCB手焊，旧PCF8574板与洞洞板孔号不适用。
轻型机械结构 | PLA一体底板及上平台筒壁，操作面板和活动盖可拆，见第68章。
一台完整样机 | RFID积分、轻型开盖、循迹停站、蓝牙、显示、语音与环境检测。
分阶段完成 | 机械加工和软件驱动可交叉推进；电源及停止回路通过后才接执行器。

请先在到货记录中确认模块型号、引脚、轮组孔距和急停接点条件；按本册的检查标准测量后填写实际参数。章节末有故障排查、制作记录和演示顺序，可用于课程答辩准备。

整机外观与图解读法

先看整机由哪些部分组成，再按正文步骤装配。下面的外观概念图用于理解两层底盘、桶体和开盖机构的关系；板件尺寸、孔位与电气连接以正文标注为准。

整机合盖与开盖的AI外观概念图，显示木质底盘、白色桶壳、读卡区和外置舵机。

外观概念图 合盖与开盖状态。AI生成示意，不是实物照片或加工模板。

看图顺序：先读图题，沿数字或箭头找操作顺序，再读图下说明，最后完成紧邻的步骤和“□ 检查”。图中绿色表示通过现象，红色可表示电源正极或需要处理的问题，必须结合文字判断。

机械图按毫米标注，剖面和局部会放大；长度以数字为准，不按打印图比例切割。接线图中的模块框按信号名排列，不能当作实物排针顺序。

当前B1电气施工先读第67章和随包接线表，再按原330步骤逐项调试。第63章A1和第61章洞洞板资料保留归档；B1的制造文件、接口和供电选择以第67章为准。模块仍按实物信号名称逐线连接。

目录

可点击目录或使用Word导航窗格跳转。步骤编号全册连续，便于在接线检查和问题记录中引用。

# 01 使用方法与本次装配基线

本手册用于制作一台基于STM32与RFID的积分式智能移动垃圾桶。按低成本、复用现有普中高配套装的路线，将中等及以下的33项功能落实为材料核对、机械加工、逐线连接、程序实现和验收步骤。制作时打印接线表与检查记录，在完成一项后签记结果。

图1 从配件核对到整机验收的顺序

图1 从配件核对到整机验收的顺序

执行顺序：先阅读本章和材料清单；完成无电机械试装；在桌面分别验证电源、核心板和各传感器；再接架空的电机及卸载的舵机；最后装入桶体、实现业务程序并逐项验收。每一步都包含操作与检查要求，不通过时留在本步骤排查。

项目 | 统一采用的规格或规则
主控与接线 | 核心板拆出独立固定；SmartBin_B B1 PCB汇总接线，模块在板外按信号名用编号线束连接。
扩展器 | 采用MCP23017，全部信号按本册映射。旧SmartBin Carrier V2.1及PCF8574底板不能直接替代。
桶体与盖板 | 固定外壳保留3 mm PVC发泡板；活动盖另购200×200×2 mm PVC发泡板，裁成160×150 mm。
内胆 | 1 mm PP板五片组装，底140×130；前后各140×120；左右各128×120 mm。加30×40 cm平口垃圾袋。
移动机构 | 双减速电机配65 mm轮；正文先按一个前万向球支撑装配，另列两个前万向轮的调整步骤。
电源 | 成品带保护2S 18650电池包，标称7.4 V、满电8.4 V；5 V降压后分电机、舵机、逻辑支路。
载荷 | 干燥轻小样品不超过0.30 kg；整机含样品目标不超过1.60 kg；平整室内地面演示。
运动盖质量 | 盖板、随盖运动的摇臂及紧固件一起称重，目标不超过40 g，设计上限45 g。
软件交付边界 | 本册提供实现顺序、配置、算法和测试方法。装配后仍须编写、编译并烧录与本版引脚一致的固件；不要直接烧录旧工程并接上全部负载。

“设定值”用于第一次调试，“实测值”须由万用表、电子秤或试验填写。模块名称不保证引脚顺序、供电方式或安装孔距一致；把实际丝印与引脚表对照后再接。所有结构图标注单位为mm，图形不是可直接打印描孔的等比例模板。

打开Word后可用“视图 → 导航窗格”按标题跳转。章节中的检查框是实际制作记录，空框表示尚未验证。开始运行前应完成电源、急停、轮子方向和开盖互锁的检查。

PCB B1施工顺序：先看第67章确认版号、贴片器件和线束，再回到步骤091—194逐模块检查，最后上软件及整机功能验收。旧版接口变化以第67章为准。

# 02 全部功能与实际效果

本项目选择低、低至中、中三档，共33项。下面按演示内容归组；后文逐项给出实现与验收步骤。

分组 | 功能编号与内容
RFID和账户 共9项 | A1刷卡识别；A2注册注销挂失；A3有效投放计分；A4掉电保存；A5查询积分；A6卡片数据块读写回读；A7管理员权限；A8记录及排行；A9虚拟奖励兑换。
桶体和投放 共6项 | B1刷卡开盖；B2投放事件检测；B3防重复计分；B4靠近开盖；B5满桶提示；B8维护清桶。
移动和检测 共7项 | C1差速移动；C2障碍停车；C3循迹；C4指定站点停靠；C6蓝牙遥控；C8倾斜报警；C9触边停车。
交互与维护 共8项 | D1屏幕界面；D2蜂鸣提示；D3独立按键；D4旋钮菜单；D5停止按钮；D6开机自检；D7电量显示；D8电脑串口调试和数据导出。
环境与声音 共3项 | E1温湿度显示；E2光敏照明；E4语音播报。

障碍功能的效果是检测后停车，循迹停站依靠地面标记顺序计数。投放对射只能检测物体经过；不识别垃圾类别，也不证明物体最终落入袋内。未刷卡的便捷开盖不积分。UID管理用于课设演示，不具备防复制身份认证能力。

本册不纳入称重、摄像头分类、自动回充、轮编码器闭环、自动回起点和Wi-Fi上传。盖边没有完整的防夹检测；演示时使用纸团等干燥样品，人员不把手放进运动中的盖边。

# 03 工作台工具与基础操作

工具可借用学校实验室。先掌握断电测通断、识别正负极、剥线压接及简单焊接，再连接核心板。

物品 | 规格和数量 | 用于哪一步
数字万用表 | 1台；直流电压、通断、电阻档 | 检查极性、短路、供电和信号电平。
可调限流直流电源 | 借用1台；输出覆盖8.4 V，能力满足分项试验 | 先小电流验证逻辑，再分阶段带负载。没有时仅用已检验模块逐级接入，不能跳过电压检查。
恒温电烙铁和支架 | 1套，适配细焊点的烙铁头 | 焊PCB直插件、AO转接板、接线端子和电容。
焊锡和助焊剂 | 细焊锡、电子用助焊剂、吸锡带各1份 | 清理虚焊或连锡。按所用焊料确定温度，不长时间烫器件。
小螺丝刀与扳手 | 适配M2、M3和所购端子 | 紧固螺钉；用实物头型选工具。
剥线钳和剪线钳 | 各1把；能处理20至26 AWG | 剥电源线及信号线，剪扎带。
钢尺 直角尺 游标卡尺 | 各1件；钢尺至少300 mm | 板件尺寸、孔距、垂直度和输出轴位置。
美工刀 垫板 细齿锯 | 各1套 | 多次浅划PP及薄PVC；木板用细齿锯。
手钻 钻头 锉刀 砂纸 | 2.2、3.2、4 mm等钻头；按护线圈另备对应孔径 | 钻先导孔、扩孔、修槽和去毛刺。
小夹具与护目镜 | 夹具至少2个 | 固定板材后钻孔，防止板件跟钻头转动。
电子秤 | 分度值0.1 g或更细，另有能称整机的量程 | 分别记录活动盖总质量、整机质量和载荷。
胶带标签与记号笔 | 1份 | 给板件、线束、电机左右方向和电源端子编号。
热缩管与扎带 | 热缩管多种管径；2.5 mm宽小扎带 | 覆盖露铜、固定线束和装PP内胆。
调试支架 | 稳固垫块2个或小台架 | 让两驱动轮离开桌面，第一次通电时车身固定。

### 步骤 001 划分工作区

桌面划为无电机械区、焊接区、通电测试区；电池放在远离金属碎屑的位置；每次只给当前模块接电。

□ 检查 工具和裸线不会跨在电源正负端；通电区看得见总开关。

未通过时 清扫碎屑，盖住未使用的电池插头。

万用表直流电压与断电通断的两幅接线示意，黑笔COM红笔VΩ。

图解 01 测电压时表笔并接两点；测通断前先断电，不能只把旋钮换档。

### 步骤 002 测电压

黑表笔插COM，红表笔插VΩ；选择直流电压档，先选足够量程；黑笔接地，红笔接被测点。

□ 检查 5 V母线测得正的约5 V；负号通常表示表笔或极性相反。

未通过时 立即核对正负，不能凭负号继续连接模块。

### 步骤 003 测通断

先拔电池和USB，再把表调到通断档；短接表笔确认蜂鸣，再测目标两点。

□ 检查 闭合开关/同一地网导通；相邻不相关焊点不导通。

未通过时 电容充电可能短暂蜂鸣；持续接近零欧时查连锡，不能带电测电阻。

三步电源线剥皮、压冷压端头和插入螺丝端子的示意。

图解 02 剥线、压接、锁紧、轻拉检查按顺序完成；裸铜不能伸到相邻端子。

### 步骤 004 制作一条电源线

量长度并加约30 mm余量，剪线；按端子要求剥约4至6 mm；绞齐铜丝，优先压合合适冷压端头，再锁入端子。

□ 检查 绝缘皮到端子边缘，外面无散丝；轻拉不脱。

未通过时 端子不容纳端头时按厂家方法处理裸绞线，不用过长露铜或大锡团硬塞。

独立焊盘洞洞板的元件面、焊接面及合格、裂纹和连锡焊点放大图。

图解 03 旧洞洞板焊接方法示例。PCB A1按第63章焊接；焊点发亮程度不能单独证明接触可靠。

本图保留用于识别焊盘与焊接基础。当前使用SmartBin_A A1双层PCB替代原PWR、IO两块洞洞板，板内连接由铜箔完成；不得再照旧孔位补142条飞线或两根裸汇流线。模块仍在板外固定并用编号线束连接。

### 步骤 005 完成一个焊点

断电固定器件；烙铁同时加热焊盘和引脚，送少量锡；先撤锡丝后撤烙铁；冷却后剪脚。

□ 检查 焊点覆盖焊盘与引脚、无活动裂纹、相邻焊盘无桥接。

未通过时 吸走多余锡后重焊；胶带和热熔胶不能补救电气接触不良。

### 步骤 006 检查一颗四脚轻触按键

用通断档找出未按下就导通的两脚为同一侧；选择两组中各一脚接入；按压复测。

□ 检查 松开断开、按下导通。

未通过时 换到另一组脚，不能只按外观把任意两脚作为开关。

### 步骤 007 检查双常闭急停

用通断档识别两组独立NC；释放时分别导通，按下锁住后均断开；旋转复位。

□ 检查 两组之间始终不互通，按下后保持断开。

未通过时 一组接点或复位不稳定就不装；接点额定条件还须符合后文接口电路。

# 04 已有配件逐一登记

将现有套装全部拿出拍照并贴标签。表中“核对后复用”表示先确认器件型号、电压和输出形式；已拥有并不等于适合直接连接。

编号与配件 | 数量与用途 | 装前动作
H01 STM32核心板 | 1块 主控 | 拆下前拍正反面；断电后两侧均匀拔出，不拉USB座。
H02 OLED液晶模块 | 1块 菜单积分显示 | 确认I²C四线型，登记SCL/SDA与供电；SPI型不能照接。
H03 MPU6050模块 | 1块 倾斜检测 | 核对供电稳压及I²C上拉，固定安装时标前向。
H04 电机驱动模块 | 1块 两轮驱动 | 读芯片字样，须与TB6612FNG接口一致；若只有单向驱动器则另购双H桥。
H05 蜂鸣器模块 | 1块 提示音 | 记录有源或无源、自带驱动与有效电平。
H06 单路红外寻迹 | 1块 备用与光电标定 | 保留原模块；主循迹使用补购三路阵列，不能把一只单路当三路。
H07 红外避障 | 1块 前方障碍 | 先测黑白目标与高低输出电平；靠近开盖另需一只。
H08 FLASH模块 | 1块 日志账户保存 | 读取芯片型号与JEDEC ID；确认3.3 V SPI NOR。
H09 光敏模块 | 1块 明暗检测 | 有AO时读ADC，无AO只读DO并只显示明暗。
H10 热敏模块 | 1块 备用 | E1采用DHT11同时读温湿度；热敏模块不与光敏同时并到PB0。需要实验可断电换接并修改软件，不能将两模块输出并联。
H11 旋转编码器 | 1块 旋钮菜单 | 登记CLK DT SW，常见模块需3.3 V供电避免5 V上拉。
H12 SG90位置舵机 | 1个 轻型开盖 | 保留原螺丝、舵盘；先卸载测试；360°连续旋转版本不能代替。
H13 DHT11 | 1只 温湿度 | 裸四脚与三脚模块不同，按正面图/丝印逐脚核对。
H14 ARM仿真器 | 1个 SWD下载 | 确认支持STM32及其驱动；记录SWDIO/SWCLK/GND/电压参考。
H15 杜邦线和面包板 | 已有数量 台架信号验证 | 检查插头压接；长期带电机电流不用面包板和普通杜邦供电。
H16 USB线 | 已有数量 下载器及串口板 | 本版核心板USB数据口不使用，PA11/12已另有用途。
H17 风扇电机与风叶 | 1套 备用 | 不能替代有减速箱的驱动车轮；不接本项目电机输出用于整机行走。
H18 教学大底板 | 1块 课程独立实验 | 保留作为实验器材；本次样机使用拔出的核心板，不把整张大板堆入车体。

# 05 新增电子配件清单

以下数量按制作一台完整样机列出；线材和常用小件含少量余量。先从已有配件中抵扣。每种电阻的实际安装数取决于模块自带上拉、缓冲情况，以接线章逐点检查结果为准。

可直接搜索的名称 | 购买数量 | 规格与作用
RC522 RFID模块 13.56MHz SPI 配S50卡 | 1套 至少3张卡 | 3.3 V；管理员、普通用户、专用读写实验卡分别标记。
MCP23017 I2C IO扩展模块 | 1块 | 使用3.3 V，A0至A2可接地，RESET可访问；GPA7/GPB7保留输出。
三路红外循迹传感器 数字输出 3.3V | 1块 | 三路独立L C R，支持3.3 V信号；安装高度及间距按实物标定。
红外对射传感器 发射接收一对 开集电极输出 | 1对 | 光束能跨过内胆，接收端可上拉到3.3 V；不要买仅模拟输出且无比较器的裸光敏对。
红外避障模块 可调距离 3.3V输出 | 1块补购 | 用于前操作区靠近开盖，与已有前障碍模块分开。
HC-SR04 超声波测距模块 | 1块 | 5 V型，ECHO必须按本册分压后接STM32。
HC-05 蓝牙串口模块 带稳压底板 | 1块 | Android SPP遥控，UART为3.3 V；供电按底板说明。
CP2102 USB转TTL串口 3.3V逻辑 已焊排针 | 1块 | 只连TX RX GND；3.3 V电源针存在不代表TX一定为3.3 V，要核对。
DFPlayer Mini MP3模块 | 1块 | 5 V支路供电，带TF槽，使用厂家串口协议。
小喇叭 8欧 1瓦 | 1只 | 配DFPlayer，小音量调试，跨SPK1/SPK2不接地。
MicroSD TF卡 8GB 或16GB | 1张 | 可靠品牌，按DFPlayer支持格式FAT16/FAT32格式化，装专用语音文件。
6V微型直流减速电机 配65mm轮 支架 | 2套同型号 | 5 V使用；空载50至100 rpm优先50至60；工作扭矩至少0.3 kgf·cm；5 V堵转电流不超过1 A每只。参数不明先验证，不能按“TT电机”字样直接保证。
18650 2S带保护成品电池组 7.4V 2600mAh | 1组 | 满电8.4 V，持续放电能力至少5 A；带绝缘外皮与可靠成品接线，不自行焊裸电芯。
8.4V 1A 两串锂电池充电器 | 1个 | 插头和极性与电池成品包匹配，按电池厂家方式充电。
DC-DC降压模块 可调输出5V 持续3A | 1块 | 输入覆盖2S电池范围，实测3 A持续，短时峰值至少4 A；散热条件计入。
DC-DC或LDO 3.3V稳压模块 | 1块 | 输入5 V，输出至少200 mA；不与核心板3V3输出并联。
急停按钮 22mm 自锁旋转复位 2NC 红蘑菇头 | 1个 | 两组独立常闭，配后文电池侧偏置及三极管适配电路；接点可靠工作条件须核对，不能按旧3.3 V弱上拉直连。
微动开关 带滚轮或长柄 COM NO NC | 3个 | 左右碰撞各1，盖闭合1；按实际支架选择手柄长度。
轻触按键 6×6×5mm 四脚 插件 | 2个使用 可买10个包 | MODE与BACK；常开复位型，必须先测成对脚。
AO3400A SOT23 N沟道MOS管 | 1只使用 可买3只 | 小灯低侧驱动；是场效应管，不是成品模块。
SOT23-3 转DIP 2.54mm 转接板 | 1块 | AO裸管先焊至已购转接板，再按实际G/S/D接J28并绝缘固定；不是商品板直插针序。
白色LED 5mm 直插 | 1只使用 可买3只 | 配220Ω串联限流，不用大功率灯珠。
SN74AHCT125N DIP14 | 1只 标准装配 | U1将舵机、超声和可选蜂鸣控制缓冲为5V；配DIP14座，C8为100nF。不能换成74HC125。
DIP14 IC插座 2.54mm | 1只 | AHCT125插座，焊完检查后再插入芯片，缺口方向一致。
2N3904 NPN三极管 TO92 | 建议买10只 其中3只用于急停 | 其余用于传感器电平适配和备件；每批按厂家引脚图确认E B C。
金属膜电阻 1/4W 1% | 10kΩ 50只 100kΩ 20只 其余各10只 | 其余值为100Ω、220Ω、1kΩ、4.7kΩ、12kΩ、20kΩ、33kΩ；足量预留输入上拉及适配。
104 100nF独石或瓷片电容 | 10只起 | 电源旁路及两电机端子抑制干扰；按电路实际计数补足。
低ESR 高频低阻 电解电容 105℃ 16V | 100µF 3只 470µF 2只 1000µF 2只 | 逻辑与DFPlayer各100µF，驱动470µF，舵机1000µF就近安装，余量作备件。
5×20mm 带盖保险丝座 带线 | 1个 | 线至少20 AWG，额定直流条件适合本系统，座额定至少5 A。
5×20mm 3A保险丝 | 3只初选 | 通过启动与负载测试选最终动作特性；不能用铜丝短接。
直流电源总开关 带端子 | 1个 | 直流额定覆盖8.4 V及至少5 A，独立于信号急停。
XT30U 公母对插 带线 18AWG或20AWG | 1对 | 每侧约10至15 cm；电池侧用接触件内凹端；按实际正负标识核对。
KF301-2P 接线端子 5.08mm 直插 | 6个起 | J1—J6共6个；5.08mm脚距，需核实外壳及脚形与PCB封装，螺丝刀与进线空间可达。
SmartBin_A A1 裸PCB 双层100×100mm | 实际装配1块 订板数量按订单 | 1.6mm、1oz，已有洞洞板保留备用；按新制造文件订裸板，不下SMT贴片单。
2.54mm 单排排针 排母 | 本板信号/跳帽共169针，至少5条40Pin排针 | 从已购2.54mm单排排针按接口裁切，不足才补；模块自身排针及损耗另计，跳帽另备。
软硅胶线 20AWG 红黑 | 各2 m参考 | 主电源和分支；18 AWG亦可。
镀锡实心铜线 直径0.8mm | 已有保留备用 | PCB A1不用旧洞洞板两根裸汇流线，不再为本板补购；主电流仍用规定绝缘导线。
软硅胶线 22AWG 红黑 | 各1 m参考 | 短电机及舵机支线；按实物端子容纳范围。
杜邦线 26AWG 母对母等 | 已有优先 | 信号短线约10至20 cm；长度现场量后裁配。
SG90 舵机延长线 JR 3P 公对母 30cm 22AWG | 1根 | 三根导体，针距2.54 mm；核对红5 V、棕/黑GND及信号顺序。

急停适配所需三极管和电阻已在常用小件中预留；按电气章的附加物料表核对实际安装数量。若采用裸磁性蜂鸣器，还需其驱动与续流元件；已有带驱动模块优先复用。型号未知的模块先按装前识别流程确认，暂不接入电源。

# 06 结构件与耗材清单

板材外形按下列采购尺寸准备，加工尺寸以机械章为准。孔距由实物描孔，不提前凭商品图钻完全部孔。

可搜索的名称 | 数量 | 明确规格与用途
胶合板 木板 300×300×5mm | 2片 | 裁底板280×220、上平台240×190；剩料做舵机架和支撑。
PVC发泡板 雪弗板 白色 500×500×3mm | 保留原有 共2片足够 | 固定桶壳与附件板；不是实心硬PVC。
PVC发泡板 雪弗板 白色 200×200×2mm | 新增1片 | 只用于活动盖，裁160×150；剩料可做局部补强。
PP塑料板 500×500×1mm | 1片 | 五片内胆；不用旧0.5mm折叠展开图。
PE垃圾袋 平口 宽30×长40cm | 1小包 | 宽指平铺宽度，袋底落在内胆底板，不悬挂承重。
万向球轮 球直径15mm | 1个主方案 | 总安装高度加垫片达到底板离地45 mm；固定孔按实物。
1寸25mm万向轮 无刹车 PU或橡胶 | 仅选双前轮时买2个 | 替代主方案万向球，安装总高约35至40 mm加垫片至45 mm；不同时装三只前支撑。
M3双通尼龙六角隔离柱 60mm | 4根 | 整根双内螺纹，支撑上平台；不拼接两根30mm。
M3双通尼龙六角隔离柱 10mm | 12根 | 电路模块安装，不代替60mm平台柱。
M3机牙螺丝 螺母 平垫片 | M3×6 20只；×10 30只；×12和×16各20只；M3螺母40只、平垫100只 | ×10约24只、×6约12只用于隔离柱；较长螺钉用于角码与转接件并留余量。按实际夹持厚度选；尼龙柱内不能拧到底硬顶。
M2十字盘头螺丝 304不锈钢 | M2×8 10只 M2×10 10只 | 螺距0.4 mm；长度不含螺丝头，具体安装用量按实物。
M2尼龙圈防松螺母 DIN985 | 20只 | 金属螺母内带尼龙圈，不是全塑料螺母。
M2平垫片 内径2.2 外径5 厚0.3mm | 40只 | 用于分散塑料孔边压力，紧固不压坏PP或PVC。
小合页 铰链 约20mm | 2个 | 运动顺畅，无明显卡涩；把随盖运动部分计入盖质量。
航模M2双球头可调拉杆 孔中心距50mm | 1套 | 一根杆加两球头，调节范围覆盖50；配M2紧固件，球孔尺寸单独确认。
SG90匹配舵盘 舵臂 | 复用原件 不足再补 | 需形成转轴到球头20 mm有效半径；花键匹配现有SG90。
小直角角码 20×20mm | 约10个 | 固定壳体、转接片和舵机架，数量随采用的连接方法调整。
方木条 5×5mm | 约1 m或复用边角料 | 用于外侧局部加固；本版壳体用外角码，不装占据内胆通道的全高内角木条。
魔术贴绑带 带塑料扣环 20×300mm 无背胶 | 2条 | 固定电池；缠回粘合至少50 mm。
EVA泡棉胶条 单面背胶 宽10厚2mm | 1 m | 盖前缘缓冲与碰撞条局部垫；不要满圈压紧导致舵机过载。
PE双面泡棉胶带 宽20厚1mm | 5 m 1卷 | 辅助固定轻件；电机、舵机架、重电池用机械紧固。
尼龙扎带 宽2.5长100mm | 50条参考 | 内胆接缝约16条，其他整理线束；剪平尾端。
橡胶护线圈 穿线内径8mm | 按实际过线孔 2至4个 | 壳体选卡槽适合3mm板厚，木板选适合5mm；安装开孔按商品尺寸图。
哑光白色海报纸 90×120cm | 已有5张 | 4张拼成180×240cm，1张备用；初调可用2张120×180cm。
黑色电工胶带 宽18mm | 1卷 | 无岔路循迹线；站点横条用多条拼成100×40mm。
标签纸 热缩管 布基胶带 | 各1份 | 线束编号、绝缘、防磨及纸张背面接缝。

### 步骤 008 按用途分袋

把电源件、逻辑板、传感器、机械紧固件分别装入袋；每袋贴名称、数量及去向，不混放M2与M3。

□ 检查 与上表逐项勾对；已拥有的物品没有再次计入采购。

未通过时 缺件先列入记录，不用临时裸线代替保险丝座和开关。

### 步骤 009 记录所有未知型号

对驱动芯片、FLASH、稳压板、OLED、急停接点拍清丝印；在后面的到货记录表填写型号与数据表来源。

□ 检查 至少明确电压、输出形式、额定负载、接口针序。

未通过时 找卖家或数据表确认；模块接线暂留空，不把猜测写成实测。

### 步骤 010 准备干燥投放样品

选轻纸团、小纸盒、泡棉块，单次尺寸确保不会卡住内胆开口；总样品质量称重。

□ 检查 全部干燥、无锐边，合计不超过0.30 kg。

未通过时 分成更小样品，移除金属重物、液体和有黏性的材料。

# 07 本次采用的结构与加工边界

先把最终结构锁定，再开料。本章是低成本单台样机的制作工艺，不把未实测的电机孔距、舵机花键或传感器外形当成统一标准。所有长度单位均为 mm；坐标用于定位，不代表电子模块的焊盘坐标。

图2 更新内胆与盖板后的整机侧视和高度链

图2 更新内胆与盖板后的整机侧视和高度链

部位 | 本版确定做法 | 不要沿用的旧说法
承载结构 | 底板 P01：280×220×5 胶合板；上平台 P02：240×190×5；4 根 M3 双通尼龙六角柱 60 mm | 不把两根 30 mm 拼接当作本版默认做法
桶壳 | 外包络 160×150×180；仍用 3 mm PVC 发泡板，桶壳固定在 P02 | 不是实心硬 PVC；不把 PP 内胆尺寸当作桶壳尺寸
活动盖 | 160×150×2 PVC 发泡板；由另购 200×200×2 板裁出 | 旧版 3 mm 活动盖没有充分质量余量
质量 | 称量盖、随盖摇臂、活动连接件、加强片和胶带等；目标≤40 g，45 g 为本设计上限 | 达到质量限值也仍需验证摩擦、联动和舵机发热
内胆 | 1 mm PP 五片拼装；底 140×130；前后各 140×120；左右各 128×120；约 140×130×121 | 不照 0.5 mm PP 一体折叠展开图加工
垃圾袋 | 平口 PE 袋平铺尺寸 300×400；折边在内胆外侧，袋底落在内胆底部 | 垃圾袋本身不能承担悬挂载荷
开盖机构 | 两摇臂有效半径各 20；两固定轴中心距 50；双球头拉杆两孔中心距 50；常用开盖 70° | 拉杆商品所写 50 mm 不一定是装配后的孔心距
轮组 | 两只相同减速电机和配套轮；参考轮直径 65、轮宽 26；默认前部一个万向球 | 套装风扇用直流电机不能直接替代减速轮组
安装辅料 | 电池绑带 20×300 带扣环 2 条；EVA 10×2 单面背胶；双面 PE 泡棉胶 20×1 | MPU6050 要刚性固定；电机、舵机、电池不能仅依靠泡棉双面胶
电子固定 | M3 双通尼龙六角柱 10 mm 共 12 根；固定 3 块合适孔位的托板，每块 4 根 | 12 根不足以让十余块模块各用 4 根；小模块固定到托板

需补齐的普通紧固件：M3×10 机螺钉约 24 颗用于 4 根上下层立柱和 12 根托板立柱的底部；M3×6 约 12 颗用于薄托板上端；M3×12 或 ×16 螺钉、M3 螺母及平垫用于角码和转接片，按实际夹持厚度选用。尼龙柱有有效螺纹深度限制：5 mm 板加垫片后，M3×10 通常留下约 4～4.5 mm 咬合，必须实际试拧，不能靠过长螺钉顶紧柱内底部。M2×8 和 ×10、M2 防松螺母、2.2×5×0.3 平垫用于轻型连杆与小支架；SG90 舵盘中心螺钉保留原配。所有用量均含装配余量，实际位置先试装。

两处结构要增加转接件：电机与万向球之间采用按实物描孔的胶合板或金属转接片；舵机侧架需要一块约 80×40×5 的胶合板调节托片。两张 300×300×5 胶合板可以满足目前的主要木件：第 1 张放 280×220 底板，余下 80 mm 宽区域可放旋转后的 190×60 立架和 80×40 托片；第 2 张放 240×190 上平台，余料做转接片与三角撑。排料边界及相邻零件之间留约 5 mm，先画全再切。后部固定压条约 150×10～12×3，可从已有 3 mm PVC 余料做。摇臂、铰链固定区域要局部加强，但随盖加强件也必须计入 45 g。

# 08 工具 实测记录与纸样预装

真正开始钻孔前，先用纸样、实物和直尺证明各部分能够放下。对缺少可靠尺寸的模块，描孔比套用网图更可靠。

图3 两张木板的主要板件排料参考

图3 两张木板的主要板件排料参考

工具 / 辅助材料 | 用途 | 使用要点
钢直尺、三角尺、细记号笔、游标卡尺 | 标外形、测孔距和厚度 | 板件每条边都标“零件号 / 内外面 / 前后方向”
切割垫、美工刀、细齿锯或曲线锯 | PVC、PP、胶合板下料 | 胶合板以细齿锯加工；1 mm PP 多次浅划后再切透；不强掰粗糙切口
手钻、小夹具、废木垫板 | 打导孔、正式孔与槽端孔 | 工件先夹牢；孔下垫木；不得手持小片直接钻
1.5～2、2.3～2.5、3、3.4 mm 钻头，锉刀 | 导孔、M2 间隙孔、扎带孔、M3 间隙孔 | 实际螺钉必须能自然穿过，不能靠旋入薄板扩孔
电子秤、普通秤、水平尺 | 活动盖质量、整机质量、底盘调平 | 盖用分辨率 0.1 g 或更好的秤；整机记录空载和装样后质量
胶带、硬纸板、木块、纸片、尼龙扎带 | 模板、轮下支撑、间隙与线束检查 | 纸样只用于试装，不能替代最终承重件
十字螺丝刀、小扳手、剪钳 | 螺钉与防松螺母装配、剪扎带 | 一手固定螺钉、一手拧螺母；不得让旋转的螺母磨穿软板

### 步骤 011 M01 建立零件分盒

把木板、PVC、PP、M2、M3、轮组、舵机机构和电池固定件分别装袋；袋外标名称和数量。对所有已到货模块拍正反面照片，照片放入项目目录的“实物记录”。

□ 检查 有一张实物数量表；相似尺寸螺钉没有混装；所有电子模块在切削区之外。

未通过时 缺零件先在清单上记录，不用不明螺钉或不合适支架强行代替。

### 步骤 012 M02 测量轮组

记录轮实际外径、轮宽、轴孔型式、轮毂外伸、轮轴到电机安装面的距离、支架孔距。把轮子只装到一个电机轴上，手转一圈观察偏摆。

□ 检查 两轮直径相近；轮毂与轴匹配；轮子不明显晃动；轴与轮毂之间有可靠锁定方式。

未通过时 轴不配就更换匹配轮毂或轮子，不能靠热熔胶填孔承受驱动力；先解决偏摆再确定侧向间隙。

### 步骤 013 M03 测量万向球与电池

把万向球平放硬板，测安装面到地面的真实高度和孔距。电池测长、宽、厚，包含套管、出线护套及弯线空间。电池全程不放在钻孔区域。

□ 检查 记录球轮总高度 Hc，而不是只记录球直径；电池能放在底层且有两条绑带包绕路径。

未通过时 球轮不够高时用刚性垫块补高；不能用多层软泡棉承担高度差。电池过高就调整托盘位置，不能压弯保护板或出线。

### 步骤 014 M04 测量 SG90 与拉杆

卸下拉杆，保留原舵盘和中心螺钉。记录舵机安装耳孔、输出轴到壳体边缘距离、原盘最大可用孔半径。测双球头拉杆实际孔心距及其可调范围。

□ 检查 拉杆能调到 50 mm 并保留两端合理螺纹咬合；舵盘能实现 20 mm 有效半径，或已准备轻型延长臂。

未通过时 球头孔不能配 M2 螺钉时换匹配件；原盘半径不足时加轻型延长臂，不能把连杆接在任意孔后继续沿用 20 mm 参数。

### 步骤 015 M05 制作底盘纸样

在硬纸板画 280×220 底板及 240×190 上平台。底板标车尾、车头、中线；把电池、模块、轮支架放在纸样上。检查螺钉从下方可装入、端子侧面能插线。

□ 检查 实物不堆叠挤压；电池与电路有各自区域；上平台可拆；万向球与传感器支架不会共用同一孔而打架。

未通过时 用铅笔改安装点和托盘布局，外形未确定前不在正式板上连钻多个孔。

### 步骤 016 M06 制作桶壳与内胆纸样

用纸板临时围成 160×150×180 桶壳，另做 140×130×121 内胆；摆入假盖、超声横梁和舵机侧架。沿计划取袋方向手动拆出内胆。

□ 检查 在拆杆、开到维护角度并移走横梁后，内胆能垂直取出，侧面线束不随之拉动。

未通过时 先扩大可拆检修路径，不能先做窄死口再用力挤出正式 PP 内胆。

# 09 坐标 外形与孔槽 先标线后钻孔

统一规定：X 从车尾向车头，Y 从车体中线向舵机所在侧为正，Z 从地面向上。底板局部坐标的左下角为 (0,0)，板宽方向局部坐标 yb=Y+110。上平台左下角在底板坐标 (20,15)。

图4 底板与上平台的统一坐标和四柱定位

图4 底板与上平台的统一坐标和四柱定位

对象 | 定位 / 下料值 | 必须复核之处
P01 底板 | 280×220×5；四角去锐边约 C2 | 外形目标误差 ±1；用角尺核对相邻边
P02 上平台 | 240×190×5；放在 P01 的 X=20～260、yb=15～205 | 两板长边平行；四柱连接不扭曲
4 个立柱孔 | P01：(30,25)、(250,25)、(30,195)、(250,195)，孔径 3.4 | P02 对应：(10,10)、(230,10)、(10,180)、(230,180)
参考驱动轴 | 两轮轴心在 X≈90；轮中心参考 Y=±125 | 按轮宽、支架偏置和轴伸修正，轮胎到固定件实际净隙至少约 3 mm
电机转接长槽 | 参考中心 X=65、115，yb=25、195；长边沿 X，20×3.4 | 只有实物转接片覆盖并避开立柱后才加工；不能直接当电机安装孔
电池绑带槽 | 2 条绑带；每条对应电池两侧一对槽。槽建议 24×4，长边沿 X | 槽宽为绑带厚度与穿带间隙；24 是 20 mm 绑带的横向余量。两侧位置按电池宽度决定
万向球支承 | 参考接地点 X≈240、Y≈0；用转接片配实际孔距 | 不预先套用固定孔距；传感器与转接片要错开
桶壳底部定位 | P02 上桶壳后缘 X=70、前缘 X=230、左右 Y=±75 | 开盖侧杆件需额外外部空间，不计入桶壳净口
高度链 | 底板底面 Hb；底板顶面 Hb+5；P02 底面 Hb+65；P02 顶面 Hb+70 | 参考 Hb=45 时对应 45 /50 /110 /115；实物不满足时统一更新所有 Z 值

高度链的含义：60 mm 立柱立在底板顶面上，托住 5 mm 厚上平台；不能把“底板底面到上平台顶面”误当成 60 mm。参考 65 mm 轮的轴心高为 32.5 mm。若 Hb=45，轴心比底板底面低 12.5 mm；这只是装配目标，实际电机壳体必须能在该高度下放入。高度需要改动时，用木块调平后记录新 Hb，而不是强行弯电机支架。

### 步骤 017 M07 在板材上排版

先画 P01、P02、舵机立架 60×190、舵机调节托片约 80×40 和各转接片外形；每件之间留锯缝。把电池包、模块全部移离加工台。

□ 检查 有足够余料制作转接件；没有把锯缝计入成品尺寸。

未通过时 大板不够时优先保住 P01/P02 完整，不拼接主要承载板；支架用独立余料。

### 步骤 018 M08 切割胶合板并校正

板下垫废木，沿线外侧锯切；锉到尺寸线，磨去毛刺；两片板放平检查翘曲。

□ 检查 长宽落在目标 ±1 范围；平放不明显摇晃，边缘不割手。

未通过时 翘曲明显的板换料；不要靠拧紧四根尼龙柱把翘板硬拉平。

60毫米双通柱位于两块5毫米木板之间；10毫米双通柱位于薄托板和支承板之间，两端分别加平垫及螺钉。

图解 04 先按剖面试装一根，确认板被夹紧且螺钉未顶底，再装其余立柱。

### 步骤 019 M09 上下平台配钻立柱孔

先只在 P01 标 4 孔，画十字并用小钻头打导孔。将 P02 按偏移 (20,15) 贴合在 P01 上，夹牢后配钻；最后扩至 3.4。每完成一孔可穿临时螺钉防滑移。

□ 检查 4 根 M3 螺钉都能自然穿入两板，放松时板不被迫扭曲。

未通过时 小于约 0.5 的误差可用锉刀轻修间隙孔；偏差很大重做局部转接，不把所有孔扩成松散大洞。

### 步骤 020 M10 预装四根 60 mm 柱

把平垫、M3 螺钉、底板、60 mm 双通柱依次连接，先用手旋入。放上 P02 与上侧螺钉，按对角顺序拧到不松动即可。

□ 检查 四柱竖直；两板平行；手压对角无响动；尼龙螺纹未滑牙。

未通过时 螺钉未压住板却已拧不动，说明可能顶到底，换短螺钉或合适垫片；滑牙柱直接换新。

### 步骤 021 M11 描电机转接槽

取下上平台；把实物电机支架、轮与转接片放到底板下方，按左右相同 X 定位。先描槽中心和转接片孔，检查与立柱、绑带槽不交叉，再钻槽两端并锉通。

□ 检查 20×3.4 长槽允许前后微调；支架螺钉和垫片覆盖槽边；转接片有足够宽度承托。

未通过时 若实物不适合参考槽位，保留原板不钻该槽，改转接片孔位；不能把电机只有一颗螺钉的状态当成最终固定。

### 步骤 022 M12 加工电池绑带槽

电池放在纸模板上标外包络，先移开电池，再在底板上转印。两条带沿 Y 包绕，带中心沿 X 错开；每条带左右各留一槽，建议 24×4。钻两端后锉通，槽边磨圆。

□ 检查 20 mm 带能平顺穿过；带与电池出线、开关、底面传感器均不相撞。

未通过时 槽过窄先锉宽，不能割窄绑带；电池两侧槽间距不足时重做单独电池托片，避免乱开底板。

# 10 驱动轮 万向球和底盘调平

先搭建能被手推的无电底盘，再接电调试。所有“向前”均以 X 正向为准。第一次通电轮组必须架空；这一电气步骤在上电调试章执行。

### 步骤 023 M13 装左右减速电机

给电机贴 L、R 标签。把配套支架固定到电机规定安装部位，再固定到转接片；不用螺钉顶住塑料齿轮箱或线端。支架下加平垫，螺母先半紧。

□ 检查 两个电机没有被支架挤变形；出线朝向能避免轮胎扫过；转接片不突出擦轮。

未通过时 若安装孔不匹配，重做转接片；不在齿轮箱上自行钻穿孔。

两驱轮和前万向球的侧视图，标出5毫米底板、60毫米立柱、参考45毫米底板离地高度，以及万向球总高与刚性垫块。

图解 05 测万向球总高度，再配刚性垫块；以驱动轮接地可靠、车体不摇晃为准。

### 步骤 024 M14 安装轮子并留侧隙

按轮轴结构装入轮毂并锁紧。测左右轮内侧与底板、螺钉、支架的最小距离，手转整圈。轮中心 X 尽量同为 90；Y 根据实物外移。

□ 检查 整个圆周无擦碰；最小净隙目标≥3；两个轮轴大致共线，左右轮前后错位目标≤1。

未通过时 参考 Y=±125 对 26 mm 宽轮只有约 2 mm 板边净隙，通常应外移到至少约 ±126；若轮宽更大或偏摆明显，继续按实测外移并更新总宽。

### 步骤 025 M15 确认底板高度

用两轮接触地面，把车头用木块垫起。测底板四角离地高度，尝试接近 Hb=45；同时检查电机壳体与底板、地面的间隙。

□ 检查 电机固定牢且壳体不受压；底板左右水平；确定一个可实现的 Hb 并写在总装记录。

未通过时 目标 45 无法实现时，按实际轮组调高 Hb 并同步改变前支撑高度；不削薄电机壳体、不让轮胎压在底板边缘。

### 步骤 026 M16 安装前万向球

制作刚性转接片；按实物描孔。万向球安装面到地面为 Hc，底板下所需刚性垫高约 Hb−Hc。装到参考 X=240、Y=0。用垫片微调但避免多层松散堆垫。

□ 检查 三处接地点同时着地；底板前后水平；球能自由滚动，转接片或螺钉不碰地。

未通过时 若 Hc 大于可用 Hb，选更低球轮或提高整个底盘；若垫高过大，制作一体木垫块并贯穿螺栓固定。

### 步骤 027 M17 无电手推检查

把空底盘在平整硬面缓慢前推、后推、左右转向；观察轮子、万向球和支架。随后扭动底盘确认连接件不松。

□ 检查 移动平顺，无规律性蹭擦；没有一只驱动轮悬空；螺钉没有因转向松脱。

未通过时 阻力来源逐个隔离：先拆球轮检查，再单转驱动轮；修正机械阻力后再考虑软件 PWM。

### 步骤 028 M18 紧固与标记

对支架、转接片和轮毂锁紧，尼龙柱保持适度紧固。用记号笔在关键螺母和固定板之间画对齐线。记录轮径、轮距、Hb 与当前空底盘质量。

□ 检查 标记线便于以后发现松动；不存在空转滑牙螺钉；车轮外侧没有尖锐螺栓。

未通过时 需穿出多余长度的螺钉换合适长度，不能留下会勾衣物或划手的长尖端。

双前万向轮分支：仅在用户实际选择 2 只前万向轮时执行。采用两只相同约 25 mm 轮径、无刹车型；测实际安装高度而非用轮径代替高度。前转轴参考 X=240、Y=±70，安装高度统一配到同一 Hb；旋转偏距导致轮实际接地点移动，不能把转轴坐标直接当固定支撑点。完整转一圈检查车架、循迹支架、电线不进入脚轮旋转包络。四点接地比三点更敏感，必须在平面上用纸条试拉检查四轮负载：一只驱动轮轻触或悬空就调垫片/支架，不能直接增加电机 PWM。装满载后再检查；若无法同时调平，退回单前万向球方案。

# 11 电池 电子托板和检修空间

电池与较重模块放低；上层用于桶壳与轻型人机界面。主承载件机械固定；泡棉胶只辅助固定轻小件或线夹。这里先装机械件，接电按电气章进行。

### 步骤 029 M19 铺电池防滑垫

剪两条 10×2 单面背胶 EVA，贴在电池托放区域的底板上；垫条不要封住绑带槽。将电池放上，出线朝向接线区，留自然弯曲。

□ 检查 电池接触面平整；没有螺钉尖端顶住电池；EVA 不覆盖电池散热或说明标签的重要内容。

未通过时 有凸起先换螺钉或移位，不用加厚软垫掩盖硬物；电池外皮破损则停止使用该电池。

### 步骤 030 M20 穿两条电池绑带

每条带从一侧槽穿出，经电池上方绕回另一侧槽，穿扣后反折。两条带平行且避开出线。反折后魔术贴有效重叠目标至少 50 mm，扎紧到电池不滑动但不变形。

□ 检查 握住底板轻轻改变方向，电池不移动；带尾不垂入车轮；能从检修侧解开带子。

未通过时 300 mm 长度无法获得足够重叠时按实测周长换更长同宽带，不能仅粘住很短一段；严禁挤压电池保护板或出线焊点。

### 步骤 031 M21 规划三块电子托板

用已有10mm双通柱制作电子器件安装分区。先用纸板摆放核心、100×100mm PCB、MCP模块、驱动和电源模块，留插拔线与螺丝刀空间，再按实物描安装孔；托板外形可按实际空间裁定。

机械托板数量不等于电路板数量。本机以一块SmartBin_A A1 PCB替代旧PWR与IO；核心、MCP23017成品模块、TB6612及电源模块仍独立固定，不叠压在裸露焊点上。

□ 检查 每块托板底部与底板之间至少有立柱形成的间隙；插拔接头时可按住托板，不用拉线。

未通过时 核心板无适合螺孔时使用边缘卡持或独立绝缘小支架，不能随意在电路板上钻孔。托板不够大先调整布局而非让板件悬空。

### 步骤 032 M22 固定核心板及 FLASH 扩展板

核心板脱离教学大底板后放在自己的绝缘托板上，保留 SWD 和 5 V 接口的接近路径。FLASH、MCP23017 等按排针和实际孔用螺钉/卡持固定；底面引脚避免接触螺钉。

□ 检查 每个模块可单独拔插；下面看不到与电路铜箔接触的金属；上平台合上时不挤排线。

未通过时 模块底部过长引脚加绝缘间距或剪短适当余量；不能用整块胶封住调试和检查位置。

### 步骤 033 M23 固定驱动 电源与声频模块

电机驱动靠近电机线出口但与低电平总线保持空间；降压模块放在通风可调位置；DFPlayer 的 TF 卡面向可检修边。轻模块可少量泡棉胶辅助，重模块仍需支架。

□ 检查 调压器电位器可操作且不误触其它板；大电容顶部不顶上平台；电机电源线可走短路径。

未通过时 板高超过约 60 mm 层间净高时改横向放置或更换托板位置；不能把电容压弯顶到平台下。

### 步骤 034 M24 刚性安装 MPU6050

把 MPU6050 固定在底板刚性区，标出模块 X/Y 方向与车体 X/Y 的关系。用对应小螺钉/硬支架，不在其底下贴厚软泡棉。

□ 检查 用手触碰外壳时模块不摇摆；姿态轴向能在记录表中明确说明。

未通过时 无法避开电机附近振动时先更换位置并整理轮组机械松动，不能仅靠提高软件滤波遮盖松支架。

### 步骤 035 M25 做一次上平台拆装

先放上 P02 而不接桶壳，检查柱上螺钉能从外侧拧到；让所有检修线束留出卸下上平台的余量或可拆接头。完成一次拆、装。

□ 检查 无需剪线或拆电池焊接就能接近核心板；没有线束被 4 根柱挤住。

未通过时 调整接头到平台边缘、增加合理服务弯；别把线束扎到同时跨越固定底板与可拆平台的两端。

# 12 3 mm PVC 桶壳 下料 拼合 固定

桶壳采用 3 mm PVC 发泡板，固定件可以较坚固，但活动盖使用另购的 2 mm 板。PVC 发泡板切割后边缘容易被螺钉压陷，小螺钉要配垫片和局部加强。

零件 | 数量 / 下料尺寸 | 装配关系
左右侧壁 P03 | 2 件，160×180×3 | 长度沿 X，位于 Y 两侧
前后壁 P04 | 2 件，144×180×3 | 夹在左右侧壁之间，组合后的外宽 150
壳底 P05 | 1 件，154×144×3 | 嵌在四壁内部，底面与壁板底缘齐平
新活动盖 P06 | 1 件，160×150×2 | 单独称重，暂不与壳体永久固定
前操作板 P07 | 毛坯 190×120×3 | 安装位置参考 X≈250；按开盖包络、开关和 OLED 外形微调
可拆超声横梁 P08 | 毛坯 150×35×3 | 跨 Y，位于桶口后部；两端用外置小托耳，不能永久封死
触边横杠 P10 | 毛坯约 180×25×3 | 轻量、带导向；固定限位承受撞击，微动开关只检测

### 步骤 036 M26 先划后切 PVC

按下料表在 3 mm PVC 上用直尺画线，标出两侧壁和前后壁。压住直尺多次浅切，或用细齿锯切；修平切面。单独标好 2 mm 活动盖毛坯，避免混用。

□ 检查 侧壁高一致；前后壁宽为 144 而非 150；所有板厚已实际核对。

未通过时 若切口倾斜先锉平；偏小太多的壁板更换，不靠大胶缝补足外形。

五片PVC桶壳下料示意和三维拼装图，侧壁160×180两片、前后144×180两片、底154×144一片，外角码不侵占内胆路径。

图解 06 前后壁夹入侧壁，外侧短角码固定；壳底平铺平台，不在底下再塞木条。

### 步骤 037 M27 四壁无胶试拼

在平面上用临时胶带拼四壁，前后壁夹在侧壁之间。用角尺检查四角；量外形约 160×150、上口净空约 154×144。测上口两条对角线。

□ 检查 四边垂直；两条对角线接近，差值目标≤2；PP 纸样能放入且取出。

未通过时 四壁装反时拆开重排；锯缝造成净口不足先修接触面，不能强压内胆进壳。

### 步骤 038 M28 用外角件加强并保留内胆通道

本版采用外侧短角码或外侧局部加强片连接四壁，不再设置贯穿全高的内置 5×5 木角条。先给壁板钻间隙孔，短螺钉和垫片从合适方向装入，内侧螺纹突出尽量控制在约 2 以内，关键是实际不能刮袋。

□ 检查 四角保持方正；量出包含螺母/压片后的全高度最窄通道；它在长、宽两方向均应比装袋内胆的最大外包络至少多 4，即每侧约≥2。

未通过时 不要把名义154×144写成无障碍净通道。已做内角木条的，拆除改外角件；或重新定位局部固定件并用真实内胆全程试取，不能仅凭桶口顶部能进判断。

### 步骤 039 M29 放入壳底并由平台承托

将四壁放在 P02 上，再把 154×144×3 壳底嵌入四壁，使壳底和壁板底缘都落在 P02 顶面；先干装不加底部垫条。壳底由 P02 全面支承，四壁限制横向移动，内胆从上方压住；这样壳底还可取出清理。

□ 检查 壳底平铺无翘起，内胆重量传到 P02；不能在齐平壳底下面再塞木条而无意抬高桶体。

未通过时 若需防翘，优先在边角加可拆轻压片并避开内胆；确实加胶带或垫层时记录新增高度，后续满桶参数重新计算。

### 步骤 040 M30 将桶壳固定到 P02

在 P02 画 X=70～230、Y=±75 外形线，放壳后用四个可拆角码定位。桶体固定螺钉从检修侧可接近，不使角码跨越内胆取出通道。

□ 检查 桶壳与车体中线一致；推壳顶部不会在平台上滑动；四角码不挤压电路舱导线。

未通过时 壳体或平台局部过软时加固定加强片，不能把整个桶壳粘死后再要求拆修。

### 步骤 041 M31 标记传感器区域后再开孔

在桶壳上标投放光束、侧面 DHT11、光敏及线孔候选位置。用实际传感器和插头对照，先画可见窗口与螺孔，不一次性切掉大块板。

□ 检查 传感窗口与内胆上缘、侧架、提取方向错开；电线从外侧沿壁走。

未通过时 需要穿过的插头比护线圈通径更大时使用可拆接头或先穿线再端接；不能硬拽插头过小孔。

# 13 1 mm PP 五片内胆与 30×40 cm 袋

本版内胆不热折弯、不依赖普通胶粘接，而是五片平板加尼龙扎带。为了满足外包络，两个 128 mm 侧片必须夹在两块 140 mm 前后片之间。

图5 1mm PP五片内胆尺寸与接缝固定方式

图5 1mm PP五片内胆尺寸与接缝固定方式

### 步骤 042 M32 PP 板排料

在 500×500×1 PP 板上画底片 140×130 一块，前后片 140×120 两块，左右片 128×120 两块。各片间留切缝，写上“底、前、后、左、右”和内外面。

□ 检查 数量合计 5，尺寸没有把 128 写成 130；整张板仍有试钻孔余料。

未通过时 发现板厚不是约 1 时，先按实际厚度重算侧片长度=130−2×实测板厚，再裁正式片。

### 步骤 043 M33 裁切去毛刺

用金属直尺压紧，多次浅划至切透或用合适剪切工具完成；圆滑所有角。用余料试钻约 3 mm 扎带孔，检查扎带可穿且不会拉裂边缘。

□ 检查 边缘无明显缺口，切口不会刮破袋子；2.5 mm 宽扎带可穿孔。

未通过时 孔拉裂时增大孔到边距离或增加小垫片；不能继续用裂口板作为受力底部。

### 步骤 044 M34 立壁试装并确定扎带位置

底片平放，前后片立在底片的两条 140 mm 边上；左右片立在另两边并夹于前后片之间。临时胶带固定，再量外长宽与四角直角。

□ 检查 外形约 140×130，外高约 121；侧片端头没有挤开前后片。

未通过时 若外形偏大先检查“侧壁站在底上”的关系，不能把前后壁包到侧壁外再忽略尺寸变化。

三个局部图显示PP板接缝两侧约3毫米孔、向外的扎带锁头、PE袋外折10到15毫米及整胆提取至少每侧2毫米净空。

图解 07 扎带孔中心距边至少 5 mm；装袋后试提整胆，折边和锁头均计入净空。

### 步骤 045 M35 打立角扎带孔

每条竖向角缝做上下两组孔；一组孔分布在相邻两片各一孔，离切边至少约 5，位置尽量对称。上下组距端部约 20～25 起步，按实际板强度调整。拆开板件夹在木垫上钻，不能拿着已拼的薄盒悬空钻。

□ 检查 4 条角缝共约 8 条扎带；扎带绕过角后能收紧而不把板折白。

未通过时 拉裂或明显白化就放松、更换片件或加小加强垫；不得用更大力强拉让歪盒变方。

### 步骤 046 M36 打底部连接孔

每条底边做约两组孔，共约 8 条扎带。孔在底片靠边处与相应侧壁底部配对；孔到边保留≥5，避开立角已有孔。先以记号对应每对孔，再拆开钻。

□ 检查 底片被四面共同托住；孔不密集挤在一个角落；底部扎带结不影响平稳落地。

未通过时 底部扎带头形成高点时改到外壁侧，或在桶壳内底铺两条等高 EVA 支撑，使负载由平面承担。

### 步骤 047 M37 穿约 16 条扎带并修整

先全部松穿，再对角依次收紧到消除缝隙。扎带锁头尽量朝外且贴角布置，剪短尾端，剪口转向外侧并去锐边。

□ 检查 手提空内胆不会散开；内侧无会划袋的毛刺；总体可通过真实桶口。

未通过时 扎带锁头外凸造成卡口时改朝外壁凹位或调整孔位；不要削掉扎带锁扣来强行缩小。

### 步骤 048 M38 加袋并控制袋口

放入平铺 300×400 PE 袋，把袋底铺到内胆底，四角展开。上缘多余部分向外折 10～15 mm，用 2～4 个小夹子夹在可接近的边上；袋壁贴靠 PP 壁。量好袋边和扎带锁头的最大包络；外凸过大的夹子列入取出前先摘除的维护动作。

□ 检查 投物落在袋底；袋不悬空、不鼓进光束和超声视场；不含已摘除夹子的装袋内胆通过全高度最窄通道时每侧约留≥2。

未通过时 夹子过宽或袋折边太厚时换小夹或调整位置；不能把袋口拴在固定超声横梁上，否则维护时无法分离。

### 步骤 049 M39 承托与取出试验

在壳内底按需铺 2 mm 防滑 EVA 条，放入装袋内胆。用不超过 0.30 kg 的干燥样品均匀装入，再执行一次取出、倒空、装回。

□ 检查 袋不漏挂；内胆底部有支承；PP 缝口没有继续拉裂；取出时不勾传感线。

未通过时 取出费力先找卡点和夹子外凸，不把载荷继续加大；本内胆不当作可盛水容器使用。

名义高度复算：参考 P02 顶面 Z=115，壳底厚 3，则壳内底面约 Z=118；若垫 2 mm EVA，内胆底外面约 Z=120，1 mm PP 底上表面约 Z=121，内胆口沿约 Z=241。实际 EVA 压缩、壳底支承方式和袋折边会改变有效口沿。因此使用实物尺测值，不直接把名义 Z=241 写成传感器已标定结果。

# 14 2 mm 轻型盖 铰链与 45 g 上限

盖的质量和摩擦先合格，才进入舵机连动。普通开盖角度约 70°；取内胆的维护角度约 120°，需要先断电、断开拉杆并移开超声横梁。

### 步骤 050 M40 裁出新盖并称裸板

从 200×200×2 PVC 发泡板裁 160×150；去毛刺并轻微圆角。把新盖放秤上记录裸板质量，目标≤30 g。

□ 检查 厚度为约 2 mm，材质是轻质发泡 PVC；裸板未超过设计质量余量。

未通过时 裸板过重时先核实是否实心硬 PVC；换合适发泡板，不单靠减少所有紧固件来勉强压到上限。

### 步骤 051 M41 确定闭盖位置与后压条

把盖长边沿 X 放置，盖后铰链轴参考 X=75、前缘约 X=235。桶壳后缘为 X=70，因此后部需固定覆盖条。用约 150×10×3 PVC 余料做条，俯视可先试放 X=64～74、Y=±75，使其向车尾略外伸、朝盖的一边预留约1的缝；在铰链叶片和轴桶处按实物开让位。压条由后壁/外角件固定，不跟随盖运动，不承担连杆转矩。

□ 检查 从上看后沿只留受控的铰链让位缝；前缘约外伸5；压条和盖全程不互顶，盖合上不压到传感横梁。

未通过时 若实物铰链轴必须改位置，先在纸样上调整盖覆盖关系，并同步让舵机轴始终位于盖轴后方50；不要仅移动铰链而保留旧舵机孔。

### 步骤 052 M42 试放两个小铰链

铰链沿 Y 分开布置，尽量对称，避开测距横梁端耳和内胆取出路径。盖下面局部加轻量加强片；壳体铰链处可用更结实固定加强块。先用临时胶带定位，手动开闭。

□ 检查 两铰链转轴共线；盖可不借助外力保持顺畅运动；合盖时四角不过度翘起。

未通过时 出现忽松忽紧说明轴不共线，拆下重新定位。不要用 SG90 强行克服铰链卡滞。

### 步骤 053 M43 固定铰链并记录实际轴高

用 M2 间隙孔、短螺钉、平垫及防松螺母或匹配的小连接件固定，先轻紧再微调。测实际铰链轴心高度 Z1；参考通常接近桶壳顶面，但以铰链桶形结构、软垫和盖厚实测为准。

□ 检查 记录 Z1；螺钉不顶进投入口；开至 120°时盖和铰链未撞侧架或被压条挡住。

未通过时 120°不可实现时先改变固定压条/铰链让位结构，或改为可拆盖维护；必须实测证明内胆可取出，不能只在文档写“快拆”。

### 步骤 054 M44 贴最少必要软垫

从 10×2 EVA 剪 2～4 段短条，贴在固定桶口承托位置，避免把整圈都密封得很厚。压盖查看各触点是否均匀，给盖闭合微动开关预留独立轻触位置。

□ 检查 关盖不硬撞；盖能自然到位；EVA 没有向内翘起阻挡投物。

未通过时 盖被垫条顶歪就缩短或移位软垫；不能靠舵机长期施力把 EVA 压到极薄。

左侧电子秤上放置盖板和其活动附件；右侧独立显示固定舵机、立架及传感器横梁，强调40克目标和45克上限。

图解 08 把所有随盖运动的小零件一起称量，记录实测质量，再做开闭循环检查。

### 步骤 055 M45 称活动总成

把盖、随盖侧臂、活动加强片、铰链中随盖部分、相关螺钉垫片和胶带一起称量；无法分开称铰链活动半片时，可保守地把整只铰链计入。拉杆不便分摊时可保守全部计入。记录质量。

□ 检查 目标≤40 g，最大不超过 45 g；记录称量包含哪些零件。

未通过时 40～45 g 只可视为余量偏小，继续减轻装饰和加强片；>45 g 必须减重或重新设计执行器，不能继续沿用既定 SG90 方案宣称符合。

固定在桶壳上的舵机本体、立架、固定压条和固定侧加强块不属于随盖质量。不要在盖上固定 HC-SR04、RC522、语音喇叭或较大装饰；超声必须固定在独立可拆横梁上，否则盖角度改变会破坏测满基准。

# 15 20 50 20 50 连杆机构逐步装配

两个“20”是输出轴到连杆孔中心的有效半径；两个“50”分别是固定轴间距与拉杆两孔中心距。舵机转动方向和软件脉宽需按实际安装标定，不能用“SG90 90 度”字样替代实际角度测量。

图6 20mm摇臂与50mm连杆的运动关系

图6 20mm摇臂与50mm连杆的运动关系

### 步骤 056 M46 先做纸板运动学模板

在硬纸板画两固定轴 O1、O2，水平相距 50，O2 在 O1 后方。各画长 20 的摇臂；闭合时两臂相对车头水平线向上 20°，展开时各向上至 90°。用纸铆钉和 50 mm 纸连杆演示。

□ 检查 从闭合到打开两臂始终平行；盖转动 70°；没有通过臂与固定轴连线重合的 0°或 180°死点。

未通过时 纸模板无法运动说明长度、孔距或臂初始方向错了，先改模板，不要加工金属臂后靠强拧矫正。

### 步骤 057 M47 设置外侧运动平面

在桶壳 Y 正侧画侧臂投影，侧臂和球头均放在桶体外。先以距侧壁外表面约 5～10 的运动平面做样板，再用实际球头厚度确认全程净隙；推荐从 Y≈+82～+85 试排，最后取能避让的实测值。

□ 检查 运动平面不穿过 PP 内胆和桶壳；铰链/侧臂连接有刚性支承；球头和螺母距固定壁全程约≥3。

未通过时 空间不足时向外移动机构平面并加固定转接支承；不要用长悬臂螺钉硬把球头撑出去。

### 步骤 058 M48 预装舵机立架与调节托片

将 60×190×5 木立架放在桶后侧附近，立架 X 范围参考 20～80；用两只角码加三角撑连接到约 80×40×5 调节托片。托片参考覆盖 X=20～100、Y=75～115，外伸到平台侧边以外；给后立柱顶螺钉 (30,+85) 留直径至少约 10 的检修孔或开口缺口，托片自身固定点参考 (60,+85)、(90,+85)，须按实际角码避让后确定。立架在托片上向外侧调整，先夹住不钻最终孔。

□ 检查 舵机轴能到达 O2=(O1x−50, 同一 Z1)；壳体朝桶外的一侧有空间；输出盘和盖侧臂处于所需运动平面；后立柱仍能拆装。

未通过时 旧 Y≈85 不是固定轴孔，立架也不能直接压住 (30,+85) 柱顶螺钉。若舵机碰桶壳、立柱或平台边，调整托片/角码，使输出轴定位满足后再描安装孔。

### 步骤 059 M49 实物描舵机安装孔

按已经调好的轴心位置描安装耳孔；拆下舵机后钻孔或短调节槽，槽两端保留足够木料。安装螺钉不压坏舵机耳，角码和三角撑拧紧后再测轴距。

□ 检查 O1、O2 的水平距约 50，竖向高差目标≤0.5；舵机输出轴与铰链轴平行。

未通过时 轴距或高度偏差明显先调整固定架，不能靠歪斜球头吸收全部安装错误。

### 步骤 060 M50 制作或选择 20 mm 舵臂

优先使用可靠匹配 SG90 花键的原盘作中心连接，在原盘上固定轻型延长片使连杆孔中心距轴心 20。延长片与原盘至少有两个分开的连接点或可靠防转结构；用原配舵盘中心螺钉。

□ 检查 轻推连杆孔，延长臂不相对原盘旋转；20 mm 是量到孔中心而非臂外端。

未通过时 不能直接将通用 M2 螺钉当花键中心螺钉；若臂刚度不足，重做轻而刚的臂，而不是增加大量厚钢片。

### 步骤 061 M51 固定盖侧从动臂

从动臂有效半径 20，固定在盖的局部加强处，与盖之间形成闭合时约 20°的安装偏角。先临时定位，手动转盖确认侧臂孔从 20°到 90°的轨迹。

□ 检查 盖水平闭合时侧臂朝前上方，不是水平朝前；盖开 70°时侧臂约竖直向上。

未通过时 从动臂装反或偏角错误时重新定位，不能通过改变连杆孔距掩盖。新增随盖螺钉和加强片后重称总质量。

左侧识别20毫米摇臂、50毫米杆距及固定轴距；右侧展示M2螺钉、平垫、球头、隔套、摇臂和防松螺母的装配剖面。

图解 09 先量两孔中心距，再装连接端；球头应可摆动，维护拆端头连接螺钉即可。

合盖、中间、全开三个状态，以及侧臂穿盖叠层和舵盘球头固定的放大图，见第60章图解31—35；该章沿用本节20—50—20—50mm机构尺寸。

### 步骤 062 M52 调双球头拉杆孔距

测量并旋转两端球头，使两连接孔中心距为 50。左右端保留足够且相近的有效螺纹咬合，按杆件结构锁定调节螺母；记录露出螺纹长度。

□ 检查 拉杆在手推拉时无松旷；长度不因转动球头自己变化。

未通过时 一端只剩少量螺纹咬合就换合适长度杆体；不靠螺纹胶把几圈危险咬合固定住。

### 步骤 063 M53 先不接舵机电源做机构试装

断电状态把球头分别接到两臂，用 M2 螺钉、平垫和防松螺母；垫片错层保证转动。不要直接强推舵机齿轮走全行程：先从舵盘或一端断开，独立验证盖、臂与杆的自由运动，再接回检查位置。

□ 检查 球头可转，螺母不会压死球面；未依靠电机动力时盖机构本身顺畅；螺钉不扫桶壁。

未通过时 摩擦点用逐段拆解定位；不是所有防松螺母都需把活动关节夹死。螺钉长了就换长度。

### 步骤 064 M54 与舵机空载标定衔接

先卸开连杆，按电气章完成 SG90 上电与中位测试。停在已经标定的安全角度后断执行电源，再把舵盘安装到使闭合臂约 20°的位置。重新上电时先输出已知安全脉宽，用小步长缓慢接近闭合位置。

□ 检查 舵机不会上电突然顶住盖；实际关盖可到位但不持续对软垫施加明显力。

未通过时 方向反了先改变软件映射；机械偏置不合适就断电重新装盘，不把脉宽推进未经验证的极限。

### 步骤 065 M55 逐步标定开启位置

从闭合位置以小步脉宽指令缓慢打开，同时量盖角，先到 30°再到 50°，最后接近 70°。每步观察球头、摇臂、横梁、舵机壳体和线束。保存实际闭合/开启脉宽。

□ 检查 全过程无卡滞，盖约 70°；没有到达舵机内部止挡；连杆不蹭任何固定件。

未通过时 任何持续嗡鸣、支架弯曲或盖跳动均立即回到安全状态并断电排查；不能让舵机持续堵转。

### 步骤 066 M56 装护罩与做 20 次循环

用轻型固定护罩遮住外侧杆件附近易误碰区域，护罩固定在不运动的侧架上，不能限制连杆。以正式开闭速度连续完成 20 次开关，记录耗时、闭合开关状态和是否发热。

□ 检查 20 次均能闭合确认，无松脱、明显持续嗡鸣或异常温升；护罩不参与承力。

未通过时 先减轻盖、纠正轴线和摩擦，再重新试验；失败不能仅通过延长电机通电时间判为通过。

# 16 传感器 面板和碰撞横杠逐件安装

功能位置不能混用：投放对射检查物体经过；超声测桶内高度；前避障检测车前障碍；靠近传感器响应用户；循迹探头看地面。安装后各自独立标定。

桶体剖面显示上平台115、PP外底120、口沿241、投放对射265和超声探头面280毫米的参考高度，以及袋边避开检测路径。

图解 10 超声向下、对射横穿桶口；装上内胆与袋后，实测有效口沿并重标定满桶距离。

### 步骤 067 M57 制作可拆超声横梁

用 150×35×3 PVC 毛坯跨过桶口后部，两端加可拆小托耳。按 HC-SR04 实物外形和孔距固定到横梁下面，使探头朝下；初始中心参考 X≈105、Y≈0，探头面参考 Z≈280。

□ 检查 横梁不随盖转动；传感器接口可拆；探头没有被横梁边缘遮住；横梁可从外侧卸下。

未通过时 探头或 PCB 撞到开盖轨迹时降低固定横梁或改变 X；同步记录新的探头高度，不沿用旧空桶距离。

### 步骤 068 M58 检查超声视场与投入口

放入空内胆和袋，在横梁前方投放小样品，确认日常投放路径不直撞超声；传感器下方袋边不鼓起。空桶连续测量并记录稳定值。

□ 检查 空桶有效回波主要来自桶底，显示不持续跳到侧壁或袋褶；前方保留可用投入口。

未通过时 有固定短回波时调整探头位置、垂直角度、袋壁，不先在软件中强行忽略全部异常。

### 步骤 069 M59 安装投放对射

在两相对侧壁上安装发射和接收端，使光束横跨 Y，参考桶口下 25～35，约 Z=260～270。线束沿外壁走，可拆接头放壳外。先用纸板小遮挡验证对准。

□ 检查 无物时稳定相通；遮挡时稳定变态；盖开闭、袋口轻晃不会自己挡住光束。

未通过时 两端不对准时用短调节槽修正；不要把接收端放到内胆上使其随取袋拔线。

### 步骤 070 M60 重做满桶距离标定

量超声面到装袋后有效最高口沿的垂直距离；选安全最高料面至少低于有效口沿约 15～20。满桶阈值=探头面高度−最高料面高度；清除阈值应再大约 20。

□ 检查 参考 Zface=280、PP 口沿≈241 时，候选满阈值约 60～65、清除约 80～85；实物验证后填写最终值。

未通过时 旧 45/65 mm 参数不能直接套用。袋折边更低或探头位置改了必须重算；无回波要作为故障，不当作空桶。

### 步骤 071 M61 安装盖闭合微动开关

把开关固定在桶口固定部位，盖上轻型小触片在最后几毫米行程触动开关。先用万用表通断档手动测试，再与 PB14 软件显示一起确认。

□ 检查 盖确实归位才显示闭合；开关只是检测，机械软垫承担盖的停止载荷。

未通过时 开关被压到底承力时后移或缩短触片；离盖仍有明显大缝就显示闭合时重新调整。

### 步骤 072 M62 操作面板排版与固定

先在 190×120 纸样画 OLED 窗、编码器、MODE/BACK、RC522 区、靠近探头和停止按钮位置；手指实际按压检查。最后转到 PVC 板按实物开孔，用角码固定在车前附近。停止按钮开孔按实际规格图，不能把“22 mm 系列”直接当加工孔径。

□ 检查 手指有空间，急停可直接按到；面板不侵入盖前缘及维护拆盖空间；螺钉可从背面够到。

未通过时 排版太挤时把急停移到可达侧面独立小支架；不要让 RC522 天线被金属大垫片、按钮金属壳紧贴遮挡。

### 步骤 073 M63 固定 RC522 和 OLED

RC522 平面朝向用户，隔着薄非金属区域刷卡；用尼龙件固定，天线区域周围尽量不放金属支架、电池和电机线。OLED 固定在看得清且不会被盖挡住的位置，窗口边缘与屏幕玻璃之间留余量。

□ 检查 用实际卡在最终面板上连续刷卡 10 次；屏幕不受螺钉挤压、线缆不拉插座。

未通过时 读卡距离变差时先拆金属遮挡并改变位置，再核电源与线长；不能把桌面读卡距离当装好后的保证。

### 步骤 074 M64 安装编码器和两只轻触按键

有螺纹套筒的编码器按实际套筒孔固定；裸 6×6 轻触按键先焊到小托板，再把托板固定在面板后，使按钮帽突出可按。板上器件不直接靠脚承受手按力。

□ 检查 旋钮可转、可按；MODE/BACK 单手能按且托板不弯；按钮不会卡在面板切口里。

未通过时 按键行程被面板压住时调整垫高或开窗；不通过掰弯焊脚调整按钮高度。

### 步骤 075 M65 靠近检测与前避障分开装

靠近探头装操作面板侧部，参考 Z≈210，朝向手靠近区域；前避障装车头低位，参考 X≈265、Z≈65～85，朝前且避免看到保险杠。两探头均保留角度微调。

□ 检查 手靠近只触发便捷开盖通道，车前障碍只触发停止通道；安装后仍可接近调节电位器。

未通过时 互相干扰或反光误触先改变方向和加遮光小罩；软件不得把一个探头的状态同时解释成两个独立事件。

### 步骤 076 M66 装三路循迹支架

在底板下部 X≈200、Y≈0 固定可上下调节支架，探头朝下、左中右顺序明确。距地初始约 8，保留约 5～15 可调量，实际工作距离按所买模块调试。

□ 检查 探头不碰地；前万向球/脚轮旋转不扫过；线束不上垂；地面黑白可稳定区分。

未通过时 左右探头间距由模块决定，不能假定都为 15～20；黑胶带宽度和阈值随后按实物调整。

### 步骤 077 M67 装碰撞横杠和两开关

将约 180×25 的轻横杠置于车头前缘，参考 X≈285、Z≈35～65，两端用导向或弹性支承允许少量后退。两微动开关布置在左右，外层贴 EVA 缓冲；设置固定机械止挡。

□ 检查 横杠轻压任一侧都能触发；松手能复位；开关触发后剩余碰撞位移由止挡承担而不继续压开关。

未通过时 2～3 mm 只是初始设计行程，必须依据实际开关动作/释放位置调整；不能固定死横杠再要求开关检测变形。

### 步骤 078 M68 安装 DHT11 光敏与照明 LED

DHT11 放外侧通气处，远离降压、电机和功放热源；光敏探头朝环境光，避开自身照明 LED；LED 固定于桶口固定部位或操作面板，配绝缘套并有独立线夹。

□ 检查 盖动不牵动传感线；光敏不会因为自己点亮 LED 而来回闪烁；测到的是外界环境温湿度。

未通过时 光照反馈导致闪烁先移探头/加遮光，再调软件回差；不把热敏模块等同于烟雾或垃圾气味探测器。

### 步骤 079 M69 安装喇叭 蓝牙及蜂鸣器

喇叭固定在带孔侧面，背面留空，不让磁体贴住 RFID 天线；蓝牙天线朝非金属外侧，远离强电流线；蜂鸣器的发声孔保持露出。TF 卡和相关接头保留检修路径。

□ 检查 声音清楚；低速转动时无线连接稳定；喇叭焊点不承受振动拉力。

未通过时 共振时加牢固定或少量垫片，不能把扬声器正面整片泡棉封住。

# 17 护线圈 端子 线束与总装顺序

穿板处保护的是线材绝缘，拉力由线夹承担。先放线、留维护余量、标记，再剪线和做端头；线束完成后重新检查活动范围。

### 步骤 080 M70 按实物开护线圈孔

选择穿线通径约 8 的护线圈，PVC 处用适配 3 mm 板厚的槽型，胶合板处用适配 5 mm 板厚的槽型。安装孔径按护线圈图纸或实物槽底尺寸加工，先在余料试孔。

□ 检查 圈槽完整卡住板边；线穿过时不接触锐边；孔不会因为“通径8”而误钻成不适合的 8 mm 安装孔。

未通过时 圈易脱落就修正安装孔/换匹配圈，不用胶掩盖严重错径；插头过不了时先穿线再做端接或改可拆接头。

### 步骤 081 M71 布电源线与电机线

电池、降压、驱动、电机、舵机主电流线先布短路径；电机双线绞合并固定在远离轮胎的静止结构上。电源接头靠近可检修边，保险丝座靠电池正端且固定。

□ 检查 上平台拆装不扯电池线；轮子全圈和万向轮全转向均不扫线；保险丝座可打开维护。

未通过时 线太短则重做适长线束，不拉紧跨过尖边；多余长线不要盘在 RFID 天线或电机旁。

### 步骤 082 M72 布信号线和标识

按总线分组，I²C、SPI 与传感输入沿逻辑侧走；两端贴同一信号名和接口号，电源口标明电压与 GND。沿外壁固定对射和超声线，内胆通道保持空。

□ 检查 拔下任一接头后能按标签复原；线材颜色不是唯一识别依据；敏感线不与电机线捆成长束。

未通过时 线束跨过内胆提取口时先改路径；不得寄希望于每次取袋都小心避线。

### 步骤 083 M73 端子与插头应力释放

六组KF301端子焊在PCB的J1—J6处，不悬空吊在线上。夹紧导线后轻拉检查，端子外不得露出散铜丝。XT30U接头外壳固定或设短服务线，杜邦信号接头加适度线夹。

□ 检查 机械拉力由外壳或线夹承担；接线端没有游离铜丝；没有两根导线靠挤入不合适单孔来并联。

未通过时 端子插孔不适合所选线径时更换匹配端子；不能削掉大量铜股来硬塞。

### 步骤 084 M74 设置舵机服务线与拆杆通道

SG90 三线沿固定立架走并在插头附近留弯，避免进入摇臂。把可拆球头螺钉或连接端朝向外侧，准备合适小扳手。用空盖缓慢走全程。

□ 检查 连杆全行程不挂线；舵机插头可断开；维护断杆时不必拆整座舵机架。

未通过时 线绕在轴上必须重布；不把活动关节当线夹。

### 步骤 085 M75 合装并做零件清点

装回上平台、桶壳、内胆、横梁、盖及侧罩。逐个检查松放的螺母、钻屑、金属丝，底层用灯照查。把备用热敏、单路循迹、套装风扇等收起，不作为悬空板挂在车上。

□ 检查 整机内部无散落导电物；全部接口有标签；重件均已固定；备用件不增加不必要重量。

未通过时 发现重量超目标时按部位称量查来源，不先拆保险丝、护线圈或必要支撑来减重。

# 18 维护取袋必须实际完成一次

普通 70°开盖是投放位置，不是检修位置。对本尺寸桶壳，只有把固定横梁移开并解除连杆约束，才可以给 PP 内胆足够的垂直取出通道。

四格维护示意依次为隔离电池执行电源、拆一端球头连接螺钉、手动撑开盖约120度、移走超声横梁并垂直提内胆。

图解 11 断电、拆杆、支撑盖、移横梁，再提内胆；清理后逆序恢复并检查互锁。

### 步骤 086 M76 进入维护并隔离执行电源

先在程序进入维护，确认轮子停止、不再响应刷卡开盖；再按总电源断开要求关机。断开电池或执行器供电前按电气章处理，防止拆杆时舵机意外动作。

□ 检查 车体静止；舵机确实不受电驱动；内胆内只装允许的干燥样品。

未通过时 仍有舵机保持力或自动转动时先检查供电支路是否断开，不能用手克服它。

### 步骤 087 M77 解开一端拉杆并固定盖

托住盖，从易接近的一端卸 M2 球头连接螺钉，零件放小盒，不旋动已锁定的拉杆长度。手动把盖翻到约 120°并使用固定支撑或轻绳限制，避免砸落。

□ 检查 盖无需带动舵机转动即可打开；拉杆不会下垂撞电子板；支撑能稳住盖。

未通过时 铰链不允许到此角度则按已设计可拆盖路径卸盖；不强扳铰链和 2 mm 发泡板。

### 步骤 088 M78 移开超声横梁

拔标识好的超声接头，松两端固定螺钉或卡扣，把横梁整体移到旁侧托放。固定在桶壁外的对射线通常不必拆；若阻挡出口则按编号拔其可拆接头。

□ 检查 净开口不再有横梁；拔的是插头而不是拽导线；所有小件集中存放。

未通过时 接头太深够不到应调整位置，在下次演示前完成，而不是把拉线当常规操作。

### 步骤 089 M79 垂直取内胆并换袋

先摘除会外伸卡口的袋夹，手扶袋边不使其掉入；提内胆两侧可抓持的 PP 边，缓慢向上，不仅抓住垃圾袋。倒空或取走袋，检查内胆裂纹、扎带和毛刺；放新袋并展平袋底、折袋口。

□ 检查 带载内胆可取出；袋不被扎带头割破；没有线束随内胆被扯出；已验证整条通道而非仅顶部能进。

未通过时 卡住时停下找夹子、袋褶、角码等卡点，调整后再提；不得摇晃整机强拔。

### 步骤 090 M80 逆序恢复并检查互锁

装回内胆与袋，横梁按原定位装紧并接回插头；盖回到原位置，接回同一端拉杆，不改变孔距。通电后检查空桶距离、对射通畅、盖闭合和维护退出。

□ 检查 所有互锁恢复才允许运动；有效空桶距离与此前相近；不会仅因为按了退出键就忽略缺失传感器。

未通过时 空桶距离大变先看横梁是否装斜或袋鼓起；闭合开关未到位先修机械，不在软件中永久屏蔽。

# 19 台面到地面 整机机械验收与故障处理

以下均为待做试验，不代表已经测过。先无电、再架空带电、最后落地低速；每次改轮高、盖结构或装载位置后重做受影响项目。

验收项目 | 具体方法 | 通过标准 / 记录
紧固与线束 | 查螺母对齐线、端子拉力、轮胎与杆件全程；用灯检查底层 | 无松动、夹线、裸铜、钻屑；记录检查日期
盖质量 | 按 M45 完整称量，不扣除未能实际分离的活动件 | 目标≤40 g；上限45 g；实测____ g
关盖与开盖 | 连续20次，观察角度、声音、闭合输入与供电 | 每次可到位；无卡滞/持续嗡鸣；开启约70°
维护路径 | 完成 M76～M80 一整套，包含装样后的取出 | 无需剪线或破坏固定件，线束和盖机构不受拉
整机质量 | 称空载，然后加最大0.30 kg干燥样品再称 | 满载目标≤1.60 kg；空____ /满____ kg
三点支承 | 空载、满载均在平面上手推；观察左右驱动轮与前球 | 都实接触且不擦碰；装载变化不抬起驱动轮
重心分配 | 在三个接地点下等高支承称反力，或逐点称且其它点保持同高 | 目标重心投影约(140,0)，实际记录；不能只由外形推断重心高度≤130
左右平衡 | 比较左右轮支承反力，电池在低位适当横移后再绑紧 | 没有显著偏向一侧；偏置已记录并纠正
最小离地与轮旁净隙 | 满载后测最低螺钉、循迹探头、线束；手转轮整圈 | 无拖地；轮旁实际全圈净隙约≥3；探头高度在有效范围
低速落地 | 按电气与固件验收后，从最小可稳定速度在平面短距离运行 | 速度目标0.08～0.12m/s、上限0.15；能可靠停止后再循迹
障碍停止 | 用不同颜色目标测实际停车距离，留人员可接近停止按钮 | 停车距离必须实测；待机滑行不能当作机械刹车
持续运行后复查 | 综合运行约30min，断电后查电机支架、轮毂、盖杆和绑带 | 对齐线不移位，板无裂纹，轮和盖的声音未恶化

三点反力与前后重心的可选记录方法：驱动轴位于 Xr≈90、前支撑位于 Xf≈240；总质量 M 与前支撑称得反力等效质量 Mf 在同一单位下，有 xcg≈Xr+(Mf/M)×(Xf−Xr)。称某一支点时，其余支点也必须垫到与秤面同高，否则结果不代表水平状态。这个方法估计水平投影，不能得到重心高度；不要把“设计高度≤130”写为已测结果。

观察到的问题 | 优先检查 | 处理后重做
直行偏向一侧 | 轮径/支架角度、擦轮、某一轮承载不足、地面是否平 | 先机械修正，再做左右 PWM 补偿和速度标定
一给电就扭架或嘶响 | 盖轴与舵机轴不平行、连杆孔距不对、脉宽方向或极限不对 | 断执行电源，拆连杆分段排查，再20次开闭
超声经常显示很满 | 袋口鼓起、横梁倾斜、探头照到侧壁、内胆改高后未重标 | 空桶/半桶/安全满线分别测，重设满与清除阈值
清桶时勾线 | 接口在口内、夹子外凸、护线圈旁无线夹 | 重布外侧线，完整复做取袋
遇接缝就循迹丢线 | 地面纸张搭接翘边、探头高度变动、万向轮不顺 | 纸张对接背面贴平，调高度，再做低速路线
两前脚轮方案打滑 | 四点不共面或前脚轮承担过多导致驱动轮轻载 | 调整高度/电池位置；仍无稳定解则使用单前球轮
总质量或盖质量超出 | 装饰过重、重复板件、杆件与角码选择过大 | 逐件称量减轻非必要件；必要时重新核定电机/舵机，不能虚填通过

# 20 电气装配总则 先做可测的小系统

本章逐根接线采用STM32F103C8T6可拆核心板、SmartBin_A A1 PCB和MCP23017成品模块。PA/PB是STM32端口，GPA/GPB是MCP端口，例如PB0与GPB0不是同一个脚。以下保留原步骤编号；PCB板侧引脚以第63章为准，不能把表格顺序当成商品模块的物理针序。历史PCF8574 V2.1板及第61章洞洞板孔号均不适用于本次施工。

本PCB为100×100mm双层板，集中原电源分配、ADC、照明电阻、AHCT缓冲、三管急停和信号汇总。核心、MCP、驱动、降压/稳压和传感器外置；需5V数字输入适配时仍在模块侧处理。按新位号装件，原PWR/IO位号只保留在归档对照中。

完成本章必须有万用表、烙铁及焊锡、助焊剂、剥线钳、斜口钳、热缩管和可调限流直流电源；示波器可借学校实验室用于电源跌落、PWM 和超声回波核验。万用表只能看慢变化和平均值，不能替代瞬态波形检查。所有“通过”均需装配者执行后记录，本手册没有替实物判定通过。

### 步骤 091 E001 建立台账和标签

把配件分为核心/通信、传感器、执行器、电源/接线、备用五盒。先找出标有SmartBin_A A1的PCB；按第63章标记各线束两端，如J20.1 SERVO_SIG、J15.3 CS、3V3_EXT。记录每个模块丝印、型号、供电、输出类型和资料来源。

□ 检查 元件照片与实物一一对应，电源线与信号线颜色能区分。

未通过时 无法识别的模块暂放备用盒，继续完成已确认模块；不要凭外观相似直接接电。

### 步骤 092 E002 固定线色与接口方向

红色标 5 V；橙色标 3V3_EXT；黑色标 GND；黄色为 PWM/普通信号；蓝色为总线。电池未稳压正极改用红线并另贴 VBAT_SW。每个可拆接头在 1 脚处做标记。插接前读两端标签。

□ 检查 同一条线两端标签相同；没有把两个稳压器输出一起标为普通“3.3V”。

未通过时 已有线颜色不一致时保留线色，补清楚文字，不按颜色推断功能。

### 步骤 093 E003 练习万用表与断电检查

黑表笔插 COM，红表笔插 VΩ 孔。断电时用蜂鸣/电阻档查导通；带电测电压改用直流电压档。只测需要检查的两点，不让两支表笔跨接邻脚。

□ 检查 表笔从电流孔移回 VΩ 孔后才测电源电压。

未通过时 电流测量必须串联且先断电改线；禁止把电流档直接跨在电池两端。

### 步骤 094 E004 焊接接头和线束

先在裸PCB上空插排针、端子、IC座、电阻、电容，核脚距与外壳是否互相挤压；按第63章从低件到高件焊。排针先焊一脚、校直，再焊其余脚。柔性线剥约4—5mm，端子压线处按其说明压接端头或使用整齐裸铜，不把厚焊锡堆夹在螺丝下。

先对照元件面空插核位号、阻值、脚名和壳体间隙；保持第1行朝上，绕竖轴翻板后对照焊接面图。焊接面已左右镜像，列从X到A，不重新编号、不再次镜像。按逐根焊线表焊一根、断电测一根、勾一根；除指定两根连续汇流铜线外，全部用绝缘线，仅指定端点剥皮焊接，交叉不通。

□ 检查 每个焊点有完整润湿，轻拉线不松；放大检查无连锡；裸金属不越出绝缘保护区。

未通过时 虚焊补助焊剂重焊；连锡用吸锡带处理；端子夹不牢则重新剥线和压接。

### 步骤 095 E005 每增加一块模块先断电

断开电池 XT30U，等待电容放电，确认 5 V 母线低于 0.5 V，再插拔信号和模块。接完先查地、再查电源、最后查信号。

□ 检查 模块安装步骤、测量值、异常处理写入台账。

未通过时 发现线错时停在当前阶段修正，不用反复通电试接法。

线束/支路 | 推荐线材 | 落地要求
电池→保险→总开关→降压输入；5 V 主干 | 20 AWG 多股铜线，短距离；已有 18 AWG 可用 | 不走面包板或细杜邦线；正负成对走线；尽量靠近底板。
单电机、舵机支路 | 22 AWG 短线；较长或电流偏大用 20 AWG | 电源和地一起从配电点分出，不串经核心板。
传感器和逻辑信号 | 26 AWG 或套装杜邦线 | 首版 I²C/SPI 线尽量 ≤20 cm，固定后留维修余量，不拉紧。
SG90 延长线 | JR 3P 2.54 mm 公对母 30 cm，22 AWG | 通断测试确认三根线直通，电源/地/信号不交叉。
端子 | KF301-2P，5.08 mm 孔距，侧面进线 | J1—J6采用5.08mm直插件；先核孔径、脚形和外壳，螺丝一字或十字不改变电气功能。

# 21 PCB电源区 电池 保险 开关 降压与去耦

主方案使用成品带保护 2S 18650 电池包及匹配 8.4 V 充电器。整机调试不串入充电器；充电时从整机拔下电池包。2S 的最高电压是 8.4 V，不能把它直接送入本方案的 5 V 模块。

图7 电源分支及独立回路连接关系

图7 电源分支及独立回路连接关系

节点 | 接到哪里 | 实测目标/备注
BAT+ | 电池正极→5×20 保险座→总开关输入 | 保险座尽量靠近电池。F1 先装 3 A；最终需结合启动电流及保险曲线确认。
VBAT_SW | 总开关输出→降压 IN+；另引细线到电压采样和急停接点偏置 | 总开关闭合时等于电池电压；关闭时消失。
BAT−/GND | 电池负极→降压 IN−、OUT−和地汇流端 | 使用常见非隔离降压板时为共地；先按模块资料核对。
5V_BUS | 降压 OUT+→三条独立 5 V 支路 | 空载调 5.00 V；本项目带载验收目标 4.85–5.15 V。
5V_MOTOR | 5V_BUS→TB6612 VM | 驱动附近 470 μF/16 V 低阻电解＋100 nF。
5V_SERVO | 5V_BUS→SG90 红线 | 接口附近 1000 μF/16 V 低阻电解＋100 nF。
5V_LOGIC | 5V_BUS→核心板 5V、语音/超声等 | 入口 100 μF/16 V＋100 nF，分配给独立 3.3 V 稳压模块。
3V3_EXT | 3.3 V 模块输出→外设 3.3 V 母线 | 目标 3.20–3.40 V；能力至少 200 mA；实际总负载另测。
3V3_CORE | 核心板自带稳压输出 | 只作核心板参考和少数 MCU 输入上拉；不与 3V3_EXT 直接相连。

### 步骤 096 E006 安装保险座和 XT30U

采购 5×20 带盖串线保险座、3 A 保险管和 XT30U 预焊线一对。先不装保险管。把电池正极侧接点做成金属触点内缩的一侧，逐端测极性；从电池正极到保险座、再到总开关，负极直达地汇流端。

□ 检查 总开关断开后 VBAT_SW 与 BAT+ 不导通；连接器插接只能按正确极性；保险旁裸线绝缘完整。

未通过时 XT30 商品公母名称有歧义，以金属针/孔和正负标记为准；误接时重新制线，不调换整个工程的正负名称。

限流电源、降压模块和万用表的单独调压接线以及四步接入顺序。

图解 12 万用表跨在降压输出端，先调压和做负载检查；断电后才接下一块模块。

### 步骤 097 E007 安装降压板并单独调压

先将降压输出与所有负载分离。用限流电源向降压输入供 7.4 V，限流先 0.2 A。上电后测 OUT+/OUT−，轻转电位器把输出设为 5.00 V。断电，再把输入改为 8.4 V 和 6.6 V 分别复核。

□ 检查 在三种输入电压下空载输出保持约 5 V，电位器没有松动，输入/输出端子极性无误。

未通过时 输出不稳或最低输入下不能维持 5 V，换符合降压输入范围和压差能力的模块；不要先接 STM32 再调输出。

### 步骤 098 E008 给降压做分级负载

使用实验室电子负载，依次 0.2 A、1 A、2 A、3 A 加载，每档观察输出；3 A 档持续至少 10 min，记录最低电压和模块温度。再做短时阶跃负载，在模块规定条件内核对 4 A 短峰值。

□ 检查 3 A 持续输出符合模块温度额定条件且不掉压/保护；不存在仅靠宣传“峰值3A”的假持续能力。

未通过时 若没有负载设备，先接低功耗逻辑完成开发，把驱动负载测试安排到实验室；不得把尚未实测的板直接写为通过 3 A。

### 步骤 099 E009 安装 3.3 V 外设稳压

断电。外置3.3V模块IN+接J7.1（5V_BUS），GND/IN-/OUT-接J7.2，OUT+接J7.3（3V3_EXT）。空载测3.3V，再用小负载分级检查预期电流和温升。该模块与核心3V3输出不并联；至少200mA仅是原采购下限，全部外设负载加20%余量不得超过实测持续能力。

□ 检查 无任何导线把 OUT 接核心板 3V3；只共地；实际外设总电流不超过该稳压模块的持续能力。

未通过时 若带 USB 电源的模块形成第二路反向供电，先断开其电源输出。不能用两块 3.3 V 模块并联“扩流”。

### 步骤 100 E010 焊入滤波电容

电解电容长脚通常为正、壳体条纹标负，以实际标识为准。正极焊到对应 5 V 支路，负极焊到地；100 nF 陶瓷无极性，贴近模块电源脚并联。电解尽量不悬在长线末端，焊后加机械固定。

PCB上C1=470μF对应电机支路，C2=1000μF对应舵机支路，C3=100μF对应逻辑支路；C4/C5/C6分别为100nF，C8在AHCT附近。电解1脚为正、2脚为GND；板位预留5mm脚距、直径不大于12.5mm。实物不合时用短绝缘引线并独立固定。远端MCP、驱动与DFPlayer的就近去耦仍要保留。

□ 检查 对照表检查 470/1000/100 μF 未放错位置；16 V 耐压标记可读；两脚不碰壳体金属和底板螺丝。

未通过时 电解反装必须断电更换受损件并检查供电；外壳鼓起或漏液的电容不可继续使用。

### 步骤 101 E011 制作星形分支

在降压输出附近设置 5 V 正负配电端，各引一对线分别去驱动、舵机、逻辑；电机回流线不先穿过逻辑板。所有配电端加盖或热缩绝缘，端子附近用扎带作应力释放。

PCB的J1接开关后电池，J2接降压输入，J3接已调好的5V降压输出，J4/J5/J6分别分给电机、舵机、逻辑。5V_BUS是同一电气网络，布线按三支路分流；旧版两根0.8mm汇流线及W001—W007不再焊。电池/降压主干用20AWG短线，电机/舵机短支路22AWG，压降偏大时改20AWG。主电流不得经信号排针或普通杜邦线。

□ 检查 电机/舵机插头拔掉后逻辑支路仍完整；三条支路地最终汇合；通电前任意正端与地无持续低阻短路。

未通过时 电容充电可能使蜂鸣档短响，应观察阻值变化；持续接近 0 Ω 才按短路追查，不能只听一声就判断。

### 步骤 102 E012 用电池替代限流电源

完成空载和逻辑负载检查后，先关总开关，装保险管，再插 XT30U，最后开总开关。测量 VBAT_SW、5V_BUS、3V3_EXT 和核心 3V3，填入记录。

□ 检查 每次上电逻辑稳定；保险不异常发热；降压输入范围覆盖实测电池电压。

未通过时 保险熔断先查短路和故障负载，不通过随意换更大保险来恢复运行。

3A保险管是初选值，熔断曲线和直流额定值须与实测启动电流、线材及电池保护板协调，保护板与保险不能相互省略。SG90先按2A瞬态留量并实测，不能把0.8A估算当上限；控制上禁止轮驱动与开盖并发。两轮各1A加其余0.5A预算，移动模式约2.5A；舵机2A加其余0.5A，开盖模式也约2.5A。持续3A、短时至少4A是分时正常工况的选型起点，不代表支持电机和舵机同时堵转的约4.5A。语音音量、模块和机械负载会改变电流，最终以实际压降、温升及峰值测量确认。

# 22 STM32 核心板 SWD 与电脑串口 建立最小系统

先把可拆核心板从大型教学底板分离，消除教学板自带数码管、LED、键盘、EEPROM 等对本项目端口的占用。拆卸前拍清核心板方向及插座，断开教学板 USB 与电源。

### 步骤 103 E013 拔出并固定核心板

握住核心板两端，交替小幅上抬，不单侧猛撬排针。确认两排针无弯折后装到独立绝缘托盘；有真实安装孔才用合适螺丝和 10 mm 双通柱，无孔则用边缘夹持支架，避免压到元件。

□ 检查 核心板背面焊点离托盘和螺丝有间隙；轻晃整机不松动。

未通过时 没有孔不在焊有芯片的板上自行钻孔；改用夹持件/转接托盘。

### 步骤 104 E014 确认电源入口和保留口

按实物丝印找到 5V、GND、3V3、NRST、SWDIO/PA13、SWCLK/PA14、BOOT0。用断电导通核对 GND。只连接 5V_LOGIC→5V、GND→GND，先不接外设。BOOT0 置 Flash 正常启动位置。

J8是本项目自定义17针核心PA线束，J9是16针PB线束，不是核心原有整排插座。按第63章逐根核对：J8.1供核心5V、J8.2地、J8.3接核心3V3参考；PA1来自板上ADC经JP9。SWD仍直接接核心PA13/PA14。不要整排直插或把J8.3与3V3_EXT相连。

□ 检查 上电核心 3V3 约 3.3 V，芯片不过热，复位按钮可操作。

未通过时 无 3.3 V 则先确认 5V 入口和板上开关/二极管路径；不要将 8.4 V 送入 5V。

SWDIO接PA13，SWCLK接PA14，GND共地，可选NRST；USB串口TXD接PA10、RXD接PA9；串口供电脚不接，SWD有独立VTref输入时按说明接核心3V3。

图解 13 按图逐线接 SWD 与交叉串口；芯片 ID 可读、115200 文本完整后通过。

### 步骤 105 E015 连接 SWD 下载器

下载器 SWDIO→PA13、SWCLK→PA14、GND→GND；可选 NRST→NRST。若下载器有真正 VTref 输入，可接核心 3V3；若端子实际是 3.3 V 电源输出，不能当参考直接并接，按下载器型号处理。

□ 检查 调试软件识别 STM32F103C8；读取芯片 ID 正常；反复复位仍能连接。

未通过时 先降 SWD 时钟、检查地和线序；必须区分 VCC 输出与 VTref 输入。

### 步骤 106 E016 下载最小安全固件

工程选 STM32F103C8T6，Flash 64 KB、RAM 20 KB。上电最先将 PB5、PA8、PA11 置低，PA4/PA15 置高，再配置总线。仅关闭 JTAG，保留 SWD，使 PA15、PB3、PB4 可用。

□ 检查 未配置屏幕和传感器时，串口也能每秒输出 BOOT/版本信息；调试器没有失联。

未通过时 若选了完全禁用 SWJ，使用复位下连接恢复并改为 SWD 保留模式；不依赖芯片可能存在的超额 Flash。

### 步骤 107 E017 连接 3.3 V 逻辑 USB 串口

USB 串口板由电脑 USB 自供电。模块 TXD→PA10，RXD→PA9，GND→公共地；VCC/5V/3V3 脚全部不接。先查模块 TX 空闲高电平确为约 3.3 V，再接 MCU。

□ 检查 电脑打开相应 COM，115200、8 数据位、无校验、1 停止位、无流控，看到完整文本。

未通过时 无输出先交叉核对 TX/RX；乱码查波特率和系统时钟；不是靠接 VCC 来排障。

### 步骤 108 E018 禁止核心 USB 并用

给核心USB贴“本机不接USB，PA11/12已分配”标签。正常系统下载用SWD、通信接J18三线USB串口，转换器VCC全部不接。独立USB台架须先断本板电源，并拔下与核心相连的全部线束后另测；只拔5V线并不能隔离ADC和其他GPIO反灌路径。

□ 检查 核心 USB 口没有插线；外置串口只有 TX/RX/GND 三根系统连线。

未通过时 需要核心USB测试时先彻底移出当前系统线束；不能在PA11/PA12仍连接业务模块时直接插核心USB。

MCU 端口 | 本版连接 | 配置/保留条件
PA0 / PA1 | SG90 信号经 AHCT 缓冲 / 电池 ADC | TIM2_CH1；ADC1_IN1，模拟输入。
PA2 / PA3 | HC-05 RX / TX | USART2；本机 TX 接对方 RX。
PA4 / PA5 / PA6 / PA7 | RC522 CS / SPI SCK / MISO / MOSI | SPI1 默认映射；FLASH 共享后三根。
PA8 / PA11 | TB6612 PWMA / PWMB | TIM1_CH1/CH4，20 kHz；禁止 USB。
PA9 / PA10 | 电脑串口 RX / TX | USART1，115200；不用硬件流控。
PA12 / PA15 | 对射输出 / FLASH CS | PA12 每 1 ms 轮询，不能占 EXTI12；PA15 释放 JTAG。
PA13 / PA14 | SWDIO / SWCLK | 永远保留下载。
PB0 / PB1 | 光敏 AO/DO / 超声 ECHO 分压 | ADC1_IN8 或普通输入；PB1 EXTI1 双边沿。
PB2 / PB3 / PB4 | BOOT1 保留 / 编码器 CLK / DT | PB3/4 释放 JTAG，GPIO 轮询或 EXTI3/4。
PB5 / PB6 / PB7 | 电机使能请求 / I²C SCL / SDA | PB5 经本章急停门控；I²C1 默认脚。
PB8 / PB9 | 前方障碍 DO / 蜂鸣器 IN | PB8 输入；PB9 GPIO 或 TIM4_CH4。
PB10 / PB11 | DFPlayer RX / DHT11 DATA | USART3 只开 TX；不得启用 USART3 RX。
PB12 / PB13 / PB14 / PB15 | 碰撞回路 / 急停反馈 / 闭盖 / 超声 TRIG | PB12 EXTI12；PB13 EXTI13；PB14 输入；PB15 普通推挽经 AHCT。
PC13 / PC14 / PC15 / NRST | 保留 LED/晶振/复位 | 不再分配外设，NRST 不从另一路 3.3 V 强上拉。

资源审查结论：本表 GPIO 没有重复分配；TIM1 两路同频独立占空比，TIM2 用作舵机，TIM3 作 1 MHz 时间基准，TIM4_CH4 可供无源蜂鸣器。PA12 不用外部中断可避开 PB12 的 EXTI12 冲突；USART3 只发送可避开 PB11 的 DHT11 冲突。I²C 与 SPI 必须采用默认映射，不随意开启会挪动上述引脚的重映射。

# 23 PCB总线区 MCP23017 I²C 上拉与OLED

扩展器是 MCP23017 I²C 型，不能购买/接成 MCP23S17 SPI 型，也不能继续套用旧 PCF8574 软件。MCP23017 的 GPA7、GPB7 按当前原厂资料只用于输出，本版均输出 0 且不接外部信号。

已焊好的MCP模块由J10接3V3_EXT、GND、SCL、SDA、RESET五线；另由J11接GPA0—GPA6七线、J12接GPB0—GPB6七线，共19根线。板内再分到对应功能接口。A0/A1/A2在模块侧接地；INTA/INTB不接；GPA7/GPB7不引出且程序设输出0。RESET不接核心NRST。

MCP23017 端子 | 接线 | 说明
VDD / GND | 3V3_EXT / GND | 引脚附近 100 nF；模块已有去耦也需确认。
SCL / SDA | PB6 / PB7 | SCL、SDA 各一组有效上拉至 3V3_EXT。
A0 / A1 / A2 | 全部 GND | 7 位地址 0x20。
RESET | 10 kΩ 上拉 3V3_EXT；另留一只复位短接点到 GND | 本版不直接并到核心 NRST，避免两路稳压经上拉互馈；每次 MCU 开机重新写寄存器。
INTA / INTB | 暂不接 | 本版扩展输入使用定时轮询。
GPA0 / GPA1 / GPA2 / GPA3 | AIN1 / AIN2 / BIN1 / BIN2 | 输出初值全低。
GPA4 / GPA5 / GPA6 / GPA7 | RC522 RST / 灯 MOS G / DFPlayer BUSY / 留空 | GPA6 为输入；GPA7 输出 0。
GPB0 / GPB1 / GPB2 / GPB3 | 循迹左 / 中 / 右 / 靠近 DO | 都为输入，电平先适配。
GPB4 / GPB5 / GPB6 / GPB7 | 编码器 SW / MODE / BACK / 留空 | 前三路按下接地；GPB7 输出 0。

PB6和PB7分别为共享SCL和SDA，每线有效4.7千欧上拉EXT3.3V；MPU模块供电依其稳压路径决定；两个稳压输出不并接。

图解 14 接好两根共享总线并核对上拉，逐块扫描 MCP、OLED 与 MPU，空闲约3.3 V。

### 步骤 109 E019 组装 I²C 主干

PB6、PB7 各串接到有清楚标签的分线排，再分别引至 MCP、OLED、MPU。总线地线与信号一同走线，远离电机电源。断电测各模块 SCL/SDA 对供电的上拉情况，保留等效约 4.7 kΩ 的一组，不把每块板的 4.7 kΩ 无条件叠加。

□ 检查 上电空闲 SCL/SDA 均在约 3.3 V；没有 5 V 上拉；首版线长控制在约 20 cm 以内。

未通过时 若某板 5 V 输入同时把总线拉到 5 V，改接其已确认的 3.3 V 上拉端或移除错误上拉。

### 步骤 110 E020 单独扫描 MCP

只接 MCP，先按住其 RESET 测试点到地再释放；PB5 始终低。I²C 配 100 kHz，用 7 位地址扫描，记录返回 0x20。

□ 检查 连续扫描 100 次均找到 0x20，没有 BUS BUSY 锁死。

未通过时 检查 A0/A1/A2 没悬空、RESET 为高、SDA/SCL 无反接；代码库需要左移地址时仅在调用 API 边界左移一次。

### 步骤 111 E021 初始化扩展端口

设 IOCON.BANK=0；OLATA(0x14)=0、OLATB(0x15)=0；IODIRA(0x00)=0x40、IODIRB(0x01)=0x7F。按传感器类型配置上拉，MODE/BACK/编码器开关至少使能；通用起点 GPPUB(0x0D)=0x70，其余输入按接线另设。

□ 检查 回读方向值一致；未接模块时方向输出均低，GPA7/GPB7 确为输出。

未通过时 地址/寄存器混淆时先检查 BANK 模式；不能沿用 PCF8574 直接写一个字节的驱动。

### 步骤 112 E022 检验每一路扩展输入输出

用 1 kΩ 串联的测试跳线逐个把输入接地，再断开，观察对应位。输出先不接电机，逐个输出低/高，用表测量；写端口使用 shadow 与 mask，保留无关位。

□ 检查 变化只发生在目标位；改变 GPA0 不会把 GPA4 的 RC522 复位拉低。

未通过时 读 GPIO 后原样写回会把输入读值混入输出锁存，应改用 OLAT 影子值。

### 步骤 113 E023 接 OLED 四根线

确认是 I²C 型并支持 3.3 V：GND→GND、VCC→3V3_EXT、SCL→PB6、SDA→PB7。扫描新增地址后初始化屏，依次显示全亮、全灭、边框和英文数字。

□ 检查 全屏像素范围正确，无偏移、闪烁；记录实际分辨率和控制芯片/驱动型号。

未通过时 0x3C/0x3D 只是常见地址；只有地址应答但显示错，需核对 SSD1306/SH1106、128×64/128×32，而非乱接线。

### 步骤 114 E024 合并 MCP 与 OLED 测试

OLED 分块刷新，不一次发送大屏阻塞安全输入；扫描两地址，在刷新时连续按 MODE/BACK。记录 I²C 错误计数。

□ 检查 按键及时响应，刷新不造成总线错误；主循环没有等待数十毫秒的长阻塞。

未通过时 减少刷新频率和单块长度，先查接地/上拉，最后才考虑调整总线速率。

# 24 MPU6050 RC522 与 FLASH 总线设备逐一验证

这三块模块都需要辨认版本。芯片的额定电压和带稳压模块的 VIN 额定电压不是一回事；3.3 V 只能接在已确认合适的供电脚。未知模块不必阻塞全部制作，可先完成同总线已确认模块并保留已标识插座。

### 步骤 115 E025 确认 MPU 模块的供电路径

看芯片为 MPU6050，找到稳压器及 VCC/VIN/3V3 标注。若 VCC 先经高压差稳压器，输入 3.3 V 可能让芯片供电不足；依据模块原理图决定给 VIN 5 V 或给已确认的 3.3 V 节点 3V3_EXT。接前测板上 I²C 上拉最后连到哪一路。

□ 检查 MPU 芯片实际供电在资料允许范围；SDA/SCL 空闲仍约 3.3 V，不随 VIN 升到 5 V。

未通过时 只有 VCC 标识而资料不清，先用表跟踪稳压输出或让商家提供原理图；不要把“模块常用5V”当作本块确认。

### 步骤 116 E026 接 MPU 数据线与固定

SCL→PB6、SDA→PB7、GND→GND、AD0→GND；INT/XDA/XCL 暂不接。用硬质支架固定到底盘，传感器轴向箭头记录在台账，不垫厚软泡棉。

□ 检查 扫描新增 0x68，WHO_AM_I 按芯片手册返回预期值；静放时加速度模长约 1 g。

未通过时 读数固定/全零先检查唤醒与量程寄存器；方向反转通过安装坐标转换处理，不能凭屏幕数字随意调阈值。

### 步骤 117 E027 MPU 零偏和倾斜检查

把底盘放在水平桌面，停止电机和语音振动，采 2 s 均值作静态基准；轻抬前、后、左、右四边，观察姿态变化符号。保存安装偏置，回水平检查回零。

□ 检查 四方向变化与实际一致，回水平无永久偏移；倾倒报警触发后锁存停车。

未通过时 静止抖动大先加固安装并检查电源，不能单纯把阈值放大到失去保护。

SCK、MISO、MOSI接PA5、PA6、PA7并共享；RC522 SDA接PA4，FLASH CS接PA15，各10k上拉3V3_EXT，RC522 RST接MCP GPA4。

图解 15 三根 SPI 信号并接，PA4与PA15独立片选；分别读ID后再交替读100次。

### 步骤 118 E028 焊 RC522 排针和线束

RC522使用J15：1=3V3_EXT、2=GND、3=模块SDA/SS（片选PA4）、4=SCK、5=MOSI、6=MISO、7=RST（GPA4），IRQ不接。板上R11为片选10k上拉；模块商品排针次序不同，要逐线对应，不把SDA接I²C。

□ 检查 逐线通断正确，无相邻脚短接；SDA 标签在此是 SPI 片选，不接 PB7。

未通过时 不能给普通 RC522 板 5 V；排针与芯片侧视图相反时按丝印而不是照片左右次序。

### 步骤 119 E029 单独测试 RFID

FLASH 暂不接；先让 GPA4 低后高释放 RC522 复位，再初始化 SPI1 Mode0、MSB first、1.125 MHz。读版本寄存器并记录；用本工程测试卡依次寻卡、读取完整 UID。

□ 检查 三张卡读数稳定，卡离开后再贴才能产生下一次事件；未知/克隆芯片版本必须与实际驱动兼容情况记录。

未通过时 一直 0x00/0xFF 优先查 3.3 V、RST、CS 和 MISO；不要用修改账号逻辑来掩盖底层 SPI 错误。

### 步骤 120 E030 定位 RFID 天线

把读卡板装到桶体外侧塑料读卡区，天线面向用户；先离电池、电机、金属支架和线束约 30 mm，再实测调整，天线区域不贴金属箔。

□ 检查 从规定刷卡位置连续读卡 20 次，位置标记可让使用者自然刷到卡。

未通过时 距离变差先移动天线板并缩短 SPI 线；30 mm 是试装起点，不是保证读距的厂商指标。

### 步骤 121 E031 确认 FLASH 型号再接电

抄下FLASH芯片全名并核为3.3V SPI NOR。J16的1/2为3V3/GND，3=CS（PA15），4=CLK，5=DI/SI，6=DO/SO。7/8为WP#/HOLD#，仅实物确有对应外露脚时使用；R13/R14按原有上拉决定装，R12是CS上拉。1.8V芯片不能直接接入。

□ 检查 读 JEDEC ID 与型号容量一致；SPI 未选中器件不会驱动 MISO。

未通过时 不知道 ID 时程序报告 UNSUPPORTED_FLASH 并禁写擦；先查资料，不能把任何芯片都当 W25Q32。

### 步骤 122 E032 单 FLASH 擦写验证

先备份已有内容，选明确保留的测试扇区，读取→擦除→验证全 FF→跨不同字节写已知数据→读回逐字节比较；地址、页大小、擦除大小均以该芯片数据手册为准。

□ 检查 一页测试 0 错误；写前使能、BUSY 超时和页边界处理正确；重启读回一致。

未通过时 只有写第一个字节正常时查页编程规则；禁止在未确认数据归属时整片擦除。

### 步骤 123 E033 合并 SPI 共享总线

同时接回 RC522 和 FLASH，启动先把两个 CS 拉高，操作任一器件时只拉低它自己的 CS；交替每次读卡版本、读 FLASH ID，至少循环 100 次。

新IO图的JAUX只提供片选、WP/HOLD及其他辅助信号，不含SPI三线。PA5/PA6/PA7仍直接在核心与RC522、FLASH线束间分接；PA4、PA15经图中片选接口分别连接各模块。RC522的SDA标记在本工程是CS，不能接I²C的SDA。板上已有片选上拉时，不再在外部重复装同值上拉。

□ 检查 两器件在共享时均稳定；每次事务结束片选恢复高，异常路径也释放片选。

未通过时 单独正常并联异常，查某板 MISO 常驱动、两 CS 同时低、导线过长；不要让两个任务同时调用 SPI。

积分账本只保存在已验证的 FLASH 事务区；RC522 读到 UID 仅是课设标识，不等于防复制认证。卡片写入实验使用专用可擦写测试卡和明确的数据块，不碰厂商块及密钥/访问控制尾块。

# 25 输入电平适配 完成传感器后再接 MCU

STM32 与 MCP23017 本版只使用 3.3 V 逻辑连接。MCP23017 尤其不能直接承受 5 V 输入。对实际模块按下面三种情况只选一种适配，再记录在 SENSOR_POLARITY 配置中。

新两板孔位图仅固定通用电路。实际为5V数字输出的NPN适配在模块侧或另加绝缘小接线片完成；DHT的5V分支用开漏双向BSS138适配，5V模拟AO不能套用数字NPN。MODE、BACK、编码器SW的约10kΩ外部上拉（或已验证的MCP内部上拉）、蜂鸣不响电平偏置以及MCP/DFPlayer就近去耦仍按本章对应步骤完成，不能因两板图无焊位而省掉。

实物输出情况 | 明确接法 | 软件记录
3.3 V 供电且 DO 电平为 0/3.3 V | DO 可直接进指定输入，必要时串 1 kΩ保护；共地 | 记录触发为高或低，统一归一为 triggered=true。
开集电极/开漏，板上没有接到5V的上拉 | DO→输入；10 kΩ 从 DO 上拉到 3V3_EXT | 记录传感器导通时代表遮挡还是畅通。
模块需5V且DO高电平/板上上拉为5V | DO→10 kΩ→2N3904 B；B→100 kΩ→GND；E→GND；C→目标输入；C以10 kΩ拉3V3_EXT | 这个适配会反相；模块DO高→MCU输入低。模块DO低→MCU输入高。
HC-SR04 ECHO | 固定12 kΩ串联上臂、20 kΩ接地的分压 | 保持脉宽极性，不使用上行反相电路。
模拟AO信号 | 优先3.3V供电且AO≤3.3V；5VAO按量程另分压并校准 | 禁止把模拟AO接入上述开关三极管后再声称测模拟量。

### 步骤 124 E034 在未接 MCU 时测输出

模块先单独供额定电压。万用表量 DO 对 GND 在触发/不触发两态的电压，记录空闲高电平、触发低电平和反应；若可能开集电极，依据资料核实而不是只凭一次电压判定。

□ 检查 两态清楚，最大输出不超过目标输入电源；没有负电压/高压。

未通过时 测不到高电平时查是否缺上拉；外接上拉前必须确认输出允许上拉方式。

### 步骤 125 E035 制作一条 NPN 适配作为样板

用有厂家资料的 2N3904 TO-92，按其脚图识别 E/B/C。焊入 10 kΩ 基极串阻、100 kΩ B-E 下拉、10 kΩ C→3V3_EXT上拉，再把 C 引出作安全输出。贴“INV 反相”标签。

□ 检查 以模块 DO=0 V/5 V 分别测试，C 输出约 3.3 V/低于0.3 V；接线不会把5V送入GPIO。

未通过时 若输出不翻转先查 E/C 反接及基极电阻；导通与电平通过后再复制到其他 5 V 数字通道。

### 步骤 126 E036 编写极性表

为 trackL/C/R、frontObstacle、near、deposit 分别记录物理输出、是否经反相、最终有效电平。测试页面同时显示 raw bit 和 normalized bit。

□ 检查 用手实测触发时 normalized=1；三路循迹都以“黑线=1”统一。

未通过时 不要在每段业务代码中各写一次取反，集中在驱动入口转换避免重复反相。

HC-SR04 的电阻分压只用于它的已确认 5 V ECHO 脉冲。带 5 V 弱上拉的开集电极模块若直接加同一分压，原上拉也成为串联电阻，高电平可能低于 MCP23017 门限；所以本章不把一个分压模板套给全部传感器。NPN 适配输出高约等于 3V3_EXT，适合扩展口读取，但每条通道仍需实测。

# 26 按键 编码器 碰撞和盖闭合检测

按键与限位开关先用万用表确认常开/常闭。轻触开关四脚通常是同侧两脚内部相通，方向弄错会成为永久按下；不能只凭外壳四角接两脚。

编码器VCC接EXT，GND共地，CLK接PB3、DT接PB4各10k上拉CORE，SW接MCP GPB4并10k上拉EXT。

图解 16 按三路信号与正确的上拉电源接编码器，旋转和按下分别单测。

### 步骤 127 E037 接旋转编码器

确认编码器模块能用3.3V后按J24接VCC/GND/CLK/DT/SW。CLK/DT只选一组上拉：移除模块原上拉后装R27/R28各10k拉3V3_CORE；或保留已确认拉3V3_EXT的模块上拉并不装R27/R28。SW按R33、模块同轨上拉或已验证MCP内部上拉三者确定有效上拉。不得让同一信号分别拉到两个稳压轨。

□ 检查 旋钮静止时 CLK/DT 稳定；按下时 GPB4=0，释放=1。

未通过时 裸机械编码器公共端接地，按轴向脚图确认 A/B/开关，不照模块标签猜脚。

### 步骤 128 E038 验证编码器方向和去抖

用状态转移表解码四相，不用每条边沿都加菜单项。缓慢顺时针一格、逆时针一格，再快速转十格；按下确认单独做20 ms去抖。

□ 检查 顺时针稳定向下一项，逆时针向上一项；按压不会同时跳页。

未通过时 若方向反了仅交换软件A/B或调方向系数，记录修改；跳项先检查JTAG释放和接触抖动。

轻触开关跨实测A组B组连接，一端地一端MCP输入上拉EXT；闭盖微动COM接地NO接PB14，10k上拉CORE。

图解 17 轻触开关先测两组常通脚，再跨组接；闭盖微动接COM和NO并确认闭盖为0。

### 步骤 129 E039 接 MODE 和 BACK

MODE与BACK使用常开轻触按钮。J25.1—2接MODE，3—4接BACK；按下才跨组导通。R34/R35默认已装10k上拉3V3_EXT。J25.5—6留给闭盖NO微动，不能把三组开关的信号脚短接。

□ 检查 空闲1、按下0；连续按10次只出现10次短按事件。

未通过时 一直0时查四脚同侧误接；长线误触时用外部10 kΩ上拉并缩短走线。

### 步骤 130 E040 接双碰撞常闭回路

左微动 COM→GND；左 NC→右 COM；右 NC→PB12；PB12经10 kΩ上拉3V3_CORE。左右触边机构在未碰撞时不压开关，碰撞压到动作点后NC断开。

□ 检查 正常PB12=0；任意一侧被压或任一串联线断开时PB12=1，触发停车锁。

未通过时 若两开关并联，会掩盖单边碰撞，应改串联。只报告碰撞发生，不声称本回路能区分左/右。

### 步骤 131 E041 接盖闭合开关

用一只微动 COM→GND、NO→PB14，PB14经10 kΩ上拉3V3_CORE。安装使桶盖完全闭合时机械压下开关，NO闭合。留微小过行程，不让开关本体承受整个盖的重量。

□ 检查 闭盖PB14=0；开盖或断线PB14=1；连续开关20次无漏触。

未通过时 盖半开已显示闭合则移动开关；不要靠放宽软件判断来允许半开行驶。

### 步骤 132 E042 输入故障注入

轮子架空，逐个拔掉碰撞线、闭盖线、编码器SW和按键线，观察状态。碰撞/盖线断开应禁止移动；普通按键断线应表现为未按，不能卡住整个程序。

□ 检查 故障码与实际断开的安全回路一致，复接后不自动行驶。

未通过时 误把安全开关接到常开串联回路会失去断线检测，按以上极性改线。

# 27 急停按钮 2S 偏置＋三管硬件钳位

本版修订旧“3.3 V/10 kΩ直接串NC”方案。Schneider XB5AS8444 官方列出洁净环境 5 V、1 mA 的电气可靠性条件；它不是对所有无品牌按钮的绝对最低负载保证。当前接口利用已经存在的 VBAT_SW=6.0–8.4 V 给接点约1.1–1.6 mA偏置，不增加24 V电源。采购的两组常闭触点仍须有适用于这一低电平条件的资料；外观相同不代表触点材料相同。

本电路用件 已计入PCB清单 | 数量 | 用途
2N3904 TO-92 NPN三极管 | 3只，另备1只可选 | PCB Q1/Q2/Q3对应原QES1/QES2/QES3，不重复增购；核实所购品牌E/B/C。
4.7 kΩ，1/4 W | 3只 | PCB R15/R17为NC1/NC2基极限流，R19为Q2基极上拉。
100 kΩ，1/4 W | 3只 | PCB R16/R18/R20为三个基极的100k下拉。
1 kΩ，1/4 W | 1只 | PCB R21串PB5到STBY，不可用导线旁路。
10 kΩ，1/4 W | 3只 | PCB R22/R23下拉PB5/STBY，R24拉PB13到CORE。
2NC保持型红蘑菇急停按钮 | 1只 | 两常闭触点独立；按下保持、旋转释放，触点规格有依据。
PCB接口 端子及标签 | 1组 | 分开标识VBAT_SW、3V3_EXT、3V3_CORE，避免把电池电压接到GPIO。

接线节点 | 必须焊到的点 | 正常/按下的结果
NC1上端 | VBAT_SW | 总开关后电池电压，不能接5V或GPIO。
NC1下端 | R_ES1 4.7k→QES1 B | QES1 B另经100k到GND，QES1 E→GND。
KILL_BASE | QES1 C、QES2 B；R_ES3 4.7k到3V3_EXT；100k到GND | NC1闭合→低→QES2关；NC1断开→约0.7V→QES2开。
STBY_OUT | QES2 C、TB6612 STBY、10k到GND；PB5经1k到此点 | QES2 E→GND。正常跟随PB5；急停钳低。
PB5端 | PB5→1k→STBY_OUT；PB5另10k到GND | 复位时默认低；不能绕过1k直连STBY_OUT。
NC2上端 | VBAT_SW | 与NC1为不同独立触点。
NC2下端 | R_ES2 4.7k→QES3 B | QES3 B另100k到GND；QES3 E→GND。
ESTOP_SENSE | QES3 C→PB13；10k上拉3V3_CORE | 正常=0；按下/断线=1。
共地 | QES1/2/3 E、电池地、驱动地、核心地 | 这不是隔离接口，所有地按规定汇合。

### 步骤 133 E043 先测按钮触点

按钮脱离电路，用蜂鸣档找两组独立NC。释放时每组导通，按下保持后每组断开；两组之间不导通。标NC1-A/B、NC2-A/B。

□ 检查 按下再松手仍保持断开，旋转释放才复原；接点之间没有误跨线。

未通过时 1NC按钮无法按本方案同时实现两个通道，应补正确2NC触点组件或换2NC总成。

### 步骤 134 E044 焊三个三极管及下拉

在PCB定位Q1/Q2/Q3，分别对应原步骤中的QES1/QES2/QES3，不另加一组三管。按实际厂家资料核E/B/C：PCB1=E、2=B、3=C。三个E接地，三个B均有100k下拉；断电核对导通及阻值后才继续。

TO-92外壳平面方向不能代替脚号。若所购品牌脚序与板定义不同，应按电气脚名弯脚、套绝缘管并固定，避免交叉脚碰触；不要直接按图形朝向硬插。

□ 检查 三只B-E下拉都存在；C未误短到GND；元件脚序记录可供复查。

未通过时 同为NPN的其他型号不能按2N3904脚位硬套；更换型号须重新认脚。

VBAT经NC1和4.7k到QES1基极；QES1集电极连QES2基极，上拉4.7k到EXT；QES2集电极钳STBY。PB5串1k到STBY，各自10k下拉，两管基极各100k下拉。

图解 18 按逻辑节点焊NC1两管钳位，按住急停且PB5强制高时，STBY必须低于0.3V。

### 步骤 135 E045 焊NC1和钳位节点

VBAT_SW→NC1→4.7k→QES1 B；QES1 C连接QES2 B形成KILL_BASE；KILL_BASE经4.7k拉3V3_EXT。QES2 C→STBY_OUT，STBY_OUT经10k到地，PB5经1k到STBY_OUT；PB5再加10k到地。

□ 检查 断电查节点表，每个节点无误；VBAT_SW与PB5/PB13/STBY间没有直接铜线短连。

未通过时 急停线只接基极限流电阻输入端，不可把8.4V直接接QES2集电极或驱动STBY。

VBAT经NC2与4.7k接QES3基极，基极100k下拉，发射极接地，集电极到PB13并10k上拉CORE；按下反馈高。

图解 19 独立焊NC2与QES3，验证释放为0、按下或断线为1，并逐个模拟两回路线断开。

### 步骤 136 E046 焊NC2反馈

VBAT_SW→NC2→4.7k→QES3 B；QES3 C→PB13，PB13经10k到核心3V3。布好后把NC1、NC2线束分别扎成小束，接点端子加绝缘。

□ 检查 反馈线只承受0/核心3.3V；两个触点各自断线都可以单独模拟。

未通过时 PB13不能直接接NC2下端；这里的电池侧和逻辑侧由晶体管隔开电压。

### 步骤 137 E047 仅测接口 不接电机

电机和舵机都拔下。用限流电源模拟6.0V、7.4V、8.4V的VBAT_SW；保证核心与EXT正常供电。释放按钮，PB5先低后高，测STBY_OUT应分别低于0.3V、典型约3.0V且高于2.7V；PB13应低于0.3V。

□ 检查 三个输入电压点均满足；闭合触点回路电流不低于约1mA；电阻不发热。

未通过时 高电平不足先查1k/10k阻值、驱动STBY板载拉低过强、三极管接反；达不到门限不能接电机。

### 步骤 138 E048 证明硬件按下会钳位

仍不接电机，让测试固件保持PB5=1；按下急停后测STBY_OUT，必须低于0.3V，同时PB13升到核心高电平。保持按下，复位MCU，再测STBY仍低。

□ 检查 即使测试固件没有主动清PB5，按钮保持按下时STBY依然低。

未通过时 未钳低先查NC1接到了NO、QES2 E/C接反或1k被导线短接；故障解决前禁接轮组。

### 步骤 139 E049 测两组断线和软件锁存

关闭PB5后释放急停。正常运行固件中分别拔NC1回路线、NC2回路线；NC1断开应硬件去使能，NC2断开应软件故障锁。按下/释放急停后必须重新确认运行，旧命令不得恢复。

□ 检查 NC1和NC2各自故障可追踪；接回或释放后样机保持停机，直到明确操作。

未通过时 硬件只有按下/断线钳位，没有独立机械/继电器复位锁；禁止把固件失控后松开按钮也不复跑作为本接口已保证能力。

计算核对：VBAT_SW=6.0 V、按基极约0.85 V估算，4.7k支路约1.10mA，扣除100k下拉约0.009mA后仍约1.09mA；8.4V时约1.6mA。QES2导通时4.7k上拉提供约0.55mA基极电流，钳位电流由PB5串1k限制在约3mA。本结果是电路推导，实物需执行E047–E049。电池≤6.6V持续1s即锁停；≤6.0V为异常下限，应立即停止。≤7.0V持续3s提示电量低，恢复到≥7.0V并人工确认、收到新运动命令后才能恢复，不以保护板自动切断为日常停机阈值。

按下急停使TB6612待机，输出高阻，车轮可能惯性滑行；它不是机械刹车，也不切断舵机电源。舵机停止由软件处理，整机断电靠总开关。三管钳位的Q2偏置依赖3V3_EXT；EXT掉电而核心仍输出高时不能保证完整硬件联锁。正常电源同启同停，异常用总开关断电；本课设不声明工业安全等级。

# 28 SN74AHCT125N 统一装好舵机与超声触发电平缓冲

为避免不同 SG90/HC-SR04 对 3.3 V 高电平识别差异，本手册将缓冲器列为标准装配。采购 SN74AHCT125N，DIP-14 直插封装1只、DIP-14 IC座1只、100 nF陶瓷1只。不能用74HC125默认替换，因为输入门限不同。

DIP-14 引脚 | 接线 | 作用
14 VCC / 7 GND | 5V_BUS / GND；C8=100nF | 5V供电；DIP14座
1 / 4 / 10使能 | 全部接GND | 通道1、2、3永久使能
2 A1 / 3 Y1 | PA0 / SERVO_SIG_5V | J20.1仅信号；舵机电源走J5
5 A2 / 6 Y2 | PB15 / US_TRIG_5V | J21.3超声TRIG
9 A3 / 8 Y3 | PB9 / BUZZ_5V | JP3选直出或缓冲；R36/R37只装一只
12 A4 / 13使能 / 11 Y4 | GND / 5V_BUS / 悬空 | 第4路禁用；11脚不接
R6 / R7 / R36或R37 | 输入默认低或蜂鸣不响电平 | 不使用蜂鸣也不可让PB9输入浮空

### 步骤 140 E050 焊IC座与去耦

按IC座缺口方向画1脚标记，先焊座对角两脚，检查贴平再焊全部。焊100nF，按上表做电源及未用脚连接；芯片先不插入。

□ 检查 IC座14脚接5V、7脚接GND；1/4/10使能脚均接GND，13脚接5V。第3路9脚接PB9、8脚接BUZZ_5V，第4路12脚接地、11脚悬空；电源无短路。

未通过时 座缺口不是芯片电气自动定位功能，仍需按实际芯片圆点/缺口对1脚。

### 步骤 141 E051 插芯片并测试两路

断电插U1，暂不接执行器。分别令PA0、PB15低/高，检查3脚、6脚0/5V；再测PWM与10μs脉冲。第3路PB9已有R36或R37唯一偏置，检查9脚与8脚同相跟随。仅第4路禁用，不能套旧图把9脚接地、10脚接5V。

□ 检查 两路分别跟随，没有反相或互相影响；复位时输出保持低。

未通过时 若出现约3.3V输出，查VCC是否误接3V3；若始终悬空查/OE是否错误拉高。

### 步骤 142 E052 标记最终端口

PCB已将Y1接J20.1舵机PWM，Y2接J21.3超声TRIG，Y3接JP3.3。J20.1是5V逻辑信号而非舵机正电源；SG90供电走J5。禁止另跨线把PA0/PB15直接并到相应5V输出。

□ 检查 不会同时把PA0与5V缓冲输出直接短接到同一跳线。

未通过时 发现旁路旧线立即移除；缓冲器不是可随意并接的电压增强器。

# 29 TB6612 轮电机与SG90 先架空 再装机械负载

本章默认已核实驱动芯片确为TB6612FNG。左右轮由两个减速电机驱动，套装直流风扇电机不充当轮电机。若现有模块为L298N、L9110或别的驱动，不能按同名端子数量套线，应先按实际型号改驱动接线和电流核算。

驱动端子 | 目标线 | 说明
VM / VCC / GND | 5V_MOTOR / 3V3_EXT / GND | VM是电机电源；VCC是逻辑电源。
AIN1 / AIN2 / BIN1 / BIN2 | GPA0 / GPA1 / GPA2 / GPA3 | 方向输出全部低为上电初值。
PWMA / PWMB | PA8 / PA11 | 20kHz硬件PWM。
STBY | 急停接口STBY_OUT | 不直接再跨一根PB5跳线。
AO1/AO2 | 左电机两端 | 镜像安装后的正反方向通过测试确定。
BO1/BO2 | 右电机两端 | 与左电机分开成对走线。
每只电机端子 | 100nF跨两电机端 | 陶瓷电容短脚焊，避开转轴与齿轮。

### 步骤 143 E053 检查驱动和轮电机规格

读取驱动芯片印字。检查新电机在5V的堵转电流资料，两只目标各≤1A，额定可用转矩各≥0.3kgf·cm。记录电机型号、减速比、轴型、轮径和对应支架。

□ 检查 两只为同型号匹配对，轮毂与轴配合不松；驱动平均能力与实际电流匹配。

未通过时 缺堵转电流资料可借限流电源做受控短时测量，不能长时间堵转；资料不足先不装上重载车测试。

### 步骤 144 E054 焊电机线和抑制电容

在电机外部两端子焊一对线，端子间直接并100nF。套热缩管隔开金属，再把双线轻绞成对；电线在电机壳附近固定，不由焊片承受拉力。

□ 检查 用手缓慢转轮，线不碰轴；电容脚不短到电机外壳；电机线电阻连续。

未通过时 不要让烙铁长时间加热塑料端盖或齿轮箱，焊点困难时先清洁镀锡。

### 步骤 145 E055 先接驱动逻辑 不接VM

只给驱动VCC=3.3V和GND，接方向、PWM、STBY。运行输出测试，用表/示波器检查方向组合与PWM。按急停时STBY必须低。

□ 检查 复位、上电、总线失联状态STBY和PWM均低。

未通过时 先修复控制逻辑，不能通过手动把STBY拉高让电机暂时能转。

TB6612 VM接独立5V电机支路，VCC接EXT3.3V，控制与地共接；AO1AO2只到左电机，100nF跨端；舵机独立5V支路并通过AHCT接PA0。

图解 20 断电接左轮，架空后低PWM验证方向，再接右轮；SG90独立电源支路且运行互锁。

### 步骤 146 E056 架空接单左电机

断电，接5V_MOTOR到VM及左电机AO1/AO2，右电机先不接。把底盘垫到两轮悬空。STBY=1后PWM从低占空比逐步增加，方向切换前先PWM=0、STBY=0、等待约100ms再反向。

□ 检查 记录开始转动占空比和前进方向；电机不啸叫停转过久；没有电源复位。

未通过时 转向相反可交换该电机两根线并标记，或设置单侧方向极性；不更改VM与GND。

### 步骤 147 E057 接右电机并检查组合

重复上一步接右电机，分别验证两轮前进、后退、左转、右转与停止。先低速每项2秒，记录左右空载电流。

□ 检查 本机“前进”时两轮在各自外侧看旋向相反但向同一前进方向滚动；停止后无持续驱动。

未通过时 左右镜像带来旋向差异正常；一轮不转先单路检查，不能把占空比直接加满。

### 步骤 148 E058 带轮地面初测

装好车轮与支撑轮，在平整封闭测试区从最低可稳定起步的占空比试行20cm，测实际时间算速度。限幅到0.08–0.12m/s目标，最高不超过0.15m/s。

□ 检查 起步不复位，直线不明显拖轮；按急停实测停止距离并记录。

未通过时 若一轮驱动电流过高，查轮毂摩擦、同轴、地面阻力和质量；本方案没有轮编码器闭环，不承诺长距离绝对直行。

### 步骤 149 E059 空载接SG90

卸下舵盘/连杆，SG90红线→5V_SERVO、棕/黑线→GND、信号→AHCT Y1。先50Hz、1500μs置中，停机后装舵盘。延长线三芯逐线确认，不凭商品公母名称接反。

SG90红线从J5.1取5V，棕/黑线直接回J5.2；信号线经实物核对接J20.1，即U1第3脚Y1。J20.2仅为信号参考地，不承担舵机主电流。先拆杆以50Hz、1500μs空载检查，再按第60章机械图装连杆。

□ 检查 空载没有连续撞机械极限和明显发热；运动时5V不跌到导致核心复位。

未通过时 转个不停可能不是位置舵机或脉宽异常，应先核模块；不能靠装上桶盖阻止连续旋转。

### 步骤 150 E060 标定舵机有效范围

不装连杆，脉宽以小步改变，从约1000–2000μs范围寻找需要的70°盖行程；记录可用两端但避开内部机械极限，返回中位后断电。

□ 检查 两端均无持续嗡响和强行顶死；记录最终SERVO_CLOSE_US和OPEN_US。

未通过时 不能把其它SG90示例的500–2500μs直接当实物可用全程。

### 步骤 151 E061 接机械连杆后联合检查

按机械章节保证盖运动组件≤45g且优先≤40g，完成50mm中心距连杆及20mm摇臂后，以慢速渐变PWM开关；闭盖开关用于确认，不靠舵机强压。

□ 检查 连续20次开关通过、无干涉、异常升温、供电复位；闭盖失败2s内报故障并禁止移动。

未通过时 开盖沉重先排铰链卡滞、连杆偏斜和盖质量，不先加大供电电压或将脉宽推到极限。

驱动STBY低后为待机，不能把它等同主动短刹。两只轮电机需要的软件使能、急停按钮和碰撞检测全部正常后才允许放地全载测试。SG90运动期间始终使轮电机关闭，减少瞬态供电叠加并避免开盖后重心变化时行驶。

# 30 投放对射 三路循迹 前方避障与靠近开盖

共需投放对射1对、三路循迹1组、前方避障1只、靠近检测1只；已有一只避障可复用于前方，靠近位置再补一只。已有单路寻迹不能直接凑成三路阵列，也不占用当前三路接口之外的额外GPIO。

### 步骤 152 E062 接投放对射电源

识别发射头TX和接收头RX；分别按额定电压接电源和地。若为裸红外LED而非带限流模块，必须按其额定电流另配限流，不直接上5V。让发射与接收正对，先不穿桶壁固定。

□ 检查 畅通和遮挡时接收DO有稳定两态；关闭发射器时接收器可显示异常或遮挡。

未通过时 反射式模块不能凭外观当成对射，先确认型号工作方式。

### 步骤 153 E063 将对射DO接PA12

按电平适配章处理DO，再接PA12。若核心板PA12自带USB上拉，断电测上拉路径并确认接收器能可靠拉低；本版使用3.3V适配输出，软件1ms轮询，不启用PA12的EXTI12。

□ 检查 两态低<0.3V、高>2.8V，持续采样没有不明跳变；与PB12碰撞中断同时工作。

未通过时 板上PA12拉到5V或强驱动时先处理核心USB电路；不通过连接电脑USB使信号“恢复正常”。

### 步骤 154 E064 固定对射并做经过试验

按机械章节使光束穿过投口下方且高于袋口；固定后轻摇桶体，发射接收仍对准。分别投浅纸团、深色小物，每次完整穿过，不手持长时间遮挡。

□ 检查 后台能记录遮挡起止；稳定遮挡≥30ms再畅通≥100ms形成事件；长遮挡不重复加分。

未通过时 物体绕开光束属于检测盲区，调整投入口导流；这一检测不证明垃圾类别或最终确实进入袋底。

### 步骤 155 E065 接三路循迹

按阵列丝印接VCC/GND，经电平核对后OUT_L/C/R→GPB0/1/2。阵列装在车前下方，先用可调长孔支架，三探头与地面平行，工作高度以实际模块标定为准。

□ 检查 在白纸和黑胶带上各通道均能清楚切换；线缆不拖地，不被万向轮扫到。

未通过时 三路反射强弱不同先分别调电位器；不能只看板上LED亮就认定GPIO极性。

### 步骤 156 E066 标定黑白阈值

用最终路线纸和18mm黑胶带，在最终灯光下静态把每探头置于白、黑及边缘，记录raw。软件统一黑=1，测试屏按L/C/R显示。

□ 检查 居中时出现预期中心通道黑，左右偏移时显示正确一侧；全白能进入丢线停止逻辑。

未通过时 纸面强反光则换哑光面或调整角度；不把所有电位器位置当作必然相同。

### 步骤 157 E067 接前避障

已有红外避障模块供电和DO先单测，适配后DO→PB8。模块朝车前，用可调支架避开底板/轮子反射；从较远距离向前放平板逐步靠近，调触发阈值。

□ 检查 白、黑、斜面三类目标分别记录最差检测距离；触发距离大于实测停止距离加余量。

未通过时 黑色或斜面漏检应在报告写明；本功能叫障碍停车，不声称能规划绕行或保证检测所有物体。

### 步骤 158 E068 接靠近检测

第二只红外模块安装在用户操作区，DO经适配接GPB3。光轴不要直射投放接收器或面对本机盖反光面。只在便捷开盖模式采纳该输入。

□ 检查 手靠近持续300ms有事件，离开2s后允许关盖；移动中靠近不触发开盖，未刷卡不计分。

未通过时 若同一只模块同时接PB8和GPB3并用于两种方向，会混淆安全与交互，应保持两只独立传感器。

### 步骤 159 E069 做红外互扰检查

开启所有红外发射器，空桶无遮挡静置1min，再分别触发一个模块；比较其它通道是否误跳。试验在室内常用照明和窗边光线各做一轮。

□ 检查 单个触发不会形成其它投放/靠近事件；采样日志可追溯。

未通过时 调整位置、增加不透光遮光小管/挡板或降低反射串扰；不要简单屏蔽前方停车输入。

# 31 HC-SR04 DHT11 光敏 测量电路与校准

这些模块给出课设演示量，满桶高度、照度以及温湿度都需用实物确认；不能因数值显示出来就称为准确测量。当前短PP内胆的袋口低于旧内桶，因此满桶阈值必须按新袋口标定。

### 步骤 160 E070 接超声电源和TRIG

HC-SR04 VCC→5V_LOGIC、GND→GND、TRIG→AHCT Y2。模块固定在桶口可拆横梁朝下，不能装在随盖移动的部件上。先在桌面用平纸板作目标验证。

□ 检查 触发引脚在模块处是约5V、10μs脉冲；触发间隔先100ms。

未通过时 若无回波，先用规则平板在10–20cm处测，排除狭小桶壁和袋皱反射。

PB15进入AHCT125的5脚，6脚输出到TRIG，14脚5V、7和4脚地；ECHO串12k到PB1节点，节点20k到地。

图解 21 照节点焊12k/20k分压，并核对AHCT通道2方向；先测电平再连接PB1。

### 步骤 161 E071 焊ECHO分压

PCB已焊R25=12k上臂、R26=20k下臂：J21.4原始ECHO→R25→PB1，PB1经R26到GND。先测分压再接核心；不另跨原始ECHO到PB1，也不在该节点并大电容以免损失脉宽。

□ 检查 5V高输入理论分压3.125V；高态实际不超过逻辑允许电压；低态清楚，脉冲边沿可测。

未通过时 若12k/20k上下颠倒会变1.875V，先核接法；ECHO不可直接5V进PB1。

### 步骤 162 E072 测距固件及超时

PB1 EXTI1双边沿记录TIM3的1MHz计数差；16位计数使用无符号差处理；发TRIG后25ms未完成即超时，不能死等。以20℃附近距离cm≈高电平μs/58作初始换算。

□ 检查 10cm、15cm、20cm平板测试方向和量级正确；拔掉模块会报告未知，不再显示上次正常距离。

未通过时 若距离漂移，查地和电源、反射几何及计时溢出；测满只在停车闭盖稳定后执行。

### 步骤 163 E073 重新标定短内胆满桶点

装好本版1mm PP内胆和垃圾袋。量测超声探头有效面到袋口的竖直距离d_rim；把平板放在袋口以下至少约20mm作为允许垃圾顶面，记录触发距离d_full，再降板约20mm作为恢复距离d_clear。初始阈值按这两次实测确定，不沿用旧45/65mm。

□ 检查 d_full大于d_rim，表示在垃圾仍低于袋口时就报满；d_clear大于d_full，具备回差；清桶后不会反复跳变。

未通过时 若横梁在280mm、袋口约236mm，20mm余量对应初始d_full约64mm，仅作示例；实际以装好后的基准面为准。

### 步骤 164 E074 接DHT11

支持3.3V的DHT版本接J22的电源、GND、DATA；JP7短1—2，JP8闭合。PB11开漏，R29或模块已有同轨上拉须有效。裸四脚DHT按厂家引脚图核对，第三脚NC不接。未确认电压前JP7/JP8保持开路。

□ 检查 DATA空闲约3.3V，PB11可开漏拉低并释放；3s读一次有校验通过的数据。

未通过时 只有模块写“VCC”不够确认供电；有些版本最低3.5V，不把3.3V勉强工作当额定支持。

### 步骤 165 E075 处理必须5V的DHT版本

必须5V的DHT：JP7短2—3，JP8始终开路；外接BSS138双向开漏转换板到J23，1=LV/3V3_EXT、2=HV/5V、3=GND、4=低压通道PB11、5=高压通道DHT_DATA_RAW。确认两侧有效上拉；不能用单向NPN代替，也不能短JP8旁路转换。

□ 检查 用示波器确认MCU侧高电平≤3.3V、传感器侧约5V，启动低脉冲与响应能双向传递；连续读30次不丢校验。

未通过时 接口资料不清或单向转换板不适合此总线，则改用已确认支持3.3V的DHT11版本，保持主板接口不变。

### 步骤 166 E076 安装DHT并校验

把DHT放在通风区，与稳压器、电机、阳光直射分开，不封在厚泡棉里。与室内参考温湿度计并排静置数分钟，再记录差值；传感器响应慢，避免频繁连读。

□ 检查 异常/校验失败显示--，不把上次值当当前值；拔掉DHT不影响急停、投放和移动任务。

未通过时 环境值随稳压发热升高则移位置；不要用未校准偏置掩盖安装受热。

### 步骤 167 E077 接光敏AO或DO

优先确认模块3.3V可工作，VCC→3V3_EXT、GND→GND。带AO的用AO→PB0，PB0模拟输入；只有DO的用DO→PB0数字输入并按电平适配，不再显示lux或连续亮度。

□ 检查 遮住和照亮时ADC或DO明显变化；模拟最高电压≤3.3V。

未通过时 四针模块AO与DO不能互换后继续同一驱动；实际是5VAO时需另分压、调ADC量程并记录。

### 步骤 168 E078 标定明暗阈值

在教室正常亮度、遮住传感器两种条件各采50次均值，按实测中点设置开灯阈值，再留明显回差设置关灯阈值。灯自身不要直射光敏头。

□ 检查 暗时开灯、亮时关灯，边界遮挡不频闪；开灯后不会立即因自身照明而关灯。

未通过时 出现闪烁优先隔开灯与传感器或增回差和稳定时间，不只增加主循环延时。

# 32 照明MOS 蜂鸣器与DFPlayer语音

AO3400A仍是已购SOT-23裸管，先焊到已购SOT-23转DIP板，再用标明G/S/D的线束接PCB J28。转接板独立绝缘固定，不假定商品转接板排针顺序。它只驱动一颗小白LED，不驱动电机或舵机。

元件 | 逐端连接 | 说明
AO3400A 1脚G | GPA5→100Ω→G；G→100kΩ→GND | 栅极下拉确保复位关灯。
AO3400A 2脚S / 3脚D | S→GND；D→LED负极 | 脚号据AOS原厂SOT-23资料；转接板排针次序需导通追踪。
LED正极 | 5V_LOGIC→220Ω→LED正极 | 白LED目标几mA至约10mA，必须有串联限流。
蜂鸣模块VCC/GND/IN | J30.1/2/3接VCC/GND/IN；JP4选电源，JP3选直出或5V缓冲。 | 先核有源/无源、是否自带晶体管、有效电平。
DFPlayer VCC/GND | 5V_LOGIC / GND | 附近加100μF和100nF，避免播放电流使系统复位。
DFPlayer RX | PB10→1kΩ→RX | USART3仅TX，9600 8N1，模块TX暂不接。
DFPlayer BUSY | GPA6，测到为3.3V或开集输出后连接 | 若板输出5V则按NPN适配并在软件反相；不默认所有兼容板一致。
DFPlayer SPK1/SPK2 | 分别接同一只扬声器两端 | 桥接输出，两端均不能接GND；首版8Ω/1W扬声器、小音量。

GPA5经100Ω到AO3400A栅极，栅极100k接地，源极接地，漏极接LED负端，LED正端经220Ω到5V；电解负极色条接地。

图解 22 按1G/2S/3D追踪转接板，焊栅极100Ω与100k下拉、LED串220Ω；电解色条端接地。

### 步骤 169 E079 焊AO3400A转接板

用镊子对准已少量预上锡的转接板焊盘，固定AO3400A一脚，核对后焊其余两脚。断电查无连锡并追踪真实G/S/D。J28.1→G、J28.2→S/GND、J28.3→D/LED_NEG。转接板独立固定并绝缘，不整排猜接。

□ 检查 三个管脚没有桥接；1G、2S、3D与标记一致；焊接人员不拿模糊丝印代替脚图。

未通过时 若首次手焊SOT-23无把握，可请实验室帮助焊这一只或购买已焊转接板，不需要为它增加一块昂贵功能板。

### 步骤 170 E080 接LED和栅极阻容

按表焊100Ω、100kΩ、220Ω与LED。先以G接地检查灯灭，再用3.3V通过100Ω驱动G检查灯亮；最后接GPA5。

PCB已放R3=100Ω栅极串联、R4=100k下拉、R5=220Ω限流。GPA5经J11.6进入板内；MOS接J28，白LED接J29（1正2负）。无需旧PWR的JP10/JP11/JP12线束或另焊一组相同电阻。

□ 检查 灭时无明显漏亮，亮时电流约数mA，MOS不发热；LED极性及限流阻值正确。

未通过时 灯不亮先查LED反接和S/D方向；不能把220Ω短接来“提高亮度”。

### 步骤 171 E081 让明暗控制灯

先手动菜单灯开/关验收，再接入PB0明暗阈值和回差。复位MCP时灯应熄灭。

□ 检查 GPA5影子位在改电机方向时保持，读卡复位也不会误闪灯。

未通过时 若方向变化导致灯闪，是OLATA整字节覆盖问题，修驱动掩码，不换LED。

### 步骤 172 E082 辨认蜂鸣模块

先读芯片/板说明。带振荡器的有源蜂鸣器用稳定使能电平发声；无源蜂鸣器需要PWM。若为两脚裸蜂鸣器，不直接接PB9；须加有足够电流能力的驱动级。

□ 检查 模块电流与输入逻辑已明确；断开IN时不乱叫，上电默认无声。

未通过时 只有外壳黑贴纸不能唯一判断有源/无源；先用额定电源和受控信号作短测试。

### 步骤 173 E083 接蜂鸣控制并试音

PCB已固定AHCT第3通道9脚接PB9、10脚接地。3.3V可控制的蜂鸣模块将JP3短1—2；确需5V控制的短2—3，不允许两只帽并接两个输出。JP4按模块电源选择。高有效默认装R36=10k下拉、R37不装；低有效先拆R36再装R37拉3V3_CORE，即使不用蜂鸣也须保留其中一只偏置。第61章“五拆六增”只属于旧洞洞板，PCB不拆铜箔、不照做。

□ 检查 100ms短音、两次短音、故障间歇音能区分；模式切换能及时停止蜂鸣。

未通过时 低有效模块若仍接10k下拉会在复位时发声，应改为10k上拉3V3_CORE并核验；不要把5V上拉直接送PB9。

### 步骤 174 E084 无源裸蜂鸣器的补充接法

仅当套装没有驱动模块时：5V→额定5V小蜂鸣器正极，负极→另加2N3904 C，E→GND，PB9→1k→B，B→100k→GND。磁性负载跨接反向二极管（阴极5V、阳极C），压电片按其资料接驱动。

□ 检查 低电流蜂鸣器匹配三极管额定能力；无源用约2kHz起始PWM，音量可辨。

未通过时 额定电流未知或高功率蜂鸣器不按本小信号电路直接驱动；优先复用原三线模块。

### 步骤 175 E085 准备TF卡与语音文件

选模块支持的TF卡，用FAT32格式化前备份。建mp3目录，放0001.mp3至0006.mp3，对应欢迎、请投放、积分成功、桶满、故障、维护提示。先用电脑逐个播放确认内容和音量一致。

□ 检查 文件名四位数，编码/采样率在模块支持范围，卡能在电脑正常读回。

未通过时 文件号播放错可能与模块命令/目录约定有关，用明确的mp3目录播放命令逐个验证；不凭复制顺序猜文件号。

### 步骤 176 E086 接DFPlayer并低音量测试

断电插TF卡，接VCC/GND/RX，喇叭两线接SPK1/SPK2且与地绝缘；设置音量从很低值开始，逐个发播放编号。喇叭固定在有出声孔的区域，线做应力释放。

□ 检查 六个编号对应正确语音，没有电源复位和持续破音；核心与TF卡不过热。

未通过时 无声先检查BUSY变化、卡格式、文件命令和音量，再查扬声器；不要把SPK2当GND试接。

### 步骤 177 E087 接BUSY和异常超时

确认BUSY实际电平后接GPA6，按播放/停止记录有效状态，软件用队列和超时等待而非循环死等。拔TF卡、BUSY断线各试一次。

□ 检查 音频故障仅提示语音不可用，不阻止急停、积分查询、关盖和主循环。

未通过时 本接线未接DFPlayer TX，不能把发送成功当成收到模块ACK；以BUSY/听音/超时综合验证。

# 33 HC-05蓝牙 电脑导出与电池ADC

HC-05用于Android蓝牙SPP串口遥控；它不等同BLE通用手机模块。电脑串口已在最小系统接好，这里把通信逐步升级到遥控和CSV导出。

### 步骤 178 E088 确认HC-05底板电源

确认是带稳压底板并明确支持5V输入，才把VCC→5V_LOGIC；裸HC-05模块按其3.3V输入额定值接3V3_EXT。GND共地；RXD→PA2、TXD→PA3；KEY/STATE首版悬空。

□ 检查 模块TX空闲逻辑约3.3V；不能把VCC可5V推断为RX可5V。

未通过时 PA2本来是3.3V发送，不需要再用5→3.3分压压成约2V；若模块RX内部有分压仍需确认高电平裕量。

### 步骤 179 E089 先做蓝牙串口回显

Android配对模块，在SPP串口工具建立连接；按实际模块数据模式波特率设置USART2，常见起点9600。手机发送带换行的测试文本，STM32原样回显并在电脑串口记录。

□ 检查 双向文字完整，断连可被控制程序通过命令超时识别；记录模块名与波特率。

未通过时 AT模式波特率可能与数据模式不同；不要只因无法回显就反复改底层GPIO。

### 步骤 180 E090 遥控首先只打印不运动

把手机前/后/左/右/停按钮绑定本软件协议，先让固件仅打印解析结果与命令时间戳。按住按钮需周期发送，松开立即发STOP。测试残缺帧、超长帧及未知命令。

□ 检查 未知命令拒绝；300ms无有效运动命令即置停；连接建立本身不等于授权行驶。

未通过时 某终端按钮只发送一次，需启用按住重复或采用支持心跳的控制页，不能把超时改成无限。

### 步骤 181 E091 架空验证遥控 再落地

盖闭合、急停释放、无碰撞和故障后进入MANUAL_MOVE，先架空验证方向。关闭手机蓝牙或退出应用，轮子应在约300ms命令超时后去使能。

□ 检查 断连、手机锁屏停止发送、畸形数据都不导致继续长期运行；复连后仍需明确选择运行。

未通过时 若APP没有持续心跳，只能短时点动；未验证超时前不放地测试。

### 步骤 182 E092 完成CSV导出

电脑串口保持115200 8N1，进入导出模式或发送软件定义的EXPORT命令。固件先输出列名，再按有效日志逐行输出；电脑终端开启纯文本日志保存，结束后用UTF-8导入Excel。

□ 检查 用户ID、txid、积分增量、余额和事件序号与屏幕账本一致；没有把调试日志混入CSV数据行。

未通过时 含中文时需确认编码；导出途中拔线可重新开始，不擦除FLASH也不阻塞停车任务。

### 步骤 183 E093 焊电池分压

PCB上R1=33k、R2=10k、C7=100nF构成电池分压；JP9闭合后送J8.5的PA1。8.4V理论约1.953V，长采样时间并按实际Vref校准。单独拔核心电源前先断全机电源；若电池仍在，至少先拔JP9隔离ADC，但其他GPIO仍可能反灌，不能把JP9当全接口隔离。

□ 检查 8.4V理论节点8.4×10/(33+10)=1.953V；实际与表读一致，远小于3.3V。

未通过时 若节点接近整个电池电压，可能下臂断路，先断电补焊；不要在节点异常时接PA1。

### 步骤 184 E094 标定电池电压

ADC长采样时间，例如239.5周期，多次平均；先测核心VDDA实际值，用Vbat=ADC/4095×VDDA×4.3作初始换算。分别在6.6、7.4、8.4V比较表值与显示，记录校准系数。

□ 检查 三个点误差可接受且单调；驱动启动瞬间不触发大量误低电，但持续低电可可靠识别。

未通过时 低电阈值用时间确认与回差，不用一次采样决定；关闭核心单独电源测试时先拔PA1采样线，防止被分压信号反向喂电。

### 步骤 185 E095 验证低电停运

在限流台架缓降输入：≤7.0V持续3s提示电量低；电池≤6.6V持续1s触发低电锁，PB5=0、PWM=0，拒绝新移动/开盖并提示换电；≤6.0V为异常下限，应立即停止。恢复到≥7.0V且人工确认、收到新的运动命令后才允许运行。阈值为本项目初始值，需与实际电池和降压压差复核。

□ 检查 在保护板断电前已主动停车；数据事务要么完整提交，要么按恢复规则舍弃未完成记录。

未通过时 电池包保护电压不是本项目正常续航终止目标，不能反复把电池拖到BMS切断。

# 34 已有备用模块的安排 不增加隐蔽接线

用户已有配件应都有明确去向，但没有必要为了“全部插上”而耗掉保留GPIO或引入无用负载。以下物品仍可用于台架学习和备件，不改变已确定33项成品功能。

现有配件 | 本机安排 | 需要实验时如何使用
大型教学底板、数码管、点阵、矩阵键盘 | 保存原状，不与成品核心同时连线 | 把核心拔回教学板前，先断开成品所有排线和电池；回到教学实验程序。
单路红外寻迹模块 | 备用、黑白反射标定样件 | 单模块台架时可临时占GPB0测试，完成后断电换回三路循迹左通道；成品不能同时并接两个DO输出。
热敏传感器模块 | 备用温度实验，不作为主温湿度计 | 实验时断开光敏PB0后，确认3.3V供电和AO范围再接PB0；要显示温度须按实际NTC阻值/β值校准，成品恢复光敏。
套装直流风扇电机＋扇叶 | 备用驱动实验，不替代减速轮电机 | 如演示驱动，卸下扇叶或加护罩，断电换下某一路轮电机后接该路短时台架测试；不与轮电机并联。
面包板和长杜邦线 | 用于低电流信号原型 | 电机/舵机/电池主电流不通过它；验证后接入PCB A1对应接口。
ARM仿真器、USB线 | 下载和调试复用 | 仿真器接SWD；核心USB不用；电脑串口板由其USB线连接电脑。

临时实验改变接线必须在记录表写明，并在合装前按最终接线表恢复；不能把“暂时挪一个脚”悄悄留到最终固件里。

# 35 最终接线验收 线束收束与全机带载检查

下面步骤在机械安装、最小驱动与各单模块测试后执行。一次只添加一个负载，失败时退回上一个已通过配置。所有轮子首次全系统上电仍应架空。

### 步骤 186 E096 完成逐线复核

打印本章引脚表，一人读起点另一人用表确认终点；单人制作时每条线查完打勾。重点复核VM/VCC、核心3V3/EXT3V3、SPI片选、AHCT方向、急停电池侧和逻辑侧。

□ 检查 无两个推挽输出互连；无5VDO直接送MCP；电池侧只到降压、分压和急停限流输入。

未通过时 任一线来源不明就追踪标签，不以“之前能亮屏”代替核对。

### 步骤 187 E097 先做零负载开机

断开电机、舵机与喇叭，只接所有逻辑传感器，启动自检并运行10min，操作所有菜单和输入。记录5V、两路3.3V、电流、错误计数、重启次数。

□ 检查 无自发复位或总线挂死；关键输入失联有明确状态，PB5始终低。

未通过时 自检失败先断掉最近接入模块；有5V误上拉时先修电平，不给程序增加无穷重试。

### 步骤 188 E098 逐个加动态负载

先接喇叭小音量测试，再单独接舵机做20次开关，最后接轮电机架空测试；每次记录5V最低值和MCU复位计数。用示波器探头短地线测核心供电脚附近瞬态。

□ 检查 每项都独立通过，特别是舵机启动和语音播放不触发掉电复位。

未通过时 不足时改善支路粗线、接头和去耦，核降压能力及机械卡滞；电容不能替代不够的持续电源。

### 步骤 189 E099 测互锁和组合峰值

正式程序中发移动命令后请求开盖，再开盖时发移动命令，均应拒绝危险组合。语音与正常移动/开盖允许共存时再测电源，音量维持已验证水平。

□ 检查 电机模式与舵机模式互斥；不会发生两轮堵转与舵机顶死同时作为正常工况。

未通过时 若开启声音明显拉低电源，降音量或提高独立语音支路能力后重测，不放宽逻辑电压下限。

### 步骤 190 E100 收束线束和装护线圈

电源粗线贴底板边走，SPI/I²C信号线走另一侧；线束每隔一段固定，转动机构旁留活动余量。穿PVC板的线用匹配板厚的护线圈，穿孔按护线圈槽径而不是通线内径开。

□ 检查 满开盖和转动轮组时无夹线、拉线；能拔出内胆，不需要扯下核心排针。

未通过时 避开铰链、连杆扫掠区、轮胎和万向轮转向扫掠区；不能用胶带包住会发热的稳压芯片。

### 步骤 191 E101 固定电池和电路板

电池放低位，垫2mm EVA并用20×300mm扣环魔术贴两条固定；轻量小模块可辅以20×1mm泡棉双面胶，但核心/驱动/电源板优先立柱与夹持。露铜背面留绝缘间隙。

□ 检查 轻摇底盘无滑动和电池撞击；充电/取电池无需拉扯保险座。

未通过时 两面胶只作辅助定位，舵机、电机、电池不靠少量泡棉胶承担全部载荷。

### 步骤 192 E102 全部断线故障复测

按清单逐个模拟RC522/FLASH/MCP/超声/盖开关/碰撞/急停/蓝牙断连，观察对应功能禁用和故障锁。测试时不同时制造多个未知故障。

□ 检查 关键故障禁相关动作；普通声音/环境故障不使安全处理失效；复接后不会自行行驶。

未通过时 I²C失联仍允许PB5保持高是固件缺陷，先修复独立使能处理。

### 步骤 193 E103 满载30分钟验证

载荷不超过机械设计0.30kg、整机目标≤1.60kg。交替做刷卡投放、积分查询、短距移动、停站、导出和语音，共30min；记录电池起止电压、最低5V、异常复位/误积分、驱动温度。

□ 检查 系统行为可重复，零未解释复位、零重复计分，电线接头无异常热或松脱。

未通过时 出现一次异常也写入记录，查因修复后针对关联功能重测，不删掉失败记录冒充全程通过。

### 步骤 194 E104 形成电气竣工资料

保存最终线束照片、实际模块型号、输入极性表、万用表电压、示波器截图、固件版本与测试记录。把不再使用的临时跨线取下，贴最终供电和接口标签。

□ 检查 下次拆装可按照片和线号复原，不依赖口头记忆。

未通过时 任何临时改脚若决定保留，必须同时改本文引脚表、软件配置和测试表，三个版本保持一致。

最终测点 | 正常预期 | 实测填写
5V_BUS/5V_SERVO/5V_MOTOR | 约5V，项目带载目标4.85–5.15V | ____ V / ____ V / ____ V
3V3_EXT / 3V3_CORE | 约3.3V，二者不直接并联 | ____ V / ____ V
PB5=0时STBY_OUT | <0.3V | ____ V
急停释放且PB5=1时STBY_OUT | 典型约3.0V，验收>2.7V | ____ V
急停保持按下且PB5=1时STBY_OUT | <0.3V | ____ V
PB13正常/按下 | 低/核心3.3V | ____ V / ____ V
PA1在电池8.4V时 | 约1.95V | ____ V
US_ECHO节点 | 5V输入时约3.125V | ____ V
I²C空闲SCL/SDA | 均约3.3V | ____ V / ____ V
满载运行30min | 记录故障与温升，不预填通过 | 记录文件：____________

# 36 软件起点与版本界限

本章是一份从新建工程到逐项验收的实施操作规程。文中函数名、命令和数据格式是待实现的统一接口；它们不是已经交付并烧录验证的完整固件。

固件须按下列步骤从新工程逐模块实现。旧V2.1底板与PCF8574程序的引脚不同，不能直接烧录后接上本版MCP23017及执行器。烧录文件只有在当前接线和测试记录下通过验证，才用于整机运行。

阶段 | 需要自己完成的程序内容 | 本阶段停止条件
S0 | 新建 F103C8 工程、SWD、串口心跳、安全输出 | 下载/复位后电机与舵机均不意外运动
S1 | MCP23017、OLED、RC522、FLASH、输入单测 | 每个模块的原始值可看见且重复正确
S2 | 用户管理、积分事务、刷卡投放、轻盖控制 | 计分与掉电恢复通过测试
S3 | 电机架空、急停、低电、循迹及站点 | 互锁与停车先于地面运动通过
S4 | 蓝牙、环境、语音、导出、全部联调 | 33 项验收表全部有实际证据

推荐新建独立工程 SmartBin_33F_F103C8，保存于不含中文和空格的短路径，例如 D:/SmartBin/SmartBin_33F_F103C8。旧文件只留作参考。每完成一个阶段复制一份可构建的源码备份，并记录 .ioc、HAL 软件包、编译器、程序版本和当日标定值。不要在同一个工程混用旧标准外设库与新的 HAL 初始化代码。

# 37 安装软件 建立 STM32 工程与第一次下载

采用独立 STM32CubeMX 生成初始化、STM32CubeIDE 的 Eclipse 版本编译调试、STM32CubeProgrammer 辅助连接。按这一路径操作可以避免不同 IDE 版本中配置入口变化。工具以 ST 官方下载页为准。

### 步骤 195 下载并安装

从文末 ST 官方链接安装 Windows 版 STM32CubeMX、STM32CubeIDE、STM32CubeProgrammer；安装 ST-LINK 驱动。打开各软件一次，记录版本。已有工具能正常识别 F103C8 则可复用。

□ 检查 设备管理器中下载器无黄色感叹号，三个工具可启动。

未通过时 换可传数据的 USB 线；从下载器厂家确认型号。套装“ARM 仿真器”若是 J-Link，应在 IDE 选择 J-Link，不能按外壳颜色认作 ST-LINK。

### 步骤 196 新建工程

打开 CubeMX，选 MCU Selector，搜索 STM32F103C8T6，选 LQFP48；不要选 F103CB 或其他封装。Project Manager 中填写英文工程名，Toolchain/IDE 选 STM32CubeIDE，安装它要求的 STM32CubeF1 软件包。

□ 检查 器件显示 C8T6，Flash 64 KB、RAM 20 KB。

未通过时 型号选错应新建并按下表重设，不能只改工程名称。

### 步骤 197 保留调试接口

System Core → SYS → Debug 选择 Serial Wire；RCC 仅在确认晶振频率后选 HSE Crystal/Ceramic Resonator。关闭 JTAG、保留 SWD，使 PA15、PB3、PB4 可用。

□ 检查 引脚图 PA13 为 SWDIO、PA14 为 SWCLK，PB3/PB4/PA15 可配置。

未通过时 若选 Trace Asynchronous SW 会占用 PB3；改回仅 Serial Wire。程序中不得再次执行关闭全部 SWJ 的宏。

五级调试流程从最小核心、电源和I2C、RFID与存储、架空执行器到低速整机；每级失败向下进入共同停止排查流程。

图解 23 按图从左向右调试。一个模块失败时先保留已通过的配置，排查该级；所有级别通过才做整机功能演示。

### 步骤 198 先生成最小程序

第一版只开 USART1、GPIO 安全输出、SysTick，先不启动电机与舵机定时器。Generate Code 后用 IDE 的 File → Import → Existing Projects into Workspace 导入生成目录；也可使用工具的 Open Project。

□ 检查 能够 Build，错误数为 0；产生 ELF 文件。

未通过时 确认导入的是生成工程根目录，不是仅 Core 子文件夹。重复定义 HAL 函数时清掉手工混入的另一套库。

### 步骤 199 连接 SWD

关闭整机电源，拔掉电机、舵机和语音功率支路。下载器 SWDIO→PA13、SWCLK→PA14、GND→GND；有 NRST 则连接 NRST。目标板按本手册独立供电；下载器 VTref 若存在应按该下载器说明接目标 3.3 V 作为参考。

□ 检查 核心板上电后 3.3 V 正常，共地可靠；下载器能读到目标电压与芯片信息。

未通过时 不要把下载器供电输出与板上稳压输出并联。仿真器的 3.3 V 脚究竟是输出还是参考必须按型号核对。

### 步骤 200 烧录和运行

IDE Debug Configurations 选择实际下载器、SWD，初始频率 400 kHz；下载最小程序，执行 Resume。CubeProgrammer 也可用 SWD 连接后烧写 ELF/HEX。只有裸 BIN 文件才需要手填 Flash 起始地址 0x08000000。

□ 检查 断开调试后重新上电，串口每秒出现一次 BOOT_OK/HEARTBEAT；执行输出保持关闭。

未通过时 Cannot connect 时先查供电/共地/两根 SWD 是否反接，再尝试 Connect under reset 并连接 NRST；不要先改 Option Bytes。

### 步骤 201 建立串口观察口

CP2102 的 TXD→PA10、RXD→PA9、GND→GND，USB 串口模块 VCC 不接；终端选实际 COM 口、115200、8 数据位、无校验、1 停止位、无流控，发送行尾 CRLF。

□ 检查 每次按核心板 Reset 都出现一次版本号和启动原因。

未通过时 乱码先查波特率及晶振配置。无内容先查 TX/RX 交叉、COM 被占用和核心板是否实际运行。

### 步骤 202 保存基线

保存工程和 .ioc；建立 test_log.csv，写固件版本、芯片、下载器、串口口号、时钟来源、3.3 V 实测值及首次测试结果。

□ 检查 以后出现故障可以恢复到这个仅核心板工作的版本。

未通过时 不要把调试器保持连接时的成功当成独立上电成功；至少拔掉调试器重启 3 次。

改代码应放在 CubeMX 的 USER CODE 区间，或独立 App/BSP 文件；重新生成前提交或备份。点击 Generate Code 只生成外设初始化，不会自动实现 RFID、积分、循迹或菜单。

# 38 时钟 定时器 总线和中断的精确配置

以下值按核心板真实 HSE=8 MHz 设计。若实物晶振不是 8 MHz，先按其频率修改 PLL，使结果满足表内总线和定时器时钟；不能用错误 HSE 数值凑出界面中的 72 MHz。

资源 | CubeMX / 程序配置 | 核验方法
时钟 | HSE 8 MHz；PLL×9；SYSCLK/HCLK=72 MHz；APB1=/2→36 MHz；APB2=/1→72 MHz；ADC=/6→12 MHz | 用定时输出或已知串口时序验证；HSE 失败显示时钟故障，禁止运动
GPIO 安全初值 | PA4/PA15 两片选先高；PB5 电机请求低；TRIG 低；蜂鸣器按实际不响电平；PWM 比较寄存器为 0 | 上电和 Reset 时无异常脉冲导致动作
TIM1 电机 PWM | CH1 PA8、CH4 PA11；72 MHz；PSC=0、ARR=3599；PWM1，高有效；只开 CH1/CH4；确保 MOE 正确 | 20 kHz；CCR 0 停止。输入 25% 时 CCR≈900
TIM2 舵机 | CH1 PA0；定时器时钟72 MHz；PSC=71、ARR=19999；1 µs/计数，周期20 ms | 50 Hz；CCR=1500 对应1.5 ms，仅在拆连杆空载标定阶段启用
TIM3 微秒计时 | 内部时钟；PSC=71、ARR=65535；自由运行，不占用引脚；同时供超声及DHT边沿取时戳 | 16位每65.536 ms回绕；超声25 ms超时以内及DHT帧内，用(uint16_t)(end-start)算差
TIM4 蜂鸣器 | 无源模块用 CH4 PB9：PSC=71、ARR=499、CCR4=250；有源模块 PB9 改 GPIO | 无源得到约2 kHz；只开CH4，不占I²C用的PB6/PB7
I²C1 | PB6=SCL、PB7=SDA，100 kHz，开漏，地址用7位标注 | OLED、MPU6050、MCP23017轮流接入验证；HAL调用地址参数为addr7<<1
SPI1 | PA5/PA6/PA7；Master、Full Duplex、8 bit、MSB first、Mode0、软件NSS；分频64=1.125 MHz | PA4 RC522 CS与PA15 FLASH CS不同时拉低
USART1 | PA9 TX / PA10 RX，115200 8N1，无流控 | 电脑维护、查询和CSV导出
USART2 | PA2 TX / PA3 RX，初始9600 8N1，以HC-05实际数据模式值为准 | Android蓝牙；AT模式波特率不直接当数据模式值
USART3 | 仅使能TX，PB10，9600 8N1；PB11必须保留DHT11 GPIO | 不能把PB11自动分配成USART3_RX
ADC1 | PA1 IN1电池；PB0 IN8光敏AO；12 bit右对齐；长采样239.5周期；上电校准ADC | 两通道顺序转换或扫描DMA；PB0若只接DO则从ADC序列删除
EXTI | PB1超声双边沿；PB3/PB4编码器双边沿；PB11配置EXTI11双边沿接DHT；PB12碰撞、PB13急停故障按实际电平触发；PB14闭盖可轮询 | PA11只作TIM1 PWM、不启EXTI，所以不与PB11争EXTI11；EXTI15_10先处理停止，再处理DHT；逐项清挂起
SysTick / IWDG | 1 ms时间基；IWDG在主循环和停止输入通过验证后再启用，目标约0.5 s并实测 | LSI误差使实际超时不同；只在主循环健康检查后喂狗，不在中断中无条件喂

STM32F103 的定时器时钟在 APB 分频不为 1 时通常为对应 PCLK 的 2 倍，所以 TIM2/3/4 在本配置下仍是 72 MHz。输出频率=f_timer/[(PSC+1)×(ARR+1)]。配置依据 ST RM0008 和 F103C8 数据手册；具体引脚和电气数值以所用封装资料为准。

### 步骤 203 逐项占用引脚

按本表依次启用外设，并给GPIO填写有意义的 User Label。PA12 配投放输入，PB11 配DHT，PB15配TRIG；PC13至PC15保留。

□ 检查 引脚图无红色冲突；PA13/14始终保留SWD。

未通过时 不要为了自动消除冲突而让CubeMX改到其他引脚；先检查所选UART方向和定时器通道。

### 步骤 204 配置输入极性

先不让输入触发动作，仅每100 ms打印 raw：急停、碰撞、盖闭合、对射、障碍、三个循迹位。逐一人工切换并记录0/1含义。

□ 检查 每个输入都有“原始低/高→业务真/假”的唯一转换。

未通过时 实际模块可能低有效或高有效，统一在bsp_input中翻转，不在各业务函数中零散补反相。

上下两种波形对比：舵机50Hz中位1.5ms高电平、20ms周期；电机20kHz周期50微秒，图示50%仅为解释。

图解 24 先核对定时器和引脚，再核对实际波形。SG90是20 ms周期、约1.5 ms中位脉冲；TB6612电机PWM周期是50 µs，不能互接。

### 步骤 205 检查定时器

用逻辑分析仪或示波器观察无负载输出；没有仪器时先通过空载舵机和低PWM架空电机验证，同时保留频率实测未完成标记。

□ 检查 50 Hz舵机周期与20 kHz电机PWM符合目标，Duty=0输出停止。

未通过时 若舵机抖动、蜂鸣器音调约差一倍，应复核APB倍频与PSC/ARR，不能靠改机械连杆抵消时序错误。

# 39 建立不会拖延停车的主循环

先建立任务框架，再依次挂接模块。所有等待都有截止时刻；界面刷新、播音、写 FLASH、超声和 DHT11 都不能占住主循环。停止输入可直接关 MCU 的 PWM 和 STBY 请求，不依赖 I²C 成功。

文件/模块 | 必须实现的职责 | 最小对外接口示例
bsp_board.c | 针脚、极性、安全输出、SWD remap | board_safe_init(), input_sample()
bsp_mcp.c / bsp_bus.c | MCP影子寄存器、总线短事务、失败超时 | mcp_set_mask(mask,value), bus_service()
drv_rc522.c / drv_nor.c | 读卡状态机；SPI NOR页写/擦除/BUSY轮询 | rfid_step(), nor_step()
storage.c | 序列化、CRC、快照、日志、掉电恢复 | txn_begin(), txn_poll(), storage_recover()
app_deposit.c | 授权、开盖、挡光、单次计分、关盖 | deposit_step(now), deposit_cancel(reason)
app_motion.c / app_safety.c | 运动互锁、速度限幅、故障锁存 | motor_request(), motor_force_off(), estop_active()
app_ui.c / app_serial.c | 菜单、串口解析、蓝牙心跳、导出 | ui_step(), serial_parse_step()
app_sensors.c / app_audio.c | 倾角/桶满/电压/环境处理，声音队列 | sensor_step(), audio_enqueue(event)

下列为执行顺序伪代码，不是可直接编译的 main.c：while(1){ now=millis(); safety_fast_check(); if(fault_latched) motor_force_off(); input_fast_step(now); command_expiry_check(now); run_due_10ms_tasks(now); run_due_20ms_tasks(now); rfid_step(now); deposit_step(now); storage_step(now); ui_one_chunk(now); serial_one_chunk(now); audio_step(now); watchdog_feed_if_all_tasks_progress(); }

任务 | 周期/单步限制 | 超时后处理
直接安全输入/对射 | 1 ms；中断只停输出和置标志 | 安全轮询迟到锁运动
电机/循迹/MCP输入 | 10 ms；短读GPIOB | MCP数据年龄>50 ms锁运动
MPU6050 | 20 ms；读取6字节加速度或固定短帧 | 数据年龄>200 ms时禁止继续移动
RFID | 30 ms触发一个阶段；等待响应分步推进 | 单次通信超时结束该次尝试
超声/电压 | 100 ms；超声只在静止和闭盖稳定后测 | 超声25 ms无有效回波算一次失败
OLED | 100—200 ms更新；每次最多16字节数据块 | 超过短事务超时退出，保留最近帧
FLASH | 事件驱动；一次不超过一页数据传输 | BUSY按实际器件最长时间加裕量截止，不忙等
温湿度 | 停车每3 s；定时/边沿状态机 | 每次协议超时后释放总线
串口/语音 | IRQ环形缓冲；主循环每次解析一行/发送小块 | 缓冲溢出拒绝该帧，不能覆盖旧运动命令

### 步骤 206 固定数组和队列

先分配64用户表、1 KB显示缓冲、256 B NOR页缓冲、两路接收环形队列、事件队列；不用malloc。RX中断只收字节，主循环解析。

□ 检查 链接map确认Flash≤64 KB、SRAM≤20 KB；目标程序≤56 KB、静态与堆栈合计留足余量。

未通过时 超量时删调试长字符串/完整中文字库，使用少量字模；不要改链接脚本假装C8有128 KB。

### 步骤 207 定义安全入口

实现motor_force_off()只写CCR1=0、CCR4=0和PB5请求低；中断可调用且不做printf、I²C、FLASH。estop_active()由电气章节确定的输入极性归一。

□ 检查 急停或碰撞中断发生时，无论主程序在哪个界面，驱动请求立刻为低。

未通过时 若函数要等MCP写成功才停机，结构错误；改为直接MCU输出停机。

### 步骤 208 实现故障锁

故障位图分别保存急停、碰撞、倾角、低电、盖未闭、传感器超时、总线故障；复位动作只在触发源已恢复且用户确认后清锁。

□ 检查 松开按钮/移走障碍/蓝牙重连均不自动起步。

未通过时 删除“条件恢复则回原PWM”的逻辑；恢复后必须重新发一条运动命令。

### 步骤 209 检查最长阻塞

用调试计数器统计主循环最长间隔；同时导出记录、翻页和播音，再按停止按钮。

□ 检查 轮询目标1—2 ms，所有长操作被拆开；电气停使能路径不依赖测得的主循环速度。

未通过时 整屏OLED约数十毫秒、DHT长延时、FLASH等待循环、串口同步打印均要分步处理。

### 步骤 210 最后启用看门狗

全部关键任务提交自己的进展标志，主循环确认一个窗口内均运行才喂狗；启动自检长操作也分步。制造一个仅开发测试使用的死循环验证复位。

□ 检查 卡死时复位，重启进入静止自检且打印WATCHDOG原因。

未通过时 不要在SysTick中无条件喂狗；不要在实际地面运动时故意注入死循环。

# 40 MCP23017 与三种 I²C 模块单测

只接逻辑电源，电机与舵机功率线仍断开。MCP 地址按 A0/A1/A2 全接地为 0x20。GPA7、GPB7 本版固定作为未用低电平输出，避免把新版资料中受限的引脚用作输入。

寄存器，BANK=0 | 写入值/用途 | 验证要点
IOCON 0x0A | BANK=0、SEQOP=0，其他位按不使用中断输出配置为0 | 先硬件复位，再按BANK=0地址操作
OLATA 0x14 / OLATB 0x15 | 先写0x00 / 0x00 | 先准备输出锁存值，再把引脚切输出
IODIRA 0x00 / IODIRB 0x01 | 0x40 / 0x7F | A6输入；B0—B6输入；A7/B7输出
GPPUA 0x0C / GPPUB 0x0D | 按输入实际输出类型设置；B3—B6机械/开集输入可用上拉，通常B口可初始化0x7F | 推挽模块不依赖内部弱上拉；外部电平以3.3 V为准
GPIOA 0x12 / GPIOB 0x13 | 读取输入样本 | 输入读取不作为输出新值的来源
OLATA影子变量 | 低4位方向、bit4 RC522_RST、bit5照明；bit6不驱动、bit7固定0 | 所有调用通过mask修改，保护其他已存在输出位

### 步骤 211 只接MCP

扫描0x08—0x77地址只在静止诊断模式进行；找到0x20后写入上表，再回读IODIR/OLAT。MCP的RESET独立上拉，不随MCU的NRST复位；每次MCU启动先PB5=0，再明确重写输出和方向配置。需要兼容未知旧BANK状态时，先向地址0x05写0，再向0x0A写0使BANK归一到0，然后写OLAT与IODIR。

□ 检查 回读分别为0x40、0x7F；电机方向位为0，照明关闭；单独复位MCU也不会恢复旧电机命令。

未通过时 无ACK先测MCP电源、RESET和地址脚，检查SDA/SCL是否接反、是否被外接模块拉到5 V。地址0x05在BANK=0时为GPINTENB，写0只关闭本版未使用的B口中断。

### 步骤 212 逐个输入测试

暂时通过10 kΩ上拉或实际模块切换GPB0—GPB6，打印十六进制GPIOB。按MODE、BACK、编码器开关时确认相应位变化。

□ 检查 只有预定输入位变化；A7/B7不接开关或传感器。

未通过时 多个位一起变化时查短路与排针方向；不要靠软件屏蔽掩盖硬件错误。

### 步骤 213 输出不互相覆盖

先令RC522_RST位保持高，再开关GPA5照明，同时改变低4位电机方向，但PB5一直低。

□ 检查 每次OLATA回读中RST持续为1；照明与方向不互相跳变。

未通过时 修复“整字节写常量”的驱动：shadow=(shadow&~mask)|(value&mask)，总线事务串行化。

### 步骤 214 加入OLED

记录模块控制器型号和地址，按I²C 128×64 OLED实际驱动初始化；常见地址0x3C或0x3D，以扫描为准。显示四行ASCII：BOOT、MODE、VBAT、FAULT。

□ 检查 字符稳定不颠倒，反复刷新不影响1 ms任务。

未通过时 地址有ACK但屏幕空白，应查SSD1306/SH1106型号、列偏移和初始化指令；不要只换地址。

### 步骤 215 加入MPU6050

AD0按模块接法决定0x68或0x69，读WHO_AM_I 0x75应按实物资料识别；典型MPU6050返回0x68。退出休眠，设置±2 g，读取加速度。

□ 检查 平放时一轴约±1 g，另两轴接近0；转动模块读数跟随。

未通过时 模块地址0x69不意味着WHO_AM_I也必须0x69；若全0先检查休眠位与读寄存器地址。

### 步骤 216 总线故障测试

断电后拔下OLED，重新上电；随后分别只留MCP、只留MPU对比日志。软件遇单次错误退出事务，连续错误进入相应降级。

□ 检查 MCP失败禁止动作；OLED失败可以串口诊断；断线不让主循环永久等待。

未通过时 不在带电时随意插拔模块；如果SDA卡低，停止动作，限次执行总线恢复或提示重启，不能无限重试。

# 41 RC522 与 SPI FLASH 先分别测 再共总线

RC522 模块标成 SDA 的引脚在本方案 SPI 模式中是片选，不接 I²C SDA。RC522 与 FLASH 用同一组三根 SPI 线，两条独立片选；先每次只接一个模块。

### 步骤 217 RC522寄存器读写

保持FLASH_CS高，MCP GPA4复位RC522后释放。按MFRC522资料设置收发器并读VersionReg；连续读取20次记录原始值。

□ 检查 版本值稳定且不是始终0x00/0xFF，复位后寄存器可重复读写。

未通过时 检查3.3 V、GND、SCK、MOSI/MISO、CS；未知兼容芯片版本不能只凭值不同就断言坏，也不能跳过收发自检。

### 步骤 218 读UID

让一张兼容测试卡从读卡器正前方缓慢靠近，完成寻卡、防冲突、选卡，打印UID长度和所有字节；移开再换第二张。

□ 检查 每张卡UID稳定，两张卡能区分；支持的UID长度由驱动完整处理。

未通过时 4/7字节UID不能统一截成4字节。先把卡与天线平行、远离金属与电机干扰，再查天线和协议。

### 步骤 219 贴卡去重

建立present_uid和present锁，离场检测连续500 ms才解锁。读卡流程进入HALT后要使用合适的唤醒/再次寻卡判断，不能因HALT卡不响应REQA就错误认定已移开。

□ 检查 卡连续贴住10 s只出现一个NEW_CARD事件。

未通过时 检查RFID层状态而非仅靠延时锁；同一人抖动卡片但未明显离场不能生成新会话。

### 步骤 220 FLASH识别

保持RC522_CS高，FLASH_CS拉低后读JEDEC ID，打印厂家/类型/容量字节；查实际芯片资料，把容量、页尺寸、扇区尺寸、写/擦命令加入允许列表。

□ 检查 ID稳定且与芯片丝印一致。

未通过时 未知ID只允许读身份，不擦除；不能默认现有模块就是W25Q32。全FF先查CS与DO/DI。

### 步骤 221 FLASH擦写回读

仅在确认可覆盖的专用TEST扇区测试。先备份已有内容，按已识别型号写使能、擦除并分步轮询BUSY；写00/55/AA/递增字节，回读比较CRC。

□ 检查 擦后全FF；写后逐字节一致；跨页写被驱动切分，未越过芯片容量。

未通过时 读回页尾绕回说明跨页未切分。超时/写保护/供电错误需处理，不要无限重发擦除。

### 步骤 222 SPI共享验证

两模块一起接回，程序交替读RC522版本/UID与FLASH测试区，各重复100轮。事务结束立即拉高对应CS。

□ 检查 读卡稳定，FLASH CRC一致；两片选从不同时低。

未通过时 单独正常并联失败先查未选中的模块是否释放MISO、两CS是否上拉、导线长度和共地；不要同时启动两段HAL传输。

MFRC522 的寻卡和 MIFARE 操作依据 NXP 官方资料；芯片本身与便宜模块的电源、天线和兼容性不能混为一谈。SPI 1.125 MHz 是为短杜邦线调试设定的保守起点，不是本项目已测得的最高速度。

# 42 A1 A2 A5 A7 用户识别 注册 查询和权限

先在舵机和电机仍未接功率时把账户逻辑做完。用三张卡分别标记“管理员”“用户1”“读写实验”；第三张可兼作第二普通测试账户，但卡片块4实验不修改账户账本。需要同时保留更多用户实卡时再补卡。

### 步骤 223 定义用户表

固定64槽，保存user_id、UID长度、最多10字节UID、角色、状态、积分、累计有效投放次数；状态至少ACTIVE/LOST/DELETED。序列化独立于C结构体填充。

□ 检查 空表可遍历；比较UID时同时比较长度和完整字节。

未通过时 重复UID不得悄悄新建第二账户；输入错误不能读越界。

### 步骤 224 初始化首位管理员

全新存储在明确“首次初始化”页面，同时按MODE+BACK满3 s，显示确认；刷目标卡，写一条注册管理员事务，提交成功才显示ADMIN READY。

□ 检查 关机重启，管理员角色仍存在；普通重新上电不进入初始化。

未通过时 如果两快照损坏且有历史数据，进入存储故障而不是自动当作空机；保留恢复入口。

### 步骤 225 注册普通用户

刷管理员卡进入管理，选择REGISTER，刷一张陌生卡，显示完整UID与拟分配ID，确认后提交；成功才返回用户页。

□ 检查 同卡再注册提示ALREADY_REGISTERED；余额初值0。

未通过时 不能在收到UID的同一瞬间直接提交，避免拿错卡；第二张卡到来先取消或明确重新确认。

### 步骤 226 挂失与注销

管理员选择目标用户，再选择挂失或注销，二次确认并持久化；挂失拒绝积分和兑换，注销保留历史用户ID用于旧日志。

□ 检查 旧卡再刷显示LOST/DELETED；历史记录仍能对应原user_id。

未通过时 不要从数组删除导致其后ID全移位；不允许注销最后一位管理员。

### 步骤 227 积分查询

MODE切QUERY后刷普通用户卡，显示ID、余额、累计次数和状态；5 s后返回或BACK退出。

□ 检查 查询前后日志seq、余额、舵机状态均不变。

未通过时 若查询也开盖，说明刷卡事件直接连了舵机；改为由当前业务状态分发。

### 步骤 228 管理员会话

普通卡只进入普通业务；管理员认证后60 s无操作退出管理。恢复丢失管理员卡需本机组合键及确认，保留既有普通账户与余额。

□ 检查 认证超时后再点注册需要重新刷管理员卡。

未通过时 不要以“进入过一次菜单”永久授权；也不把UID名单描述成抗复制安全认证。

### 步骤 229 容量和异常测试

使用测试桩构造64个不同UID填满；检查第65个被拒绝。用同UID、空UID、错误UID长度、挂失卡、注销卡分别测试；最后恢复正式实验表。

□ 检查 所有拒绝都有提示，无数组溢出，重启结果一致。

未通过时 测试桩在最终演示编译中关闭，避免串口任意造卡或改余额。

# 43 A4 把积分做成可恢复的持久事务

下列存储布局是项目自定义方案，适用于确认具有 256 B 页、4 KB 擦除扇区的 SPI NOR；其他器件必须改参数。用户卡只作身份和独立读写实验，本地 FLASH 账本是积分的唯一权威来源。

区域 | 参考地址/大小 | 内容
快照A | 0x000000，4 KB | 格式版本、代数、last_seq、64用户、参数、CRC、提交标记
快照B | 0x001000，4 KB | 与A同格式，交替更新；未完成新快照前保留旧有效快照
环形日志 | 0x002000—0x011FFF，16个4 KB扇区 | 每扇区64 B头+63×64 B事务；原始槽数1008，预擦除保留扇区会减少可保留历史条数
专用TEST | 例如0x012000一个4 KB扇区，仅实际容量足够时 | 独立擦写自检；绝不覆盖快照和日志

事务字节偏移 | 字段 | 约束
0—3 / 4—7 / 8—11 | magic / seq / txid | 小端；全局序号；同一动作只分配一次txid
12—13 / 14 / 15 | user_id / type / flags | type含REGISTER、STATUS、DEPOSIT、REDEEM、CONFIG、BOOT
16—19 / 20—23 / 24—27 | delta / balance_after / count_after | 有符号增量；余额非负且≤999999
28—31 / 32—35 | boot_id / uptime_ms | 只代表启动编号与本次运行时长，不是日期时间
36—39 / 40—55 | UID摘要 / 附加字段16 B | 注册附加字段放UID长度、完整UID、角色、状态；摘要不能替代UID
56—59 / 60—63 | CRC32 / commit | CRC覆盖前56字节；commit最后单独写，参考值0xA55A5AA5

### 步骤 230 编写序列化和CRC

使用明确的put_u16_le/put_u32_le逐字节编码，不直接memcpy整个C结构体。实现CRC-32/ISO-HDLC：反射多项式0xEDB88320、初值0xFFFFFFFF、结果异或0xFFFFFFFF；输入123456789应为0xCBF43926。

□ 检查 PC或单元测试与MCU同一数据CRC一致；记录大小固定64 B。

未通过时 不要直接拿STM32硬件CRC默认算法代替反射CRC而不做转换；算法与字节顺序必须固定在格式版本中。

### 步骤 231 实现提交状态机

ALLOC槽→PROGRAM_BODY前60 B→等待BUSY清→READ_VERIFY正文→PROGRAM_COMMIT 4 B→等待BUSY清→READ_VERIFY整条→APPLY_RAM→SUCCESS。每步返回主循环；重入请求返回BUSY。

□ 检查 成功提示只出现在最后一步；写入失败不改变RAM余额。

未通过时 未提交槽即使正文完整也跳过，不在原槽拼补成新事务；驱动写超时后读回判断，不能先重复加分。

### 步骤 232 执行双快照

仅停车且无会话时，将当前用户表、参数、last_seq写入另一已擦除快照区；正文校验后单独提交，再回读确认。此后才允许擦掉已被新快照包含的旧日志。

□ 检查 任意时刻至少一份可恢复快照存在。

未通过时 不能先擦当前唯一有效快照；不能只凭擦写函数返回OK便回收原日志。

### 步骤 233 开机恢复

校验A/B格式、代数、长度、CRC和提交字；选择最新有效者。扫描有效扇区，按seq重放大于last_seq且完整提交的事务，校验状态和余额；重复txid/seq不可重复应用。

□ 检查 重启账户等于最后已提交交易，残缺尾部不生效。

未通过时 无有效快照但区域不全FF时报告STORAGE_CORRUPT；不静默清零。序号冲突或不一致应停在维护恢复界面。

### 步骤 234 扩展和回收

每256笔事务或日志余量低时安排快照，预留一个可写扇区；写事务期间不做整片擦除。记录区覆盖前只回收已纳入快照的旧事务，并保留环形扇区代数。

□ 检查 连续运行超过1008笔后余额仍准确，最近日志按可用容量循环保留。

未通过时 若需要保留所有历史，先串口导出；有限FLASH不能承诺无限历史。seq/txid接近上限时维护归档，禁止静默回绕。

三个存储示意栏对比旧有效记录、中途掉电导致新记录不完整或未提交、完整新记录含有效CRC及最后写入的提交标志；重启余额分别10、10、11。

图解 25 先保存测试前余额和日志，再在手册规定的检查点切总电源。重启只能得到旧完整状态10或本次完整状态11；有CRC但缺提交字也不能入账。

### 步骤 235 注入断电检查点

编译仅测试使用的断点：提交前、正文写后、提交字写后、RAM更新前、新快照正文后、新快照提交后。轮子架空、舵机支路断电，在串口提示对应检查点时关闭总开关，再恢复供电。

□ 检查 每点至少3次：结果只能是上一完整状态或本次完整状态；无半扣分、双加分、账户丢失。

未通过时 若失败，先保存坏FLASH镜像和日志，再修恢复顺序；不要靠格式化掩盖。测试结束关闭故障注入编译开关。

# 44 A3 A6 A8 A9 计分 读写卡 排行榜和兑换

软件先用“模拟投放事件”验证事务，然后接真实对射。模拟入口只允许台架测试版本，正式演示关闭。固定奖励是软件演示，不包含发券或实物售货机构。

### 步骤 236 固定分值积分

默认每个已授权且完成有效经过检测的会话+1分，累计次数+1。检查余额<999999后建立DEPOSIT事务，保存当前user_id和唯一txid。

□ 检查 一次有效会话仅一条DEPOSIT；无投放不增加任何数值。

未通过时 计分触发只能来自会话状态机，不能由每轮传感器低电平直接执行++。

### 步骤 237 显示最近记录

读取最新10条完整事务，按seq从新到旧显示：序号、用户ID、类型、分值、结果。一次读取一小块，翻页不占满RAM。

□ 检查 屏幕与导出CSV相同。

未通过时 没有RTC不显示伪造日期；重启后uptime归零要与boot_id一起解释。

### 步骤 238 排行榜

复制最多64个用户的ID与余额到小型排序数组，余额降序，同分ID升序，显示前5名；挂失/注销是否显示应固定，本版仅ACTIVE普通用户参与。

□ 检查 建立余额3、1、3的用户，显示顺序按规则一致。

未通过时 排序不要改变原账户表槽位；修改积分后标记榜单需要重算。

### 步骤 239 兑换事务

用户刷卡后选5分贴纸券或10分体验券，显示所需和余额，再确认。确认后锁定该txid，完成一笔REDEEM负增量事务再显示成功。

□ 检查 余额4拒绝5分；余额5兑换后0；连续确认不会扣两次。

未通过时 若超时或重启，不凭按钮仍按下自动重发；用已提交txid判断结果。

### 步骤 240 卡片读写准备

管理员进入CARD_TEST，只使用已知密钥的专用MIFARE Classic 1K实验卡；读出并保存第1扇区普通数据块4的原16字节。块0和扇区尾块7禁写。

□ 检查 能显示认证通过、原数据16字节及卡UID。

未通过时 认证失败只提示密钥/卡型错误；不循环尝试密钥，不改访问控制字。

### 步骤 241 写入并回读

向块4写16字节测试内容，例如4字节SBIN、4字节实验序号、4字节测试值、4字节CRC；读取同块逐字节比较；结束认证会话并释放卡。

□ 检查 写前/写后/回读值清楚；一致才显示PASS。

未通过时 中途移开卡显示FAIL/UNKNOWN，再次刷卡读回确认；不得把卡上测试值同步成账户余额。

### 步骤 242 综合账本测试

两名用户各投放若干次，查询、排行、兑换、导出；重复重启后逐项核对。卡片块4读写前后也检查账户余额不变。

□ 检查 账本、菜单与卡片实验相互独立，无误加分。

未通过时 将失败分为RFID通信、业务状态、持久化三个层面，避免通过“重刷卡多试几次”掩盖事务错误。

# 45 盖板与真实投放 B1 B2 B3 B4 B8 逐步调试

必须已经完成机械章节的2 mm泡沫PVC轻盖、50 mm连杆和20 mm摇臂半径检查。活动总成称量目标≤40 g、上限45 g；空载舵机先标定，再连接盖板。手离开盖口才进行关盖试验。

会话状态 | 进入动作/离开条件 | 异常处理
IDLE/WAIT_CARD | 停车、无故障、未满且传感器有效；接受有效卡 | 不满足条件明确显示原因
OPENING | 建立user/txid；1.2 s渐变到开盖脉宽 | 停止锁生效时不继续改变目标；无反馈不能称已确认全开
WAIT_ITEM | 光束先连续畅通200 ms，再等待最多10 s | 超时且畅通→无积分退出；持续挡光保持开盖提示清障
ITEM_BLOCKED | 遮挡≥30 ms且≤2 s，再畅通≥100 ms | 过短忽略；过长标为遮挡异常不结算
COMMITTING | 本会话仅调用一次txn_begin；等待持久提交 | 拒绝新刷卡/确认/运动；安全停止仍有效
CLOSE_DELAY | 完成后2 s，关盖前复核光束畅通 | 挡光就延迟并提示，不等于盖边防夹
CLOSING | 渐变至闭盖标定位置，等PB14稳定闭合 | 超过2 s未闭合→盖故障，禁止行驶
DONE | 显示结果，清会话，等待卡离场 | 不能由尚未移开的卡重新开一笔

### 步骤 243 空载舵机中位

卸下连杆或舵盘负载；只接舵机独立5 V和共地。输出1500 µs，观察趋向位置。用每次20 µs的小步在中心附近试探，记录可用脉宽与转动方向。

□ 检查 舵机到位后不持续剧烈抖动或发热；电源不使MCU复位。

未通过时 不要先扫500—2500 µs全范围。位置舵机若持续旋转，核对是否买成连续旋转型。

### 步骤 244 机械闭盖标定

保持已确定的安全脉宽，按机械图安装舵盘/连杆；手扶轻盖，逐步调到刚好闭合，记录P_CLOSE。闭合开关应在盖就位时动作，舵机不再强压。

□ 检查 PB14闭合状态稳定100 ms；盖边EVA仅轻接触。

未通过时 若闭合开关触发需要舵机硬顶，应移动开关或调整拉杆；不能用更大PWM强压。

### 步骤 245 开盖标定

从闭盖向开盖方向以小步移动，达到约70°盖开角时记录P_OPEN；确认连杆不越过死点、不刮桶壁。程序插值1.2 s到位。

□ 检查 P_CLOSE与P_OPEN都在实测无卡滞区间；连续20次无掉电和结构碰撞。

未通过时 出现嗡鸣/转不动先断执行电源，查质量、铰链、共面和连杆；不要仅加大动作时间。

### 步骤 246 对射原始量

盖打开且电机禁用；记录光束畅通/遮挡电平；纸团穿过一次时记录1 ms采样下的遮挡时长。对浅色、深色物体各10次。

□ 检查 能看到BLOCK开始和CLEAR结束，底层事件不直接计分。

未通过时 对不准先调整收发头固定和遮光；强光扰动先遮挡环境光而非降低所有阈值。

八个状态用折返箭头相连，从停车待卡、锁定身份、开盖、光束准备到完整经过、FLASH提交、成功提示和闭盖确认；异常不加分。

图解 26 跟随箭头逐步观察屏幕和串口。正文规定FLASH事务回读确认后才更新积分并提示成功，随后延时关盖；关盖开关确认前不得移动。

### 步骤 247 接入投放会话

有效刷卡→开盖→投放一件→事务提交→显示+1→延迟关盖；不投放等待10 s退出。持续挡光和遮挡后未放开都不提交。

□ 检查 操作链可重复10次，积分恰好增加有效次数。

未通过时 中途换卡必须拒绝，不能把当前会话user_id换给后来者；传感器手部遮挡可能形成经过事件，记录其局限。

卡片在场、投放光束和事务三个时序轨迹；首次完整遮挡后只提交一次，随后重复遮挡不形成第二笔积分。

图解 27 先观察CLEAR至少200 ms，再观察一次30 ms至2 s的BLOCK及至少100 ms的CLEAR。成功后在同一会话内再晃动物体，余额应保持不再增加。

### 步骤 248 防重复测试

同一张卡连续贴住、投放物在光束处晃动、连续放两件、提交中按确认，各重复测试；单会话最多+1。

□ 检查 日志没有同txid两条有效扣加分。

未通过时 将去重放在会话和事务两层；只在RFID层延时不能解决传感器重复触发。

### 步骤 249 便捷模式

选择CONVENIENCE；独立靠近传感器持续有效300 ms才开盖，离开2 s且光束畅通后关盖。只停车时处理。

□ 检查 未刷卡便捷开盖不计积分与次数；移动中挥手不动作。

未通过时 前方避障与靠近检测安装目标不同，不能把单个前避障输出同时当开盖请求。

### 步骤 250 维护与取内胆

管理员进入MAINTENANCE，PWM=0、STBY请求低、暂停计分，命令开盖。实际取出内胆前关总开关、扶盖、按机械章节快拆连杆和测距横梁。

□ 检查 维护时刷卡、遮挡、蓝牙命令都不加分不移动；断电才能伸手拆装。

未通过时 软件维护保持开盖并不等于执行电源断开；不要带电拔舵机插头或强行掰舵盘。

### 步骤 251 维护退出

装回1 mm PP内胆和新垃圾袋，重新固定测距横梁、连杆；检查无干涉后上电自检。用户确认退出，检测闭盖及桶满状态重新标定。

□ 检查 盖闭合有效且传感器健康后才允许运动。

未通过时 测距或闭盖未恢复时保留维护/故障页面，不能用清标志强制进入行驶。

# 46 B5 桶满检测 按 121 mm 新内胆重新标定

最新内胆外高约121 mm，明显低于旧方案165 mm内桶。本节替代原“45 mm判满、65 mm清满”默认值：判满高度必须低于当前垃圾袋有效口沿。以下是依据当前安装高度的计算起点，最终用实物纸板标定。

定义地面到超声探头声学参考面的高度H_sensor，垃圾袋真正固定口沿高度H_rim，期望垃圾最高面H_limit=H_rim−15 mm。判满距离D_full=H_sensor−H_limit。示例：平台顶115 mm、内胆高121 mm、袋口大致位于236 mm、探头参考面280 mm，则H_limit≈221 mm、几何距离约59 mm。首次候选阈值统一为65 mm判满、85 mm清满，给该例稍留提前提示余量；它不是最终设定。必须按实物袋口与平纸板读数确定，袋口折下或支架高度改变时重新量尺标定。

### 步骤 252 超声空载测试

电机断电，确认ECHO分压后，PB15给10 µs高脉冲；PB1双边沿用TIM3记上升和下降时刻，单次等待最多25 ms，触发间隔100 ms。

□ 检查 平纸板放100、150、200 mm处，读数随位置单调变化。

未通过时 全超时先查TRIG、分压和共地；固定极小值查是否测到桶沿/横梁/袋边，不能把超时当0 mm满桶。

### 步骤 253 空桶基准

安装真实1 mm PP内胆和30×40 cm袋，袋底贴底、口沿外翻固定；盖闭合、停车500 ms后采集30点，去掉无效值，记录中值D_empty和波动范围。

□ 检查 探头看到袋底而非悬空袋褶；示例空距仍约160 mm量级，以实测为准。

未通过时 袋底悬空或口沿鼓起时先整理机械装配，不能纯软件补偿一个不稳定反射面。

超声探头位于121mm内胆上方，真实袋口下15mm放满位纸板，再下降20mm测清满点；旁注65和85mm候选需实测。

图解 28 图中红线用于判满标定，绿线用于清满回差。先把实际垃圾袋固定好，再拿平纸板测量；65/85 mm只是候选，填写实际校准结果。

### 步骤 254 标定判满高度

在距实际袋口下方15 mm的位置放水平纸板，采30点记录D_limit；把D_full设为能可靠提前判满的值。再将板降低20 mm，记录清满回差点。

□ 检查 判满时纸板尚未超过袋口，投放光束也没有被垃圾面堵住。

未通过时 若传感器盲区或桶壁反射导致无法区分两高度，调整横梁位置/探头朝向后重测，不能直接缩小到不可信距离。

### 步骤 255 滤波与状态

每次有效测量进入5点中值；连续5次中值≤D_full置FULL；维护清桶后连续5次≥D_clear才允许清除FULL。移动、开盖过程不更新满桶判定。

□ 检查 插入/拿走一张纸板不会因一帧抖动切换状态。

未通过时 无效回波不入中值；连续10次无回波显示FULL_UNKNOWN并禁止新自动投放，区别于确认满桶。

### 步骤 256 功能验收

测试空、半、临界、满、斜纸板、无回波和袋子鼓起；拍下满线实物位置和屏幕读数，保存D_empty/D_full/D_clear。

□ 检查 满桶提示屏幕+蜂鸣/语音，拒绝新开盖投放；清桶后需明确退出维护。

未通过时 不要输出“剩余容量精确百分比”；单点超声只能代表该方向反射面，软物和斜面必须说明。

# 47 D1至D4及D6 屏幕 按键 旋钮 声音和自检

这组功能是后续所有调试的操作入口。先实现简单英文/数字标签，中文使用有限字模，避免完整字体占满64 KB程序空间。

### 步骤 257 OLED页面

主界面四行显示MODE、USER/POINTS、LID/FULL、VBAT/FAULT；菜单固定为投放、查询、行驶、记录、管理、卡片实验。故障置顶覆盖普通提示。

□ 检查 余额999999、未知用户、长故障名称都不会覆盖邻行。

未通过时 给每字段固定字符宽度，更新前清该区域；不用全屏频繁清空闪烁。

### 步骤 258 两个按键

每10 ms读取MCP GPB5 MODE、GPB6 BACK，稳定20 ms才更新；短按MODE循环、长按800 ms确认、BACK退出。长按事件只发一次，释放后再武装。

□ 检查 连续按20次能得到20次明确操作；按住不自动多次兑换。

未通过时 避免短按事件在释放时又跟长按事件叠发；建立pressed_at和long_sent标志。

### 步骤 259 编码器

PB3/PB4读正交状态，按四状态转移表累计；两位同时跳变当非法，不计步。确认每一机械卡点是2还是4个合法边沿，再设置一格阈值；GPB4按键去抖。

□ 检查 顺转20格、反转20格菜单回原位，快速转不越界。

未通过时 方向反了交换软件方向映射；不把每个边沿直接当一次菜单步。

### 步骤 260 蜂鸣节奏

根据已有模块确认有源/无源；刷卡100 ms一声，成功100 ms×2，故障三声循环；以时间戳开关，无delay。音量/静音通过菜单保存。

□ 检查 蜂鸣时急停仍正常，进入静音后屏幕故障提示仍保留。

未通过时 无源模块直流只响一下时改2 kHz PWM；未带驱动的裸蜂鸣器不由GPIO直接大电流驱动。

### 步骤 261 上电自检

按顺序安全输出→时钟→MCP→OLED/MPU→RC522→FLASH与恢复→停止/碰撞/盖→电压。每一步记录PASS/FAIL和具体原因，给每个总线等待设超时。

□ 检查 故障能定位到模块，关键项失败不开放动作菜单。

未通过时 ACK仅证明总线应答；要检查配置回读和数据合理性，不能宣称已证明机械装配。

### 步骤 262 故障降级

RC522/存储失败禁积分投放；MCP失败禁所有执行；MPU/碰撞/急停/电压异常禁运动；OLED失败用串口提示；DHT/语音失败可继续不依赖它的功能。

□ 检查 断电拆一个非关键模块再上电，其他允许功能仍可运行并显示缺失。

未通过时 不要用“任意模块失败整机永远死循环”；也不能忽略运动安全模块失败继续跑。

# 48 C1 C2 C8 C9 D5 D7 先把停止做好 再让轮子落地

电机和电池选型、急停触点接口按电气章节执行。本版三管急停接口规定PB13：释放且NC2闭合=0，按下或断线=1；estop_active()将高电平归一为故障。PB5仍为高电平运行请求，NC1断开时硬件钳位STBY。STBY置低会让驱动进入待机，车轮可能惯性滑行；测使能反应与测整车停止距离是两件事。

标准装配使用SN74AHCT125N把PA0舵机PWM与PB15超声TRIG缓冲为5 V逻辑，软件定时器参数不变。每次上电、MCU复位、I²C关键异常或检测到3V3_EXT故障时，先保持PB5低且电机PWM为0；急停释放、复位或通信恢复均不能自动起步。

### 步骤 263 架空测试

用稳固支撑架让两轮离地且不会掉落；舵机保持关闭、盖闭合确认。软件默认STOP，按一次只允许一个电机以10%起逐级试20%、25%，每档不超过1 s。

□ 检查 左右电机方向与标注对应，停止后PWM=0、STBY请求低。

未通过时 不转先查最低起转占空比、电源和驱动使能，避免长时间堵转；不通过强推轮子测试危险高电流。

### 步骤 264 统一正方向

面向车头定义左右轮。给左轮正转、右轮正转分别检查，必要时断电后交换该电机两线或修改MOTOR_INVERT常量。

□ 检查 相同正指令使两轮驱动车向前；后续算法不再到处反向补偿。

未通过时 不得在驱动输出通电时换电机线。

### 步骤 265 换向流程

任一方向变更先PWM=0与STBY低→MCP写新方向且成功回读/确认→等100 ms→STBY请求高→按斜坡增加占空比。任一失败保持低。

□ 检查 前后切换没有大冲击与MCU复位。

未通过时 不要高PWM时直接翻转AIN/BIN；底层motor_request应统一处理，菜单和蓝牙不直接写寄存器。

三类停止事件汇入PWM和PB5清零及故障锁存，再经过排除原因、人工确认和新运行指令三个门槛恢复。

图解 29 轮子架空测试急停与碰撞，再测试倾角。停止后先消除原因，再人工确认，最后发送新的运行命令；任何一次自动续跑都不通过。

### 步骤 266 急停与碰撞

架空低速运行，按急停、左碰撞、右碰撞、同时碰撞；每次查看故障原因，释放开关后不发命令。若有示波器测输入边沿至驱动STBY拉低。

□ 检查 驱动硬件使能及时被撤销；释放后保持停止。目标使能反应<5 ms需实测，不用肉眼断言。

未通过时 使能仍高先查硬件回路与下拉；软件仅显示STOP却轮转不能判通过。

### 步骤 267 运动互锁

分别让盖未闭、投放中、维护中、满桶未知、MCP通信过期、急停未解除，再发同样前进命令。

□ 检查 所有不允许状态返回明确ERR并保持PWM=0。

未通过时 不要通过仅隐藏菜单实现互锁；串口/蓝牙/循迹的所有入口必须复用同一个允许条件。

### 步骤 268 MPU姿态标定

模块刚性固定于底盘，摆平静置2 s采平均；加速度低通，计算roll=atan2(ay,az)、pitch=atan2(-ax,sqrt(ay²+az²))并减安装偏置；每20 ms更新。

□ 检查 平放接近0°，缓慢倾斜方向和幅值正确。

未通过时 安装轴不一致先统一坐标映射；不要把MPU放厚泡棉上或用于绝对定位。

### 步骤 269 倾倒停车

先架空，垫高底盘缓慢超过18°持续200 ms，锁停；恢复至10°以内仍需BACK确认。阈值作为首轮调试值。

□ 检查 触发可重复，恢复不自动跑；传感器超时也阻止运动。

未通过时 动态加速度会影响重力倾角，先保持低速；不要为消除所有误报而无限增大阈值。

### 步骤 270 电池ADC校准

用万用表测分压采样对应的电池电压和VDDA；VBAT=raw/4095×VDDA×(33k+10k)/10k，再用实测比例系数修正。最大8.4 V对应采样约1.95 V。

□ 检查 三处电压点显示与表读数接近，记录误差，示例验收目标±0.10 V。

未通过时 若接近满量程或读数翻倍，先查分压电阻与接地；不把电池直接接PA1。

### 步骤 271 低电策略

仅2S锂电初始参数：电压≤7.0 V持续3 s提示；≤6.6 V持续1 s锁运动和新会话；≤6.0 V作为异常下限，在当前有效ADC采样确认后立即撤使能，不再等待1 s。恢复至≥7.0 V且明确人工确认后，才允许新的运动命令。最终按电池厂家更严格的截止要求调整。

□ 检查 可调电源模拟缓慢降压与异常低压可触发；恢复不自启；急停接口仅在6.0—8.4 V范围校核，绝不可因BMS尚未断开就在下限以下继续运行。

未通过时 测试可调电源时完全断开电池，不能并联反灌。软件只是提醒/限制，不替代保护板与匹配充电器；ADC采样和程序本身也有响应延迟。

### 步骤 272 地面限速

确认前述通过后放到无边缘平地，沿标记1 m直线计时；空载从最低可控占空比起，逐档记录速度。满载最多0.3 kg后重复，整机目标≤1.6 kg。

□ 检查 工作速度0.08—0.12 m/s，实测最高不超过0.15 m/s；无编码器只保存PWM标定表。

未通过时 跑偏可调左右基准占空比；无轮速传感器不能宣称闭环恒速。

### 步骤 273 红外遇障

以白色平板在前方约10—15 cm调灵敏度，连续有效20 ms锁全部运动方向，再分别测试黑色/斜面目标。

□ 检查 检测到障碍后停车且需人工确认；记录触发距离和最终停止距离。

未通过时 黑色漏检或斜面反射是已知限制；不能把红外模块当楼梯防跌落或保证无碰撞。

### 步骤 274 制动距离

在最高允许速度和满载下，软质挡板前触发障碍停车；用纸尺标记触发点与停止点，至少5次取最大值，再留裕量设置展示安全距离。

□ 检查 展示空间大于实测停止距离加余量，导线与车轮无缠绕。

未通过时 STBY撤销快不代表物理车体立即静止；若滑行过长降速、改路面或重新评估驱动停车策略。

# 49 C3 C4 循迹路线与一至两站停靠

采用三路阵列，黑线归一为1、白底为0；只做无岔路固定路线。路线纸可以用4张90×120 cm拼成180×240 cm，第5张备用；接缝背贴、表面无台阶。

左中右LCR | 控制动作 | 备注
010 | 左右基准PWM | 主线居中
100 / 110 | 向左修正：左轮减、右轮增 | 首轮幅度约10个百分点，按实测最小转速限幅
001 / 011 | 向右修正：右轮减、左轮增 | 同上
000 | 累计50 ms仍丢线就锁停 | 不盲目加速搜线
101 | 歧义，锁停提示线路异常 | 不是普通直线
111 | 候选站点宽条；持续80 ms确认 | 站点识别优先于普通循迹；避免拿它当任意急弯

左侧俯视三探头中间压主线为010、横向宽站条覆盖三探头为111；右侧闭合固定路线标起点、1号和2号站与行进方向。

图解 30 先把三个探头分别放到白底和18 mm黑胶带上核对0/1。路线无岔路，站点用宽条；每次从人工起点出发清零，选择第一或第二站。

### 步骤 275 传感器安装标定

阵列在驱动轮轴前，初始距地8 mm；分别放白底、18 mm黑胶带上，看每路原始与归一值，调整模块电位器。

□ 检查 三路都能稳定区分黑白，车体振动时高度不变。

未通过时 反光海报纸或透明胶带表面会误判，换哑光背景并固定接缝；不要先改算法掩盖饱和传感器。

### 步骤 276 只测直线

先铺长度≥1 m直线，基础PWM从25%附近起但以该轮实际起转值为准；10 ms读一次MCP GPIOB，使用表中修正。

□ 检查 能反复走完整直线，急停和障碍仍有效。

未通过时 摇摆大先降速、减修正；偏出线先确认左右位和转向方向没有反。

### 步骤 277 加缓弯

再铺无岔路大半径弧线；逐渐增加到闭合路线，车道中心距纸边≥20 cm并实看整车包络。

□ 检查 至少5圈无脱轨，000断线试验能停。

未通过时 不能把曲率过大的U弯当必须软件克服；在车体宽度约28 cm情况下留足轮子和桶体扫掠空间。

### 步骤 278 制作站点条

在主线上横贴一条足以覆盖三个探头的黑色宽条，沿行驶方向长度先取30—40 mm；最高0.15 m/s时通过时间≥200 ms，覆盖80 ms确认窗。站点相距足够恢复主线。

□ 检查 慢速和最高允许速度都读到111；离开条后回010至少300 ms。

未通过时 不采用仅细18 mm横条加很高速度的组合而不测识别窗口；不能在复杂交叉处作站点。

### 步骤 279 站点计数

从人工标记的起点出发前清计数，选择目标1或2；111连续80 ms时只加一次并锁标记，恢复普通主线300 ms后解锁。

□ 检查 同宽条慢速通过不会计两次；到目标计数时PWM=0、STBY低。

未通过时 倒车跨标记不计站，改变路线后重新设置起点；没有唯一编码不能从任意位置自动知道站号。

### 步骤 280 到站服务

到站停车500 ms后切投放/便捷待机，按所选模式刷卡或靠近开盖。服务结束留在本站，继续出发需明确操作。

□ 检查 到站前移动中刷卡不打开盖；停稳后正常投放。

未通过时 本项目未纳入自动返回起点，不能写“投完自动回充/返航”。

### 步骤 281 极端测试

运行中用白纸遮掉一段黑线、增加一个101歧义图形、挡住前方、触发碰撞，再恢复路线。

□ 检查 每项停并显示原因，恢复线路不自动续跑。

未通过时 若短数据缺失就按上次PWM无限行驶，要增加传感器数据年龄和状态超时。

# 50 C6 D8 蓝牙控制和电脑导出协议

本节命令是要在 app_serial 中实现的项目协议，不是 HC-05 自带的控制电机指令。Android 终端只负责发文本；HC-05 配对成功不代表控制心跳仍有效。

命令例子，以换行结束 | 执行条件/效果 | 回复
STATUS | 任何状态只读，返回mode、fault、lid、vbat、last_seq | OK STATUS ...
STOP | 任意通信来源均允许，立即锁停 | OK STOP
MODE MANUAL | 静止、无故障、盖闭合；进入遥控模式，不自动起步 | OK MODE或ERR原因
MOVE F 25 / MOVE B 25 | MANUAL且所有互锁有效；请求前/后25% | OK MOVE，刷新本次运动命令时刻
MOVE L 20 / MOVE R 20 | MANUAL下原地/低速转向按底层策略限幅 | OK MOVE
LINE START 1 / LINE START 2 | 静止从已确认起点选择站点目标；独立进入循迹 | OK LINE或ERR
EXPORT USERS / EXPORT EVENTS | 停车且不在投放/兑换/维护拆装过程中，流式CSV | BEGIN ... / CSV / END
BACK / CANCEL | 退出当前普通菜单或取消可取消流程，移动模式退出即停 | OK CANCEL
任意未知/超长命令 | 一行最大80字符，超出丢弃至换行；不刷新运动有效期 | ERR FORMAT

### 步骤 282 先用有线终端验证解析

USB-UART发送STATUS、STOP、MODE MANUAL；输入错误数字、缺参数、超长行、连续空行。接收字节进环形缓冲，主循环只解析完整行。

□ 检查 格式错误不使系统崩溃，不形成随机运动值。

未通过时 不要用atoi不检查范围；速度必须限幅到标定上限，模式与方向使用白名单。

### 步骤 283 蓝牙配对

确认HC-05底板供电及UART电平，PA2→RX、PA3←TX；Android系统蓝牙中按卖家资料配对，再在SPP串口终端连接对应设备。

□ 检查 发送STATUS得到正确回复；模块实际数据波特率与USART2一致。

未通过时 常见默认值不作为保证；模块无回复时先有线核对数据模式，AT配置按模块型号资料操作。

### 步骤 284 加运动心跳

按住方向时终端每100 ms重复发送完整MOVE命令；松开即发STOP。MCU超过300 ms未收到合法MOVE立即停止并清运动请求。

□ 检查 终端暂停发送、关闭蓝牙、走出范围都能停。

未通过时 通用PING或任意乱码不应延长运动期限；否则手机应用卡死仍发PING会继续移动。

### 步骤 285 多来源互斥

一次只有当前模式的控制源可发运动；电脑调试与蓝牙互相不能抢控制，STOP例外。进入投放、维护、查询切换时撤销旧运动租约。

□ 检查 重连后旧命令不恢复，必须重新MODE MANUAL并新发MOVE。

未通过时 不能仅靠HC-05 STATE脚作失联判断，本项目没有依赖该脚。

### 步骤 286 导出CSV

停车后终端开启保存接收文本，发送EXPORT EVENTS；首行固定为seq,boot_id,uptime_ms,user_id,type,delta,balance_after,result；每次读取/发送少量记录，最后END。

□ 检查 保存为UTF-8 CSV，Excel可按逗号分列；数据顺序正确。

未通过时 串口日志不要混入CSV数据行；用明确BEGIN/END或分开诊断通道。不要一次把全FLASH日志读入RAM。

### 步骤 287 断线和取消

导出时发送STOP或BACK，测试拔掉电脑端USB-UART；程序10 s无发送进展中止导出，保留账本。

□ 检查 断线不阻塞本地按键或安全输入，已导出的记录不会重复计分。

未通过时 若无硬件流控、无法知道电脑是否收到，成功定义为设备发送完成；不得宣称已可靠保存到电脑。

# 51 E1 E2 E4 温湿度 自动照明和固定语音

这些是辅助体验功能，全部必须排在停车与积分事务之后处理。逐个启用，避免把电源跌落误认为主控程序错误。

DHT11的微秒脉冲不能由1 ms主循环直接轮询接收。本版确定用PB11→EXTI11双边沿中断，每个边沿读取TIM3的1 µs计数器。TIM3一直自由运行，不能为DHT清零或改频率，否则会破坏超声计时；PA11只用于PWM且不开EXTI，与PB11不冲突。以下参考奥松2022年12月版说明书；旧版/兼容传感器以其真实资料核对，软件超时和容差是本项目设置。

DHT阶段 | 资料时序与本版初值 | 接收/超时处理
上电和采样间隔 | 上电至少2 s后首次读取；本项目每3 s停车读取 | 用SysTick截止时刻调度，不延时占住主循环
主机起始低电平 | 资料18—30 ms，取20 ms | PB11开漏输出0；若主循环异常拖到超过30 ms，释放并放弃本次
主机释放至传感器应答 | 资料10—35 µs | 先设WAIT_RESP_FALL、清EXTI11待决并武装双边沿，再开漏写1释放；忽略这次释放产生的上升沿
应答低/高 | 低78—88 µs、高80—92 µs | 分别按下降→上升、上升→下降测宽；工程容差暂取各60—110 µs，超出整帧丢弃
每位低电平 | 资料50—58 µs | 工程容差暂取35—75 µs；进入WAIT_BIT_RISE，不在此阶段采数值
数据0/1高电平 | 0为23—27 µs，1为68—74 µs | 上升存t_rise，下降算Δt；15—40 µs判0，55—90 µs判1，其余丢帧；MSB先收满40位
单段及整帧超时 | 任意等待边沿超过150 µs为超时；释放起算整帧最多6 ms | 在主循环检查，无边沿退出会受1 ms轮询粒度影响；ISR仍按真实微秒宽度判位，不靠主循环赶边沿
帧完成 | 5字节，前4字节和的低8位应等于第5字节 | 第40位下降沿后只置DONE并屏蔽EXTI11；主循环做校验、按实际版本解析并更新界面

DHT状态依次为WAIT_RESP_FALL→WAIT_RESP_RISE→WAIT_FIRST_BIT_FALL→WAIT_BIT_RISE→WAIT_BIT_FALL；后两状态重复40次。响应高结束的下降沿就是首数据位低开始。每个合法高脉冲结束将当前字节左移一位并或入0/1；收满8位进下一字节。用uint16_t时间差自动处理TIM3回绕。帧完成、超时或急停时只屏蔽EXTI11这一位，不能关闭整个EXTI15_10_IRQn，否则会一并禁掉PB12/PB13停止输入。

EXTI15_10_IRQHandler进入后先快照TIM3时间和待决位；若PB12/PB13触发，立即清PWM和PB5、置故障并中止DHT帧；其余情况下处理PB11的边沿、时间差和最多一位移位。ISR禁止printf、HAL_Delay、总线读写、浮点计算或循环等下一边沿。共享中断需分别清每个已处理挂起位。不得屏蔽中断连续采40位；长于微秒脉冲的临界区会丢边沿。用示波器/逻辑分析仪或测试GPIO核验最短23 µs脉冲不会漏收，优先保证停止，停止打断时丢掉一次DHT读数即可。

### 步骤 288 DHT11接入

确认所买版本可在3.3 V工作；PB11为开漏/释放式控制，4.7 kΩ上拉至3.3 V。用AFIO把EXTI11映射到PB11，开启上升/下降触发；软件只在接收窗口开放EXTI11。上电等待和周期按本节时序表。

□ 检查 温湿度合理，校验和通过；失败显示--或STALE而不是旧值冒充实时。

未通过时 若其版本需更高供电，按电气章节加电平适配，不把5 V上拉直接接数据脚；USART3必须仅TX，不能占PB11作RX。

### 步骤 289 DHT时序不阻塞

先屏蔽EXTI11并拉低PB11，以20 ms截止时刻结束起始段。按时序表武装后释放；EXTI11每边沿用TIM3取时间、分离应答与40数据位。主循环只做超时/校验/显示，绝不用1 ms采样判26 µs高脉冲。开漏写1即释放，F103输入路径仍可供EXTI读取；如切换输入模式，先完成映射和中断准备，避免错过首应答。

□ 检查 串口保存40位原始帧、校验结果和失败原因；接收时按急停立即停且本帧放弃；断开DHT只超时不死等。

未通过时 若最短脉冲漏收，查ISR执行时间、关中断临界区、EXTI映射和总线RC；不要改成长时间禁止安全中断的阻塞接收。

### 步骤 290 光敏极性标定

读取PB0 ADC，在亮环境与手遮光下各平均32点，记录bright_raw和dark_raw；判断数值增大究竟更亮还是更暗。

□ 检查 两组读数有稳定区分，不标成lux。

未通过时 仅DO模块则改GPIO输入，只显示明/暗；没有AO不要强接ADC期待连续量。

### 步骤 291 AO3400A照明

先按电气章节检查SOT23裸MOS转接焊接和100 Ω栅极/100 kΩ下拉；GPA5=0灯灭，=1灯亮。然后设亮暗双阈值，差值约ADC满量程15%，各持续2 s才切换。

□ 检查 临界光照不来回闪；切灯不复位RC522且不改变电机方向。

未通过时 若照明同时让读卡器复位，先修MCP影子寄存器；若常亮查MOS引脚与栅极悬空。

### 步骤 292 准备音频卡

使用DFPlayer实际支持的TF卡，备份后格式化为FAT32；建立mp3目录，放0001.mp3至0006.mp3，依次为请刷卡、请投放、完成、桶满、故障、低电。文件名与所用“播放mp3目录编号”命令一致。

□ 检查 电脑上逐个试听，文件没有空损坏，模块能识别卡。

未通过时 不要把普通play(index)的复制顺序误当固定文件名索引；文件组织必须与所用命令对应。

### 步骤 293 DFPlayer单测

PB10 TX经1 kΩ接模块RX；5 V供电，喇叭跨SPK1/SPK2，两个端子都不接地。初始音量5/30，播放0001；确认8 Ω 1 W喇叭无失真且电源稳定后才逐级调高；GPA6读BUSY实际极性。

□ 检查 固定语句清楚，无核心板复位；BUSY开始/结束可观察。

未通过时 杂音或复位先查语音支路电容、地回路和电源余量；不要先把音量调满。

### 步骤 294 语音队列

最多保存4条待播提示；故障可覆盖低优先级，重复满桶提示合并；发送命令后立即返回，BUSY超时只标语音失败不锁住主循环。

□ 检查 刷卡→请投放→提交成功后完成，顺序正确；失败不播“积分成功”。

未通过时 串口命令本身也走发送队列，不能用等待播完的while循环。

### 步骤 295 辅助故障测试

断电后逐个拔DHT、TF卡、扬声器再上电；照明遮光反复10次；运行正常投放同时观察辅助数据。

□ 检查 主账本和停止功能不受影响，界面能显示辅助模块缺失。

未通过时 未接喇叭只能验证命令发送，不能判定语音功能已完成；未采到数据不能用固定显示值替代验收。

# 52 33 项功能逐项验收矩阵

每行都填写实际通过/失败、日期、固件版本和证据文件。设计说明和未实际执行的操作不能勾为通过。下表编号与用户原功能清单保持一致。

编号/功能 | 最少执行步骤 | 通过判据/需保存的证据
A1 刷卡识别 | 有效、陌生、挂失各刷10次；连续贴卡10 s | 完整UID正确；持续卡只触发一次；串口日志
A2 注册/注销/挂失 | 注册→重启→挂失→注销；容量满测试 | 状态持久且权限正确；操作前后导出表
A3 投放加分 | 空会话、一次经过、一次会话多次晃动 | 仅有效会话+1；DEPOSIT日志
A4 掉电保存 | 提交与快照的6检查点各断电3次 | 恢复为上次或本次完整状态；恢复对照表
A5 查询 | 查询已有/陌生用户各3次 | 不开盖不改余额；前后账本一致
A6 卡片读写 | 专用卡块4写/读；移卡失败 | 16字节回读一致；失败不影响账本；数据截图
A7 管理权限 | 普通卡管理、管理员超时、最后管理员注销 | 非法操作被拒；恢复流程保留普通余额
A8 记录/排行 | 至少3用户不同及同分，日志滚动覆盖 | 最近记录/排序与CSV一致；覆盖不改余额
A9 兑换 | 余额4、5、10；连按；提交中断电 | 余额不足拒绝；一动作一次扣分；事务日志
B1 刷卡开盖 | 合装后连续开关20次 | 无卡滞、复位；闭盖开关有效；视频
B2 投放检测 | 浅/深物各10次、持续挡光 | 有效经过事件正确；记录颜色/手遮局限
B3 去重超时 | 不投放10 s、长挡光、连刷/连投 | 单会话≤1事务；挡光不贸然关盖
B4 靠近开盖 | 停车靠近/移开；移动中靠近 | 只便捷模式响应，不积分；视频
B5 满桶 | 真实袋口下15 mm纸板、空/半/满、无回波 | 新阈值在袋口下判满；保留尺量/读数
B8 清桶维护 | 进入维护发移动/投放请求，断电取内胆再装回 | 不运动不积分；快拆可行、恢复有检查
C1 移动转向 | 架空正反，地面1 m计时，满载 | 前后左右正确，≤0.15 m/s，无复位
C2 遇障停车 | 白/黑/斜目标，5次停止距离 | 可检测目标能停；漏检范围有记录
C3 循迹 | 直线→缓弯→5圈→断线 | 稳定完成、丢线锁停；视频
C4 定点停靠 | 起点选择1/2站；慢速跨标记 | 同标记只计一次；到目标停稳才允许开盖
C6 蓝牙遥控 | 正常、松手、关闭蓝牙、错误命令 | 300 ms有效命令超时停车；重连不续跑
C8 倾角报警 | 慢倾>18°，恢复<10°，数据过期 | 锁停，需确认；不把陀螺当定位
C9 碰撞停车 | 左右/中部按压与断线 | 触发停，持续压住不得起步
D1 OLED | 最大积分、长故障、快速切页 | 无覆盖闪烁，故障信息清楚
D2 蜂鸣 | 刷卡/成功/故障/静音期间急停 | 节奏区分，停车不受阻塞
D3 按键 | 短按20次、长按、按住确认 | 无重复提交，退出运动立即停
D4 旋钮 | 正反各20格、快速转与按压 | 菜单不越界、不误确认
D5 停止按钮 | 所有主模式及总线繁忙时按下 | 硬件撤使能、软件锁存；释放不自起
D6 自检 | 断电逐一拆模块再上电 | 故障明确，关键与非关键降级正确
D7 电池电压 | 万用表3点比对；电源降压模拟 | 校准合格，阈值/回差/延时有效
D8 PC导出 | 导出用户和日志、取消/断线 | CSV可读，与屏幕一致，不阻塞
E1 温湿度 | 连续读取、短时失效/断开 | 校验正确或明确未知；不阻塞
E2 光感照明 | 遮光/恢复10次、阈值附近停留 | 2 s延时与回差有效，无反复闪烁
E4 语音 | 6音轨、无卡/BUSY超时、故障打断 | 音义一致，失败不阻塞停止与记账

# 53 整机收线与最后合装

所有模块完成单项测试后再做本章。先关总开关、拔电池、拔USB串口和下载器；此时才把台架线束移到车体上。

### 步骤 296 先固定电源汇总板

PCB用四个M3安装孔和10mm绝缘立柱固定，孔中心相对100×100mm板左上为(5,5)、(95,5)、(5,95)、(95,95)。先把实物放到底层，与电池、电源模块和轮线一起试排，再描孔，端子与螺丝刀方向可达。

焊接面与木板、螺钉及线束之间保留可靠间隙和绝缘；切除过长引脚，不能让裸焊点接触金属件。旧版汇流铜线不装在PCB上。量实际板孔再配钻，板底不得残留切屑。

□ 检查 焊点和剪脚不接触金属支架或相邻板；维修时能碰到端子螺丝。

未通过时 重排板位或加绝缘底片，不把焊点压在双面胶里。

### 步骤 297 固定核心及信号汇总板

核心板SWD接口朝可打开的检修边，信号汇总板靠近核心；安装孔按实物，不拧弯PCB；没有安装孔时用绝缘托架夹持板边。

□ 检查 插拔线束时板不会翘动，USB座和晶振不承受夹持力。

未通过时 补托架或柱位，不钻穿模块上的走线。

### 步骤 298 固定运动与姿态模块

驱动板靠近电机线；MPU6050刚性固定且标出前向；不要把MPU6050贴在厚泡棉上晃动。

□ 检查 驱动散热位置无泡棉覆盖；IMU静止读取稳定。

未通过时 移开电机振动源，拧紧IMU支撑，重新标定零点。

### 步骤 299 安排无线与读卡位置

RC522固定在桶外前面非金属面板后，天线面朝用户；HC-05天线端远离电池、驱动线和大金属片。

□ 检查 实际使用卡能在标出的刷卡位置重复识别，固定螺钉不压RFID天线。

未通过时 调整位置后重测，不承诺固定厘米数的读距。

### 步骤 300 安排声音与光线

蜂鸣器和喇叭朝有出声孔的位置；光敏朝环境方向；照明LED避免直接照回光敏；DHT11放有通风孔、远离稳压器和电机。

□ 检查 灯开关不会造成明暗判断快速反复；语音清楚，DHT数值不受局部热源明显漂移。

未通过时 增加遮光小挡板、加回差或移动传感器；不要用胶封住DHT进气孔。

### 步骤 301 按编号敷设线束

先敷20AWG电源线，再敷执行器线，最后敷I²C/SPI和传感器线；两端贴相同编号和信号名；跨层位置留可拆接头。

□ 检查 电源线不穿过内胆区域；所有导线避开车轮、合页和拉杆扫动区。

未通过时 改走壳角或平台边缘；不要仅把松线塞进活动空间。

### 步骤 302 形成应力释放

连接器后约20至30mm用扎带固定在线夹或固定孔；弯折留圆弧；穿板处先装护线圈再穿线；信号总线尽量不超过20cm。

□ 检查 轻拉外部线时力由固定点承担，不拉焊盘或模块排针。

未通过时 增加线夹或改线长；不能把扎带勒破绝缘皮。

### 步骤 303 固定电池

电池放在低位，下面薄EVA缓冲，用两条20×300mm扣环绑带穿过底板槽绕回；粘合长度至少50mm。

□ 检查 轻推车体时电池无滑动，外皮不被尖角/螺丝划伤，电池插头可方便拔出。

未通过时 修圆槽边、加护垫或移动固定槽；不以双面胶作为唯一固定。

### 步骤 304 设置检修盖与标识

检修边留可拆螺钉；标出总开关、急停、充电接口、5V和3V3测试点；在插头旁画正负及第1脚。

□ 检查 不用拆桶壳就能关电、拔电池和连接SWD；误插方向有明显提示。

未通过时 调整检修口；不同电压的同型插头用颜色与标签区分。

### 步骤 305 做线束静态检查

不通电，手转车轮、手动开盖至全部运动范围、试提内胆；观察各位置是否碰线。

□ 检查 轮转、盖动、抽袋、插拔电池均顺畅，线束不被拉紧。

未通过时 先改线束和位置，再做通电试验，不靠舵机强行拉过障碍。

### 步骤 306 做整机通断复查

按电气章节再次测5V对地、3V3对地、全部地网、保险丝和两组急停；确认两个3.3V输出未直连。

□ 检查 与单模块装配时记录一致，无新增短路。

未通过时 断开最近安装的线束逐个定位；不能直接用换大保险丝试通。

### 步骤 307 封装前留证

拍摄俯视、底视、桶内、主电源与每块接口板照片；照片能读到线号；保存最终原理接线表和固件版本。

□ 检查 别人可对照照片追踪每条电源线、急停和核心板接口。

未通过时 重拍遮挡部分，线号不清先重贴。

# 54 分阶段整机验收

先架空后落地，先静止后移动。每一阶段均记录电压、现象、固件版本和问题处理结果。没有通过前一阶段时，不继续叠加新的负载。

### 步骤 308 完成逻辑上电验收

断开电机和舵机支路，只接逻辑；上电运行自检，记录5V_LOGIC、核心3V3、3V3_EXT；逐模块读身份或测试输出。

□ 检查 各电压在元件规定范围；界面/串口可用，存储与RFID正常。

未通过时 按电源到模块顺序排查；电源异常先解决，不能用软件重试掩盖。

### 步骤 309 完成执行器分项验收

架空轮子测试左右电机，再停电换接卸连杆的舵机；确认运动指令、急停与超时停车；记录峰值/最低供电读数。

□ 检查 电机正反正确、停止有效；舵机不顶死、不持续鸣叫；核心不复位。

未通过时 检查共地、粗线、电容和负载；万用表可能漏掉短瞬态，必要时借示波器。

### 步骤 310 完成固定桶积分验收

电机保持禁用，把舵机连杆装回；注册普通卡；依次测试无投放、一次投放、多次遮挡、持续贴卡和会话超时。

□ 检查 一会话最多一笔+1，FLASH落盘成功才提示成功；查询不自动开盖。

未通过时 检查状态机和txid，不能仅用延时规避重复刷卡。

### 步骤 311 完成盖机构连续试验

盖总质量先称重；以标定角度连续开关20次，每次等待闭合确认；记录最小电压与异常次数。

□ 检查 20次无卡滞、明显抖动和复位；没有持续顶紧的蜂鸣或明显升温。

未通过时 断电检查铰链、四杆平行性、垫条压缩及质量；不可盲增舵机角度。

### 步骤 312 完成空载行走

确认盖闭合、内胆装好、电池固定；在宽敞平地从最低可起转占空比测试前后和转向；用1m距离与时间测速度。

□ 检查 速度控制在目标0.08至0.12m/s，最大不超过0.15m/s；能可靠停车。

未通过时 修改占空比限幅；一轮打滑/悬空时先修机械水平。

### 步骤 313 完成载荷与重心检查

逐步加入0.10、0.20、0.30kg干样品；每档测总质量、低速启停及大半径转弯。

□ 检查 整机目标≤1.60kg；不翘轮、不倾倒、无过热或电压复位。

未通过时 降低载荷，降低重心或选满足扭矩/电流的轮组；不靠加高电压掩盖负载不足。

### 步骤 314 完成停止类联动

低速测试急停、左右碰撞、前方障碍、倾斜、盖打开、蓝牙断联和传感器故障；每次清除后观察静止状态。

□ 检查 所有相应情况均停止并保持；解除条件后需明确确认/重新启动，不能自行续跑。

未通过时 查硬件STBY与软件故障锁；有任一停止失败就回到架空测试。

### 步骤 315 完成循环演示

从起点循迹到第一站，停车后刷卡投放、查询；人工移回起点，再选择目标2演示第二站；最后导出记录并重启验证余额。

□ 检查 运动与投放互锁，站点计数、积分和日志一致；每次LINE START都从明确起点重新计数。

未通过时 按事件顺序看日志定位，分开复测出问题的单项。

### 步骤 316 完成长时间观察

保持低速与间歇开盖的实际演示节奏运行30分钟，中途检查线束、电源模块、舵机和电机温升及电池状态。

□ 检查 没有异常气味、壳体烫手、松脱、误复位或数据错误；记录剩余电压。

未通过时 异常立即关机检查；记录问题原因与修正后重测结果。

### 步骤 317 形成最终通过记录

把33项功能表逐行补上日期、固件版本、测试结果；拍一段完整流程视频，保存接线照片与源代码归档。

□ 检查 每项有明确结果；失败项没有被写成已通过。

未通过时 继续修复失败项；如受硬件限制不能完成，要在演示范围中清楚标出。

# 55 常见故障逐项排查

排查时一次只改一件事，修改前记录现象，修改后重复同一测试。优先检查供电、地线、接口方向，再检查软件。

现象 | 首先检查 | 具体处理与复验
整机不亮 | 保险丝 总开关 XT30极性 | 断电测保险丝通断；测开关两端与降压输入；更换保险前找短路原因。
通电保险丝立即熔断 | 输入/输出短路或反接 | 断开所有负载只测降压，再逐支路加入；禁止直接换更大保险。
驱动一启动主控复位 | 5V跌落 共地回路 线阻 | 独立电机粗线回电源端、VM电容就近；查启动电流，降低PWM上升斜率。
舵机一动界面重启 | 舵机独立供电和1000µF | 先卸载舵机试验；检查卡滞、线长、地回路和降压瞬态，不能从核心3V3供电。
SG90不断嗡鸣 | 机械终点与盖闭合脉宽 | 先停电卸杆再空载；回退闭盖角度，让微动触发而盖板不被强压。
盖闭合但禁止行驶 | PB14开关触点/机械行程 | 读取盖输入原始值；调整支架，闭盖触发稳定100ms后再启动。
按急停仍有轮转 | NC接点 Q2钳位 STBY连法 | 架空测按下时STBY低于0.3V，检查PB5是否绕过适配接到驱动；单独测试硬件。
急停松开自动走 | 程序沿用了上次PWM命令 | 清除运动命令，保留故障锁；松开只满足复位条件，确认后仍需新启动命令。
一侧轮子方向反 | 镜像电机安装 | 架空调换该轮两电机线或只改软件方向极性；不要改驱动电源线。
车体晃动或一轮悬空 | 前支撑轮总高度与四点共面 | 单球用垫片调整；双前轮逐个垫平，检查驱动轮接地后再调PWM。
循迹左右修正相反 | L/R映射与黑白极性 | 手拿黑胶带扫过每个探头，打印L C R；确认左探头的偏差命令确实左转。
站点重复计数 | 标记锁与重新见主线条件 | 只在111首次确认时加1，离开并稳定主线300ms才解锁。
RC522找不到卡 | 3.3V SPI接线 SS含义 | 模块SDA是SPI片选PA4；检查RST和MISO/MOSI，不接I²C SDA。
单接正常 共SPI失败 | 未选中MISO是否释放 | 先给两个CS各10k上拉，逐个读ID；有模块持续驱动MISO时先修模块。
I²C扫描无设备 | SDA/SCL互换 电平与上拉 | 单块接入、100kHz、短线；检查空闲SCL/SDA都为约3.3V，勿拉5V。
MCP读值总不对 | BANK模式 寄存器地址 A脚 | 硬复位后确认0x20，先写OLAT再写IODIR，读回配置；HAL地址移位只做一次。
FLASH重启丢积分 | 写后确认 commit与恢复流程 | 检查BUSY等待、CRC和有效标志；先断开执行器支路，再对核心与FLASH实际断电重启以验证恢复。
积分重复增加 | 贴卡锁 会话锁 事务去重 | 核对每次会话唯一txid及committed标志；同一遮挡反复采样不应生成多个事件。
卡片实验认证失败 | 卡类型 密钥 所选扇区 | 换已知S50实验卡；检查块4认证，禁止改块0和尾块7来尝试解决。
满桶过早或过迟 | 探头对准 袋边 阈值 | 固定平纸板逐级测距，以新内胆袋口为基准标定，排除袋褶进入超声视场。
投放一直被遮挡 | 收发同轴 外光 接收输出 | 先拿出袋子对准，测通光/遮挡电平；用遮光短管辅助，避免直接阳光。
串口乱码 | 波特率 TX/RX 共地 | PC为115200 8N1；蓝牙和DFPlayer为各自9600配置；TX接对方RX。
蓝牙配对成功但不走 | 当前模式 换行 运动心跳 | 进入手动模式，发送合法MOVE并每100ms续发；单次PING不能延续运动。
DFPlayer没有声音 | 文件路径 TF格式 喇叭端子 | 检查0001等编号，命令校验；喇叭跨SPK1/SPK2，先低音量测试。
DHT11读不到 | 接线方向 上拉 读取间隔 | 确认裸芯片第3脚空，DATA上拉和供电满足实物手册；每3s停车读取。
光照LED不停闪 | LED照回光敏与阈值抖动 | 隔开方向，设置明暗回差和保持时间；先只显示原始ADC判断。
下载器无法连接 | BOOT SWD接线 JTAG配置 | 只接核心短线；尝试Connect under reset；确认未把SWD彻底关闭。
PB3 PB4 PA15无响应 | JTAG仍占用 | 启用Serial Wire并关闭JTAG，保留PA13/14；重新下载后逐脚输出观察。

# 56 充电收纳与日常维护

完成演示后先停止运动并合盖，再关总开关、拔下电池。电池充电方式以成品电池包与匹配充电器说明为准。

### 步骤 318 关闭与保存

退出投放和兑换，等待界面提示保存完成；发送STOP或按停止；关总开关后拔电池。

□ 检查 不存在正在提交的事务，车轮已停止。

未通过时 若系统故障无法正常退出，先切电保人机安全，重启后用日志恢复并核对余额。

### 步骤 319 取出并充电

按电池厂家接法用8.4V充电器；不让行驶系统在充电时同时工作；不把5V USB接入电池充电端。

□ 检查 插头极性与电压匹配，电池外皮和导线完好。

未通过时 受损、膨胀、异常发热的电池停止使用，按所在地回收渠道处理。

### 步骤 320 更换垃圾袋

先进入维护，随后关闭总开关并拔电池，按机械章释放拉杆与移开传感器横梁；取出内胆，更换袋后折边固定。

□ 检查 袋口低于光束且不遮探头，底部落稳；传感器和连杆复原。

未通过时 重新标定空桶距离并确认盖闭合，未检查完不恢复移动。

### 步骤 321 检查紧固与线束

检查M2/M3、轮轴紧固、电池绑带、护线圈、舵机延长线；清理轮上胶带和灰尘。

□ 检查 无露铜、磨损、松动；立柱未开裂。

未通过时 更换受损件再运行，尼龙防松圈失效的螺母换新。

### 步骤 322 保存工程资料

按版本文件夹保存源代码、工程配置、引脚表、实测参数、装配照片和验收表；保留已通过测试的旧版本。

□ 检查 重新打开工程可编译，导出的用户日志可读。

未通过时 补齐库版本和配置文件，不只备份一个hex。

# 57 可以直接填写的制作记录

表格中的空白由制作过程填写。可以复制本章打印多份；每一次硬件或固件修改都应有对应的复测记录。

到货核对项 | 实物记录 | 通过或问题
核心板型号与供电入口 | ________________ | ________________
电机驱动芯片与针序 | ________________ | ________________
左右电机型号/减速比/5V堵转资料 | ________________ | ________________
FLASH型号 JEDEC容量 | ________________ | ________________
OLED型号 地址 | ________________ | ________________
MPU6050稳压及上拉方式 | ________________ | ________________
急停型号 接点最低负载 | ________________ | ________________
电池保护/容量/充电接口 | ________________ | ________________
降压型号 连续电流条件 | ________________ | ________________
电源线规格与端子 | ________________ | ________________

机械测量项 | 实测值 | 要求或用途
活动盖完整运动组件质量 | _____g | 目标≤40g 上限45g
壳体内部净开口 | _____×_____mm | 满足内胆和袋边余量
内胆袋口离地高度 | _____mm | 用于满桶标定
超声探头离地高度 | _____mm | 用于满桶标定
前支撑轮装配总高 | _____mm | 底板下表面离地45mm基准
舵机轴与盖轴距离 | _____mm | 50mm，轴线平行
连杆球心间距 | _____mm | 50mm
两个摇臂有效半径 | _____ / _____mm | 均20mm
空载整机质量 | _____kg | 记录
0.30kg载荷总质量 | _____kg | 目标≤1.60kg
实测1m行驶用时 | _____s | 限速校准

电气测量项 | 逻辑空载 | 执行器工作时
电池经开关电压 | _____V | _____V
5V_LOGIC | _____V | _____V
5V_MOTOR | _____V | _____V
5V_SERVO | _____V | _____V
核心3V3 | _____V | _____V
3V3_EXT | _____V | _____V
急停按下STBY | _____V | PB5强制高时_____V
急停释放/按下PB13 | _____ / _____V | _____ / _____V
PA1电池分压 | _____V | 换算系数_____
5V传感器适配后高电平 | _____V | 最大_____V

参数项 | 初值或记录 | 保存后重启核对
舵机闭合/打开脉宽 | _____ / _____µs | □一致
空桶d_empty | _____mm | □一致
满桶d_full / 清满d_clear | _____ / _____mm | □一致
循迹黑白原始值及反相位 | ________________ | □一致
电机左右极性 最低起转PWM | ________________ | □一致
正常/最大占空比 | _____ / _____% | □一致
蓝牙运动超时 | 300ms或记录_____ | □已测试断联
倾斜报警/恢复 | 18° / 10°或实测_____ | □恢复不自启
光敏明暗阈值与回差 | ________________ | □灯不振荡
固件版本 日期 校验值 | ________________ | □源码已归档

日期与操作者 | 步骤或功能编号 | 现象 修复 复验结果
________ | ________ | ________________________________
________ | ________ | ________________________________
________ | ________ | ________________________________
________ | ________ | ________________________________
________ | ________ | ________________________________
________ | ________ | ________________________________
________ | ________ | ________________________________
________ | ________ | ________________________________

# 58 课设演示的完整顺序

建议用一张管理员卡、一张普通卡和一张专用读写实验卡。表演前先完成验收，不在老师面前临时修改接线或阈值。

### 步骤 323 展示硬件和初始状态

说明STM32、RFID、存储、执行器与电源分支；上电展示自检、余额与电压。

□ 检查 所有模块自检成功，车轮静止，盖关闭。

未通过时 提前修复故障后再演示，不跳过故障提示。

### 步骤 324 展示身份与权限

陌生卡提示未注册；管理员进入注册创建普通用户；普通用户尝试管理操作被拒绝。

□ 检查 身份与权限效果清楚，修改后记录落盘。

未通过时 核对角色与管理员会话超时逻辑。

### 步骤 325 展示投放积分

普通卡开盖，先一次不投放超时，再刷卡投一件纸团；查询余额与投放次数。

□ 检查 无物不加分，有效会话只加一次，日志与屏幕一致。

未通过时 检查对射和会话状态。

### 步骤 326 展示RFID实验和存储

专用卡块4写入16字节并回读比较；退出实验；正常关闭再重启查询账户。

□ 检查 卡实验不修改主账本；重启积分保留。

未通过时 先完成驱动和事务恢复单测。

### 步骤 327 展示兑换与排行

用已准备余额兑换虚拟奖励，查询排行榜，电脑导出记录。

□ 检查 扣分一次且余额不负，导出含事务编号。

未通过时 检查确认键去抖和事务去重。

### 步骤 328 展示桶体附加功能

切便捷模式靠近开盖；用平纸板模拟满桶后停止受理新投放；管理员维护并恢复。

□ 检查 访客不加分，维护不移动，清满按新阈值验证。

未通过时 排除袋边遮挡和测距视场问题。

### 步骤 329 展示移动功能

循迹到指定站点停车；切手动蓝牙短距离遥控；分别触发前障碍与急停。

□ 检查 到站后静止服务；断联和急停后保持停止。

未通过时 场地留余量；停止功能未通过不能演示行走。

### 步骤 330 展示环境与收尾

遮光触发照明，显示温湿度，播放提示；说明模块复用和软件状态机；关机。

□ 检查 全部展示完成后断开电池，资料与实物对应。

未通过时 记录现场问题，修正后更新最终验收表。

# 59 技术资料与参数依据

芯片和模块的电气条件应以所购型号的原厂资料为准。下面列出核对本册设计使用的资料。机械外形、程序阈值、动作顺序和测量合格线是本项目的设计设定，须按各章工步进行样机验证。资料核对日期为2026年10月10日。

E-S1 STMicroelectronics STM32F103x8/xB数据手册

https://www.st.com/resource/en/datasheet/stm32f103c8.pdf

E-S2 Microchip MCP23017/MCP23S17 DS20001952D

https://ww1.microchip.com/downloads/aemDocuments/documents/APID/ProductDocuments/DataSheets/MCP23017-Data-Sheet-DS20001952.pdf

E-S3 Toshiba TB6612FNG数据手册

https://toshiba.semicon-storage.com/info/TB6612FNG_datasheet_en_20141001.pdf?did=10660&prodName=TB6612FNG

E-S4 NXP MFRC522数据手册；NXP MFRC522 数据手册

https://www.nxp.com/docs/en/data-sheet/MFRC522.pdf

E-S5 onsemi 2N3904数据手册

https://www.onsemi.com/pdf/datasheet/2n3904-d.pdf

E-S6 Schneider XB5AS8444官方规格（电气可靠性5V/1mA条件）

https://eshop.se.com/in/emergency-stop.html

E-S7 Texas Instruments SN74AHCT125数据手册

https://www.ti.com/lit/ds/symlink/sn74ahct125.pdf

E-S8 Alpha and Omega Semiconductor AO3400A数据手册

https://www.aosmd.com/res/data_sheets/AO3400A.pdf

E-S9 DFRobot DFPlayer Mini DFR0299官方Wiki；DFRobot DFPlayer Mini官方文档

https://wiki.dfrobot.com/dfr0299

E-S10 TowerPro SG90官方产品资料

https://towerpro.com.tw/product/sg90-7/

E-S11 ElecFreaks HC-SR04模块资料（SparkFun托管）

https://cdn.sparkfun.com/datasheets/Sensors/Proximity/HCSR04.pdf

E-S12 Aosong DHT11官方产品页

https://www.aosong.com/en/Products/info.aspx?itemid=2257

E-S13 Silicon Labs CP2102官方产品与文档

https://www.silabs.com/interface/usb-bridges/classic/device.cp2102?tab=techdocs

E-S14 Nexperia AN10441：开漏总线的双向MOS电平转换原理

https://assets.nexperia.com/documents/application-note/AN10441.pdf

ST STM32CubeMX 官方工具与初始化流程

https://www.st.com/en/development-tools/stm32cubemx.html

ST STM32CubeIDE 官方开发环境

https://www.st.com/en/development-tools/stm32cubeide.html

ST STM32CubeProgrammer 官方烧录工具

https://www.st.com/en/development-tools/stm32cubeprog.html

ST STM32F103C8 器件页

https://www.st.com/en/microcontrollers-microprocessors/stm32f103c8.html

ST RM0008 F1参考手册：时钟、定时器、GPIO、串口与ADC

https://www.st.com/resource/en/reference_manual/cd00171190-stm32f101-103-105-107-stm32f100-series-armbased-32bit-mcus-stmicroelectronics.pdf

NXP MIFARE Classic EV1 1K 数据手册

https://www.nxp.com/docs/en/data-sheet/MF1S50YYX_V1.pdf

TDK InvenSense MPU6050寄存器说明

https://invensense.tdk.com/wp-content/uploads/2015/02/MPU-6000-Register-Map1.pdf

奥松DHT11说明书（2022年12月版）：接口、采样间隔与微秒时序

https://www.aosong.com/uploadfiles/2025/03/20250305165717988.pdf

Microchip MCP23017 产品资料入口

https://www.microchip.com/en-us/product/MCP23017

Winbond SPI NOR原厂文档查询，按实际芯片选择

https://www.winbond.com/hq/support/documentation/?__locale=en

# 60 SG90舵机与桶盖连接详图

本章把第15章的连杆装配和第29章的舵机接线放大说明。先核对机械关系与三根线的去向，再按原步骤056—066及149—151装配、校准。本章各图是尺寸关系示意，不能按打印大小直接划孔。

## 60.1 先认清固定件和运动件

SG90壳体固定在桶外支架上；桶盖绕真实铰链轴转动。原配舵盘带动20mm舵臂，经孔心距50mm的双球头拉杆，推动与桶盖刚性连接的20mm侧臂。舵机轴和盖铰链轴同高、平行，轴间距50mm，形成不交叉的平行四边形。

闭盖时桶盖定义为0°，两臂相对水平为20°；正常开盖70°时，两臂相对水平为90°。这些是机构的几何角度，不是可直接写进程序的SG90角度指令。舵机先卸臂以50Hz、1500μs空载置中，再按原步骤小幅校准端点，禁止硬顶机械止挡。

核对项 | 本方案数值或要求
两固定轴间距 | 50mm；以真实轴心测量，两轴同高且平行
舵机臂和盖侧臂 | 各20mm；均从对应轴心量到球头中心
双球头拉杆 | 两球头中心距50mm；长度不是金属杆外露长度
桶盖与活动总成 | 桶盖160×150×2mm；桶盖、随盖侧臂和紧固件总质量实称≤45g
正常运动范围 | 盖0°→70°；先断执行电源并拆一端拉杆，才可维护撑盖

## 60.2 三根舵机线分别接到哪里

SG90线 | 连接位置 | 核对方法
红色电源线 | J5.1 5V_BUS | 来自降压5V；不接8.4V或3.3V
棕色或黑色地线 | 直接回J5.2 GND | 承载舵机电流，不经信号地回流
橙 黄 白信号线 | J20.1 SERVO_SIG_5V | 5V逻辑PWM，来自U1.3；不是正电源
核心PA0 | J8.4 → U1.2 A1 | 经缓冲后去SG90；全系统共地

延长线按实物逐根测通断并贴标签；颜色仅作辅助。先不装拉杆验证空载，再安装舵盘及连杆。舵机运动和轮电机行走仍按原手册分时互锁。

## 60.3 合盖状态与尺寸基准

舵机轴与盖铰链轴同高且相距50毫米，两臂各20毫米、球头拉杆孔心距50毫米，闭盖时两臂指向前上方20度。

图解 31 SG90 连杆机构合盖状态：桶盖 0°，两臂相对水平 20°。

先以真实铰链轴为基准固定舵机，两固定轴同高、平行且前后相距50mm；连杆连接的是两个球头中心。

## 60.4 中间状态与干涉检查

盖打开35度时两臂同向转到55度，50毫米球头拉杆保持连接；图示为未交叉的平行四边形。

图解 32 SG90 连杆机构中间状态：桶盖 35°，两臂相对水平 55°。

中间状态用于观察侧臂、球头外壳、盖边和桶壳是否干涉；正常开合过程中不得硬顶支架或拉偏球头。

## 60.5 正常全开与端点校准

盖相对闭合位置转过70度，两只20毫米臂竖直，两个球头中心仍相距50毫米。

图解 33 SG90 连杆机构正常全开：桶盖 70°，两臂相对水平 90°。

图中90°是两臂的物理方向，不等同于程序中的舵机角度指令；程序端点须逐渐试开校准。维护撑开约120°前应先断开执行电源并拆开一端拉杆。

## 60.6 盖侧臂与桶盖固定

上半图标明闭盖时孔心相对真实铰链轴投影向前约18.8毫米、向上约6.8毫米，轴心至孔心20毫米；下半图为两颗M2螺钉穿过L形翼缘、2毫米桶盖和加强片的展开剖面。

图解 34 桶盖侧臂安装：按真实铰链轴定位球头孔，用两点穿盖固定和内侧加强片连接。

侧臂与桶盖刚性固定成一体；图中铰链轴投影不是新增螺钉孔。穿盖叠层为螺钉头—平垫—L形翼缘—2mm桶盖—内侧加强片—平垫—防松螺母，轻压固定，不能压瘪发泡板。

先用纸样核对舵机和铰链的真实位置，再确定侧臂固定孔。盖侧臂不能只靠一个可转动螺钉连接桶盖；两点固定和内侧加强片共同防转、分散受力。每次增加活动紧固件后重新称重。

## 60.7 舵盘与球头叠装

上半图为SG90原配舵盘及两点防转延长片，轴心到球头孔心20毫米；下半图为M2螺钉、配套小垫套、球头内球、小隔套、舵臂、平垫与防松螺母的展开剖面。

图解 35 舵机端及球头连接：保留原配舵盘与中心螺钉，夹紧内球并保留外壳摆动。

舵盘中心用SG90原配螺钉；延长片的两处防转孔按实物选。通孔球头只夹紧金属内球，配套小垫套不能压住塑料杯壳；不要靠松开螺母获得摆动，卡扣式球头按其配套球销安装。

装完先断电手动检查行程，再空载慢速试开。球头不能卡死或碰盖边；防松螺母应起防松作用，不能通过松螺母让夹层摇晃来冒充球头转动。连续20次无卡滞后，再继续原手册的负载和整机验收。

# 61 旧版洞洞板归档 不用于PCB施工

本章完整保留2026年10月10日的PWR/IO洞洞板参考布局R1及142条板内连线，用于历史追溯。用户现已选择SmartBin_A A1 PCB，请跳到第63章施工。本章A—X孔号、旧位号、飞线、裸汇流线及AHCT五拆六增均不适用于新PCB，不得混合执行。

## 61.1 读图前先确认板型和方向 旧版归档

先确认2.54mm独立焊盘，在实物上找到连续24列×30行有效孔区，避开安装孔、螺钉及边缘缺孔。从元件面定义A—X和1—30，在A1旁画三角。有效孔中心跨度58.42×73.66mm；70×90mm外形不保证所有商品板孔区相同。

元件面从左到右A—X；保持第1行朝上，绕竖轴翻到焊接面后，从左到右为X—A。图解37和39已经镜像，不能再镜像一次。两面同名孔始终是同一个物理孔。

方框焊盘表示排针第1脚；端子正负和三极管E/B/C已标注。独立焊盘本身不相通，靠规定导线建立网络。整页图用于总览，小脚号看不清时放大SVG或查本章文字孔位表，不凭线条颜色猜接。

先空插端子、IC座、电阻和电容，核对脚距与壳体间隙。U1是DIP14座，排距7.62mm、缺口朝第1行；电阻建议本体不大于约7×3mm，图示脚距10.16mm；电解脚距5.08mm、直径不大于10mm，正负按实际标识。

142条记录由135条绝缘飞线和两根汇流铜线的7段记录组成。PWR-W001—W003是一根连续正铜线V3→V9，W004—W007是一根连续负铜线X3→X11；用约0.8mm镀锡实心铜线，不能切成七根细跳线。

其余飞线仅在指定两端剥皮焊接；折线是建议绕线路径，交叉不相连。焊一根、断电测一根、勾一根。功率线按线表20AWG，其他按22/26AWG；大电流不依赖细焊锡桥。

PWR板的5V_BUS与IO的5V_LOGIC为同一个5V节点；3V3_EXT与3V3_CORE不可直接连接，GND共地。电机和舵机直接回PWR，不经IO排针。核心、MCP成品模块、驱动和稳压模块均在板外固定。

PWR放ADC分压与照明电阻；AO3400A转接板用核实后的G/S/D线束外接。IO图中的Q1/Q2/Q3对应原步骤中的QES1/QES2/QES3。图中接口次序是板侧自定义，不能按此猜模块原排针。

## 61.2 怎样从原步骤查到本章 旧版归档

旧版归档 原章节或步骤 | 本章使用位置
步骤094与图解03 | 先读本章方向规则，再看图解36—39；原图解03只讲通用焊接方法
步骤096—114 | 用PWR/IO孔位表定位电源、核心线束、I²C和MCP接口
步骤127 134 149 169—183 | 同时看条件上拉、QES位号、舵机支路、外置AO和PWR ADC说明
板内线全部完成后 | 继续61.9外置模块接线；142条板内线不包括全部模块线束

## 61.3 PWR电源板元件面 旧版归档

PWR电源板元件面，24列30行完整孔区，保持第1行朝上。

图解 36 旧版归档 PWR洞洞板元件面。仅用于历史对照，不用于PCB A1施工。

## PWR电源板焊接面 旧版归档

PWR电源板焊接面，24列30行完整孔区，保持第1行朝上。

图解 37 旧版归档 PWR洞洞板焊接面。此图已镜像，其铜线施工不用于PCB A1。

## IO信号板元件面 旧版归档

IO信号板元件面，24列30行完整孔区，保持第1行朝上。

图解 38 旧版归档 IO洞洞板元件面。旧AHCT第3通道配置不用于PCB A1。

## IO信号板焊接面 旧版归档

IO信号板焊接面，24列30行完整孔区，保持第1行朝上。

图解 39 旧版归档 IO洞洞板焊接面。旧孔号、飞线与新PCB位号不可互换。

## 61.4 PWR元件孔位与接口 旧版归档

引脚表示电气脚名，孔位始终采用元件面定义。网络名必须一致；NC表示留空。接口连接外部模块时按模块丝印逐根核对。装配说明中的条件元件必须根据实物上拉和电平选择，不能全部无条件焊满。

旧版归档 位号 | 规格或用途 | 引脚 → 孔位 → 网络 | 装配说明
JP1 | 开关后电池输入 | + → B3 → VBAT_SW - → D3 → GND | KF301-2P，脚距5.08mm。仅适用实际引脚可穿孔的器件；功率线焊在端子针脚上并做机械固定。
JP2 | 去降压 IN | + → J3 → VBAT_SW - → L3 → GND | KF301-2P，脚距5.08mm。仅适用实际引脚可穿孔的器件；功率线焊在端子针脚上并做机械固定。
JP3 | 接降压 OUT | + → R3 → 5V_BUS - → T3 → GND | KF301-2P，脚距5.08mm。仅适用实际引脚可穿孔的器件；功率线焊在端子针脚上并做机械固定。
JP4 | 电机 5V 支路 | + → B12 → 5V_BUS - → D12 → GND | KF301-2P，脚距5.08mm。仅适用实际引脚可穿孔的器件；功率线焊在端子针脚上并做机械固定。
JP5 | 舵机 5V 支路 | + → J12 → 5V_BUS - → L12 → GND | KF301-2P，脚距5.08mm。仅适用实际引脚可穿孔的器件；功率线焊在端子针脚上并做机械固定。
JP6 | 逻辑 5V 支路 | + → R12 → 5V_BUS - → T12 → GND | KF301-2P，脚距5.08mm。仅适用实际引脚可穿孔的器件；功率线焊在端子针脚上并做机械固定。
CP1 | 470uF/16V | + → B17 → 5V_BUS - → D17 → GND | 正极接5V，带负号条纹的负极接GND；图示脚距5.08mm，实际不符时在邻近空孔调位并同步更新连线。直径不超过10mm。
CP4 | 100nF | 1 → B21 → 5V_BUS 2 → D21 → GND
CP2 | 1000uF/16V | + → J17 → 5V_BUS - → L17 → GND | 正极接5V，带负号条纹的负极接GND；图示脚距5.08mm，实际不符时在邻近空孔调位并同步更新连线。直径不超过10mm。
CP5 | 100nF | 1 → J21 → 5V_BUS 2 → L21 → GND
CP3 | 100uF/16V | + → R17 → 5V_BUS - → T17 → GND | 正极接5V，带负号条纹的负极接GND；图示脚距5.08mm，实际不符时在邻近空孔调位并同步更新连线。直径不超过10mm。
CP6 | 100nF | 1 → R21 → 5V_BUS 2 → T21 → GND
BUS+ | 0.8mm 铜线汇流排 | 1 → V3 → 5V_BUS 2 → V5 → 5V_BUS 3 → V7 → 5V_BUS 4 → V9 → 5V_BUS | 焊接面用一根连续直径约0.8mm镀锡实心铜线覆盖V3至V9，仅V3/V5/V7/V9固定焊接；支路线搭焊在铜线上，不与元件腿挤入同孔。完工绝缘罩住。
BUS- | 0.8mm 铜线汇流排 | 1 → X3 → GND 2 → X5 → GND 3 → X7 → GND 4 → X9 → GND 5 → X11 → GND | 焊接面用一根连续直径约0.8mm镀锡实心铜线覆盖X3至X11，仅列出节点固定焊接；与V列汇流排保持绝缘间隔，线交叉处必须有绝缘层。
JP7 | 外置3.3V模块 OUT | 1 → R7 → 3V3_EXT 2 → S7 → GND | 不是稳压器；这里接外置稳压模块输出。其输入接JP6。
JP8 | 去 IO JPWR | 1 → X23 → 5V_BUS 2 → X24 → 3V3_EXT 3 → X25 → VBAT_SW 4 → X26 → GND
JP9 | 去核心 PA1 / GND | 1 → R28 → BAT_ADC 2 → R29 → GND
JP10 | 灯控制输入 | 1 → B24 → MCP_GPA5 2 → B25 → GND
JP11 | AO3400A 的 G / S / D | 1 → J27 → LED_GATE 2 → J28 → GND 3 → J29 → LED_NEG | 这是自定义线束端子，不是任意SOT23转接板的直插脚位；万用表追踪后接G、S、D。
JP12 | 白色LED A / K | 1 → B28 → LED_POS 2 → B29 → LED_NEG
RP1 | 33k 1% | 1 → L23 → VBAT_SW 2 → P23 → BAT_ADC
RP2 | 10k 1% | 1 → L26 → BAT_ADC 2 → P26 → GND
CP7 | 100nF | 1 → L28 → BAT_ADC 2 → N28 → GND
RP3 | 100R | 1 → D24 → MCP_GPA5 2 → H24 → LED_GATE
RP4 | 100k | 1 → F26 → LED_GATE 2 → F30 → GND
RP5 | 220R | 1 → L30 → 5V_BUS 2 → P30 → LED_POS

## 61.5 IO元件孔位与接口 旧版归档

引脚表示电气脚名，孔位始终采用元件面定义。网络名必须一致；NC表示留空。接口连接外部模块时按模块丝印逐根核对。装配说明中的条件元件必须根据实物上拉和电平选择，不能全部无条件焊满。

旧版归档 位号 | 规格或用途 | 引脚 → 孔位 → 网络 | 装配说明
JCORE | 核心板信号入口 | 1 → A2 → GND 2 → A3 → 3V3_CORE 3 → A4 → PA0 4 → A5 → PB15 5 → A6 → PB5 6 → A7 → PB13 7 → A8 → SCL 8 → A9 → SDA 9 → A10 → PA4 10 → A11 → PA15 11 → A12 → PB10 12 → A13 → PB11 13 → A14 → PB3 14 → A15 → PB4 15 → A16 → PB1 16 → A17 → PB12 17 → A18 → PB14 | 本图自定义17针排针，不是核心板整排针序。逐根按GPIO名连接。
JPWR | 接 PWR JP8 | 1 → A21 → 5V_LOGIC 2 → A22 → 3V3_EXT 3 → A23 → VBAT_SW 4 → A24 → GND
JSW | 碰撞 / 闭盖开关 | 1 → A27 → PB12 2 → A28 → GND 3 → A29 → PB14 4 → A30 → GND
JMCP | MCP23017 模块 | 1 → X2 → 3V3_EXT 2 → X3 → GND 3 → X4 → SCL 4 → X5 → SDA 5 → X6 → MCP_RESET | 模块外置。按丝印连接；地址A0/A1/A2在模块侧接GND，模块已有复位上拉可不装R5。
JACT | 舵机 / 超声 / 驱动 | 1 → X9 → SERVO_SIG_5V 2 → X10 → GND 3 → X11 → US_TRIG_5V 4 → X12 → ECHO_RAW 5 → X13 → STBY_OUT | 此口只走信号和参考地；电机和舵机功率地不经此口回流。
JES | 急停双 NC 触点 | 1 → X16 → VBAT_SW 2 → X17 → NC1_RETURN 3 → X18 → VBAT_SW 4 → X19 → NC2_RETURN | 第1-2针去NC1两个端子；第3-4针去NC2两个端子。不能接GPIO或LED触点。
JAUX | 外设信号出口 | 1 → X22 → DF_RX 2 → X23 → PB11 3 → X24 → PB3 4 → X25 → PB4 5 → X26 → PA4 6 → X27 → PA15 7 → X28 → WP_N 8 → X29 → HOLD_N | 每个针按名称接对应模块，不是同一个模块的8针接口。
U1 | SN74AHCT125N | 1 → D4 → GND 2 → D5 → PA0 3 → D6 → SERVO_SIG_5V 4 → D7 → GND 5 → D8 → PB15 6 → D9 → US_TRIG_5V 7 → D10 → GND 8 → G10 → NC_U1_8 9 → G9 → GND 10 → G8 → 5V_LOGIC 11 → G7 → NC_U1_11 12 → G6 → GND 13 → G5 → 5V_LOGIC 14 → G4 → 5V_LOGIC | DIP14座；缺口朝第1行。不要换成74HC125。8、11脚输出留空。
C1 | 100nF | 1 → I3 → 5V_LOGIC 2 → I5 → GND
R1 | 10k | 1 → C12 → PA0 2 → G12 → GND
R2 | 10k | 1 → C14 → PB15 2 → G14 → GND
Q1 | 2N3904 | E → K5 → GND B → L5 → ES1_BASE C → M5 → KILL_BASE | 本图定义左E/中B/右C；实际厂家脚序必须核对。引脚套管弯折到孔位，不能仅按平面朝向猜。
Q2 | 2N3904 | E → K9 → GND B → L9 → KILL_BASE C → M9 → STBY_OUT | 本图定义左E/中B/右C；实际厂家脚序必须核对。引脚套管弯折到孔位，不能仅按平面朝向猜。
Q3 | 2N3904 | E → K13 → GND B → L13 → ES2_BASE C → M13 → PB13 | 本图定义左E/中B/右C；实际厂家脚序必须核对。引脚套管弯折到孔位，不能仅按平面朝向猜。
R3 | 4.7k | 1 → C17 → SCL 2 → G17 → 3V3_EXT | 条件装：总线只保留一组适合的等效上拉，模块自带上拉须计入。
R4 | 4.7k | 1 → C19 → SDA 2 → G19 → 3V3_EXT | 条件装：总线只保留一组适合的等效上拉，模块自带上拉须计入。
R5 | 10k | 1 → C21 → MCP_RESET 2 → G21 → 3V3_EXT | 条件装：MCP模块已有RESET上拉则核对后可不重复。
R6 | 10k | 1 → C23 → PA4 2 → G23 → 3V3_EXT
R7 | 10k | 1 → C25 → PA15 2 → G25 → 3V3_EXT
R8 | 10k | 1 → C27 → WP_N 2 → G27 → 3V3_EXT | 条件装：仅FLASH有引出WP#/HOLD#且缺少适当上拉时装；否则针和电阻都留空。
R9 | 10k | 1 → C29 → HOLD_N 2 → G29 → 3V3_EXT | 条件装：仅FLASH有引出WP#/HOLD#且缺少适当上拉时装；否则针和电阻都留空。
R10 | 4.7k | 1 → K3 → NC1_RETURN 2 → O3 → ES1_BASE
R11 | 100k | 1 → K7 → ES1_BASE 2 → O7 → GND
R12 | 4.7k | 1 → K11 → NC2_RETURN 2 → O11 → ES2_BASE
R13 | 100k | 1 → K15 → ES2_BASE 2 → O15 → GND
R14 | 4.7k | 1 → Q5 → 3V3_EXT 2 → U5 → KILL_BASE
R15 | 100k | 1 → Q9 → KILL_BASE 2 → U9 → GND
R16 | 1k | 1 → Q13 → PB5 2 → U13 → STBY_OUT
R17 | 10k | 1 → Q17 → PB5 2 → U17 → GND
R18 | 10k | 1 → Q21 → STBY_OUT 2 → U21 → GND
R19 | 10k | 1 → K19 → 3V3_CORE 2 → O19 → PB13
R20 | 12k | 1 → K17 → ECHO_RAW 2 → O17 → PB1
R21 | 20k | 1 → K21 → PB1 2 → O21 → GND
R22 | 10k | 1 → K23 → PB3 2 → O23 → 3V3_CORE | 编码器CLK/DT已有到EXT上拉时，不得再与CORE上拉混接；先取消模块该上拉或不装本电阻并验证。
R23 | 10k | 1 → K25 → PB4 2 → O25 → 3V3_CORE | 编码器CLK/DT已有到EXT上拉时，不得再与CORE上拉混接；先取消模块该上拉或不装本电阻并验证。
R24 | 4.7k | 1 → K27 → PB11 2 → O27 → 3V3_EXT | 3.3V DHT分支；5V DHT使用外置BSS138双向模块。已有上拉须计入。
R25 | 1k | 1 → K29 → PB10 2 → O29 → DF_RX
R26 | 10k | 1 → Q25 → PB12 2 → U25 → 3V3_CORE
R27 | 10k | 1 → Q29 → PB14 2 → U29 → 3V3_CORE

## 61.6 PWR逐根焊线检查表 旧版归档

断电逐行测量起终点导通，并确认未误接相邻网络后勾选。孔号不随翻面变化。表中两处“0.8mm汇流铜线”网络按连续整线制作，其他全部使用绝缘导线。

旧版归档 编号 | 网络 | 起点孔与元件脚 | 终点孔与元件脚 | 线规 | 检查
W001 | 5V_BUS | V3 / BUS+.1 | V5 / BUS+.2 | 0.8mm汇流铜线 | □
W002 | 5V_BUS | V5 / BUS+.2 | V7 / BUS+.3 | 0.8mm汇流铜线 | □
W003 | 5V_BUS | V7 / BUS+.3 | V9 / BUS+.4 | 0.8mm汇流铜线 | □
W004 | GND | X3 / BUS-.1 | X5 / BUS-.2 | 0.8mm汇流铜线 | □
W005 | GND | X5 / BUS-.2 | X7 / BUS-.3 | 0.8mm汇流铜线 | □
W006 | GND | X7 / BUS-.3 | X9 / BUS-.4 | 0.8mm汇流铜线 | □
W007 | GND | X9 / BUS-.4 | X11 / BUS-.5 | 0.8mm汇流铜线 | □
W008 | 5V_BUS | R3 / JP3.+ | V3 / BUS+.1 | 20AWG | □
W009 | 5V_BUS | V5 / BUS+.2 | B12 / JP4.+ | 20AWG | □
W010 | 5V_BUS | V7 / BUS+.3 | J12 / JP5.+ | 20AWG | □
W011 | 5V_BUS | V9 / BUS+.4 | R12 / JP6.+ | 20AWG | □
W012 | GND | D3 / JP1.- | L3 / JP2.- | 20AWG | □
W013 | GND | T3 / JP3.- | X3 / BUS-.1 | 20AWG | □
W014 | GND | X11 / BUS-.5 | D3 / JP1.- | 20AWG | □
W015 | GND | X5 / BUS-.2 | D12 / JP4.- | 20AWG | □
W016 | GND | X7 / BUS-.3 | L12 / JP5.- | 20AWG | □
W017 | GND | X9 / BUS-.4 | T12 / JP6.- | 20AWG | □
W018 | VBAT_SW | B3 / JP1.+ | J3 / JP2.+ | 20AWG | □
W019 | GND | B25 / JP10.2 | F30 / RP4.2 | 26AWG | □
W020 | GND | D12 / JP4.- | D17 / CP1.- | 22AWG | □
W021 | GND | D17 / CP1.- | D21 / CP4.2 | 26AWG | □
W022 | GND | J28 / JP11.2 | F30 / RP4.2 | 26AWG | □
W023 | GND | J28 / JP11.2 | N28 / CP7.2 | 26AWG | □
W024 | GND | L12 / JP5.- | L17 / CP2.- | 22AWG | □
W025 | GND | L17 / CP2.- | L21 / CP5.2 | 26AWG | □
W026 | GND | P26 / RP2.2 | N28 / CP7.2 | 26AWG | □
W027 | GND | R29 / JP9.2 | N28 / CP7.2 | 26AWG | □
W028 | GND | T12 / JP6.- | S7 / JP7.2 | 26AWG | □
W029 | GND | T12 / JP6.- | T17 / CP3.- | 22AWG | □
W030 | GND | T17 / CP3.- | T21 / CP6.2 | 26AWG | □
W031 | GND | T21 / CP6.2 | P26 / RP2.2 | 26AWG | □
W032 | GND | X26 / JP8.4 | P26 / RP2.2 | 26AWG | □
W033 | 3V3_EXT | R7 / JP7.1 | X24 / JP8.2 | 26AWG | □
W034 | 5V_BUS | B12 / JP4.+ | B17 / CP1.+ | 22AWG | □
W035 | 5V_BUS | B17 / CP1.+ | B21 / CP4.1 | 26AWG | □
W036 | 5V_BUS | J12 / JP5.+ | J17 / CP2.+ | 22AWG | □
W037 | 5V_BUS | J17 / CP2.+ | J21 / CP5.1 | 26AWG | □
W038 | 5V_BUS | R12 / JP6.+ | R17 / CP3.+ | 22AWG | □
W039 | 5V_BUS | R17 / CP3.+ | R21 / CP6.1 | 26AWG | □
W040 | 5V_BUS | R21 / CP6.1 | L30 / RP5.1 | 26AWG | □
W041 | 5V_BUS | R21 / CP6.1 | X23 / JP8.1 | 26AWG | □
W042 | VBAT_SW | J3 / JP2.+ | L23 / RP1.1 | 26AWG | □
W043 | VBAT_SW | X25 / JP8.3 | L23 / RP1.1 | 26AWG | □
W044 | BAT_ADC | L26 / RP2.1 | L28 / CP7.1 | 26AWG | □
W045 | BAT_ADC | P23 / RP1.2 | L26 / RP2.1 | 26AWG | □
W046 | BAT_ADC | R28 / JP9.1 | L28 / CP7.1 | 26AWG | □
W047 | LED_GATE | H24 / RP3.2 | F26 / RP4.1 | 26AWG | □
W048 | LED_GATE | J27 / JP11.1 | F26 / RP4.1 | 26AWG | □
W049 | LED_NEG | J29 / JP11.3 | B29 / JP12.2 | 26AWG | □
W050 | LED_POS | B28 / JP12.1 | P30 / RP5.2 | 26AWG | □
W051 | MCP_GPA5 | B24 / JP10.1 | D24 / RP3.1 | 26AWG | □

## 61.7 IO逐根焊线检查表 旧版归档

断电逐行测量起终点导通，并确认未误接相邻网络后勾选。孔号不随翻面变化。表中两处“0.8mm汇流铜线”网络按连续整线制作，其他全部使用绝缘导线。

旧版归档 编号 | 网络 | 起点孔与元件脚 | 终点孔与元件脚 | 线规 | 检查
W001 | GND | A2 / JCORE.1 | D4 / U1.1 | 26AWG | □
W002 | GND | A24 / JPWR.4 | A28 / JSW.2 | 26AWG | □
W003 | GND | A24 / JPWR.4 | G14 / R2.2 | 26AWG | □
W004 | GND | A28 / JSW.2 | A30 / JSW.4 | 26AWG | □
W005 | GND | D10 / U1.7 | G9 / U1.9 | 26AWG | □
W006 | GND | D4 / U1.1 | D7 / U1.4 | 26AWG | □
W007 | GND | D7 / U1.4 | D10 / U1.7 | 26AWG | □
W008 | GND | G12 / R1.2 | G14 / R2.2 | 26AWG | □
W009 | GND | G6 / U1.12 | I5 / C1.2 | 26AWG | □
W010 | GND | G9 / U1.9 | G12 / R1.2 | 26AWG | □
W011 | GND | G9 / U1.9 | G6 / U1.12 | 26AWG | □
W012 | GND | I5 / C1.2 | K5 / Q1.E | 26AWG | □
W013 | GND | K13 / Q3.E | O15 / R13.2 | 26AWG | □
W014 | GND | K5 / Q1.E | K9 / Q2.E | 26AWG | □
W015 | GND | K5 / Q1.E | O7 / R11.2 | 26AWG | □
W016 | GND | K9 / Q2.E | K13 / Q3.E | 26AWG | □
W017 | GND | O15 / R13.2 | O21 / R21.2 | 26AWG | □
W018 | GND | O7 / R11.2 | U9 / R15.2 | 26AWG | □
W019 | GND | U17 / R17.2 | U21 / R18.2 | 26AWG | □
W020 | GND | U21 / R18.2 | O21 / R21.2 | 26AWG | □
W021 | GND | X10 / JACT.2 | U9 / R15.2 | 26AWG | □
W022 | GND | X3 / JMCP.2 | X10 / JACT.2 | 26AWG | □
W023 | 3V3_CORE | A3 / JCORE.2 | K19 / R19.1 | 26AWG | □
W024 | 3V3_CORE | K19 / R19.1 | O23 / R22.2 | 26AWG | □
W025 | 3V3_CORE | O23 / R22.2 | O25 / R23.2 | 26AWG | □
W026 | 3V3_CORE | O25 / R23.2 | U25 / R26.2 | 26AWG | □
W027 | 3V3_CORE | U25 / R26.2 | U29 / R27.2 | 26AWG | □
W028 | 3V3_EXT | A22 / JPWR.2 | G21 / R5.2 | 26AWG | □
W029 | 3V3_EXT | G17 / R3.2 | G19 / R4.2 | 26AWG | □
W030 | 3V3_EXT | G17 / R3.2 | Q5 / R14.1 | 26AWG | □
W031 | 3V3_EXT | G19 / R4.2 | G21 / R5.2 | 26AWG | □
W032 | 3V3_EXT | G21 / R5.2 | G23 / R6.2 | 26AWG | □
W033 | 3V3_EXT | G23 / R6.2 | G25 / R7.2 | 26AWG | □
W034 | 3V3_EXT | G25 / R7.2 | G27 / R8.2 | 26AWG | □
W035 | 3V3_EXT | G27 / R8.2 | G29 / R9.2 | 26AWG | □
W036 | 3V3_EXT | G27 / R8.2 | O27 / R24.2 | 26AWG | □
W037 | 3V3_EXT | X2 / JMCP.1 | Q5 / R14.1 | 26AWG | □
W038 | 5V_LOGIC | A21 / JPWR.1 | G8 / U1.10 | 26AWG | □
W039 | 5V_LOGIC | G4 / U1.14 | I3 / C1.1 | 26AWG | □
W040 | 5V_LOGIC | G5 / U1.13 | G4 / U1.14 | 26AWG | □
W041 | 5V_LOGIC | G8 / U1.10 | G5 / U1.13 | 26AWG | □
W042 | VBAT_SW | A23 / JPWR.3 | X18 / JES.3 | 26AWG | □
W043 | VBAT_SW | X16 / JES.1 | X18 / JES.3 | 26AWG | □
W044 | DF_RX | X22 / JAUX.1 | O29 / R25.2 | 26AWG | □
W045 | ECHO_RAW | X12 / JACT.4 | K17 / R20.1 | 26AWG | □
W046 | ES1_BASE | L5 / Q1.B | K7 / R11.1 | 26AWG | □
W047 | ES1_BASE | L5 / Q1.B | O3 / R10.2 | 26AWG | □
W048 | ES2_BASE | L13 / Q3.B | K15 / R13.1 | 26AWG | □
W049 | ES2_BASE | L13 / Q3.B | O11 / R12.2 | 26AWG | □
W050 | HOLD_N | X29 / JAUX.8 | C29 / R9.1 | 26AWG | □
W051 | KILL_BASE | L9 / Q2.B | Q9 / R15.1 | 26AWG | □
W052 | KILL_BASE | M5 / Q1.C | L9 / Q2.B | 26AWG | □
W053 | KILL_BASE | M5 / Q1.C | U5 / R14.2 | 26AWG | □
W054 | MCP_RESET | X6 / JMCP.5 | C21 / R5.1 | 26AWG | □
W055 | NC1_RETURN | X17 / JES.2 | K3 / R10.1 | 26AWG | □
W056 | NC2_RETURN | X19 / JES.4 | K11 / R12.1 | 26AWG | □
W057 | PA0 | A4 / JCORE.3 | D5 / U1.2 | 26AWG | □
W058 | PA0 | D5 / U1.2 | C12 / R1.1 | 26AWG | □
W059 | PA15 | A11 / JCORE.10 | C25 / R7.1 | 26AWG | □
W060 | PA15 | X27 / JAUX.6 | C25 / R7.1 | 26AWG | □
W061 | PA4 | A10 / JCORE.9 | C23 / R6.1 | 26AWG | □
W062 | PA4 | X26 / JAUX.5 | C23 / R6.1 | 26AWG | □
W063 | PB1 | A16 / JCORE.15 | K21 / R21.1 | 26AWG | □
W064 | PB1 | O17 / R20.2 | K21 / R21.1 | 26AWG | □
W065 | PB10 | A12 / JCORE.11 | K29 / R25.1 | 26AWG | □
W066 | PB11 | A13 / JCORE.12 | K27 / R24.1 | 26AWG | □
W067 | PB11 | X23 / JAUX.2 | K27 / R24.1 | 26AWG | □
W068 | PB12 | A17 / JCORE.16 | A27 / JSW.1 | 26AWG | □
W069 | PB12 | A27 / JSW.1 | Q25 / R26.1 | 26AWG | □
W070 | PB13 | A7 / JCORE.6 | M13 / Q3.C | 26AWG | □
W071 | PB13 | M13 / Q3.C | O19 / R19.2 | 26AWG | □
W072 | PB14 | A18 / JCORE.17 | A29 / JSW.3 | 26AWG | □
W073 | PB14 | A29 / JSW.3 | Q29 / R27.1 | 26AWG | □
W074 | PB15 | A5 / JCORE.4 | D8 / U1.5 | 26AWG | □
W075 | PB15 | D8 / U1.5 | C14 / R2.1 | 26AWG | □
W076 | PB3 | A14 / JCORE.13 | K23 / R22.1 | 26AWG | □
W077 | PB3 | X24 / JAUX.3 | K23 / R22.1 | 26AWG | □
W078 | PB4 | A15 / JCORE.14 | K25 / R23.1 | 26AWG | □
W079 | PB4 | X25 / JAUX.4 | K25 / R23.1 | 26AWG | □
W080 | PB5 | A6 / JCORE.5 | Q13 / R16.1 | 26AWG | □
W081 | PB5 | Q13 / R16.1 | Q17 / R17.1 | 26AWG | □
W082 | SCL | A8 / JCORE.7 | C17 / R3.1 | 26AWG | □
W083 | SCL | A8 / JCORE.7 | X4 / JMCP.3 | 26AWG | □
W084 | SDA | A9 / JCORE.8 | C19 / R4.1 | 26AWG | □
W085 | SDA | A9 / JCORE.8 | X5 / JMCP.4 | 26AWG | □
W086 | SERVO_SIG_5V | X9 / JACT.1 | D6 / U1.3 | 26AWG | □
W087 | STBY_OUT | M9 / Q2.C | U13 / R16.2 | 26AWG | □
W088 | STBY_OUT | U13 / R16.2 | Q21 / R18.1 | 26AWG | □
W089 | STBY_OUT | X13 / JACT.5 | U13 / R16.2 | 26AWG | □
W090 | US_TRIG_5V | X11 / JACT.3 | D9 / U1.6 | 26AWG | □
W091 | WP_N | X28 / JAUX.7 | C27 / R8.1 | 26AWG | □

## 61.8 条件装配与外部线束边界 旧版归档

以下内容仅是旧洞洞板条件改线记录，不用于PCB A1。新板AHCT第3通道已经永久接PB9并使能，只按第63章设置JP3和R36/R37。不得在新PCB上执行以下五拆六增。

蜂鸣器需要5V高电平时：默认AHCT通道3的9脚接GND、10脚接5V_LOGIC，且这两个孔还承担网络中转。必须拆除它们原来的全部相关线，再补回其他节点间的电源或地连接；不能仅在原线之上叠接。已确认兼容3.3V控制的三线蜂鸣模块直接用PB9，不做本选配改线。

选配改线清单：先断电并拔下U1，拆掉IO-W005、W010、W011、W038、W041共5条默认线。另加D10→G12、D10→G6两根地旁路线，加A21→G5一根5V旁路线，保留原W039和W040。这样其他地和AHCT电源网络仍然连通。

然后另接G8→D10（U1第10脚/OE3接地），G9→核心PB9（第9脚A3），G10→蜂鸣IN（第8脚Y3）。这6条新增连接均用26AWG绝缘线；断电检查G9已不再接地、G8已不再接5V，G4/G5仍接5V、G6/G12仍接地。确认无电源短路后插回U1，再按步骤173检查不响偏置与上电默认状态。默认142条线只对应未启用本分支的布局。

编码器CLK/DT上拉只选一组：移除模块原上拉后装R22/R23拉3V3_CORE；或保留已确认拉3V3_EXT的模块上拉，不装R22/R23并验证电平。不能经两组上拉把两路3.3V稳压互接。I²C、RESET、片选和DHT上拉同样要计入模块已有元件。

三路普通按键与蜂鸣偏置、每个5V数字输入的条件适配、5V DHT的双向适配、MCP与DFPlayer就近去耦、全部外置模块连接，不包含在142条板内焊线中。只完成两块洞洞板不能视为完成全机接线。

## 61.9 外置模块接线与分阶段上电 旧版归档

### 01 这两块板怎样分工 旧版归档

1. PWR 与 IO 各使用一块 7×9 cm、2.54 mm 独立焊盘洞洞板。PWR 本次布置电源端子、滤波、电池 ADC 分压及照明 MOS 接口；IO 放缓冲、急停逻辑和信号汇总，电气网络不因换板改变。

2. 核心板、MCP23017 成品扩展模块、TB6612 驱动、降压及各传感器模块均外置固定。图中的接口是我们定义的板侧接口；请按信号名称逐根接模块丝印，不能按表格次序猜模块排针左右顺序。

3. 外置模块的供电范围、引脚顺序、已有上拉及芯片版本仍以实物资料和测量为准；模块上的 VCC 标签不能单独证明可接 3.3 V 或 5 V。

### 02 两板图以外仍须接好的线和小元件 旧版归档

1. 本次孔位图仅固定板上通用电路；下面这些工作在外置模块、绝缘小接线片或线束侧完成，不能因图上没有焊位便省略。

2. MODE、BACK及编码器SW分别需要到3V3_EXT的约10 kΩ上拉，或使用原手册允许且已验证的MCP内部上拉；PB9蜂鸣控制另有按有效极性选择的10 kΩ偏置。三路普通按键与蜂鸣的电阻不在当前两板孔位清单内。

3. 每个实际5 V数字输出的NPN适配、需要5 V的DHT双向BSS138适配，以及MCP/DFPlayer的就近去耦均在模块侧补齐。5 V模拟光敏量不套用数字NPN。

4. SPI的SCK/MISO/MOSI直接在核心与RC522/FLASH线束分接；MCP的GPA0至GPA6和GPB0至GPB6按功能直接接外部模块/按键，其中GPA5去PWR灯输入。MCP的五线板侧接口只负责电源、I²C及复位，并未包含这14条功能线。

5. PA8/PA11到电机PWM、PA2/PA3到HC-05、PA9/PA10到电脑串口、PB8到前障碍、PA12到投放以及PB0到光敏，均按文字净表连接，不是未使用引脚。PA13/PA14的SWD直接保留到核心。

6. 电源分支到外置模块时连电源和GND两根；信号排针上的GND只作参考与小电流回路，电机/舵机功率回流直接回PWR。

### 03 电源与两路 3.3 V 旧版归档

1. 成品带保护 2S 电池正极依次经过 3 A 初选保险、总开关到 BAT_SW；BAT_SW→BUCK_IN→外置降压输入，降压输出返回 BUCK_OUT。满电 8.4 V 不能进入 5 V 支路。

2. 降压先单独调至 5.00 V。MOTOR、SERVO、LOGIC 从同一配电点分别引出正线和回流线；它们是独立走线支路，不是三组隔离电源。电机、舵机电流不经过 IO 板、核心板或普通杜邦电源线。

3. 外置 3.3 V 稳压以 5V_LOGIC 供电，输出 3V3_EXT，仅经小电流排针供外设；3V3_CORE 来自核心板，供规定输入上拉。两路 3.3 V 不直接相连，公共 GND 相连。

4. 本次孔位图的电池、5 V 输入与星形配电主干按 20 AWG 绝缘线施工；外接短电机/舵机支路可用 22 AWG。电容支线按图标示的 22/26 AWG 施工，不以细焊锡桥替代粗铜线。1000 μF 靠舵机电源接口、470 μF 靠驱动电源接口、100 μF 靠逻辑/DFPlayer入口；电容若离实际负载很远，不能仅凭 PWR 板已有电容便省掉负载端去耦。

### 04 PWR 两根连续汇流铜线的具体施工 旧版归档

1. PWR 焊接面增加两根直径 0.8 mm 镀锡实心铜线：正汇流线沿 V 列，从 V3 连续到 V9，在 V3/V5/V7/V9 固定；负汇流线沿 X 列，从 X3 连续到 X11，在 X3/X5/X7/X9/X11 固定。所有孔号始终使用元件面定义的编号，焊接面左右镜像，不重新编号。

2. 清单中的 PWR W001～W003 表示一根连续正汇流线的三段，W004～W007 表示一根连续负汇流线的四段；实际只做两根铜线，不要剪成七根短线。铜线贴焊接面固定；仅在指定焊盘和支路线端处焊接，不把相邻焊盘任意锡连。

3. BUCK_OUT 的 R3 正端只焊一根 20 AWG 绝缘线到 V3，T3 负端只焊一根 20 AWG 到 X3。MOTOR、SERVO、LOGIC 的正支路分别由 V5/V7/V9 引出，负支路分别回 X5/X7/X9；X11 单独回电池 GND。把支路线的剥皮端搭焊到对应汇流节点，不把多根粗线挤入同一个洞洞板孔。

4. 汇流线以外的每条跨接线均使用绝缘线，仅两端剥皮焊接。与汇流铜线交叉的导线须保留完整绝缘，必要时加热缩管或垫绝缘片；交叉位置不是电连接。完成导通、对地短路及拉力检查后，再用可靠绝缘罩或绝缘材料覆盖两根裸汇流线。

5. CP1/CP2/CP3 电解电容的引脚排在第 17 行，CP4/CP5/CP6 的 100 nF 电容排在第 21 行。电解正脚接支路正极、负脚接 GND；先核实实际直径、脚距及端子壳体空间，再折脚装入，不能让壳体挤压绝缘线或把相邻焊点顶在一起。

### 05 核心板、下载器和电脑串口 旧版归档

1. 核心板脱离教学大底板后，5V_LOGIC 接核心 5 V 输入，GND 共地。只禁用 JTAG，保留 SWD，释放 PA15、PB3、PB4。

2. SWDIO→PA13、SWCLK→PA14、GND→GND，可选 NRST。只有真正的 VTref 输入才按下载器说明接 3V3_CORE，不把下载器电源输出并入本机稳压。

3. 电脑 USB 串口 TXD→PA10、RXD→PA9、GND共地，供电脚均不接；先确认 TX 高电平约 3.3 V。核心 USB 数据口不用，PA11/PA12 已用于电机 PWM 和投放检测。

4. 通电调试时先建立本机逻辑供电，再接外部通信；单独断开核心电源时，先断串口 TX、ADC 采样线及其他可能向未供电核心送电的信号。

### 06 MCP23017、OLED 与 MPU6050 旧版归档

1. PB6=SCL、PB7=SDA，共享至 MCP、OLED、MPU，公共 GND；两根线的有效上拉各约 4.7 kΩ，均拉 3V3_EXT。已有模块上拉要计入，不能每块模块再无条件叠加一组。

2. MCP 使用 3.3 V 逻辑供电，A0/A1/A2 按模块标识接地，地址 0x20；RESET 以约 10 kΩ 拉 3V3_EXT，测试点可短到 GND，不能与核心 NRST 并接。INTA/INTB留空；GPA7/GPB7设置为输出0且不接外线。

3. MCP 的 GPA0/1/2/3→电机 AIN1/AIN2/BIN1/BIN2，GPA4→RC522 RST，GPA5→PWR 的灯控制，GPA6←语音 BUSY；GPB0/1/2←循迹左/中/右，GPB3←靠近，GPB4←编码器按键，GPB5/6←MODE/BACK。

4. OLED须确认是支持3.3 V的I²C版本。MPU的VIN按其原稳压路径接5 V或已确认的3.3 V节点；无论VIN怎样供电，SCL/SDA都不得被拉到5 V。MCP模块和AHCT芯片各自附近需100 nF去耦。

### 07 RC522 与 FLASH 的 SPI 旧版归档

1. PA5→两模块 SCK/CLK，PA6←两模块 MISO/DO/SO，PA7→两模块 MOSI/DI/SI；共用这三线及 GND。

2. PA4只接RC522 SDA/SS，PA15只接FLASH CS；两路片选各约10 kΩ上拉3V3_EXT。RC522上标SDA的脚在本方案中是SPI片选，不接PB7。

3. RC522和已确认的3.3 V SPI NOR FLASH供电均为3V3_EXT；RC522 RST接GPA4，IRQ留空。FLASH WP#/HOLD#若引出且未已有合适上拉，按实际芯片资料处理。

4. 首版总线线束尽量不超过20 cm，配地线，远离电机线；分别读ID通过后才共享使用，任意时刻只拉低一个片选。

### 08 所有数字传感器先确定输入适配方式 旧版归档

1. 循迹L/C/R→GPB0/1/2，靠近→GPB3，前方障碍→PB8，投放对射→PA12，DFPlayer BUSY→GPA6；光敏仅有DO时才另使用PB0数字输入。

2. 确认输出只有0/3.3 V时，可接目标输入，必要时串1 kΩ；确认是无5 V板载上拉的开集/开漏输出时，可用10 kΩ上拉3V3_EXT后接目标输入。

3. 需要5 V供电且输出高电平或板载上拉为5 V时，每路用：DO→10 kΩ→2N3904 B，B→100 kΩ→GND，E→GND，C→目标输入，C→10 kΩ→3V3_EXT。这个电路反相，软件必须记录输入极性。

4. 每路只选一种路径，不能同时接直通跳线和NPN适配。先不接MCU/MCP测输出，目标低电平应低于0.3 V、高电平约3.3 V；不要把ECHO分压普遍套到弱上拉数字模块。

5. PA12还要检查核心板USB已有上拉及拉低能力；投放采用普通输入轮询，不占PB12使用的EXTI12。

### 09 编码器、模式按键、碰撞和闭盖 旧版归档

1. 编码器确认支持3.3V后，VCC→3V3_EXT，CLK→PB3，DT→PB4，SW→GPB4，GND共地。CLK/DT只保留一组已核对电源轨的上拉：模块自带上拉拉3V3_EXT时不装IO的R22/R23；移除模块上拉后才用R22/R23拉3V3_CORE。SW约10kΩ拉3V3_EXT或使用已验证的MCP内部上拉。

2. MODE、BACK分别接GPB5、GPB6，另一端GND，各约10 kΩ拉3V3_EXT。四脚轻触开关先测内部连通组，只跨按下才导通的两组接线。

3. 两只碰撞微动用NC串联：GND→左COM，左NC→右COM，右NC→PB12；PB12约10 kΩ拉3V3_CORE。正常0，碰撞或断线1。

4. 闭盖微动用COM/NO：COM接地，NO接PB14，PB14约10 kΩ拉3V3_CORE。机械完全闭盖压下时才读0，开盖或断线读1。

### 10 急停两组NC与三个三极管 旧版归档

1. 急停两组NC独立：VBAT_SW分别经过NC1/NC2和各自4.7 kΩ到QES1/QES3的B；三只2N3904的E接GND，各B以100 kΩ下拉。

2. QES1的C接QES2的B形成KILL_BASE，KILL_BASE经4.7 kΩ拉3V3_EXT。QES2的C形成STBY_OUT；PB5经1 kΩ到STBY_OUT，PB5和STBY_OUT分别10 kΩ下拉GND。

3. QES3的C接PB13，PB13以10 kΩ拉3V3_CORE。正常释放PB13低；按下或反馈线断开PB13高。电池电压只到接点偏置电阻，不直接到GPIO。

4. 先拔电机和舵机，以6.0/7.4/8.4 V逐点检查；按住急停并让测试固件PB5=1，STBY_OUT仍须低于0.3 V。恢复接点后仍须人工确认与新运动命令，不能自动行走。

5. 该电路需要核心和EXT逻辑电源正常；EXT失电不应允许MCU持续输出驱动高电平。STBY是待机去驱动而非机械制动，不能将其等同工业安全继电器。

### 11 AHCT缓冲、舵机与HC-SR04 旧版归档

1. SN74AHCT125N的14脚接5V_LOGIC、7脚接地并近接100 nF。1/4脚使能端接地；PA0→2脚、3脚→SG90信号；PB15→5脚、6脚→HC-SR04 TRIG。PA0/PB15各10 kΩ下拉。

2. 未用通道默认10/13脚接5 V，9/12脚接地，8/11脚输出留空。采用蜂鸣5 V缓冲分支时必须按对应说明移除原短线再更改，不能把PB9短接到GND。

3. HC-SR04 VCC为5V_LOGIC，ECHO经12 kΩ到PB1节点，节点再经20 kΩ到地；5 V输入理论约3.125 V，不互换上下臂，不在节点加大滤波电容。

4. SG90红线从PWR独立SERVO支路取5 V，棕/黑接地，信号来自AHCT的3脚；不把舵机供电穿过IO信号排针。先去掉摇臂空载验证，再装连杆；开盖运动与轮电机分时互锁。

### 12 轮电机和TB6612 旧版归档

1. 已核实TB6612驱动：VM取PWR的MOTOR支路，VCC取3V3_EXT，GND共地；GPA0/1/2/3接AIN1/AIN2/BIN1/BIN2，PA8/PA11接PWMA/PWMB，STBY只接STBY_OUT。

2. AO1/AO2到左电机，BO1/BO2到右电机；每只电机两端跨100 nF，电源成对走线，方向用架空测试确定，不能调换VM与GND。

3. 先架空只接一轮，低PWM起转，再接另一轮；换向先PWM=0、STBY=0并等待约100 ms。核对实际堵转电流与驱动能力，原套装风扇电机不当车轮电机。

### 13 DHT11、光敏与PWR板电池ADC 旧版归档

1. 额定支持3.3 V的DHT：VCC→3V3_EXT，DATA→PB11并以4.7 kΩ拉3V3_EXT，GND共地；如模块已有上拉计入总值。PB11以开漏方式拉低和释放。

2. 额定需5 V的DHT不能使用上述单向NPN适配；采用确认支持开漏双向信号的BSS138模块，HV→5 V、LV→3V3_EXT、共地，DHT DATA接HV通道，PB11接对应LV通道，并核两侧上拉。

3. 已确认3.3 V光敏模块的AO接PB0模拟输入；只有DO则改走数字适配分支，AO和DO不并接。实际5 V模拟输出需重新确定模拟分压与标定，不能通过开关NPN测模拟量。

4. PWR电池分压保持VBAT_SW→33 kΩ→BAT_ADC，BAT_ADC→10 kΩ与100 nF并联到GND，再接PA1。8.4 V时约1.953 V；采样线与地线成对并远离大电流铜线。建议使用可拔的ADC信号连接，单独断核心电源前先拔该线。

### 14 PWR照明MOS、蜂鸣器与语音 旧版归档

1. 照明控制来自GPA5，经100 Ω到AO3400A的G；G经100 kΩ接地，S接地，D接白LED负极；5V_LOGIC经220 Ω到LED正极。PWR必须与IO共地，GPA5线只带栅极信号。

2. AO3400A原器件1G/2S/3D；转接板排针顺序要导通实测，不能按模块图片猜。它只驱动小LED，不承担舵机或轮电机供电。

3. 蜂鸣三线模块确认3.3 V控制兼容后IN接PB9，电源按额定。PB9以10 kΩ偏置到不响电平：高有效下拉地、低有效上拉3V3_CORE；两者不能同时装。

4. 若蜂鸣需要5 V输入，启用AHCT通道3：移除9脚接地和10脚接5 V原线，9脚接PB9、10脚接地、8脚接IN。裸两脚蜂鸣器另需经已核电流的驱动级，不能直接接GPIO。

5. DFPlayer VCC→5V_LOGIC，PB10经1 kΩ到RX，TX不用；BUSY按数字输入适配到GPA6。模块附近并100 μF和100 nF；喇叭跨SPK1/SPK2，两端都不接GND。

### 15 HC-05、原有备用模块和接口余量 旧版归档

1. HC-05带明确支持5 V的稳压底板才接5V_LOGIC；裸模块按其额定接3V3_EXT。RXD→PA2，TXD→PA3，GND共地，KEY/STATE留空。串口逻辑按3.3 V核验。

2. PA2已是3.3 V信号，不再随意串5→3.3 V分压把它降低。电脑CSV导出复用PA9/PA10外置USB串口。

3. 现有单路循迹、热敏模块、风扇电机和教学大底板作为独立实验备件；如临时替代通道，应断电拆原模块并记录，不能把两个输出并到同一输入。

### 16 焊接与镜像顺序 旧版归档

1. 先确认独立焊盘及孔距，按元件面标基准角和孔号；翻到焊接面按图左右镜像，仍使用同一实物孔号。先放端子、IC座、低矮电阻，再放电容和转接板；AHCT芯片最后插入。

2. 2N3904按到货厂家脚图确认E/B/C，AO转接按导通追踪G/S/D；未知实物不要按外壳平面方向强套。每焊完一小电路就按同网节点检查。

3. 跨越其他网络使用绝缘导线，交叉不代表连接；连接点才焊在同网焊盘。电源粗线单独固定，裸露焊点与板下螺钉/底板保持绝缘距离。

4. 两面完成后先不接任何模块，查5 V、EXT3V3、CORE3V3与GND无持续短路，查CORE/EXT没有直接连通，查所有原设计留空输出没有被误接地。

### 17 按阶段上电验收 旧版归档

1. 先只接限流电源与降压，测7.4/8.4/6.6 V输入时的5 V输出，再按原手册完成0.2/1/2/3 A分级与短峰值负载测试；没有实测不能把模块宣传峰值当持续额定。

2. 第二阶段只给逻辑上电，测5V_LOGIC、3V3_EXT、3V3_CORE；逐一接核心、MCP、OLED、SPI模块，每增加模块先断电。I²C空闲约3.3 V，片选默认高。

3. 第三阶段逐路测开关/数字输入、ADC约1.95V@8.4V、ECHO分压约3.125V@5V、AHCT两路输出及急停钳位；输入适配电路应先测再接MCU/MCP。

4. 最后接驱动、架空轮组及空载舵机，分开验证，再装机械负载；运行中记录5 V最低值及复位情况。发现异常先断电并回退到上一通过阶段。

5. 电池≤7.0 V持续3 s提醒，≤6.6 V持续1 s锁停，≤6.0 V立即停；恢复≥7.0 V仍需人工确认与新命令。单次上电成功不代替满载30分钟及断线故障试验。

## 61.10 文件和本次修订记录 旧版归档

2026年10月12日归档：旧图、孔位表及142条焊线不用于PCB施工。A1位号、AHCT接法和制造文件见第63章；设计检查不代替实物验收。

# 62 木板与PVC板裁剪图解

本章对应原步骤015—020、036—039、050—059。先完成纸样和材料核对，再切外形，最后按实物确定安装孔。各图均为尺寸示意，单位为mm；按标注数值量取，不能按图片或打印后的大小直接描边。

木件使用两张300×300×5胶合板；固定桶壳与附件使用3mm PVC发泡板（雪弗板）；活动盖使用另购的2mm PVC发泡板。1mm PP板是内胆材料，不替代本章PVC板。现有3mm PVC共两片，按排料图使用并保留剩料。

材料与零件 | 成品或毛坯尺寸 | 数量 | 加工要求
5mm木板 P01底板 | 280×220 | 1 | 外形切准，四角去锐边约C2
5mm木板 P02上平台 | 240×190 | 1 | 安装时相对P01偏移(20,15)
5mm木板 舵机立架 | 60×190 | 1 | 排料时可旋转；装机时190为高
5mm木板 调节托片 | 约80×40 | 1 | 外形毛坯；安装/检修孔先试装
3mm PVC P03左右侧壁 | 160×180 | 2 | 180为竖直高度
3mm PVC P04前后壁 | 144×180 | 2 | 夹在侧壁之间，不切成150宽
3mm PVC P05壳底 | 154×144 | 1 | 嵌在四壁内，底面与壁板底缘齐平
3mm PVC P07操作板 | 190×120毛坯 | 1 | 按实际模块开窗、避让开盖空间
3mm PVC P08超声横梁 | 150×35毛坯 | 1 | 可拆装；传感器与端耳按实物定孔
3mm PVC P10触边横杠 | 约180×25毛坯 | 1 | 需配导向与固定限位，非承重件
3mm PVC 固定后压条 | 约150×10～12 | 1 | 先留毛坯，按铰链让位修边
2mm PVC P06活动盖 | 160×150 | 1 | 裸盖目标≤30g；活动总成目标≤40g、上限45g

转接片、角码配合片、三角撑和局部补强均从余料加工，形状与孔位按实际轮组、舵机、铰链和安装空间确定。本章不把尚未量到的孔距作为加工尺寸。

## 62.1 两张木板怎样排料

两张300×300×5毫米木板精确排料，第一张含280×220底板、190×60旋转立架及80×40托片，第二张含240×190上平台与保留余料；附排料原点与成品坐标表。

图解 40 两张木板排料：沿成品线外侧锯切，5 mm 留缝属于废料。

先把所有矩形完整画在两张木板上，写零件名称及尺寸，再检查是否超出原料边界。图中约5mm的边距和零件间隙是给切削与修边留的废料，不是要求锯片宽5mm。保留成品线，锯路放在废料一侧；切完再修到尺寸。

第一张板可把190×60立架横放在底板旁的余料带，再排80×40托片。300−220=80只是未扣边距与间隙的理论余量；应以图中的完整矩形位置为准。第二张板先切上平台，剩余区域留作转接片与三角撑。

## 62.2 底板与上平台怎样标孔

P01和P02俯视图及H1至H4坐标表，精确四柱孔径3.4毫米，展示P02相对P01的20和15毫米偏移，电机、万向球与桶壳以虚线试摆区域区分，绑带与模块安装孔按实物。

图解 41 四柱孔位与配钻：两板局部坐标不同，其他安装孔按实物描出。

万向球轮已知安装高度20mm；若底板底面离地按参考45mm，需约25mm刚性补高，此数包含转接板、垫块及平垫的总厚度，不能另加一层后仍按25mm计算。补高后的实际水平须实测。球直径15.85mm不能代替安装高度。若改为PCB，电子板安装孔应等新PCB确定后再钻。

## 62.3 3mm固定壳体怎样排料

第一片500毫米正方形板内排两侧壁160乘180、两前后壁144乘180、壳底154乘144、操作板190乘120、超声横梁150乘35、约180乘25触边横杠及150乘12固定条预留毛坯，间距和边距至少5毫米。第二片保持整张。

图解 42 3 mm 发泡 PVC 排料：全部主要板件可在第一片裁出，第二片保留试切、补强和重做。

确认实物是3mm发泡PVC，再按图划成品矩形。两侧壁和两前后壁分别标号；前后壁144mm这条边沿Y，180mm这条边竖直。操作板、横梁和触边横杠是毛坯，先不切传感器孔或开关孔。

薄板放在平整垫板上，用夹具固定直尺，多次浅划或使用合适细齿锯；手放在刀路外。长边先切、细条后切，窄件保持有足够夹持区，切后用细砂纸修平。不能边手托悬空板边切。

## 62.4 四壁与壳底怎样扣除板厚

俯视外长160外宽150，四周壁厚3，内底154乘144。剖面壁高180，底板厚3嵌在壁内，底面与壁板底缘共同落在木平台P02上，外高不增加。

图解 43 桶壳拼接关系：144 mm 前后壁夹在侧壁之间，154×144 mm 底板嵌入，底面与四壁底缘齐平。

两块160×180侧壁覆盖前后壁的端面。外宽150扣掉两侧各3mm，得到前后壁宽144；外长160扣掉前后各3mm，得到内部长度154，所以壳底为154×144。四壁外包络为160×150×180，上口净空为154×144。

先不加胶，用胶带临时拼好四壁，再试放壳底、内胆与横梁。理想外矩形对角线约219.3mm，内口约210.8mm；同一矩形两条对角线差目标不超过2mm，再检查四角。切口不方正时先修边，不靠大胶缝凑尺寸。壳底按实际内口逐边试修，以可平放取出为准，不强挤。

若实测板厚不是3mm，本图扣厚结果也会变化。保持外形时，前后壁宽=150−2t，壳底长=160−2t、宽=150−2t；先按实测t重画纸样，不能继续机械照抄144与154。

## 62.5 2mm活动盖怎样裁剪

200乘200乘2毫米发泡PVC裁160乘150活动盖。闭盖长边沿X，盖轴参考X75前缘X235，壳体后缘X70前缘X230，后固定条先试X64至74留约1毫米缝；固定条不会随盖运动。裸盖目标不超过30克，活动总成目标40克以内、上限45克。

图解 44 2 mm 活动盖与3 mm 后固定条分开裁制，闭盖覆盖和铰链让位先试装，再按实物钻孔。

从200×200×2板材中裁160×150活动盖，160沿车头车尾方向。修去毛刺后称裸盖，目标不超过30g；暂不钻铰链孔及侧臂孔。剩下的2mm料可做必要的轻量局部加强。

后固定压条使用3mm料，安装在固定壳体上，与活动盖分开。盖轴参考X=75、前缘约X=235，固定壳后缘X=70；压条参考X=64～74，实际须按铰链轴桶与叶片让位。它不随盖转动，不应挡住维护开盖或承担连杆转矩。

铰链、侧臂和舵机全部试摆并验证运动后，再描孔。正常开盖70°，维护需先断执行电源并拆一端拉杆。活动盖、随盖侧臂、加强片、活动铰链部分及紧固件合计实称目标≤40g、上限45g；图纸尺寸本身不能证明重量达标。

## 62.6 实际施工顺序与复核

1．对照零件表把原料分成5mm木板、3mm发泡PVC、2mm发泡PVC三堆。逐片测长宽和厚度，检查翘曲、缺角；写清材料与厚度，避免把固定壳材料拿来做活动盖。

2．先制作底盘、桶壳与盖的纸样。把实际电池、轮组、模块和舵机放上去，确认结构、插头方向、螺丝刀空间及内胆取出通道。

3．在原料上画完全部零件后再切。画成品实线、废料斜线，量两次尺寸；按图留边和间隙，确认锯缝处在废料内。每切下一件就写编号，不让余料与正式件混放。

4．先裁木板和PVC外形，再修边、量成品尺寸及对角线。一般外形目标误差约±1mm，嵌入壳底须按实际内口逐边试修，不以这个公差强行塞入；桶壁高度要一致。木板边去锐角，PVC切面修平，孔口和绑带槽不得有刮线毛刺。

5．只先加工已确定的四立柱孔。平台试装调平后，用实物转接片描电机/球轮孔，用实物电池描绑带位置。参考槽尺寸不是固定位置，任何孔槽都要避开立柱、板边薄弱处和其他螺钉。

6．桶壁无胶试拼、壳底试放，核对160×150外形及154×144净口。先放入内胆再确定附件位置；护线圈按所购件要求的安装孔开孔，穿线内径不是安装孔径。

7．试装后固定压条和活动盖，校准两铰链同轴。舵机托片先夹紧，按真实轴距50mm与高度描孔；后立柱螺钉附近预留检修开口，不把立架/托片压在不可拆的位置。

8．清理切屑后再装电子器件。记录切件尺寸、孔位更改、底板离地高度和活动盖总质量。完成无电机械试验，才按原手册继续单模块和整机调试。

合格记录：两板不翘曲，四立柱不强拉；桶壳方正且内胆可取出；盖运动无卡滞且质量达标；未知模块孔已按实物核对。此图解是设计与施工参考，仍需实际装配验证。

# 63 PCB A1手焊装配与模块连接（旧版参考）

本章是A1旧版参考；B1施工入口见第67章。用一块SmartBin_A A1裸PCB替代原PWR与IO两块洞洞板，复用已购买的直插件和成品模块，保留原33项功能与330步骤的调试顺序。板内连接由PCB铜箔完成，模块之间仍可使用短杜邦信号线。

本次设计包含37个电阻焊位、8个电容、3只2N3904、1只AHCT、33组外接接口、8组跳帽/测试接口和4个安装孔。条件焊位不一定全部装，R36/R37互斥。板上没有STM32、MCP、RFID或降压芯片；这些模块继续在板外。

第61章及图解36—39保留为旧版归档，不能照其A—X孔号补飞线，也不能执行五拆六增。本板U1第3通道已永久接PB9并使能，用JP3选择蜂鸣控制电平。机械部分继续用第60、62章。

原步骤中的5V_MOTOR、5V_SERVO、5V_LOGIC表示三条用途不同的供电支路，在A1电气网络中都属于5V_BUS。它们必须按J4/J5/J6分开接线，不能把“同网”理解成电机电流可穿过任意小信号线。

## 63.1 先辨认板子与已有配件

PCB规格为100×100mm、双层、1.6mm厚、1oz铜。四个M3孔为3.2mm非金属化孔；以元件面左上板角为原点，孔中心为(5,5)、(95,5)、(5,95)、(95,95)mm。按板上A1版号和真实制造文件核对，不能用旧V2.1的Gerber。

SmartBin_A A1元件面，按实际位号装件及辨认接口一脚

图解 45 PCB元件面装配总览

元件从器件面插入、在另一面焊接。翻板后左右改变，但编号仍指同一物理孔；正反图不可再次自行镜像。板上“PIN 1=SQUARE PAD”只用于J/JP接口；电解电容必须按“＋”确认正脚，不凭轮廓形状判断极性。

SmartBin_A A1从焊接面观察的实际PCB，接口编号与元件面相同

图解 46 PCB焊接面与翻板方向

先拿实物空插，不急着焊。轴向电阻脚距10.16mm、目标本体不大于6.3×2.5mm；DIP14插座排距7.62mm；电解预留5mm脚距、最大直径12.5mm；瓷片电容5mm脚距。J1—J6采用Phoenix库的2P端子几何：孔距5.08mm、钻孔1.3mm、包络约11.22×11.125mm。复用已有KF301，核实引脚能穿孔、相邻外壳不挤、进线朝板边且螺丝刀可操作；不要求重买Phoenix品牌。

### 裸PCB怎样下单

上传本次A1制造包Gerber_RS274X.zip，按100×100mm、2层、1.6mm、1oz、普通FR-4喷锡板核对。只做裸PCB，不选SMT/PCBA或钢网，不需要提交贴片坐标CPL。BOM留作自己装件核对，不把它作为自动代贴采购单。

只装配一台；实际起订片数和优惠以裸板下单界面为准，不受先前SMT页面“至少2片”限制。平台若按多片一批制作，多余裸板可留备份，不必给每块板都买元件。先看生产预览：尺寸、闭合板框、4个安装孔、排针/端子孔和正负极标记均与本次A1一致，再确认报价。

本版规则：最小线距0.20mm，信号线通常0.30mm、局部0.25mm；常规过孔外径0.8mm/钻孔0.4mm，铜到板边至少0.5mm。电源铜宽由实际布局单独决定，不能用信号线宽概括。修改板图后须重新运行DRC并重新导出制造包。

### 已有配件与少量补料

物品 | 本板需求 | 处理方法
电阻 电容 三极管 AHCT | 37R焊位、8C、3Q、1U | 优先从原采购包分拣，条件位按63.3决定
DIP14座 | 1只 | BOM中U1_SOCKET为附件行；先焊座，再插1颗U1，不是两颗芯片
KF301-2P 5.08mm | 6只 | 用原已购件；脚形或外壳不符先处理
2.54mm单排针 | 本板169针 | 至少5条40Pin，可剪短；已有不足才补
2.54mm跳帽 | 运行最多约7只 | 建议备10只；JP10正常不装
裸PCB | 装配1块 | 下单数量按平台；多余板留备份，不重复买模块
AO3400A与SOT23转接板 | 原各1只/块 | 单独焊好，核G/S/D后接J28
洞洞板 0.8mm裸铜线 | 本板不用 | 已买留备用，不再焊旧汇流线

初步新增预算仍按裸PCB、自焊配件补缺及普通物流约20—60元考虑，不含焊接工具和已经买好的模块；这不是下单实时报价。尺寸、数量、运费和优惠以实际制造订单为准。

## 63.2 裸板到手后的焊接顺序

1．准备烙铁架、镊子、斜口钳、助焊剂、焊锡、万用表和放大镜。桌面放绝缘垫，板上不接电池、USB或外置模块。把U1芯片单独收好，先不插座。

2．对照位号分拣电阻，把33k、12k、20k与其余阻值分开；用万用表确认。R1/R2电池分压和R25/R26超声分压采用1%精度。把待定/DNP电阻另放一格，避免先全焊再返工。

3．先装固定电阻。弯脚处离本体留余量，不扯根部；从元件面插入，翻面固定。加热焊盘和引脚后送少量锡，焊锡润湿两者；冷却后剪去多余脚，不能让残脚碰邻焊盘。

4．装C4—C8五只100nF瓷片电容，无正反。C7属于ADC滤波，C8属于U1去耦，按位号放置；不要因容量相同漏掉其中一只。

5．插DIP14座，缺口与丝印一致。先焊对角两脚，回元件面看座是否贴平，校正后焊余脚。再查相邻14脚无锡桥，芯片仍不插。

6．装Q1/Q2/Q3。依据所购品牌资料辨E/B/C，再对应板1E/2B/3C。不能只看外壳平面；需交叉引脚时先套绝缘管并保持间隙，不强挤管脚。

7．焊J1—J6电源端子，进线口朝板外。焊一脚、看贴平及方向，再焊另脚。端子大铜面吸热较多，应确保焊盘和脚同时润湿，不能仅在脚上结锡球。

8．按接口长度裁排针，169针只统计本PCB，不含模块原排针。接口短段逐个对位；先焊一端，校正垂直，再焊其余脚。写清J号与1脚，JP3—JP10不要先全套跳帽。

9．最后装C1=470μF、C2=1000μF、C3=100μF。负极条纹对应GND，1脚为正；实物脚距不同用短绝缘引线并机械固定，不能靠细脚悬挂大电容。

10．单独完成AO3400A转接板。固定一脚后核方向，再焊其余两脚；按AOS脚图1G/2S/3D追踪到转接排针。给线端写G/S/D，不把商品转接板直接当J28同序插座。

11．放大检查每个焊点和引脚，清除助焊剂残留按其说明处理。拍元件面、焊接面照片；对照BOM逐个打勾，再做63.6断电检查。

### 电气件按值分拣表

器件与值 | 焊位 | 位号
电解电容 470uF/16V | 1 | C1
电解电容 1000uF/16V | 1 | C2
电解电容 100uF/16V | 1 | C3
瓷片电容 100nF | 5 | C4、C5、C6、C7、C8
电阻 33k | 1 | R1
电阻 10k | 20 | R2、R6、R7、R10、R11、R12、R13、R14、R22、R23、R24、R27、R28、R31、R32、R33、R34、R35、R36、R37
电阻 100 | 1 | R3
电阻 100k | 4 | R4、R16、R18、R20
电阻 220 | 1 | R5
逻辑芯片 SN74AHCT125N | 1 | U1
电阻 4.7k | 6 | R8、R9、R15、R17、R19、R29
电阻 1k | 2 | R21、R30
电阻 12k | 1 | R25
电阻 20k | 1 | R26
三极管 2N3904 | 3 | Q1、Q2、Q3

表中的数量是焊位数，不是无条件实装数。37个电阻位含R37备用偏置；R36/R37只能装一个，其他条件上拉由下一节确定。板外传感器适配、MCP和DFPlayer就地去耦、电机抑制电容仍需保留，不能用本表49个电气焊位代替整机BOM。

## 63.3 条件电阻和跳帽先记录再安装

DNP意为该位置暂不装，不是该信号可以没有上拉。先确认模块已有电阻、电源电压和输出类型，再填写实际选择。每个三针选择端子只用一个跳帽：短1—2或2—3，不能两边都短。

位置 | 何时安装或设置 | 记录
R8/R9 4.7k | I²C已有模块上拉时核并联值；全无上拉时必须装。只拉3V3_EXT。 | _____
R10 10k | MCP RESET默认装；模块已有合适同轨上拉可核后不装。 | _____
R11/R12 10k | RC522/FLASH片选默认装；同轨已有适宜上拉可核后不装。 | _____
R13/R14 10k | 只在FLASH相应脚外露且缺同轨上拉时装。 | _____
R27/R28 10k | 移除编码器原上拉后才装至CORE；保留模块EXT上拉则两只均不装。 | _____
R29 4.7k | DHT低压侧须有效上拉，模块/BSS138已有合适上拉则不重复。 | _____
R33 10k | 编码器SW缺模块上拉、且未验证MCP内部上拉时装。 | _____
R34/R35 10k | MODE/BACK默认安装，低有效。 | _____
R36/R37 10k | 高有效：R36装/R37空；低有效：R36空/R37装。不得同时装或同时空。 | _____

### 供电与信号跳帽

跳帽 | 默认状态 | 运行设置
JP3 蜂鸣信号 | 开 | 1—2为PB9直出；2—3为AHCT 5V输出
JP4 蜂鸣电源 | 开 | 按模块额定：1—2=3V3_EXT，2—3=5V
JP5 MPU电源 | 开 | 按模块实际VIN选择3.3V或5V；I²C仍为3.3V
JP6 HC05电源 | 开 | 按裸模块/带稳压底板规格选电源；UART仍为3.3V
JP7 DHT电源 | 开 | 3.3V用1—2；5V用2—3并满足JP8条件
JP8 DHT直连 | 开 | 仅3.3V安全分支闭合；5V分支必须开，接J23转换
JP9 ADC连接 | 闭合 | 正常装帽；核心单独失电前隔离ADC，见供电边界
JP10 MCP复位 | 开 | 只临时短接作复位测试，不长期留帽

JP1与JP2位号刻意空缺，不是漏焊。即使蜂鸣器不用，也保留R36或R37其中一只，使常使能的AHCT第3路输入有确定电平。低有效模块改偏置前必须断电；软件初始化保持不响电平。

## 63.4 板外电源和模块怎样连接

2S电池经保险开关到外置降压，5V回PCB后分电机舵机逻辑支路；CORE与EXT不并联

图解 47 板外保险开关降压与三支路配电

1．总开关断开，电池暂不插。保护电池正极经板外保险座和总开关到J1.1，负极到J1.2。J2.1/2去降压IN+/IN-；降压应先离板调到5.00V，测好后再把OUT+/OUT-接J3.1/2。电池8.4V绝不能误接J3。

2．J4.1/2接TB6612 VM和动力GND；J5.1/2接SG90正负电源；J6用于逻辑独立分支，DFPlayer电源从这里用合适线径接出。正负均成对走，不能让电机或舵机回流串经核心地线。

3．主电源走20AWG短线，电机/舵机短支路22AWG，长度或压降增加时用20AWG。电池、降压、电机、舵机和喇叭电流不经普通杜邦线。接口信号才用已有10—20cm杜邦线，插好后适度固定。

4．外置3.3V稳压按J7的1=IN+5V、2=公共GND、3=OUT+3V3_EXT接。核心自己的3V3通过J8.3返回参考和规定上拉；不得与EXT输出相连。两路共地不等于两稳压输出可并联。

5．按核心实物丝印逐根接J8/J9。核心仍从教学底板拆出固定；J8/J9不是整排直插插座。PA13/PA14保留SWD，PB2保留BOOT1，PA15/PB3/PB4须在程序中禁JTAG而保留SWD。

6．MCP成品模块接J10五线、J11七线、J12七线，共19根；地址A0/A1/A2在模块侧接地，INTA/INTB不接。GPA7/GPB7不接线且软件设输出0。每次MCU重启重新初始化MCP，先写输出锁存器再配置方向。

7．逐一接OLED、RC522、FLASH、MPU、编码器等，先测电源选择和信号高电平。RC522的SDA丝印在本方案中是SPI片选CS。模块两组输出不能并接；FLASH未使用的WP/HOLD按实际脚型处理。

8．J33六路输入和J31 BUSY无板载5V转换。确认0/3.3V才直连；无5V上拉的开集输出可用10k拉EXT；5V推挽或已有5V上拉则每路外接NPN适配并记录反相。DHT数据线另按双向BSS138分支，不用NPN替代。

9．急停两组独立NC接J27的1—2和3—4，不能用跳帽冒充开关。J27含最高8.4V，只接急停触点。碰撞两NC串联接J26；MODE/BACK与闭盖NO接J25相应成对端子。

10．蜂鸣按JP3/JP4和R36/R37记录接J30；AO转接板按G/S/D接J28，小白LED正负接J29。DFPlayer仅RX经板上1k和BUSY到J31，模块TX不接；喇叭跨模块SPK1/SPK2，二者均不接地。

核心与MCP和外置模块的J号线束分配，按模块信号名逐线连接

图解 48 核心MCP与已有模块连接总览

5V数字DO的NPN反相适配、DHT的BSS138双向转换，以及蜂鸣控制电平和偏置选择

图解 49 外置条件适配与选择跳帽

板上3V3_EXT与3V3_CORE没有直接并联，但ADC和通信线仍可在一侧掉电时注入电流。正常使用两路同启同停，不在外设仍上电时单独拔核心电源。核心USB禁用；独立USB台架须断板电源并拔全部核心线束。USB转串口只接J18 GND/RX/TX，不接任何供电脚。

电源设计预算为5V持续3A、短时峰值至少4A；两电机各自5V堵转电流须不大于1A，SG90瞬态按2A预算，电机与舵机动作分时互锁。逻辑/红外/照明/受控音量语音预算0.5A。模块实际电流与温升还需测量；额定3A文字不能替代带载测试。

## 63.5 全部板侧接口针序

以下表由A1电气定义生成，覆盖33组外接接口160针及8组跳帽21针。针号是PCB编号，顺序不代表商品模块排针排列。点号表示“接口.引脚”，如J15.3。每接一根，核对线两端名字后打勾。

### 电源接口

板侧针号 | 网络或电源 | 外部接到什么信号 | 检查
J1.1 | VBAT_SW | 外置总开关输出 | □
J1.2 | GND | 电池负极 | □
J2.1 | VBAT_SW | 降压IN+ | □
J2.2 | GND | 降压IN- | □
J3.1 | 5V_BUS | 降压OUT+ | □
J3.2 | GND | 降压OUT- | □
J4.1 | 5V_BUS | TB6612 VM | □
J4.2 | GND | TB6612动力GND | □
J5.1 | 5V_BUS | SG90红线/正极 | □
J5.2 | GND | SG90棕或黑线/负极 | □
J6.1 | 5V_BUS | 逻辑电源分配正极 | □
J6.2 | GND | 逻辑电源分配地 | □
J7.1 | 5V_BUS | 外置稳压IN+ | □
J7.2 | GND | 外置稳压GND/IN-/OUT- | □
J7.3 | 3V3_EXT | 外置稳压OUT+ | □

J1 BAT_SW：电池保护板输出正极经外置保险座和总开关后进入1脚；2脚为电池负极。禁止接未经保险的裸电池。

J2 BUCK_IN：外置非隔离5V降压输入；20AWG短线。

J3 BUCK_OUT：外置降压输出，接入板上星形中心。电池满电8.4V不能接此口。

J4 MOTOR_PWR：电机主电流支路；22AWG短线，长线/偏大电流用20AWG。

J5 SERVO_PWR：舵机主电流仅走本支路；原3芯舵机延长线在配电处分离电源与信号。

J6 LOGIC_PWR：逻辑5V支路；可给DFPlayer和3.3V稳压输入等可靠分线，不把多根线强塞一只端子。

J7 EXT_REG：外置3.3V稳压模块低电流接口；确认额定输出及GND；本口3脚是模块输出进入本板，不是核心3V3。

### 核心线束

板侧针号 | 网络或电源 | 外部接到什么信号 | 检查
J8.1 | 5V_BUS | 核心5V输入 | □
J8.2 | GND | 核心GND | □
J8.3 | 3V3_CORE | 核心3V3输出/参考 | □
J8.4 | PA0 | 核心PA0 | □
J8.5 | PA1 | 核心PA1 | □
J8.6 | PA2 | 核心PA2 | □
J8.7 | PA3 | 核心PA3 | □
J8.8 | PA4 | 核心PA4 | □
J8.9 | PA5 | 核心PA5 | □
J8.10 | PA6 | 核心PA6 | □
J8.11 | PA7 | 核心PA7 | □
J8.12 | PA8 | 核心PA8 | □
J8.13 | PA9 | 核心PA9 | □
J8.14 | PA10 | 核心PA10 | □
J8.15 | PA11 | 核心PA11 | □
J8.16 | PA12 | 核心PA12 | □
J8.17 | PA15 | 核心PA15 | □
J9.1 | GND | 核心GND | □
J9.2 | PB0 | 核心PB0 | □
J9.3 | PB1 | 核心PB1 | □
J9.4 | PB3 | 核心PB3 | □
J9.5 | PB4 | 核心PB4 | □
J9.6 | PB5 | 核心PB5 | □
J9.7 | I2C_SCL | 核心PB6 | □
J9.8 | I2C_SDA | 核心PB7 | □
J9.9 | PB8 | 核心PB8 | □
J9.10 | PB9 | 核心PB9 | □
J9.11 | PB10 | 核心PB10 | □
J9.12 | PB11 | 核心PB11 | □
J9.13 | PB12 | 核心PB12 | □
J9.14 | PB13 | 核心PB13 | □
J9.15 | PB14 | 核心PB14 | □
J9.16 | PB15 | 核心PB15 | □

J8 CORE_PA：自定义17针线束；按核心丝印逐线连接，不能整排直插；正常系统核心由本板1脚供5V，禁止同时插核心USB；若做独立USB台架，先断本板电源并拔下与核心相连的全部线束，再另行测试。

J9 CORE_PB：自定义16针线束；PB2/BOOT1不接；PA13/PA14在核心直接接SWD并始终保留。

### MCP与显示惯性模块

板侧针号 | 网络或电源 | 外部接到什么信号 | 检查
J10.1 | 3V3_EXT | 模块VDD | □
J10.2 | GND | 模块GND | □
J10.3 | I2C_SCL | 模块SCL | □
J10.4 | I2C_SDA | 模块SDA | □
J10.5 | MCP_RESET_N | 模块RESET | □
J11.1 | MCP_GPA0 | 模块GPA0 | □
J11.2 | MCP_GPA1 | 模块GPA1 | □
J11.3 | MCP_GPA2 | 模块GPA2 | □
J11.4 | MCP_GPA3 | 模块GPA3 | □
J11.5 | MCP_GPA4 | 模块GPA4 | □
J11.6 | MCP_GPA5 | 模块GPA5 | □
J11.7 | MCP_GPA6 | 模块GPA6 | □
J12.1 | MCP_GPB0 | 模块GPB0 | □
J12.2 | MCP_GPB1 | 模块GPB1 | □
J12.3 | MCP_GPB2 | 模块GPB2 | □
J12.4 | MCP_GPB3 | 模块GPB3 | □
J12.5 | MCP_GPB4 | 模块GPB4 | □
J12.6 | MCP_GPB5 | 模块GPB5 | □
J12.7 | MCP_GPB6 | 模块GPB6 | □
J13.1 | 3V3_EXT | OLED VCC | □
J13.2 | GND | OLED GND | □
J13.3 | I2C_SCL | OLED SCL | □
J13.4 | I2C_SDA | OLED SDA | □
J14.1 | V_MPU | MPU模块VIN/VCC | □
J14.2 | GND | 模块GND | □
J14.3 | I2C_SCL | 模块SCL | □
J14.4 | I2C_SDA | 模块SDA | □

J10 MCP_BUS：成品MCP23017模块五线；A0/A1/A2在模块侧接地；INTA/INTB不用；RESET不接核心NRST。

J11 MCP_A：逐线接模块GPA0至GPA6；GPA7不外接、软件设输出0。

J12 MCP_B：逐线接模块GPB0至GPB6；GPB7不外接、软件设输出0。

J13 OLED：仅用于已确认3.3V供电I2C OLED；I2C拉3V3_EXT。

J14 MPU6050：JP5选择模块实际VIN电压；不能因芯片3.3V就默认板VIN也3.3V；任何模块内5V总线上拉必须处理。

### RFID存储与串口

板侧针号 | 网络或电源 | 外部接到什么信号 | 检查
J15.1 | 3V3_EXT | RC522 3.3V | □
J15.2 | GND | RC522 GND | □
J15.3 | PA4 | RC522 SDA/SS/CS | □
J15.4 | PA5 | RC522 SCK | □
J15.5 | PA7 | RC522 MOSI | □
J15.6 | PA6 | RC522 MISO | □
J15.7 | MCP_GPA4 | RC522 RST | □
J16.1 | 3V3_EXT | FLASH VCC | □
J16.2 | GND | FLASH GND | □
J16.3 | PA15 | FLASH CS | □
J16.4 | PA5 | FLASH CLK | □
J16.5 | PA7 | FLASH DI/MOSI | □
J16.6 | PA6 | FLASH DO/MISO | □
J16.7 | FLASH_WP_N | FLASH /WP（若外露） | □
J16.8 | FLASH_HOLD_N | FLASH /HOLD（若外露） | □
J17.1 | V_HC05 | HC05 VCC/VIN | □
J17.2 | GND | HC05 GND | □
J17.3 | PA2 | HC05 RX | □
J17.4 | PA3 | HC05 TX | □
J18.1 | GND | USB串口GND | □
J18.2 | PA9 | USB串口RXD | □
J18.3 | PA10 | USB串口TXD | □

J15 RC522：RC522仅3.3V；商品排针SDA在SPI模式为CS，不接I2C；IRQ不接。

J16 FLASH：按实际3.3V SPI NOR芯片核对；不存在的WP/HOLD外露脚不接，不能套商品针序。

J17 HC05：JP6供电选择按模块规格；UART输入输出均须3.3V逻辑。

J18 PC_UART：3.3V逻辑USB转串口；本接口不提供电源，转换器VCC/5V/3V3脚不接。

### 执行器与温湿度

板侧针号 | 网络或电源 | 外部接到什么信号 | 检查
J19.1 | 3V3_EXT | 驱动VCC | □
J19.2 | GND | 驱动信号GND | □
J19.3 | MCP_GPA0 | AIN1 | □
J19.4 | MCP_GPA1 | AIN2 | □
J19.5 | MCP_GPA2 | BIN1 | □
J19.6 | MCP_GPA3 | BIN2 | □
J19.7 | PA8 | PWMA | □
J19.8 | PA11 | PWMB | □
J19.9 | STBY_OUT | STBY | □
J20.1 | SERVO_SIG_5V | SG90信号（确认颜色） | □
J20.2 | GND | 信号参考地/不得承担舵机主电流 | □
J21.1 | 5V_BUS | HC-SR04 VCC | □
J21.2 | GND | GND | □
J21.3 | US_TRIG_5V | TRIG | □
J21.4 | US_ECHO_RAW | ECHO | □
J22.1 | V_DHT | DHT模块VCC | □
J22.2 | GND | DHT GND | □
J22.3 | DHT_DATA_RAW | DHT DATA | □
J23.1 | 3V3_EXT | BSS138 LV | □
J23.2 | 5V_BUS | BSS138 HV | □
J23.3 | GND | BSS138 GND | □
J23.4 | PB11 | BSS138 LV通道 | □
J23.5 | DHT_DATA_RAW | BSS138对应HV通道 | □

J19 TB6612_CTRL：本口仅逻辑；VM和动力地走J4；AO1/AO2/BO1/BO2在驱动模块直接接电机粗线。

J20 SERVO_SIG：1脚是PWM逻辑输出，不是舵机正电源；SG90主电源走J5，主地也直接回J5。

J21 HC_SR04：ECHO已经由板上12k/20k分压至PB1；不得从模块ECHO再另跨线到核心。

J22 DHT：3.3V分支JP7=1-2且JP8闭合；5V分支JP7=2-3、JP8断开，外置BSS138经J23转换；严禁5V分支短接JP8。

J23 DHT_LEVEL：仅5V DHT分支使用外置BSS138双向开漏转换；3.3V分支保持空。转换模块GND全部共地。

### 编码器按键和急停

板侧针号 | 网络或电源 | 外部接到什么信号 | 检查
J24.1 | 3V3_EXT | 编码器VCC | □
J24.2 | GND | GND | □
J24.3 | PB3 | CLK | □
J24.4 | PB4 | DT | □
J24.5 | MCP_GPB4 | SW | □
J25.1 | MCP_GPB5 | MODE接点 | □
J25.2 | GND | MODE另一接点 | □
J25.3 | MCP_GPB6 | BACK接点 | □
J25.4 | GND | BACK另一接点 | □
J25.5 | PB14 | 闭盖NO | □
J25.6 | GND | 闭盖COM | □
J26.1 | PB12 | 右NC；右COM接左NC | □
J26.2 | GND | 左COM | □
J27.1 | VBAT_SW | NC1一端 | □
J27.2 | ESTOP_NC1_RETURN | NC1另一端 | □
J27.3 | VBAT_SW | NC2一端 | □
J27.4 | ESTOP_NC2_RETURN | NC2另一端 | □

J24 ENCODER：仅3.3V编码器模块；CLK/DT的CORE上拉与模块EXT上拉二选一；SW上拉同样核对。

J25 KEYS_LID：三组接地开关：MODE、BACK轻触NO；闭盖用NO微动。轻触4脚同组导通须实测。

J26 BUMPER：外置左右微动NC串联，任一个碰撞或断线为高；不用NO端。

J27 ESTOP_2NC：急停必须两组独立NC；开关闭合正常通，按下断。此口含最高8.4V，不能插传感器/MCU；禁止插跳帽伪装急停。

### 照明声音和红外

板侧针号 | 网络或电源 | 外部接到什么信号 | 检查
J28.1 | LED_GATE | MOS G | □
J28.2 | GND | MOS S | □
J28.3 | LED_NEG | MOS D | □
J29.1 | LED_POS | LED阳极+ | □
J29.2 | LED_NEG | LED阴极- | □
J30.1 | V_BUZZ | 模块VCC | □
J30.2 | GND | 模块GND | □
J30.3 | BUZZ_IN | 模块IN | □
J31.1 | GND | DFPlayer信号GND | □
J31.2 | DF_RX | DFPlayer RX | □
J31.3 | MCP_GPA6 | 经核对/适配的BUSY | □
J32.1 | 3V3_EXT | 光敏模块VCC（确认支持3.3V） | □
J32.2 | GND | GND | □
J32.3 | PB0 | 光敏AO（或明确选用DO） | □
J33.1 | 3V3_EXT | 3.3V外设电源 | □
J33.2 | 5V_BUS | 5V外设电源 | □
J33.3 | GND | 模块公共地 | □
J33.4 | MCP_GPB0 | 循迹左有效3.3V输入 | □
J33.5 | MCP_GPB1 | 循迹中有效3.3V输入 | □
J33.6 | MCP_GPB2 | 循迹右有效3.3V输入 | □
J33.7 | MCP_GPB3 | 靠近DO有效3.3V输入 | □
J33.8 | PB8 | 前障碍DO有效3.3V输入 | □
J33.9 | PA12 | 投放对射DO有效3.3V输入 | □

J28 AO3400_ADAPTER：AO3400A是已购裸管，先焊到转接板并核对G/S/D，再外接本接口；不能照商品排针顺序。

J29 WHITE_LED：单颗小功率白LED正负端，板上220Ω串联限流；不能换成灯带。

J30 BUZZER：仅带驱动三线蜂鸣模块；核供电和有效电平再选JP3/4与R36/37。

J31 DFPLAYER_SIG：仅信号口。DFPlayer VCC和电源GND以独立适当线径从J6引；喇叭接模块SPK1/2而非GND；模块TX不接。BUSY必须为<=3.3V或先外置适配。

J32 LIGHT：默认3.3V光敏AO。若仅DO改软件模式；若5V模拟AO需外置分压校准，禁止用NPN代替模拟采样。热敏为台架替换，不能与光敏并接。

J33 IR_INPUTS：自定义供电/信号汇集口；六路输入必须经外置条件适配后<=3.3V。3V3与5V是两根可用电源，绝不能同时接模块同一VCC。

### 跳帽与测试端针序

板侧针号 | 网络或电源 | 含义 | 检查
JP3.1 | PB9 | 跳帽选择端 | □
JP3.2 | BUZZ_IN | 跳帽选择端 | □
JP3.3 | BUZZ_5V | 跳帽选择端 | □
JP4.1 | 3V3_EXT | 跳帽选择端 | □
JP4.2 | V_BUZZ | 跳帽选择端 | □
JP4.3 | 5V_BUS | 跳帽选择端 | □
JP5.1 | 3V3_EXT | 跳帽选择端 | □
JP5.2 | V_MPU | 跳帽选择端 | □
JP5.3 | 5V_BUS | 跳帽选择端 | □
JP6.1 | 3V3_EXT | 跳帽选择端 | □
JP6.2 | V_HC05 | 跳帽选择端 | □
JP6.3 | 5V_BUS | 跳帽选择端 | □
JP7.1 | 3V3_EXT | 跳帽选择端 | □
JP7.2 | V_DHT | 跳帽选择端 | □
JP7.3 | 5V_BUS | 跳帽选择端 | □
JP8.1 | PB11 | 跳帽选择端 | □
JP8.2 | DHT_DATA_RAW | 跳帽选择端 | □
JP9.1 | BAT_ADC_DIV | 跳帽选择端 | □
JP9.2 | PA1 | 跳帽选择端 | □
JP10.1 | MCP_RESET_N | 跳帽选择端 | □
JP10.2 | GND | 跳帽选择端 | □

## 63.6 断电检查与首次分阶段上电

检查框留给实际制作填写。下面是应执行的步骤和预期，不能在未测量时写“已通过”。每增加模块先断电，轮子始终架空到执行器单项测试完成。

1．空板焊完但U1不插、所有模块不接，先核位号、阻值、焊桥、端子正负和电解极性。万用表检查VBAT/GND、5V/GND、EXT/GND无持续短路；区分电容充电瞬间响与一直短路。CORE与EXT之间不应有直接导通。

2．确认JP3—JP8开，JP9闭，JP10开；R36装/R37空。外置降压离板先调5.00V，再以限流方式接J3，测J4/J5/J6正端约5V。限流值按当前仅板上负载逐级设置，不带电机舵机。

3．断电接3.3V模块，重上电测J7.3为3.20—3.40V，观察静态电流及异常发热。逐个选择供电跳帽时先空载量中心脚，再接模块；未确认额定电压的跳帽保持开。

4．断电插U1，核缺口与1脚方向。先测14=5V、7=GND；用安全3.3V输入检查三个同相缓冲，PA0/PB15默认低，PB9默认不响电平。第4路11脚保持不接。

5．断电接核心及MCP，先下载最小安全固件：PB5与两路电机PWM为0；MCP先写OLATA/OLATB为0，再设置方向IODIRA=0x40、IODIRB=0x7F，最后初始化功能。GPA7/GPB7均为输出低。

6．I²C先100kHz逐块扫描MCP/OLED/MPU，确认SCL/SDA空闲约3.3V；SPI先低速分别读RC522与FLASH身份，再交替访问。不在通信未稳定时进入积分和移动程序。

7．用受控5V信号验证J21.4经分压到PB1约3.125V；用8.4V电池模拟输入测ADC约1.953V。记录计算值与实测值，检查1%阻值及Vref；核心单独失电前先隔离相关电源与信号，JP9只隔离ADC。

8．不接轮电机，在6.0/7.4/8.4V偏置条件验证双NC。正常释放PB5=1时STBY>2.7V；PB5=0时<0.3V。强制PB5=1并按住急停，STBY仍须<0.3V；PB13应由低变高。逐个拔NC1/NC2回路线并记录。

9．测试释放急停、MCU复位、MCP失联、关键模块断线后的静止状态。急停钳位依赖EXT偏置，不能用正常试验证明EXT失电时也完全安全；异常用总开关切电。STBY低为待机滑行，不会机械锁轮或切舵机电源。

10．架空先单轮低PWM测方向和电流，再双轮；SG90先拆杆空载50Hz/1500μs定位，再按机械章节装连杆。电机行驶与开盖动作互锁，记录5V最低值、温升和复位情况。

11．完成单项后按原步骤逐一跑33项功能：卡片、投放、积分掉电恢复、满桶、循迹、蓝牙、故障锁和导出等。硬件接口齐全不代表固件已经写完；每个功能保存串口日志或实测结果。

验收项 | 预期或动作 | 实测记录
外置降压 | 空载5.00V；带载项目目标4.85—5.15V | _____V
EXT与CORE | 各自约3.3V，不直接并联 | _____/_____V
ADC | 8.4V输入理论1.953V，按实际Vref校准 | _____V
超声分压 | 5.00V输入理论3.125V | _____V
正常允许 | PB5=1且NC正常，STBY>2.7V | _____V
急停保持 | PB5强制1且急停按下，STBY<0.3V | _____V
NC2反馈 | 释放0，按下或断线1 | _____
恢复行为 | 复位/释放/重连后不自动运行 | □通过 □待修
电源负载 | 记录最重正常模式电流与最低5V | _____A / _____V
实际功能 | 按原33项测试，附日志和故障修复 | _____

## 63.7 文件使用与检查范围

PCB源工程、制造Gerber、接口表和装配BOM放在仓库hardware/current-low-cost/pcb-a/；本章图源同步保存。订裸PCB使用本次A1制造包，焊接使用本章和A1 BOM，不使用旧V2.1的SMT BOM或坐标文件。

本次原理图6页的ERC报告为0错误、0警告；电气定义检查覆盖293个连接端点和1个未接输出。PCB按本项目设定规则运行DRC，报告为0违规、0未连接项、0原理图一致性差异。检查配置与忽略项保留在报告内；Gerber必须与最终发布检查记录核验的文件一致。这些是设计文件检查结果，不代表实物通电或全部固件已经完成。

更新记录 2026年10月12日：采用A方案，复用直插件和模块；新增图45—49及完整接口表，保留330步骤编号；旧洞洞板和五拆六增改为归档；AHCT第三通道固定PB9，新增蜂鸣及按键偏置位置。

# 64 四套技能联合审查与接地加强

本次审查在原PCB A1上增加55个接地过孔并重新铺铜。裸板制造检查通过，接口、元件采购、模块接法和原330步骤不变。图解46已替换为当前底面图；这些小孔由板厂制作，无需插元件或手工焊线。

## 64.1 本次具体完成的工作

技能套件 | 实际执行内容
Hubert KiCad-skills | 连接真实KiCad 10.0.6，通过IPC加入GND过孔，重新铺铜并保存。
mash kicad-skills | 使用结构化工具检查原理图、PCB一致性、DNP和规则；没有文本替换CAD。
kicad-happy | 执行原理图、PCB、EMC、交叉和Gerber分析；核对原厂手册，并实际仿真电池和Echo两处分压。
Toaster PCB-design | 按布局、回流、电源、工艺及阶段清单检查，记录误报、未满足项与实物验收边界。

最终检查：ERC 0违规；PCB DRC 0违规、0未连接、0原理图差异。94个位号逐针一致，33段计划中的粗电源线全部保留。最终共有117个过孔，钻孔文件的411个金属化孔与4个安装孔逐一匹配。

两个分压网络按1%电阻误差做直流仿真：电池8.4V时ADC标称约1.953V、最坏高值约1.984V；Echo在5.15V输入时最坏高值约3.243V。该仿真未包含MCU钳位、线缆寄生或模块动态行为。

本次不增加元件BOM，也不增加焊点。裸板价格仍由实际订单、优惠和运费决定；“多55个过孔”不能保证结算绝对不变，但没有新增需采购的器件。

## 64.2 首次调试时追加核对

顺序 | 具体操作与预期
1 认当前文件 | 下载本次更新的Gerber_RS274X.zip，不能混用旧制造图层。图解46中的小地孔不用焊锡填满。
2 仍按原步骤 | 先执行第63章断电检查和分阶段上电，再接模块；不得直接插上所有模块后带电试错。
3 测两路3.3V | J8.3对J8.2测CORE约3.3V；J7.3对J7.2测EXT约3.3V。两路稳压输出不可短接。
4 保持线束短 | RC522每段信号线建议≤10cm，SCK与地线贴近；MCP的J10地线与J11/J12信号线束一起走，远离电机线。
5 先用低速通信 | 若PCLK2=72MHz，SPI1可先分频256即281.25kHz；I²C先100kHz。低时钟不等于慢边沿，也不能修复地铜缺口。
6 验证动态情况 | 按手册先架空车轮测试急停及锁存，再测试电机启动、舵机动作时是否复位、RFID是否断连。出现问题先测供电和波形。

## 64.3 仍需实物验证的部分

本版不宣称EMC检查全通过：PA6等信号下方仍缺少连续地铜，部分换层回流需绕行；C8到U1供电脚约5.24mm。55个地过孔有所改善，但未彻底重排信号区。尚不能据此承诺高速SPI、长线或电机强干扰环境稳定。

热分析工具因缺少完整功耗和模块型号，未评估实际温升；生命周期工具也未完成物料查询。这些不能记作已通过。已购端子外形、TO-92针序、电容尺寸仍须装前实测；电机堵转、降压能力、舵机负载和急停动作按原验收步骤验证。

完整报告随设计包保存在 review/four-skills/四套技能联合审查报告.md，包含原始结果、误报依据、原厂资料链接、前后对比和逐项清单。打样属于教学原型验证，尚未完成实物装配、运行或实验室认证。

# 65 模块位置与方案A夹具（旧打印排布归档）

本章保留模块位置、安装孔与方案A可开启压框的装配资料。底板打印已改为第66章的原尺寸平放拼接版，上平台仍整片平放；本章旧两盘斜撑工程已停用。

本章65.6至65.11仅作旧排布归档，不能据此再次启动斜撑打印。模块卡座尺寸和固定方式继续有效；实际底板接缝、三盘工程、时间与参数以第66章为准。

整片底板上的模块布置图，标明模块编号、位置和接口方向。

图解 50 底板上的模块位置和接线操作空间。

板件 | 完整外形与承载要求
P01底板 | 280×220×5 mm；模块安装孔及固定座与板件对应，新增受力安装处保留局部5mm厚料。
P02上平台 | 240×190×5 mm；保留四柱和舵机托片接口。

## 65.1 模块位置和安装基准

底板局部X由车尾指向车头，Y=0..220。layout_origin记录模块/卡座的中心；rotation为从模块本地长边+X逆时针转角。

座高相对底板顶面Z=5；PCB底面绝对Z=5+seat_height。

编号与模块 | 板体尺寸 | 布局参数 | 固定方式及接口避让
M01 STM32核心板 | 53×22×2 mm | 原点(31.5, 68) 旋转180°；座高20 mm | 方案A：金属轴翻盖压框、90°拨片、独立定位簧片 反面出针9 mm 座高不含底板厚5mm；压框只搭边，装配后核查排针塑壳和实际器件净空
M02 MCP23017 | 26×21×2 mm | 原点(91, 74) 旋转0°；座高20 mm | 方案A：金属轴翻盖压框、90°拨片、独立定位簧片 反面出针9 mm 座高不含底板厚5mm；压框只搭边，装配后核查排针塑壳和实际器件净空
M03 FLASH | 23×19×2 mm | 原点(92, 125) 旋转0°；座高4 mm | 方案A：金属轴翻盖压框、90°拨片、独立定位簧片 正面出针9 mm 座高不含底板厚5mm；压框只搭边，装配后核查排针塑壳和实际器件净空
M04 TB6612驱动 | 25×25×2 mm | 原点(157, 188.5) 旋转0°；座高4 mm | 方案A：金属轴翻盖压框、90°拨片、独立定位簧片 正面出针9 mm 座高不含底板厚5mm；压框只搭边，装配后核查排针塑壳和实际器件净空
M05 3.3V稳压 | 13×9×2 mm | 原点(57.5, 18.5) 旋转0°；座高10 mm | 方案A：金属轴翻盖压框、90°拨片、独立定位簧片 反面出针5 mm 座高不含底板厚5mm；压框只搭边，装配后核查排针塑壳和实际器件净空
M06 DFPlayer | 21.5×20.5×2 mm | 原点(23, 113) 旋转0°；座高20 mm | 方案A：金属轴翻盖压框、90°拨片、独立定位簧片 反面出针8 mm 座高不含底板厚5mm；压框只搭边，装配后核查排针塑壳和实际器件净空
M07 HC-05蓝牙 | 39×16×2 mm | 原点(25, 164) 旋转90°；座高5 mm | 方案A：金属轴翻盖压框、90°拨片、独立定位簧片 正面出针6 mm 座高不含底板厚5mm；压框只搭边，装配后核查排针塑壳和实际器件净空
M08 MPU6050 | 25×25×2 mm | 原点(120, 188.5) 旋转0°；座高4 mm | 方案A：金属轴翻盖压框、90°拨片、独立定位簧片 正面出针9 mm 座高不含底板厚5mm；压框只搭边，装配后核查排针塑壳和实际器件净空
M09 蜂鸣器 | 24×15×2 mm | 原点(97, 24) 旋转0°；座高4 mm | 方案A：金属轴翻盖压框、90°拨片、独立定位簧片 正面出针9 mm 座高不含底板厚5mm；压框只搭边，装配后核查排针塑壳和实际器件净空
A1 A1主PCB | 100×100×1.6 mm | 原点(160, 110) 旋转180°；座高10 mm | 四个M3孔＋10mm绝缘隔离柱 四孔中心115/205、65/155；动力端子朝车头+X，外侧预留20mm以上走线区；用户28mm为正反焊后总包络，不与板厚重复叠加
BUCK 5V降压模块 | 43×21×2 mm | 原点(202.5, 187.5) 旋转0°；座高6.2 mm | 两大孔M2.5螺钉＋独立绝缘座；座再用2颗M3固定 模块局部孔(7,19)/(36,2)，孔心横差29、纵差17；4焊盘不作安装孔；先放底面M2.5螺母再固定载座，电位器上方留空
SPK 小喇叭 | 40×40×14 mm | 原点(68, 198) 旋转0°；座高2 mm | Ø40定位圈＋48mm耳距M3螺柱，耳下螺母调高 按图两耳孔Ø4±0.2、孔心距48±0.5；安装耳高度未量，用下方螺母调到接触耳片，再用垫片和上螺母固定，勿压弯耳片
BAT 2S串联电池 | 76×40×20 mm | 原点(176, 30) 旋转0°；座高4.4 mm | 框式托架＋两端方案A旋转压片；支承条铺2mm EVA 用户确认同尺寸为2S串联7.4V；出线朝+X，右端中央12mm让线口；压片在端部塑料壳边，勿压电芯或导线；闭合留0.2mm限位余隙，防跳出而非压紧电芯

正面为主要元件面，反面为焊接面；同面的元件与排针高度取较大包络，不能重复相加。反面出针类别采用约20mm架空，正面出针类别一般采用约4mm架空；每个安装座最终值以表中和模型为准。插上实际杜邦接头后再次检查下方净空及线缆弯折。

按模块旋转角检查STM32的USB与SWD、DFPlayer的TF卡口、HC-05天线端和电位器的可达性。MPU6050使用刚性承托，记录板上X向右、Y向上与车体轴向的换算关系。

## 65.2 安装孔和局部加强

带模块安装座、安装孔和局部加强区的一体化底板。

图解 51 整片底板的安装座和局部加强。

模块 | 对应底板安装孔（底板局部坐标）
M01 STM32核心板 | 座脚 (57, 52)，Ø3.4 / 座脚 (6, 52)，Ø3.4 / 锁片轴 (31.5, 48.5)，Ø3.4 / 簧片锚钉 (46.5, 45.7)，Ø3.4
M02 MCP23017 | 座脚 (79, 89.5)，Ø3.4 / 座脚 (103, 89.5)，Ø3.4 / 锁片轴 (91, 93)，Ø3.4 / 簧片锚钉 (76, 95.8)，Ø3.4
M03 FLASH | 座脚 (81, 139.5)，Ø3.4 / 座脚 (103, 139.5)，Ø3.4 / 锁片轴 (92, 143)，Ø3.4 / 簧片锚钉 (77, 145.8)，Ø3.4
M04 TB6612驱动 | 座脚 (145.5, 206)，Ø3.4 / 座脚 (168.5, 206)，Ø3.4 / 锁片轴 (157, 209.5)，Ø3.4 / 簧片锚钉 (142, 212.3)，Ø3.4
M05 3.3V稳压 | 座脚 (46.5, 28)，Ø3.4 / 座脚 (68.5, 28)，Ø3.4 / 锁片轴 (57.5, 31.5)，Ø3.4 / 簧片锚钉 (42.5, 34.3)，Ø3.4
M06 DFPlayer | 座脚 (12, 128.25)，Ø3.4 / 座脚 (34, 128.25)，Ø3.4 / 锁片轴 (23, 131.75)，Ø3.4 / 簧片锚钉 (8, 134.55)，Ø3.4
M07 HC-05蓝牙 | 座脚 (10, 143.5)，Ø3.4 / 座脚 (10, 182.5)，Ø3.4 / 锁片轴 (8.5, 164)，Ø3.4 / 簧片锚钉 (5.7, 149)，Ø3.4
M08 MPU6050 | 座脚 (108.5, 206)，Ø3.4 / 座脚 (131.5, 206)，Ø3.4 / 锁片轴 (120, 209.5)，Ø3.4 / 簧片锚钉 (105, 212.3)，Ø3.4
M09 蜂鸣器 | 座脚 (86, 36.5)，Ø3.4 / 座脚 (108, 36.5)，Ø3.4 / 锁片轴 (97, 40)，Ø3.4 / 簧片锚钉 (82, 42.8)，Ø3.4
A1 A1主PCB | (115, 65)，Ø3.4 / (205, 65)，Ø3.4 / (115, 155)，Ø3.4 / (205, 155)，Ø3.4

A1主PCB保持100×100mm、四孔中心距90×90mm的矩形安装关系；安装柱与孔周有对应受力区。PCB下表面保持绝缘间距，螺钉不顶住焊点或铜箔。

5V降压模块按实测43×21mm边界定位。以模块左下角为局部原点，两只安装孔为(7,19)、(36,2)，孔径3mm；它们不是四角接线焊盘。商品图中的39.5mm标注不得当作这两只大安装孔的横向孔距。

无独立安装孔的小模块使用安装座和方案A压框，板边或角点由相应座面承托。卡持处避开元件、排针和焊点，不在电子PCB上另钻孔。

## 65.3 方案A压框和旋转拨片

金属销铰链压框、旋转拨片、硬止挡和独立低挠度定位簧片的开闭状态。

图解 52 方案A压框与九十度旋转拨片的开闭位置。

压框通过金属销铰链开启；中心镂空，接口方向开放。合上后将刚性拨片转到闭合位置，使拨片与压框的承载面有明确重叠；0度和90度均有独立硬止挡。

独立定位环中的低挠度簧片只提供防误转定位。压框向上受力时，载荷由刚性拨片、轴座和金属轴承担，不能靠弹舌充当承载钩或旋转止挡。簧片卡位属于防振定位，不能作为强防误触锁。

锁扣设计参数 | 最终记录
方案 | A
闭合角度/度 | 0
打开角度/度 | 90
刚性搭接/mm | 2.3
铰链轴 | M3轴；中央三节，统一30mm
簧片厚度/mm | 1.16
定位凸点/mm | 0.48
旋转时簧片挠度/mm | 0.25
簧片是否承载 | 否

M3金属轴与螺母用于调整转动间隙，不能把拨片拧死后靠磨损获得松动，也不依赖PLA自攻螺纹反复开关。锁定调好的间隙后，确认转拨片不会带着螺钉松开，定位环不会随拨片一起旋转。

先手动试开闭，不装电子板时确认止挡和卡位；再放入模块，确认板边承托到位、压框不压元件，最后检查翻盖完整运动轨迹。上平台装回后如遮挡开启路径，应先拆上平台检修，不强扭压框。

## 65.4 电池和喇叭的固定

电池挡边及固定通道、喇叭两耳安装孔和可调螺母垫柱。

图解 53 电池限位和喇叭的可调固定。

电池包按实测76×40×20mm布置，2S串联已由用户确认。挡边限制横向滑移，两端旋转压片提供竖向约束；支承条铺2mm EVA，压片只约束端部塑料外壳，不挤压电芯，出线口保留自然弯曲和检修空间。商品图中的两节并联电池盒不能替代已确认的2S接法。

喇叭本体按Ø40mm、厚14mm，两耳孔心距48mm、孔径4mm布置。安装耳相对本体底面的高度尚未实测，因此用可调螺母垫柱与平垫调平；不能预设一个固定柱高后将安装耳强行压弯。固定时保留出声孔与引线出口。

线束沿预留通道整理，避免经过拨片扫掠区、压框铰链或电机转动区域。电池、驱动和降压区的较粗导线不挤压信号排针；此处机械布置不改变原A1供电和接线要求。

仍待实物核对：电机支架、万向球、循迹与碰撞开关实际孔距仍未提供，不声称已核实它们的安装孔；喇叭耳片高度用可调螺母处理；杜邦线插好后的实际弯线包络仍需实装检查。

## 65.5 五金统计和装配顺序

五金 | 规格 | 数量 | 用途与注意事项
M3低圆头螺钉 | M3×12，ISO7380圆头高1.65mm | 22 | 9卡座18颗＋电池座4颗；头在座脚上，两片0.5mm小垫圈，底板下方用高2.4mm普通六角螺母；此长度不配高4mm锁紧螺母。
M3螺栓或金属轴 | M3×30，ISO7380低圆头Ø5.7×1.65mm | 9 | 9个金属轴铰链；此头型为铰链避空依据，不可换高圆柱头；自锁螺母只锁轴向间隙，压框应能自由翻动。
M3拨片轴及簧片锚钉 | M3×40 | 10 | M01/M02/M06各2根＋电池左右各2根；全部头在5mm底板下面；每根上下各1片0.5mm垫圈、上方4mm高锁母。轴顶留0.1–0.2mm转动间隙，锚钉固定簧片头。
M3拨片轴及簧片锚钉 | M3×30 | 2 | M05稳压模块2根；同40mm组装法，簧片头上垫圈外径不得超过6mm。
M3拨片轴及簧片锚钉 | M3×25 | 10 | M03/M04/M07/M08/M09各2根；同40mm组装法，不在拨片轴座与拨片之间另加圆垫圈，以免遮住定位凸点。
M3降压载座固定螺钉 | M3×16，ISO7380圆头高1.65mm | 2 | BUCK载座与5mm底板；头在载座上、锁母在底板下；两片0.5mm垫圈及4mm高锁母，载座厚3.2mm；两颗不包含于22颗座脚螺钉。
M3绝缘双通柱 | 10mm | 4 | A1 PCB；A1四孔90×90mm。
M3绝缘柱下螺钉 | M3×10 | 4 | A1柱底固定；头在5mm底板下，配0.5mm垫圈，名义入柱4.5mm；先核对实物盲孔深度。
M3绝缘柱上螺钉 | M3×6 | 4 | A1 PCB固定；板厚1.6mm＋0.5mm垫圈后名义入柱3.9mm。
M2.5螺钉及螺母 | M2.5×8 | 2 | 5V模块两大孔；螺母先放到降压座底面六角窝。此处不加垫圈，约1.8mm有效吃牙；轻载试装，勿换长螺钉顶底板。
M3喇叭螺钉 | M3×30，暂定 | 2 | 喇叭两耳；每根头下、耳下、耳上共3片垫圈，耳下普通螺母、耳上锁母。耳下表面距底板顶面E与耳厚t须满足E+t≤19mm；不得压弯耳片或抬高到脱离定位圈。
M3普通六角螺母 | 高2.4mm、对边5.5mm | 24 | 22座脚＋2喇叭耳下调高；仅新增模块固定件，不含原立柱及舵机螺丝。
M3尼龙锁紧螺母 | DIN985，高4mm、螺距0.5mm | 35 | 9铰链＋22轴/锚＋2降压座＋2喇叭耳上；不要用高型锁母直接替换4mm高型。
M3小外径平垫圈 | 内径3.2mm、外径≤6mm、厚约0.5mm | 124 | 新增全部M3连接的配套垫圈；簧片锚点上方必须小外径，不能压住12mm自由弹臂；124片为上述选定方案数量，不含备用。

1．先清理打印毛刺，空装金属轴、定位环、拨片和压框，检查环的防转与防脱以及两个旋转止挡。活动件需能顺畅转动，不能用硬拧螺钉消除打印干涉。

2．先固定A1主PCB和有安装孔模块，再放入无孔模块，逐一核对座号与接口朝向。锁扣只需挡住压框开启，不把PCB压弯。

3．插上实际杜邦线并模拟插拔USB、SWD和TF卡，检查背面针的架空间隙；再安装电池、喇叭和较粗导线。

4．重新装上上平台，检查四柱、线束、桶壳和舵机机构互不挤压。断电手动检查盖框检修路径，再按原电气章节逐步通电。

本次全部M3螺钉按ISO7380低圆头Ø5.7×1.65mm审核，铰链、座脚与降压载座不得换高圆柱头。

先将卡座固定到底板，再装PCB、铰链轴、定位簧片和拨片。

定位簧片平放打印；只防误转，刚性拨片承受压框抬起力。

闭合到硬止挡，切勿用大力压弯PCB。

装配前按实物试合角点，排针塑壳/元件密集角位应避免强扣。

建议先拆上平台再维护；开盖包络的数字检查见checks/assembly.json。

## 65.6 旧打印项目和切片记录（已停用）

最终记录为两项打印任务。两片大板各自是一整片；压框、拨片、定位环等小件须一并核对，不能只确认两块板放得下。

工程文件 | 包含物体 | 切片时间 | PLA用量
第1项 projects/P2S_MOUNTED_PLATE_1.3mf | 44 | 约21小时14分 | 约444 g
第2项 projects/P2S_MOUNTED_PLATE_2.3mf | 3 | 约7小时39分 | 约269 g
合计 | 各项目分别启动 | 约28小时53分 | 约713 g

最终记录标记切片检查通过。切片软件版本：Bambu Studio 02.08.02.61。本表仅是切片估算，不是实物计时；人工取件、清床和换盘时间另计。

交付工程不含可直接运行的G-code。作为项目打开，选择实际P2S、喷嘴、热床和PLA重新切片；检查全部物体、朝向、辅助结构与热床边界后再发送。原生工程的几何重读检查与实物打印是不同验证。

参数 | 最终记录
打印机与喷嘴 | P2S 0.4 mm
耗材 | Generic PLA
层高/mm | 0.24
墙层数 | 4
稀疏填充 | 30% gyroid
全局自动支撑 | 关闭
打印顺序 | 逐层打印
防翘边宽度/mm | 第一盘3；第二盘1
喷嘴缠料检测 | 关闭

保持工程位置，禁止自动排盘/自动朝向和逐件打印。

喷嘴缠料检测关闭；相机炒面检测为独立功能，应保持开启。

两项任务耗时均含机器起止脚本，不含人工换板。

此版增加43件安装机构，不能拿旧的四件任务作等功能速度比较。

## 65.7 旧第一盘摆放（已停用）

第一项打印任务内的完整板件、辅助结构和独立打印小件。

图解 54 第一项打印任务的完整摆放。

按最终工程的方向和位置打印，保持100%尺寸及逐层打印。不要用自动朝向、自动排布或逐件打印覆盖经过核对的排布。支撑设置与辅助结构按该工程保存的实际参数执行。

## 65.8 旧第一盘热床记录

第一项打印任务的热床俯视图，展示各件位置及边界预留。

图解 55 第一项打印任务的热床边界。

切片后查看首层，确认刚性底脚、各独立小件和需要的附着边均有连续路径，未超出实际可打印区。不要把单层brim当作刚性承力底座。

## 65.9 旧第二盘摆放（已停用）

第二项打印任务内的完整板件与独立打印小件。

图解 56 第二项打印任务的完整摆放。

第一项完成后取下模型并清理热床，再启动第二项。用物体清单核对独立盖框、拨片、定位环和其他附件的数量，避免打印结束后才发现缺活动件。

## 65.10 旧第二盘热床记录

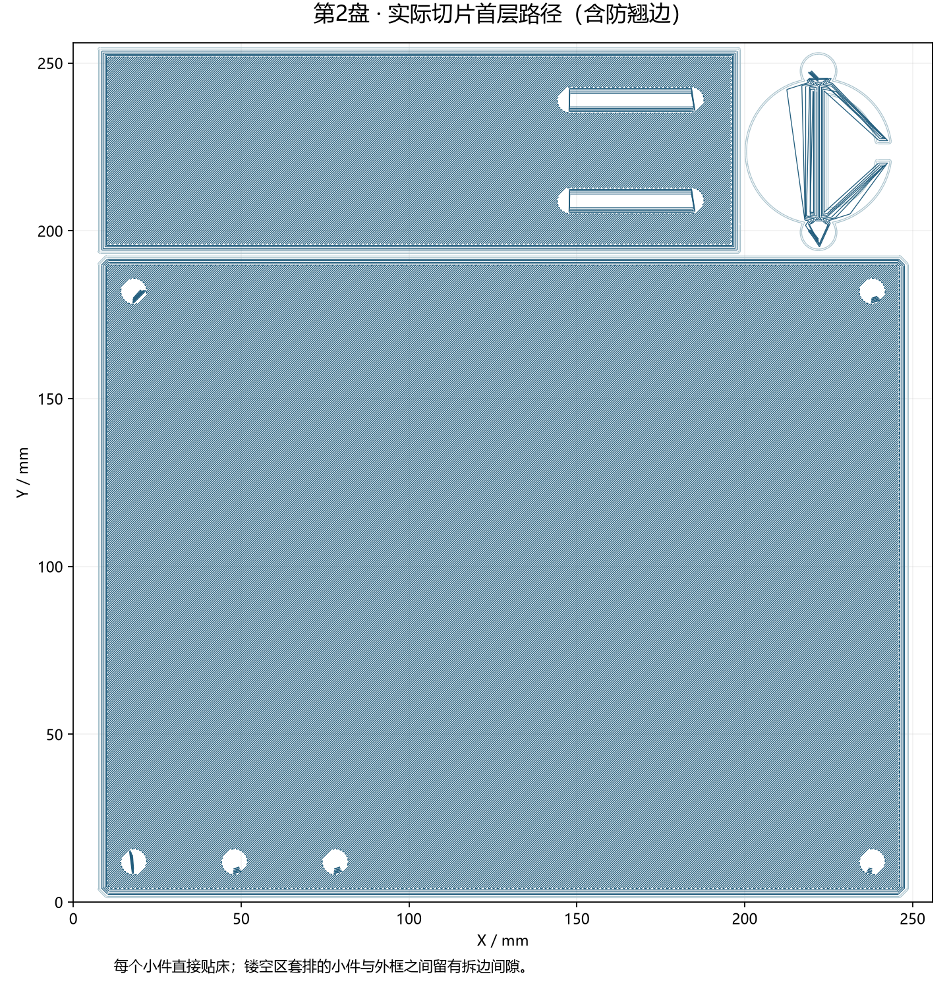
[picture p357: figure]
第二项打印任务的热床俯视图，展示各件位置及边界预留。

图解 57 第二项打印任务的热床边界。

保持保存的模块座、接口与槽口方向；不要把上平台或底板切段来迁就排布。若实际设备、耗材或辅助选项改变可打印边界，应重新检查整盘再启动。

## 65.11 旧斜撑拆除说明（仅归档）

清理热床上的残料、手油和胶块，重新放正并按设备流程调平和校准；打印机用标准速度模式。按所用PLA与热床要求复核温度，不能只凭几何模型保证粘附。

观察首层和中途板面稳定性。发现脱底、翘曲、明显晃动或喷头刮碰时停止处理，不让机器继续在空中挤料形成炒面。

完全冷却后先取整件，再托住板面逐个处理辅助连接点；用斜口钳剪除专用辅助框架和起始边，修平残余小凸点。不抓板端扭折，不把底板或上平台切开、拼接。

打印后先空装锁扣做开闭检查，再试装模块。检查簧片没有裂纹、拨片的刚性重叠和止挡有效；随后分阶段进行静态加载与机构调试。

两大板一体成型，无切块或板件拼接。

所有独立小件直接贴床，优先在支撑框架空区套排。

额外夹具改变耗时，旧22小时45分不再作为最终估算。

所有小件各自贴床，有些位于卡座/压框镂空区或斜板下空区，不能自动排布。

第二盘使用后侧检测区，保留工程的喷嘴缠料检测关闭；这与相机炒面检测不同。

本轮验证边界：新版尚未完成实物打印验证。尚未完成承重试验，无额定承重值。几何、封闭网格、切片及包络检查不能保证零失败或与原木板等强。原330步骤、电气路线和未改动的装车接口继续保留。

# 66 原尺寸底板平放拼接与三盘打印

本版替代旧底板斜撑方案。底板外形保持280×220×5 mm，以两片平放打印后螺栓连接；上平台240×190×5 mm保持一整片。电子模块、卡座、原4个立柱孔与52个模块孔不缩放、不移动。

未采用250 mm短底板：原前万向球实心加强区到X=270，前柱在X=250，上平台仍按(20,15)定位；缩短会改变这些结构条件。按用户允许的备选路线，保留原机械坐标并设计接缝。

盘号 | 打印内容 | 件数 | 实际切片估算 | PLA
1 | 底板后半片＋部分卡座及连接片 | 23 | 7小时25分49秒 | 187.1 g
2 | 底板前半片＋托片及其余卡座/连接片 | 25 | 7小时33分28秒 | 192.1 g
3 | 整片上平台＋平放舵机支架＋喇叭圈 | 3 | 7小时45分16秒 | 269.4 g

总计22小时44分33秒，648.6 g PLA。三项任务均含机器起止脚本，不含人工换板。较上版同套安装夹具的两盘斜撑任务节省约6小时、64 g，但需要多一次打印启动和换板。

三盘全部平放，最高约31.4 mm；自动支撑关闭。已完成几何、装配净空和实际切片检查，尚未实物打印或做接缝承重测试。

打印入口：flat-split-20261101/projects/ 下 P2S_FLAT_SPLIT_PLATE_1.3mf、P2S_FLAT_SPLIT_PLATE_2.3mf、P2S_FLAT_SPLIT_PLATE_3.3mf。作为项目打开，不能只导入网格。

## 66.1 定位舌与底部连接片


图解 58 底板原尺寸拼接位置；橙色是底面连接片投影。

主体接缝名义0.30 mm；两处定位槽每侧留0.25 mm。定位舌负责对齐，三块底部连接片及螺钉承担接缝连接；不能仅插合定位舌就带载使用。

## 66.2 接缝螺钉与装配顺序


图解 59 M3×16螺钉从光滑板面向下穿，连接片位于底板下面。

新增五金（原夹具五金另计） | 规格 | 数量
低圆头螺钉 | M3×16，ISO7380，头Ø5.7/高1.65 mm | 12
平垫圈 | 内径3.2、外径≤6、厚0.5 mm | 24
防松螺母 | M3 DIN985，高4 mm | 12

先去毛边并侧向插合两片，在平桌上量280×220外形、核对板面齐平。三块连接片各穿四颗螺钉；全部带上螺母后交替轻拧到贴紧，不压裂PLA。先完成拼接，再装A1 PCB。

连接片中心：(138,82)/(138,110)/(138,138)。新增孔Ø3.4，X=126/150与Y=76/88/104/116/132/144组合，共12孔。原模块孔不改变。

## 66.3 第1盘：后半片及部分夹具


图解 60 第1盘原生工程排布；所有零件各自贴床。

文件：P2S_FLAT_SPLIT_PLATE_1.3mf。预计7小时25分49秒，耗材187.1 g，23个对象。保持100%比例与原位置，不自动排盘。

板件连续平面贴床、减重槽朝上，装车时翻回光滑面朝上。小拨片和簧片可能套排在卡座镂空中，取下前按parts_index.csv标记；冷却后先切开防翘边，再分别取件。

## 66.4 第2盘：前半片、托片及其余夹具


图解 61 第2盘原生工程排布；所有零件各自贴床。

文件：P2S_FLAT_SPLIT_PLATE_2.3mf。预计7小时33分28秒，耗材192.1 g，25个对象。保持100%比例与原位置，不自动排盘。

板件连续平面贴床、减重槽朝上，装车时翻回光滑面朝上。小拨片和簧片可能套排在卡座镂空中，取下前按parts_index.csv标记；冷却后先切开防翘边，再分别取件。

## 66.5 第3盘：上平台、舵机支架与喇叭圈


图解 62 第3盘原生工程排布；所有零件各自贴床。

文件：P2S_FLAT_SPLIT_PLATE_3.3mf。预计7小时45分16秒，耗材269.4 g，3个对象。保持100%比例与原位置，不自动排盘。

板件连续平面贴床、减重槽朝上，装车时翻回光滑面朝上。小拨片和簧片可能套排在卡座镂空中，取下前按parts_index.csv标记；冷却后先切开防翘边，再分别取件。

## 66.6 参数、首层检查与装车复核

参数 | 本版工程设置
机型/喷嘴/耗材 | P2S / 0.4 mm / Generic PLA；按实际耗材核对
层高/首层 | 0.24 / 0.20 mm
墙/填充/顶底 | 4墙；30% gyroid；顶底各7层、最小1.6 mm
温度/热床 | PLA 220℃；纹理PEI 60℃，实际板型必须一致
防翘边 | 第1、2盘2 mm；第3盘1 mm；间隙0
支撑/顺序/擦料塔 | 自动支撑关；逐层；擦料塔关
检测/速度 | 喷嘴缠料检测关；相机炒面检测可开；标准100%

第三盘使用后侧检测区，因此保留喷嘴缠料检测关闭；它与相机炒面检测是不同功能。三份工程不含G-code，重新切片后发送。打印前清洁板面、开启调平，首层若脱底或翘起应停止处理。

新增螺钉最低点距原底板下表面10.5 mm。按原Hb=45参考，名义离地余量34.5 mm；实际轮组、万向球转接片和导线需要试装。新增头部含垫圈高2.15 mm，距A1板底名义7.85 mm；背部焊脚不能碰到金属头部。

数字检查保留原56孔和电机/万向球加强区，新孔、连接片与现有夹具无冲突；实际首层23/25/3对象全部在床内。没有进行实物打印、额定承重或疲劳验证。先空载，再逐步增加实际使用重量，检查接缝张开、板面弯曲、螺母松动及走线干涉；PCB不得承担接缝连接作用。

## 66.7 先打印精细附件，再补打主体

附件精细盘基于原两盘版第一盘，只删除底板及相连斜撑，保留43件原尺寸附件与托片，原位置不变。文件为P2S_ORIGINAL_PLATE1_NO_BASE_FINE_016.3mf。

精细参数：层高0.16 mm、首层0.20 mm、外墙40/内墙80 mm/s，4墙、30% gyroid、顶底10层/最小1.6 mm。其余保持原工程设置。层高改善层向细节，不等同于孔径公差保证，不要整体缩放卡座或改变孔径补偿。

附件盘实际切片9小时17分2秒，84.3 g PLA。作为项目打开后重新切片，用标准100%速度。工程已无底板及斜撑。

采用附件精细盘后，后续只使用body-after-accessories-20261101/projects/内三份主体补打文件；不要再打印本章66.3和66.4的全量盘，否则会重复打印附件。

主体补打盘 | 内容 | 件数 | 预计时间
1 | 后半片＋连接片2块 | 3 | 4小时53分56秒
2 | 前半片＋连接片1块 | 2 | 4小时25分20秒
3 | 上平台＋舵机支架＋喇叭圈 | 3 | 7小时45分16秒

三份主体文件名为P2S_BODY_AFTER_ACCESSORIES_PLATE_1.3mf至PLATE_3.3mf，保留0.24 mm层高。精细43件和主体8件互不重复，合计仍是51件；底板拼接的螺钉和连接方法仍按66.1、66.2执行。

精细附件＋主体补打共四次任务，约26小时21分34秒、650.3 g PLA，人工换板另计。若尚未打印任何附件且更重视打印次数，可使用本章前三盘全量0.24 mm方案；两条路线不能叠加重复打印。

## 66.8 昨天第二盘运行时的四台补打分工

1号机正在打印昨天的P2S_MOUNTED_PLATE_2.3mf，即完整上平台、舵机支架与喇叭圈，共3件。继续原任务；另外四台只打印下表48件。此前按“附件盘在打印”安排的四台主体方案不适用于本次。

机器 | 内容 | 件数 | 预计时间 | PLA
2号 | 底板后半片 | 1 | 4小时32分22秒 | 141.8 g
3号 | 底板前半片 | 1 | 4小时16分18秒 | 141.3 g
4号 | 精细附件A（含托片、2块连接片） | 23 | 5小时6分3秒 | 52.3 g
5号 | 精细附件B（含电池托架、1块连接片） | 23 | 5小时18分21秒 | 46.9 g

四台同时启动，新增任务约5小时18分21秒完成，PLA共382.3 g；整套还需等1号机剩余任务完成。2至5号只是分工标签，发送时选对应空闲设备。

文件位于parallel-after-old-plate2-20261101/projects/：

P2S_PRINTER_02_BASE_REAR.3mf

P2S_PRINTER_03_BASE_FRONT.3mf

P2S_PRINTER_04_FINE_CLAMPS_A.3mf

P2S_PRINTER_05_FINE_CLAMPS_B.3mf

每份各打印一次。作为项目打开，保留参数、100%比例、原排布和逐层打印，重新切片后发送。P2S 0.4 mm、PLA、纹理PEI，标准100%速度；每台调平并检查首层。

2/3号底板平放，0.24 mm层高、顶底7层、5 mm防翘边；4/5号附件0.16 mm层高、顶底10层、3 mm防翘边。均为首层0.20 mm、4墙、30% gyroid，自动支撑与擦料塔关闭。原夹具尺寸不改，同一模块夹具在同一盘。

底板仍是原280×220尺寸的两片拼接，按66.1、66.2使用三块连接片及新增12套M3×16螺钉固定；上平台在1号机整片打印。正在打印3件＋本版48件合计51件，无重复或遗漏。

不要再打印原43件附件合盘、旧主体三盘或此前“附件盘在打印”的四台文件。四份新工程已切片及检查首层，尚未实物打印、承重或寿命验证。

## 66.9 模块底座名称标牌

本轮11个待打印底座加一体名称标牌；上盖、拨片、簧片和托片不加。原孔位和夹持结构不变。标牌厚1.8 mm，凸字高0.64 mm，字高4 mm。

附件改用labeled-bases-20261101/projects/中的P2S_PRINTER_04_LABELED_CLAMPS_A.3mf与P2S_PRINTER_05_LABELED_CLAMPS_B.3mf；各23件，0.16 mm层高，预计5小时17分和5小时34分。2/3号底板仍按上一版打印。

昨天第二盘继续；喇叭带标牌版仅提供可选STL/STEP，不重复安排。BUZZER为蜂鸣器，BAT 2S为串联电池，5V BUCK为5V降压。其余标牌使用模块型号。


图解63 模块底座名称标牌；SPEAKER为可选喇叭底座。静态避让与切片已检查，实际接线和装配仍需核实。

## 66.10 旧版另钻孔电机穿槽转接座

用户已试配确认：B件槽12×2.4 mm、槽中心距21 mm、承托厚3 mm合适；固定片从上向下穿入，宽头实测高5 mm。新版宽头腔6 mm，固定耳总高9 mm，电机贴合面不加文字。

打印motor-adapter-20261101/P2S_D06_ADAPTER_PAIR_028.3mf，两种座各1件，预计46分30秒、16.3 g。0.28 mm层高、4墙、40%填充，保持100%尺寸。图中分耳座用于非舵机侧，偏耳座用于舵机侧，偏耳四孔翼朝车头。

先装固定片、电机和轮子，再放到底板下断电试摆。检查轮胎全周净隙至少约3 mm、两轴共线、宽头和紧固件不顶住。候选孔位只经数字避让，完整轮组尚未验证，暂不钻底板；试摆后再确认孔位。

最终连接拟用8颗M3×20低圆头螺栓、16片OD≤6 mm/厚0.5 mm垫圈、8颗高4 mm锁母，贯穿5 mm底板实心区和固定耳。装好轮组后量Hb，再按实测Hb与万向球高度20 mm决定垫高件。无承重或行驶验收结论。


图解64 电机转接座实物模型与安装剖面；图示固定片用于说明穿入方向，不代表完整轮组已验证。

## 66.11 四块平放筒壁与元件安装

本节对应wall-panels-20261102版。四壁各为一体，PLA平放打印，小附件分配到四盘；保持正常质量，不使用电机座的快速试配参数。模型与切片检查通过，实物装配和传感器功能仍待验证。

四台P2S可同时运行四个项目：01前壁和操作面板约7小时20分、192.4g；02后壁及附件约4小时48分、126.6g；03左壁及附件约4小时9分、107.2g；04右壁及附件约2小时54分、85.8g。最长一盘约7小时20分，另计设备准备和冷却。

打开对应3MF项目并保持100%比例及现有摆盘，选择P2S 0.4mm、实际PLA耗材和纹理PEI板，再切片发送。前盘0.20mm、其余0.24mm，首层0.20mm，3墙、15%螺旋体填充、上下4层。需要支撑的附件已采用自动树状支撑；参数和官方GitHub来源记录见随件README及source/github_support_source.json。


图解65 四壁与元件安装座；图中省略电子件、螺钉及活动盖。

## 66.11.1 安装顺序和首次试配

冷却取件、去除支撑后，先试装小附件。前操作面板集成OLED、编码器、两个按钮、RC522和急停。OLED按孔和下缘承托固定；编码器用原套筒螺母；按钮用可调托架、隔柱和压框；RC522用边缘托轨和压条。只压PCB空白边缘，不能压玻璃、元件或排针。

用8个外侧角码连接四壁，内侧平面朝垃圾腔，外侧筋朝外。桶体名义外形160×150×180mm，主面厚1.6mm，边缘及螺孔局部加强。现有P02上平台连续平整面朝上作裸桶底，不套袋、不加内胆；数字检查确认桶内底面连续，但接缝和FDM表面不防水。

整体放到上平台试摆，确认与立柱、电机和舵机立架相容后才划线开孔。四底脚候选孔在P02原模型局部坐标(90,13)、(170,13)、(90,177)、(170,177)mm，通孔Ø3.4mm；四处已核实有5mm完整材料。平台坐标不同于后附壁板u/v坐标，本次未直接改孔或重印上平台。

前操作腔向外深60mm，约超出上平台前缘29mm、底板前缘9mm。先试装急停原螺母、触点块及接线，再盖操作面板；不能挤压端子。按钮用长孔和1/2mm垫片调整高度；编码器前出排针有独立罩。KCD1总开关在左壁下部外置盒，19.4×12.4mm可换孔片需试卡扣。

前壁上部红外托架放31×20mm模块，探头越过板边10mm朝人，排针侧开放。左右对射光轴在桶底上150mm，先用长孔对准，再紧固压条；不用歧义的模块安装孔。左壁外侧分别装DHT11裸探头通风罩和光敏夹座，保持探头、感光区和插线口开放。

超声横梁底面距桶底162mm，探头朝下，以板边压条固定，不能把M2螺丝硬塞进Ø1.5mm板孔。导线走中央缺口，横梁可拆。前壁内侧微动开关用M2螺丝装到9.5mm孔距可调片，触片装原活动盖；两侧止挡加2mm软垫承受盖重，开关只负责信号。

原活动盖、合页和舵机沿用；先断电手动检查完整开合行程，再做按键回弹、RFID读卡、红外开盖、对射遮挡和超声测距等功能试验。模型检查未覆盖实物电子元件、全部五金和舵机连杆的运动包络。

## 66.11.2 五金和孔位读图

四盘包含64个打印实例、33种零件。紧固件长度按模型叠层估算，最终按实际螺母、垫圈及PCB高度选用；螺钉末端不能顶到电路。PLA孔采用穿螺栓加螺母，不假定已有螺纹。完整文件与按零件分类的参数位于hardware/mechanical/print-backup/wall-panels-20261102。

M3×10约20颗：角码16、超声横梁两端2、盖触片2。M3×12约16颗：平台脚4、横梁托耳4、红外架2、止挡4、微动片2。

M3×16共4颗用于红外压条；M3×20约14颗用于DHT罩2、光敏压条4、线夹8；M3×25共4颗用于两端对射座。

总开关盒约用4颗M3×45；前操作腔四角用4颗M3×70贯穿。长螺栓按实物堆叠核对，不靠拧紧来拉弯面板。

M2.5×8/10/12/16/20/35分别约8/2/6/4/4/4颗，对应合页/OLED/LED与超声压条/RFID/按钮/排针罩。微动开关另需2颗M2，长度取决于实物厚度。配对应螺母、垫圈、PCB绝缘垫和两块2mm软止挡垫。

图解66—70按模型坐标标孔，不按图片比例取尺寸。壁板从外侧看，操作面板从背面看，u向右、v向上，原点在各零件左下角，单位mm；孔号对应interface_positions.csv。长孔表中的尺寸为槽宽×总长，图中矩形仅表示范围，实际两端为半圆。

数字核查包括57个打印件装配实例的实体碰撞、85处壁板/面板孔轴贯通、四盘首层对象数及圆弧路径边界。均通过，但并非实物承重、耐久或整机运动验证。前避障、循迹和碰撞横杠仍在底盘低位；其余底板模块维持原安装位置。


图解66 W01_FRONT安装孔坐标与窗口；壁板脚孔另见图下注记。


图解67 W02_REAR安装孔坐标与窗口；壁板脚孔另见图下注记。


图解68 W03_LEFT安装孔坐标与窗口；壁板脚孔另见图下注记。


图解69 W04_RIGHT安装孔坐标与窗口；壁板脚孔另见图下注记。


图解70 PANEL_COVER安装孔坐标与窗口；壁板脚孔另见图下注记。

## 66.12 电机转接板复用底板现有孔

本节取代66.10节中需要另钻底板孔的电机座固定方案。新增左右两块16mm厚转接板，原已试配合适的穿槽座继续使用；底板、模块底座位置和原穿槽基准均不改，不新增底板孔。

从底板上方向下看，X从车尾起算，yb从非舵机侧边起算。蓝色LEFT板共用5个模块座脚孔；棕色RIGHT板共用2个拼接孔、1个MPU6050座脚孔和1个降压托架孔。不是把新孔图当作底板钻孔模板。


图解71 现有孔与新增转接板对应；十字为原穿槽基准，不是实测轮轴中心。

## 66.12.1 转接层与紧固件


图解72 蓝色为新增厚转接板，橙色为原穿槽座；电子模块及完整轮组未画出。

两块新增板采用16mm连续承力板、圆角外缘和五点或四点贯穿锁紧。贴底板面留有原螺母避空；右板另有拼接片凹位。使用金属螺母，不把机螺丝直接拧进PLA。

紧固件 | 数量 | 用途
M3×30 ISO7380低圆头 | 9颗 | 5个LEFT共孔＋4个RIGHT共孔
M3×25 ISO7380低圆头 | 8颗 | 原穿槽座各4孔连接新板
M3尼龙防松螺母 约4mm高 | 17颗 | 8颗预放六角窝，9颗在共孔底部
M3平垫 OD≤6 厚0.5mm | 34片 | 上述每颗螺丝配2片，现有合格件可复用

先把垫圈和锁母放入每板4个六角窝，T形固定片先穿入原穿槽座，再将原座用M3×25从下向上固定到转接板，最后装电机。按名义叠层，螺丝端低于贴底板面0.5mm、穿过锁母1mm。实际螺丝及锁母高度可能有差异，贴底板前用直尺确认无顶出；不能让螺丝顶进底板。

原穿槽座3mm电机贴合面、12×2.4mm双槽、21mm槽距和6mm宽头腔保持。原穿槽基准为(96,14)与(96,206)mm；相对原直装方案，电机整体下移16mm，前后及左右基准不变。旧手册轮轴X≈90只是参考，轮轴与穿槽的实际偏移仍应以装配实物为准。

## 66.12.2 安装顺序与实物确认


图解73 共孔螺丝与预埋锁母安装关系；拼接孔处不叠模块座脚。

先断开电池、USB与所有供电，移开电子板和松散线束，只保留空模块底座。原T形固定片先穿入旧座，宽头留在腔内，再按图解64的方法装电机和轮子。

逐个更换图解71的9个共孔螺丝为M3×30，拆掉这些孔原底面螺母；新板不能隔着原螺母悬空。右板坐入靠舵机侧的拼接片，其中心坐标为(138,138)mm；该片另外2颗原拼接螺丝保留，螺母和尾端进入已留避空。所有螺丝先轻带上，再交替轻紧。

共孔对应：L1/L2为1117稳压座两脚，L3/L4为蜂鸣器座两脚，L5为STM32座靠前一脚。R1/R2为拼接片(126,144)/(150,144)两孔，R3为MPU6050座X=131.5的一脚，R4为降压托架X=189.5的一脚；不移动这些底座。

装好后手转轮胎一整圈，确认与底板、转接板、螺丝及螺母的全周净隙目标至少3mm；两轮轴共线。量底板实际离地高度Hb，万向球原安装高度20mm，后续垫高件按Hb−20mm确定，不在本轮臆定高度。

用户未指定额定载重。本轮只完成几何、五金、切片及图纸检查，不给出额定承重。先空载手推，再按计划实际载荷逐步加载并检查裂纹、发白、松动和永久变形，合格后才进行低速行驶；尺寸试配成功不等于承载验证通过。


图解74 LEFT转接板通孔、六角窝及避空坐标，单位mm。


图解75 RIGHT转接板通孔、六角窝及避空坐标，单位mm。

## 66.13 电机转接板保守轻量化

本节提供66.12节转接板的轻量化替换版。保留16mm总厚度、9个底板共孔、8个原座连接孔、金属锁母、原穿槽座和安装位置，五金及装配顺序继续按66.12节执行；底板仍不新增孔。


图解76 左板3处、右板4处轻量化浅腔；蓝色为新板，橙色为继续复用的原座。

采用向上开口的圆角浅腔，深11mm，轻量化区域保留5mm底层；孔周和直接承力连接筋按16mm全高保留。主筋以11mm宽保护带布置，右板另保留8mm宽斜向保护带，孔周保护半径8mm、外缘4mm；原有五金避空处按原形保留，原最薄4mm处不再减薄。

相同打印参数下，耗材146.97g降至135.93g，减少7.5%；切片时间11小时10分降至9小时41分，缩短约89分钟。CAD实体体积减少17.2%，不把这个比例当成实际耗材节省。

打印文件为motor-existing-holes-light-20261103/P2S_D06_EXISTING_HOLES_LIGHT_016.3mf，只含两块新板。保留0.16mm层高、6墙、60%螺旋体填充、顶底各8层、100%比例，连续平底面贴床、所有凹位朝上，无支撑。不要再次掏薄主筋、孔台和底层。

已核对保护区材料未被移除、下部原材料保持、孔位及包络不变、STEP重读、封闭网格和所有切片路径。轻量化会改变整体刚度；本轮未证明与原厚板等强，也没有额定载重。仍须按计划实际载荷逐步加载，检查发白、裂纹、松动及永久变形，合格后再低速试车。


图解77 LEFT轻量化浅腔定位；原孔位参见图解74—75，实际轮廓按模型和点表。


图解78 RIGHT轻量化浅腔定位；原孔位参见图解74—75，实际轮廓按模型和点表。

## 66.14 筒壁免钻孔压脚转接件方案预览

P02上平台没有原筒壁底脚对应孔。本节给出利用现有孔从上方压住底脚的概念方案：筒壁主框仍位于X＝50～210、Y＝20～170，保持160×150mm外廓和180mm高度，筒壁不垫高，P02继续作为桶底。暂不按旧底脚孔位钻孔。


图解79 四只免钻孔压脚的整体位置；原筒壁和舵机竖架只显示下部，实际零件未切矮。

固定端使用三个现有立柱孔和一个舵机托片孔；长压脚贴着P02外边缘设置挡肩，底脚两侧设置小挡块。舵机侧后压脚绕过P04托片边缘并借其限位，保留（10,180）后角孔与原工具通道。各压脚末端通过金属M3螺母、调压螺丝和小压垫向下压住原底脚。

压脚底面装入普通M3螺母，螺母上方留2.4mm实体挡肩承受向上的反力；需在把压脚装到平台前放入螺母。Ø8×1.2mm压垫跨过原底脚孔；原孔不作为穿入P02的螺栓孔。调压螺丝头保持悬空，只允许轻压，不得将螺丝头拧至贴紧压脚。

初步五金为三颗M3×16固定三个立柱端、一颗M3×20共用托片端、四颗M3×8调压螺丝和四颗普通M3螺母；固定端配垫片，托片下方复用锁母。长度依当前模型估算，立柱盲孔深度、实际螺丝头及工具空间仍需在最终打印版前核对，不能因已有M3×16便认定全部螺丝齐备。

本节是结构预览，未发布打印工程。已检查四个新实体的连通性、封闭网格以及与完整筒壁、P02、P04、P03和模型化五金的几何关系；这不代表实物承载或长期抗蠕变验证。后续仍需确定材料、打印朝向和过渡圆角，再进行试装与逐步加载。


图解80 普通压脚C1的固定端、贴边挡肩、底装螺母和小压垫；C2与C3按各自孔位布置。


图解81 舵机侧后压脚C4借用P04托片孔并绕过其边缘；保留原P03竖架。


图解82 现有固定孔与底脚压点坐标；绿圆为借用孔，橙方为施压点，不是P02新钻孔。

## 66.15 筒壁压脚高精度打印与试装

本节为66.14节预览之后的可打印版，使用wall-clamps-fine-20261103/P2S_WALL_CLAMPS_AND_PADS_FINE_012.3mf。一盘含四只压脚和四只小压垫，不含筒壁、平台、原托片或金属五金。固定孔和施压点沿用图解82，P02不钻孔、筒壁不垫高。


图解83 压脚侧放、小压垫平放的保存朝向；打开3MF时选择作为工程加载，保持100%比例。

预设P2S、0.4mm喷嘴、Generic PLA、纹理PEI板、0.12mm层高和0.20mm首层；6道墙、60%螺旋体填充、顶底各12层、外壁35mm/s、外墙加速度700mm/s²。自动树状支撑仅从热床生成，接触Z间隙0.12mm、外裙边5mm。已生成并检查实际支撑，无需重新自动朝向。

三只长压脚增加45°过渡斜撑，长外缘R0.6；短压脚下外缘R0.4。保留底装M3螺母窝和2.4mm上挡肩。网格线性偏差设置0.01mm，0.12mm为层高，均不表示实物尺寸公差保证。需要使用匹配实际耗材的配置，不能把PLA配置直接用于其他材料。

切片预计3小时20分钟、30.5g，含模型与支撑等切片统计。已检查8件首层、168层共97430段挤出运动以及STEP重读、孔腔、网格和原件干涉；3MF保存几何与测试切片一致，不附带可直接执行的G-code，未向打印机发送任务。实际耗时、用料和装配精度以机器结果为准。

打印后冷却取件，先清除裙边及支撑，尤其检查圆孔、六角螺母窝和贴平台的面；不要削薄挡肩。先试装普通M3螺母与M3螺丝，螺母应能完全贴到上挡肩，再按下一页顺序安装。实物有翘曲、裂纹或孔腔明显过紧时先停止装配，不强压。


图解84 实际全层切片预览，橙色为支撑；并非打印完成照片。

试装顺序：先将四颗普通M3螺母分别从压脚底面放入；放好原筒壁，将四只小压垫平放在四个底脚孔上方；装压脚，先松装固定端，再逐只轻调M3×8至小压垫贴紧底脚。螺丝头必须悬空，不能拧至贴住压脚。

固定端拟用三颗M3×16接原立柱，一颗M3×20共用P04托片孔，配原垫片与锁母；装入前核对原立柱盲孔和实际螺丝头，不能靠硬拧消除间隙。打印件未做实物承载或长期抗蠕变验证；完成试装后再逐步加载，观察松动、发白、裂纹或永久变形。

## 66.16 光敏压条与对射压盖的旧底座修复

本节针对已打印旧底座：图一两根光敏压条不能对准，图二红外对射外壳向下滑落。保留旧LIGHT_CRADLE、BEAM_SEAT和筒壁，只更换两根L压条及两个IR下托压盖。使用sensor-retainers-fix-20261103/P2S_LIGHT_BARS_IR_CUPS_FIX_FINE_012.3mf，一盘共4件。


图解85 旧光敏底座继续使用；新条带横向槽和内侧接触台阶，示意PCB不含实际元件。

适用旧光敏底座的数字模型外形44×30mm，左右孔距36mm、上下孔距23mm；原对应压条名义孔距也为36mm。此次未重测旧打印实物，不能把失配原因认定为某个已测尺寸。新版条长50mm、厚3mm，双槽10×3.4mm，槽中心仍以36mm为基准，理论孔距覆盖29.4～42.6mm；实际调节还需避让螺母、垫片和元件。

两根L压条完全相同，内侧0.3mm台阶朝向PCB边。下条直接安装，上条在平面内转180°，使两个台阶相向；沿用2mm厚PCB包络，台阶与旧底座支撑面共同限位。先将四颗螺丝都穿过槽并松带螺母，压条对正边缘后交替轻拧，不能压到芯片、光敏电阻或接插件，也不能把PCB拧弯。

光敏位置按M3×20、平垫和普通M3螺母估算；实际叠层及露牙需试装核对。不要把原47mm的前方红外PCB压条放到此处；新件用L标记区分。接触面有残留裙边时先清理，保持原底座、筒壁孔及整体比例。

打印工程沿用P2S 0.4mm／Generic PLA、0.12mm层高、6墙、60%螺旋体、顶底12层，宽平面贴床，无支撑、3mm裙边。预计约41分钟、3.6g。已检查4件首层及94层路径；层高和0.01mm网格设置不是实物公差保证，仍需打印后试装。


图解86 新IR压盖在旧对射夹座前方增加两个下托肩，中央线槽开放；灰色为名义外壳包络。

原BEAM_SEAT底部开放，旧直压条只在前方压住外壳，没有防止其向下滑动的托面。这是本次修正的结构遗漏。新IR压盖保留22mm孔距和2.4mm前盖厚度，在两侧增加托肩；托面位于旧座局部Y＝3.7mm，托住10×20×9mm名义外壳下沿，光学窗口不变。

中间8mm线槽向前和下方开放，不需要把已有线束穿过封闭小孔。先断电，一手扶住旧夹座再拆原直压条；放好红外外壳，将底部线束放入槽内，盖上IR新压盖。确认壳体下沿确实落在两个托肩上，线束没有夹在托面或螺丝下面，然后交替轻拧两颗固定螺丝。

两端对射各换一个IR压盖，按四颗M3×25、平垫和普通M3螺母估算；已有符合长度的五金可复用，以实际叠层和露牙确认。安装后先断电轻晃确认外壳不再下滑，再恢复对射遮挡测试。若实际外壳尺寸与上述包络不同，不硬压。

已用旧STEP检查新盖与底座不穿透、螺丝通道和光学窗口保持，并以外壳向下及向外各移0.1mm的几何交叠验证止挡存在；8mm出线通道保持开放。此检查只证明名义模型的限位关系，不代表真实模块、线束及打印公差已验收。原两类旧附件保留作历史文件，本节新打印及重打采用修复3MF。

## 66.17 轻量桶盖与随盖附件

本节为适配已打印筒壁的桶盖试装版，保留两只20×20mm金属合页和M2双球头连杆。整盖打印工程P2S_LID_FINE_012.3mf共6件；先用P2S_HINGE_TRIAL_FINE_012.3mf的局部盖片和一只合页连接座确认实物接口。原合页轴心到页片的偏移尚未实测，小样通过后才打印整盖。


图解87 名义模型闭合与打开70°；不代表真实合页及线束已完成运动验收。

闭合盖面166.5×154mm，含前方提盖边外包174.5×154mm。封闭面0.56mm、底面加强筋，最大局部厚度2.96mm。PLA按1.24g/cm³实心体积估算盖板21.7g、移动打印件26.3g；加上金属合页活动部分、螺丝、垫片和连杆后，必须实称，目标40g以内、不得超过原方案45g限制。尚未验证刚度、冲击及疲劳。

P2S 0.4mm喷嘴、Generic PLA、0.12mm层高、首层0.20mm、4墙、20%填充、5mm裙边，无支撑。整盖约2小时41分钟、26.9g；小样约21分钟、1.8g。作为工程打开，100%比例，保持保存的朝向。网格公差0.01mm不等于实物打印精度保证。

后壁现有合页孔继续用：P02坐标下Y为57、69、121、133mm，高度Z178mm。名义轴为X46.5、Z185mm。合页连接座有4.5×2.3mm调节槽，底部沉头槽容纳头径不超过4mm的M2沉头螺丝；先从底部装入螺丝，再把连接座固定到盖板，螺丝头不能凸出底面。普通圆头不能直接替代。


图解88 盖板底面与四类附件；合页连接座需要两只。

试装顺序：先用一只原合页接到后壁原孔，再用M2沉头螺丝连接L02，最后装T01局部盖片。手动检查闭合盖面与壁顶关系、轴筒是否擦碰、连接座是否平贴；若不符，记录偏移后修改连接座厚度，不能靠拧弯盖片调整。小样只验接口，不作整盖承载验证。

连接座与盖板每只用两颗M2.5螺丝；连杆臂和开关支脚各用两颗M2.5，触片再用两颗M2.5。以8～12mm长度配普通螺母和平垫试配，确保露牙且不碰壁；M2球头螺钉长度按原球头实际叠层。沉头M2另备4颗，参考长度8mm，实际核对。所有打印孔按通孔配金属螺母使用。

L03连杆臂在舵机侧，名义有效半径20mm；原SG90舵盘保留。名义合页轴到舵机轴距离改为41.5mm，双曲柄20mm、连杆孔心距50mm，已经不是原50mm轴距平行四边形。闭盖到开盖70°，计算的舵机曲柄几何角约56°到115°，这不是可直接写入固件的舵机角度或PWM。必须先拆杆校准零位，再手动联杆确认行程，之后重新设置开合限位；本次没有修改固件。

L04支脚的横槽调前后位置，L05触片的竖槽调触发高度。先把触片调高，缓慢闭盖，再逐渐下调到开关可靠动作；闭盖重量由原两处2mm EVA缓冲垫承受。保留加强筋上的平面接触区。实际开关拨杆外形未建模，不强压开关。

名义0～70°每2°位置检查通过；核对对象包括旧筒壁、固定传感器支架、舵机架及名义合页包络。实际金属轴偏移、螺钉螺母、球头和线束仍需试装。整盖166层、小样29层全部挤出路径在打印范围内，原生3MF网格回读一致。此版可用于小样验证，实物接口通过前不称为最终装配验收。

## 66.18 三路红外循迹模块轻量转接架

适用于已打印的P01分体底板及轻量电机转接板。三路循迹模块按商品尺寸图67×27mm、两孔中心距59.5mm、孔径Φ3mm设计；实物孔距与探头凸出量仍须首件复核。模块长边沿左右，三个探头朝地，中央探头位于底板Y=110mm中心线。


图解89 底板下方安装位置。A/B复用现有拼接孔；C/D为循迹板孔。橙色为已打印电机转接板，粉色为万向轮设计保留区。

孔位表（底板车尾左下角为原点，X向车头，Y向舵机侧，单位mm）：A=(150,88)、B=(150,116)为原拼接孔；C=(185,80.25)、D=(185,139.75)为模块孔，C/D=59.5mm。模块名义外形X=171.5～198.5、Y=76.5～143.5；最前沿距万向轮设计保留区起点X=214为15.5mm。实际轮胎、万向轮全转动范围和线束仍要试装留至少3mm净隙。


图解90 原底板、拼接片、新支架、垫柱及循迹板叠层示意。垫柱长度需按实测离地空间选择。

断电后只卸A/B两颗原M3×16拼接螺钉，保留拼接片与其余螺钉。用两颗M3×20低圆头螺钉由上向下穿过原孔、底板、拼接片和新支架；上下面各一片OD≤6mm、厚约0.5mm平垫，下面加M3防松螺母，均匀轻紧。不能让拼接片悬空或压裂PLA。

在C/D孔用同一长度的两只垫柱。螺钉从模块探头面经Φ3孔、垫片、垫柱和支架穿出，上面用垫片及M3防松螺母。14mm垫柱配M3×25，18mm配M3×30，22mm配M3×35；螺钉头和垫片不能遮挡探头或压住焊点。先用14mm试装，轮子落地后测探头最低点离地距离，再按实测工作距离选择。静态和轻压车体时均不能擦地。

手转两侧轮胎与前万向轮一整圈，检查模块、支架、螺钉和后引线都不碰轮胎或地面。线束向后上方固定。打印工程tracker-mount-20261103/P2S_TRACKER_LIGHT_FINE_012.3mf含一块镂空支架和14/18/22mm垫柱各两只；P2S、0.4mm喷嘴、Generic PLA、0.12mm层高、4墙、30%填充、4mm裙边、无支撑，切片约1小时09分、9.6g。实际打印、离地、振动和循迹功能尚未验收。

## 66.19 D05万向轮轻量增高支架

按用户在“制定智能垃圾桶搭建步骤1”中的实测，D05万向轮总安装高度20mm、两孔中心距40mm。65mm轮胎半径32.5mm；原方案底板离地参考45mm，等价于轮轴低于底板下表面12.5mm。已打印电机转接板使轮轴再下移16mm，故底板名义离地为32.5+12.5+16=61mm，万向轮名义增高量为61−20=41mm。本版首选H41。原轮轴偏移是方案参考而非实测，装车后须检查三轮着地。


图解91 复用A1主PCB前侧已有孔A/B，C/D为万向轮40mm孔距；支架位于底板前部实心加强区。

底板坐标：车尾左下角为原点，X向车头、Y向舵机侧。A=(205,65)、B=(205,155)为原A1固定孔；C=(240,90)、D=(240,130)为万向轮连接孔，中心(240,110)。数字检查显示支架与已打印两块电机转接板及循迹模块支架无相交。万向轮安装片真实外形、孔径及转动包络尚未测量，需实装确认。


图解92 名义H41叠层：4mm支臂、孔位7mm承力台、34mm立柱和万向轮安装片。

按高度链首选H41打印工程：一块支架加两只34mm立柱，切片估算18.4g。H35/H40/H45仅为实装修正选项。装好两侧65mm驱动轮和万向轮后，在平整桌面检查三轮同时接地及底板水平；若实物轮轴偏移与原方案参考不同，再测底板下表面离地Hb，按H=Hb−20mm修正。

断电并移开A1线束。C/D两颗M3低圆头螺钉从支架上面的沉孔穿入，头下各配OD≤6mm、约0.5mm平垫；头和垫片必须低于贴底板平面。套两只H41立柱，再接万向轮安装片，下面加平垫和M3防松螺母。按安装片约2mm厚的参考叠层，先试M3×50；实际孔径、片厚、露牙与滚轮净隙必须核对。

把组装好的支架贴底板下表面，A/B与A1主PCB的10mm绝缘柱共用原孔。按PCB 1.6mm、绝缘柱10mm、底板5mm、支架4mm的参考叠层，先试两颗M3×30；不得碰PCB背面焊点。紧固后放在平桌上，确认驱动轮和万向轮同时接地且底板大致水平，手转各轮一整圈，并查循迹模块和线束净隙至少3mm。先空载手推，再逐步加载；实物承重、疲劳和行驶尚未验收。

首选文件为caster-riser-20261103/P2S_CASTER_RISER_H41_LIGHT_016.3mf。P2S 0.4mm喷嘴、PLA、0.16mm层高、6墙、45% gyroid、5mm brim、无支撑；保持100%比例和保存的朝向。数字检查和切片通过，实际承重、疲劳和行驶尚未验收。

## 66.20 H41万向轮支架与循迹架同盘打印

同盘工程为 caster-tracker-plate-20261103/P2S_CASTER_H41_TRACKER_ALL_012.3mf。包含H41万向轮支架和两只34mm立柱、循迹模块转接架及14/18/22mm垫柱各两只，共10件。三种垫柱用于试装选择，实际装配只使用一对等高垫柱。


图解93 P2S同盘摆放：左侧为H41万向轮支架，中间为循迹转接架，右侧为两只H41立柱和三对循迹垫柱。

P2S 0.4mm喷嘴、Generic PLA、0.12mm层高、6墙、45% gyroid、5mm brim、无支撑；10件切片通过且无警告，估算约2小时32分、27.7g。保持100%比例和工程内朝向，按实用材料重新切片。实物打印、三轮着地和循迹探头离地距离仍需试装核对。

# 67 PCB B1手焊装配与模块线束

本章对应新版 SmartBin B1。使用 KiCad 设计，现有模块以排针和杜邦线接入，取消面包板；电池、电机、舵机和语音供电仍走接线端子。安装 B1 时，本章及随包的190端点接线表优先于第63章A1接口说明。原330步骤编号保留。

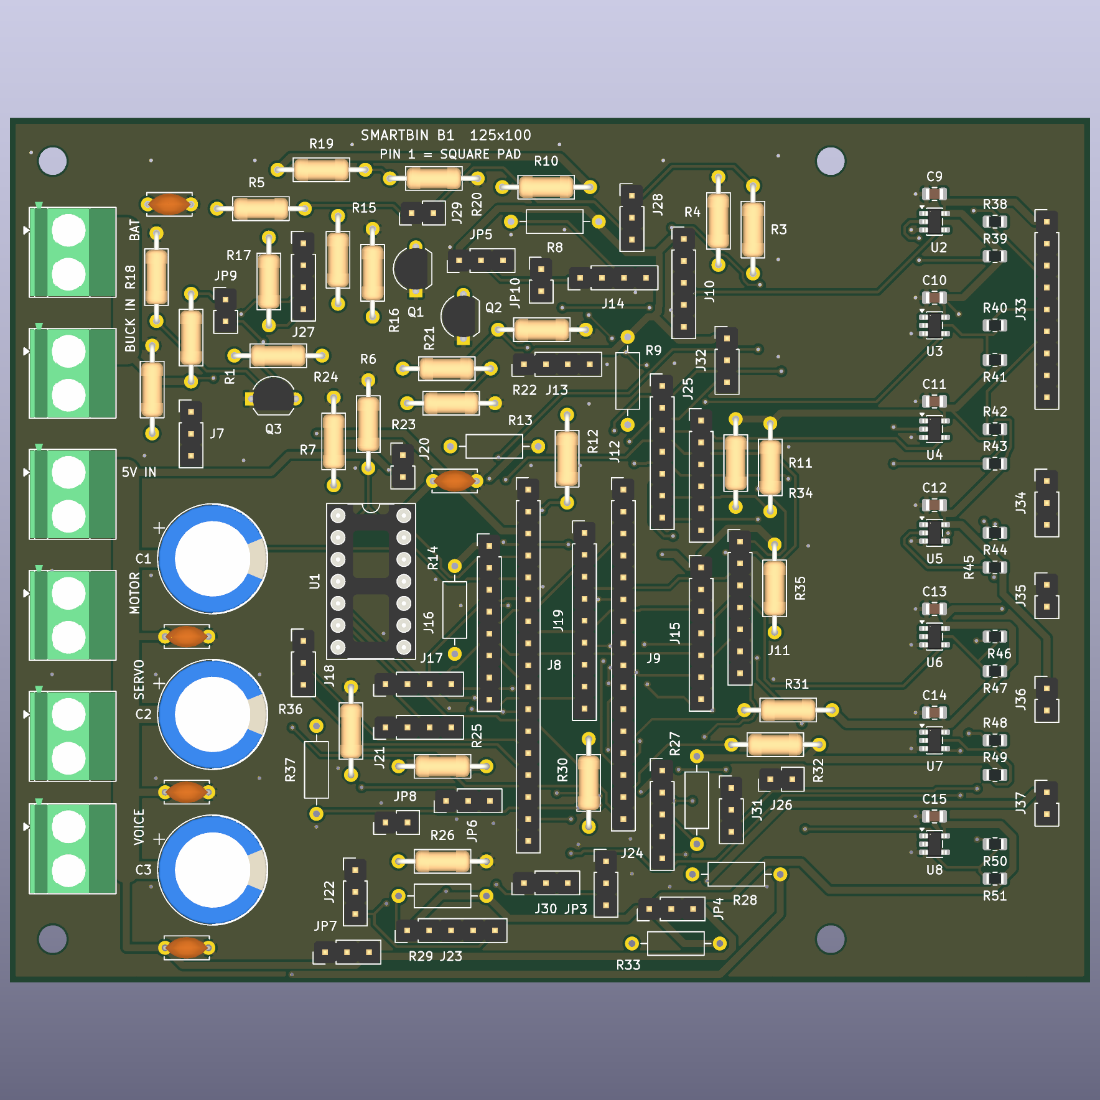
[picture p358: figure]

图 B1-1 元件面俯视。裸板125×100 mm、双层、厚1.6 mm；右侧新增七路输入缓冲。方焊盘表示1脚。空的可选电阻位按BOM的DNP列保留，不能全部补焊。

四个安装孔为Ø3.2 mm。以元件面左上角为原点，中心坐标为(5,5)、(95,5)、(5,95)、(95,95) mm，孔距90×90 mm。右侧新增25 mm板宽，一体打印底座须按新外形检查邻近模块和线束空间。

## 67.1 B1接口变更与电源分区

接口 | B1接法与用途
J6 | 1=5V_BUS，2=GND；DFPlayer独立电源线。喇叭只接模块SPK1/SPK2。
J31 | 1=GND，2=DF_RX，3=DF_BUSY_RAW。BUSY通过U8转换到MCP GPA6；DFPlayer TX仍不接。
J33 电源 | 1=3V3_EXT，2=5V_BUS，3=GND。按具体传感器选择一种VCC，不可把1、2脚相连。
J33 信号 | 4=IR0_RAW→GPB0；5=IR1_RAW→GPB1；6=IR2_RAW→GPB2；7=IR3_RAW→GPB3；8=IR4_RAW→PB8；9=IR5_RAW→PA12。
J34 | 三脚都是GND，分别连接MCP的A0/A1/A2，地址0x20。
J35 / J36 / J37 | 分别为CORE 3.3V / EXT 3.3V / 5V辅助口，均1脚为电源、2脚为GND，只接低功耗逻辑。
其余接口 | 逐针沿用原方案；完整表以本次connector-map.csv为准。自定义PCB针序不等于商品模块物理针序，逐根按模块丝印连接。

U2—U8使用SN74LVC1G17DBVR，SOT-23-5封装；1=NC、2=A、3=GND、4=Y、5=VCC。它们不反相，处理六路红外DO和语音BUSY，RAW输入工作范围限定为共地0—5.25V。不能把这个耐压范围套用到其他未缓冲接口。

U6、U7由3V3_CORE供电，输出分别到PB8、PA12；其余新增缓冲器由3V3_EXT供电，输出到MCP。CORE与EXT共地但不能并联。每路串1kΩ、上拉10kΩ、去耦100nF；无源器件为0805。

J28仍接已焊好的AO3400A转接模块，J23仍可接DHT双向电平转换成品模块；按原供电选择设置JP8。这两块是独立小模块，不用面包板。全部模块保留原有排针。

## 67.2 焊接顺序与首次上电


图 B1-2 实际Gerber生成的焊接面，已按从底部观察显示。对照孔位和方焊盘识别方向，不要再次镜像后照抄。

先焊7颗SOT-23-5和21颗0805，再焊低矮直插件、排针、端子和电容，最后装U1芯片。U1用SN74AHCT125N，不用74HC125。按BOM核对DNP；确认电解电容、晶体管和芯片方向。

断电检查焊桥、极性、两路3.3V隔离和线束。先单独调整降压至5.0V，再按既有步骤分阶段接逻辑和传感器。不同模块断电时，不应继续从外部给信号脚送电。电机、舵机和语音电源不用细杜邦线。

架空车轮验证急停及释放后不自动续跑，再测试舵机和负载。原急停只关闭轮电机驱动，不切断舵机供电；外部3.3V失电时的硬件联锁限制仍保留。

## 67.3 检查结果与实物验收边界

最终KiCad检查为ERC 0违规、PCB DRC 0违规、0未连接、0原理图差异；126个位号、372个连接管脚和8个NC逐脚一致。原33段粗电源铜线保留；制造ZIP的钻孔位置与板数据逐一核对。源工程、BOM、190端点接线表和报告随设计包提供。

这些是数字设计检查，尚未实焊、带载、测温或进行EMC验证。双层板局部回流绕行、原C8距离和模块线长仍需整机测试。原手册的电源检查、模块测试和故障记录继续执行。

# 68 PLA一体结构与精细打印

本章对应2026年11月4日的一体结构修订，配合第67章B1 PCB使用。打印设备按用户最新确认：拓竹P2S、0.4 mm喷嘴、纹理PEI板、256×256×256 mm成形空间，材料为PLA；其他聊天中的PETG参数不用于本版。原330步骤和历史图解保留，机械一体化的差异以本章为准。


图68-1 上半主体。240×190 mm上平台、四面筒壁、固定传感器座、操作仓和超声横梁连续成一件。四角连接件与筒壁固定转接脚取消。前操作面板仍用原四颗螺钉拆开；活动桶盖、模块压框、压条和锁片继续作为可拆附件，不封死检修入口。

桶体主体外形160×150×180 mm。在上平台坐标内，后边距50 mm、前边距30 mm、左右边距20 mm；操作仓外凸不计入该距离。上下平台继续用四根60 mm立柱连接，平台相对底板的坐标偏移为X+20、Y+15、Z+65 mm。

## 68.1 一体底板与模块位置


图68-2 底板左下角为原点，X指向车头，Y指向舵机侧，底板底面Z=0。板外形280×220×5 mm。模块固定底座、电机承托、循迹支架和万向轮增高架均直接连接底板；无需旧底板拼接片、模块座脚固定螺钉或16 mm孔位转接厚板。

位置或接口 | 本版坐标与尺寸
B1 PCB | 外形125×100×1.6 mm；左下角(110,60)，承托面Z=25；孔中心(115,65)、(205,65)、(115,155)、(205,155)，孔距90×90 mm。
电机槽基准 | 左右中心(96,14)、(96,206)；接触面Z=−25，承托厚3；穿槽12×2.4、槽距21、轮侧薄边1.3 mm。
万向轮 | 两孔(240,90)、(240,130)，孔距40 mm；安装面Z=−41。
三路循迹 | 两孔(185,80.25)、(185,139.75)，孔距59.5 mm；安装面Z=−43.4。探头突出8 mm为用户数据，板厚1.6 mm暂按设计值。
移位模块 | MPU6050中心(253,170)，转90°；蜂鸣器(252,65)；喇叭(256,120)，安装耳沿Y，耳孔(256,96)/(256,144)。其余模块沿原布局。

## 68.2 紧固与维修


图68-3 一体底板底面。电机旧固定耳已取消，原配T形金属固定片从上方贯通窗口装入，宽头落在承托腔，保留原配横向电机螺栓。先装轮组，再装电子模块；电机接触面不加文字。

模块翻盖、拨片和簧片沿用原套件；翻盖铰链仍使用M3金属轴，不能把活动部分粘死。拨片轴和簧片锚钉继续贯穿底板。B1改用一体绝缘柱，建议M3×35通螺栓、外径不超过6 mm垫圈与螺母；PCB四孔周围不得压住器件或焊点。

DC-DC的两个真实安装孔保持不变，一体底座取消原底部封闭螺母窝的装配方式，改为从底板下方配M2.5螺母的贯穿紧固，候选M2.5×16，装配时核对突出长度。喇叭安装耳使用原可调螺母托住，M3×30螺柱不穿入PCB占位区。不可依靠拧紧螺母把喇叭耳片拉弯。

万向轮和循迹模块采用贯穿紧固，按实际金属片厚度复核M3×55候选螺钉；螺钉头在底板上方预留沉孔，底部配小垫圈与螺母。循迹探头应低于螺钉末端，避免螺钉先擦地。

H41来自原手册66.19的名义尺寸链：32.5 mm轮半径＋12.5 mm原轴偏移＋16 mm下移=61 mm离地，扣除20 mm万向轮总高得到41 mm。它不是新测出的离地高度。按1.6 mm循迹板厚计算，探头名义离地8 mm；装车后检查三轮同时着地，并通过软件和实测校验循迹工作距离。

光敏压条和红外对射压盖沿用66.16的修复版本，红外压盖必须有底部托肩，不能换回旧直压条。操作面板拆下后再接急停、屏幕及按钮线束；保留22 mm已测插线空间。

MPU6050固定座绕Z旋转90°，原固件显示的roll/pitch方向随安装朝向改变。装好后重新做水平零点校准，并分别向车体前后、左右倾斜验证报警；以后若按车体坐标使用姿态量，需对应调整轴映射。本轮不覆盖正在修改的固件文件。

## 68.3 打印精度与轻量化

项目 | 设置或检查依据
材料与热床 | PLA；Generic PLA P2S基础预设；喷嘴220℃、纹理PEI热床55℃，最大体积速度8 mm³/s。
层高与速度 | 层高0.08 mm，首层0.16 mm；外墙/顶面25、内墙50 mm/s，首层20 mm/s；外墙加速度600 mm/s²。
壳与填充 | 下半件5墙、20%螺旋体；上半件4墙、15%螺旋体；顶底各10层，最小厚度0.8 mm。
树形支撑 | 自动混合树形；枝径3 mm、分支角35°、2道支撑壁；上下Z间隙0.16 mm，XY间隙0.35 mm，上接触3层、下接触2层，接触间距0.35 mm。
边界 | 下半件竖立、盘内转45°；上半件倾斜，分盘打印、100%比例；外侧裙边6 mm。必须以最终项目实际切片后的支撑和挤出路径确认256 mm边界。
减重 | 下板在既有浅腔中心保留2 mm连续面皮，保留原12 mm网格主筋及孔周加厚；筒壁保留1.6 mm面皮。仅深化浅腔去掉约14.7 cm³实体，耗材重量以实际切片为准。

0.08 mm是本机0.4 mm喷嘴配置的最细支持层高，不代表尺寸误差为±0.08 mm。名义孔槽和100%模型比例保持，未依据实物校准结果擅自补偿孔径、流量或整体缩放。更细层高主要改善斜面台阶；接触支撑的表面仍需清理后试配。

已检查实体闭合、关键孔槽、PCB和活动夹具的静态空间、平台立柱及操作面板。新的整件打印、支撑拆除、车轮完整扫掠、层间承载、疲劳及实际尺寸精度仍需实物验证；不能把数字通过称为已验证的额定承重或绝对最轻结构。首件先空壳试装，再逐步增加电池与负载。

建模检查参考GitHub alexanderkoller/codex-cad；树形参数含义参考OrcaSlicer官方wiki support_settings_tree，并以本机Bambu Studio接受的配置和最终路径为准。当前环境没有FreeCAD，未将CadQuery的STEP回读检查冒称为FreeCAD独立验证。

## 68.4 打印方向与补充视图

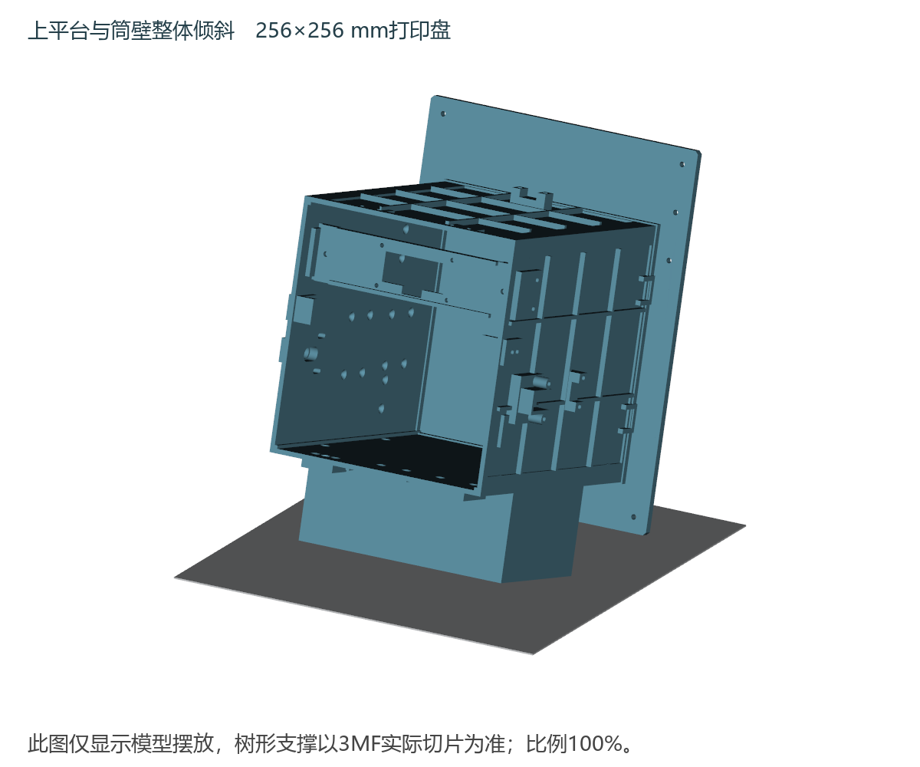
[picture p359: figure]

图68-4 左：下半主体竖立、盘内转45°；右：上半主体倾斜。灰色面为256×256 mm打印盘。这里只显示模型朝向，不显示树形支撑。不要自动摆正或按比例缩小；以3MF内的100%摆放为准。


图68-5 左：下半主体顶侧固定座；右：上半主体底面。图68-2给出模块与孔位坐标，图68-3给出底部承托。模型实际可拆压框、锁片和活动桶盖需沿用旧附件，不能把参考装配中的全部零件当成一个打印件。

## 68.5 实际切片首层


图68-6 左为下半件、右为上半件的实际首层路径，坐标范围均为0—256 mm。蓝色为模型及裙边，棕色为支撑。检查覆盖全部层的实际挤出路径，包括树形支撑与裙边，不只检查模型外框。


图68-7 可拆操作面板单独平放，无支撑；四螺钉检修方式保持。

工程 | 本机切片估算
下半主体 | 109小时43分；PLA含支撑约653.9 g
上半主体 | 200小时34分；PLA含支撑约1212.5 g
可拆操作面板 | 3小时30分；PLA含支撑约27.5 g

耗时及重量为当前PLA 0.08 mm工程的切片估算，不是已实打结果。更换材料预设、打印速度或支撑参数后需重新切片。

# 69 PLA树形支撑与快速打印检查

用户已明确24小时指每个主体，并选择保持当前结构和PLA材料，交付最快已检查设置。现有切片中，下半主体约13小时41分，达到单件24小时目标；上半主体约32小时58分，仍未达到。按用户选择保留当前两主体结构并交付本章方案，不将它标为全部达标。

打印件 | 层高 | 预计时间 | PLA含支撑
下半主体 | 0.28 mm | 13小时41分 | 373.9 g
上半主体 | 0.28 mm | 32小时58分 | 803.0 g
可拆操作面板 | 0.28 mm | 57分51秒 | 27.0 g

设备保持P2S、0.4 mm喷嘴、256×256 mm纹理PEI板和PLA；喷嘴220℃、热床55℃，使用官方Generic PLA的12 mm³/s最大体积流量。三件合计耗材约1203.9 g。估算包含各盘启动流程，不包含换盘、冷却取件和人工拆支撑。

主体改为0.28 mm层高、3道墙、10%螺旋体填充，顶底3层且最小0.8 mm；面板盖同为0.28 mm。主体外墙120 mm/s、内墙230 mm/s，实际速度受流量、加速度和悬垂限速约束。与第68章0.08 mm工程相比，斜面台阶更明显，薄槽与孔仍需清理试配；不能声称保留同等表面精细度。

主体采用自动细树形支撑：枝径3 mm、分支间距5 mm、分支角40°、支撑阈值35°、1道支撑壁；关闭独立支撑层高，使支撑与模型层对齐；上下Z间隙0.28 mm、XY间隙0.35 mm；上下接触各2层、接触间距0.5 mm；6 mm外侧裙边。面板盖平放无需支撑，使用3 mm裙边。

下半主体保持原竖立方向；上半件重新搜索刚性旋转方向以减少悬垂支撑，模型未缩放，孔位与STEP结构未改。工程在integrated-pla-fast-20261104/projects，作为完整工程打开3MF并保留方向及100%比例。不得对它再用旧0.08 mm预设覆盖后仍引用本章时间。

本次交付按用户确认保留现有结构和PLA材料，采用已测试候选中最快的组合；不再以整套合计24小时作为验收条件，也不擅自重新分件或提高未标定的材料流量。上半主体超出单件24小时的结果如实保留。实物强度、层间结合、打印成功率和支撑拆除尚未验证。

## 69.1 实际树形支撑路径


图69-1 下半主体。棕色由实际切片刀路每3层抽取1层显示，半透明蓝色为原尺寸模型；这不是手画的示意树。打印时使用完整3MF重新切片，不能拿抽样图代替全层路径。


图69-2 上半主体。棕色由实际切片刀路每3层抽取1层显示，半透明蓝色为原尺寸模型；这不是手画的示意树。打印时使用完整3MF重新切片，不能拿抽样图代替全层路径。

## 69.2 首层范围与检查结论

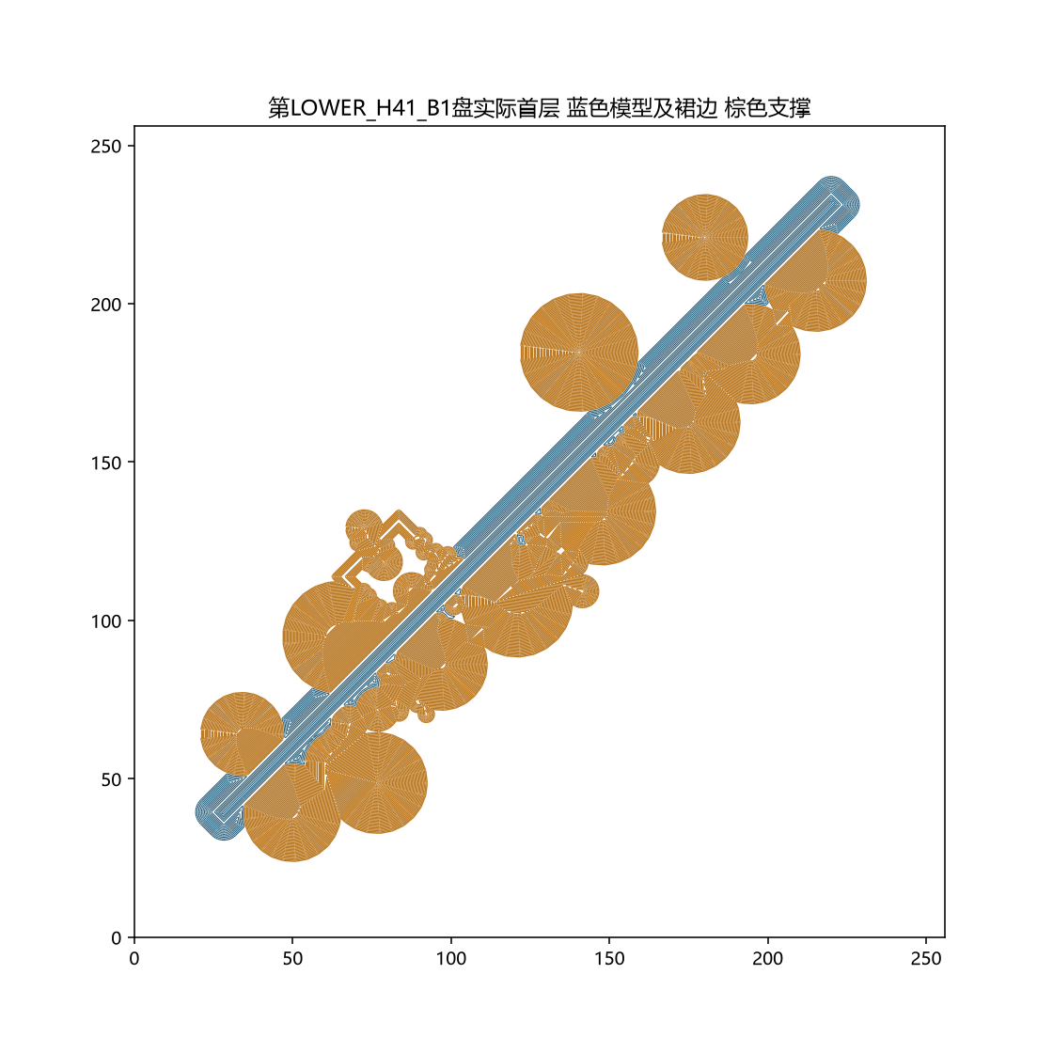
[picture p360: figure]

图69-3 左为下半件，右为上半件。蓝色模型与裙边、棕色树形支撑均取自实际首层。全部层的挤出路径另行检查均位于0—256 mm范围内。

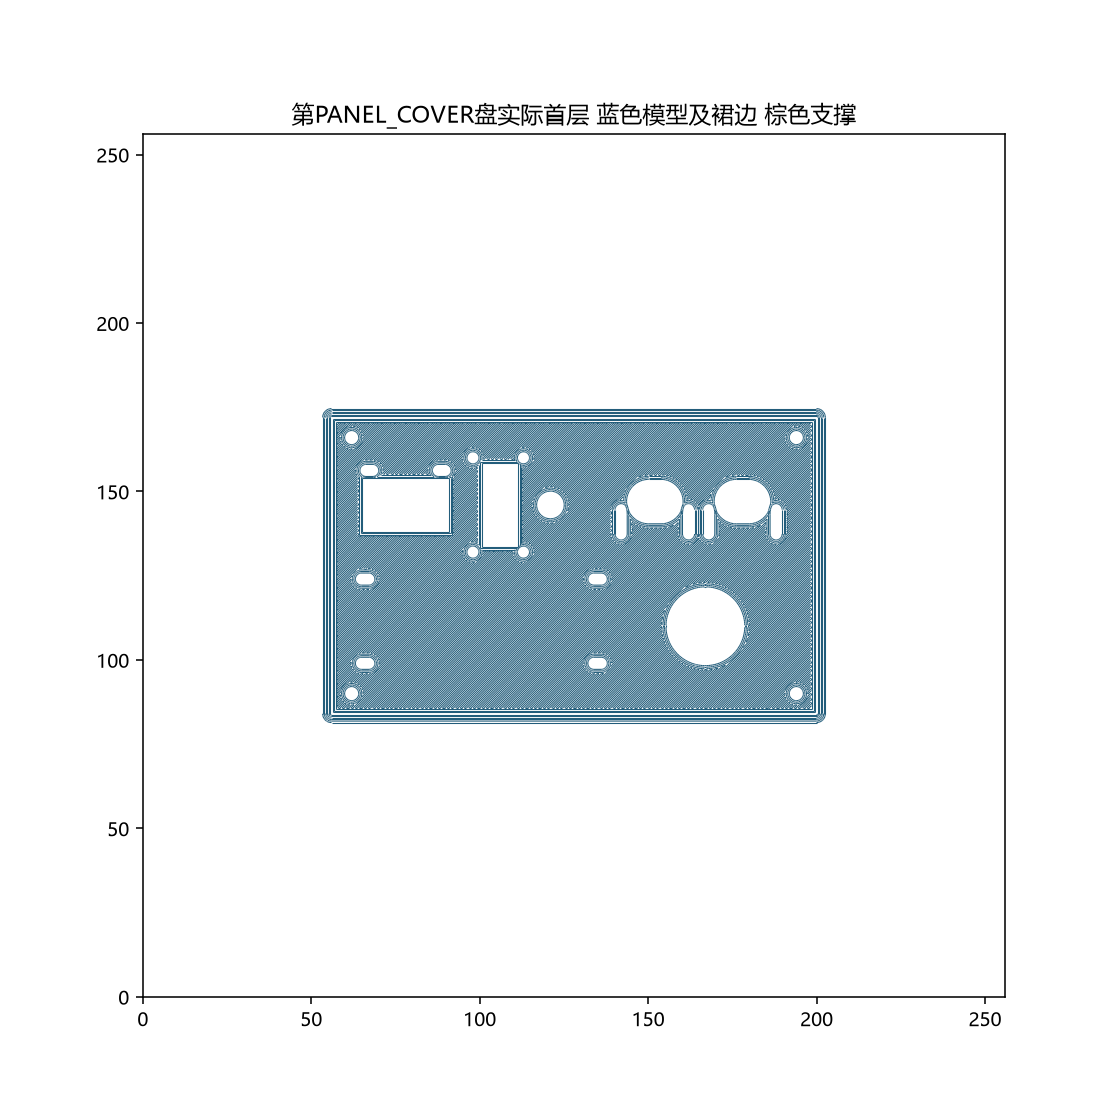
[picture p361: figure]

图69-4 可拆操作面板首层。该面板盖不需要树形支撑；强行加树形会增加耗材和清理工作。

检查包括三件切片无最终警告、完整刀路床面范围和高度、支撑路径存在、工程几何与已检查切片一致，以及上半件旋转前后的模型坐标一致。CAD配合复用第68章检查；本轮没有重新宣称实物装配或承重验收。GitHub codex-cad与OrcaSlicer树形参数文档为流程参考，参数以本机Bambu Studio 02.08.02.61实际切片为准。

STM32与RFID智能移动垃圾桶 逐步组装与调试实施手册
