Sylphiette666/stm32-rfid-smart-bin/hardware/current-low-cost/pcb-a/PROJECT_JOURNAL.md

# SmartBin A — 手焊接口与配电 PCB

## Snapshot

2026-10-12 用户选择 A：裸 PCB 自焊，优先复用已购直插件及现成模块。100×100 mm 双层底板和制造包已完成，原理图 ERC 为 0 错误/0 警告，PCB DRC 为 0 违规/0 未连/0 一致性问题。它替代原 PWR/IO 两块洞洞板；数量由裸板报价选择，只装配一块。Word 与 Git 同步收尾记录见本次发布审核。

## Requirements

- 保持现有 STM32F103C8T6 / MCP23017 成品模块及全部已选功能的 GPIO 分配。
- 核心、MCP、TB6612、降压、3.3 V 稳压、传感器、RFID、FLASH、显示与通信模块外置；自定义接口用短杜邦线按信号名称连接，非商品模块直插插座。
- 复用 DIP14 AHCT 及插座、TO-92 NPN、1/4 W 轴向电阻、径向电容、2.54 mm 接口和 5.08 mm KF301 端子。
- 裸 AO3400A 先焊到独立转接板并接 G/S/D 线；条件 5 V 数字适配及 BSS138 双向转换保留在板外，并在接线表中逐项说明。
- 保持独立 3V3_CORE/3V3_EXT；共地。核心 USB 不连接，下载用 SWD / 3.3 V UART。
- 原电源：成品带保护 2S 电池，满电 8.4 V；外部保险及总开关；外置降压 5 V / 持续 3 A、短峰值至少 4 A。轮驱动与开盖分时运行。
- 设计电流约束：5 V 总线按 3 A 持续 / 4 A 短峰值；动力分支各按 2 A 预算；逻辑支路按 1 A 设计余量。具体器件、负载能力须实测，不把铜箔计算当实物验收。
- FR-4，2 层，1.6 mm，1 oz，绿色阻焊、普通喷锡；无需 SMT、钢网或贴片坐标采购。
- 四角 M3 非金属隔离柱固定，避开既有木板结构；PCB 安装孔定稿后再钻木板，不复用旧洞洞板孔号。
- 电路及 DRC 完成后导出源工程、原理图 PDF、Gerber/钻孔 ZIP、BOM、接口与装配图和上电检查。
- 图解增强版 Word 同名替换需保留 330 步并更新旧接线说明。完成校验后推送现有授权 GitHub 仓库。

## Architecture

电池 → 外置保险/总开关 → PCB 电池端与降压输入端 → 外置 5 V 降压 → PCB 5 V 配电 → 电机/舵机/逻辑独立支路。

逻辑 5 V → 核心自带 3.3 V 与外部 3.3 V 模块分别供电；两路稳压输出不并联。PCB 提供急停三管门控、AHCT 缓冲、电池和超声分压、照明外围电阻及信号接口。

## Validation / acceptance

1. 独立电气连接审查、器件真实脚序与供电核对。
2. ERC、原理图网表与机器规范逐脚一致。
3. 实体布局、散热/电流回路、可焊性、端子操作空间。
4. 布线全连通、DRC 实际报告、铜箔与正反面丝印审查。
5. Gerber + PTH/NPTH 钻孔审查；文件与源版本哈希一致。
6. Word 渲染 QA、根/仓库同名文档一致、Git 推送验证。

## Known physical limits

- 当前三管急停关闭轮电机驱动，未切断舵机电源；释放不续跑依靠固件故障锁。3V3_EXT 失电也使原钳位偏置消失，不声称新增完整硬件失效安全联锁。
- 5 V 模块 DO 不能直入 MCP；按实际模块测得电压选择外置适配。
- 未完成实焊、带载、温升、EMC 或机械整机验收；软件仓库不因换 PCB 自动成为可烧录完整固件。

## Tools / continuity

已有 KiCad 10.0.6（D:/KiCad），在隔离 venv 安装 mash kicad-tool 与其指定 kiutils fork。通过结构化 CLI 扩展/原生 KiCad API 生成新工程，旧工程不改写。用户已批准方案 A，可继续必要设计、校核与文档，无需重复方案许可。所有检查点在本地保留；本阶段不执行制造下单。

## Digital design checkpoints

- 94 位号、72 个有意定义网络；原理图另有 U1 未用输出的自动 NC 网络。293 个有网络管脚与 1 个 NC 管脚逐脚核对。
- 六页原理图和最终 KiCad 10 工程已导出。33 段预先布置的粗电源线经独立几何审计全部保留，未被自动布线缩窄。
- 采用 0.20 mm 低压信号间距，常规信号 0.30 mm、局部 0.25 mm，主干 3 mm、动力分支 2 mm，过孔 0.8/0.4 mm。初始保守 0.25 mm 间距收敛为普通工艺可制造的 0.20 mm，以在 100 mm 板幅内保留全部接口；报告未降级违规严重性。
- 8 个逻辑 GND 焊盘通过显式走线连接，关闭其局部灌铜连接，避免残缺热焊盘。动力端子保持粗铜回路。
- 孔核验：356 PTH、4 NPTH；最小孔径/过孔环宽和铜到板边合格。CAM 使用实际 Gerber ZIP 独立解析、渲染。
- 冻结 PCB SHA256：`b16aad367273b6b39cf8452db6615a54745bc44198ac9485f1a253c8de96b066`。
- 冻结制造 ZIP SHA256：`d613507ebb631bb055847faf6cc9197b1f7f826a0880b4674f329b2af03ee1cf`；7 个 RS-274X 图层＋2 个分开的镀孔/非镀孔 Excellon 文件。
- 图 45–49 已生成；底面图经水平镜像一次，保持上边朝上；图 45 的 DNP 红叉和元件极性与实际工程对应。
- 尚未实际焊接、供电、运行、测温或下单；软件应用固件未因底板设计自动完成。

## Manual release

- 图解增强版已更新到 198 页、330 个原步骤、57 幅内嵌图、64 张表，第 63 章使用图 45–49 和 181 个接口端点。
- 目录、页码、原步骤与图片保留、全部新增页视觉 QA 已完成；根目录与仓库同名 Word 均已替换。
- Word SHA256：e372c23d2ecc6cd6eccb2e3e2e680ce35942d956c96c20b01de713b023563885。验证源与记录位于仓库 docs/manual/pcb-a-update-20261012/。
- 实物焊接、通电、温升与功能验收仍待制作者完成。

## 2026-10-12 四套技能接地加强复查

经真实KiCad10IPC加入55个GND过孔，最终117个。94位号、BOM、接口和33段动力电源/地走线保持。ERC/DRC/原理图一致性零违规，Gerber孔位一一匹配。两处分压以ngspice-46DLL核验。保留EMC地回流/去耦风险与未完成热/生命周期实物信息，不宣称全机验证。更新同名Word第64章及当前制造包，并按用户授权同步GitHub；详见review/four-skills。
