Sylphiette666/stm32-rfid-smart-bin/hardware/mechanical/print-backup/sensor-retainers-fix-20261103/preview/03_actual_first_layer.png

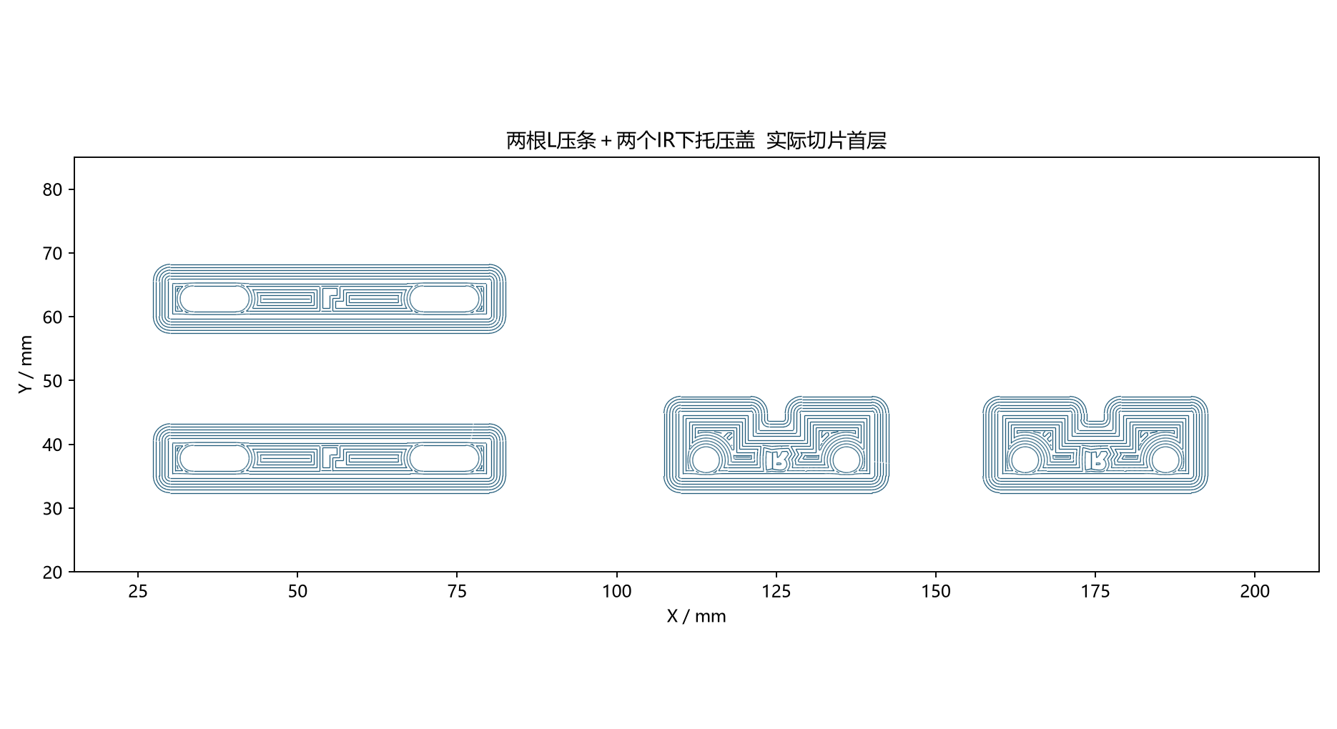
hardware/mechanical/print-backup/sensor-retainers-fix-20261103/preview/03_actual_first_layer.png
