Sylphiette666/stm32-rfid-smart-bin/hardware/mechanical/print-backup/sensor-retainers-fix-20261103/preview/raw_beam_cup.png

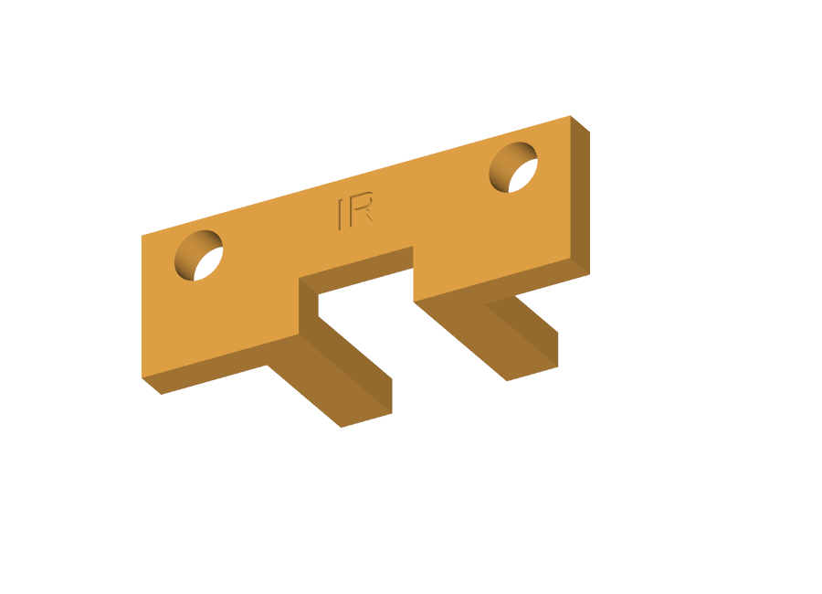
hardware/mechanical/print-backup/sensor-retainers-fix-20261103/preview/raw_beam_cup.png
