Sylphiette666/stm32-rfid-smart-bin/hardware/current-low-cost/pcb-b/checks/SmartBin_B_schematic.pdf

1 | 2 | 3 | 4 | 5 | 6 | 7 | 8

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
Size: A3 | Rev: B1 | F Date: 2026-11-03
KiCad E.D.A. 10.0.6 | Id: 1/8

# Title: SmartBin B / System index

## File: SmartBin_B.kicad_sch

## Sheet: /

## STM32 + RFID / DIY through-hole carrier

Existing external modules; cable connected; all named nets are global.

Prototype: verify polarity and module pin order before connection.

02 01 Power distribution and ADC 文件: SmartBin_B_01_01.kicad_sch | 03 02 MCU, MCP23017 and emergency stop 文件: SmartBin_B_02_01.kicad_sch 04 03 Serial module interfaces 文件: SmartBin_B_03_01.kicad_sch | 05 04 Buffered outputs and actuators 文件: SmartBin_B_04_01.kicad_sch 06 05 Sensor and user inputs 文件: SmartBin_B_05_01.kicad_sch | 07 06 Non-inverting sensor input translation 文件: SmartBin_B_06_01.kicad_sch 08 06 Non-inverting sensor input translation 文件: SmartBin_B_06_02.kicad_sch

# SYSTEM INDEX

B1 | Cable carrier + input buffers | Existing assembled modules remain external PROJECT STRUCTURE

Assembly guidance and external module connections are specified in the accompanying manual. Do not connect the core 3.3 V rail in parallel with the external 3.3 V regulator.

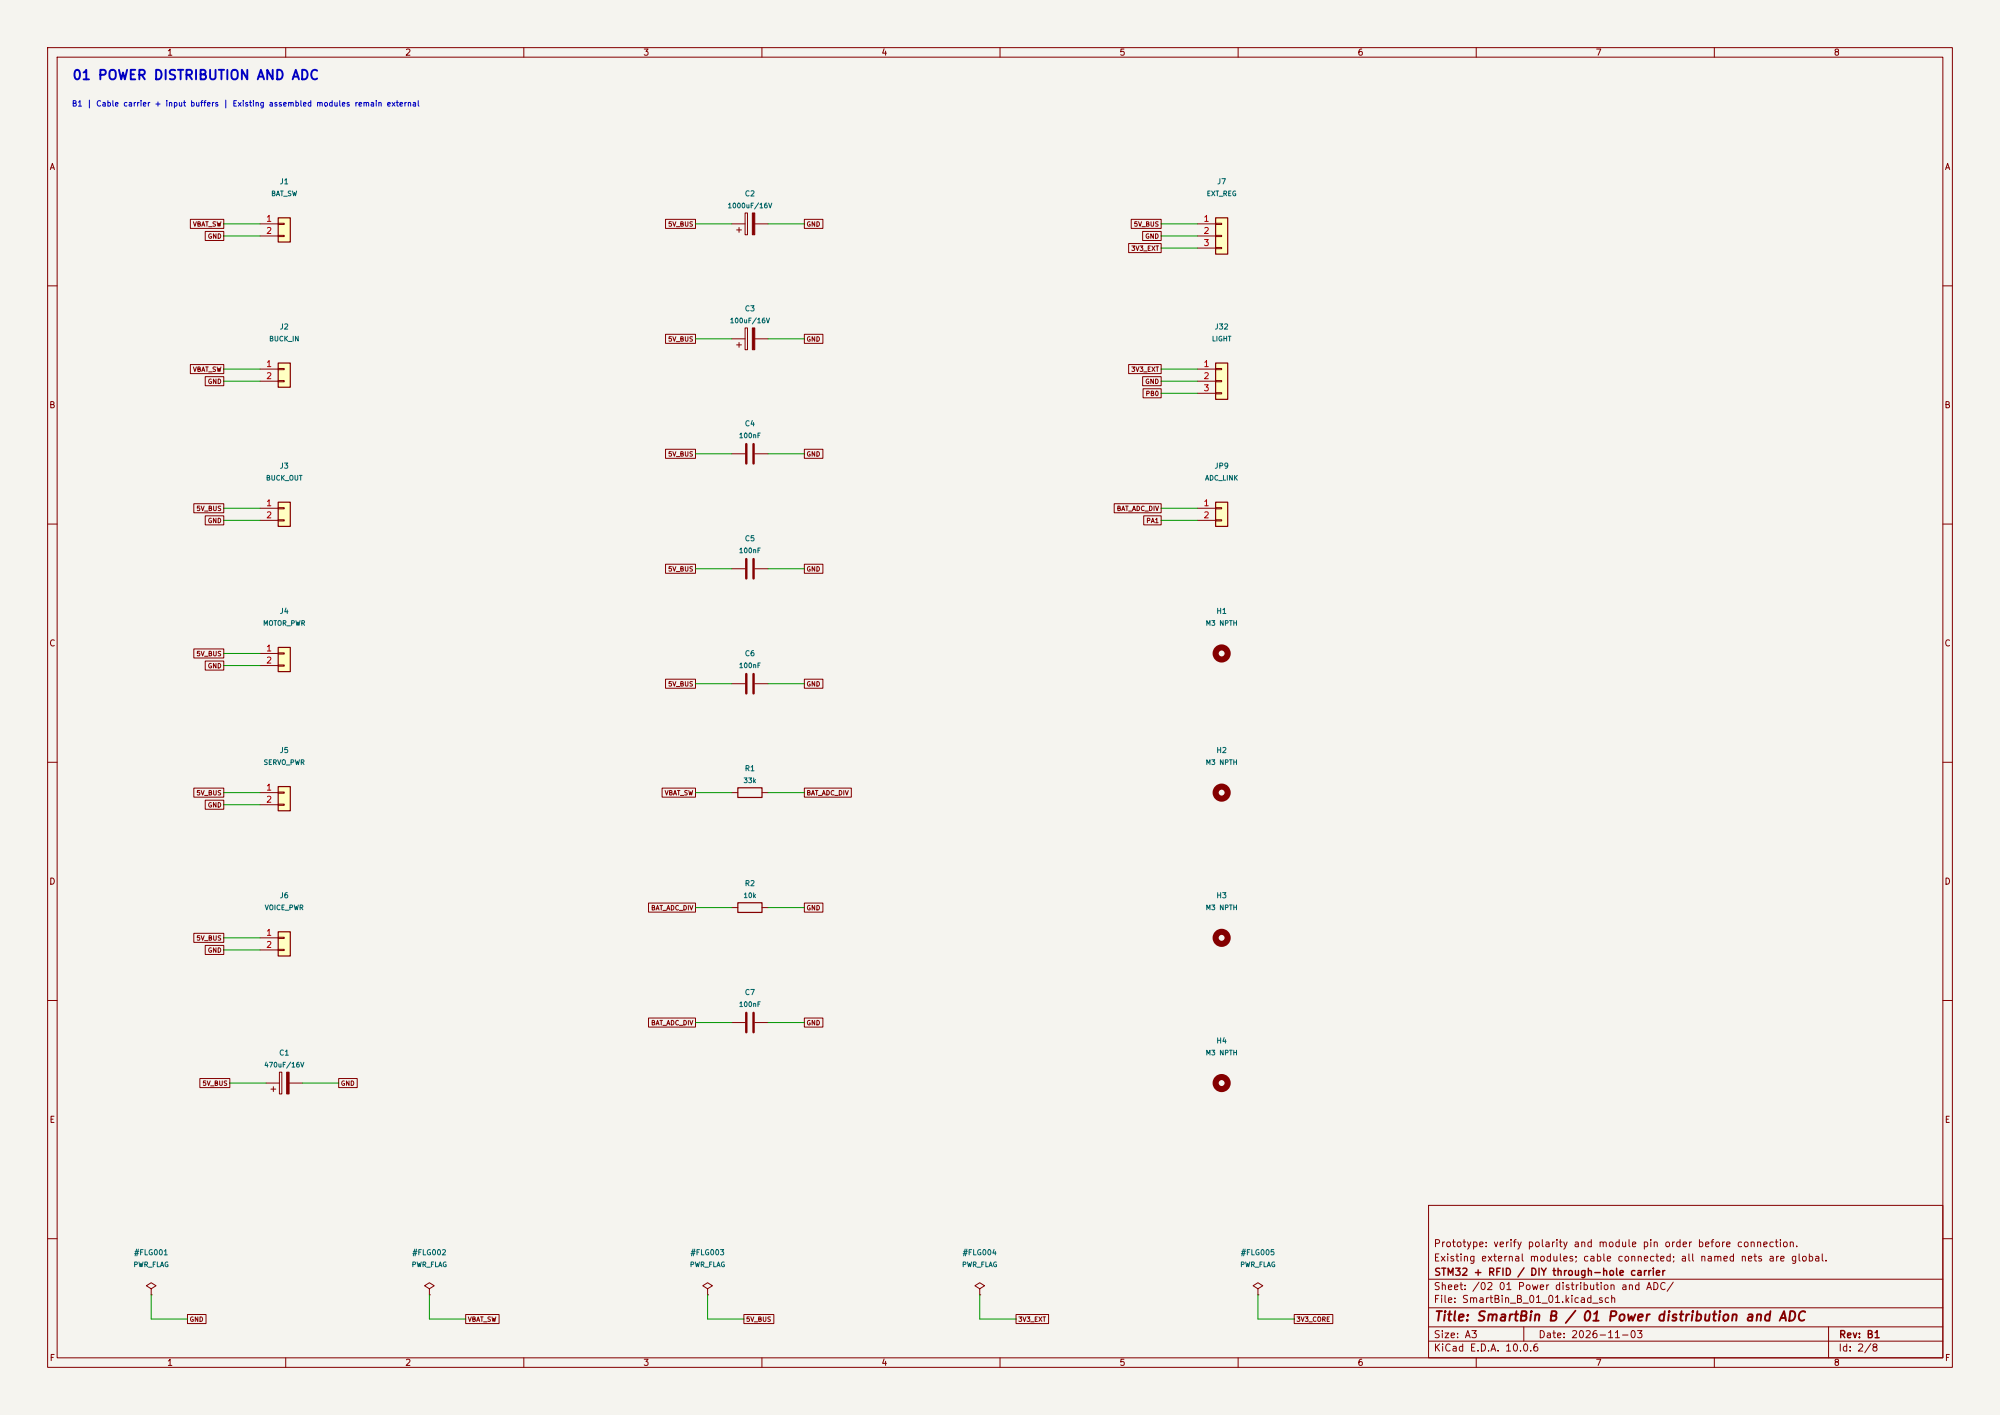
[picture p364: page 2]

B1 | Cable carrier + input buffers | Existing assembled modules remain external 01 POWER DISTRIBUTION AND ADC

Prototype: verify polarity and module pin order before connection.
Existing external modules; cable connected; all named nets are global.
STM32 + RFID / DIY through-hole carrier
Sheet: /02 01 Power distribution and ADC/
File: SmartBin_B_01_01.kicad_sch
Title: SmartBin B / 01 Power distribution and ADC

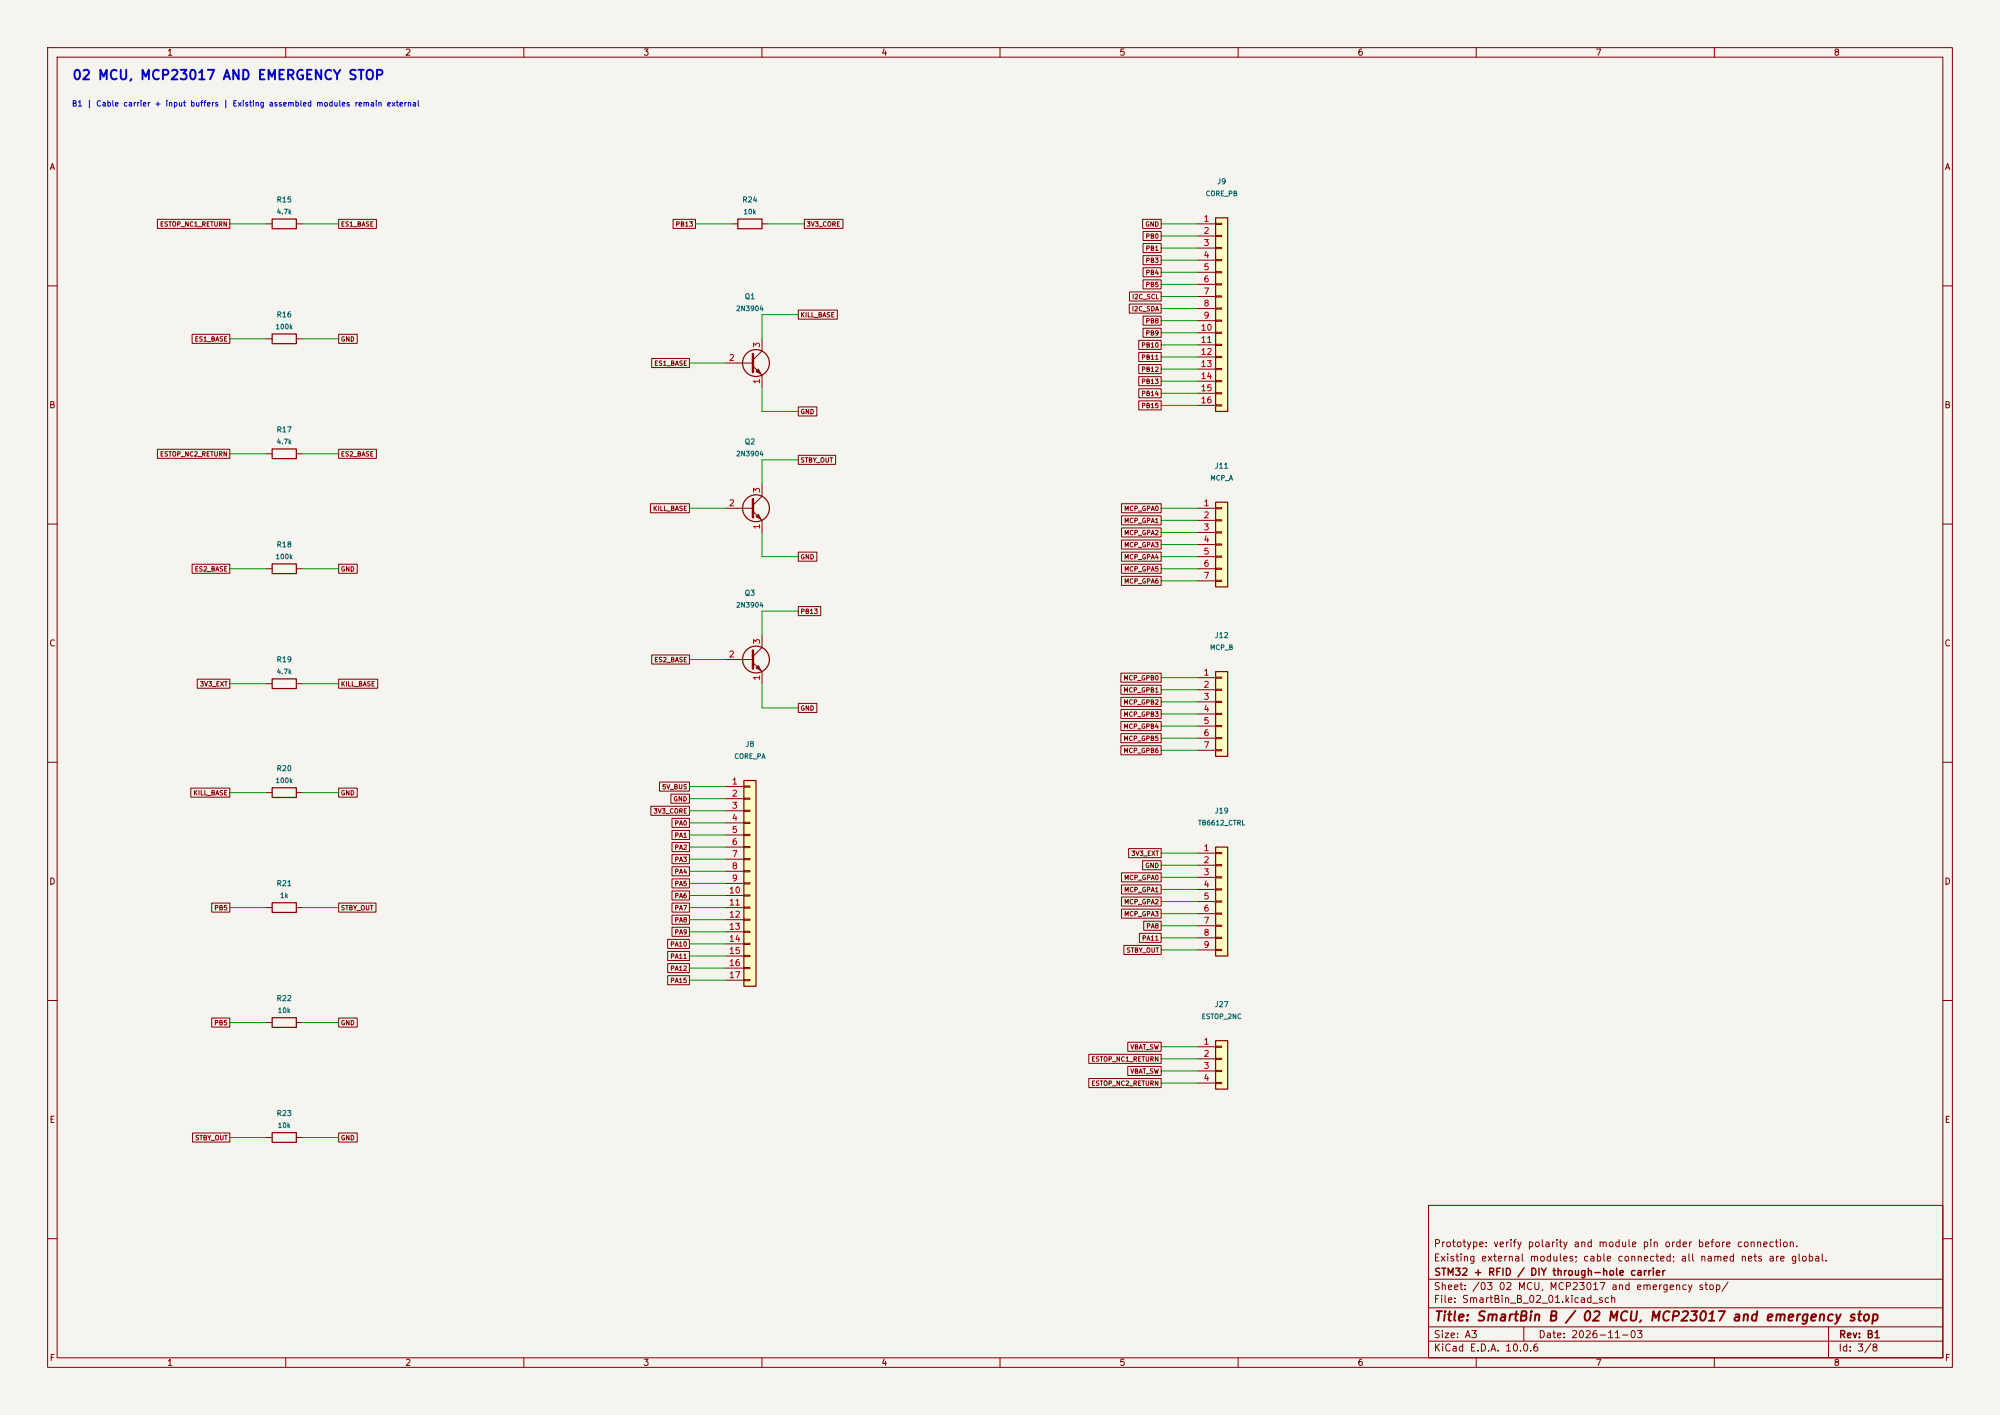
[picture p365: page 3]

B1 | Cable carrier + input buffers | Existing assembled modules remain external

Prototype: verify polarity and module pin order before connection. R23

Existing external modules; cable connected; all named nets are global.
STM32 + RFID / DIY through-hole carrier
Sheet: /03 02 MCU, MCP23017 and emergency stop/
File: SmartBin_B_02_01.kicad_sch
Title: SmartBin B / 02 MCU, MCP23017 and emergency stop

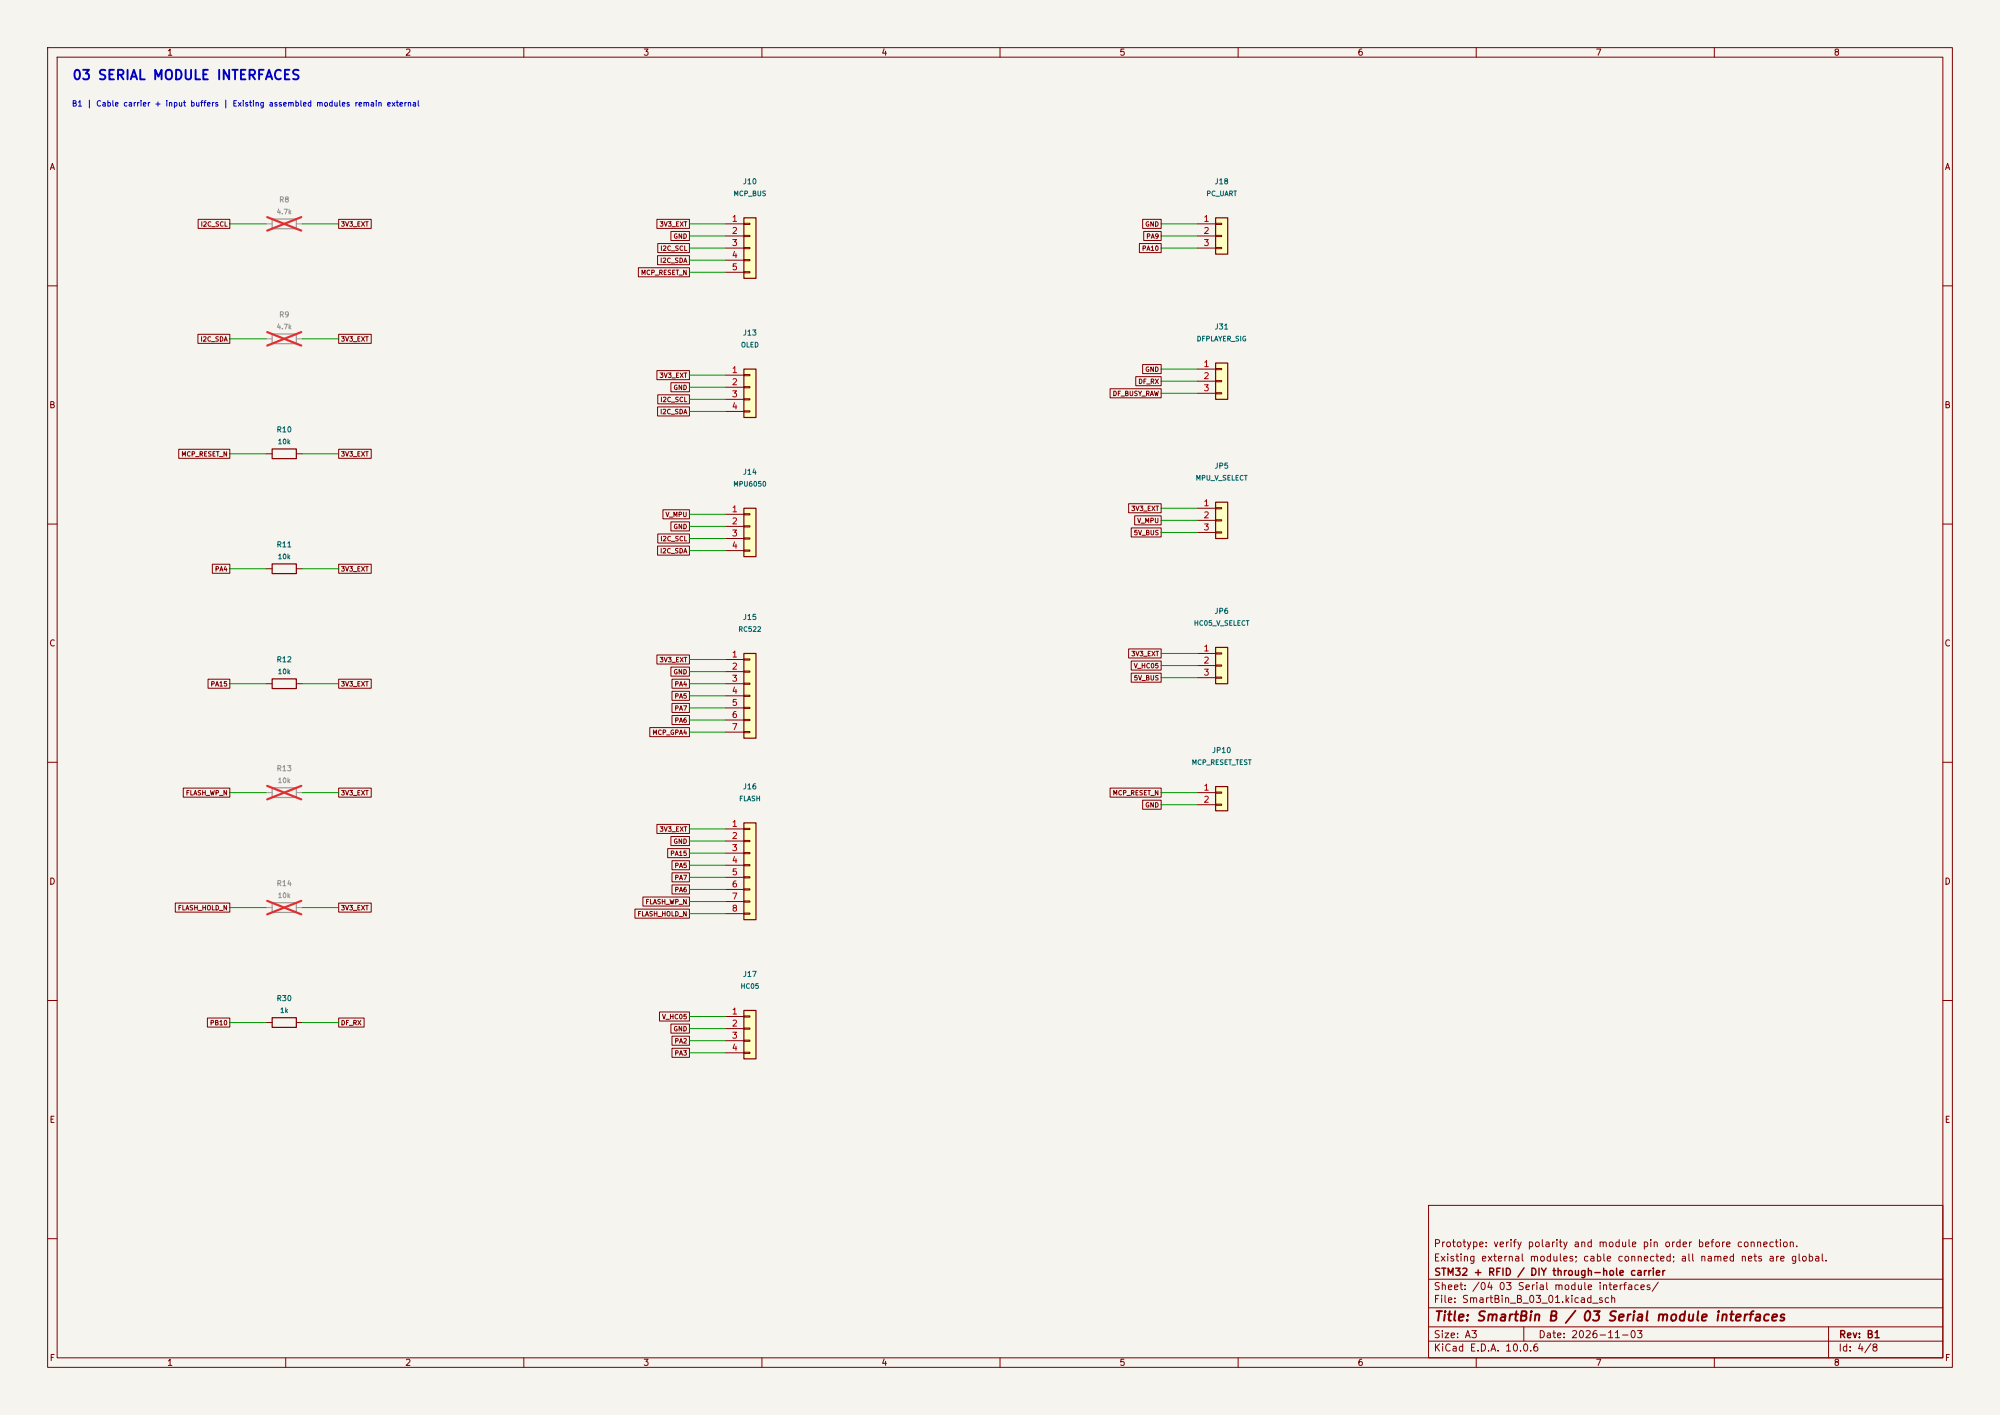
[picture p366: page 4]

Prototype: verify polarity and module pin order before connection.
Existing external modules; cable connected; all named nets are global.
STM32 + RFID / DIY through-hole carrier
Sheet: /04 03 Serial module interfaces/
File: SmartBin_B_03_01.kicad_sch
Title: SmartBin B / 03 Serial module interfaces

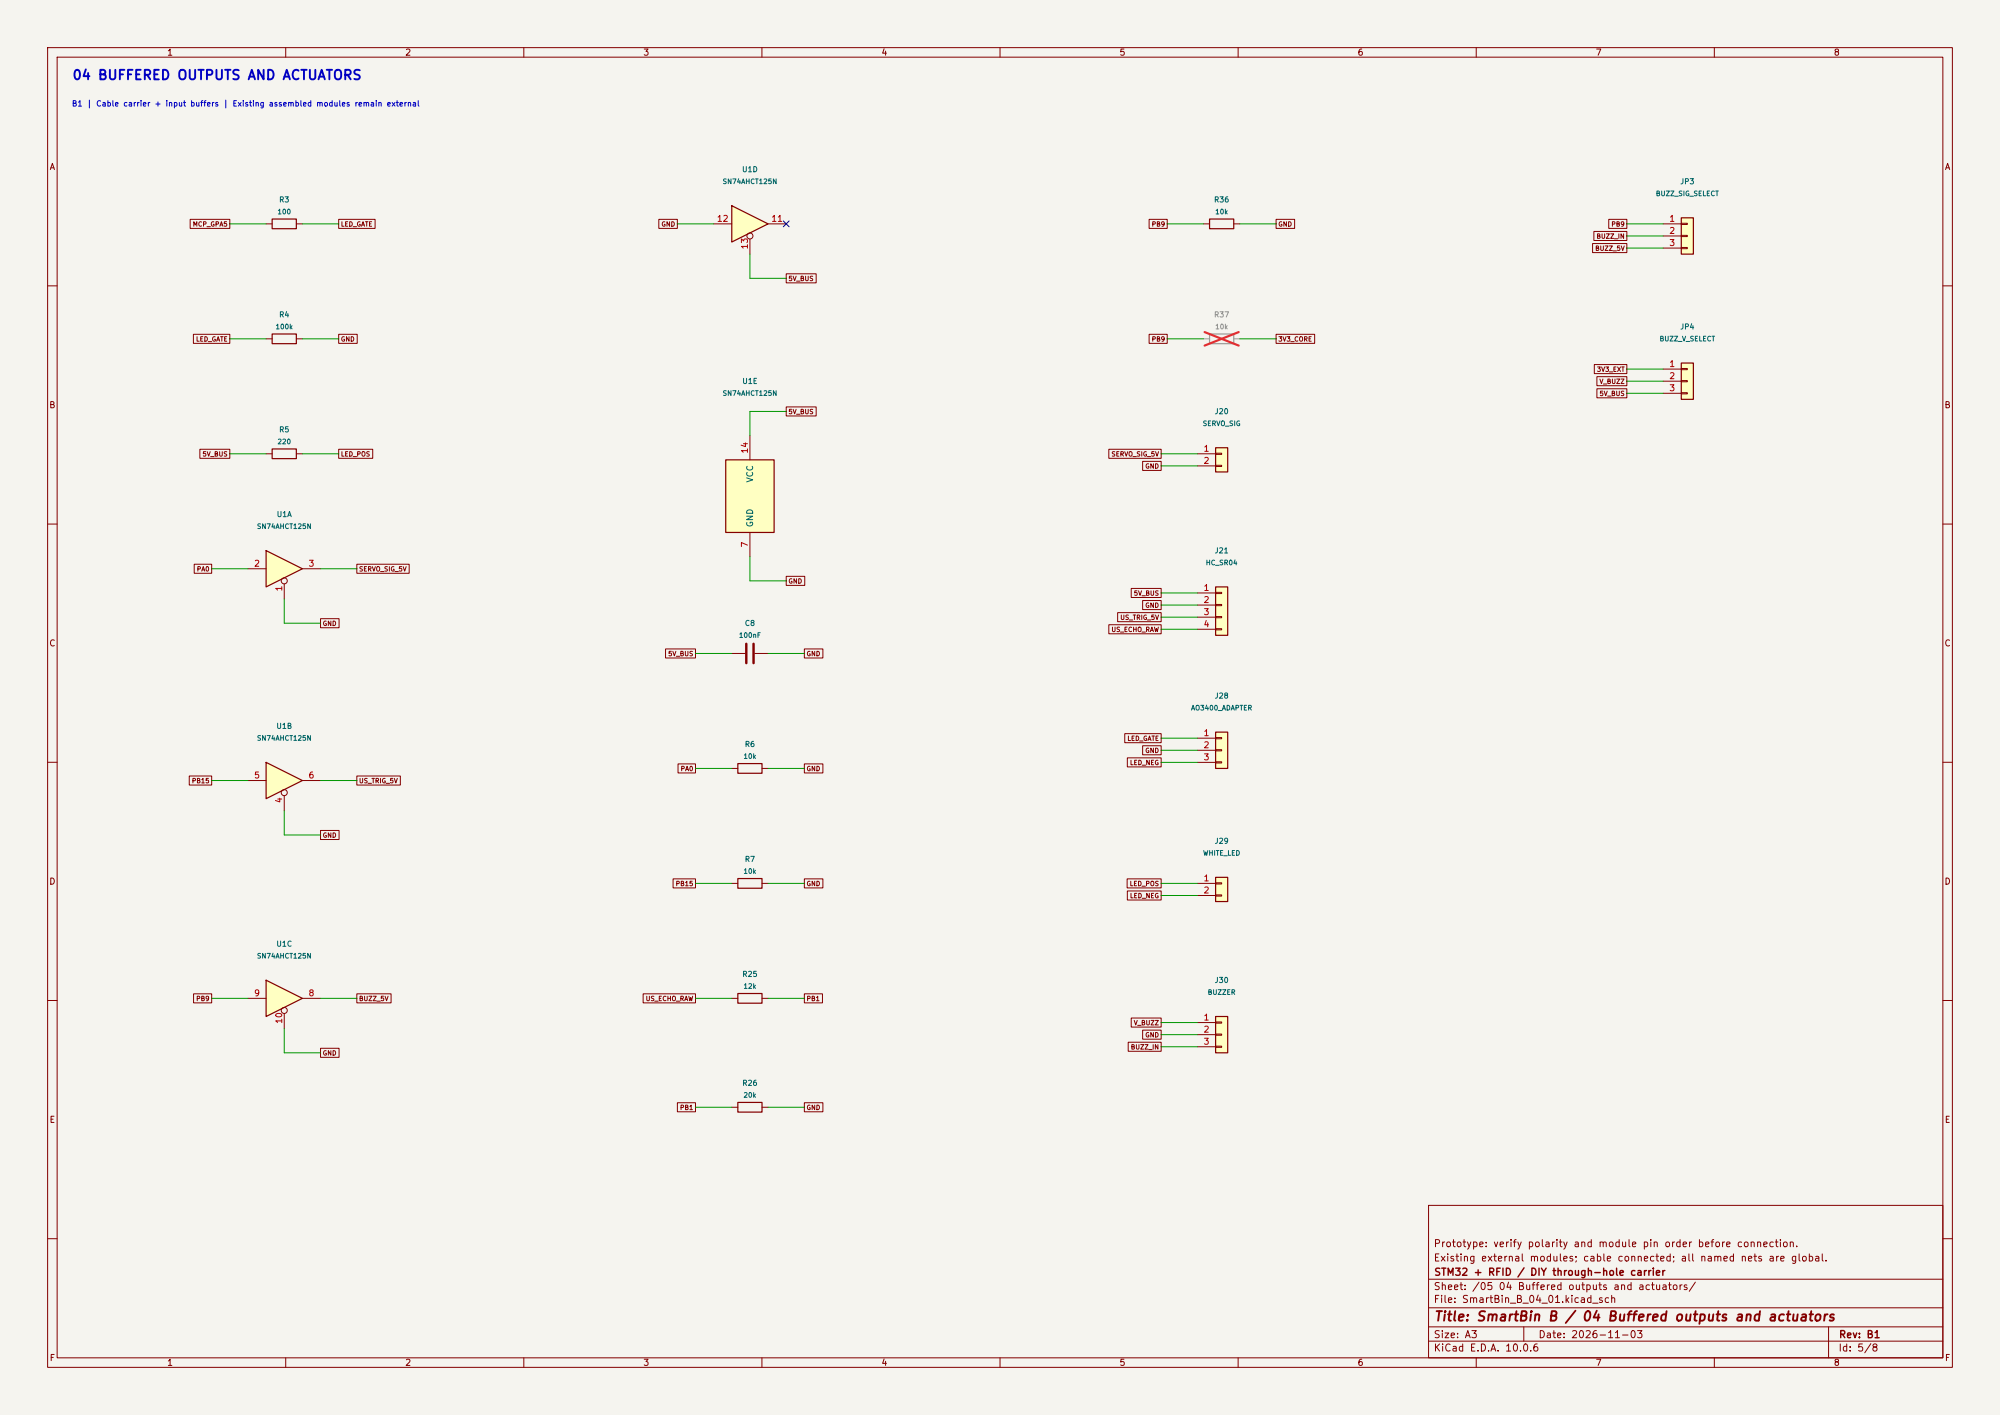
[picture p367: page 5]

B1 | Cable carrier + input buffers | Existing assembled modules remain external 04 BUFFERED OUTPUTS AND ACTUATORS

Prototype: verify polarity and module pin order before connection. R26

Existing external modules; cable connected; all named nets are global.
STM32 + RFID / DIY through-hole carrier
Sheet: /05 04 Buffered outputs and actuators/
File: SmartBin_B_04_01.kicad_sch
Title: SmartBin B / 04 Buffered outputs and actuators

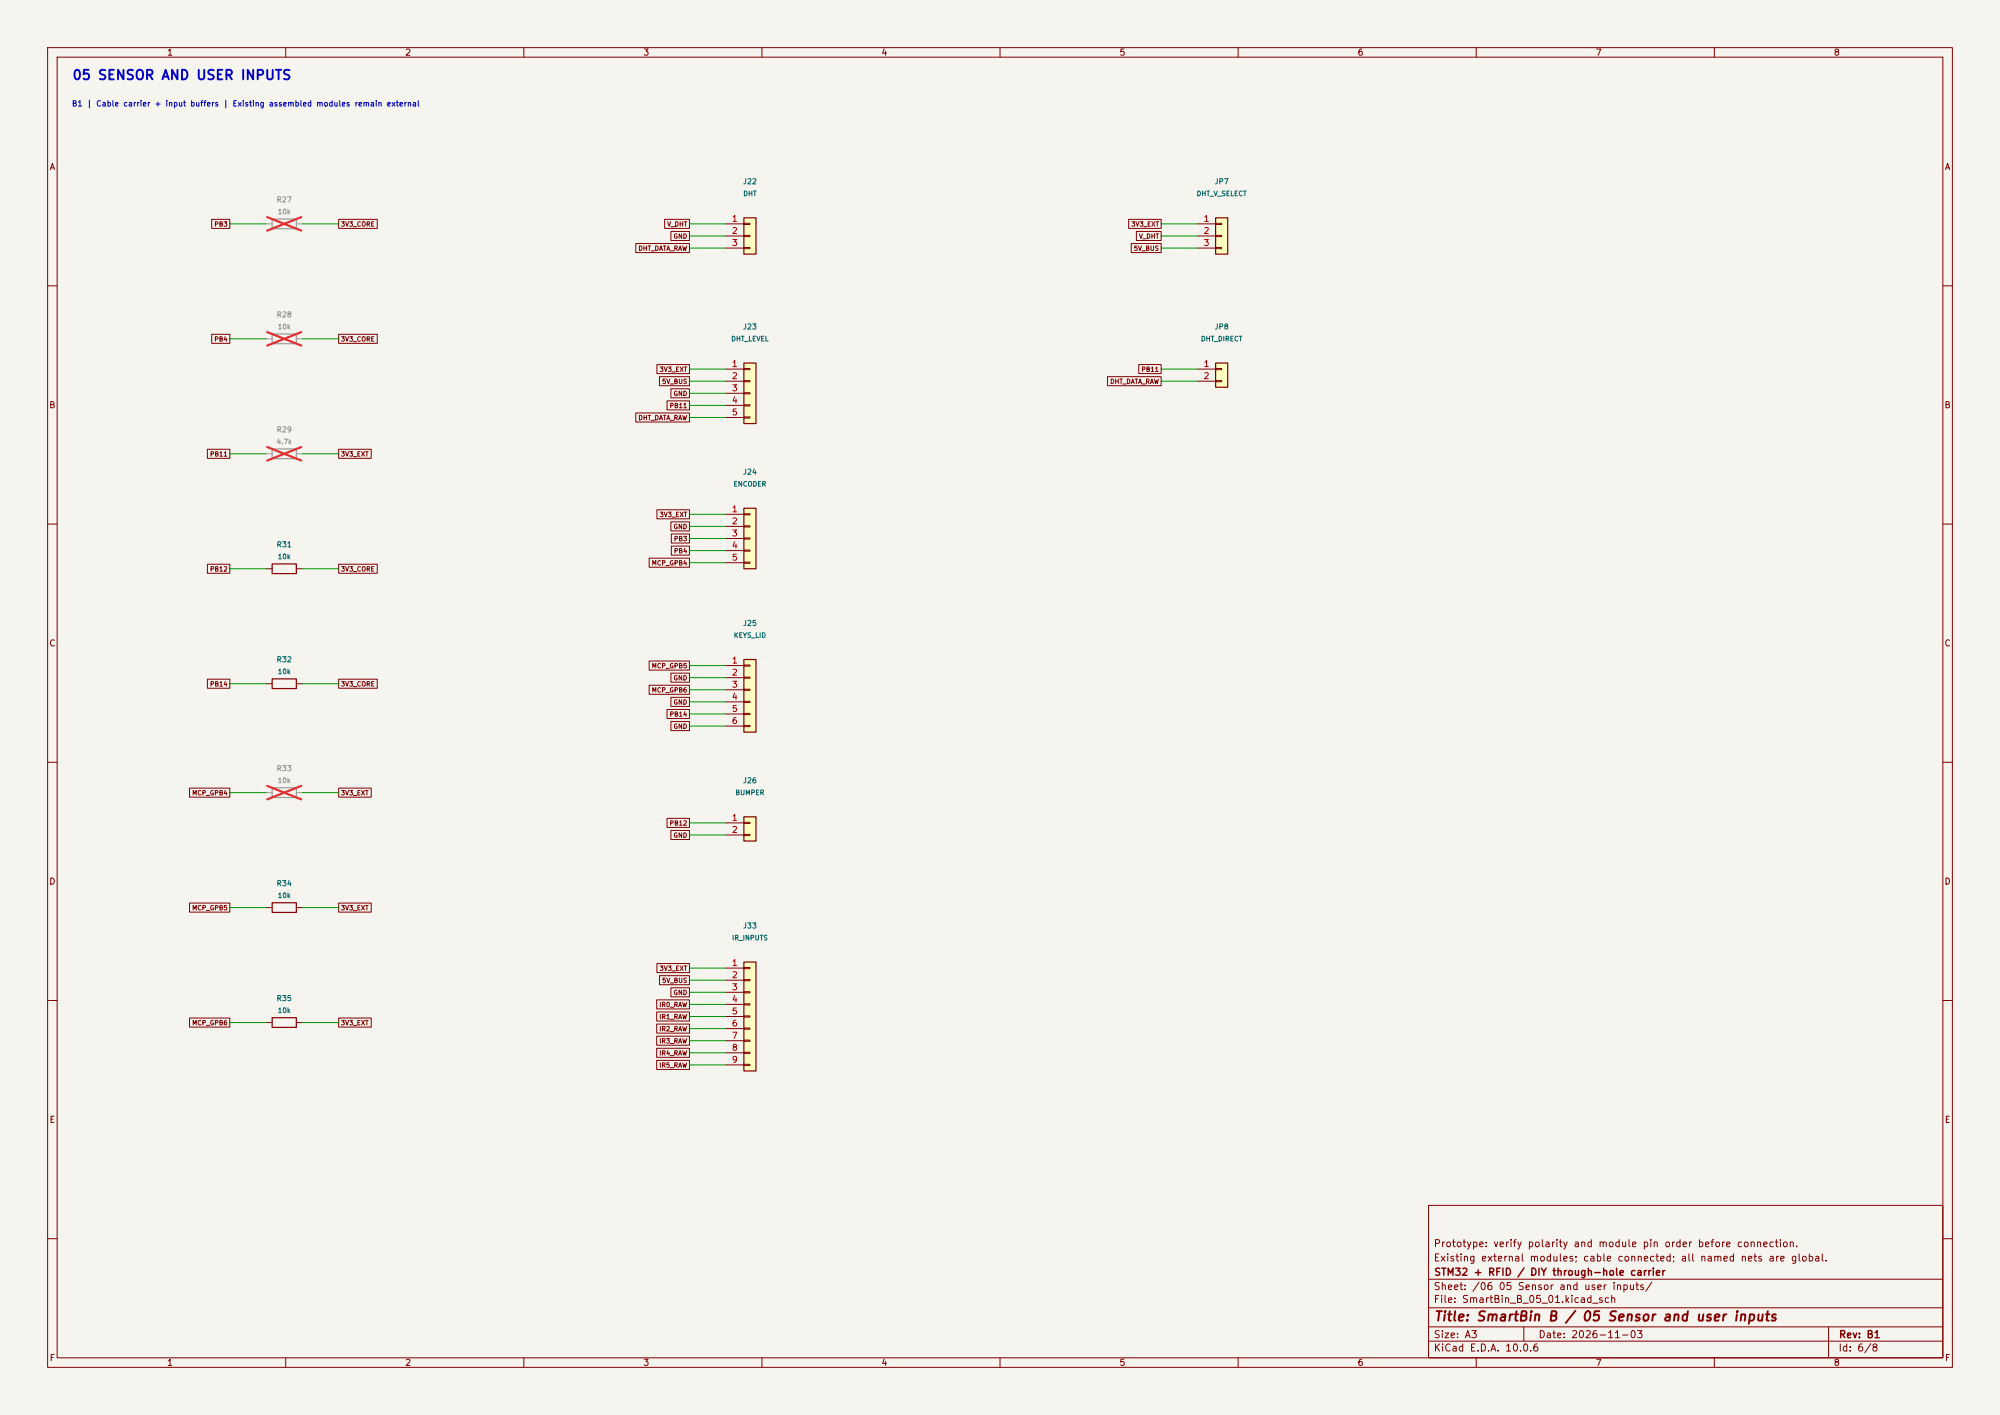
[picture p368: page 6]

05 SENSOR AND USER INPUTS

Prototype: verify polarity and module pin order before connection.
Existing external modules; cable connected; all named nets are global.
STM32 + RFID / DIY through-hole carrier
Sheet: /06 05 Sensor and user inputs/
File: SmartBin_B_05_01.kicad_sch
Title: SmartBin B / 05 Sensor and user inputs

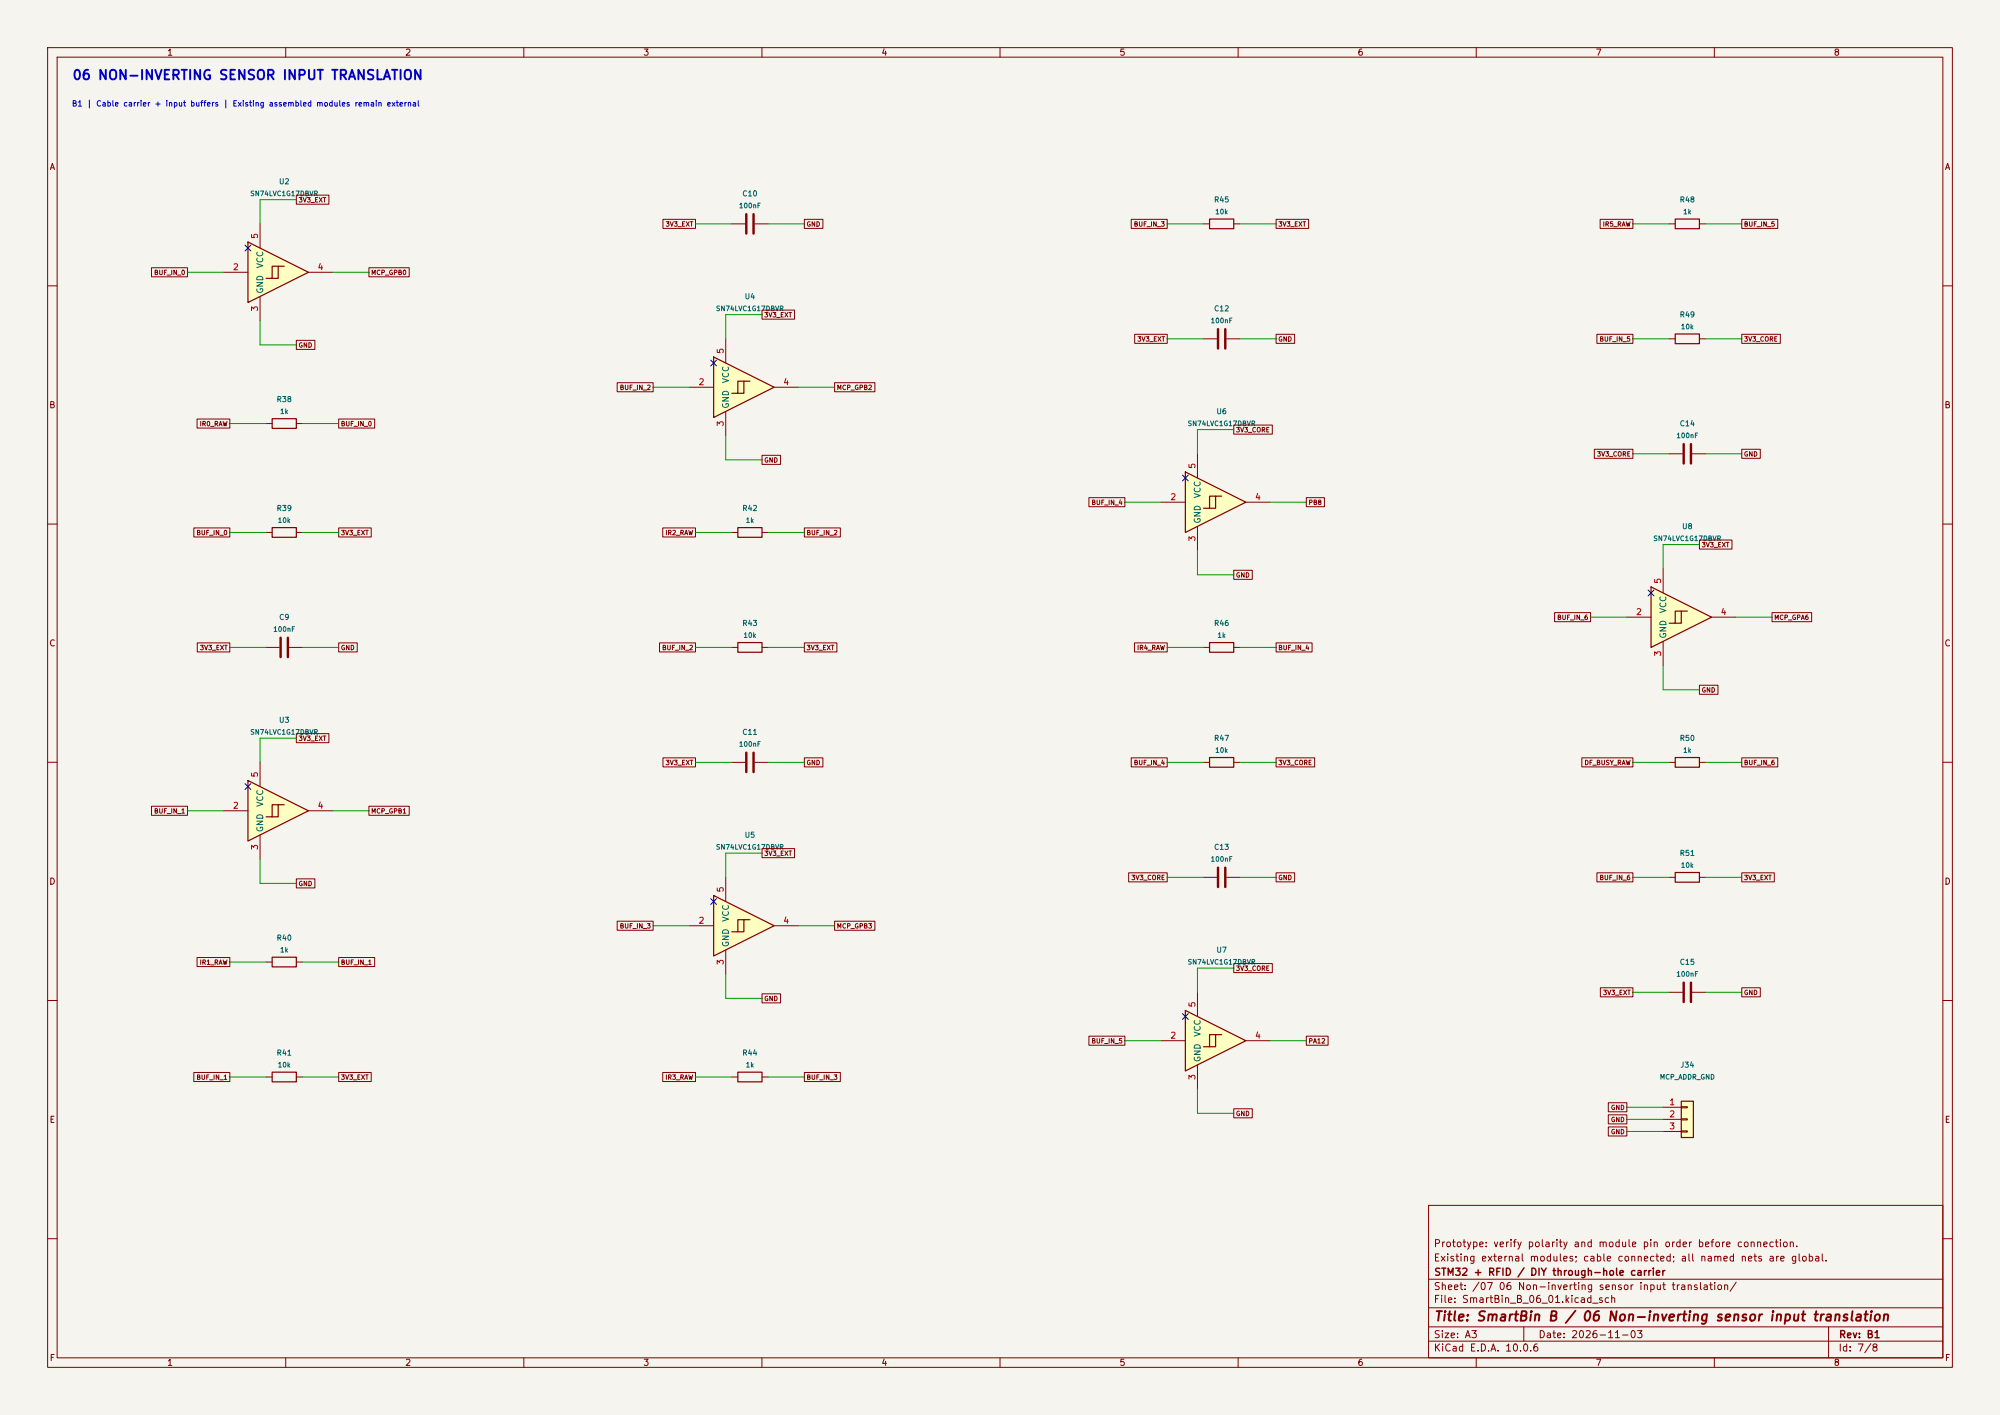
[picture p369: page 7]

06 NON-INVERTING SENSOR INPUT TRANSLATION

Prototype: verify polarity and module pin order before connection.
Existing external modules; cable connected; all named nets are global.
STM32 + RFID / DIY through-hole carrier
Sheet: /07 06 Non-inverting sensor input translation/
File: SmartBin_B_06_01.kicad_sch
Title: SmartBin B / 06 Non-inverting sensor input translation

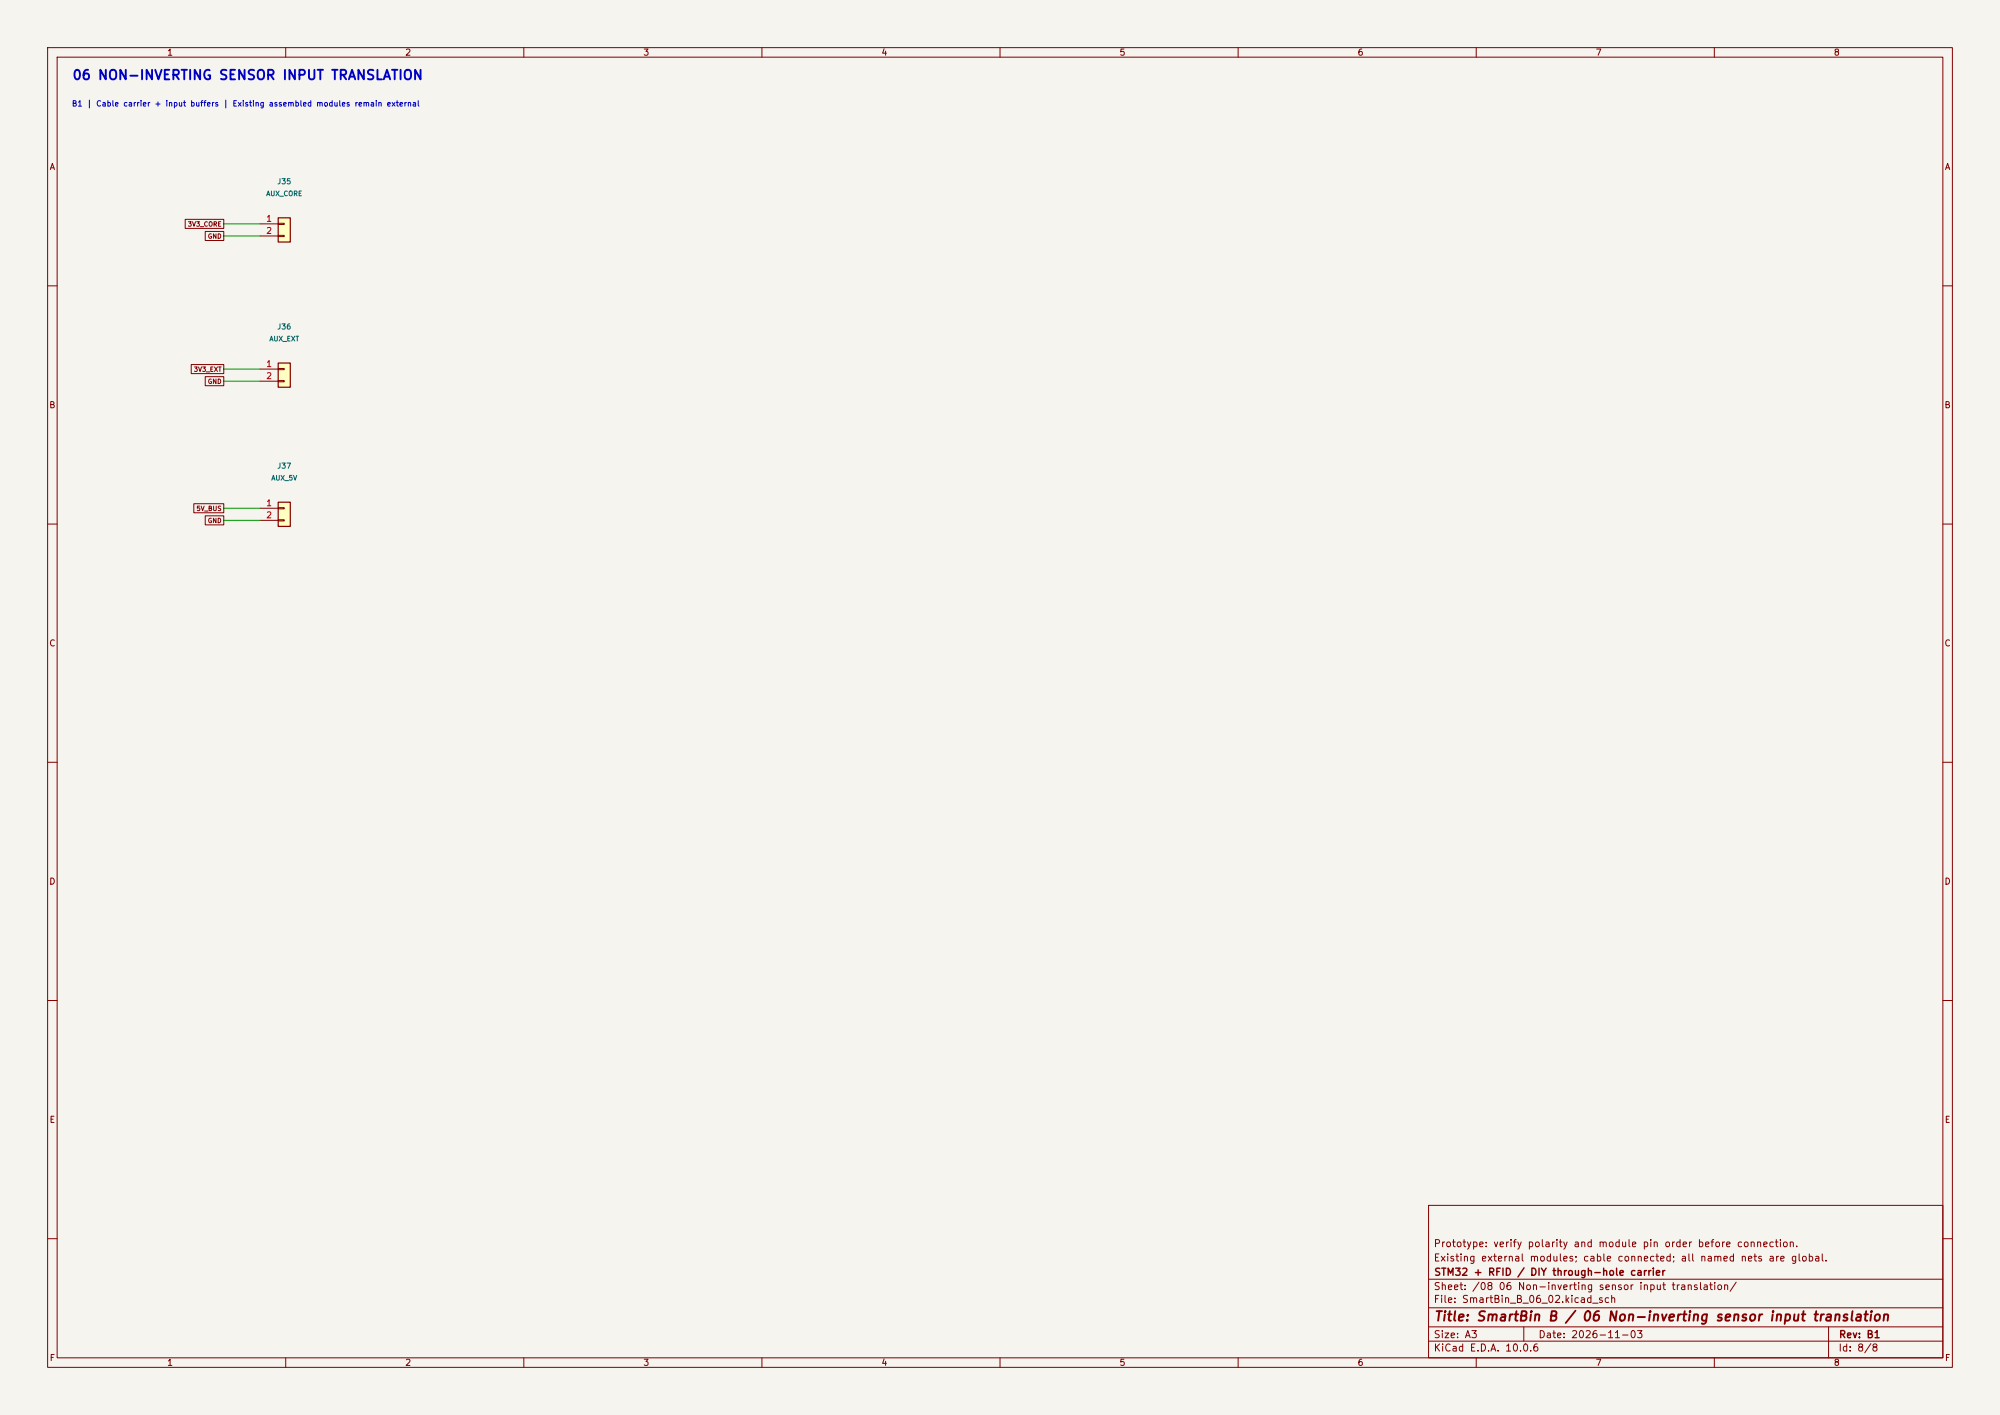
[picture p370: page 8]

3V3_EXT GND 06 NON-INVERTING SENSOR INPUT TRANSLATION

Prototype: verify polarity and module pin order before connection.
Existing external modules; cable connected; all named nets are global.
STM32 + RFID / DIY through-hole carrier
Sheet: /08 06 Non-inverting sensor input translation/
File: SmartBin_B_06_02.kicad_sch
Title: SmartBin B / 06 Non-inverting sensor input translation
