Sylphiette666/stm32-rfid-smart-bin/hardware/current-low-cost/pcb-a/kicad/SmartBin_A_schematic.pdf

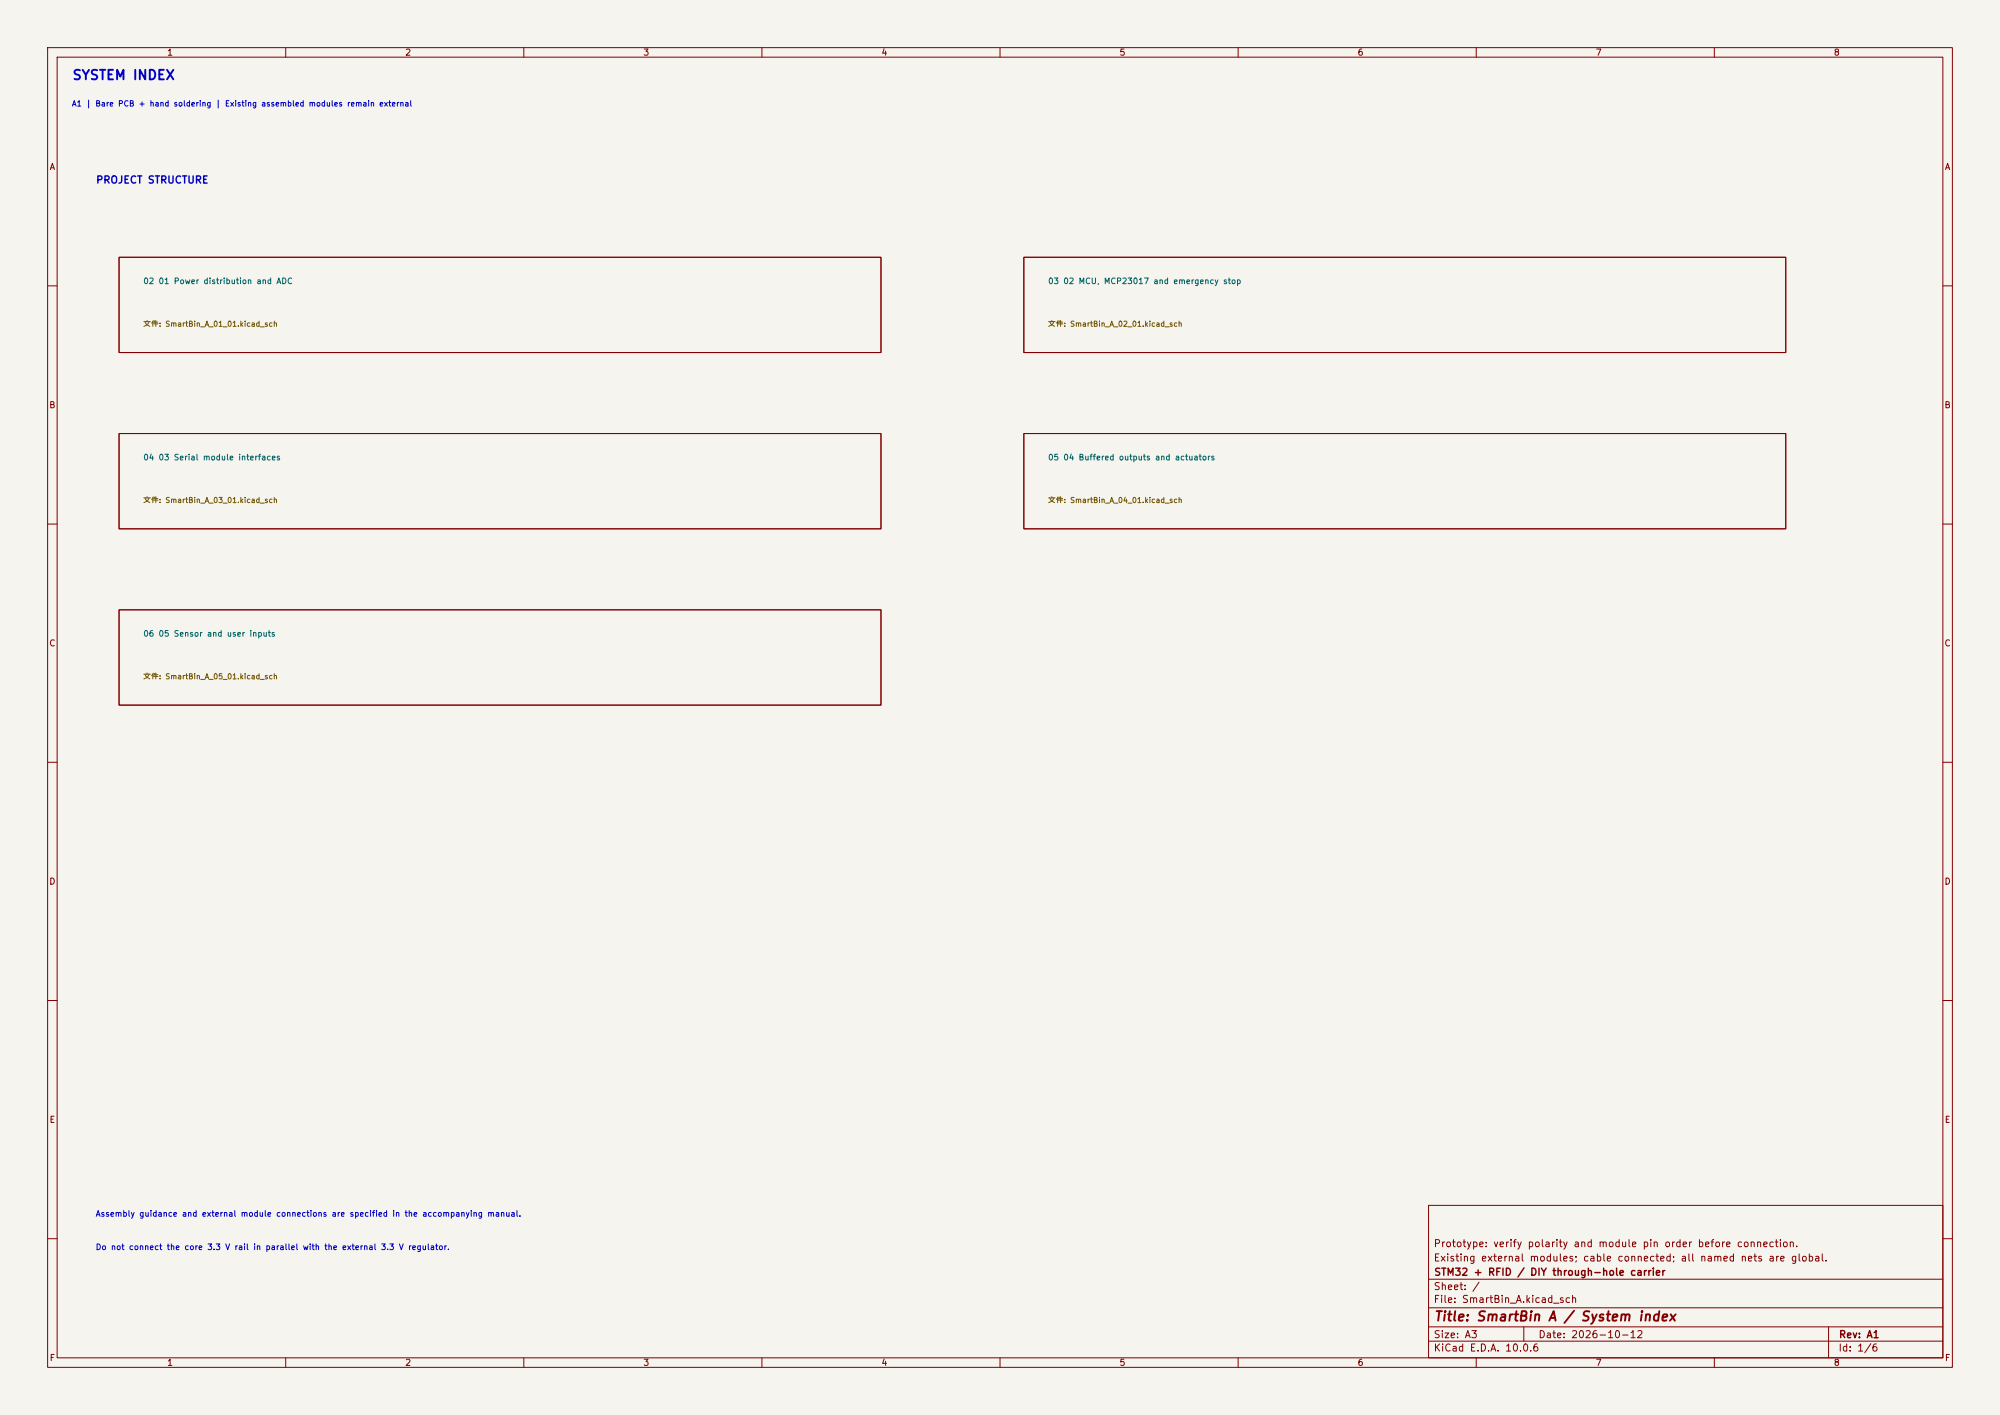
[picture p371: page 1]

A1 | Bare PCB + hand soldering | Existing assembled modules remain external PROJECT STRUCTURE

Assembly guidance and external module connections are specified in the accompanying manual. Do not connect the core 3.3 V rail in parallel with the external 3.3 V regulator.

Prototype: verify polarity and module pin order before connection.
Existing external modules; cable connected; all named nets are global.
STM32 + RFID / DIY through-hole carrier
Sheet: /
File: SmartBin_A.kicad_sch
Title: SmartBin A / System index

Size: A3 | Rev: A1 | F Date: 2026-10-12
KiCad E.D.A. 10.0.6 | Id: 1/6

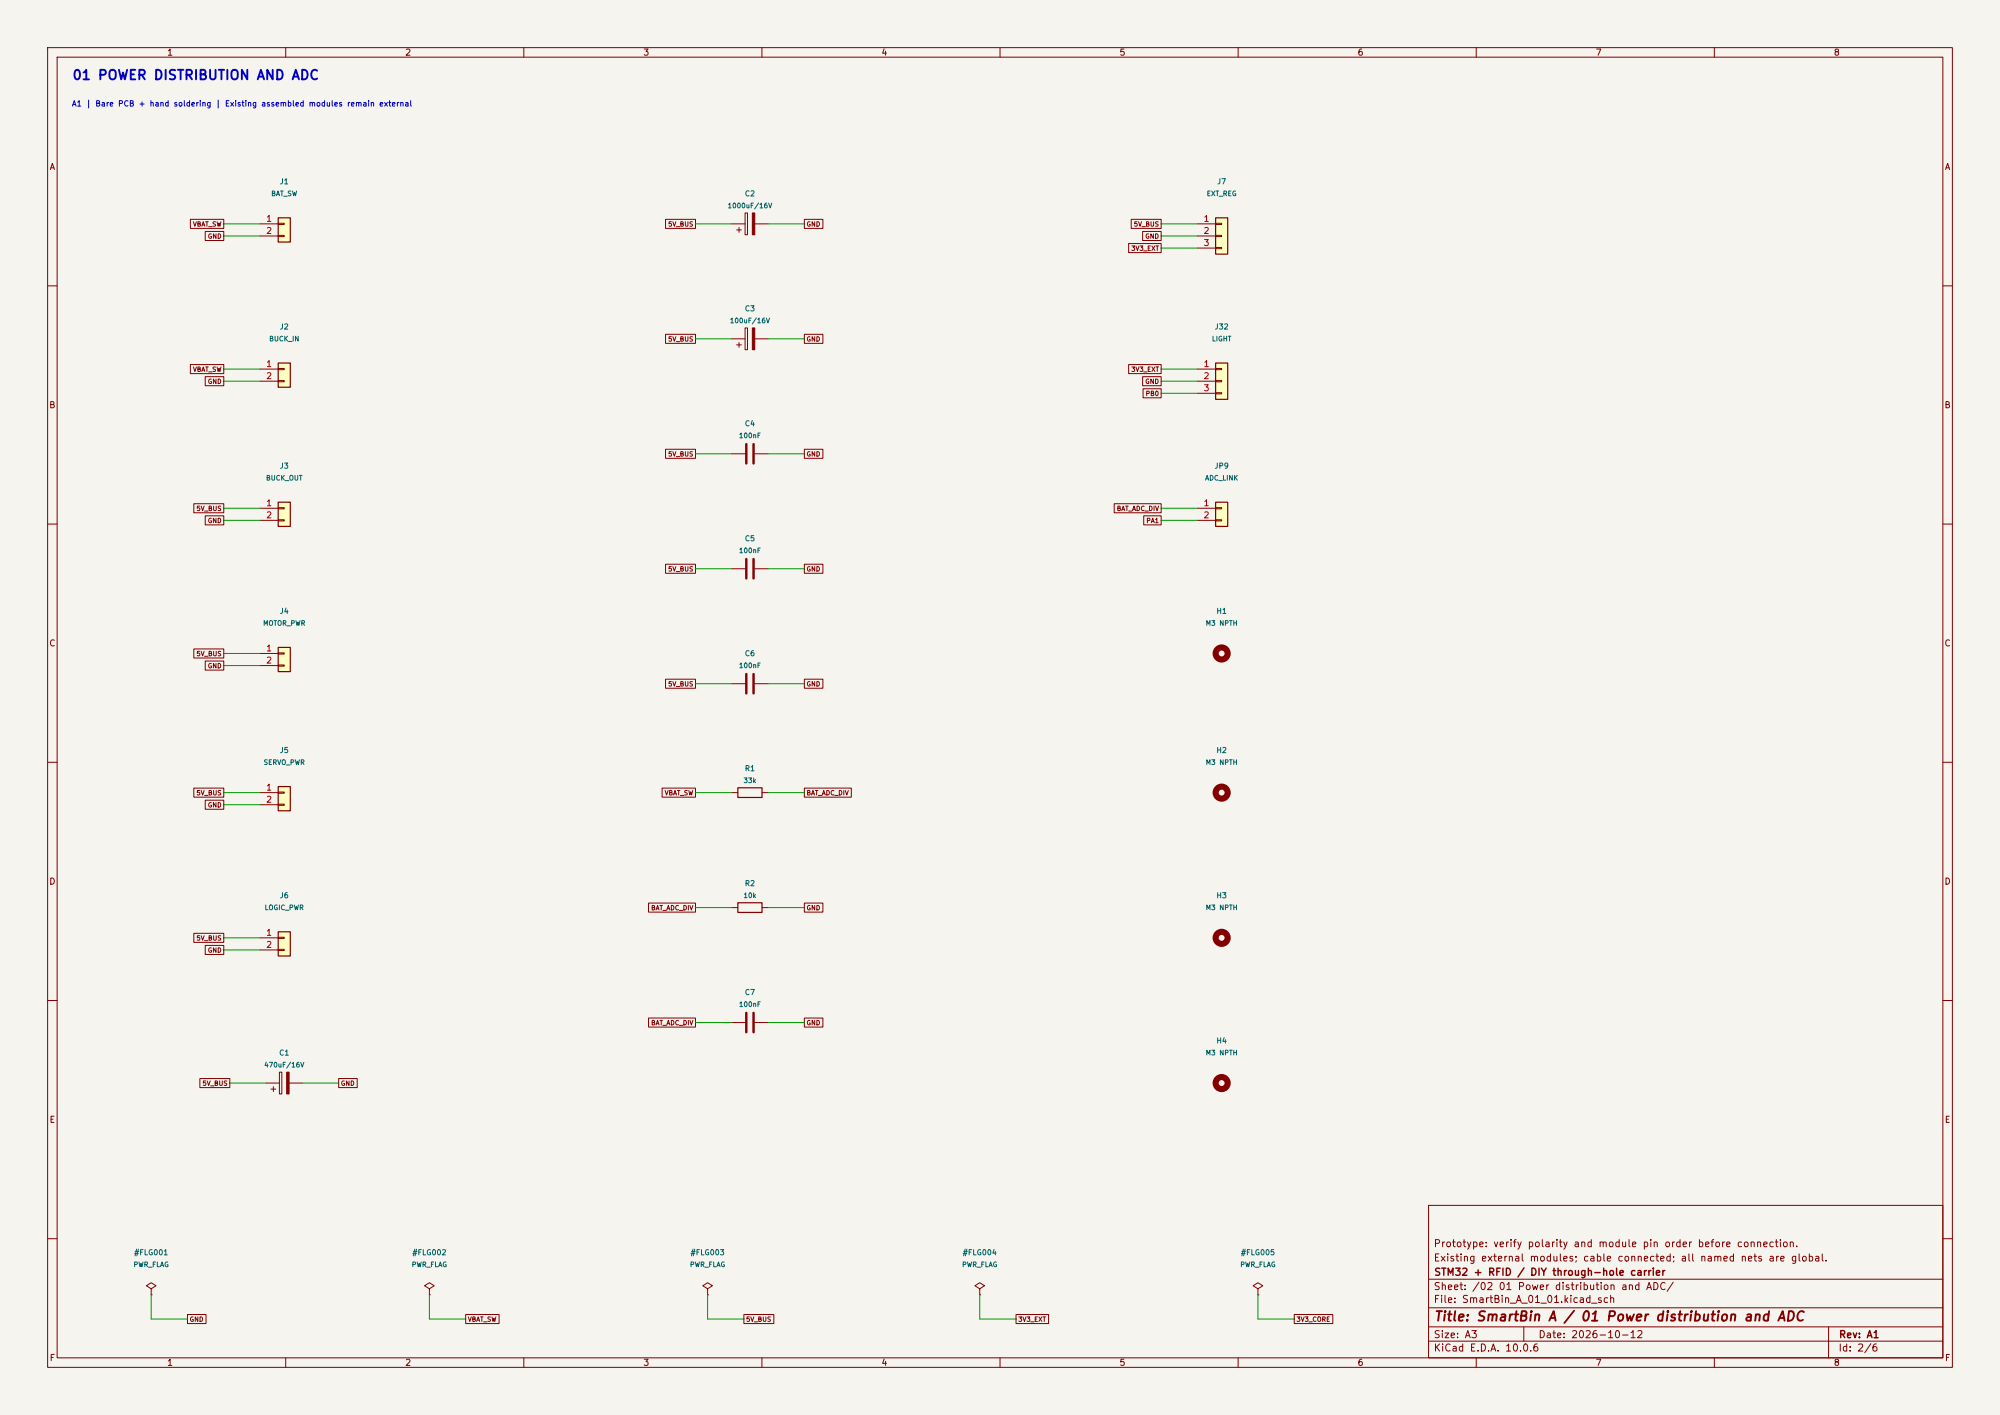
[picture p372: page 2]

A1 | Bare PCB + hand soldering | Existing assembled modules remain external 01 POWER DISTRIBUTION AND ADC

Prototype: verify polarity and module pin order before connection.
Existing external modules; cable connected; all named nets are global.
STM32 + RFID / DIY through-hole carrier
Sheet: /02 01 Power distribution and ADC/
File: SmartBin_A_01_01.kicad_sch
Title: SmartBin A / 01 Power distribution and ADC

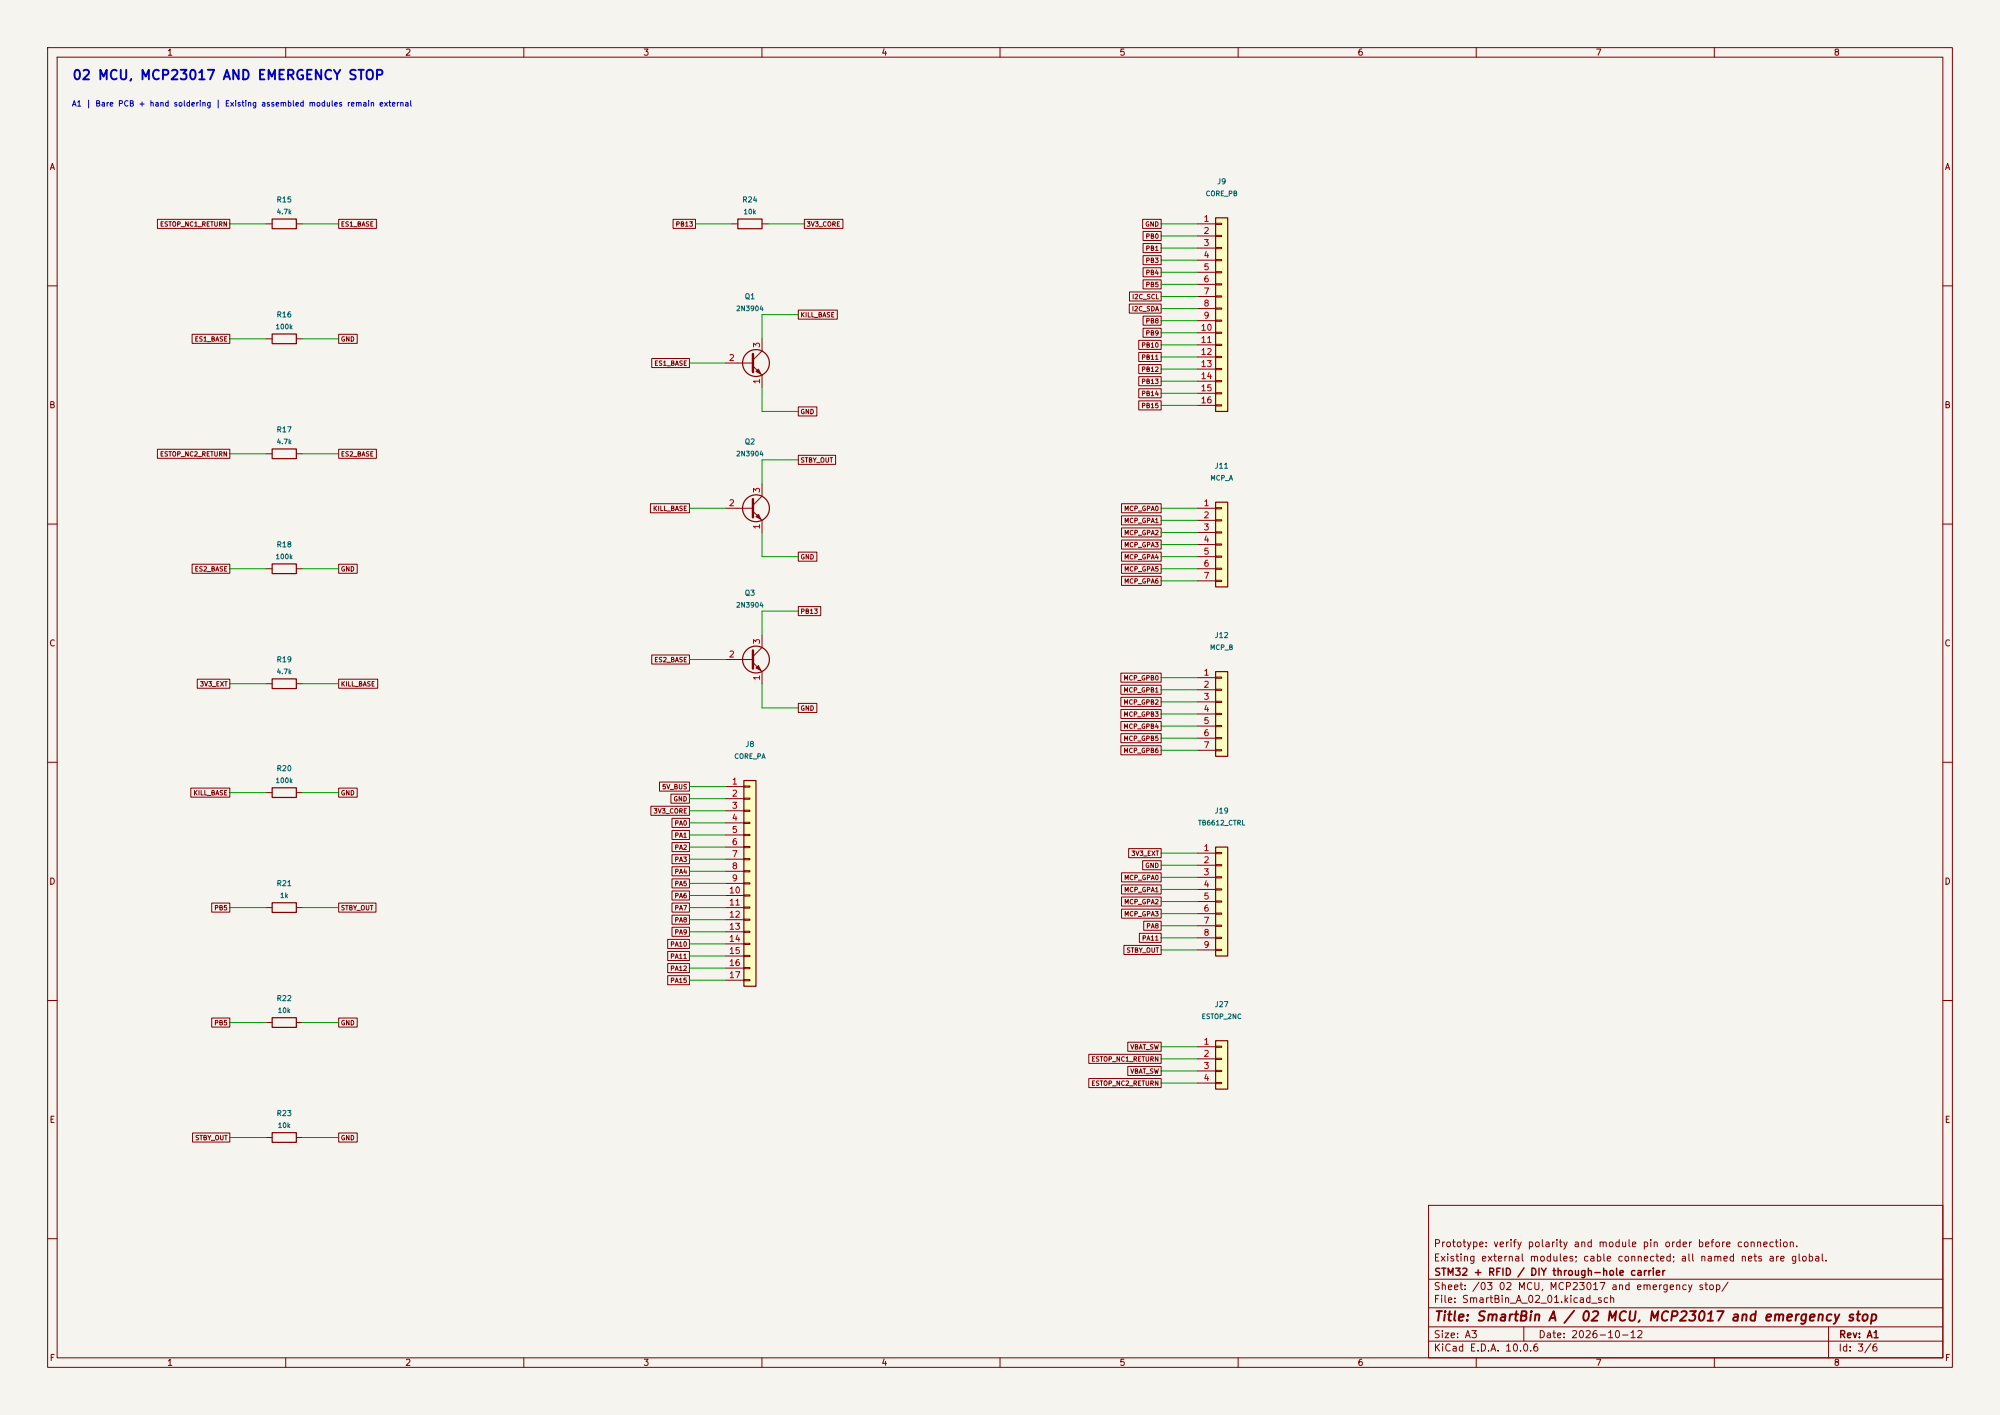
[picture p373: page 3]

A1 | Bare PCB + hand soldering | Existing assembled modules remain external

Prototype: verify polarity and module pin order before connection. R23

Existing external modules; cable connected; all named nets are global.
STM32 + RFID / DIY through-hole carrier
Sheet: /03 02 MCU, MCP23017 and emergency stop/
File: SmartBin_A_02_01.kicad_sch
Title: SmartBin A / 02 MCU, MCP23017 and emergency stop

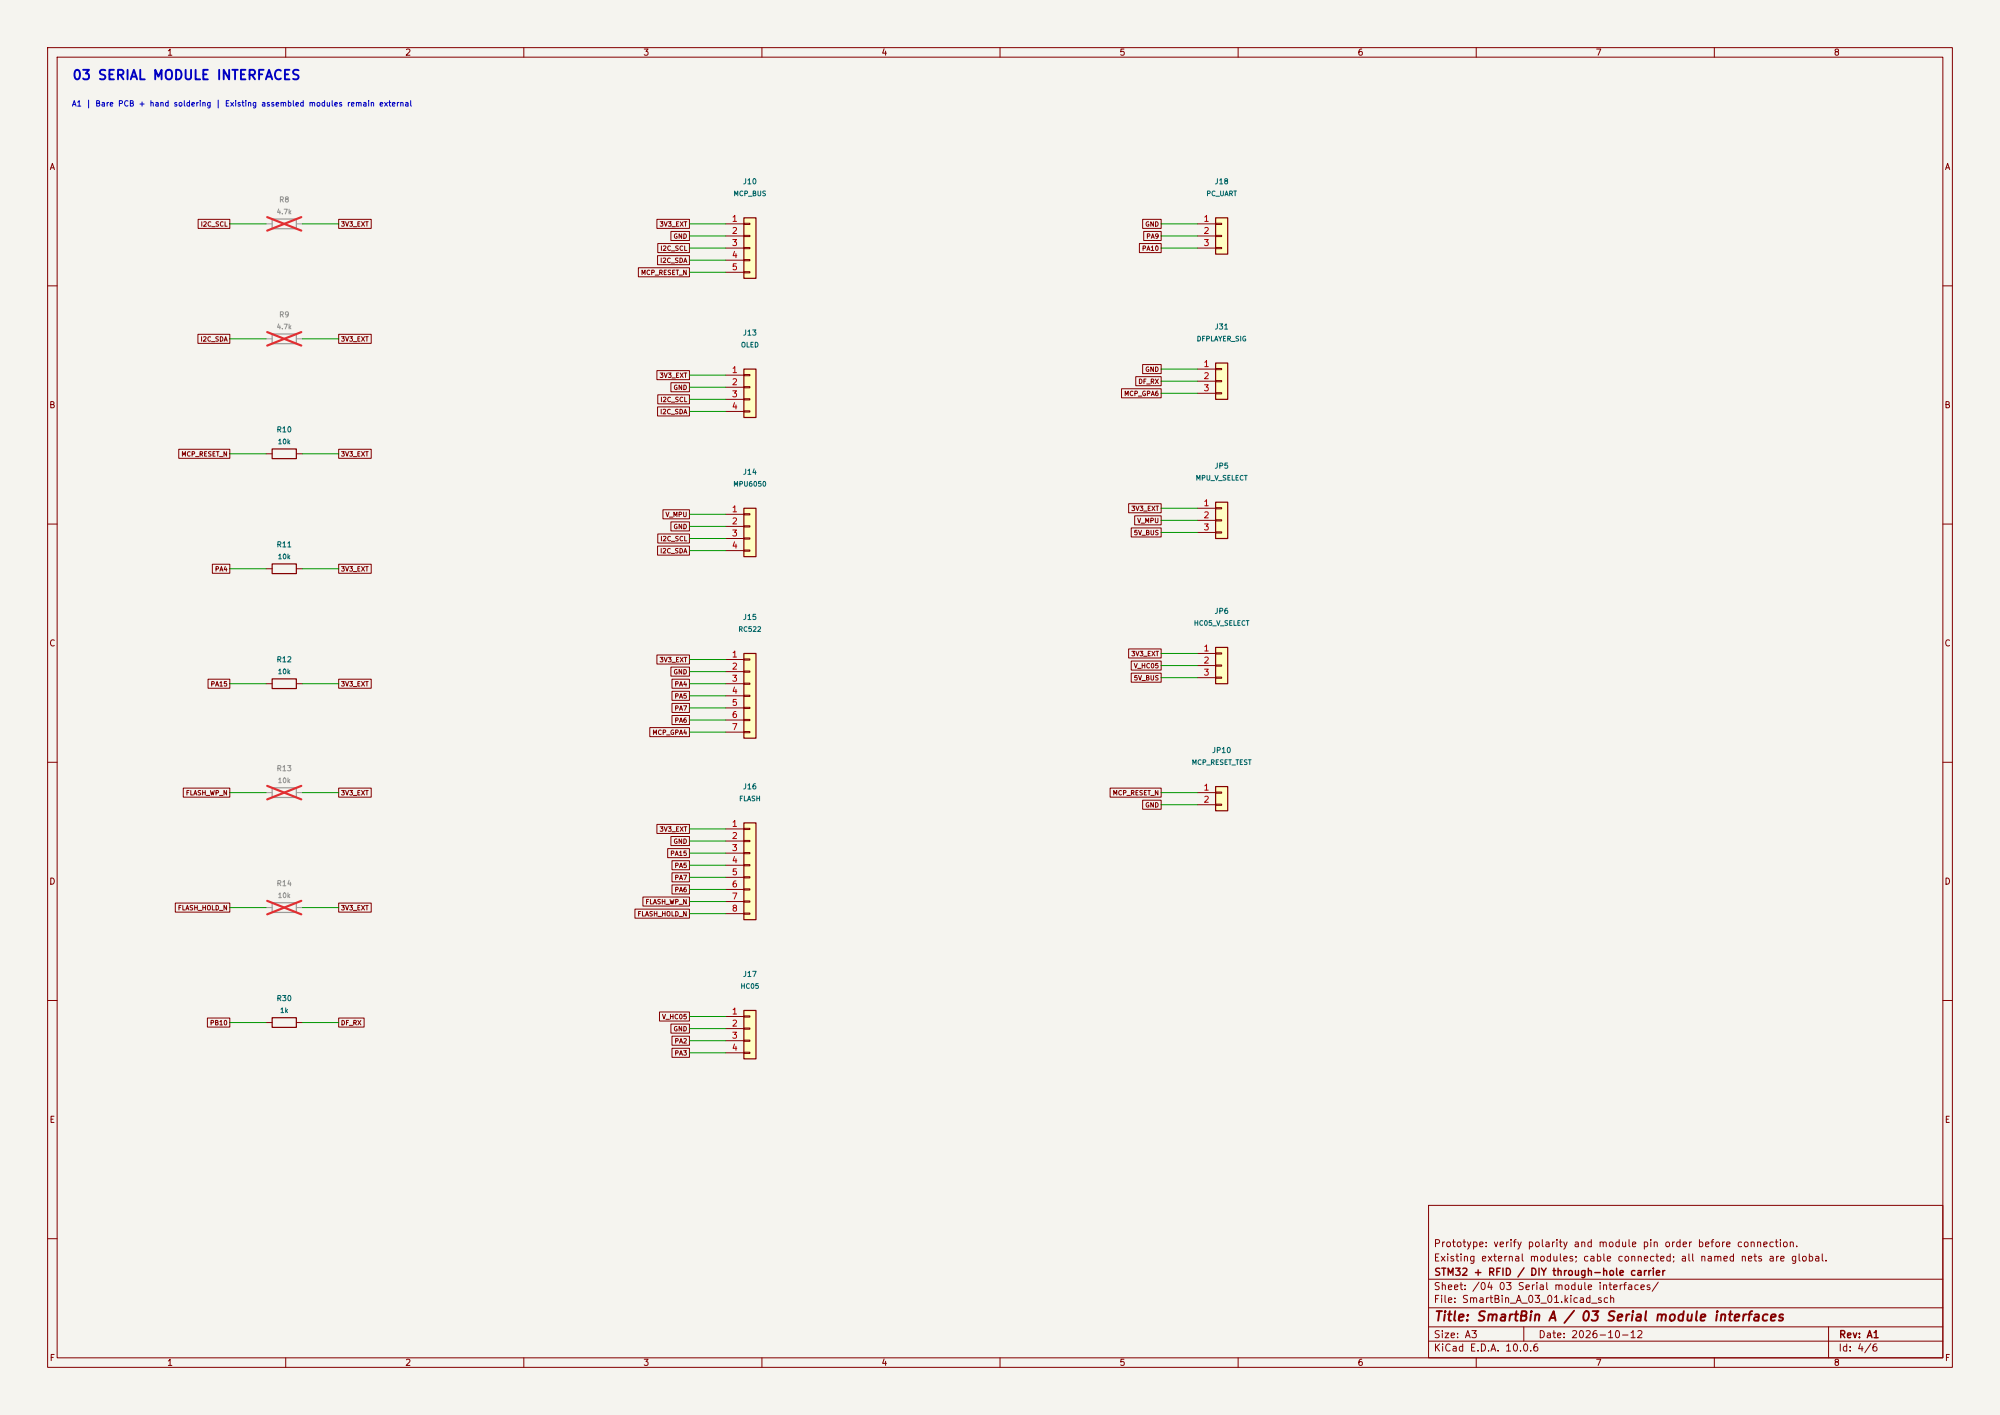
[picture p374: page 4]

Prototype: verify polarity and module pin order before connection.
Existing external modules; cable connected; all named nets are global.
STM32 + RFID / DIY through-hole carrier
Sheet: /04 03 Serial module interfaces/
File: SmartBin_A_03_01.kicad_sch
Title: SmartBin A / 03 Serial module interfaces

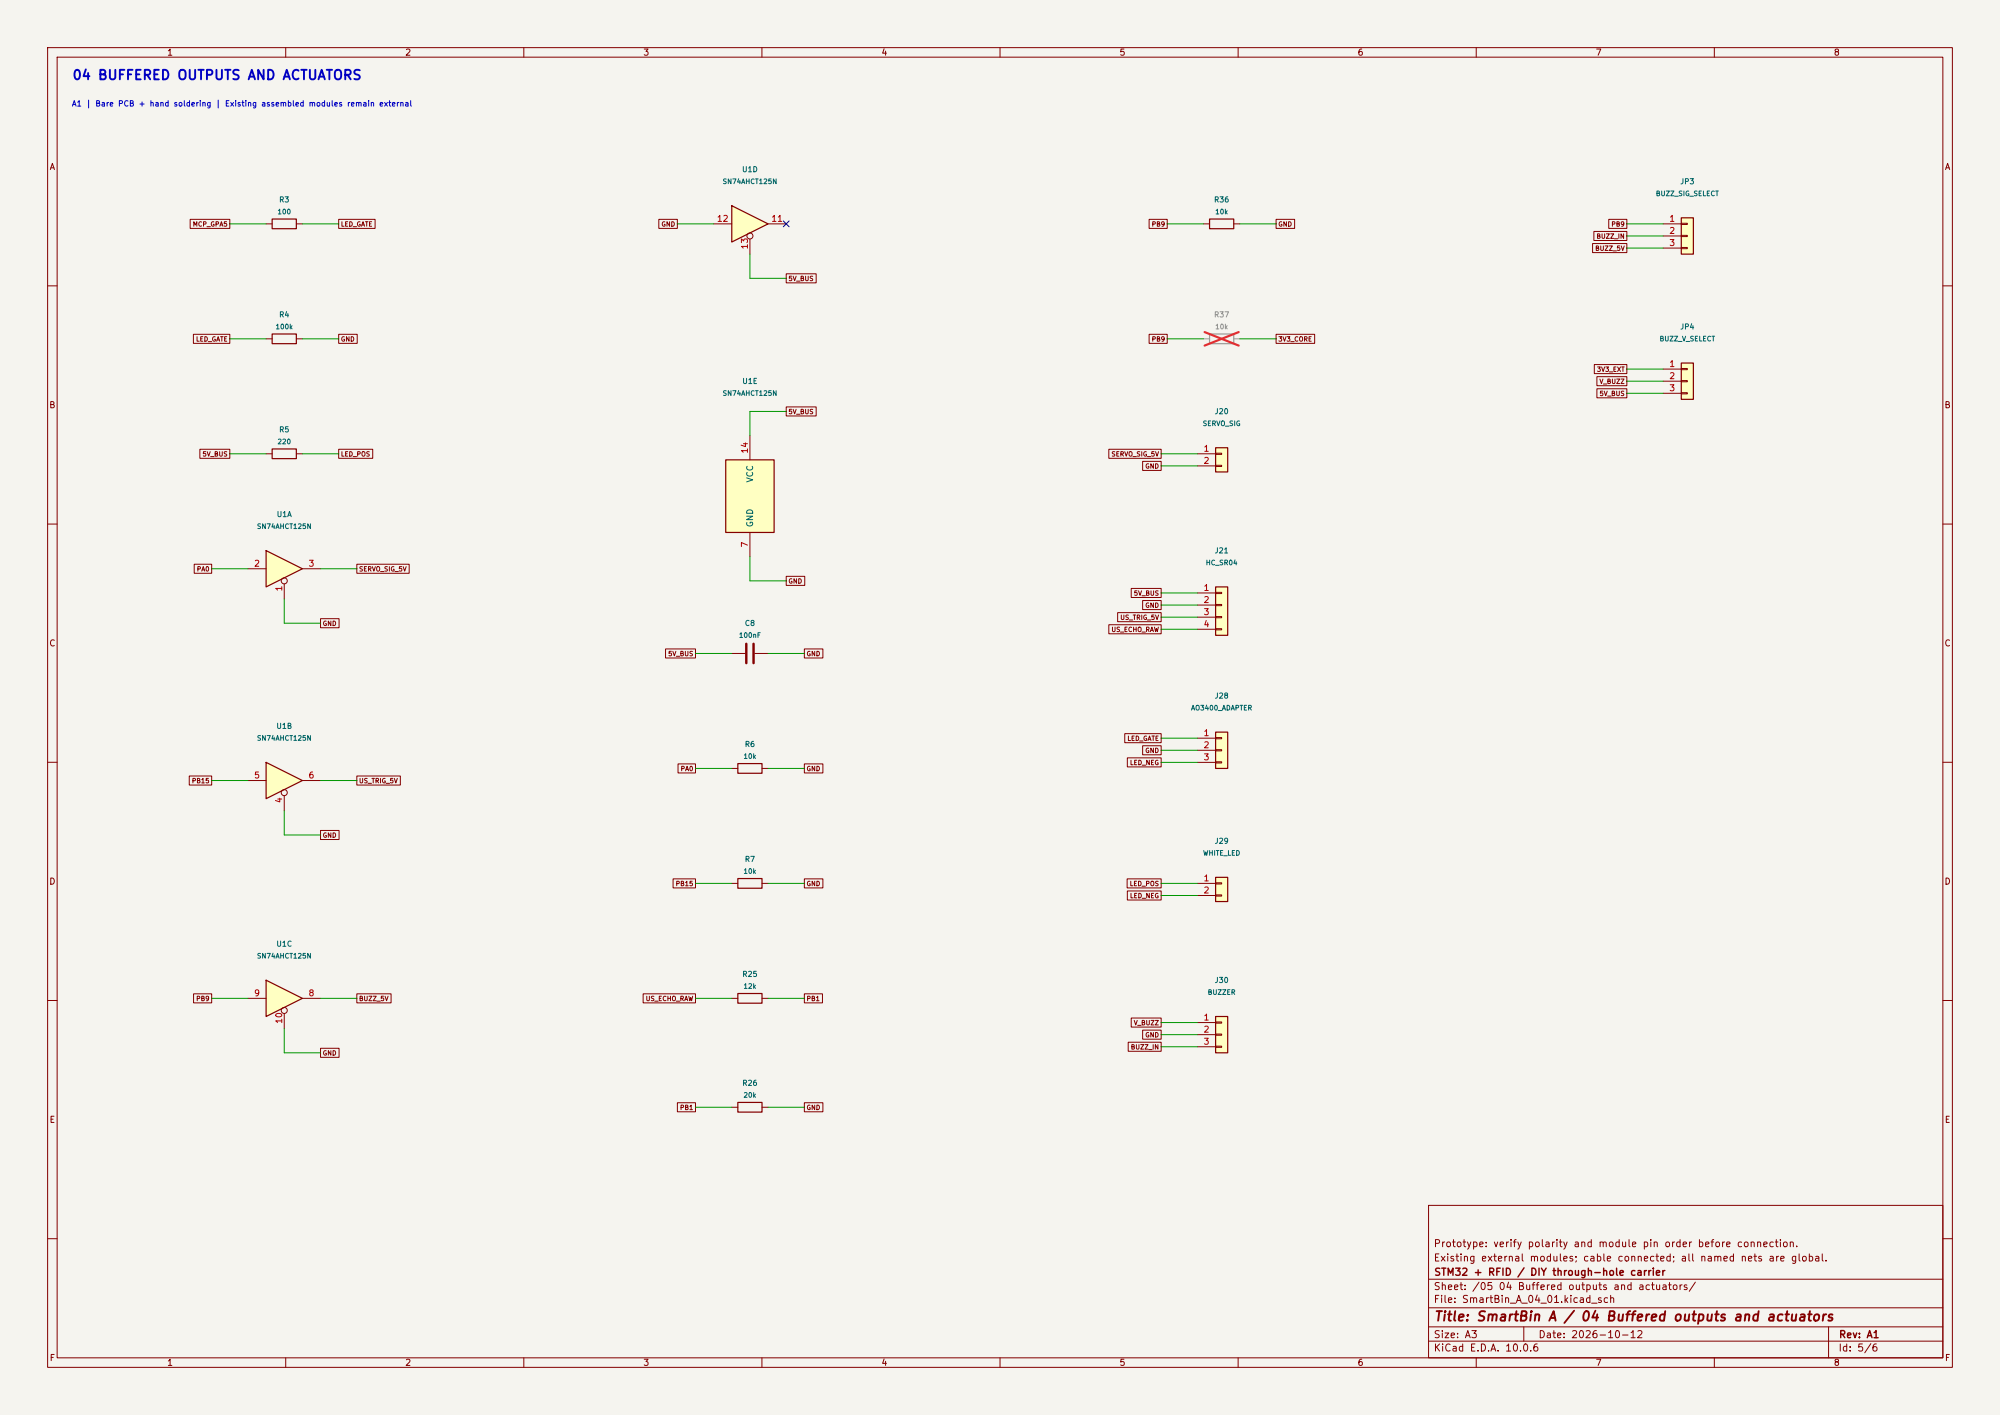
[picture p375: page 5]

A1 | Bare PCB + hand soldering | Existing assembled modules remain external 04 BUFFERED OUTPUTS AND ACTUATORS

Prototype: verify polarity and module pin order before connection. R26

Existing external modules; cable connected; all named nets are global.
STM32 + RFID / DIY through-hole carrier
Sheet: /05 04 Buffered outputs and actuators/
File: SmartBin_A_04_01.kicad_sch
Title: SmartBin A / 04 Buffered outputs and actuators

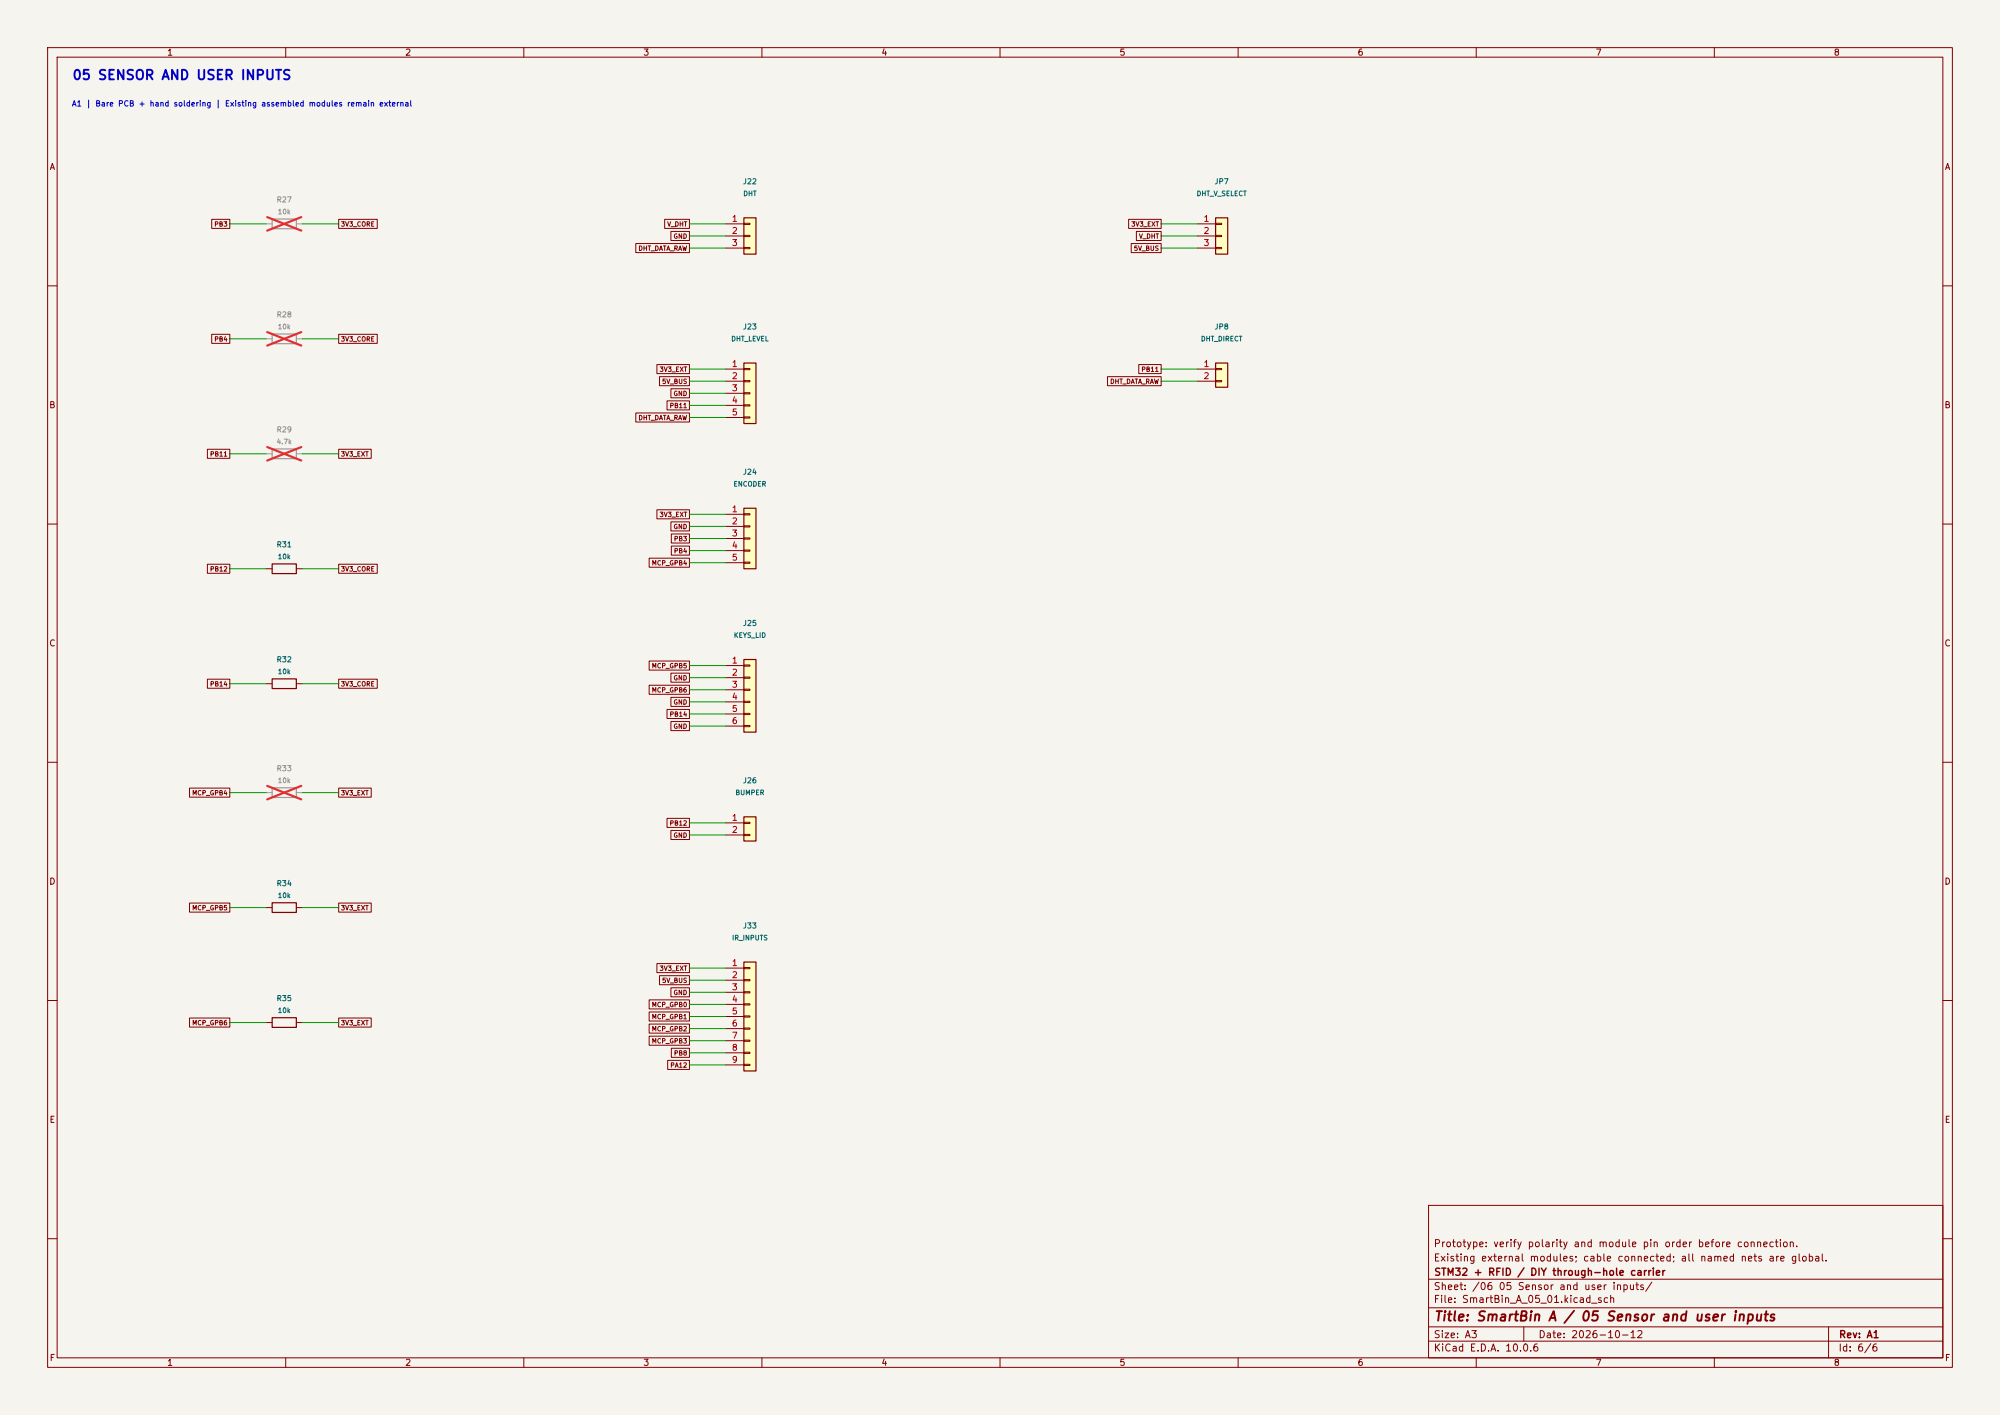
[picture p376: page 6]

05 SENSOR AND USER INPUTS

Prototype: verify polarity and module pin order before connection.
Existing external modules; cable connected; all named nets are global.
STM32 + RFID / DIY through-hole carrier
Sheet: /06 05 Sensor and user inputs/
File: SmartBin_A_05_01.kicad_sch
Title: SmartBin A / 05 Sensor and user inputs
