Sylphiette666/stm32-rfid-smart-bin/hardware/mechanical/print-backup/motor-existing-holes-light-20261103/lightening_pockets.pdf

# LEFT 轻量化浅腔定位 mm

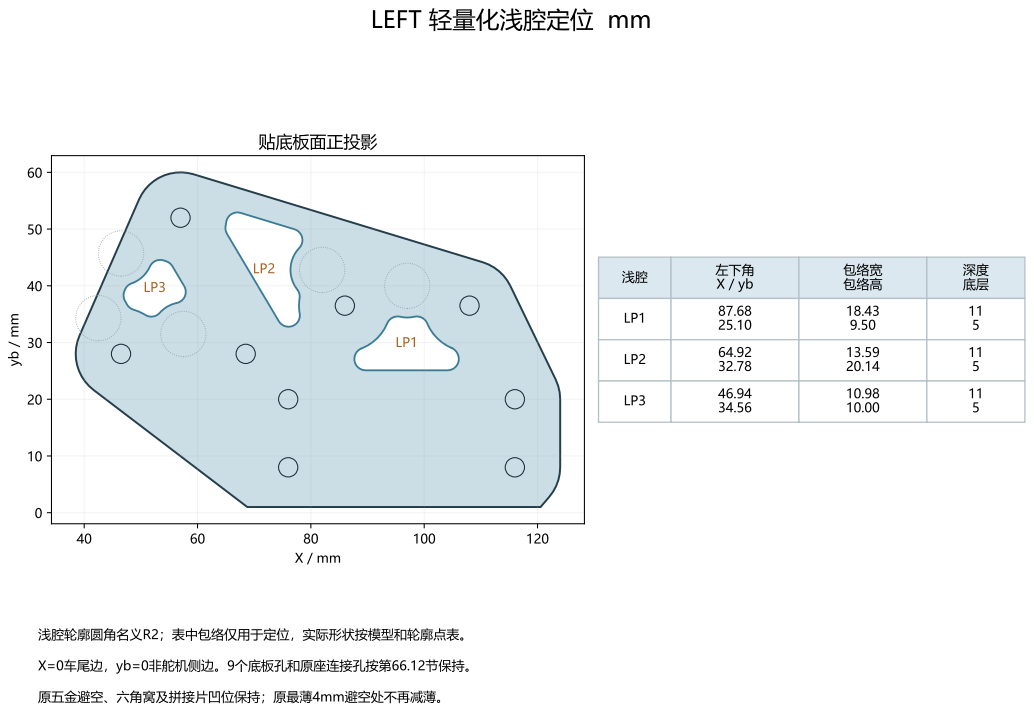
[picture p377: page 1]
贴底板面正投影; 左下角; 包络宽 包络高; 浅腔轮廓圆角名义R2；表中包络仅用于定位，实际形状按模型和轮廓点表。; X=0车尾边，yb=0非舵机侧边。9个底板孔和原座连接孔按第66.12节保持。; 原五金避空、六角窝及拼接片凹位保持；原最薄4mm避空处不再减薄。

# RIGHT 轻量化浅腔定位 mm

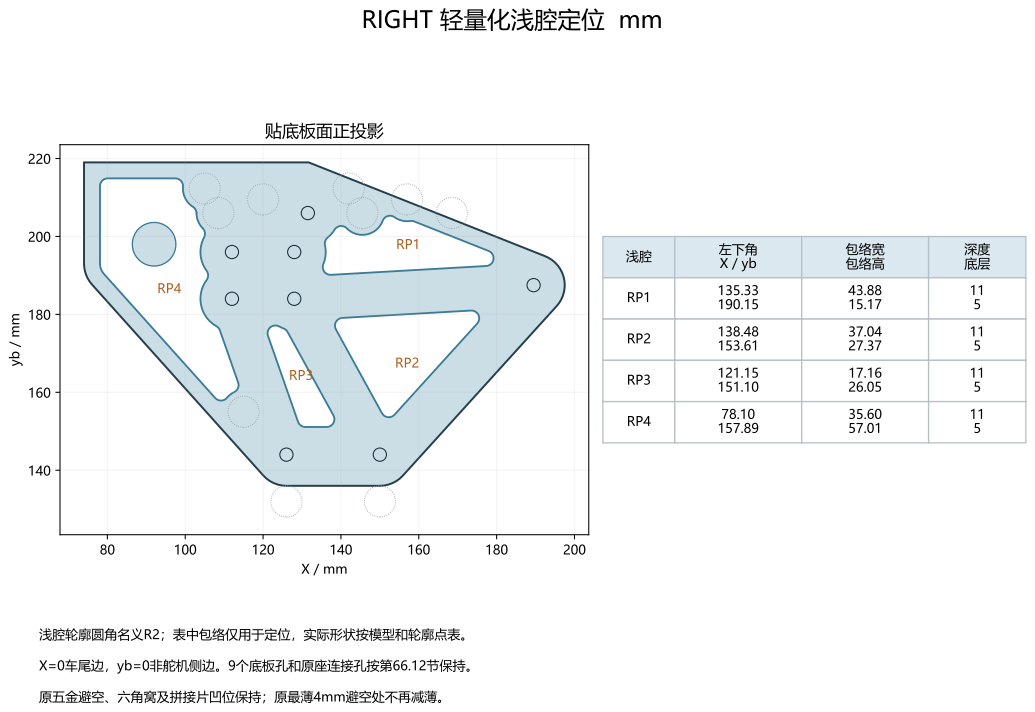
[picture p378: page 2]
贴底板面正投影; 左下角; 包络宽 包络高; 浅腔轮廓圆角名义R2；表中包络仅用于定位，实际形状按模型和轮廓点表。; X=0车尾边，yb=0非舵机侧边。9个底板孔和原座连接孔按第66.12节保持。; 原五金避空、六角窝及拼接片凹位保持；原最薄4mm避空处不再减薄。
