Sylphiette666/stm32-rfid-smart-bin/hardware/mechanical/print-backup/motor-existing-holes-20261102/interface_coordinates.pdf

# D06 LEFT 现有孔转接板 16mm厚 接口坐标图

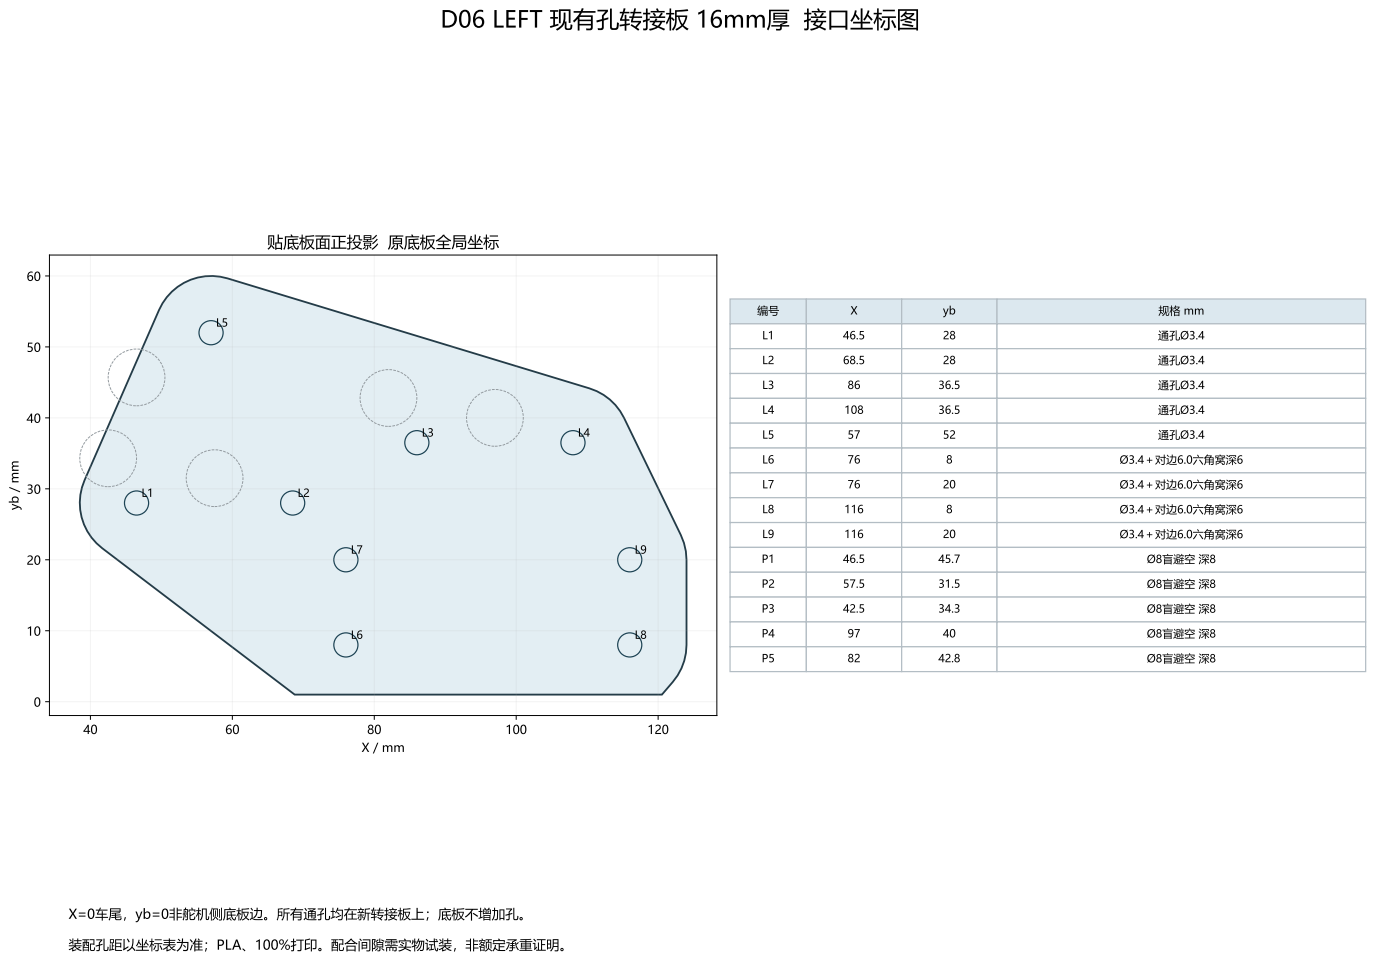
[picture p379: page 1]

装配孔距以坐标表为准；PLA、100%打印。配合间隙需实物试装，非额定承重证明。

## 贴底板面正投影 原底板全局坐标

# D06 RIGHT 现有孔转接板 16mm厚 接口坐标图

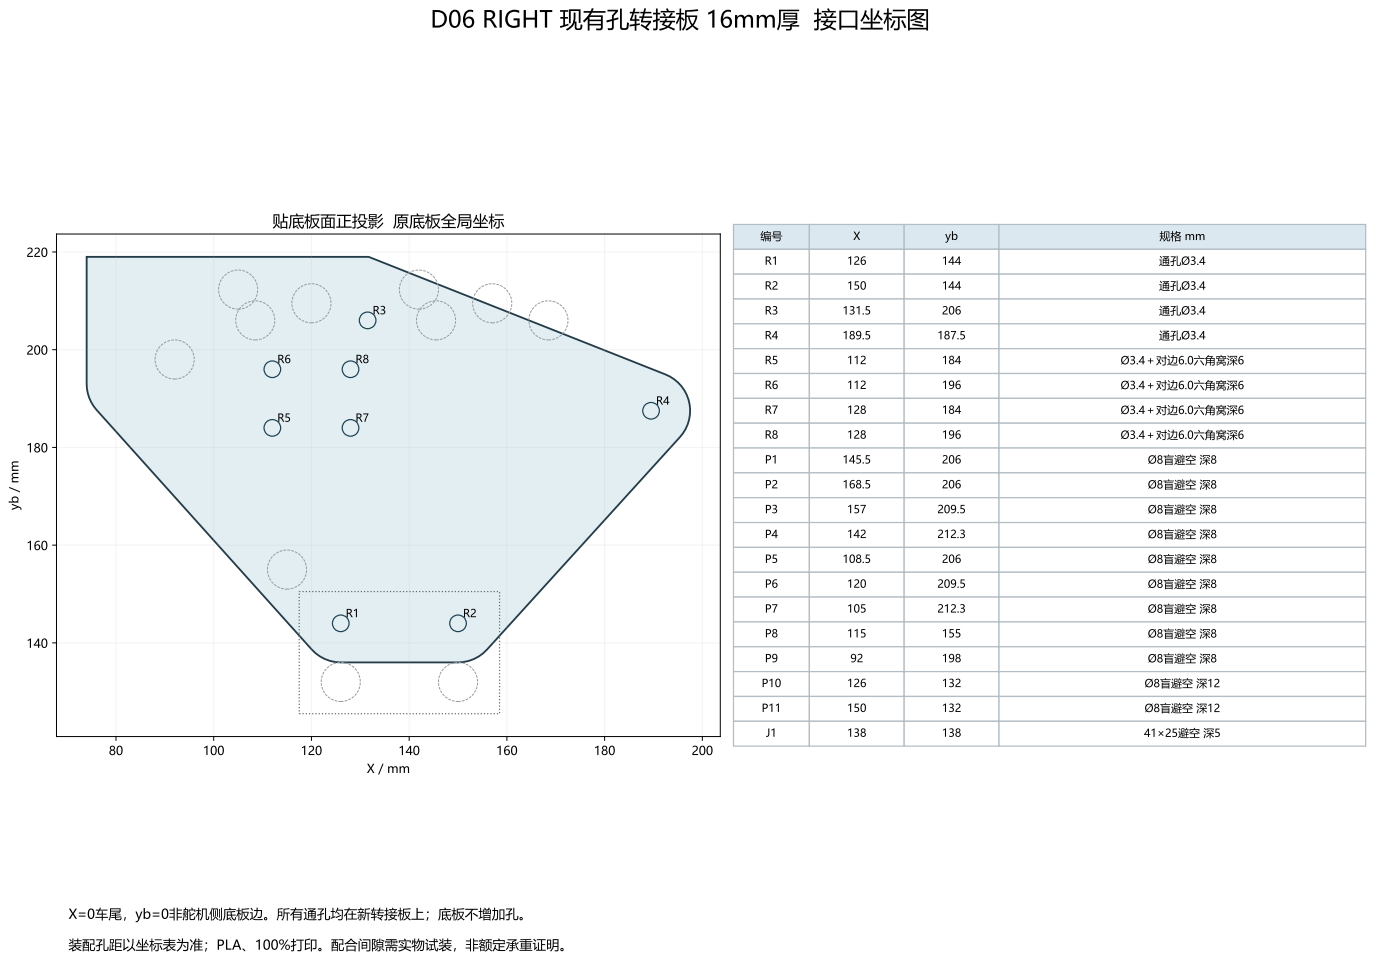
[picture p380: page 2]

装配孔距以坐标表为准；PLA、100%打印。配合间隙需实物试装，非额定承重证明。
