Sylphiette666/stm32-rfid-smart-bin/(list of files, drawings)

Other design files:
hardware/current-low-cost/pcb-a/checks/pcb-drc.json
hardware/current-low-cost/pcb-a/kicad/schematic-erc.json
hardware/current-low-cost/pcb-a/kicad/schematic-export-results.json
hardware/current-low-cost/pcb-a/kicad/schematic-net-verification.json
hardware/current-low-cost/pcb-a/kicad/schematic_paths.json
hardware/current-low-cost/pcb-a/review/four-skills/after/pcb-run.json
hardware/current-low-cost/pcb-a/review/four-skills/after/schematic-run.json
hardware/current-low-cost/pcb-a/review/four-skills/before/pcb-run.json
hardware/current-low-cost/pcb-a/review/four-skills/before/schematic-run.json
hardware/current-low-cost/pcb-b/checks/pcb-drc.json
hardware/current-low-cost/pcb-b/checks/schematic-erc.json
hardware/current-low-cost/pcb-b/checks/schematic-export-results.json
hardware/current-low-cost/pcb-b/kicad/schematic_paths.json
