Sylphiette666/stm32-rfid-smart-bin/hardware/current-low-cost/pcb-b/kicad/SmartBin_B.kicad_pcb

## KiCad design hardware/current-low-cost/pcb-b/kicad/SmartBin_B.kicad_pcb (2026-11-03)

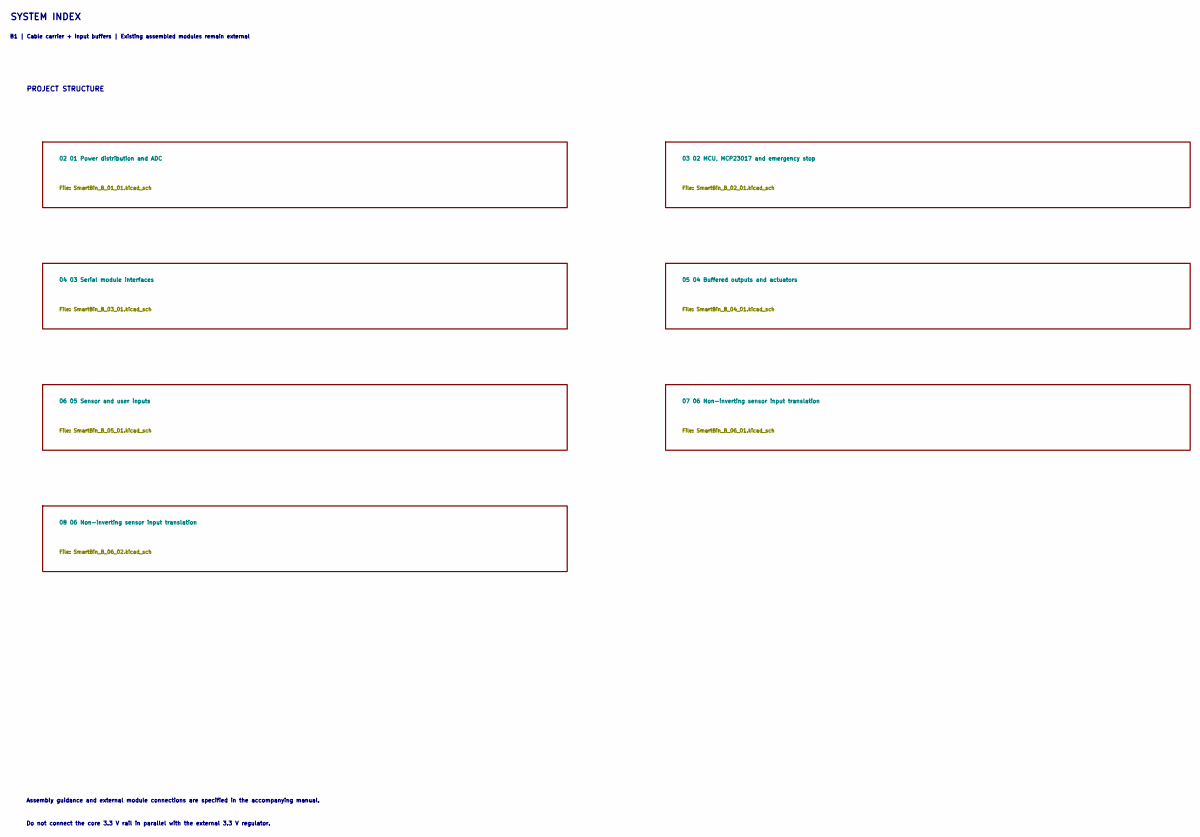
[picture p381: schematic SmartBin_B.kicad_sch, SmartBin B / System index]

Notes on the sheet:
SYSTEM INDEX
B1 | Cable carrier + input buffers | Existing assembled modules remain external
PROJECT STRUCTURE
Assembly guidance and external module connections are specified in the accompanying manual.
Do not connect the core 3.3 V rail in parallel with the external 3.3 V regulator.

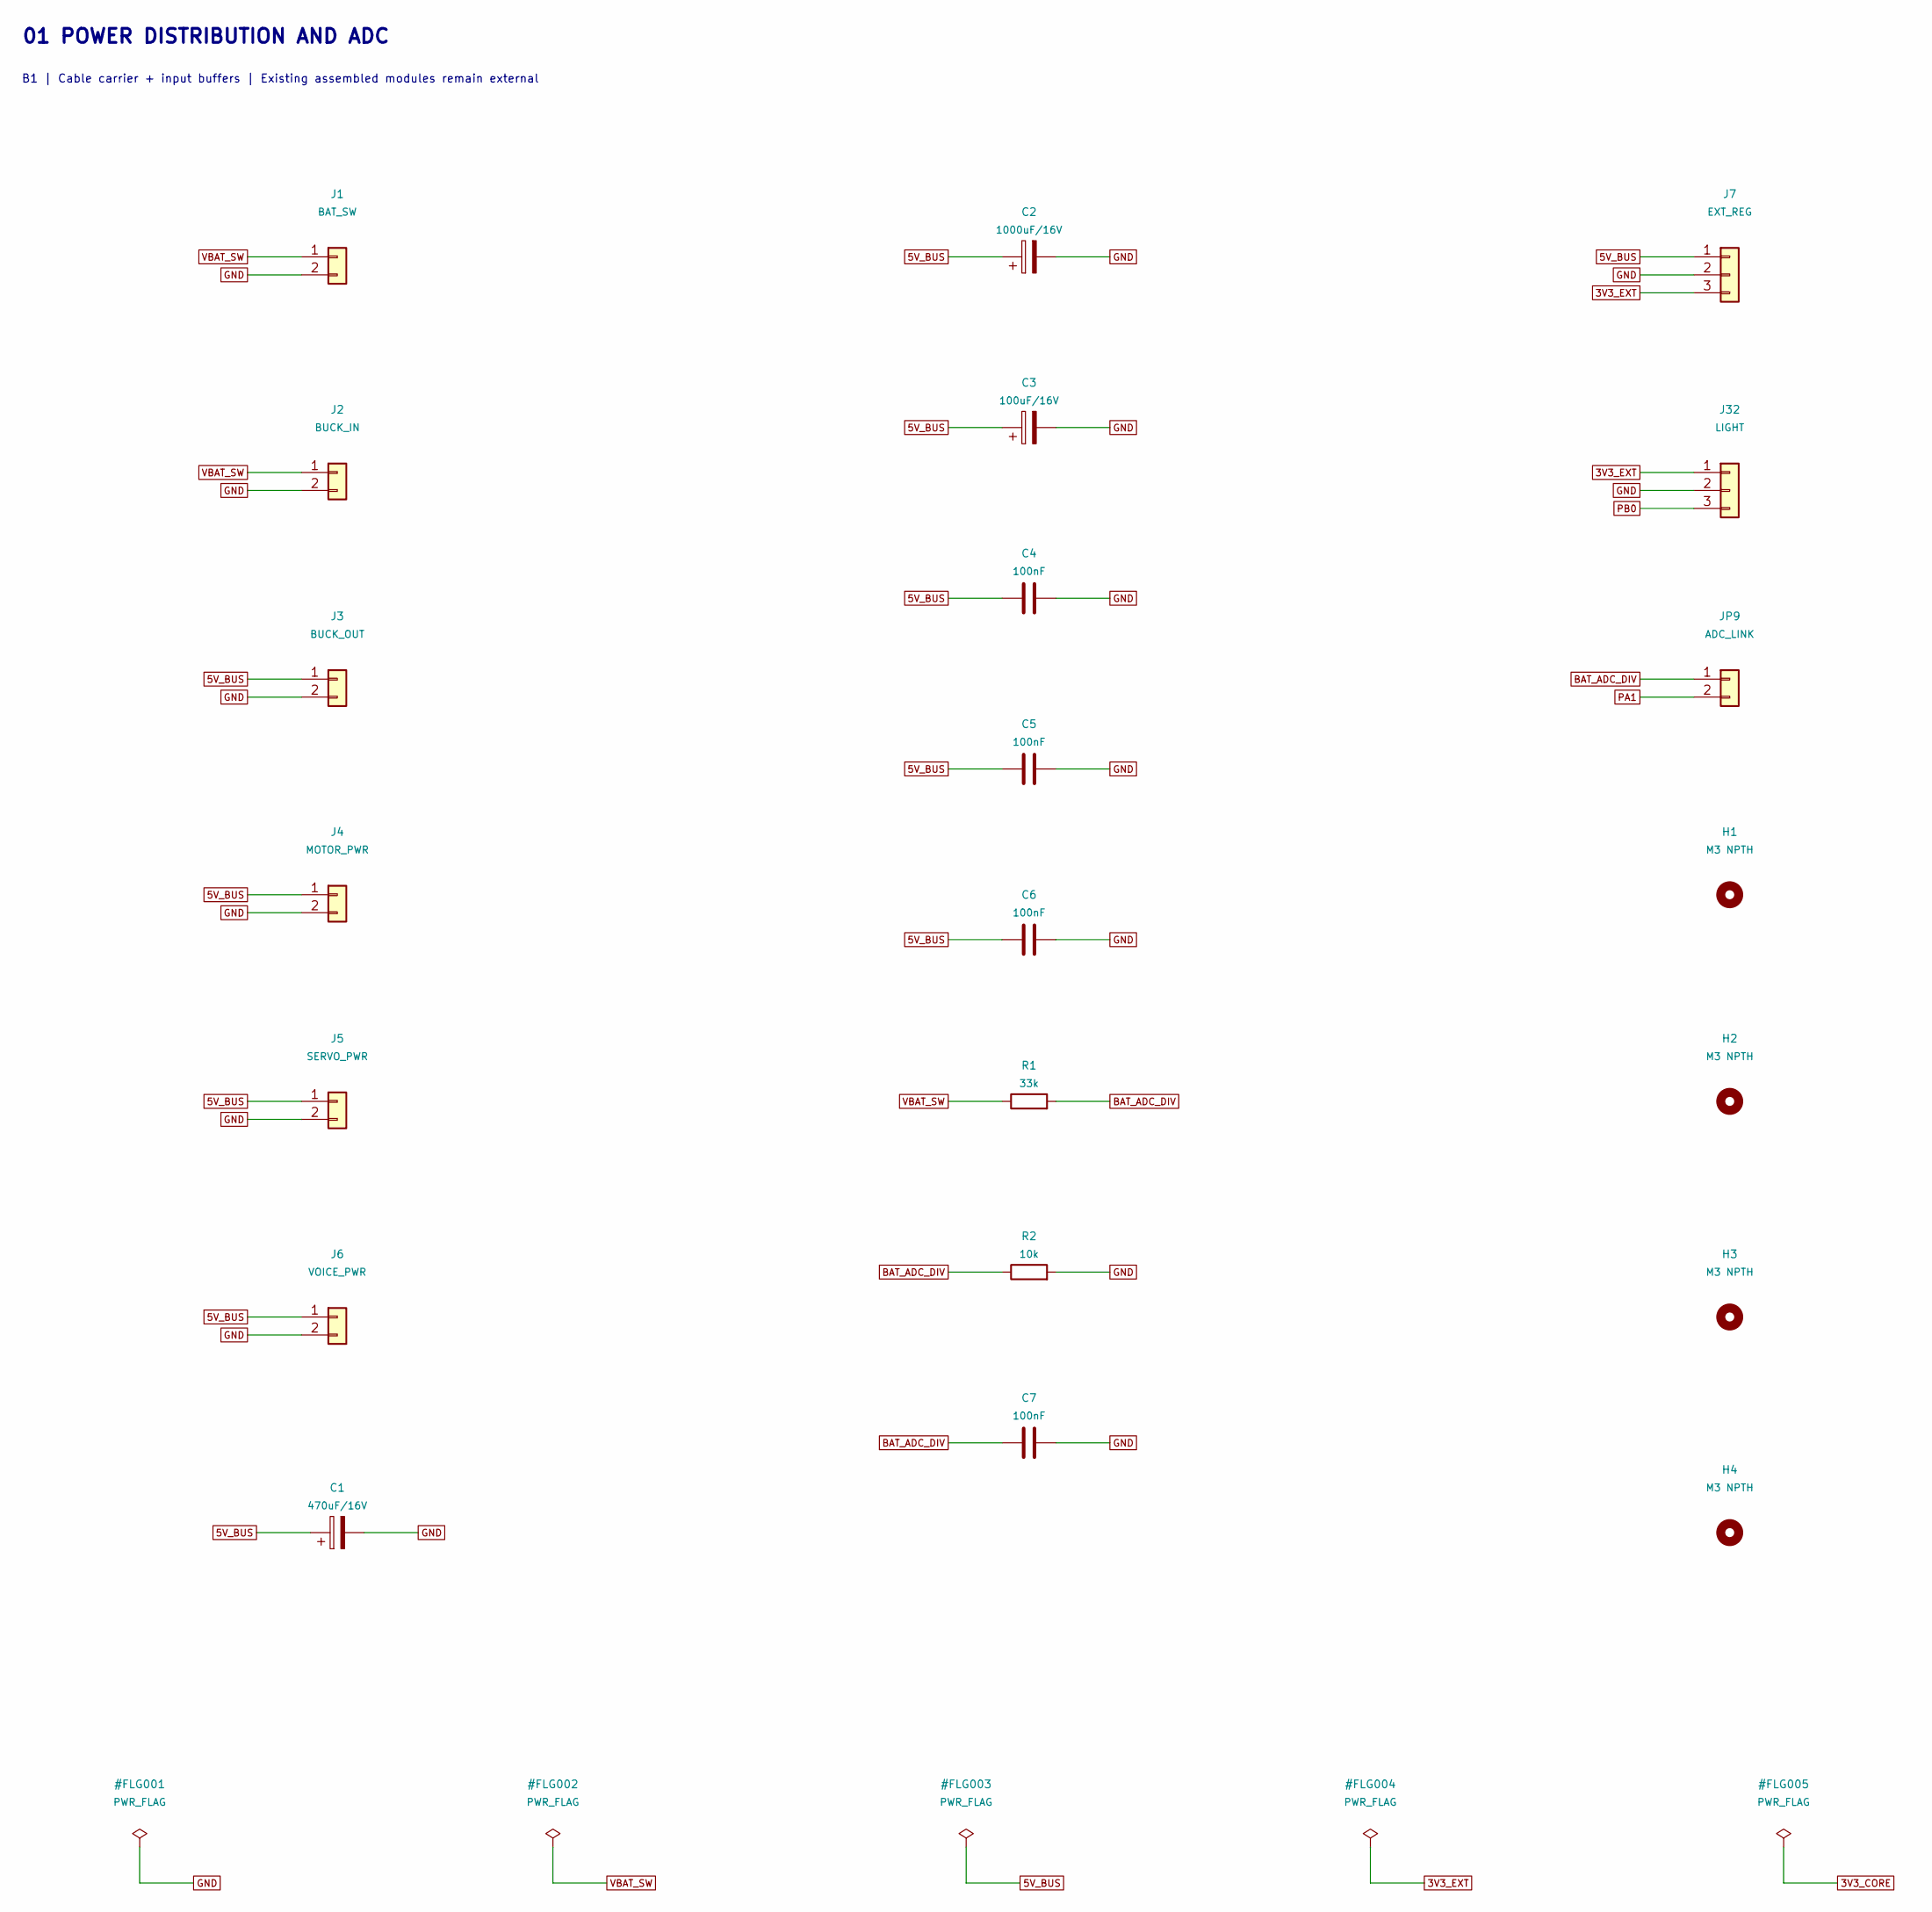
[picture p382: schematic SmartBin_B_01_01.kicad_sch, SmartBin B / 01 Power distribution and ADC]

Parts:
C1: 470uF/16V; CP_Radial_D12.5mm_P5.00mm
C2: 1000uF/16V; CP_Radial_D12.5mm_P5.00mm
C3: 100uF/16V; CP_Radial_D12.5mm_P5.00mm
C4, C5, C6, C7: 100nF; C_Disc_D5.0mm_W2.5mm_P5.00mm
H1, H2, H3, H4: M3 NPTH; MountingHole_3.2mm_M3
J1: BAT_SW; TerminalBlock_Phoenix_MKDS-1,5-2-5.08_1x02_P5.08mm_Horizont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
J2: BUCK_IN; TerminalBlock_Phoenix_MKDS-1,5-2-5.08_1x02_P5.08mm_Horizont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
J3: BUCK_OUT; TerminalBlock_Phoenix_MKDS-1,5-2-5.08_1x02_P5.08mm_Horizont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
J4: MOTOR_PWR; TerminalBlock_Phoenix_MKDS-1,5-2-5.08_1x02_P5.08mm_Horizont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
J5: SERVO_PWR; TerminalBlock_Phoenix_MKDS-1,5-2-5.08_1x02_P5.08mm_Horizont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
J6: VOICE_PWR; TerminalBlock_Phoenix_MKDS-1,5-2-5.08_1x02_P5.08mm_Horizont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
J7: EXT_REG; PinHeader_1x03_P2.54mm_Vertical
J32: LIGHT; PinHeader_1x03_P2.54mm_Vertical
JP9: ADC_LINK; PinHeader_1x02_P2.54mm_Vertical
R1: 33k; R_Axial_DIN0207_L6.3mm_D2.5mm_P10.16mm_Horizontal
R2: 10k; R_Axial_DIN0207_L6.3mm_D2.5mm_P10.16mm_Horizontal

Connections:
3V3_EXT: J7.3, J32.1; also elsewhere on the board
5V_BUS: C1.1, C2.1, C3.1, C4.1, C5.1, C6.1, J3.1, J4.1, J5.1, J6.1, J7.1; also elsewhere on the board
BAT_ADC_DIV: C7.1, JP9.1, R1.2, R2.1
GND: C1.2, C2.2, C3.2, C4.2, C5.2, C6.2, C7.2, J1.2, J2.2, J3.2, J4.2, J5.2, J6.2, J7.2, J32.2, R2.2; also elsewhere on the board
PA1: JP9.2; also elsewhere on the board
PB0: J32.3; also elsewhere on the board
VBAT_SW: J1.1, J2.1, R1.1; also elsewhere on the board

Notes on the sheet:
01 POWER DISTRIBUTION AND ADC
B1 | Cable carrier + input buffers | Existing assembled modules remain external

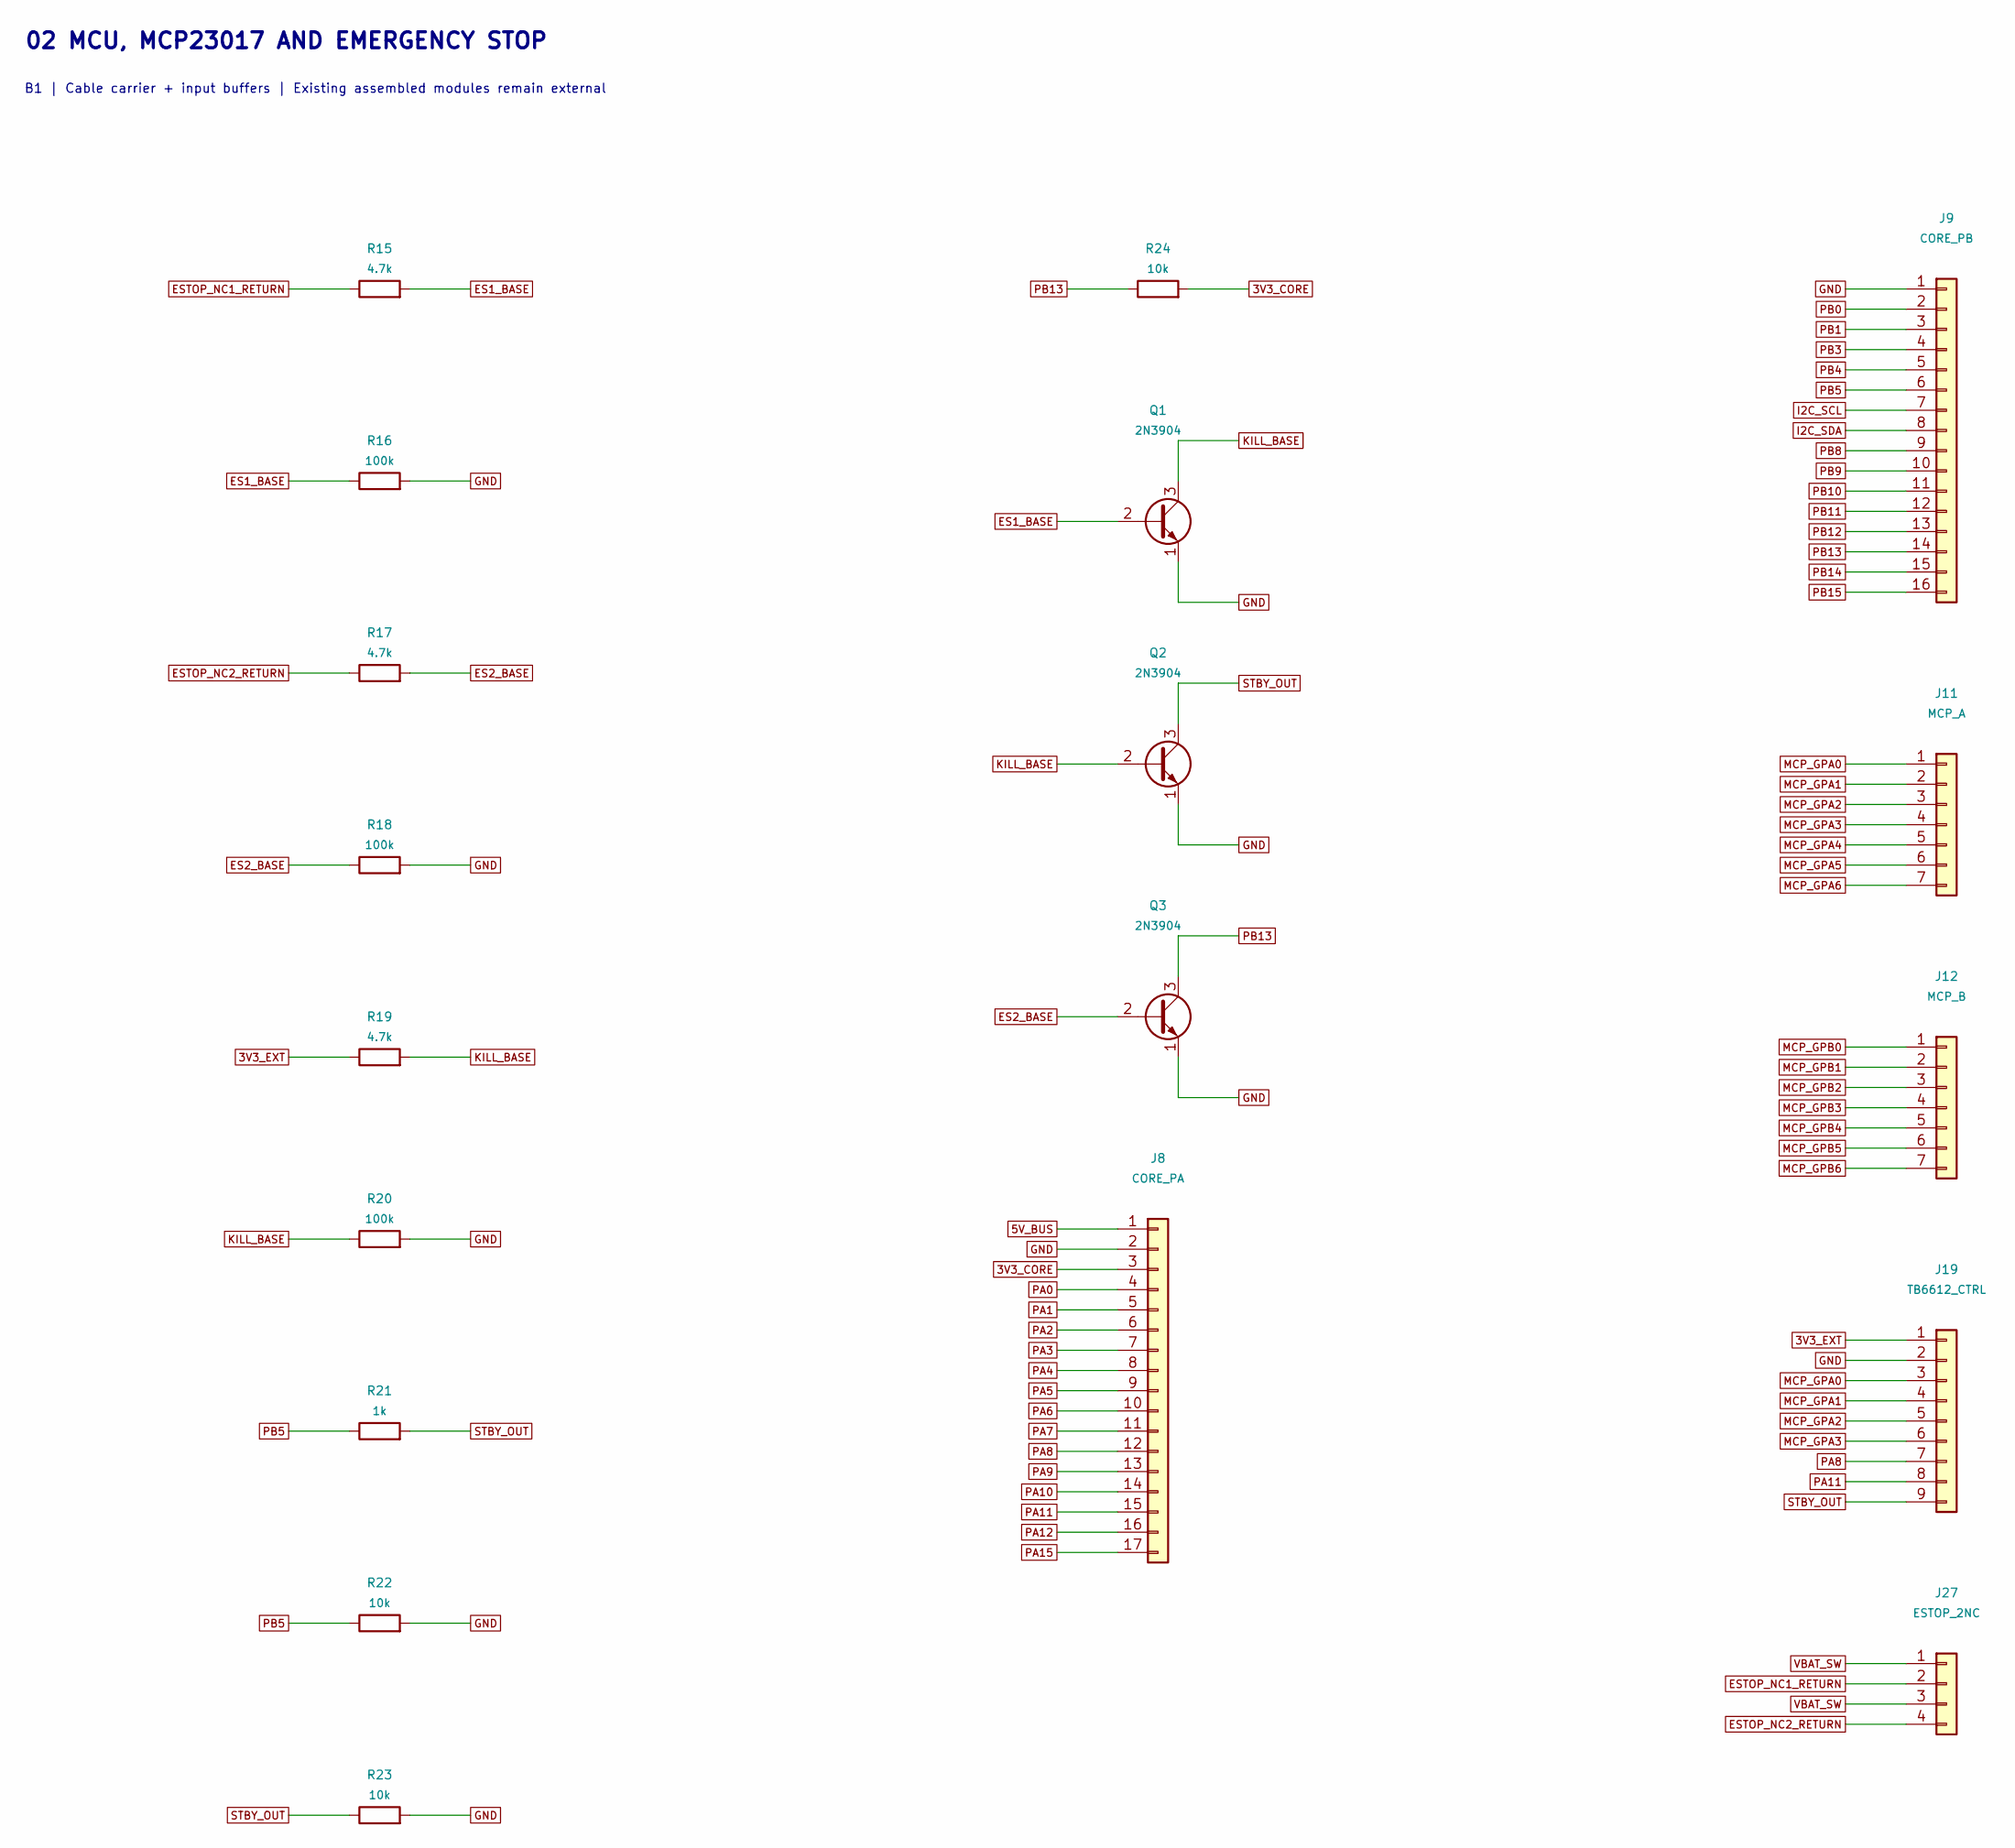
[picture p383: schematic SmartBin_B_02_01.kicad_sch, SmartBin B / 02 MCU, MCP23017 and emergency stop]

Parts:
J8: CORE_PA; PinHeader_1x17_P2.54mm_Vertical
J9: CORE_PB; PinHeader_1x16_P2.54mm_Vertical
J11: MCP_A; PinHeader_1x07_P2.54mm_Vertical
J12: MCP_B; PinHeader_1x07_P2.54mm_Vertical
J19: TB6612_CTRL; PinHeader_1x09_P2.54mm_Vertical
J27: ESTOP_2NC; PinHeader_1x04_P2.54mm_Vertical
Q1, Q2, Q3: 2N3904; TO-92_Inline_Wide
R15, R17, R19: 4.7k; R_Axial_DIN0207_L6.3mm_D2.5mm_P10.16mm_Horizontal
R16, R18, R20: 100k; R_Axial_DIN0207_L6.3mm_D2.5mm_P10.16mm_Horizontal
R21: 1k; R_Axial_DIN0207_L6.3mm_D2.5mm_P10.16mm_Horizontal
R22, R23, R24: 10k; R_Axial_DIN0207_L6.3mm_D2.5mm_P10.16mm_Horizontal

Connections:
3V3_CORE: J8.3, R24.2; also elsewhere on the board
3V3_EXT: J19.1, R19.1; also elsewhere on the board
5V_BUS: J8.1; also elsewhere on the board
ES1_BASE: Q1.2 (B), R15.2, R16.1
ES2_BASE: Q3.2 (B), R17.2, R18.1
ESTOP_NC1_RETURN: J27.2, R15.1
ESTOP_NC2_RETURN: J27.4, R17.1
GND: J8.2, J9.1, J19.2, Q1.1 (E), Q2.1 (E), Q3.1 (E), R16.2, R18.2, R20.2, R22.2, R23.2; also elsewhere on the board
I2C_SCL: J9.7; also elsewhere on the board
I2C_SDA: J9.8; also elsewhere on the board
KILL_BASE: Q1.3 (C), Q2.2 (B), R19.2, R20.1
MCP_GPA0: J11.1, J19.3
MCP_GPA1: J11.2, J19.4
MCP_GPA2: J11.3, J19.5
MCP_GPA3: J11.4, J19.6
MCP_GPA4: J11.5; also elsewhere on the board
MCP_GPA5: J11.6; also elsewhere on the board
MCP_GPA6: J11.7; also elsewhere on the board
MCP_GPB0: J12.1; also elsewhere on the board
MCP_GPB1: J12.2; also elsewhere on the board
MCP_GPB2: J12.3; also elsewhere on the board
MCP_GPB3: J12.4; also elsewhere on the board
MCP_GPB4: J12.5; also elsewhere on the board
MCP_GPB5: J12.6; also elsewhere on the board
MCP_GPB6: J12.7; also elsewhere on the board
PA0: J8.4; also elsewhere on the board
PA1: J8.5; also elsewhere on the board
PA2: J8.6; also elsewhere on the board
PA3: J8.7; also elsewhere on the board
PA4: J8.8; also elsewhere on the board
PA5: J8.9; also elsewhere on the board
PA6: J8.10; also elsewhere on the board
PA7: J8.11; also elsewhere on the board
PA8: J8.12, J19.7
PA9: J8.13; also elsewhere on the board
PA10: J8.14; also elsewhere on the board
PA11: J8.15, J19.8
PA12: J8.16; also elsewhere on the board
PA15: J8.17; also elsewhere on the board
PB0: J9.2; also elsewhere on the board
PB1: J9.3; also elsewhere on the board
PB3: J9.4; also elsewhere on the board
PB4: J9.5; also elsewhere on the board
PB5: J9.6, R21.1, R22.1
PB8: J9.9; also elsewhere on the board
PB9: J9.10; also elsewhere on the board
PB10: J9.11; also elsewhere on the board
PB11: J9.12; also elsewhere on the board
PB12: J9.13; also elsewhere on the board
PB13: J9.14, Q3.3 (C), R24.1
PB14: J9.15; also elsewhere on the board
PB15: J9.16; also elsewhere on the board
STBY_OUT: J19.9, Q2.3 (C), R21.2, R23.1
VBAT_SW: J27.1, J27.3; also elsewhere on the board

Notes on the sheet:
02 MCU, MCP23017 AND EMERGENCY STOP
B1 | Cable carrier + input buffers | Existing assembled modules remain external

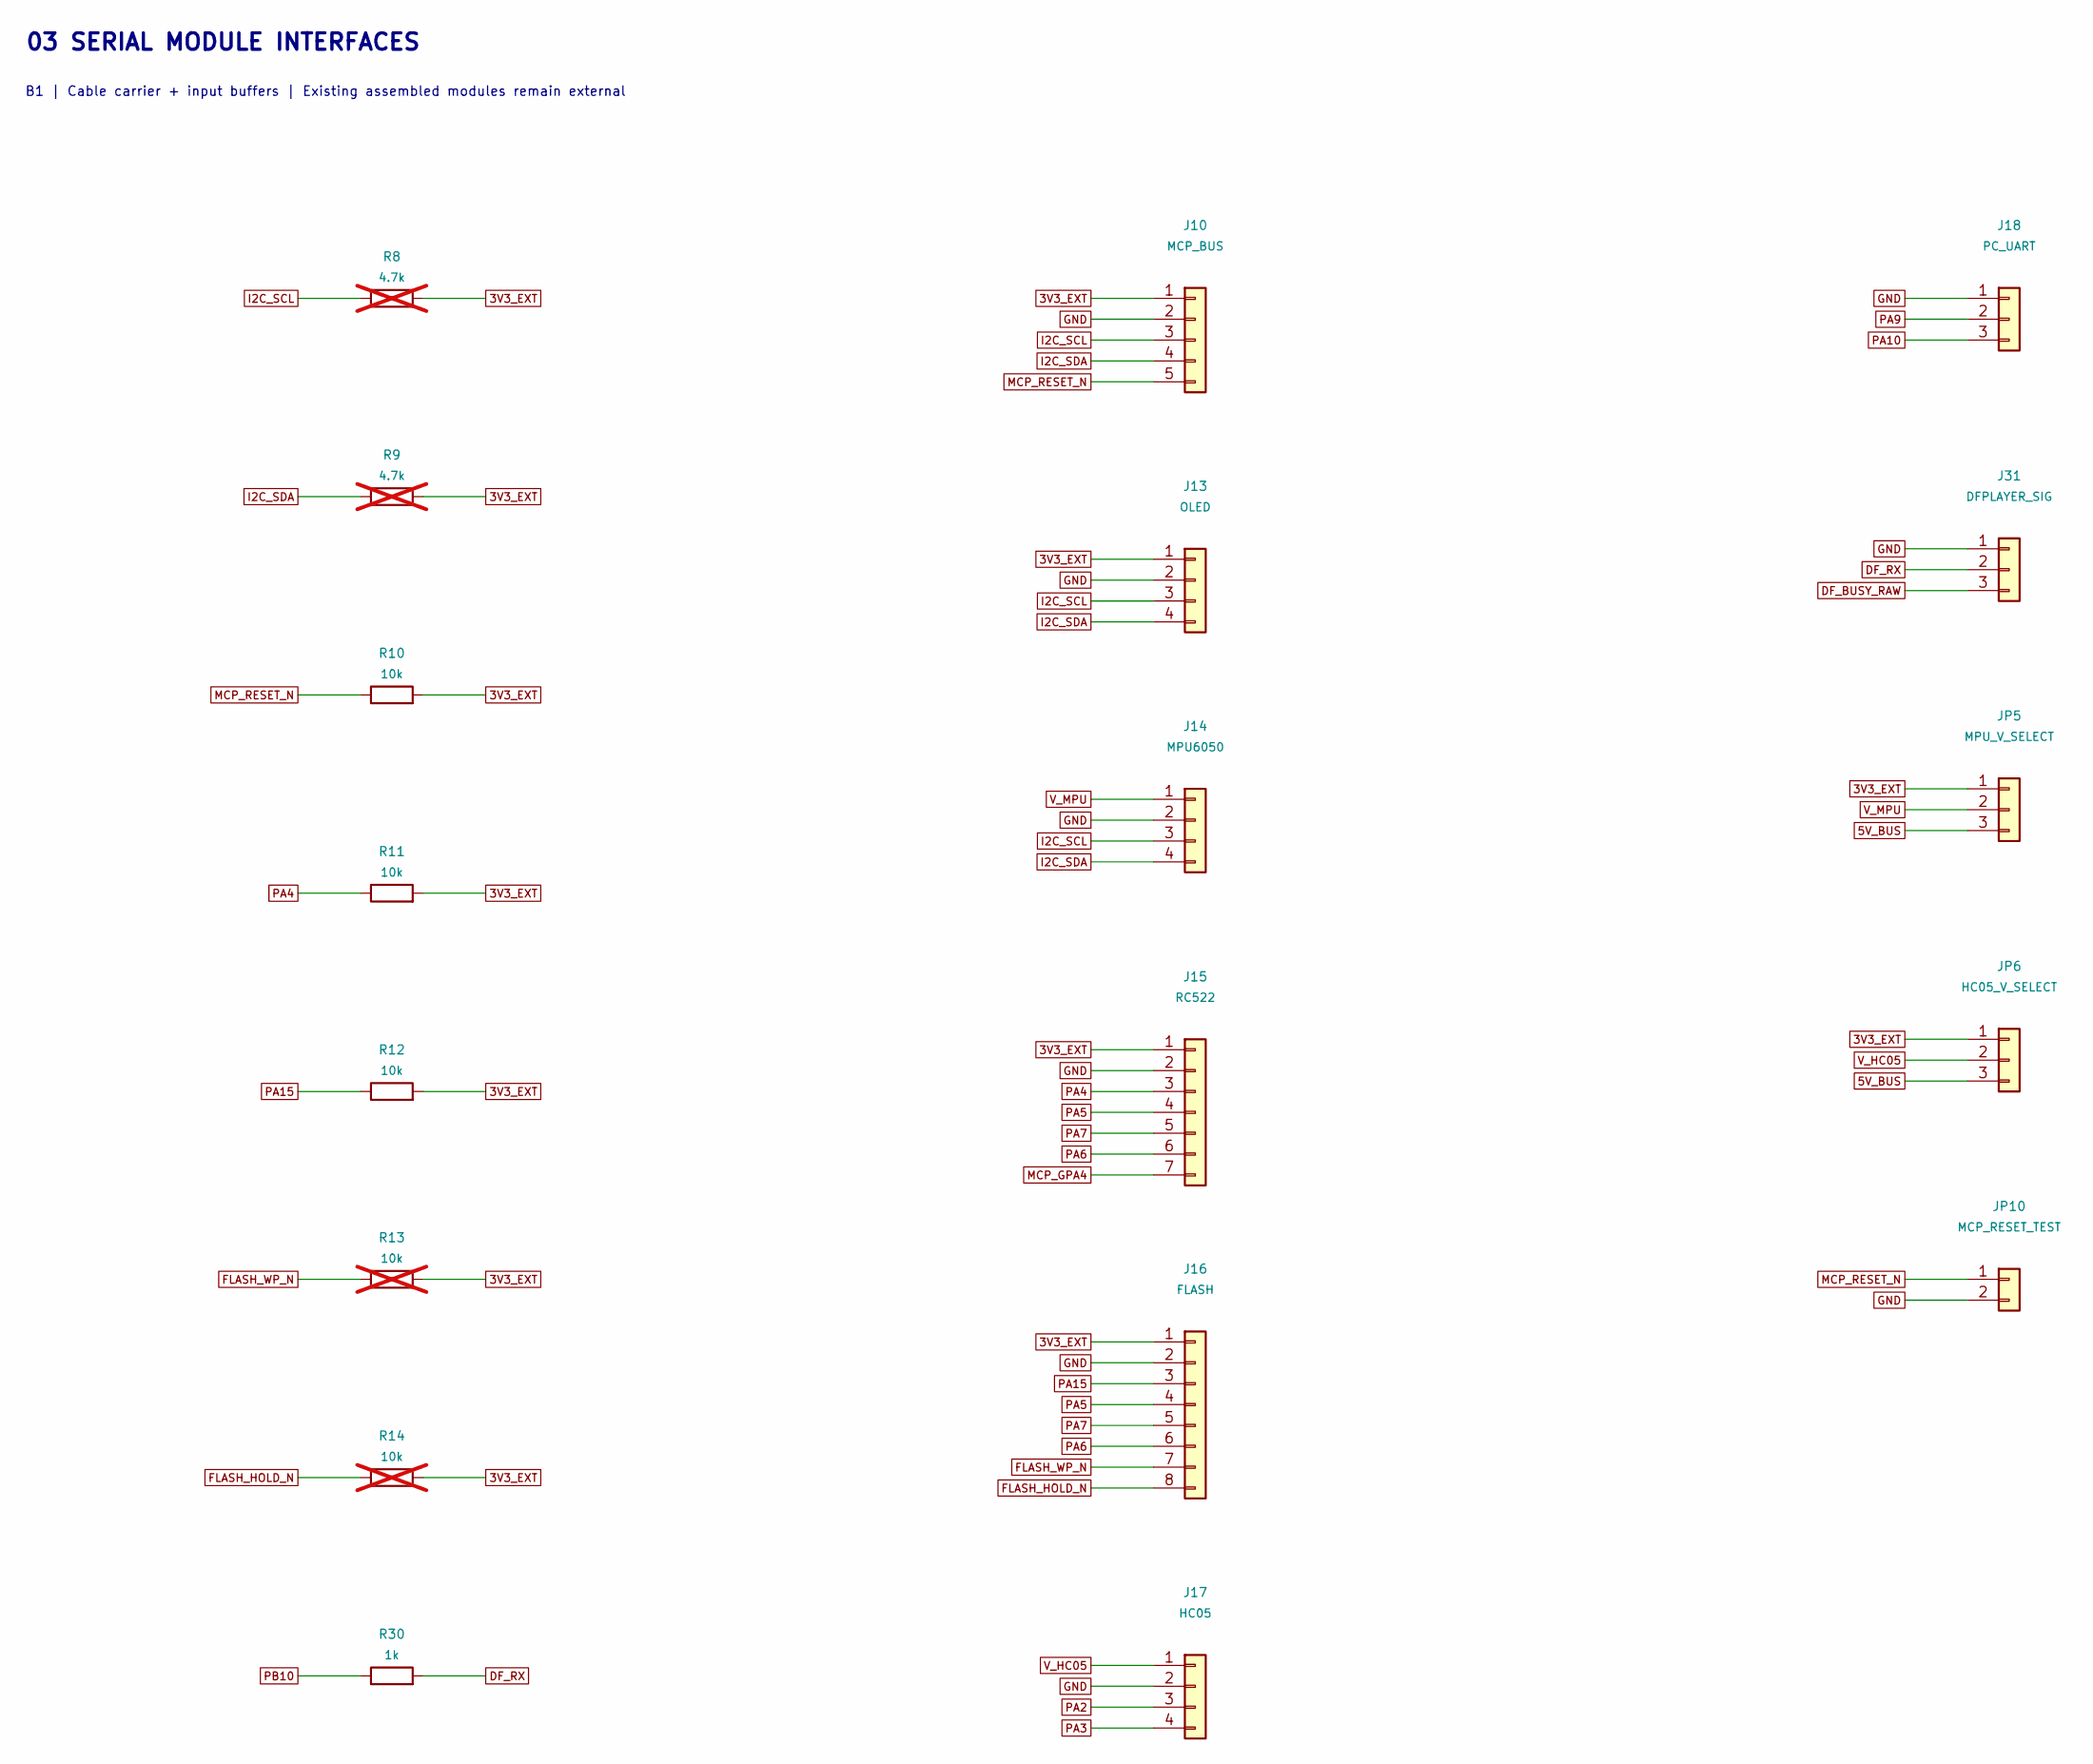
[picture p384: schematic SmartBin_B_03_01.kicad_sch, SmartBin B / 03 Serial module interfaces]

Parts:
J10: MCP_BUS; PinHeader_1x05_P2.54mm_Vertical
J13: OLED; PinHeader_1x04_P2.54mm_Vertical
J14: MPU6050; PinHeader_1x04_P2.54mm_Vertical
J15: RC522; PinHeader_1x07_P2.54mm_Vertical
J16: FLASH; PinHeader_1x08_P2.54mm_Vertical
J17: HC05; PinHeader_1x04_P2.54mm_Vertical
J18: PC_UART; PinHeader_1x03_P2.54mm_Vertical
J31: DFPLAYER_SIG; PinHeader_1x03_P2.54mm_Vertical
JP5: MPU_V_SELECT; PinHeader_1x03_P2.54mm_Vertical
JP6: HC05_V_SELECT; PinHeader_1x03_P2.54mm_Vertical
JP10: MCP_RESET_TEST; PinHeader_1x02_P2.54mm_Vertical
R8, R9: 4.7k; R_Axial_DIN0207_L6.3mm_D2.5mm_P10.16mm_Horizontal; not fitted
R10, R11, R12: 10k; R_Axial_DIN0207_L6.3mm_D2.5mm_P10.16mm_Horizontal
R13, R14: 10k; R_Axial_DIN0207_L6.3mm_D2.5mm_P10.16mm_Horizontal; not fitted
R30: 1k; R_Axial_DIN0207_L6.3mm_D2.5mm_P10.16mm_Horizontal

Connections:
3V3_EXT: J10.1, J13.1, J15.1, J16.1, JP5.1, JP6.1, R8.2, R9.2, R10.2, R11.2, R12.2, R13.2, R14.2; also elsewhere on the board
5V_BUS: JP5.3, JP6.3; also elsewhere on the board
DF_BUSY_RAW: J31.3; also elsewhere on the board
DF_RX: J31.2, R30.2
FLASH_HOLD_N: J16.8, R14.1
FLASH_WP_N: J16.7, R13.1
GND: J10.2, J13.2, J14.2, J15.2, J16.2, J17.2, J18.1, J31.1, JP10.2; also elsewhere on the board
I2C_SCL: J10.3, J13.3, J14.3, R8.1; also elsewhere on the board
I2C_SDA: J10.4, J13.4, J14.4, R9.1; also elsewhere on the board
MCP_GPA4: J15.7; also elsewhere on the board
MCP_RESET_N: J10.5, JP10.1, R10.1
PA2: J17.3; also elsewhere on the board
PA3: J17.4; also elsewhere on the board
PA4: J15.3, R11.1; also elsewhere on the board
PA5: J15.4, J16.4; also elsewhere on the board
PA6: J15.6, J16.6; also elsewhere on the board
PA7: J15.5, J16.5; also elsewhere on the board
PA9: J18.2; also elsewhere on the board
PA10: J18.3; also elsewhere on the board
PA15: J16.3, R12.1; also elsewhere on the board
PB10: R30.1; also elsewhere on the board
V_HC05: J17.1, JP6.2
V_MPU: J14.1, JP5.2

Notes on the sheet:
03 SERIAL MODULE INTERFACES
B1 | Cable carrier + input buffers | Existing assembled modules remain external
