Sylphiette666/stm32-rfid-smart-bin/hardware/current-low-cost/pcb-b/kicad/SmartBin_B.kicad_pcb

## KiCad design hardware/current-low-cost/pcb-b/kicad/SmartBin_B.kicad_pcb (continued)

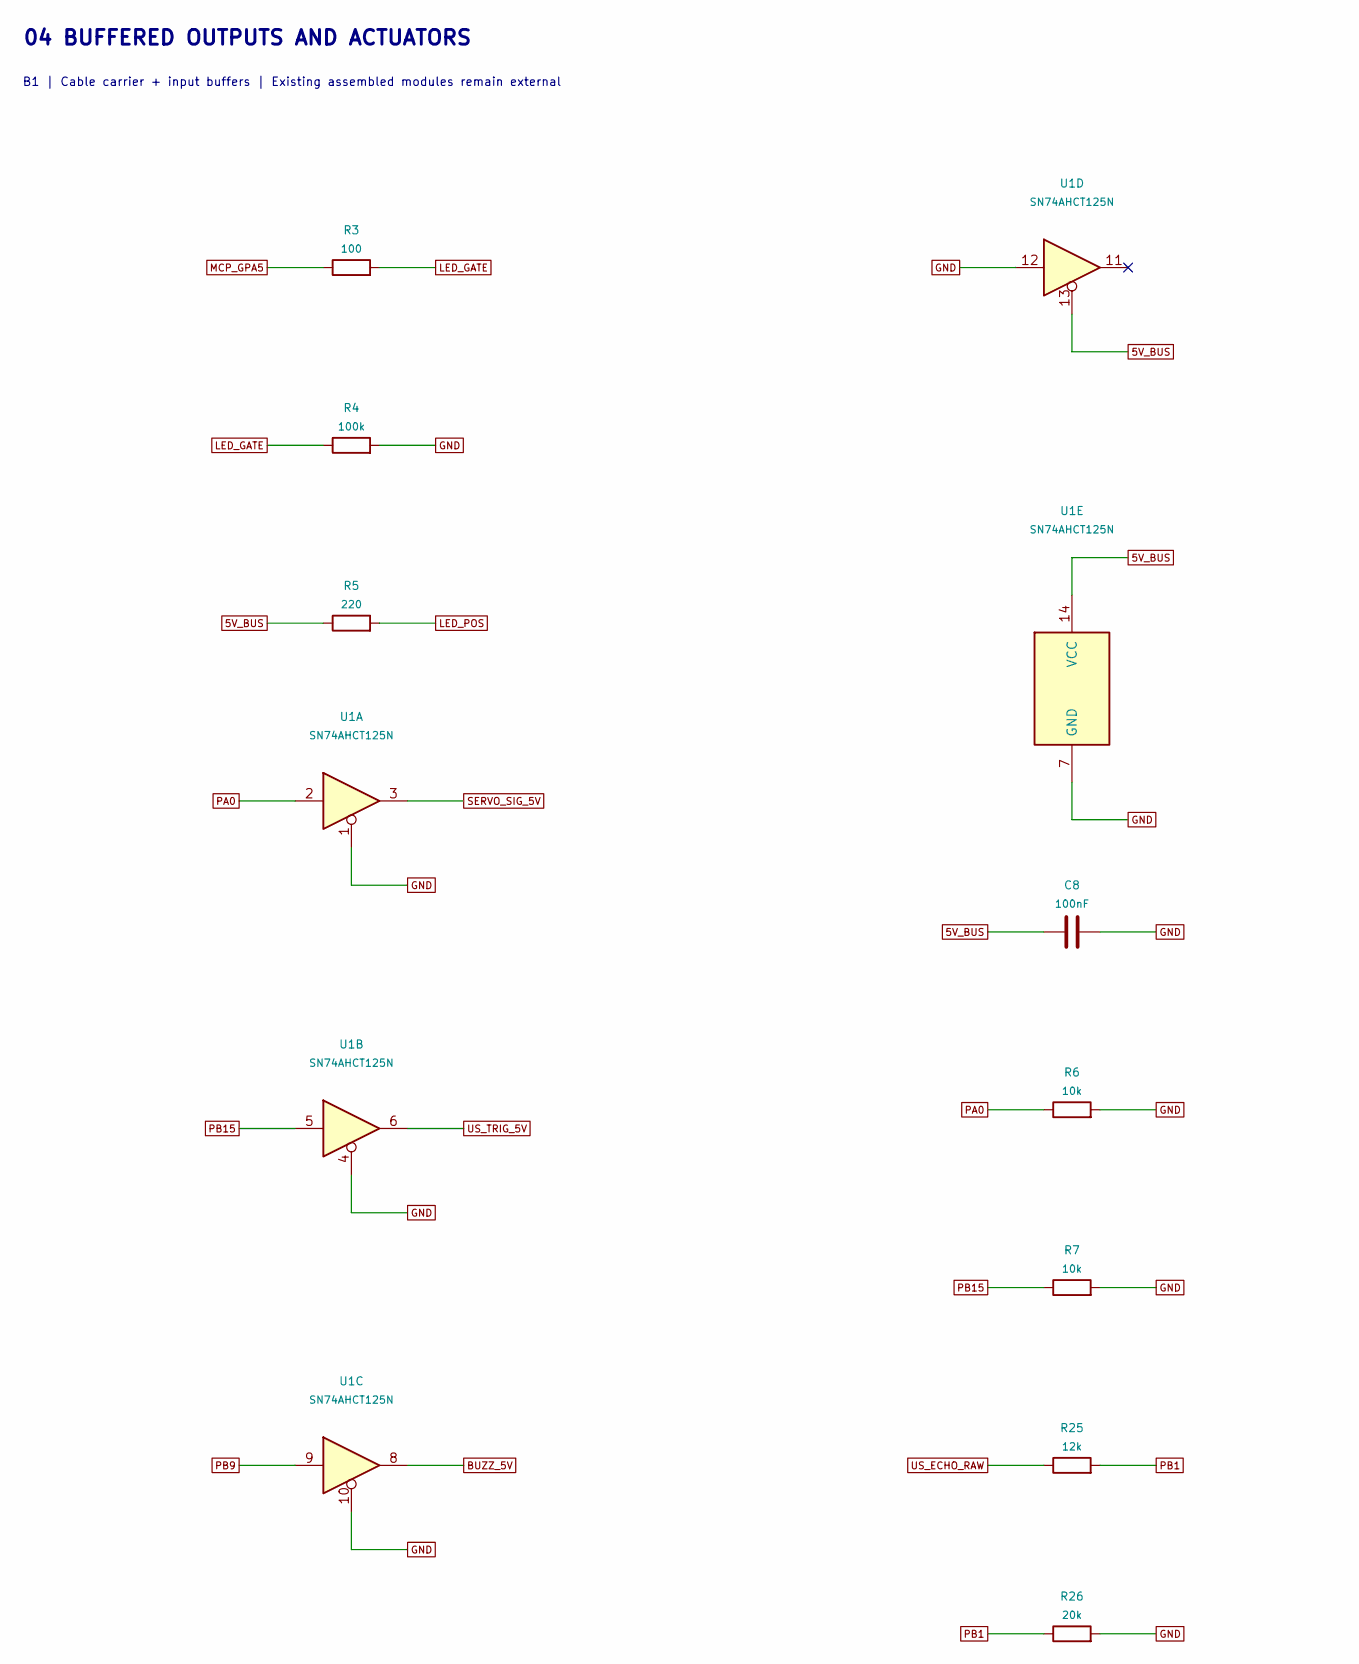
[picture p385: schematic SmartBin_B_04_01.kicad_sch, SmartBin B / 04 Buffered outputs and actuators, part in row 1, column 1]

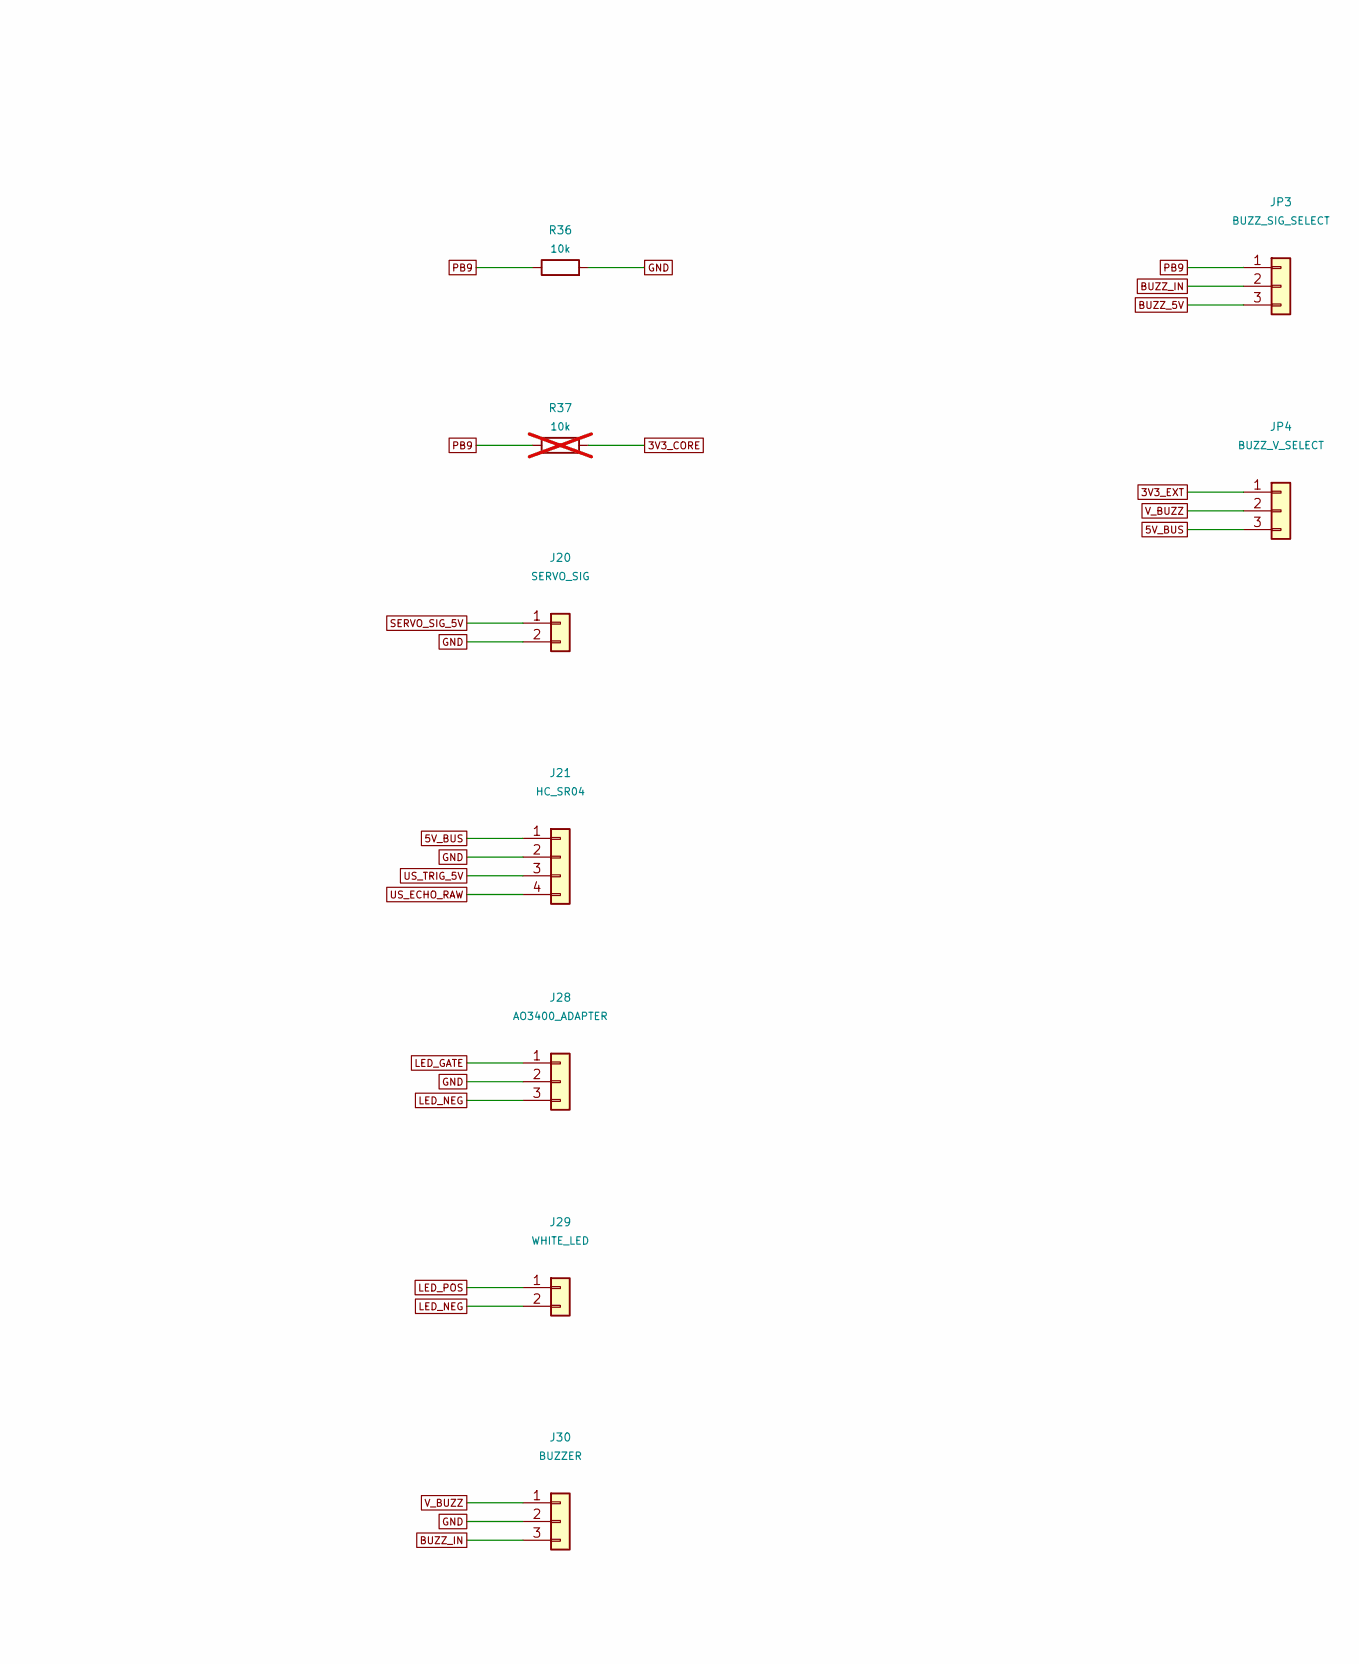
[picture p386: schematic SmartBin_B_04_01.kicad_sch, SmartBin B / 04 Buffered outputs and actuators, part in row 1, column 2]

Parts:
C8: 100nF; C_Disc_D5.0mm_W2.5mm_P5.00mm
J20: SERVO_SIG; PinHeader_1x02_P2.54mm_Vertical
J21: HC_SR04; PinHeader_1x04_P2.54mm_Vertical
J28: AO3400_ADAPTER; PinHeader_1x03_P2.54mm_Vertical
J29: WHITE_LED; PinHeader_1x02_P2.54mm_Vertical
J30: BUZZER; PinHeader_1x03_P2.54mm_Vertical
JP3: BUZZ_SIG_SELECT; PinHeader_1x03_P2.54mm_Vertical
JP4: BUZZ_V_SELECT; PinHeader_1x03_P2.54mm_Vertical
R3: 100; R_Axial_DIN0207_L6.3mm_D2.5mm_P10.16mm_Horizontal
R4: 100k; R_Axial_DIN0207_L6.3mm_D2.5mm_P10.16mm_Horizontal
R5: 220; R_Axial_DIN0207_L6.3mm_D2.5mm_P10.16mm_Horizontal
R6, R7, R36: 10k; R_Axial_DIN0207_L6.3mm_D2.5mm_P10.16mm_Horizontal
R25: 12k; R_Axial_DIN0207_L6.3mm_D2.5mm_P10.16mm_Horizontal
R26: 20k; R_Axial_DIN0207_L6.3mm_D2.5mm_P10.16mm_Horizontal
R37: 10k; R_Axial_DIN0207_L6.3mm_D2.5mm_P10.16mm_Horizontal; not fitted
U1: SN74AHCT125N; DIP-14_W7.62mm_Socket

Connections:
3V3_CORE: R37.2; also elsewhere on the board
3V3_EXT: JP4.1; also elsewhere on the board
5V_BUS: C8.1, J21.1, JP4.3, R5.1, U1.13, U1.14 (VCC); also elsewhere on the board
BUZZ_5V: JP3.3, U1.8
BUZZ_IN: J30.3, JP3.2
GND: C8.2, J20.2, J21.2, J28.2, J30.2, R4.2, R6.2, R7.2, R26.2, R36.2, U1.1, U1.4, U1.7 (GND), U1.10, U1.12; also elsewhere on the board
LED_GATE: J28.1, R3.2, R4.1
LED_NEG: J28.3, J29.2
LED_POS: J29.1, R5.2
MCP_GPA5: R3.1; also elsewhere on the board
PA0: R6.1, U1.2; also elsewhere on the board
PB1: R25.2, R26.1; also elsewhere on the board
PB9: JP3.1, R36.1, R37.1, U1.9; also elsewhere on the board
PB15: R7.1, U1.5; also elsewhere on the board
SERVO_SIG_5V: J20.1, U1.3
US_ECHO_RAW: J21.4, R25.1
US_TRIG_5V: J21.3, U1.6
V_BUZZ: J30.1, JP4.2

Notes on the sheet:
04 BUFFERED OUTPUTS AND ACTUATORS
B1 | Cable carrier + input buffers | Existing assembled modules remain external

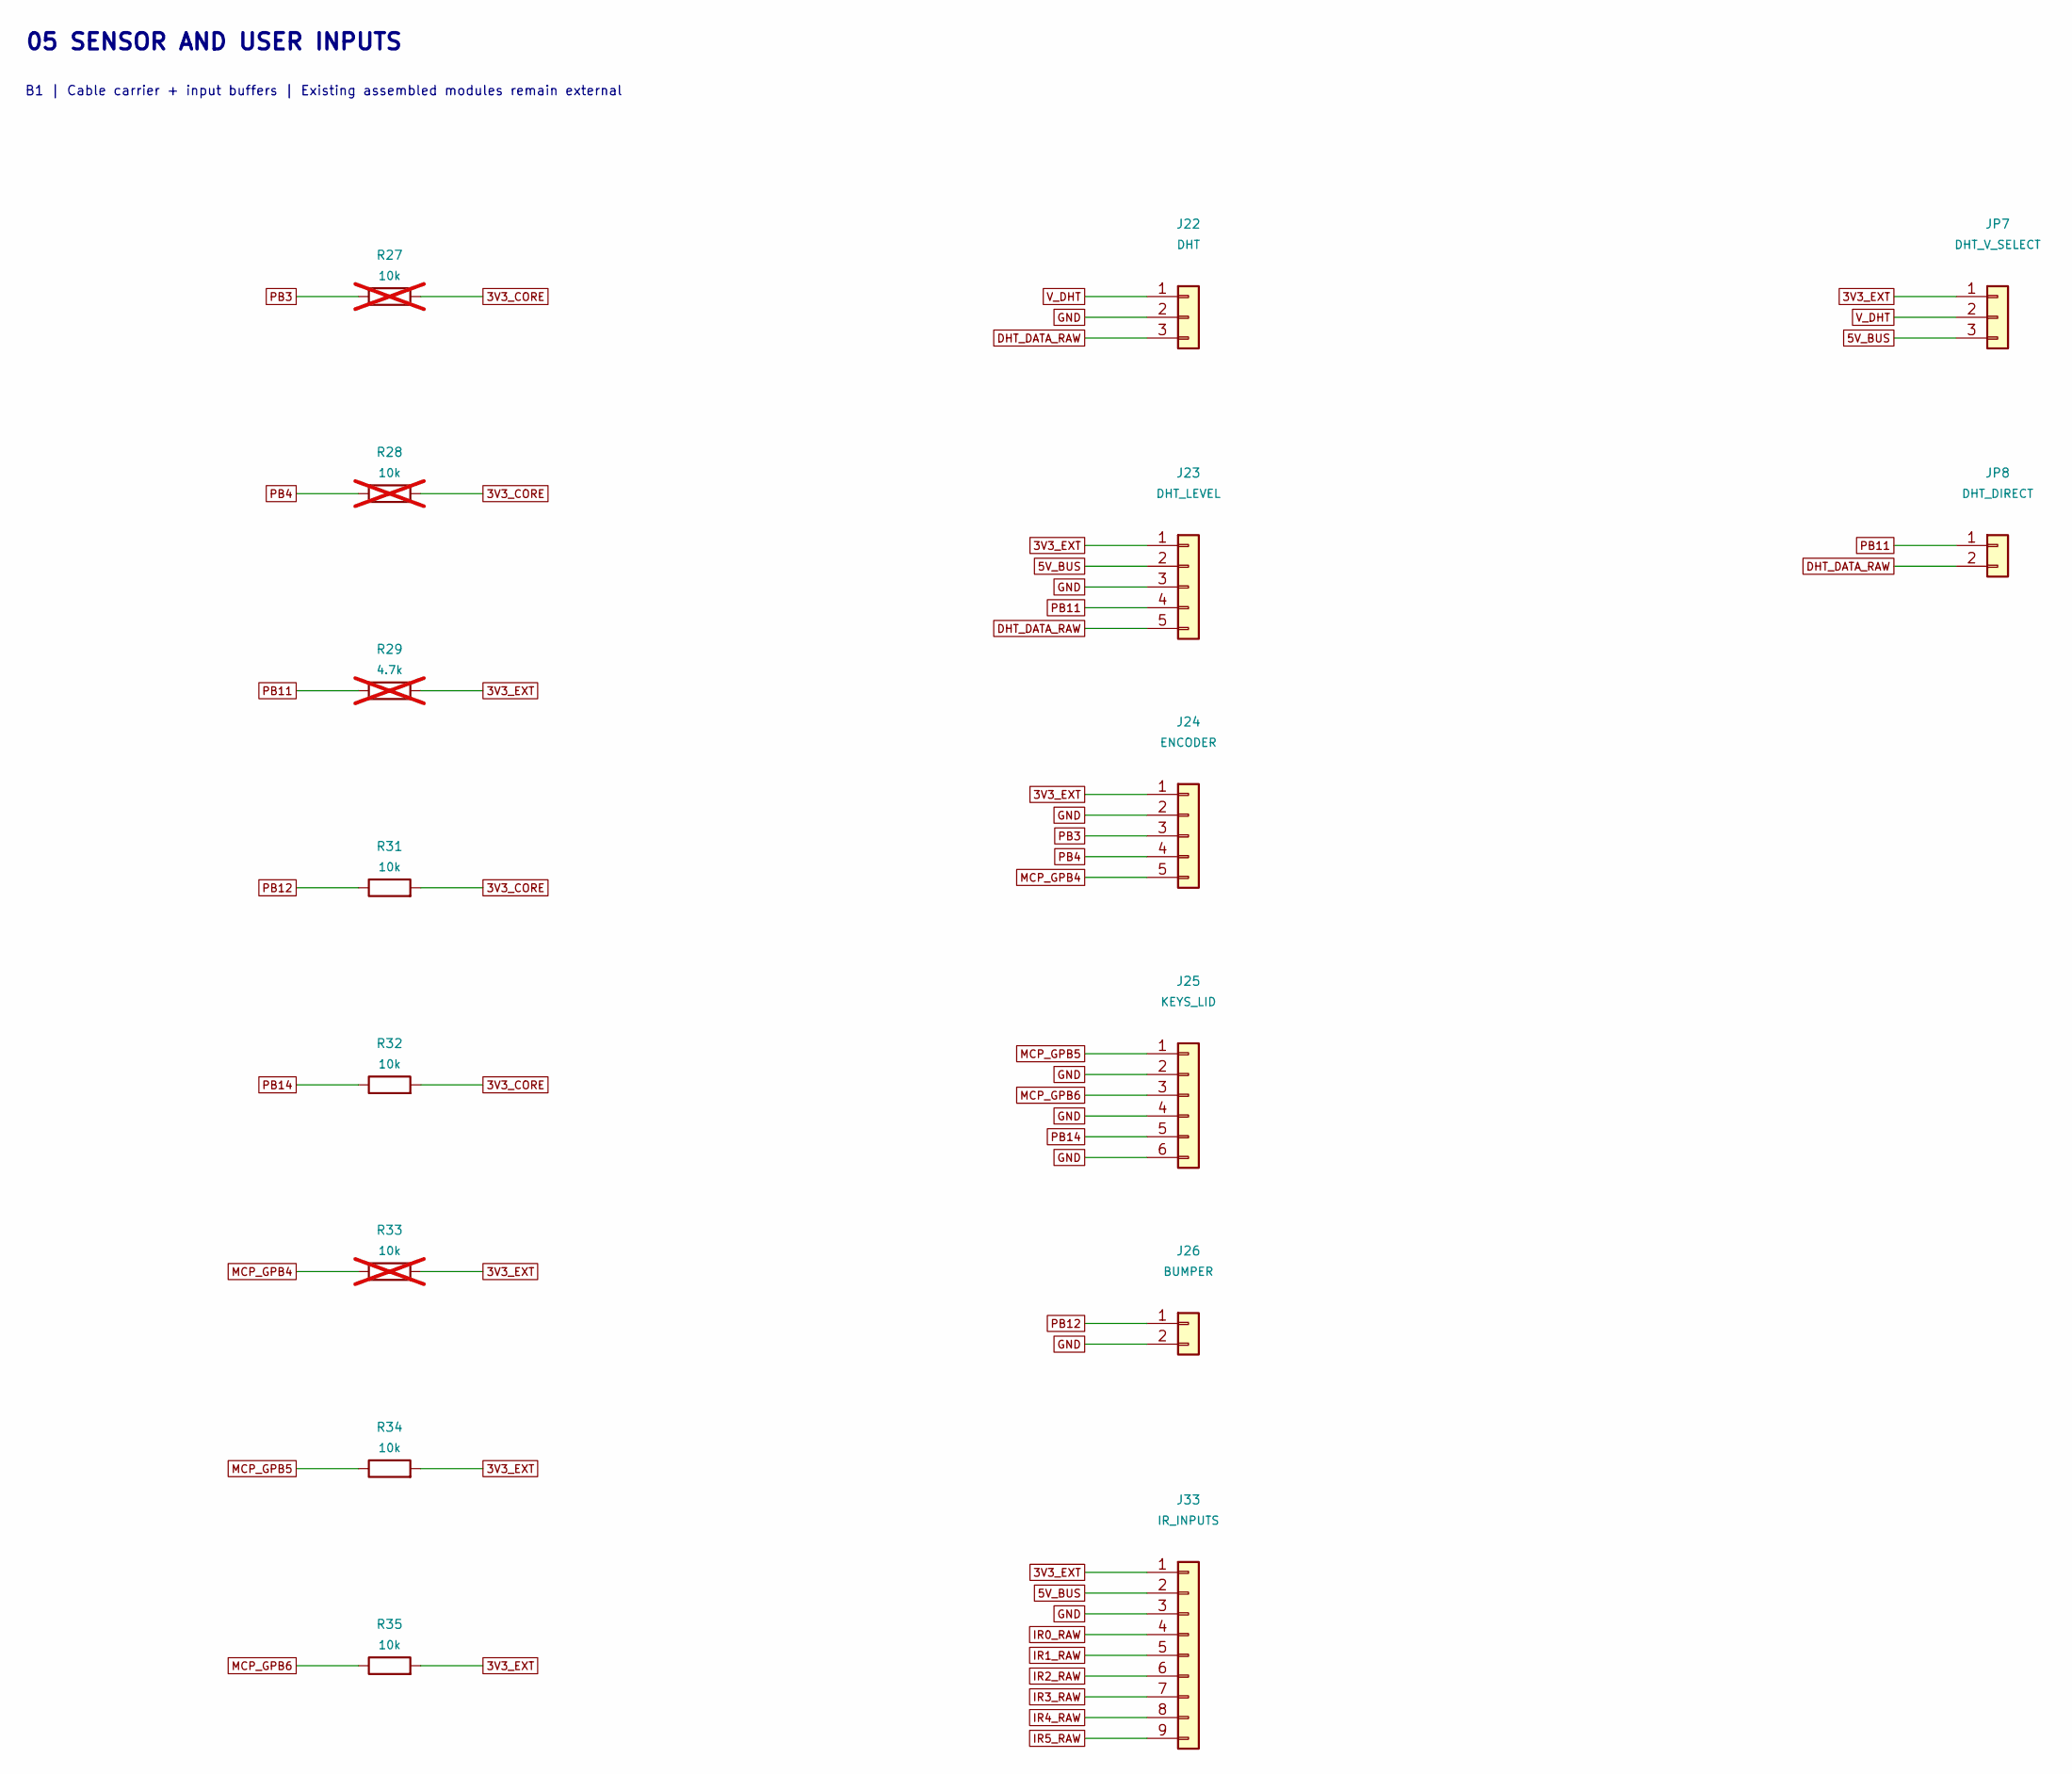
[picture p387: schematic SmartBin_B_05_01.kicad_sch, SmartBin B / 05 Sensor and user inputs]

Parts:
J22: DHT; PinHeader_1x03_P2.54mm_Vertical
J23: DHT_LEVEL; PinHeader_1x05_P2.54mm_Vertical
J24: ENCODER; PinHeader_1x05_P2.54mm_Vertical
J25: KEYS_LID; PinHeader_1x06_P2.54mm_Vertical
J26: BUMPER; PinHeader_1x02_P2.54mm_Vertical
J33: IR_INPUTS; PinHeader_1x09_P2.54mm_Vertical
JP7: DHT_V_SELECT; PinHeader_1x03_P2.54mm_Vertical
JP8: DHT_DIRECT; PinHeader_1x02_P2.54mm_Vertical
R27, R28, R33: 10k; R_Axial_DIN0207_L6.3mm_D2.5mm_P10.16mm_Horizontal; not fitted
R29: 4.7k; R_Axial_DIN0207_L6.3mm_D2.5mm_P10.16mm_Horizontal; not fitted
R31, R32, R34, R35: 10k; R_Axial_DIN0207_L6.3mm_D2.5mm_P10.16mm_Horizontal

Connections:
3V3_CORE: R27.2, R28.2, R31.2, R32.2; also elsewhere on the board
3V3_EXT: J23.1, J24.1, J33.1, JP7.1, R29.2, R33.2, R34.2, R35.2; also elsewhere on the board
5V_BUS: J23.2, J33.2, JP7.3; also elsewhere on the board
DHT_DATA_RAW: J22.3, J23.5, JP8.2
GND: J22.2, J23.3, J24.2, J25.2, J25.4, J25.6, J26.2, J33.3; also elsewhere on the board
IR0_RAW: J33.4; also elsewhere on the board
IR1_RAW: J33.5; also elsewhere on the board
IR2_RAW: J33.6; also elsewhere on the board
IR3_RAW: J33.7; also elsewhere on the board
IR4_RAW: J33.8; also elsewhere on the board
IR5_RAW: J33.9; also elsewhere on the board
MCP_GPB4: J24.5, R33.1; also elsewhere on the board
MCP_GPB5: J25.1, R34.1; also elsewhere on the board
MCP_GPB6: J25.3, R35.1; also elsewhere on the board
PB3: J24.3, R27.1; also elsewhere on the board
PB4: J24.4, R28.1; also elsewhere on the board
PB11: J23.4, JP8.1, R29.1; also elsewhere on the board
PB12: J26.1, R31.1; also elsewhere on the board
PB14: J25.5, R32.1; also elsewhere on the board
V_DHT: J22.1, JP7.2

Notes on the sheet:
05 SENSOR AND USER INPUTS
B1 | Cable carrier + input buffers | Existing assembled modules remain external

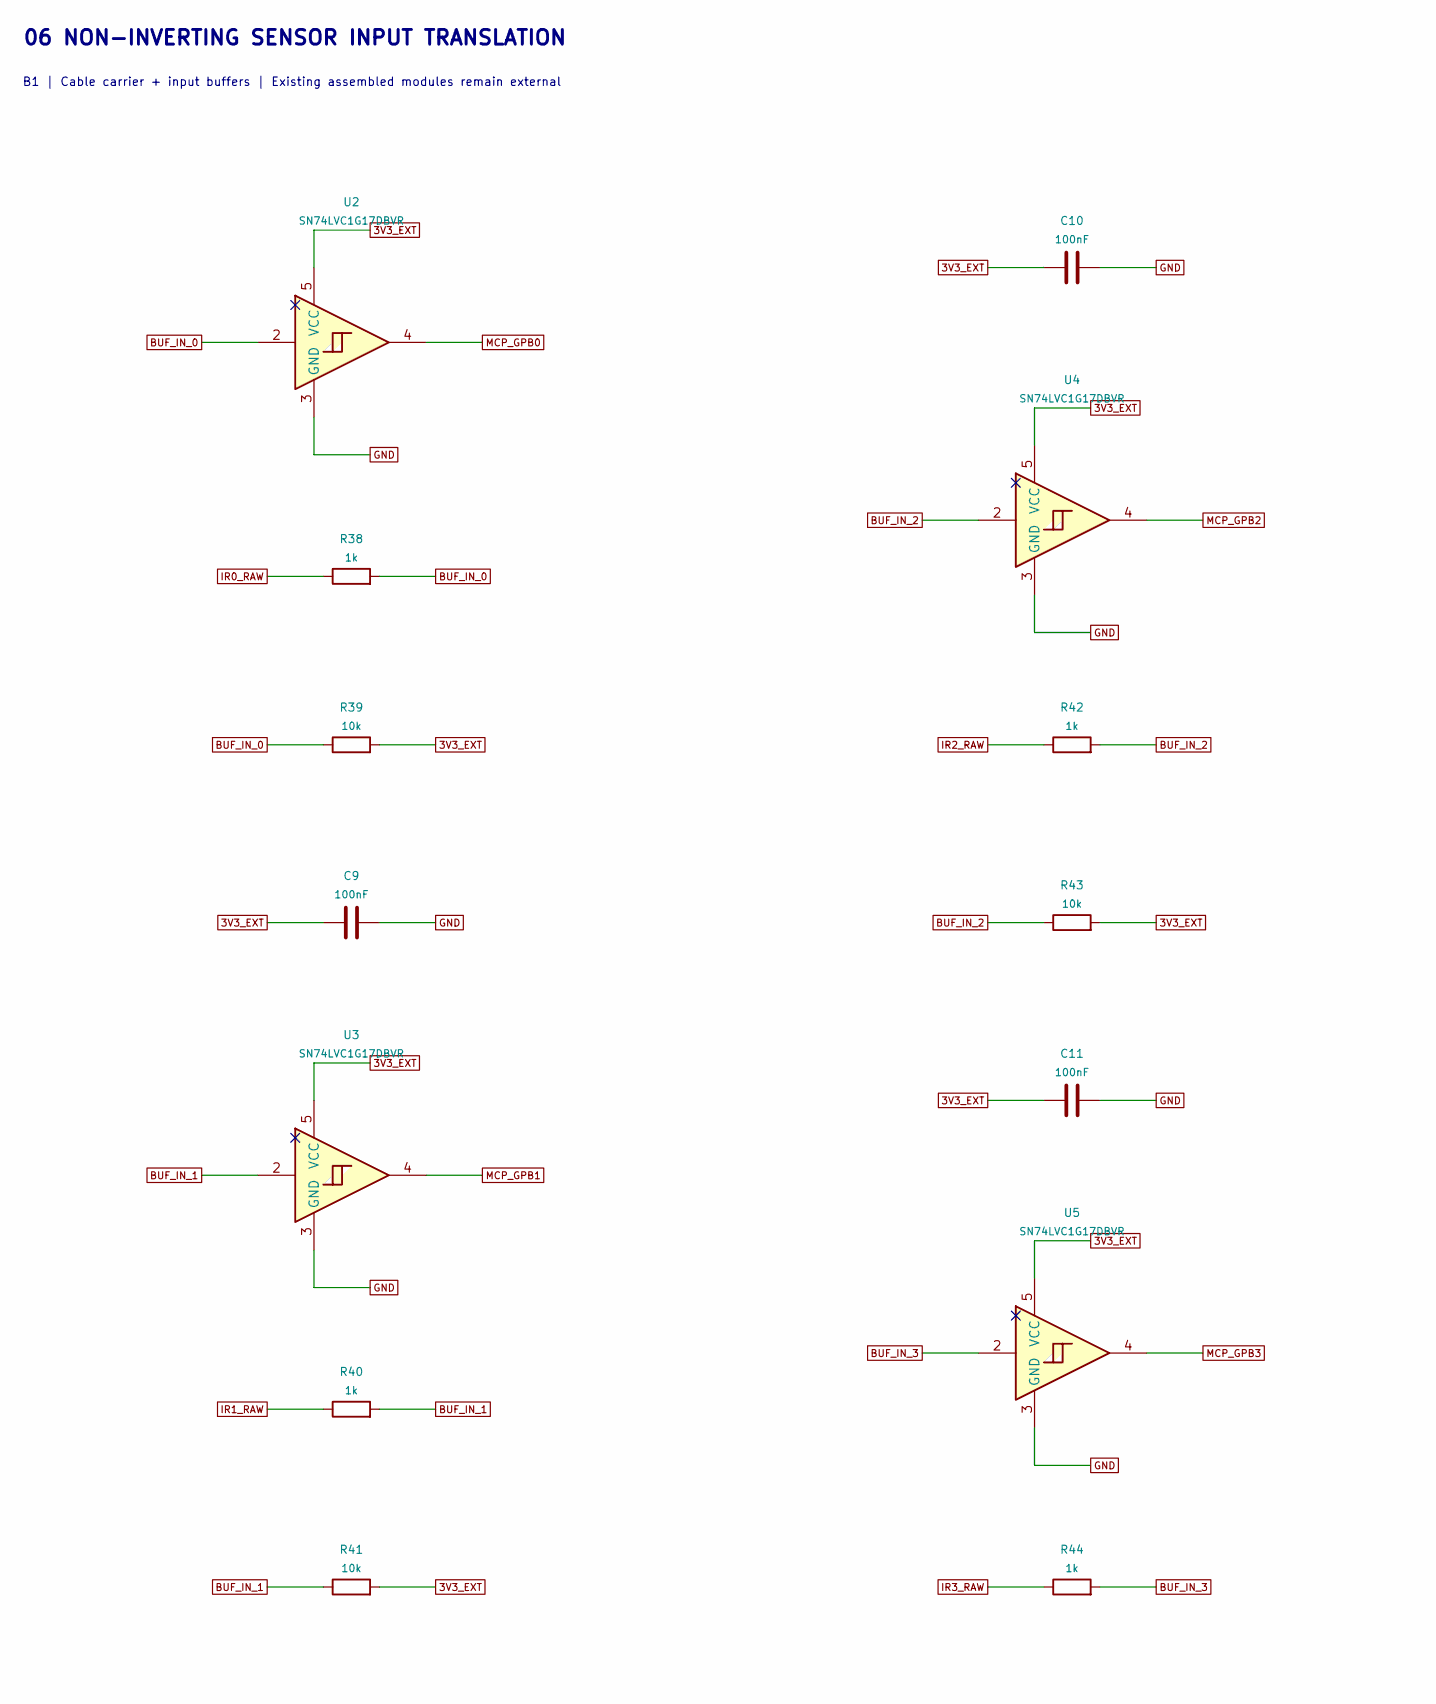
[picture p388: schematic SmartBin_B_06_01.kicad_sch, SmartBin B / 06 Non-inverting sensor input translation, part in row 1, column 1]

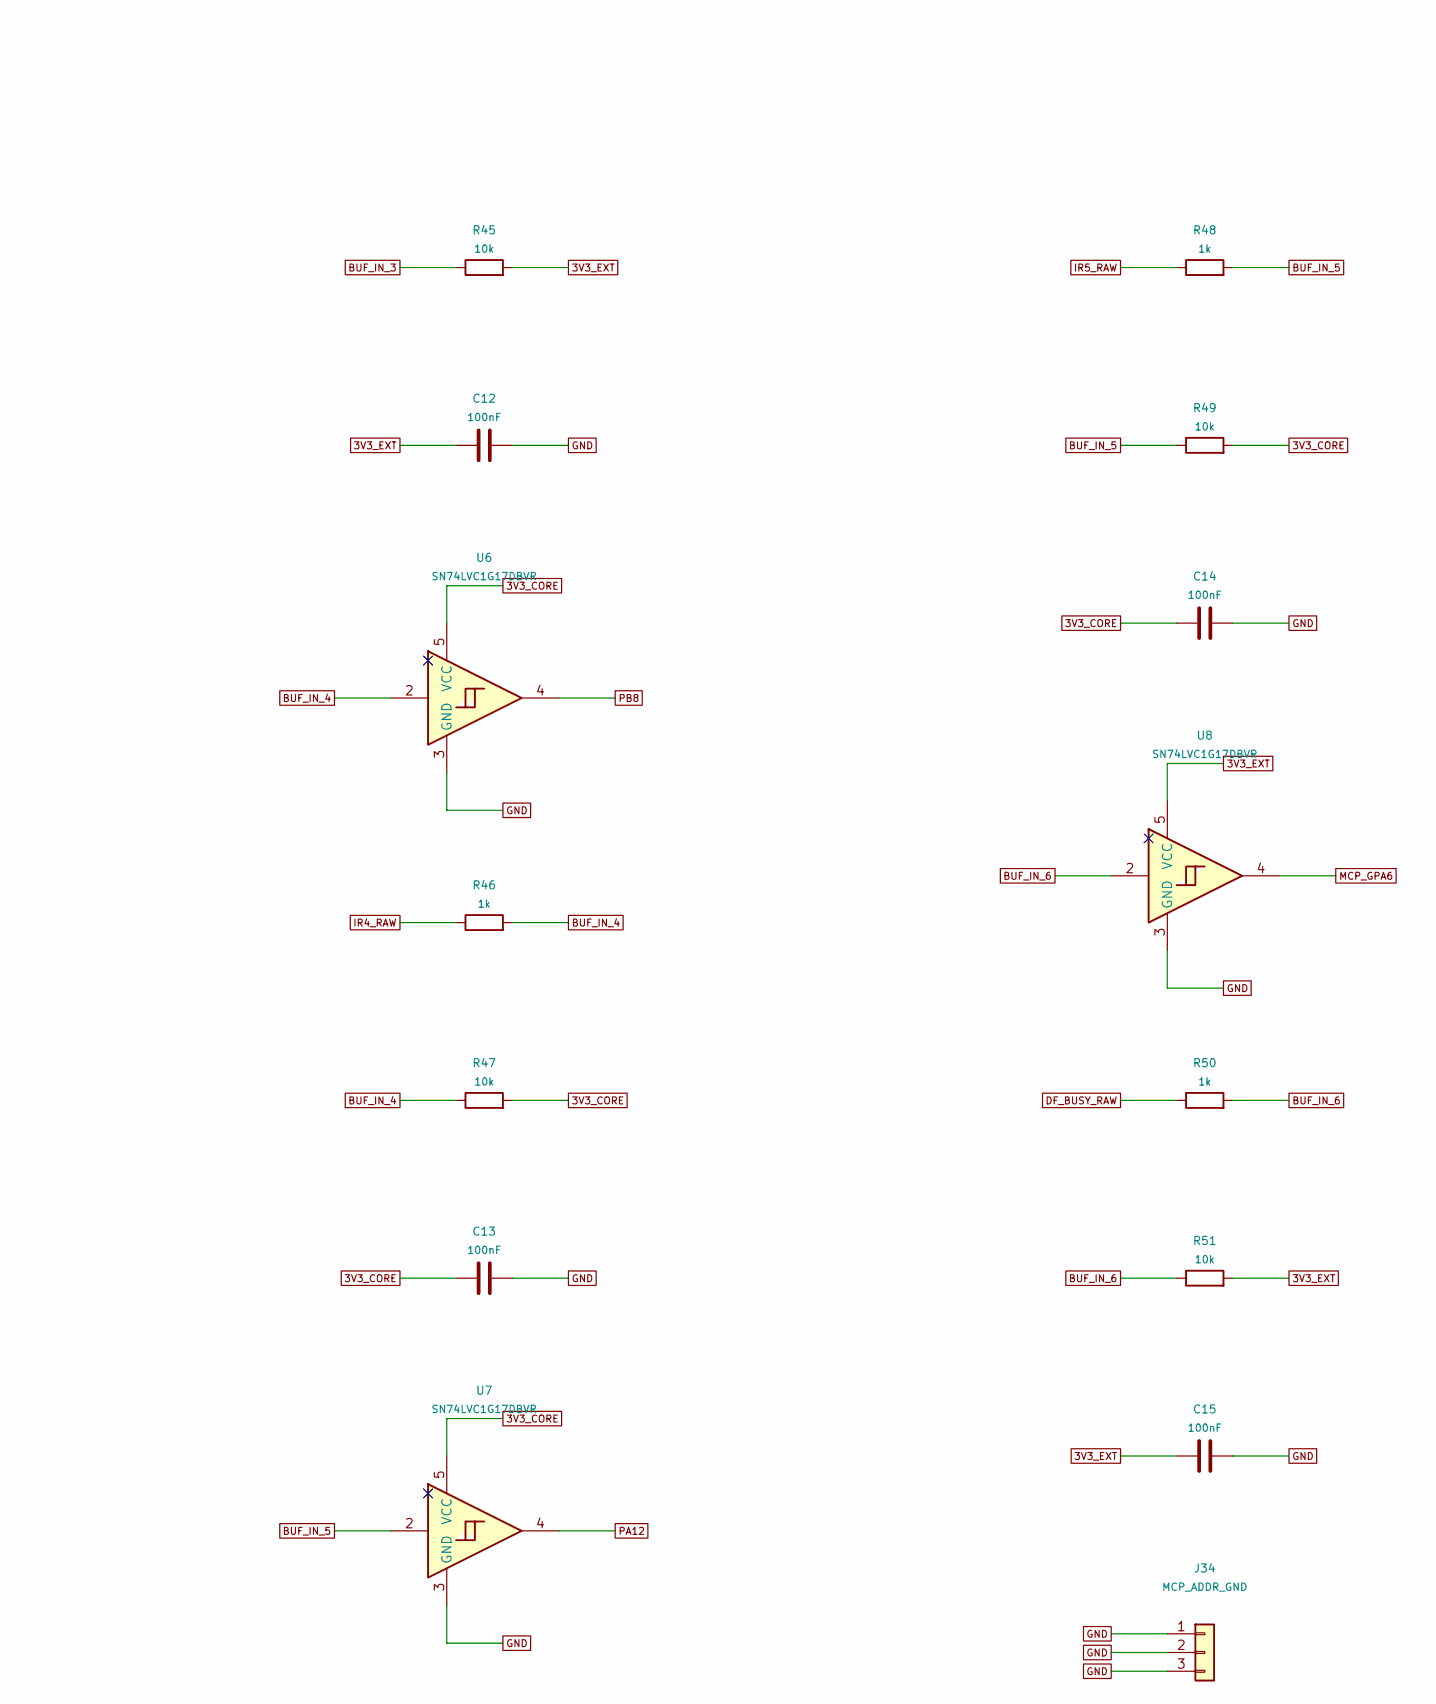
[picture p389: schematic SmartBin_B_06_01.kicad_sch, SmartBin B / 06 Non-inverting sensor input translation, part in row 1, column 2]

Parts:
C9, C10, C11, C12, C13, C14, C15: 100nF; C_0805_2012Metric
J34: MCP_ADDR_GND; PinHeader_1x03_P2.54mm_Vertical
R38, R40, R42, R44, R46, R48, R50: 1k; R_0805_2012Metric
R39, R41, R43, R45, R47, R49, R51: 10k; R_0805_2012Metric
U2, U3, U4, U5, U6, U7, U8: SN74LVC1G17DBVR; SOT-23-5; MPN SN74LVC1G17DBVR

Connections:
3V3_CORE: C13.1, C14.1, R47.2, R49.2, U6.5 (VCC), U7.5 (VCC); also elsewhere on the board
3V3_EXT: C9.1, C10.1, C11.1, C12.1, C15.1, R39.2, R41.2, R43.2, R45.2, R51.2, U2.5 (VCC), U3.5 (VCC), U4.5 (VCC), U5.5 (VCC), U8.5 (VCC); also elsewhere on the board
BUF_IN_0: R38.2, R39.1, U2.2
BUF_IN_1: R40.2, R41.1, U3.2
BUF_IN_2: R42.2, R43.1, U4.2
BUF_IN_3: R44.2, R45.1, U5.2
BUF_IN_4: R46.2, R47.1, U6.2
BUF_IN_5: R48.2, R49.1, U7.2
BUF_IN_6: R50.2, R51.1, U8.2
DF_BUSY_RAW: R50.1; also elsewhere on the board
GND: C9.2, C10.2, C11.2, C12.2, C13.2, C14.2, C15.2, J34.1, J34.2, J34.3, U2.3 (GND), U3.3 (GND), U4.3 (GND), U5.3 (GND), U6.3 (GND), U7.3 (GND), U8.3 (GND); also elsewhere on the board
IR0_RAW: R38.1; also elsewhere on the board
IR1_RAW: R40.1; also elsewhere on the board
IR2_RAW: R42.1; also elsewhere on the board
IR3_RAW: R44.1; also elsewhere on the board
IR4_RAW: R46.1; also elsewhere on the board
IR5_RAW: R48.1; also elsewhere on the board
MCP_GPA6: U8.4; also elsewhere on the board
MCP_GPB0: U2.4; also elsewhere on the board
MCP_GPB1: U3.4; also elsewhere on the board
MCP_GPB2: U4.4; also elsewhere on the board
MCP_GPB3: U5.4; also elsewhere on the board
PA12: U7.4; also elsewhere on the board
PB8: U6.4; also elsewhere on the board

Notes on the sheet:
06 NON-INVERTING SENSOR INPUT TRANSLATION
B1 | Cable carrier + input buffers | Existing assembled modules remain external

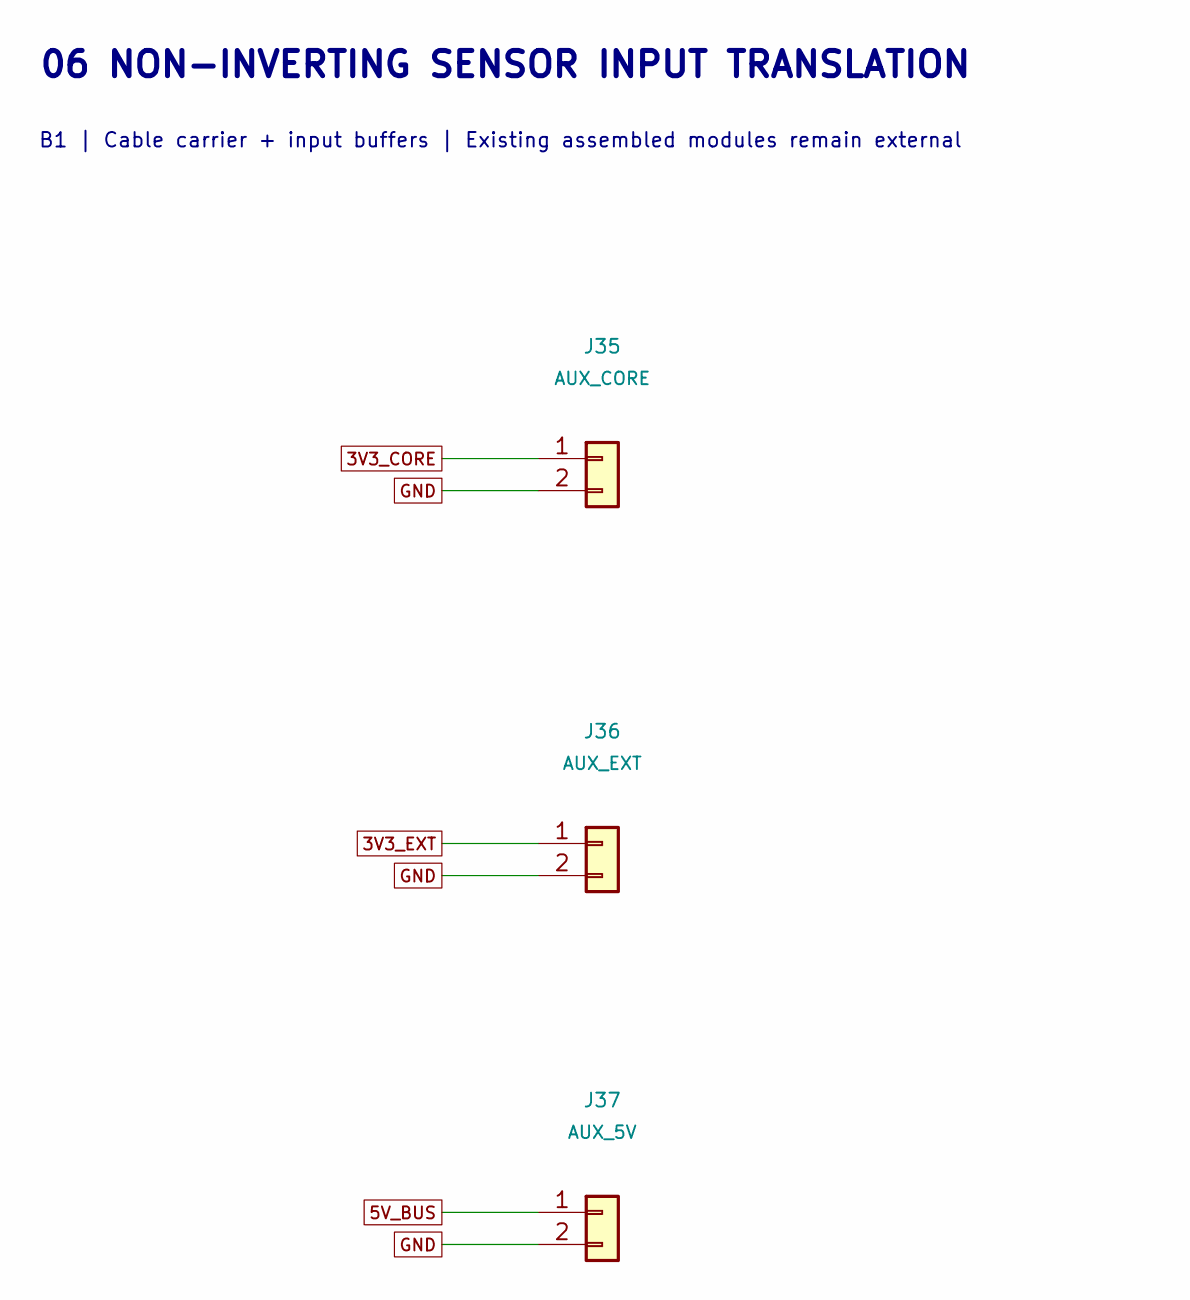
[picture p390: schematic SmartBin_B_06_02.kicad_sch, SmartBin B / 06 Non-inverting sensor input translation]

Parts:
J35: AUX_CORE; PinHeader_1x02_P2.54mm_Vertical
J36: AUX_EXT; PinHeader_1x02_P2.54mm_Vertical
J37: AUX_5V; PinHeader_1x02_P2.54mm_Vertical

Connections:
3V3_CORE: J35.1; also elsewhere on the board
3V3_EXT: J36.1; also elsewhere on the board
5V_BUS: J37.1; also elsewhere on the board
GND: J35.2, J36.2, J37.2; also elsewhere on the board

Notes on the sheet:
06 NON-INVERTING SENSOR INPUT TRANSLATION
B1 | Cable carrier + input buffers | Existing assembled modules remain external

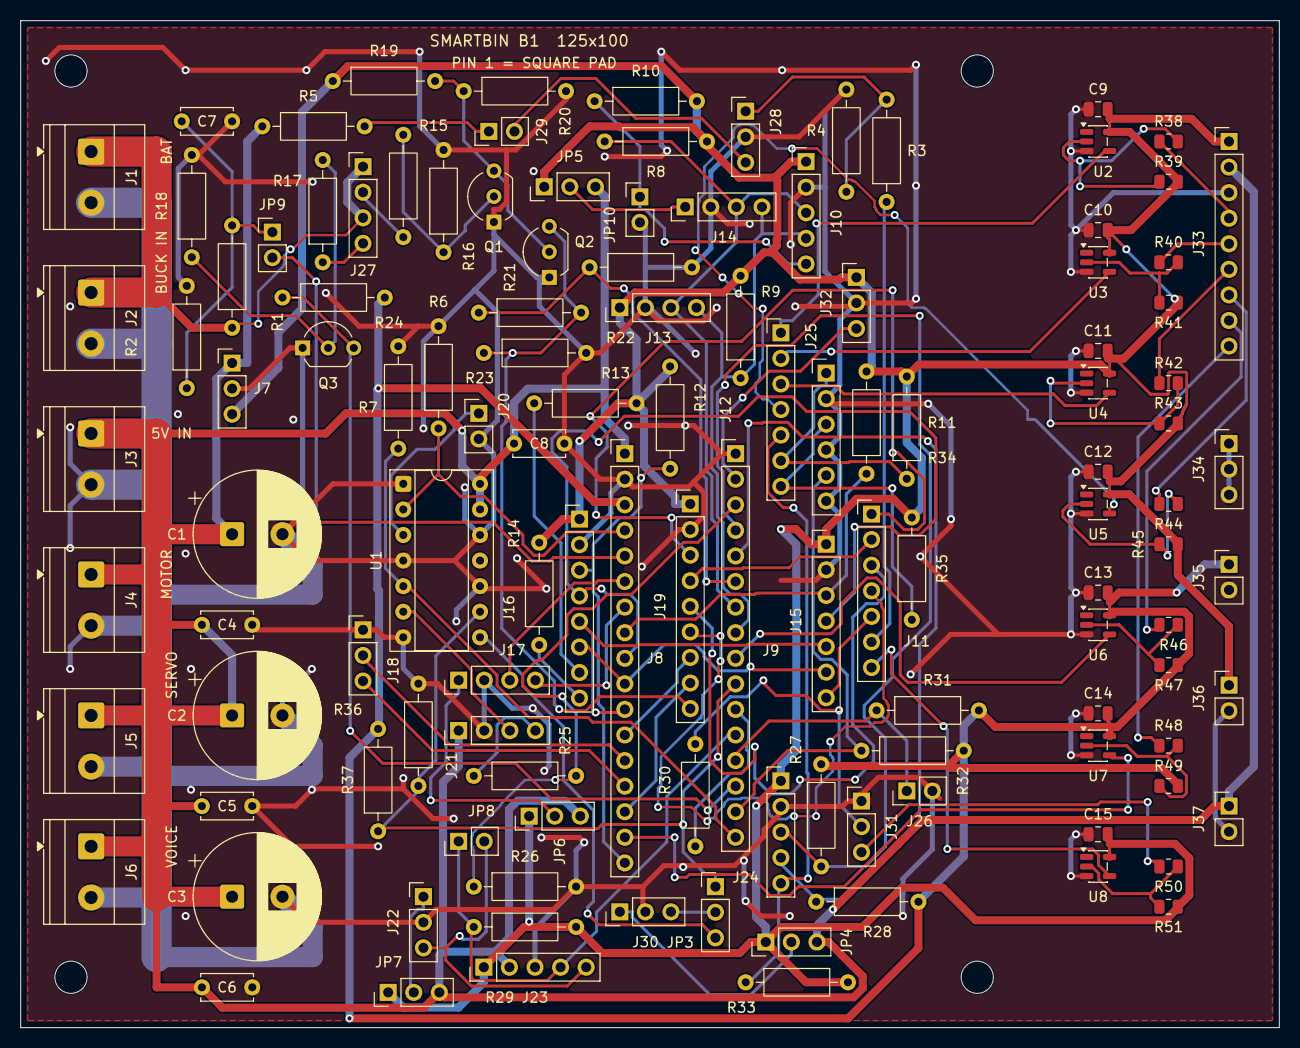
[picture p391: board SmartBin_B.kicad_pcb from above]

Board: 2 copper layers, 125.0 x 100.0 mm, 126 parts (0 on the bottom side), 86 nets.
