Sylphiette666/stm32-rfid-smart-bin/docs/manual/illustrated-source/build_electrical_figures.py

from pathlib import Path
import json, math
from diagram_common import Diagram, ROOT, INK, MUTED, BLUE, RED, GREEN, ORANGE, GREY, manifest

items=[]
paras=[x.split('\t',2)[-1] for x in (ROOT/'original_paragraphs.txt').read_text(encoding='utf-8').splitlines()]
def anchor(fragment):
    hits=[x for x in paras if fragment in x and x.startswith('步骤 ')]
    assert len(hits)==1,(fragment,hits)
    return hits[0]
def finish(d,name,fragment,caption,alt):
    d.save(name)
    items.append(dict(id=name,file='figures/'+name+'.png',anchor=anchor(fragment),position='before',caption=caption,alt=alt))
def txt(d,x,y,s,size=32,color=INK,bold=False):d.text((x,y),s,size,color,bold)
def note(d,s):txt(d,40,d.h-58,s,32,MUTED)
def box(d,x0,y0,x1,y1,title,fill='#F4F7F9'):
    d.rect((x0,y0,x1,y1),fill,INK,3,10);txt(d,x0+20,y0+15,title,36,INK,True)
def dot(d,x,y,color=INK):d.circle((x,y),7,color)
def terminal(d,x,y,label,side='left',color=INK):
    d.circle((x,y),7,'white',color,3)
    if side=='left':txt(d,x+17,y-62 if label in ('C','E','3 / D','2 / S') else y-23,label,32,color)
    else:txt(d,x-17,y-23,label,32,color); # use explicit text when right aligned needed
def gnd(d,x,y,label='GND'):
    d.line([(x,y),(x,y+15)],INK,3)
    for w,dy in [(24,15),(16,23),(8,31)]:d.line([(x-w,y+dy),(x+w,y+dy)],INK,3)
    if label:txt(d,x+35,y+3,label,32,MUTED)
def rh(d,x0,x1,y,label,color=INK):
    cx=(x0+x1)/2; hw=44
    d.line([(x0,y),(cx-hw,y)],color,4);d.rect((cx-hw,y-15,cx+hw,y+15),'white',color,3);d.line([(cx+hw,y),(x1,y)],color,4)
    txt(d,cx-50,y-62,label,32,color)
def rv(d,x,y0,y1,label,color=INK,side='right'):
    cy=(y0+y1)/2
    d.line([(x,y0),(x,cy-36)],color,4);d.rect((x-15,cy-36,x+15,cy+36),'white',color,3);d.line([(x,cy+36),(x,y1)],color,4)
    txt(d,x+28 if side=='right' else x-150,cy-25,label,32,color)
def cross(d,x,y,r=13):
    d.line([(x-r,y-r),(x+r,y+r)],RED,5);d.line([(x-r,y+r),(x+r,y-r)],RED,5)
def sw(d,x,y,label,closed=False):
    d.circle((x,y),6,'white',INK,3);d.circle((x+80,y),6,'white',INK,3)
    d.line([(x,y),(x+70,y if closed else y-35)],INK,4)
    txt(d,x+1,y-84,label,32,INK,True)

# 1. SWD and crossed UART are independent interfaces.
d=Diagram('电气图 1｜先接 SWD，再接外置 USB 串口',h=900)
txt(d,40,88,'核心板独立供电；按端子名称接线，下载器的 VCC 输出不能充当 VTref 输入。')
box(d,40,170,380,650,'SWD 下载器')
box(d,620,170,910,650,'STM32 核心板')
for y,l,r,col in [(285,'SWDIO','PA13',BLUE),(375,'SWCLK','PA14',GREEN),(465,'GND','GND',INK),(555,'NRST（可选）','NRST',ORANGE)]:
    txt(d,60,y-23,l);txt(d,645,y-23,r);d.circle((380,y),6,col);d.circle((620,y),6,col);d.arrow([(390,y),(610,y)],col,5)
txt(d,58,665,'有 VTref 输入才接核心 3V3',32,ORANGE)
txt(d,58,710,'无此端子：不增加供电连线',32,MUTED)
box(d,1010,170,1280,650,'USB 串口')
box(d,1510,170,1770,650,'STM32')
for y,l,r in [(285,'TXD','PA9 / TX'),(395,'RXD','PA10 / RX'),(505,'GND','GND')]:
    txt(d,1030,y-23,l);txt(d,1530,y-23,r);d.circle((1280,y),6,INK);d.circle((1510,y),6,INK)
d.arrow([(1288,285),(1502,395)],BLUE,5)
d.arrow([(1502,285),(1288,395)],GREEN,5)
d.line([(1288,505),(1502,505)],INK,5)
txt(d,1290,425,'交叉无连接点',32,MUTED)
txt(d,1030,575,'VCC / 3V3');cross(d,1330,590);txt(d,1380,570,'不接',34,RED,True)
txt(d,1020,675,'串口 TX 高电平先测约 3.3 V',32,BLUE)
txt(d,1020,720,'115200 / 8N1；只接三根线',32,MUTED)
txt(d,60,787,'核心 USB 插口不接线：PA11 / PA12 已用于本课设；仅保留 SWD，关闭 JTAG。',32,ORANGE)
note(d,'通过：能读芯片 ID；串口看到完整文字；两路设备没有向核心电源倒灌。')
finish(d,'e01_swd_uart','E015 连接 SWD 下载器','按图逐线接 SWD 与交叉串口；芯片 ID 可读、115200 文本完整后通过。','SWDIO接PA13，SWCLK接PA14，GND共地，可选NRST；USB串口TXD接PA10、RXD接PA9；串口供电脚不接，SWD有独立VTref输入时按说明接核心3V3。')

# 2. The I2C signal buses share wires, never regulator outputs.
d=Diagram('电气图 2｜I²C 共用两根信号线，供电逐板核对',h=900)
txt(d,40,88,'● 表示连接；无圆点交叉不相连。SCL / SDA 空闲必须约 3.3 V，不得上拉到 5 V。')
box(d,40,180,350,470,'STM32')
txt(d,70,280,'PB6 / SCL');txt(d,70,385,'PB7 / SDA')
box(d,640,180,930,455,'OLED')
txt(d,660,247,'VCC ← 3V3_EXT');txt(d,660,295,'GND → 公共地')
box(d,1010,180,1320,455,'MCP23017')
txt(d,1030,247,'VDD ← 3V3_EXT');txt(d,1030,295,'A0/A1/A2 → GND')
box(d,1400,180,1760,455,'MPU6050 模块')
txt(d,1420,247,'VIN 按原板核对');txt(d,1420,295,'5 V 或确认的3V3');txt(d,1420,343,'AD0 → GND')
for xa,xb in [(700,840),(1070,1230),(1460,1660)]:
    txt(d,xa-23,410,'SCL');txt(d,xb-38,410,'SDA')
    d.line([(xa,455),(xa,530)],BLUE,5);dot(d,xa,530,BLUE)
    d.line([(xb,455),(xb,630)],GREEN,5);dot(d,xb,630,GREEN)
d.line([(350,305),(430,305),(430,530),(1730,530)],BLUE,5)
d.line([(350,410),(380,410),(380,630),(1730,630)],GREEN,5)
txt(d,110,515,'SCL 总线',34,BLUE,True);txt(d,110,612,'SDA 总线',34,GREEN,True)
d.line([(490,770),(1050,770)],RED,5);txt(d,1110,747,'3V3_EXT',36,RED,True)
for x,y,col in [(580,530,BLUE),(950,630,GREEN)]:
    dot(d,x,y,col);d.line([(x,y),(x,670)],col,4);rv(d,x,670,770,'4.7 kΩ');dot(d,x,770,RED)
txt(d,90,700,'有效上拉各一组',32,ORANGE)
txt(d,90,746,'已装的须计入并联',32,ORANGE)
note(d,'所有 GND 共地；3V3_CORE 与 3V3_EXT 不并联。MCP RESET 用 10 kΩ 拉 EXT，不并核心 NRST。')
finish(d,'e02_i2c','E019 组装 I²C 主干','接好两根共享总线并核对上拉，逐块扫描 MCP、OLED 与 MPU，空闲约3.3 V。','PB6和PB7分别为共享SCL和SDA，每线有效4.7千欧上拉EXT3.3V；MPU模块供电依其稳压路径决定；两个稳压输出不并接。')

# 3. SPI fanout with independent CS.
d=Diagram('电气图 3｜SPI 三线共享，两个片选单独接',h=900)
txt(d,40,88,'RC522 的 SDA / SS 是 SPI 片选，不接 I²C 的 PB7。仅同时选择一个器件。')
box(d,40,180,400,760,'STM32 / SPI1')
box(d,1090,175,1760,440,'RC522　3.3 V 模块')
box(d,1090,500,1760,815,'已确认的 3.3 V SPI NOR')
cols=[(510,310,600,'PA5','SCK','CLK',BLUE),(590,360,650,'PA6','MISO','DO / SO',GREEN),(670,410,700,'PA7','MOSI','DI / SI',ORANGE)]
for x,yt,yb,lp,r1,r2,col in cols:
    txt(d,80,yt-23,lp,34,col,True);d.line([(400,yt),(1090,yt)],col,5)
    d.line([(x,yt),(x,yb),(1090,yb)],col,5);dot(d,x,yt,col)
    txt(d,1110,yt-23,r1,32,col);txt(d,1110,yb-23,r2,32,col)
txt(d,80,230,'PA4 / CS1',34,RED,True);d.arrow([(400,250),(1080,250)],RED,5)
txt(d,1110,227,'SDA / SS（片选）',34,RED,True)
txt(d,80,699,'PA15 / CS2',34,RED,True);d.arrow([(400,720),(920,720),(920,770),(1080,770)],RED,5)
txt(d,1110,747,'CS#（片选）',34,RED,True)
txt(d,1380,288,'RST ← GPA4',32);txt(d,1380,340,'IRQ 留空',32)
txt(d,715,155,'各 CS：10 kΩ 上拉',32,RED);txt(d,715,202,'至 3V3_EXT',32,RED)
txt(d,715,445,'PA15 须释放 JTAG',32,MUTED)
txt(d,715,490,'PA13/14 仍保留 SWD',32,MUTED)
txt(d,1370,595,'WP# / HOLD#',32)
txt(d,1370,645,'若引出：按手册',32)
txt(d,1370,695,'各 10 kΩ 上拉',32)
txt(d,80,487,'事务结束：',34,INK,True);txt(d,80,540,'两 CS 均为高',34,RED,True)
note(d,'两模块 VCC → 3V3_EXT，GND 共地；先分别读 ID，再共享运行 100 次且无总线错误。')
finish(d,'e03_spi','E028 焊 RC522 排针和线束','三根 SPI 信号并接，PA4与PA15独立片选；分别读ID后再交替读100次。','SCK、MISO、MOSI接PA5、PA6、PA7并共享；RC522 SDA接PA4，FLASH CS接PA15，各10k上拉3V3_EXT，RC522 RST接MCP GPA4。')

# 4. Two unidirectional paths shown as actual nodes.
d=Diagram('电气图 4｜超声 TRIG 升到 5 V，ECHO 分压回 3.3 V',h=900)
txt(d,40,88,'只在 ECHO 使用 12 kΩ / 20 kΩ 分压；TRIG 走 AHCT 缓冲，不旁路。')
box(d,50,265,345,475,'STM32')
txt(d,70,359,'PB15 / TRIG',34,BLUE,True)
box(d,620,230,1130,455,'SN74AHCT125N 通道 2')
txt(d,650,322,'5脚 A2');txt(d,922,322,'6脚 Y2')
d.arrow([(345,350),(610,350)],BLUE,5);d.arrow([(1140,350),(1420,350)],BLUE,5)
box(d,1430,235,1770,700,'HC-SR04')
txt(d,1460,315,'TRIG',34,BLUE,True);txt(d,1460,573,'ECHO',34,GREEN,True)
txt(d,1460,405,'VCC ← 5V_LOGIC',32,RED);txt(d,1460,457,'GND → 公共地',32)
d.line([(830,190),(830,230)],RED,4);txt(d,690,145,'14脚 ← 5V_LOGIC',32,RED)
d.line([(835,455),(835,490)],INK,4);gnd(d,835,490);txt(d,950,470,'7脚、4脚/OE2',32)
dot(d,460,350,BLUE);rv(d,460,350,510,'10 kΩ');gnd(d,460,510)
txt(d,620,553,'14脚与7脚附近并 100 nF',32,MUTED)
box(d,50,615,345,755,'PB1 / ECHO\n输入')
d.arrow([(800,670),(355,670)],GREEN,5)
rh(d,800,1315,670,'12 kΩ',GREEN);d.line([(1315,670),(1380,670),(1380,595),(1430,595)],GREEN,5)
dot(d,800,670,GREEN);rv(d,800,670,788,'20 kΩ');gnd(d,800,788)
txt(d,950,728,'5 V × 20 / (12+20) = 3.125 V',32,GREEN,True)
txt(d,62,777,'两电阻靠近 IO 输入焊接',32,MUTED)
note(d,'通过：PB15 → 6脚输出约 0/5 V；ECHO 高时 PB1 节点理论 3.125 V，波形清楚且不超过允许电压。')
finish(d,'e04_ultrasonic','E071 焊ECHO分压','照节点焊12k/20k分压，并核对AHCT通道2方向；先测电平再连接PB1。','PB15进入AHCT125的5脚，6脚输出到TRIG，14脚5V、7和4脚地；ECHO串12k到PB1节点，节点20k到地。')

# 5a. Contact group identification and lid switch wiring.
d=Diagram('电气图 5A｜先认开关内部连通组，再接输入与地',h=900)
txt(d,40,88,'四脚轻触图为“实测分组”示意，不保证与你的封装朝向相同；断电后用导通档确认。')
box(d,40,160,860,780,'MODE / BACK：每只开关跨两组接')
d.rect((245,330,605,615),'#E7ECF0',INK,4,15)
for x in [220,630]:
    d.line([(x,360),(x,570)],INK,6);dot(d,x,360);dot(d,x,570)
d.line([(220,360),(330,360),(330,448)],INK,4)
sw(d,330,448,'',False);d.line([(410,448),(525,448),(525,360),(630,360)],INK,4);txt(d,330,497,'按下才连通',32,INK,True)
txt(d,140,290,'A1');txt(d,140,567,'A2');txt(d,650,290,'B1');txt(d,650,567,'B2')
txt(d,260,629,'A1–A2 常通；B1–B2 常通',32)
d.line([(220,360),(135,360),(135,700)],INK,4);gnd(d,135,700)
d.line([(630,360),(760,360),(760,245)],BLUE,4);txt(d,370,225,'GPB5：MODE / GPB6：BACK',32,BLUE)
txt(d,280,700,'输入 10 kΩ 上拉 3V3_EXT',32,RED)
box(d,930,160,1760,780,'闭盖微动：COM 与 NO 两端')
txt(d,1450,245,'3V3_CORE',34,RED,True)
rv(d,1490,290,435,'10 kΩ',RED)
d.line([(1490,435),(1660,435)],BLUE,5);dot(d,1490,435);txt(d,1580,380,'PB14',34,BLUE,True)
sw(d,1140,435,'盖闭合后压下',False)
d.line([(1220,435),(1490,435)],INK,4);txt(d,1240,455,'NO',32)
d.line([(1140,435),(1030,435),(1030,560)],INK,4);gnd(d,1030,560);txt(d,1030,380,'COM',32)
txt(d,1080,634,'盖关：PB14=0',36,GREEN,True)
txt(d,1080,693,'盖开 / 断线：PB14=1',36,ORANGE,True)
note(d,'通过：按键每按一次只有一个事件；闭盖输入随机械开关可靠变化，不能靠放宽软件判断代替定位。')
finish(d,'e05a_switches','E039 接 MODE 和 BACK','轻触开关先测两组常通脚，再跨组接；闭盖微动接COM和NO并确认闭盖为0。','轻触开关跨实测A组B组连接，一端地一端MCP输入上拉EXT；闭盖微动COM接地NO接PB14，10k上拉CORE。')

# 5b. Three encoder signals each retain the correct pull-up rail.
d=Diagram('电气图 5B｜旋转编码器：CLK、DT、SW 三路分别接',h=900)
txt(d,40,88,'确认模块支持 3.3 V。已经存在的板载上拉先测清，不能与不同稳压输出重复并拉。')
box(d,60,180,570,735,'现有旋转编码器模块')
for y,label,col in [(280,'VCC',RED),(370,'GND',INK),(475,'CLK',BLUE),(580,'DT',GREEN),(680,'SW',ORANGE)]:
    txt(d,350,y-25,label,36,col,True);d.circle((570,y),7,col)
d.line([(570,280),(720,280)],RED,5);txt(d,740,255,'3V3_EXT',36,RED,True)
d.line([(570,370),(690,370)],INK,5);gnd(d,690,370)
for y,label,col in [(475,'PB3',BLUE),(580,'PB4',GREEN),(680,'GPB4',ORANGE)]:
    d.arrow([(580,y),(1640,y)],col,5);txt(d,1660,y-25,label,32,col,True)
rv(d,1090,280,420,'10 kΩ',RED);d.line([(1090,420),(1090,475)],RED,4);txt(d,995,227,'3V3_CORE',32,RED);dot(d,1090,475,BLUE)
rv(d,1320,280,420,'10 kΩ',RED);d.line([(1320,420),(1320,580)],RED,4);txt(d,1240,227,'3V3_CORE',32,RED);dot(d,1320,580,GREEN)
rv(d,1540,280,420,'10 kΩ',RED);d.line([(1540,420),(1540,680)],RED,4);txt(d,1480,227,'3V3_EXT',32,RED);dot(d,1540,680,ORANGE)
txt(d,1630,723,'MCP 端口',32,ORANGE)
txt(d,85,787,'旋转：CLK / DT 交替变化；按下：SW=0，释放：SW=1。软件按状态转移去抖。',34)
note(d,'通过：顺转一格只走下一项，逆转回上一项；PB3/PB4 先释放 JTAG，PA13/14 仍为 SWD。')
finish(d,'e05b_encoder','E037 接旋转编码器','按三路信号与正确的上拉电源接编码器，旋转和按下分别单测。','编码器VCC接EXT，GND共地，CLK接PB3、DT接PB4各10k上拉CORE，SW接MCP GPB4并10k上拉EXT。')

# 6a. NPN logical B/C/E terminals, not TO-92 physical pin order.
d=Diagram('电气图 6A｜急停 NC1：两管把 STBY 硬件钳低',h=900)
txt(d,40,88,'本图只画 B/C/E 逻辑端子，实际封装脚序查厂商资料；所有地共地，电池正极不接 GPIO。')
txt(d,50,156,'VBAT_SW',34,RED,True);txt(d,50,210,'6.0–8.4 V',32,RED)
d.line([(100,280),(230,280)],RED,5);sw(d,230,280,'NC1',True)
rh(d,310,545,280,'4.7 kΩ',RED)
box(d,580,225,790,435,'QES1')
txt(d,600,293,'NPN');terminal(d,580,355,'B');terminal(d,790,280,'C');terminal(d,685,435,'E')
d.line([(545,280),(545,355),(580,355)],RED,4);dot(d,545,355)
rv(d,470,355,575,'100 kΩ',side='left');d.line([(470,355),(545,355)],INK,4);gnd(d,470,575)
d.line([(685,435),(685,575)],INK,4);gnd(d,685,575)
d.line([(790,280),(970,280),(970,370),(1070,370)],BLUE,5);dot(d,970,280,BLUE)
txt(d,807,322,'KILL_BASE',32,BLUE)
txt(d,805,150,'3V3_EXT',34,RED,True);rv(d,880,200,280,'4.7 kΩ',RED);d.line([(880,280),(970,280)],BLUE,4);dot(d,880,280,BLUE)
box(d,1070,295,1290,495,'QES2')
terminal(d,1070,370,'B');terminal(d,1290,350,'C');terminal(d,1180,495,'E')
rv(d,970,370,575,'100 kΩ',side='left');dot(d,970,370,BLUE);gnd(d,970,575)
d.line([(1180,495),(1180,575)],INK,4);gnd(d,1180,575,'')
d.line([(1290,350),(1470,350),(1470,205),(1760,205)],BLUE,5)
dot(d,1470,350,BLUE);txt(d,1510,147,'STBY_OUT',34,BLUE,True)
txt(d,1490,249,'→ TB6612 STBY',32,BLUE)
txt(d,1300,450,'PB5',36,BLUE,True);rh(d,1430,1725,510,'1 kΩ',BLUE)
d.line([(1725,510),(1750,510),(1750,205)],BLUE,5);dot(d,1750,205,BLUE)
rv(d,1470,350,440,'10 kΩ',side='right');gnd(d,1470,440,'')
rv(d,1370,545,655,'10 kΩ',side='left');d.line([(1370,510),(1430,510)],BLUE,4);d.line([(1370,510),(1370,545)],BLUE,4);dot(d,1370,510,BLUE);gnd(d,1370,655)
txt(d,65,739,'NC1 闭合 → QES1 导通 → QES2 截止 → STBY 跟随 PB5；断开 → QES2 导通 → STBY 低。',32,GREEN)
note(d,'先不接电机：按住急停，并让测试程序 PB5=1，STBY_OUT 仍必须 <0.3 V。')
finish(d,'e06a_estop_clamp','E045 焊NC1和钳位节点','按逻辑节点焊NC1两管钳位，按住急停且PB5强制高时，STBY必须低于0.3V。','VBAT经NC1和4.7k到QES1基极；QES1集电极连QES2基极，上拉4.7k到EXT；QES2集电极钳STBY。PB5串1k到STBY，各自10k下拉，两管基极各100k下拉。')

# 6b. Third transistor feedback plus normal/pressed state and limits.
d=Diagram('电气图 6B｜急停 NC2：独立反馈，按下读到 1',h=900)
txt(d,40,88,'NC1 与 NC2 是同一按钮的两组独立常闭触点，不把两组触点并联。')
txt(d,60,210,'VBAT_SW',36,RED,True);txt(d,60,265,'6.0–8.4 V',32,RED)
d.line([(100,335),(215,335)],RED,5);sw(d,215,335,'NC2',True)
rh(d,295,615,335,'4.7 kΩ',RED)
box(d,780,250,1080,530,'QES3 / 2N3904')
terminal(d,780,395,'B');terminal(d,1080,335,'C');terminal(d,930,530,'E')
d.line([(615,335),(660,335),(660,395),(780,395)],RED,4);dot(d,660,395,RED)
rv(d,660,395,600,'100 kΩ',side='left');gnd(d,660,600)
d.line([(930,530),(930,600)],INK,4);gnd(d,930,600)
d.line([(1080,335),(1660,335)],BLUE,5);dot(d,1350,335,BLUE)
txt(d,1430,360,'PB13 / ESTOP_SENSE',32,BLUE,True)
txt(d,1215,160,'3V3_CORE',36,RED,True);rv(d,1350,225,335,'10 kΩ',RED)
txt(d,1195,465,'实测状态',36,INK,True)
txt(d,1195,517,'按钮释放：PB13 <0.3 V',32,GREEN)
txt(d,1195,573,'按下 / 断线：PB13 ≈3.3 V',32,ORANGE)
txt(d,50,710,'接口试验：6.0 / 7.4 / 8.4 V 三点；此时核心与 EXT 逻辑电源正常，电机和舵机拔下。',32)
txt(d,50,765,'复接 / 旋转释放后，软件保持故障锁，人工确认并收到新运动命令才恢复。',32)
note(d,'这是课设接口：没有独立复位安全继电器；硬件 STBY 待机仍可能滑行，不等于机械刹车。')
finish(d,'e06b_estop_sense','E046 焊NC2反馈','独立焊NC2与QES3，验证释放为0、按下或断线为1，并逐个模拟两回路线断开。','VBAT经NC2与4.7k接QES3基极，基极100k下拉，发射极接地，集电极到PB13并10k上拉CORE；按下反馈高。')

# 7. Separate power branches and real motor output pair.
d=Diagram('电气图 7｜电机先架空单轮试，舵机与轮电机分时运行',h=900)
txt(d,40,88,'以下仅适用于已核实的 TB6612FNG；VM 是电机电源，VCC 是 3.3 V 逻辑电源。')
box(d,45,155,445,745,'STM32 / MCP 控制')
box(d,660,155,1125,745,'TB6612 模块')
for y,left,right,col in [(300,'3V3_EXT','VCC',RED),(385,'GPA0 / GPA1','AIN1 / AIN2',BLUE),(470,'PA8 / PWM','PWMA',BLUE),(555,'急停 STBY_OUT','STBY',ORANGE),(680,'GND','GND',INK)]:
    txt(d,65,y-23,left,32,col);txt(d,680,y-23,right,32,col);d.arrow([(445,y),(650,y)],col,4)
txt(d,715,225,'VM ← 5V_MOTOR',32,RED,True)
txt(d,1350,156,'左减速电机 / 轮',36,INK,True)
d.circle((1510,325),110,'#E9EDF0',INK,5);d.circle((1510,325),42,'white',INK,4)
d.line([(1125,290),(1300,290),(1400,290)],RED,5);d.line([(1125,365),(1320,365),(1400,365)],INK,5)
txt(d,1140,242,'AO1');txt(d,1140,374,'AO2')
d.line([(1300,290),(1300,307)],INK,3);d.line([(1280,307),(1320,307)],INK,4);d.line([(1280,325),(1320,325)],INK,4);d.line([(1300,325),(1300,365)],INK,3)
txt(d,1200,415,'电机端跨 100 nF',32)
d.line([(1370,458),(1650,458)],MUTED,5);d.rect((1445,459,1575,485),'#D7DFE5',MUTED,3)
txt(d,1370,510,'两轮离地再上电',34,ORANGE,True)
txt(d,1370,560,'初测右轮先不接',32,MUTED)
box(d,1185,625,1760,805,'SG90：独立 5V_SERVO 支路')
txt(d,1205,686,'红线→5 V；棕/黑→GND',32)
txt(d,1205,737,'信号←AHCT 3脚 Y1（PA0）',32,BLUE)
txt(d,60,781,'右轮：BO1/BO2；方向GPA2/3；PWM=PA11。',32)
note(d,'先低 PWM 找起转；换向前 PWM=0、STBY=0、等100 ms。舵机运动时轮电机必须关闭；各支路共地。')
finish(d,'e07_motor_servo','E056 架空接单左电机','断电接左轮，架空后低PWM验证方向，再接右轮；SG90独立电源支路且运行互锁。','TB6612 VM接独立5V电机支路，VCC接EXT3.3V，控制与地共接；AO1AO2只到左电机，100nF跨端；舵机独立5V支路并通过AHCT接PA0。')

# 8. MOS low side with separate capacitor polarity panel.
d=Diagram('电气图 8｜AO3400A 低边灯开关；电解电容先认极性',h=900)
txt(d,40,88,'AO3400A 是裸场效应管：先焊 SOT-23→2.54 mm 转接板，再用通断档追踪端子。')
d.line([(730,200),(730,275)],RED,5);txt(d,640,154,'5V_LOGIC',36,RED,True)
rv(d,730,275,385,'220 Ω',RED)
d.line([(730,385),(730,414)],RED,4)
d.d.polygon([(703,415),(757,415),(730,460)],fill='#FFF7D1',outline=INK,width=3)
d.line([(700,462),(760,462)],INK,4);d.line([(730,462),(730,525)],INK,4)
d.arrow([(770,424),(813,394)],ORANGE,3,12);d.arrow([(779,451),(822,421)],ORANGE,3,12)
txt(d,850,401,'白 LED',34);txt(d,850,450,'正极在电阻侧',32)
box(d,565,525,865,700,'AO3400A')
terminal(d,565,625,'1 / G');terminal(d,730,525,'3 / D');terminal(d,730,700,'2 / S')
txt(d,50,170,'逻辑端子图；实际管脚按\n原厂 1G / 2S / 3D 追踪',32,MUTED)
rh(d,220,535,625,'100 Ω',BLUE);d.line([(535,625),(565,625)],BLUE,4);txt(d,50,590,'GPA5',34,BLUE,True)
dot(d,470,625,BLUE);rv(d,470,625,770,'100 kΩ',side='left');gnd(d,470,770)
d.line([(730,700),(730,770)],INK,4);gnd(d,730,770)
d.line([(1095,150),(1095,810)],GREY,3)
txt(d,1180,170,'电解电容并在电源与地之间',34,INK,True)
d.rect((1460,305,1700,595),'#DDE8F0',INK,4,25)
d.rect((1610,330,1680,575),'#F7F8FA',MUTED,2)
for y in [360,430,500]:txt(d,1622,y,'−',44,MUTED,True)
txt(d,1170,315,'长脚通常为 +',32,RED)
txt(d,1170,370,'仍须看实物标记',32,MUTED)
d.line([(1520,595),(1520,735),(1210,735)],RED,5)
d.line([(1650,595),(1650,705)],INK,5);gnd(d,1650,705)
txt(d,1140,765,'电源 +',34,RED,True)
txt(d,1668,618,'负极\n接地',32,INK,True)
txt(d,1175,230,'负极色条，不是正极',34,ORANGE,True)
note(d,'通过：G接地灯灭，G经100Ω接3.3V灯亮；电解负极接地。灯MOS不驱动舵机或轮电机。')
finish(d,'e08_mos_cap','E079 焊AO3400A转接板','按1G/2S/3D追踪转接板，焊栅极100Ω与100k下拉、LED串220Ω；电解色条端接地。','GPA5经100Ω到AO3400A栅极，栅极100k接地，源极接地，漏极接LED负端，LED正端经220Ω到5V；电解负极色条接地。')

manifest('electrical',items)
print(json.dumps(dict(figures=len(items),files=[x['file'] for x in items]),ensure_ascii=False))
