Sylphiette666/stm32-rfid-smart-bin/hardware/current-low-cost/pcb-a/source/package_fabrication.py

from pathlib import Path
import json,hashlib,zipfile
root=Path(__file__).resolve().parents[1];fab=root/'manufacturing'
names=['SmartBin_A-F_Cu.gtl','SmartBin_A-B_Cu.gbl','SmartBin_A-F_Mask.gts','SmartBin_A-B_Mask.gbs','SmartBin_A-F_Silkscreen.gto','SmartBin_A-B_Silkscreen.gbo','SmartBin_A-Edge_Cuts.gm1','SmartBin_A-PTH.drl','SmartBin_A-NPTH.drl']
d=json.loads((root/'checks/pcb-drc.json').read_text(encoding='utf-8'))
assert not d['violations'] and not d['unconnected_items'] and not d['schematic_parity']
with zipfile.ZipFile(fab/'Gerber_RS274X.zip','w',zipfile.ZIP_DEFLATED) as z:
 for n in names:
  data=(fab/n).read_bytes();assert data
  if not n.endswith('.drl'):assert b'%TF.' not in data and b'%TO.' not in data
  z.writestr(n,data)
with zipfile.ZipFile(fab/'Gerber_RS274X.zip') as z:assert z.testzip() is None and sorted(z.namelist())==sorted(names)
out={n:hashlib.sha256((fab/n).read_bytes()).hexdigest() for n in names+['Gerber_RS274X.zip']}
(fab/'fabrication-sha256.json').write_text(json.dumps(out,indent=2),encoding='utf-8')
print(json.dumps({'gerber_zip_files':len(names),'zip_sha256':out['Gerber_RS274X.zip']}))
