Sylphiette666/stm32-rfid-smart-bin/(commit log)

2026-10-10 Archive STM32 RFID smart bin design and assembly documentation
2026-10-10 Add finished prototype appearance concept and generation notes
2026-10-10 Add illustrated assembly and debugging manual
2026-10-12 Add low-cost A1 carrier PCB and update illustrated assembly manual
2026-10-12 Improve A1 ground stitching and add four-suite design review
2026-10-12 Add sensor module kit reference photo and encoder identification
2026-10-30 feat: add printable backup chassis and upper platform
2026-10-30 fix: print whole plates on P2S with upright diagonal base
2026-10-30 feat: add ribbed PLA lightweight whole plates with solid mounting zones
2026-10-30 feat: add adjustable servo fixtures and validated four-part P2S plate
2026-10-31 feat: add two-plate whole decks and reusable module mounts
2026-11-01 feat: add flat bolted chassis and fine accessory print project
2026-11-01 feat: distribute remaining print parts across four P2S printers
2026-11-01 fix: exclude running old second plate and split fine accessories across free printers
2026-11-01 feat: add D06 motor bracket dimensional fit coupons
2026-11-01 perf: add faster motor fit printing and single B coupon
2026-11-01 fix: reduce B motor fit coupon plate thickness to 3mm
2026-11-01 fix: remove text from motor fit coupon contact faces
2026-11-01 Add D06 motor adapter pair preserving verified 3mm fit
2026-11-01 Add finer 0.16mm motor adapter print profile
2026-11-02 Narrow motor adapter slot edges for wheel clearance trial
2026-11-02 Add single motor mount quick fit without changing other print profiles
2026-11-02 Apply identical quick fit settings to both motor mounts
2026-11-02 Reduce wheel-facing motor adapter edges by another 2 mm for fit trial
2026-11-02 Add four flat wall print jobs with removable component mounts and illustrated instructions
2026-11-02 Add fine 0.16 mm print profiles for four wall plates
2026-11-02 Add final fine print pair for confirmed motor adapter fit
2026-11-02 Add motor carriers that reuse existing chassis holes
2026-11-02 Add conservative ribbed lightening for motor carriers
2026-11-03 Add no-drill wall hold-down concept and manual previews
2026-11-03 Release fine P2S wall clamp and pad print project
2026-11-03 Repair sensor retainers for previously printed wall seats
2026-11-03 Add lightweight lid and hinge trial print projects
2026-11-03 Export fine 0.08mm PETG lid print projects
2026-11-03 Add lightweight tracker mount using existing chassis holes
2026-11-03 Add lightweight caster riser using existing A1 mounting holes
2026-11-03 Set nominal caster riser height to 41 mm from wheel stack
2026-11-03 Combine caster H41 and tracker mounts on one P2S plate
2026-11-03 Add B1 KiCad cable carrier with seven protected sensor inputs
2026-11-03 Integrate PLA chassis and bucket with verified P2S fine print projects
2026-11-04 Switch all three PLA fast candidates to 0.28 mm (panel r7); update manual ch69
2026-11-04 Add R3D PETG all-0.28 mm fast candidate (PLA version unchanged)
2026-11-05 Add caster height spacer H3/H4/H5 (R3D PETG) for integrated lower body
2026-11-05 Add full fastener inventory and correct caster bolt length
    Consolidated screw/nut/washer list for the integrated PLA body and B1 PCB (71 M3, 12 M2.5, 4 M2 countersunk plus nuts/washers/columns), with purchase summary and 8 field-verification items. Caster through-bolt noted as M3x55 per manual ch.68, ~M3x60 with the H4 spacer.
2026-11-05 Add staged assembly and module-install guide for the integrated body
    Stage A deck/PCB/BUCK/speaker, stage B nine module clamps (positions, hinge M3x30, detent/keeper axes), stage C battery and running gear, stage D platform and accessories, stage E electrical order per manual ch.21-33, stage F cable routing. Lists which accessory objects to reprint and which are already integral.
2026-11-05 Add 31-piece module accessory plate (0.16 mm PLA, P2S)
2026-11-05 Add SG90 servo wiring diagram for B1 board (design check only)
    Documents the three-wire split (5V/GND to J5, PWM via U1 to J20), the PA0 TIM2_CH1 50 Hz firmware parameters, and the extension-cable split rule. Sources, layout self-check and pixel checks are included under pcb-b/diagrams/servo; no physical power-on verification.
